tim4431/analog_programmable_matrix/mechanical/analog_matrix_package_m3/renders/enclosure_exploded.png

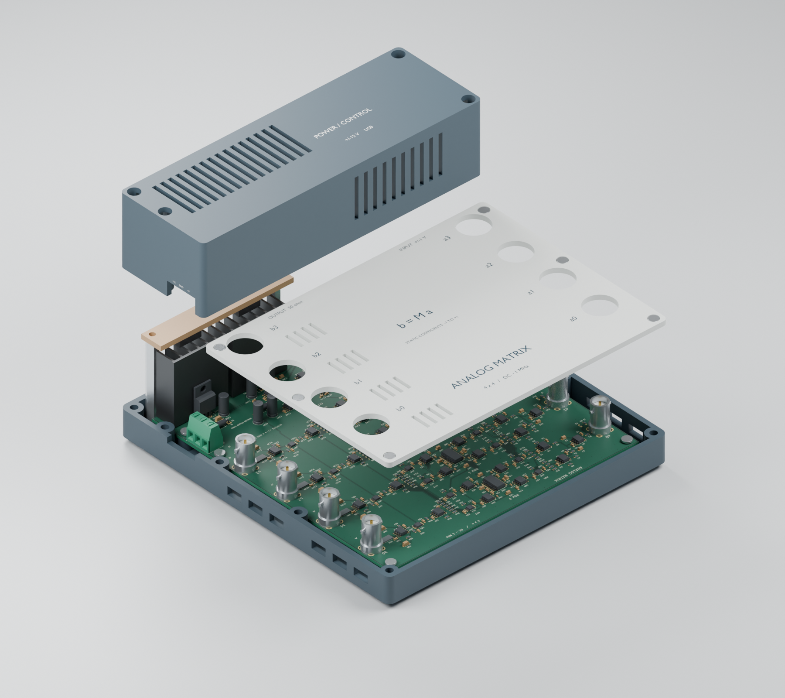
mechanical/analog_matrix_package_m3/renders/enclosure_exploded.png
