tim4431/analog_programmable_matrix/mechanical/analog_matrix_package_m3/renders/power_entry_detail.png

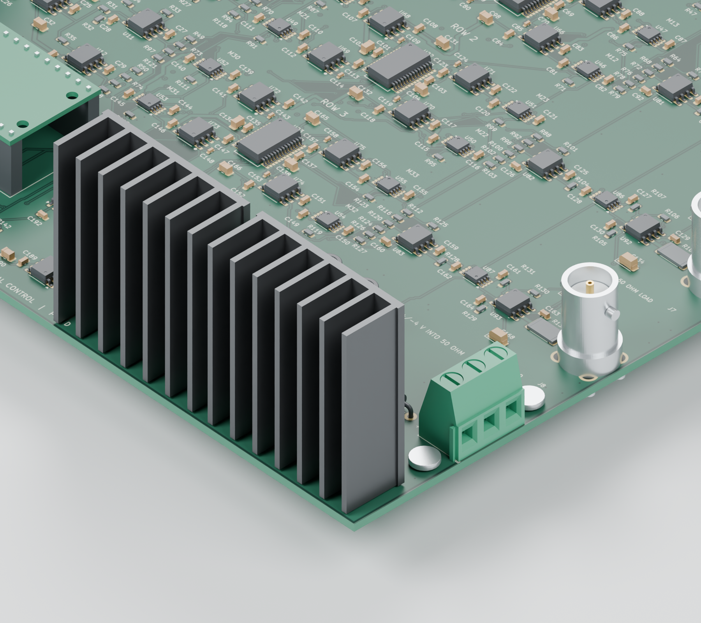
mechanical/analog_matrix_package_m3/renders/power_entry_detail.png
