tim4431/analog_programmable_matrix/mechanical/bnc_access_review_no_led/bnc_clearances.png

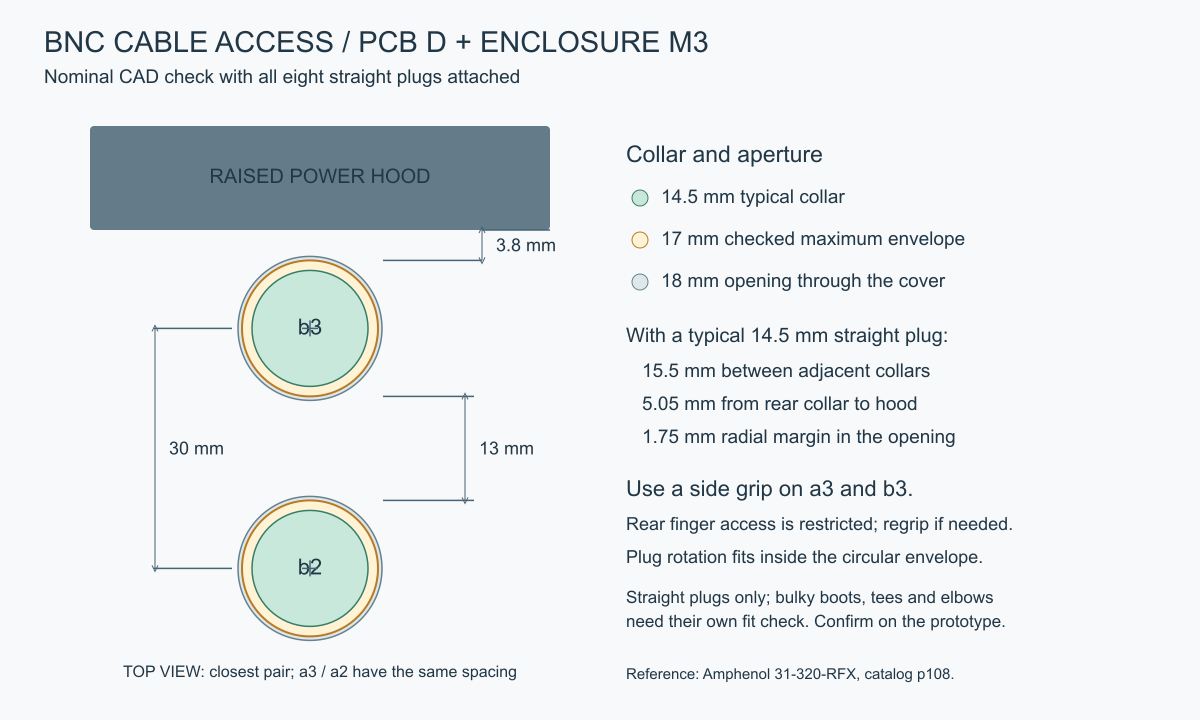
mechanical/bnc_access_review_no_led/bnc_clearances.png
