tim4431/analog_programmable_matrix/spice/plots/feedthrough.png

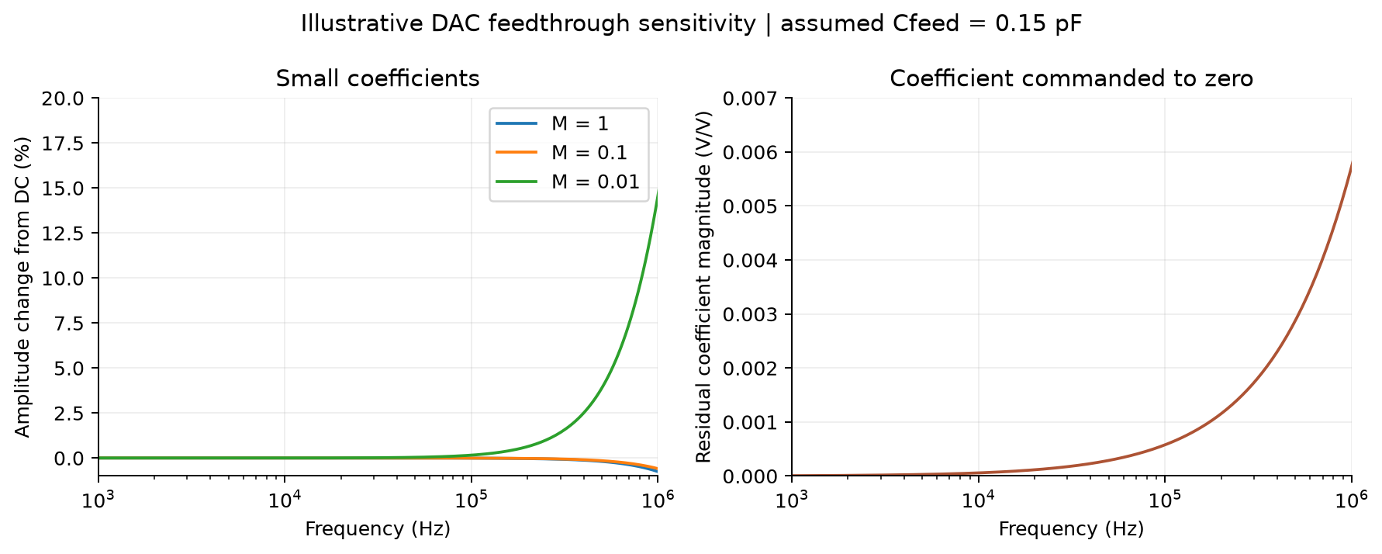
spice/plots/feedthrough.png
