tim4431/analog_programmable_matrix/spice/plots/frequency_response.png

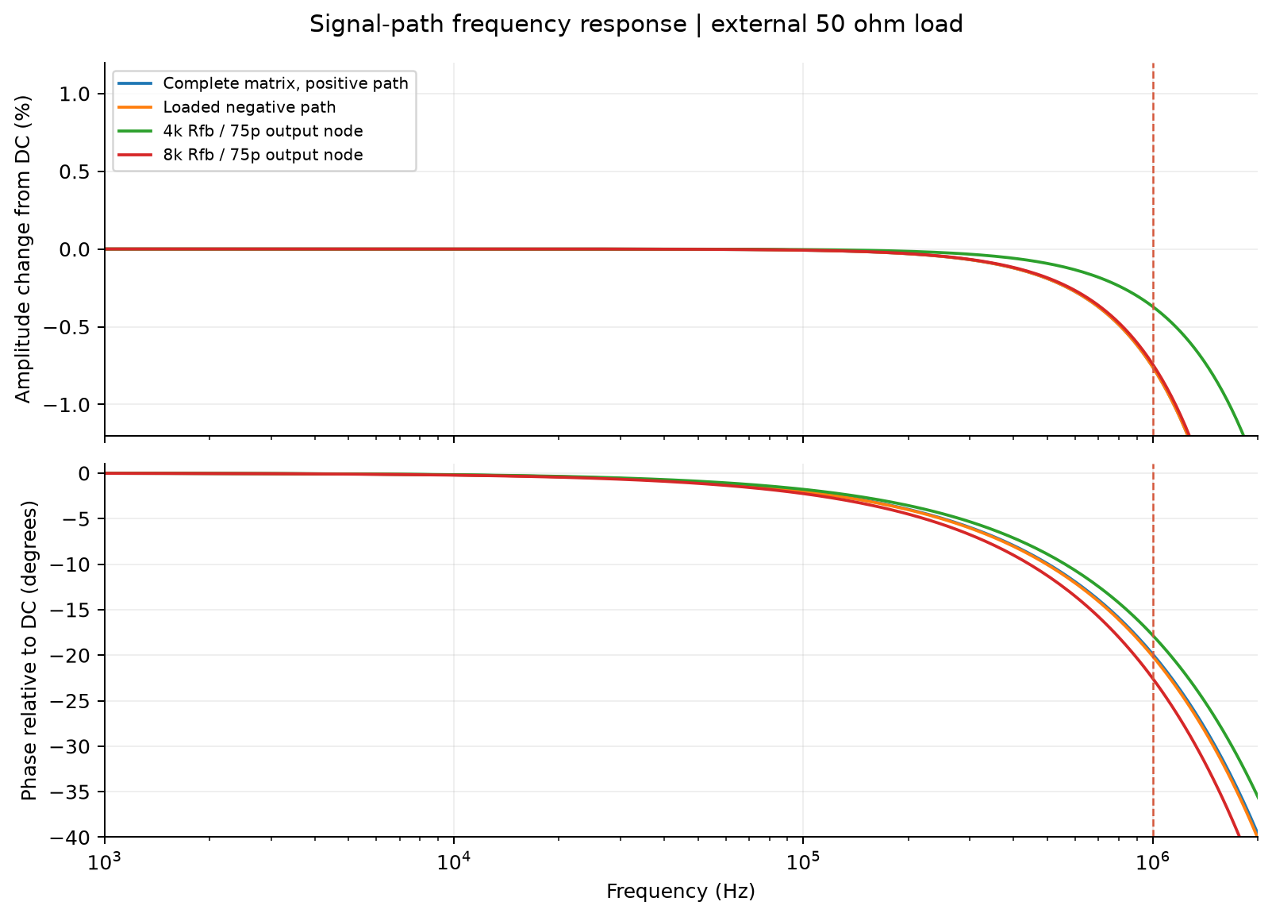
spice/plots/frequency_response.png
