tim4431/analog_programmable_matrix/spice/plots/tia_stability.png

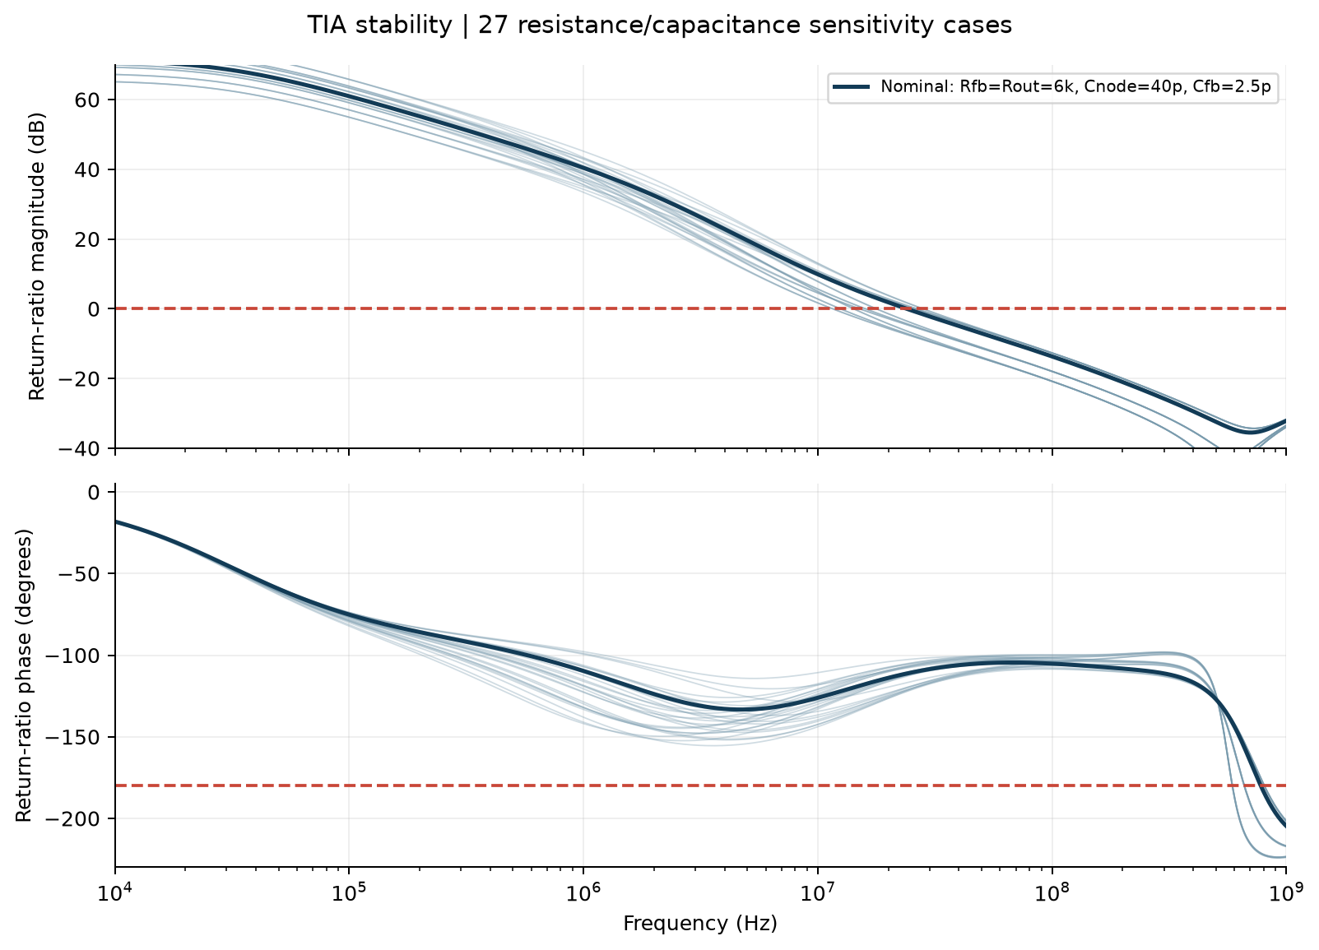
spice/plots/tia_stability.png
