tim4431/analog_programmable_matrix/spice/plots/waveforms.png

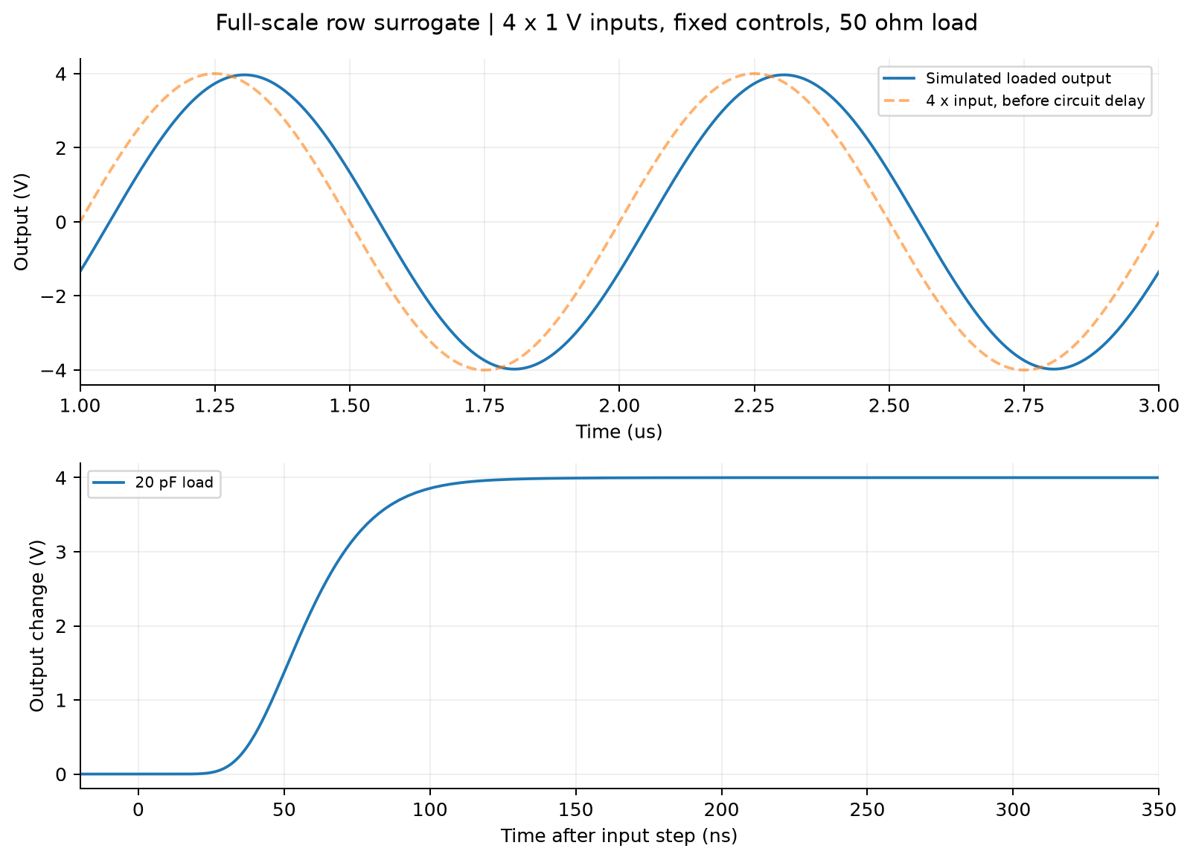
spice/plots/waveforms.png
