tim4431/analog_programmable_matrix/variants/lc1/mechanical/pcb_surface.png

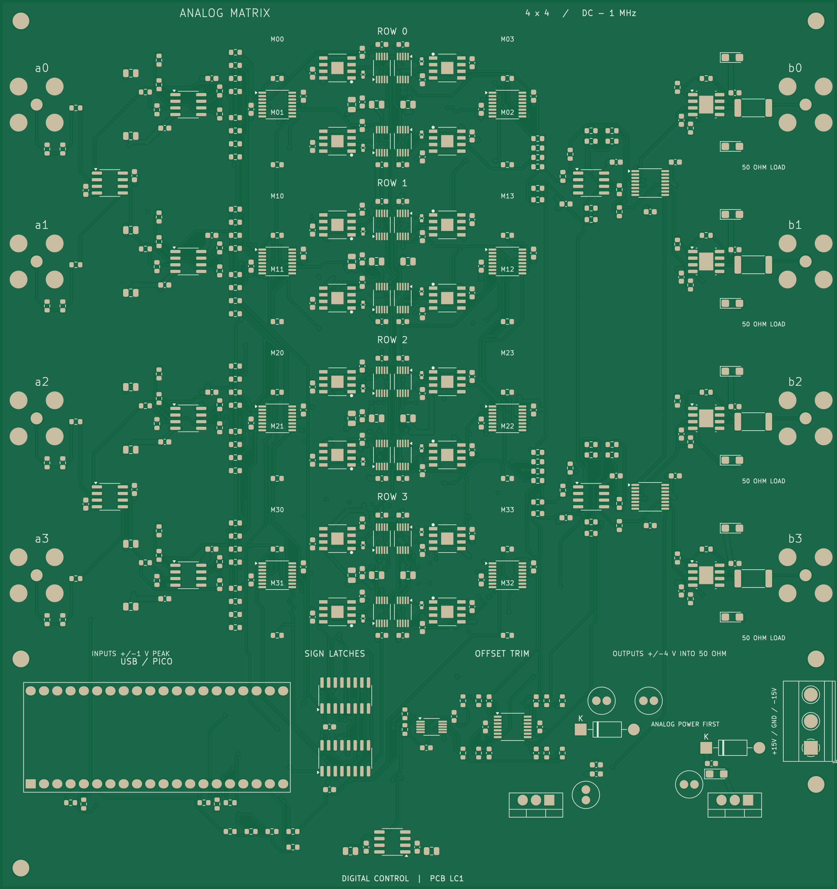
variants/lc1/mechanical/pcb_surface.png
