tim4431/analog_programmable_matrix/variants/lc1/simulation/report/stability.png

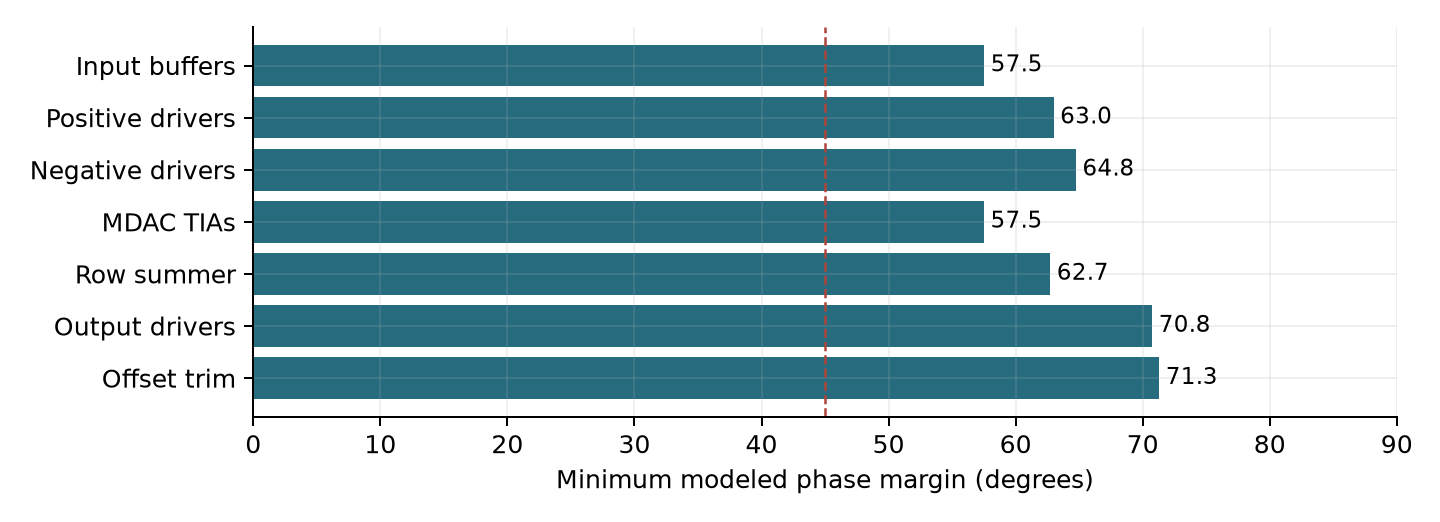
variants/lc1/simulation/report/stability.png
