tim4431/analog_programmable_matrix/output/jlcpcb_rev_d/BOM_JLCPCB.csv

Comment | Designator | Footprint | LCSC Part #
100 nF / 25V X7R minimum; effective C after bias | C1,C2,C3,C4,C5,C6,C9,C10,C11,C12,C13,C14,C17,C18,C19,C20,C21,C22,C25,C26,C27,C28,C29,C30,C33,C35,C37,C38,C39,C40,C42,C43,C44,C45,C47,C48,C49,C50,C52,C53,C54,C55,C57,C58,C59,C60,C61,C62,C67,C69,C71,C72,C73,C74,C76,C77,C78,C79,C81,C82,C83,C84,C86,C87,C88,C89,C91,C92,C93,C94,C95,C96,C101,C103,C105,C106,C107,C108,C110,C111,C112,C113,C115,C116,C117,C118,C120,C121,C122,C123,C125,C126,C127,C128,C129,C130,C135,C137,C139,C140,C141,C142,C144,C145,C146,C147,C149,C150,C151,C152,C154,C155,C156,C157,C159,C160,C161,C162,C163,C164,C169,C171,C173,C174,C176,C177,C179,C180,C182,C183,C187,C189,C191,C192,C196,C200 | C_0603_1608Metric
10 uF / 25V X7R minimum; effective C after bias | C7,C8,C15,C16,C23,C24,C31,C32,C63,C64,C97,C98,C131,C132,C165,C166,C185,C186 | C_0805_2012Metric
1 uF / 25V X7R minimum; effective C after bias | C34,C36,C68,C70,C102,C104,C136,C138,C170,C172,C188,C190 | C_0805_2012Metric
2.2 pF C0G ±0.1pF / 50V C0G | C41,C46,C51,C56,C75,C80,C85,C90,C109,C114,C119,C124,C143,C148,C153,C158 | C_0402_1005Metric
6.8 uF / 25 V / 25V polarized | C65,C66,C99,C100,C133,C134,C167,C168 | CP_EIA-3216-18_Kemet-A
100 pF C0G / 50V C0G | C175,C178,C181,C184 | C_0603_1608Metric
330 nF / 25V X7R minimum; effective C after bias | C194 | C_0603_1608Metric
2.2 uF / 35V polarized | C198 | CP_EIA-3216-18_Kemet-A
33 ohm / 0.1%, <=25ppm/C; 0.1W minimum | R1,R10,R19,R28,R133,R134,R135,R136,R137 | R_0603_1608Metric
1 M / 0.1%, <=25ppm/C; 0.1W minimum | R2,R11,R20,R29 | R_0603_1608Metric
499 ohm / 0.1%, <=25ppm/C; 0.1W minimum | R4,R5,R13,R14,R22,R23,R31,R32 | R_0603_1608Metric
1.00 k / 0.1%, <=25ppm/C; 0.1W minimum | R6,R7,R8,R9,R15,R16,R17,R18,R24,R25,R26,R27,R33,R34,R35,R36,R40,R44,R48,R52,R64,R68,R72,R76,R88,R92,R96,R100,R112,R116,R120,R124 | R_0603_1608Metric
150R 0.1% / 0.1%, <=25ppm/C; 0.1W minimum | R37,R38,R41,R42,R45,R46,R49,R50,R61,R62,R65,R66,R69,R70,R73,R74,R85,R86,R89,R90,R93,R94,R97,R98,R109,R110,R113,R114,R117,R118,R121,R122 | R_0603_1608Metric
100 k / 0.1%, <=25ppm/C; 0.1W minimum | R39,R43,R47,R51,R57,R63,R67,R71,R75,R81,R87,R91,R95,R99,R105,R111,R115,R119,R123,R129 | R_0603_1608Metric
523 ohm / 0.1%, <=25ppm/C; 0.1W minimum | R53,R77,R101,R125 | R_0603_1608Metric
10.0 k / 0.1%, <=25ppm/C; 0.1W minimum | R54,R78,R102,R126 | R_0603_1608Metric
20.0 k / 0.1%, <=25ppm/C; 0.1W minimum | R55,R79,R103,R127 | R_0603_1608Metric
49.9 ohm / 0.1%, <=25ppm/C; 0.1W minimum | R56,R80,R104,R128 | R_0603_1608Metric
1.21 k / 0.1%, <=25ppm/C; 0.1W minimum | R58,R82,R106,R130 | R_0603_1608Metric
402 ohm / 0.1%, <=25ppm/C; 0.1W minimum | R59,R83,R107,R131 | R_0603_1608Metric
49.9 ohm / 0.1%, <=25ppm/C; >=1W | R60,R84,R108,R132 | R_2512_6332Metric
10 k / 0.1%, <=25ppm/C; 0.1W minimum | R138,R139,R140,R141,R142,R143,R144,R145,R146 | R_0603_1608Metric
OPA810ID | U1,U2,U3,U4,U5,U6,U7,U8,U9,U10,U11,U12,U80,U81,U82,U83 | SOIC-8_3.9x4.9mm_P1.27mm
AD5544BRSZ | U20,U21,U22,U23,U30 | SSOP-28_5.3x10.2mm_P0.65mm | C649815
TMUX6219DGKR | U40,U41,U42,U43,U44,U45,U46,U47,U48,U49,U50,U51,U52,U53,U54,U55,U84,U85,U86,U87 | VSSOP-8_3x3mm_P0.65mm | C2876423
ADA4899-1YRDZ | U60,U61,U62,U63,U64,U65,U66,U67,U68,U69,U70,U71,U72,U73,U74,U75 | ADA4899_RD8_EP2.29x2.29 | C654315
THS3091DDAR | U90,U91,U92,U93 | SOIC-8-1EP_3.9x4.9mm_P1.27mm_EP2.95x4.9mm_Mask2.71x3.4mm_ThermalVias | C181226
OPA197ID | U100,U101,U102,U103 | SOIC-8_3.9x4.9mm_P1.27mm | C1347124
ADR4525BRZ | U110 | SOIC-8_3.9x4.9mm_P1.27mm | C395112
SN74HC595D | U121,U122 | SOIC-16_3.9x9.9mm_P1.27mm
