tim4431/analog_programmable_matrix/mechanical/analog_matrix_package_m3/cad/G10_heatsink_retainer.step

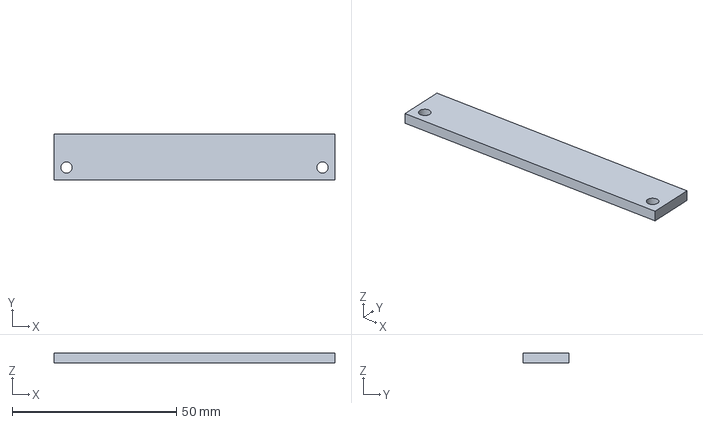
[picture p19: CAD file, 2026-10-01]
mechanical/analog_matrix_package_m3/cad/G10_heatsink_retainer.step
85.6 x 14.0 x 3.00 mm
