tim4431/analog_programmable_matrix/mechanical/analog_matrix_package_m3/models/D_DO-41_SOD81_P10.16mm_Horizontal.step

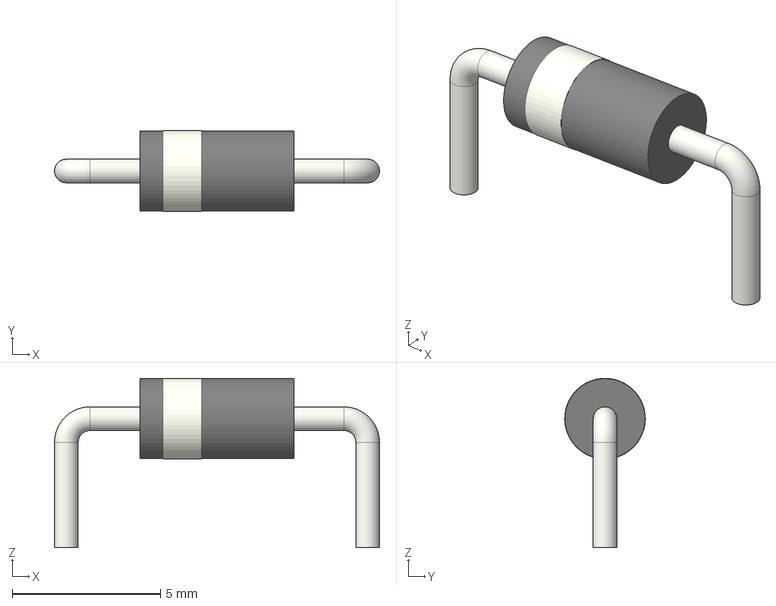
[picture p20: CAD file, 2026-10-01]
mechanical/analog_matrix_package_m3/models/D_DO-41_SOD81_P10.16mm_Horizontal.step
11.0 x 2.72 x 5.71 mm
