tim4431/analog_programmable_matrix/mechanical/analog_matrix_package_m3/pcb_substrate.step

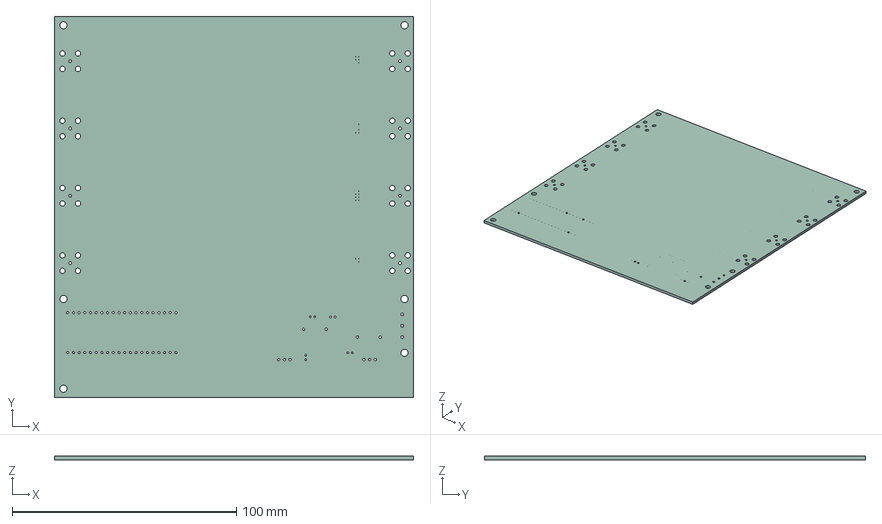
[picture p21: CAD file, 2026-10-01]
mechanical/analog_matrix_package_m3/pcb_substrate.step
160.0 x 170.0 x 1.62 mm
