tim4431/analog_programmable_matrix/variants/lc1/hardware/models/BNC_Amphenol_031-5329-52RFX_Vertical.step

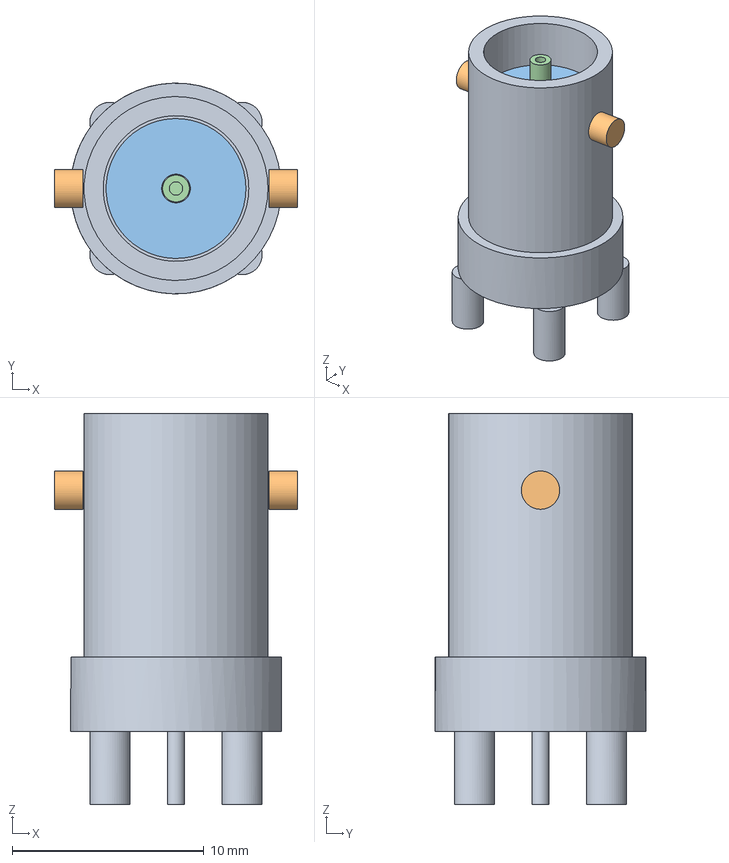
[picture p22: CAD file, 2026-10-01]
variants/lc1/hardware/models/BNC_Amphenol_031-5329-52RFX_Vertical.step
12.7 x 11.0 x 20.4 mm
