tim4431/analog_programmable_matrix/mechanical/analog_matrix_package_m3/cad/signal_cover.step

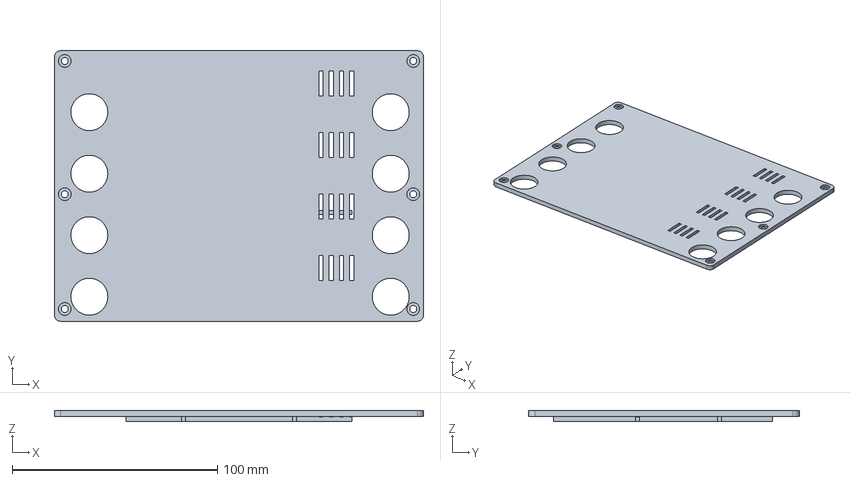
[picture p23: CAD file, 2026-10-01]
mechanical/analog_matrix_package_m3/cad/signal_cover.step
180.0 x 132.0 x 5.50 mm
