tim4431/analog_programmable_matrix/mechanical/analog_matrix_package_m3/models/C_0402_1005Metric.step

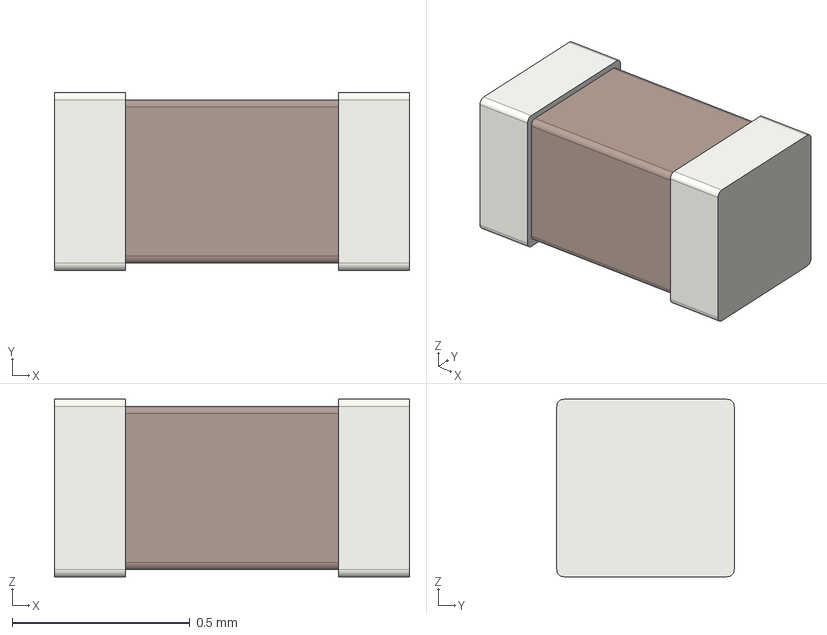
[picture p24: CAD file, 2026-10-01]
mechanical/analog_matrix_package_m3/models/C_0402_1005Metric.step
1.00 x 0.5 x 0.5 mm
