tim4431/analog_programmable_matrix/mechanical/analog_matrix_package_m3/cad/base_tray.step

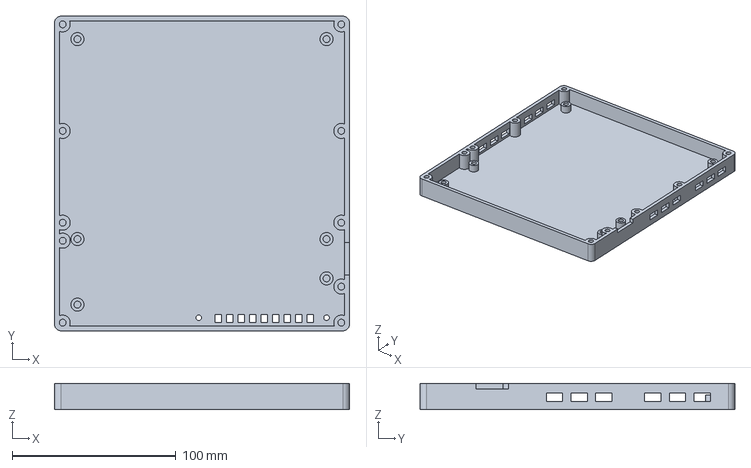
[picture p25: CAD file, 2026-10-01]
mechanical/analog_matrix_package_m3/cad/base_tray.step
180.0 x 192.0 x 16.0 mm
