tim4431/analog_programmable_matrix/mechanical/analog_matrix_package_m3/cad/power_hood.step

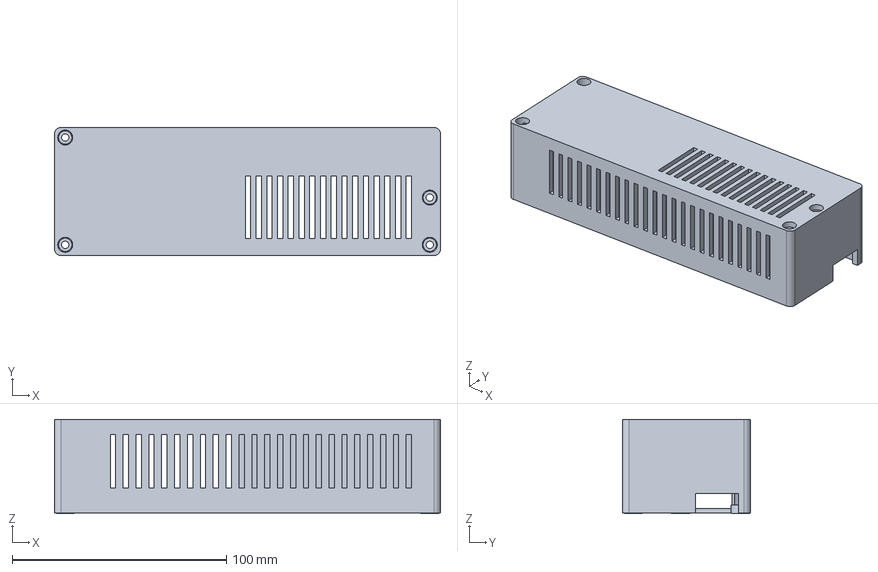
[picture p26: CAD file, 2026-10-01]
mechanical/analog_matrix_package_m3/cad/power_hood.step
180.0 x 59.7 x 44.0 mm
