tim4431/analog_programmable_matrix/mechanical/analog_matrix_package_m3/models/C_Radial_D5.0mm_H11.0mm_P2.00mm.step

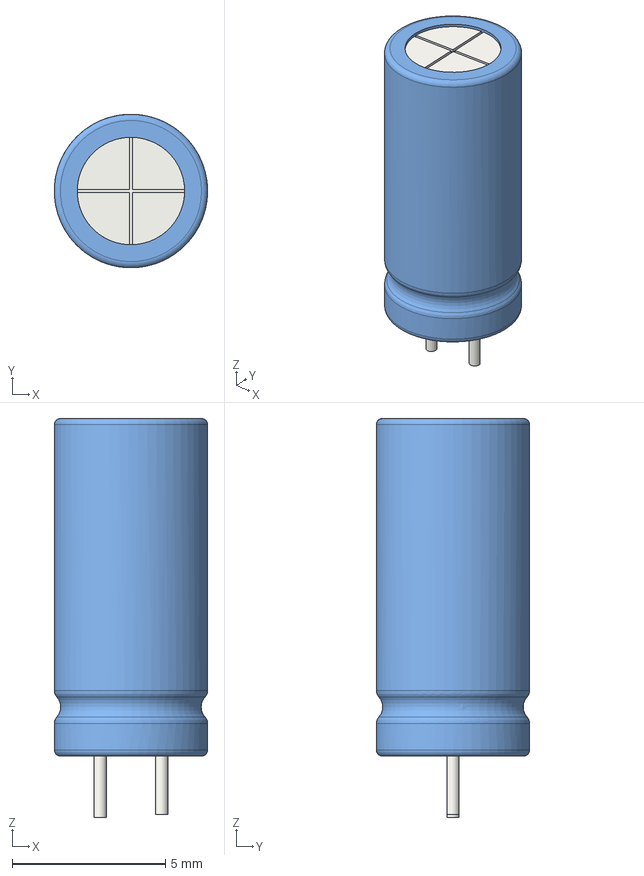
[picture p27: CAD file, 2026-10-01]
mechanical/analog_matrix_package_m3/models/C_Radial_D5.0mm_H11.0mm_P2.00mm.step
5.00 x 5.00 x 13.0 mm
