tim4431/analog_programmable_matrix/mechanical/analog_matrix_package_m3/models/TerminalBlock_Phoenix_MKDS-1,5-3-5.08_1x03_P5.08mm_Horizontal.step

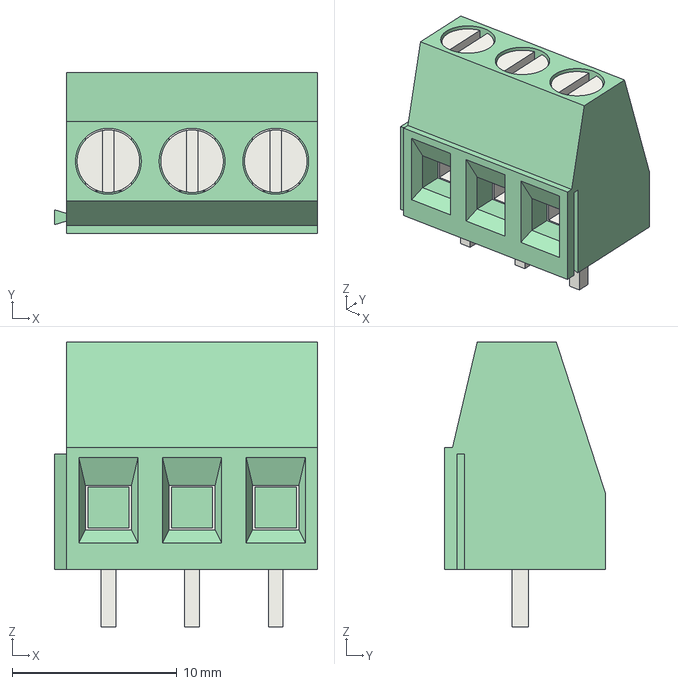
[picture p28: CAD file, 2026-10-01]
mechanical/analog_matrix_package_m3/models/TerminalBlock_Phoenix_MKDS-1,5-3-5.08_1x03_P5.08mm_Horizontal.step
16.0 x 9.80 x 17.3 mm
