tim4431/analog_programmable_matrix/mechanical/analog_matrix_package_m3/models/Pico_2x20_Socket_17.78mm.step

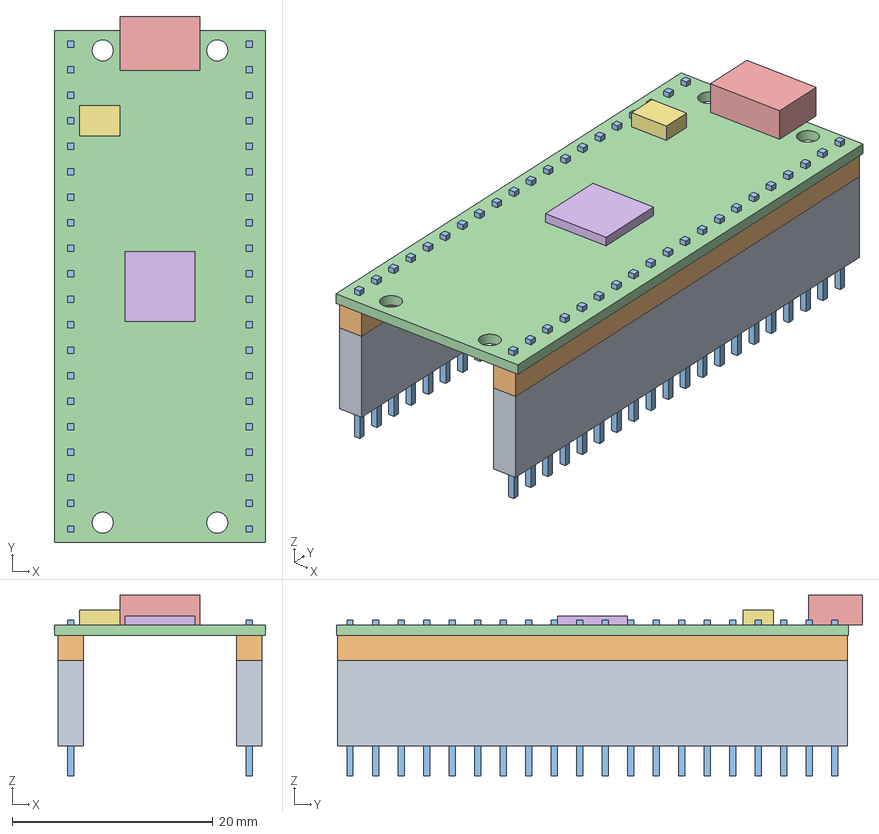
[picture p29: CAD file, 2026-10-01]
mechanical/analog_matrix_package_m3/models/Pico_2x20_Socket_17.78mm.step
21.0 x 52.4 x 18.0 mm
