tim4431/analog_programmable_matrix/mechanical/analog_matrix_package_m3/models/SOIC-8-1EP_3.9x4.9mm_P1.27mm_EP2.95x4.9mm_Mask2.71x3.4mm.step

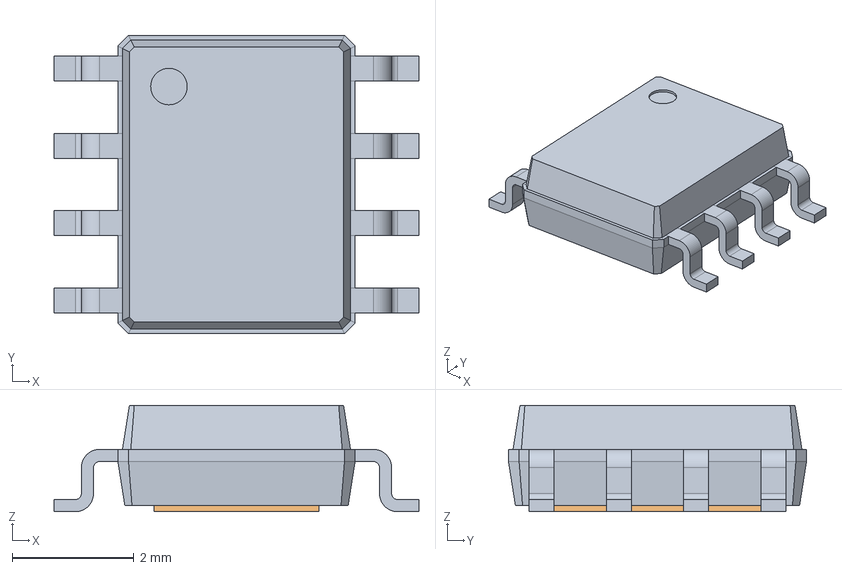
[picture p30: CAD file, 2026-10-01]
mechanical/analog_matrix_package_m3/models/SOIC-8-1EP_3.9x4.9mm_P1.27mm_EP2.95x4.9mm_Mask2.71x3.4mm.step
6.00 x 4.90 x 1.75 mm
