tim4431/analog_programmable_matrix/mechanical/analog_matrix_package_m3/models/R_0603_1608Metric.step

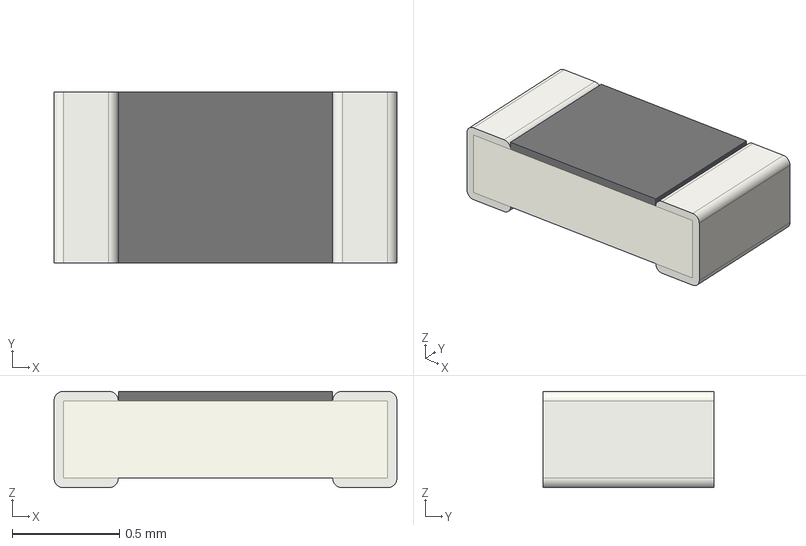
[picture p31: CAD file, 2026-10-01]
mechanical/analog_matrix_package_m3/models/R_0603_1608Metric.step
1.60 x 0.8 x 0.45 mm
