tim4431/analog_programmable_matrix/mechanical/analog_matrix_package_m3/models/TO-220-3_Vertical.step

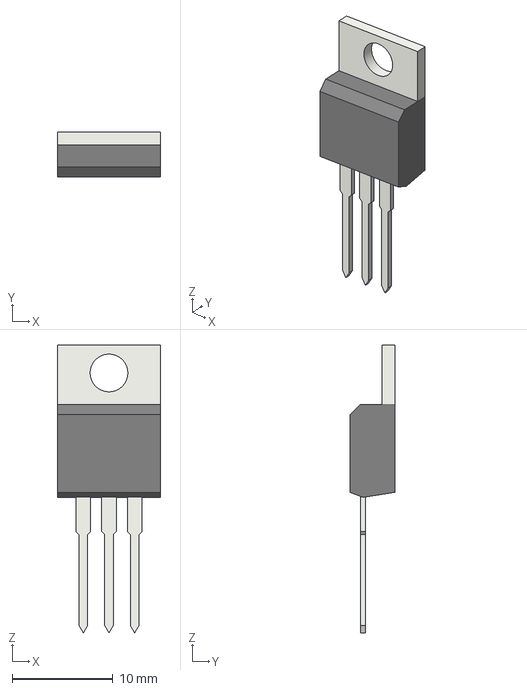
[picture p33: CAD file, 2026-10-01]
mechanical/analog_matrix_package_m3/models/TO-220-3_Vertical.step
10.2 x 4.46 x 28.5 mm
