tim4431/analog_programmable_matrix/mechanical/analog_matrix_package_m3/models/R_2512_6332Metric.step

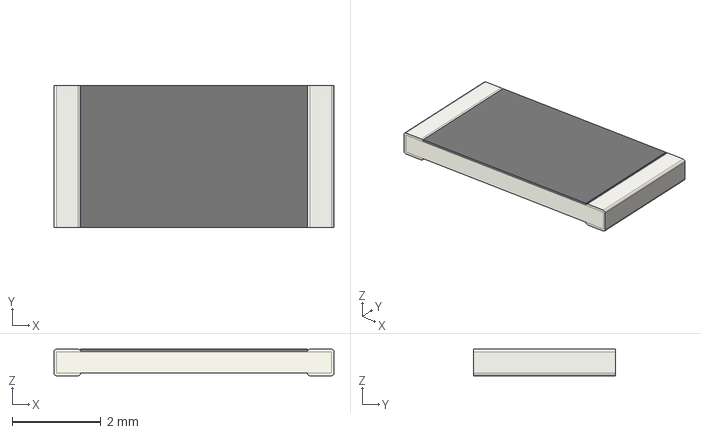
[picture p34: CAD file, 2026-10-01]
mechanical/analog_matrix_package_m3/models/R_2512_6332Metric.step
6.30 x 3.20 x 0.6 mm
