tim4431/analog_programmable_matrix/mechanical/analog_matrix_package_m3/models/SSOP-28_5.3x10.2mm_P0.65mm.step

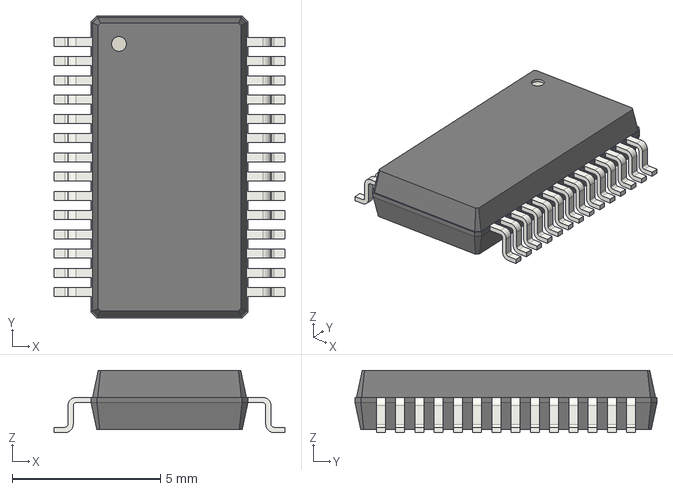
[picture p35: CAD file, 2026-10-01]
mechanical/analog_matrix_package_m3/models/SSOP-28_5.3x10.2mm_P0.65mm.step
7.80 x 10.2 x 2.10 mm
