tim4431/analog_programmable_matrix/mechanical/analog_matrix_package_m3/models/CP_EIA-3216-18_Kemet-A.step

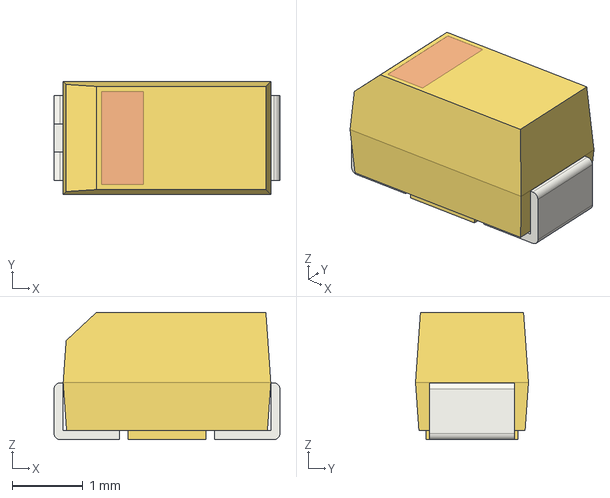
[picture p37: CAD file, 2026-10-01]
mechanical/analog_matrix_package_m3/models/CP_EIA-3216-18_Kemet-A.step
3.20 x 1.60 x 1.80 mm
