tim4431/analog_programmable_matrix/mechanical/analog_matrix_package_m3/models/ADA4899_RD8_EP2.29x2.29.step

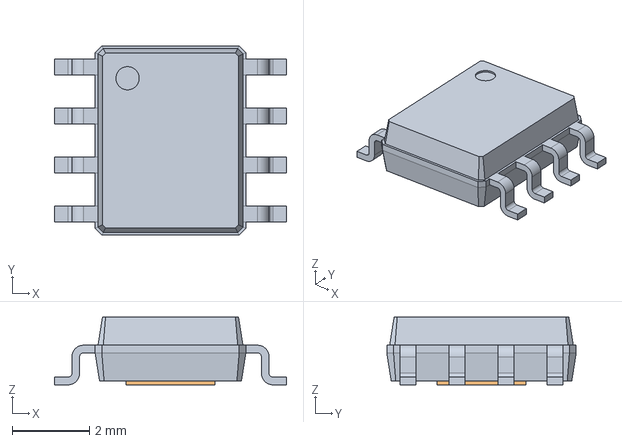
[picture p38: CAD file, 2026-10-01]
mechanical/analog_matrix_package_m3/models/ADA4899_RD8_EP2.29x2.29.step
6.00 x 4.90 x 1.75 mm
