tim4431/analog_programmable_matrix/mechanical/analog_matrix_package_m3/models/C_0805_2012Metric.step

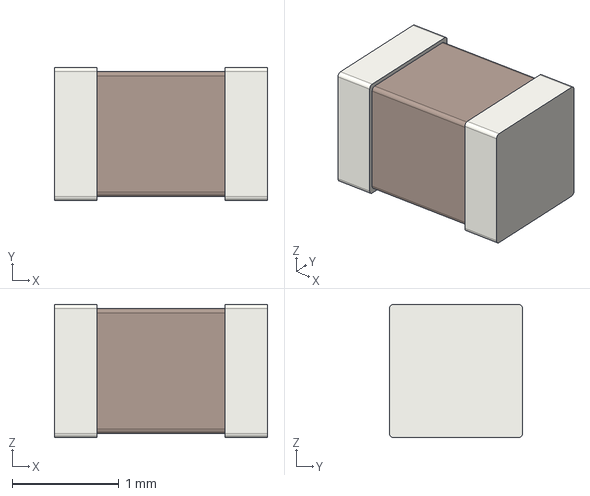
[picture p39: CAD file, 2026-10-01]
mechanical/analog_matrix_package_m3/models/C_0805_2012Metric.step
2.00 x 1.25 x 1.25 mm
