tim4431/analog_programmable_matrix/mechanical/analog_matrix_package_m3/models/VSSOP-8_3x3mm_P0.65mm.step

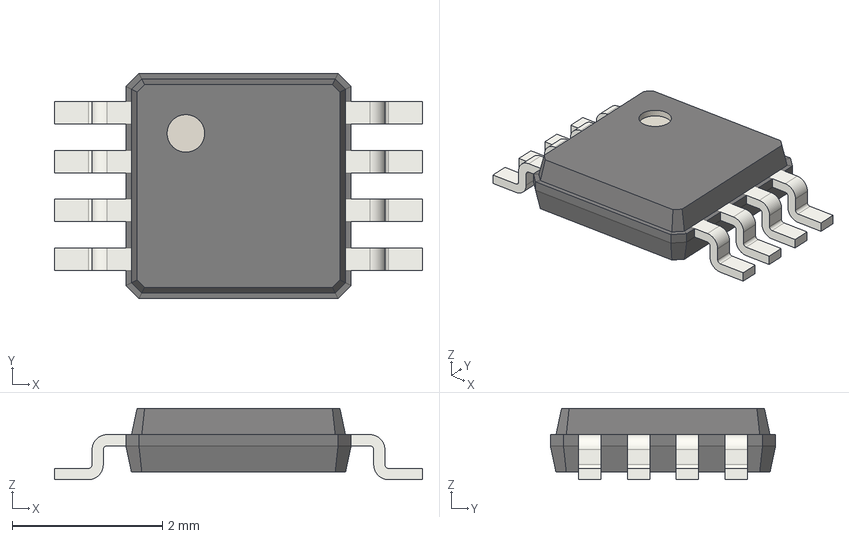
[picture p40: CAD file, 2026-10-01]
mechanical/analog_matrix_package_m3/models/VSSOP-8_3x3mm_P0.65mm.step
4.90 x 3.00 x 0.95 mm
