tim4431/analog_programmable_matrix/mechanical/analog_matrix_package_m3/models/SOIC-16_3.9x9.9mm_P1.27mm.step

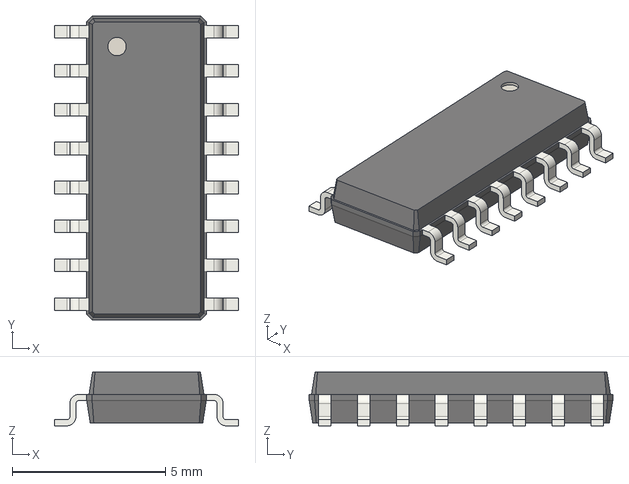
[picture p41: CAD file, 2026-10-01]
mechanical/analog_matrix_package_m3/models/SOIC-16_3.9x9.9mm_P1.27mm.step
6.00 x 9.90 x 1.75 mm
