tim4431/analog_programmable_matrix/mechanical/analog_matrix_package_m3/models/SMA_Amphenol_132134_Vertical.step

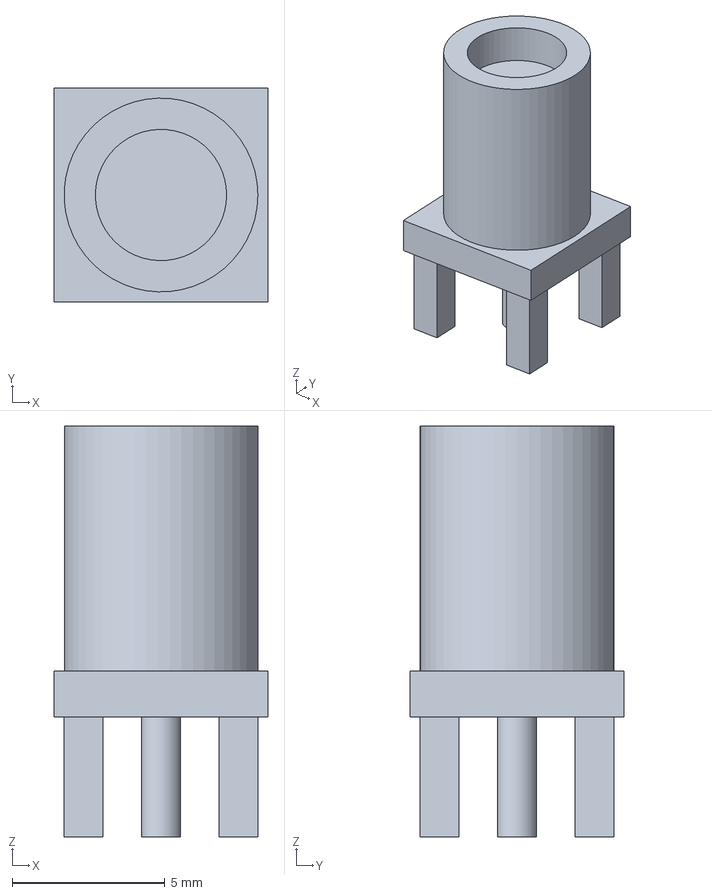
[picture p42: CAD file, 2026-10-01]
mechanical/analog_matrix_package_m3/models/SMA_Amphenol_132134_Vertical.step
7.00 x 7.00 x 13.5 mm
