tim4431/analog_programmable_matrix/mechanical/analog_matrix_package_m3/models/TO-220-3_Vertical_Trimmed.step

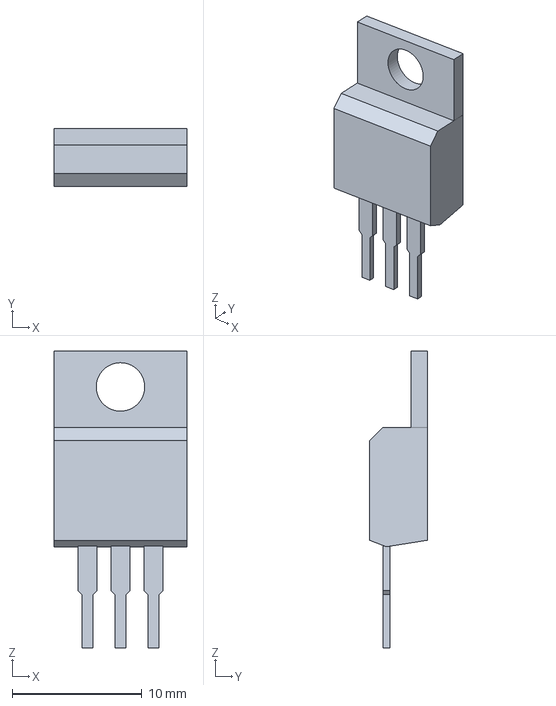
[picture p43: CAD file, 2026-10-01]
mechanical/analog_matrix_package_m3/models/TO-220-3_Vertical_Trimmed.step
10.2 x 4.46 x 22.9 mm
