tim4431/analog_programmable_matrix/(list of files, cad)

Other CAD files:
mechanical/analog_matrix_package_m3/models/BNC_Amphenol_031-5329-52RFX_Vertical.step
mechanical/analog_matrix_package_m3/analog_matrix_package.blend
mechanical/analog_matrix_package_m3/cad/G10_heatsink_retainer.dxf
mechanical/analog_matrix_package_m3/print/base_tray.stl
mechanical/analog_matrix_package_m3/print/power_hood.stl
mechanical/analog_matrix_package_m3/print/signal_cover.stl
