tim4431/analog_programmable_matrix/pcb/analog_matrix_4x4_rev_d/fabrication/via_in_pad_locations.csv

X from left mm | Y from top mm | Finished hole mm | Copper diameter mm | Net | Nearby SMD land | Origin
138.0 | 101.0 | 0.3 | 0.6 | +15V | C167.1 | via
137.1 | 78.9 | 0.3 | 0.6 | +15V | U92.7 | via
138.0 | 70.7 | 0.3 | 0.6 | +15V | C133.1 | via
138.0 | 41.0 | 0.3 | 0.6 | +15V | C99.1 | via
137.1 | 108.9 | 0.3 | 0.6 | +15V | U93.7 | via
137.1 | 18.9 | 0.3 | 0.6 | +15V | U90.7 | via
137.1 | 48.9 | 0.3 | 0.6 | +15V | U91.7 | via
113.6 | 79.5 | 0.3 | 0.6 | +5A | U82.7 | via
39.5 | 102.4 | 0.3 | 0.6 | +5A | U11.7 | via
112.5 | 109.0 | 0.3 | 0.6 | +5A | U83.7 | via
39.6 | 42.5 | 0.3 | 0.6 | +5A | U5.7 | via
87.5 | 85.1 | 0.3 | 0.6 | +5A | U70.8 | via
88.0 | 102.6 | 0.3 | 0.6 | +5A | U75.7 | via
85.6 | 140.7 | 0.3 | 0.6 | +5A | C170.1 | via
106.2 | 146.4 | 0.3 | 0.6 | +5A | U102.7 | via
88.2 | 86.7 | 0.3 | 0.6 | +5A | U70.7 | via
61.2 | 59.2 | 0.3 | 0.6 | +5A | U65.8 | via
87.5 | 71.1 | 0.3 | 0.6 | +5A | U71.8 | via
59.1 | 103.2 | 0.3 | 0.6 | +5A | C141.1 | via
66.6 | 110.7 | 0.3 | 0.6 | +5A | C136.1 | via
59.1 | 117.2 | 0.3 | 0.6 | +5A | C146.1 | via
23.4 | 103.7 | 0.3 | 0.6 | +5A | C31.1 | via
61.1 | 44.9 | 0.3 | 0.6 | +5A | U64.8 | via
66.6 | 20.7 | 0.3 | 0.6 | +5A | C34.1 | via
87.6 | 115.4 | 0.3 | 0.6 | +5A | U74.8 | via
39.6 | 86.1 | 0.3 | 0.6 | +5A | U9.7 | via
87.5 | 25.1 | 0.3 | 0.6 | +5A | U62.8 | via
24.0 | 44.7 | 0.3 | 0.6 | +5A | C15.1 | via
73.4 | 9.7 | 0.3 | 0.6 | +5A | C63.1 | via
113.7 | 19.2 | 0.3 | 0.6 | +5A | U80.7 | via
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
134.35 | 79.35 | 0.2 | 0.5 | GND | U92.9 | U92.9
134.35 | 80.65 | 0.2 | 0.5 | GND | U92.9 | U92.9
134.35 | 81.95 | 0.2 | 0.5 | GND | U92.9 | U92.9
135.65 | 78.05 | 0.2 | 0.5 | GND | U92.9 | U92.9
135.65 | 79.35 | 0.2 | 0.5 | GND | U92.9 | U92.9
135.65 | 80.65 | 0.2 | 0.5 | GND | U92.9 | U92.9
135.65 | 81.95 | 0.2 | 0.5 | GND | U92.9 | U92.9
134.35 | 108.05 | 0.2 | 0.5 | GND | U93.9 | U93.9
134.35 | 109.35 | 0.2 | 0.5 | GND | U93.9 | U93.9
134.35 | 110.65 | 0.2 | 0.5 | GND | U93.9 | U93.9
134.35 | 111.95 | 0.2 | 0.5 | GND | U93.9 | U93.9
135.65 | 108.05 | 0.2 | 0.5 | GND | U93.9 | U93.9
135.65 | 109.35 | 0.2 | 0.5 | GND | U93.9 | U93.9
135.65 | 110.65 | 0.2 | 0.5 | GND | U93.9 | U93.9
135.65 | 111.95 | 0.2 | 0.5 | GND | U93.9 | U93.9
134.35 | 48.05 | 0.2 | 0.5 | GND | U91.9 | U91.9
134.35 | 49.35 | 0.2 | 0.5 | GND | U91.9 | U91.9
134.35 | 50.65 | 0.2 | 0.5 | GND | U91.9 | U91.9
134.35 | 51.95 | 0.2 | 0.5 | GND | U91.9 | U91.9
135.65 | 48.05 | 0.2 | 0.5 | GND | U91.9 | U91.9
135.65 | 49.35 | 0.2 | 0.5 | GND | U91.9 | U91.9
135.65 | 50.65 | 0.2 | 0.5 | GND | U91.9 | U91.9
135.65 | 51.95 | 0.2 | 0.5 | GND | U91.9 | U91.9
