tim4431/analog_programmable_matrix/spice/benches/a2_row_step_capload_rc.log_excerpt.txt

achieve convergence from 1.5100012957209242e-06 to 1.5100012957219242e-06 seconds.
Warning: Simulation tolerance relaxed to achieve convergence from 1.5100012957219242e-06 to 1.5100012957229241e-06 seconds.
Warning: Simulation tolerance relaxed to achieve convergence from 1.5100012957229241e-06 to 1.5100012957239240e-06 seconds.
Warning: Simulation tolerance relaxed to achieve convergence from 1.5100012957239240e-06 to 1.5100012957249239e-06 seconds.
Warning: Simulation tolerance relaxed to achieve convergence from 1.5100012957249239e-06 to 1.5100012957259238e-06 seconds.
Warning: Simulation tolerance relaxed to achieve convergence from 1.5100012957259238e-06 to 1.5100012957269238e-06 seconds.
Warning: Simulation tolerance relaxed to achieve convergence from 1.5100012957269238e-06 to 1.5100012957279237e-06 seconds.
Warning: Simulation tolerance relaxed to achieve convergence from 1.5100012957279237e-06 to 1.5100012957289236e-06 seconds.
Warning: Simulation tolerance relaxed to achieve convergence from 1.5100012957289236e-06 to 1.5100012957299235e-06 seconds.
Warning: Simulation tolerance relaxed to achieve convergence from 1.5100012957299235e-06 to 1.5100012957309235e-06 seconds.
Warning: Simulation tolerance relaxed to achieve convergence from 1.5100012957309235e-06 to 1.5100012957319234e-06 seconds.
Warning: Simulation tolerance relaxed to achieve convergence from 1.5100012957319234e-06 to 1.5100012957329233e-06 seconds.
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
Warning: Simulation tolerance relaxed to achieve convergence from 1.5100012957669207e-06 to 1.5100012957679206e-06 seconds.
Warning: Simulation tolerance relaxed to achieve convergence from 1.5100012957679206e-06 to 1.5100012957689205e-06 seconds.
Warning: Simulation tolerance relaxed to achieve convergence from 1.5100012957689205e-06
