tim4431/analog_programmable_matrix/pcb/analog_matrix_4x4_rev_d/schematic.pdf

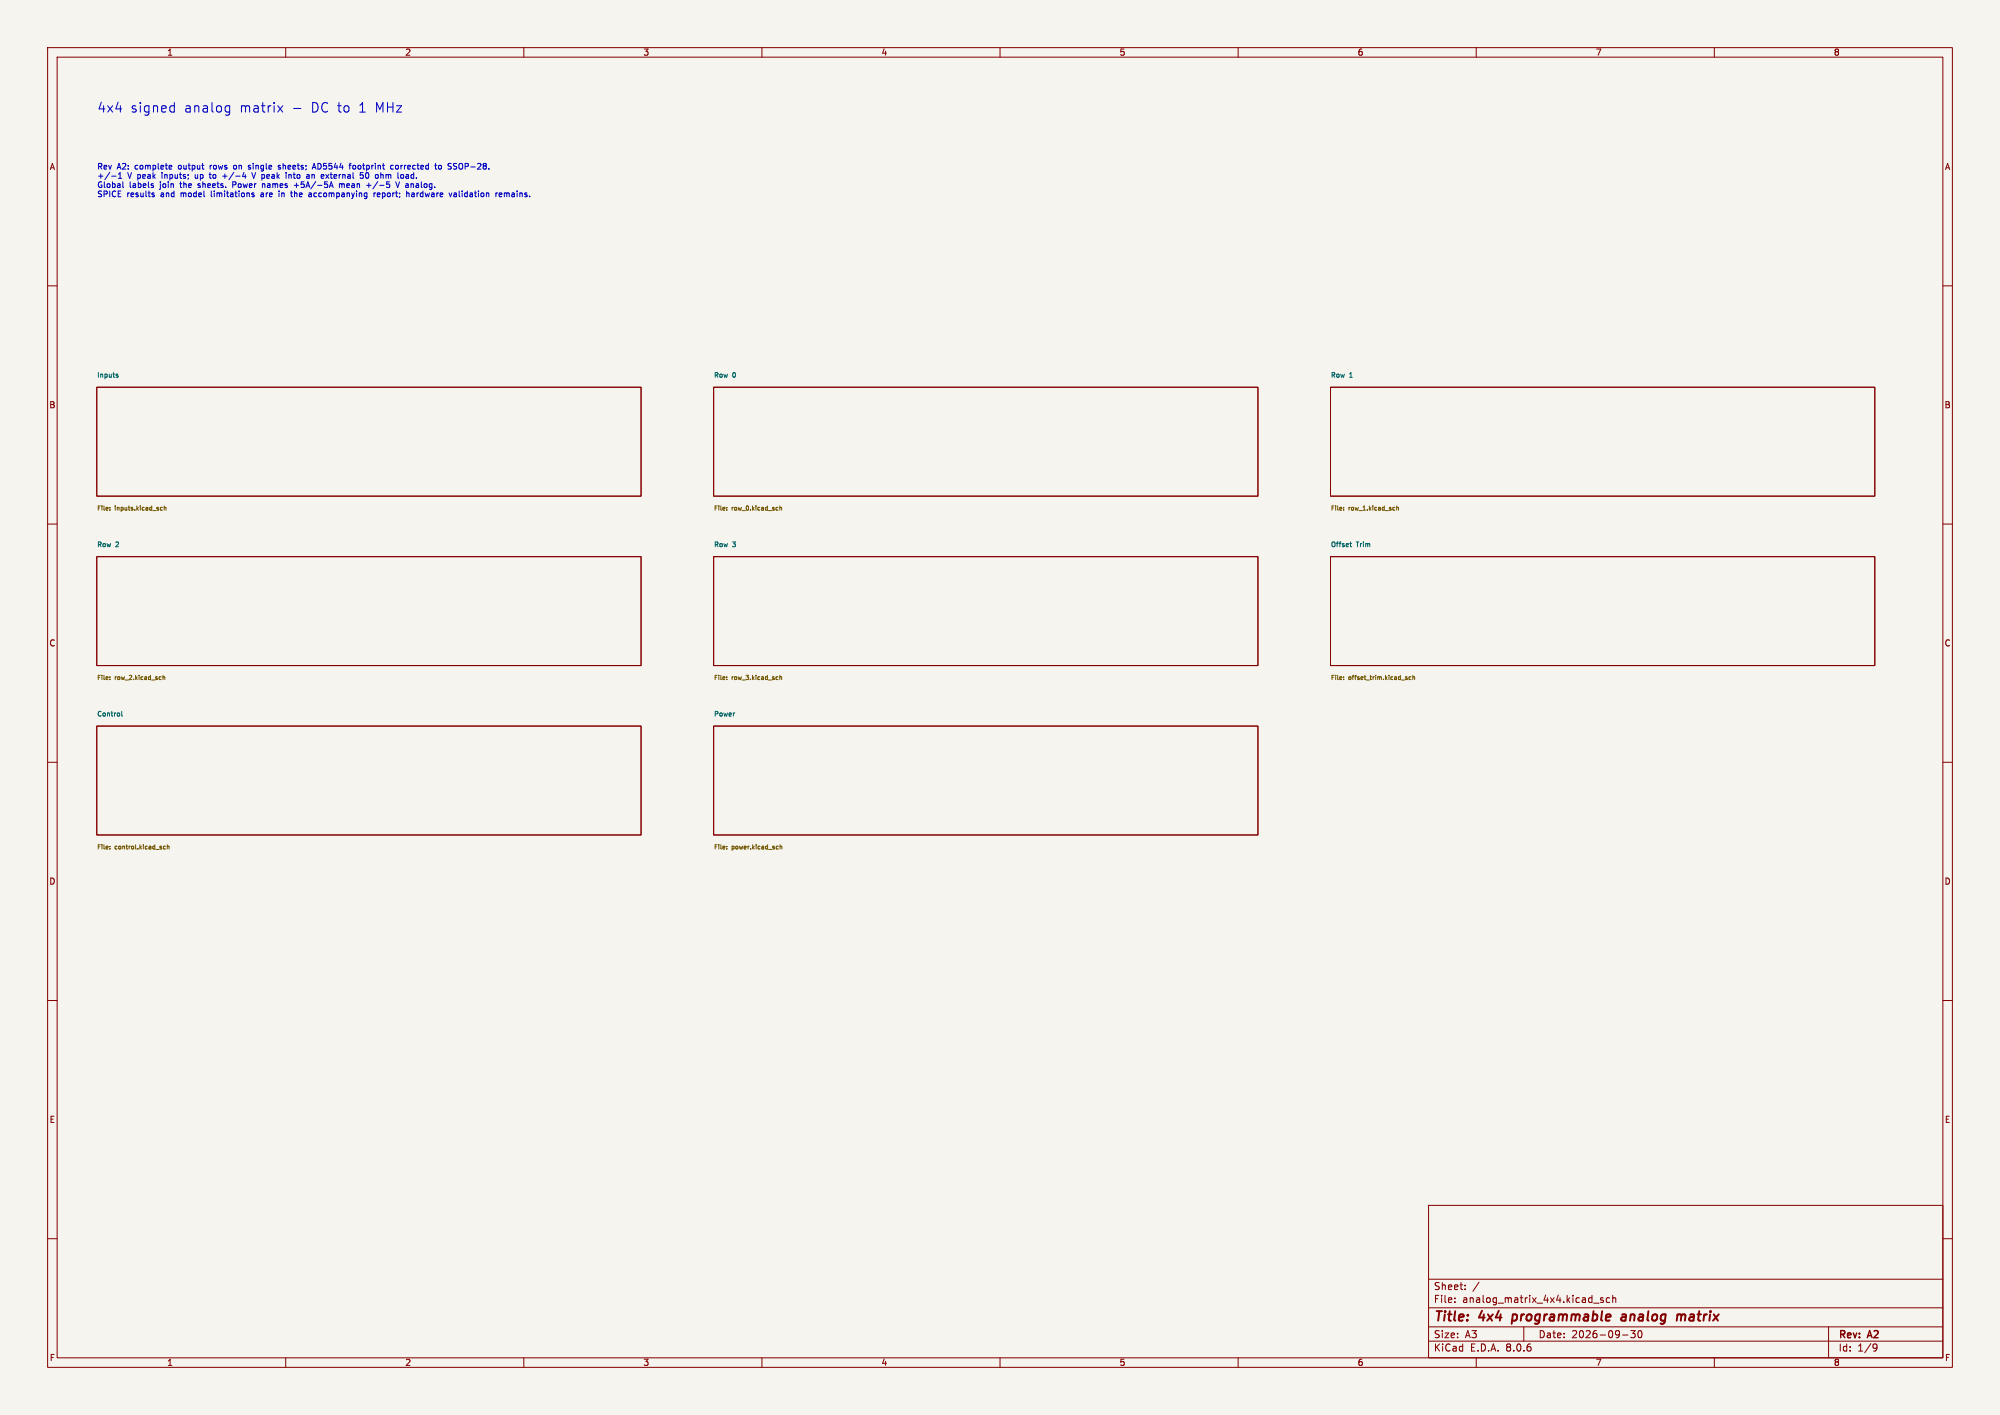
[picture p46: page 1]

Inputs File: inputs.kicad_sch Row 2

File: row_2.kicad_sch Control File: control.kicad_sch

File: offset_trim.kicad_sch Power File: power.kicad_sch

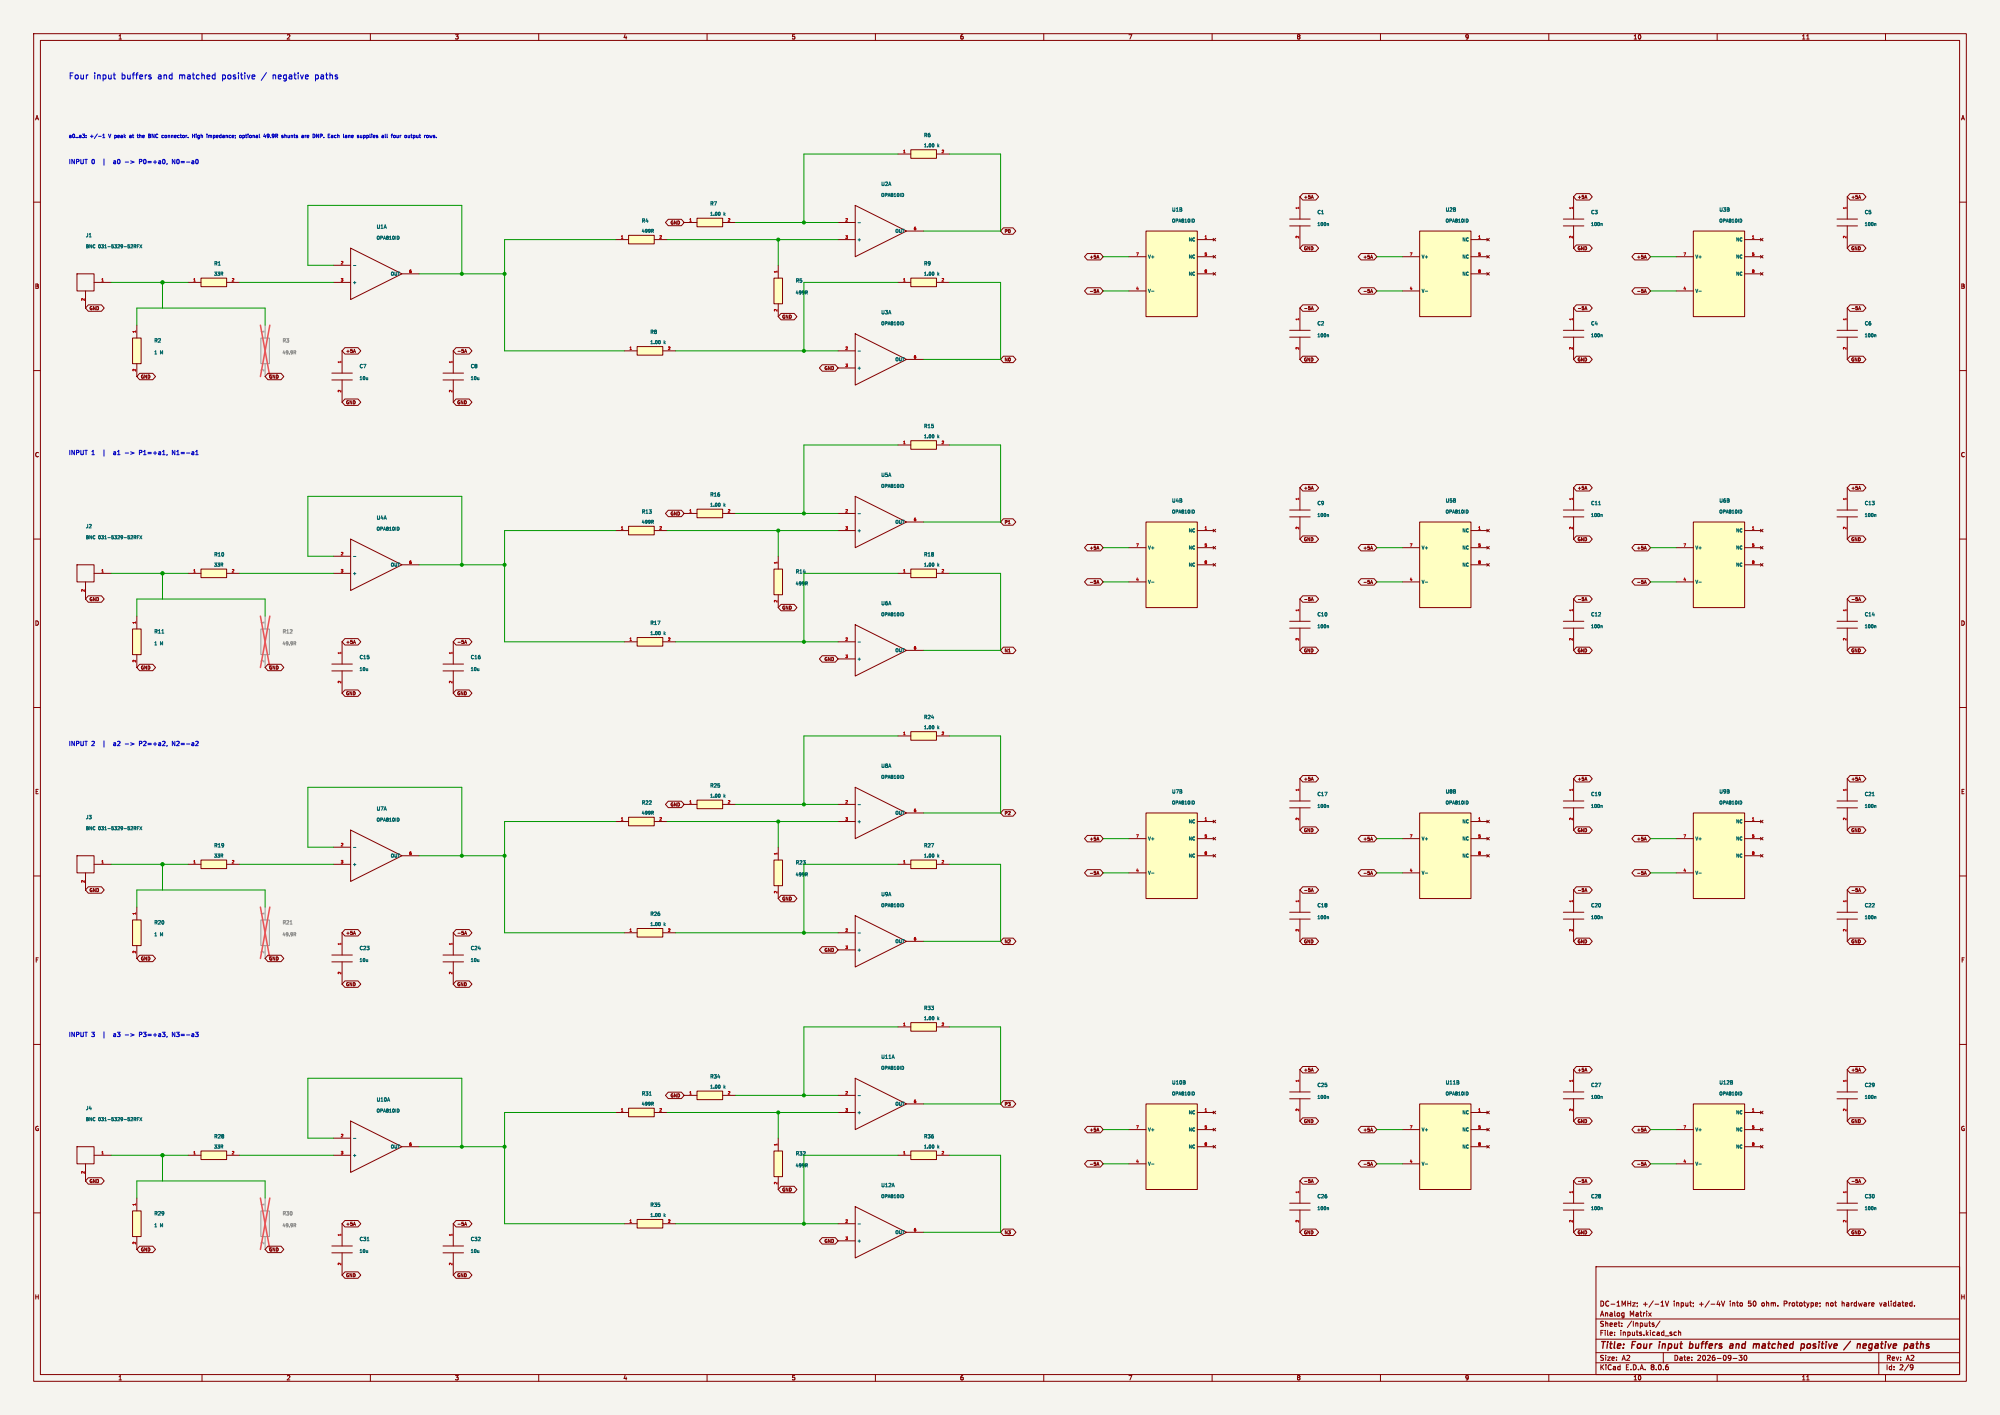
[picture p47: page 2]

Four input buffers and matched positive / negative paths

File: inputs.kicad_sch Sheet: /Inputs/

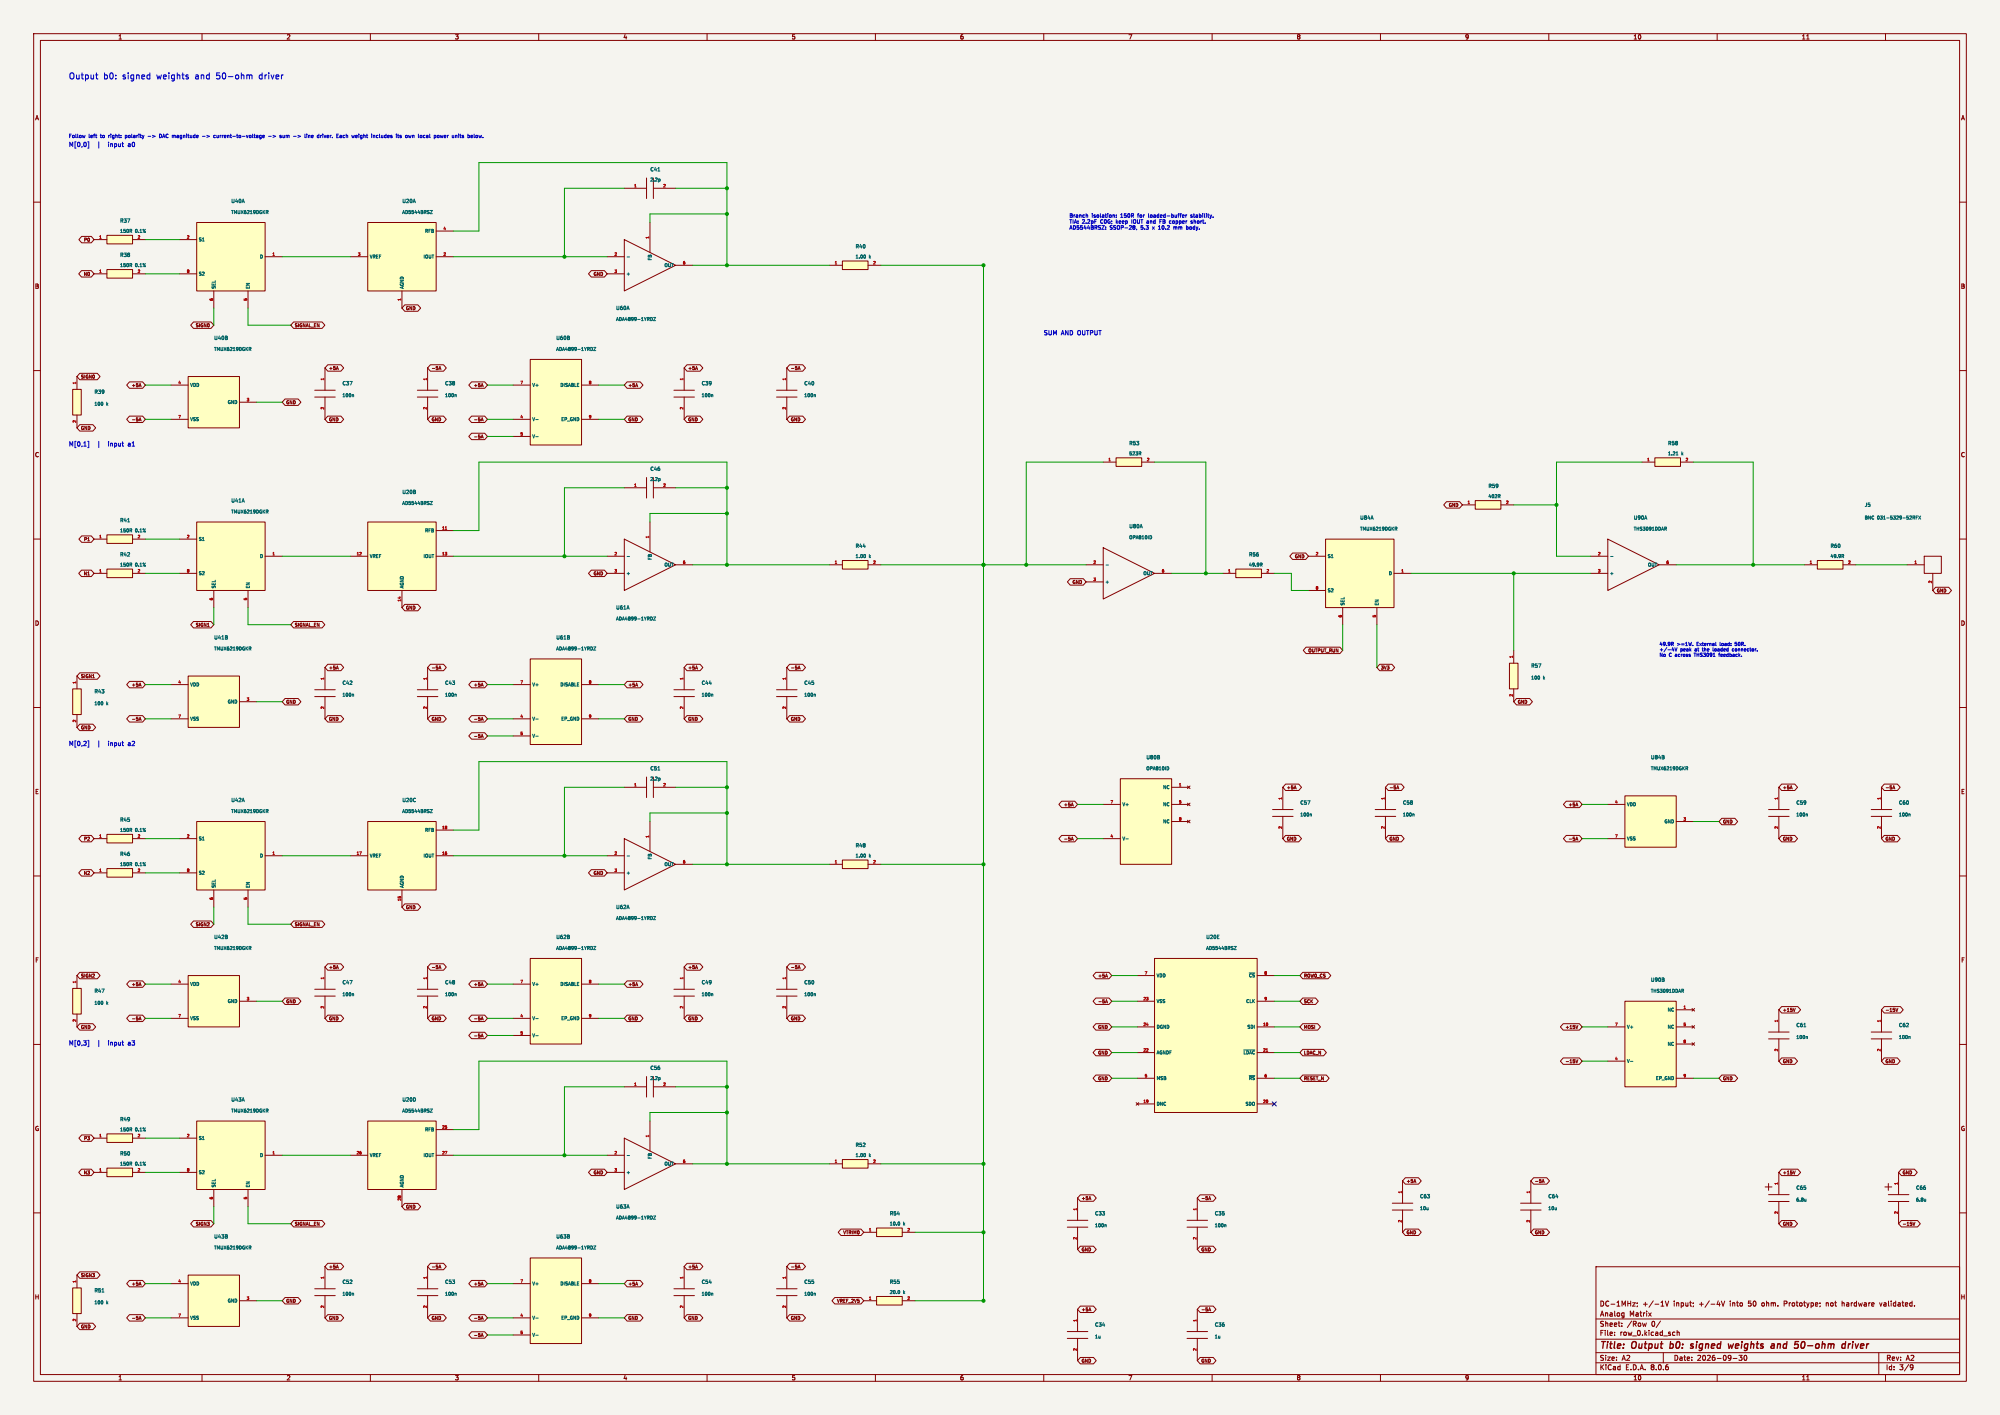
[picture p48: page 3]

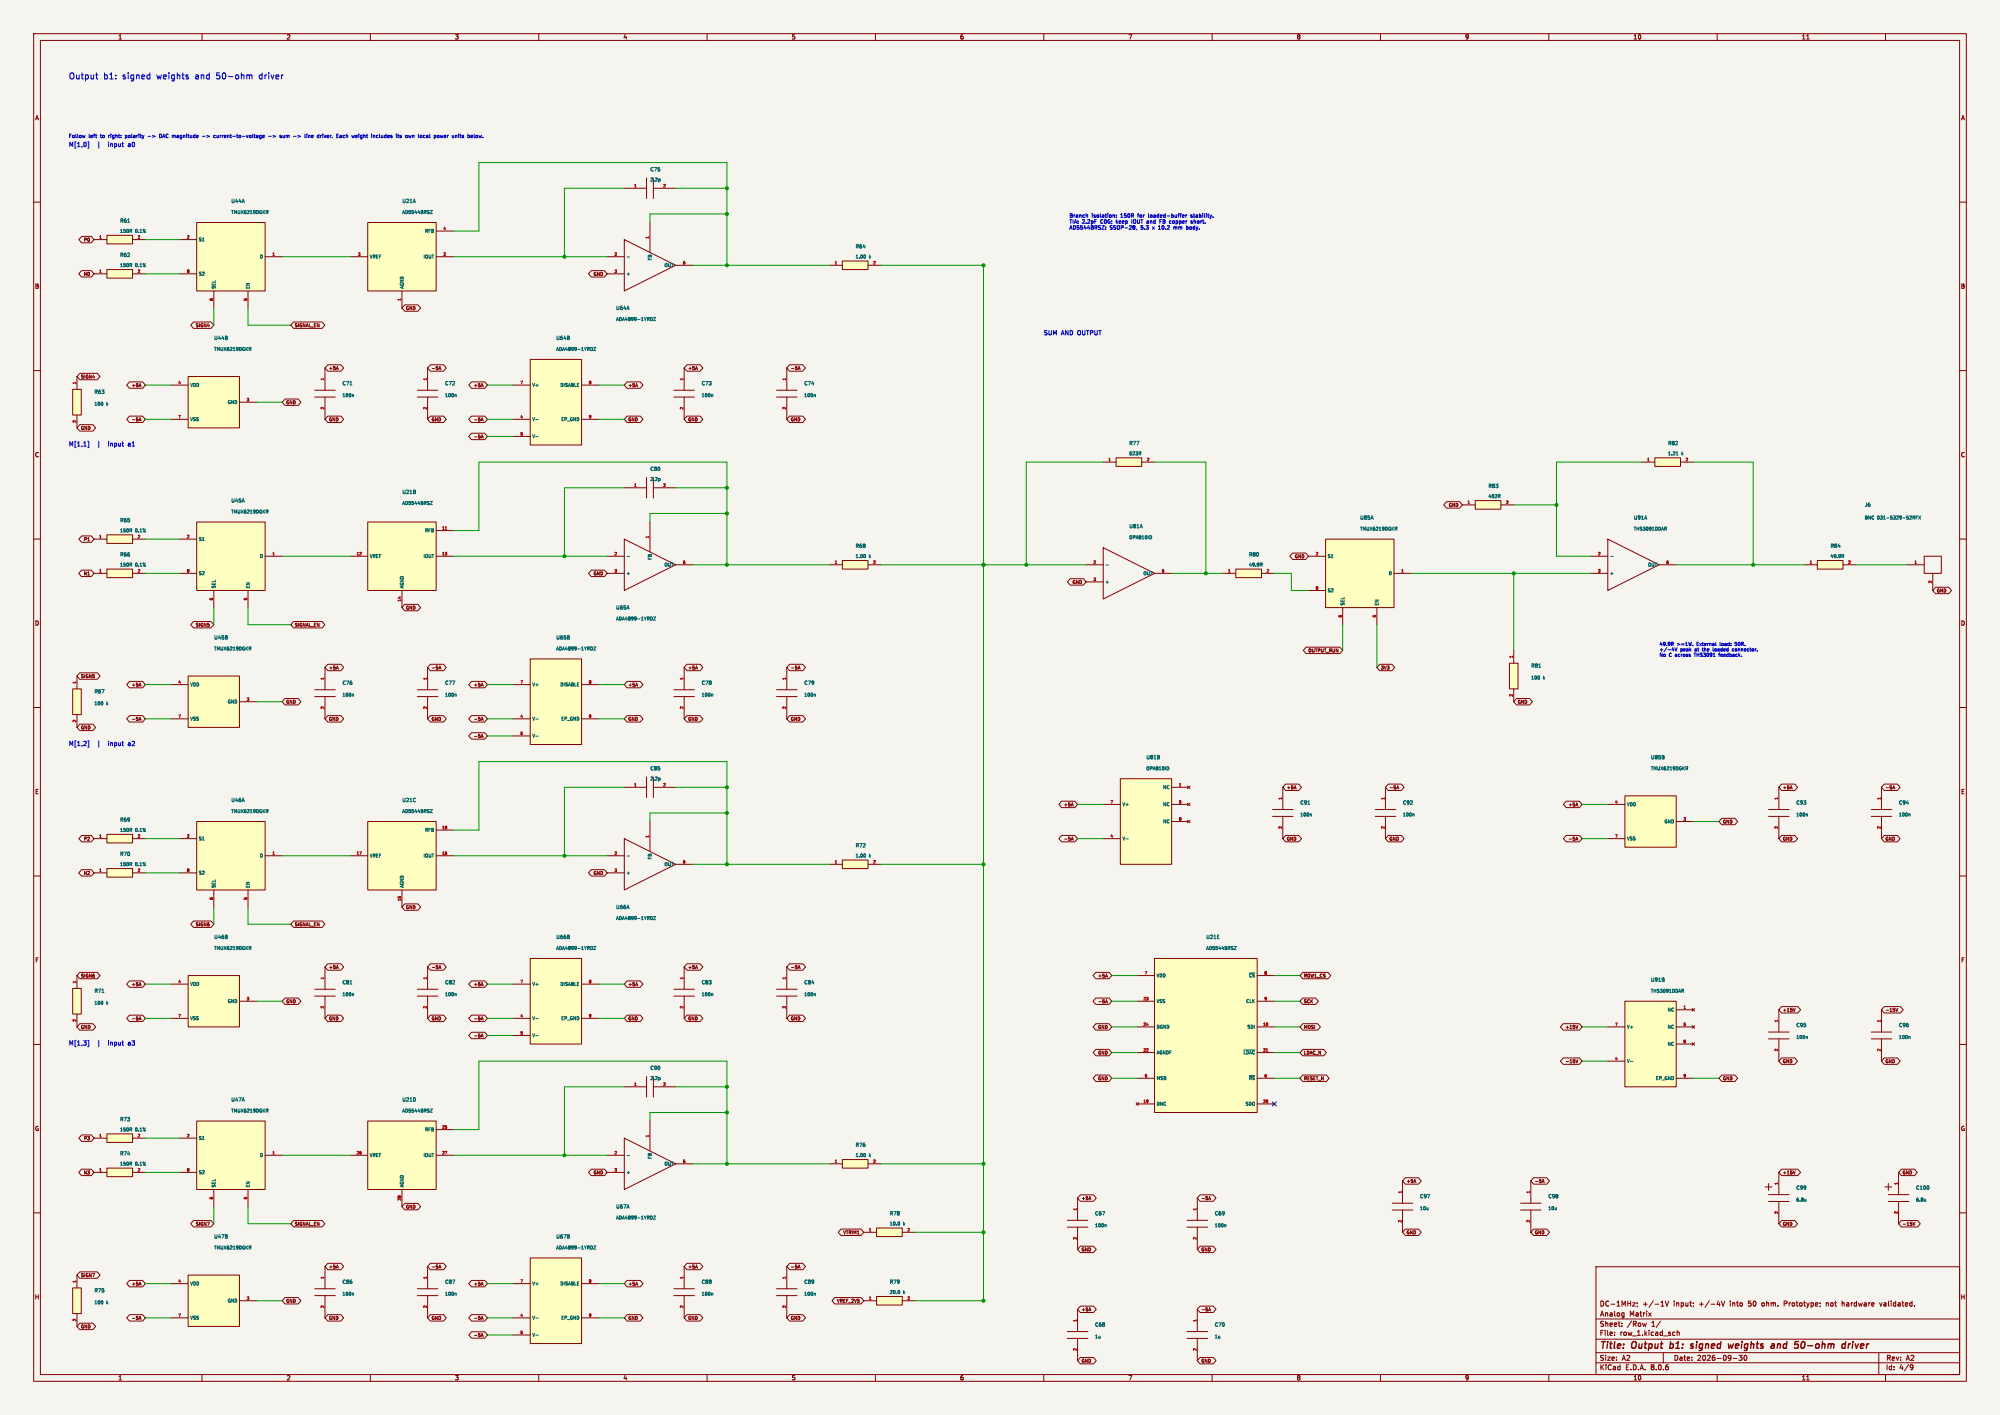
[picture p49: page 4]

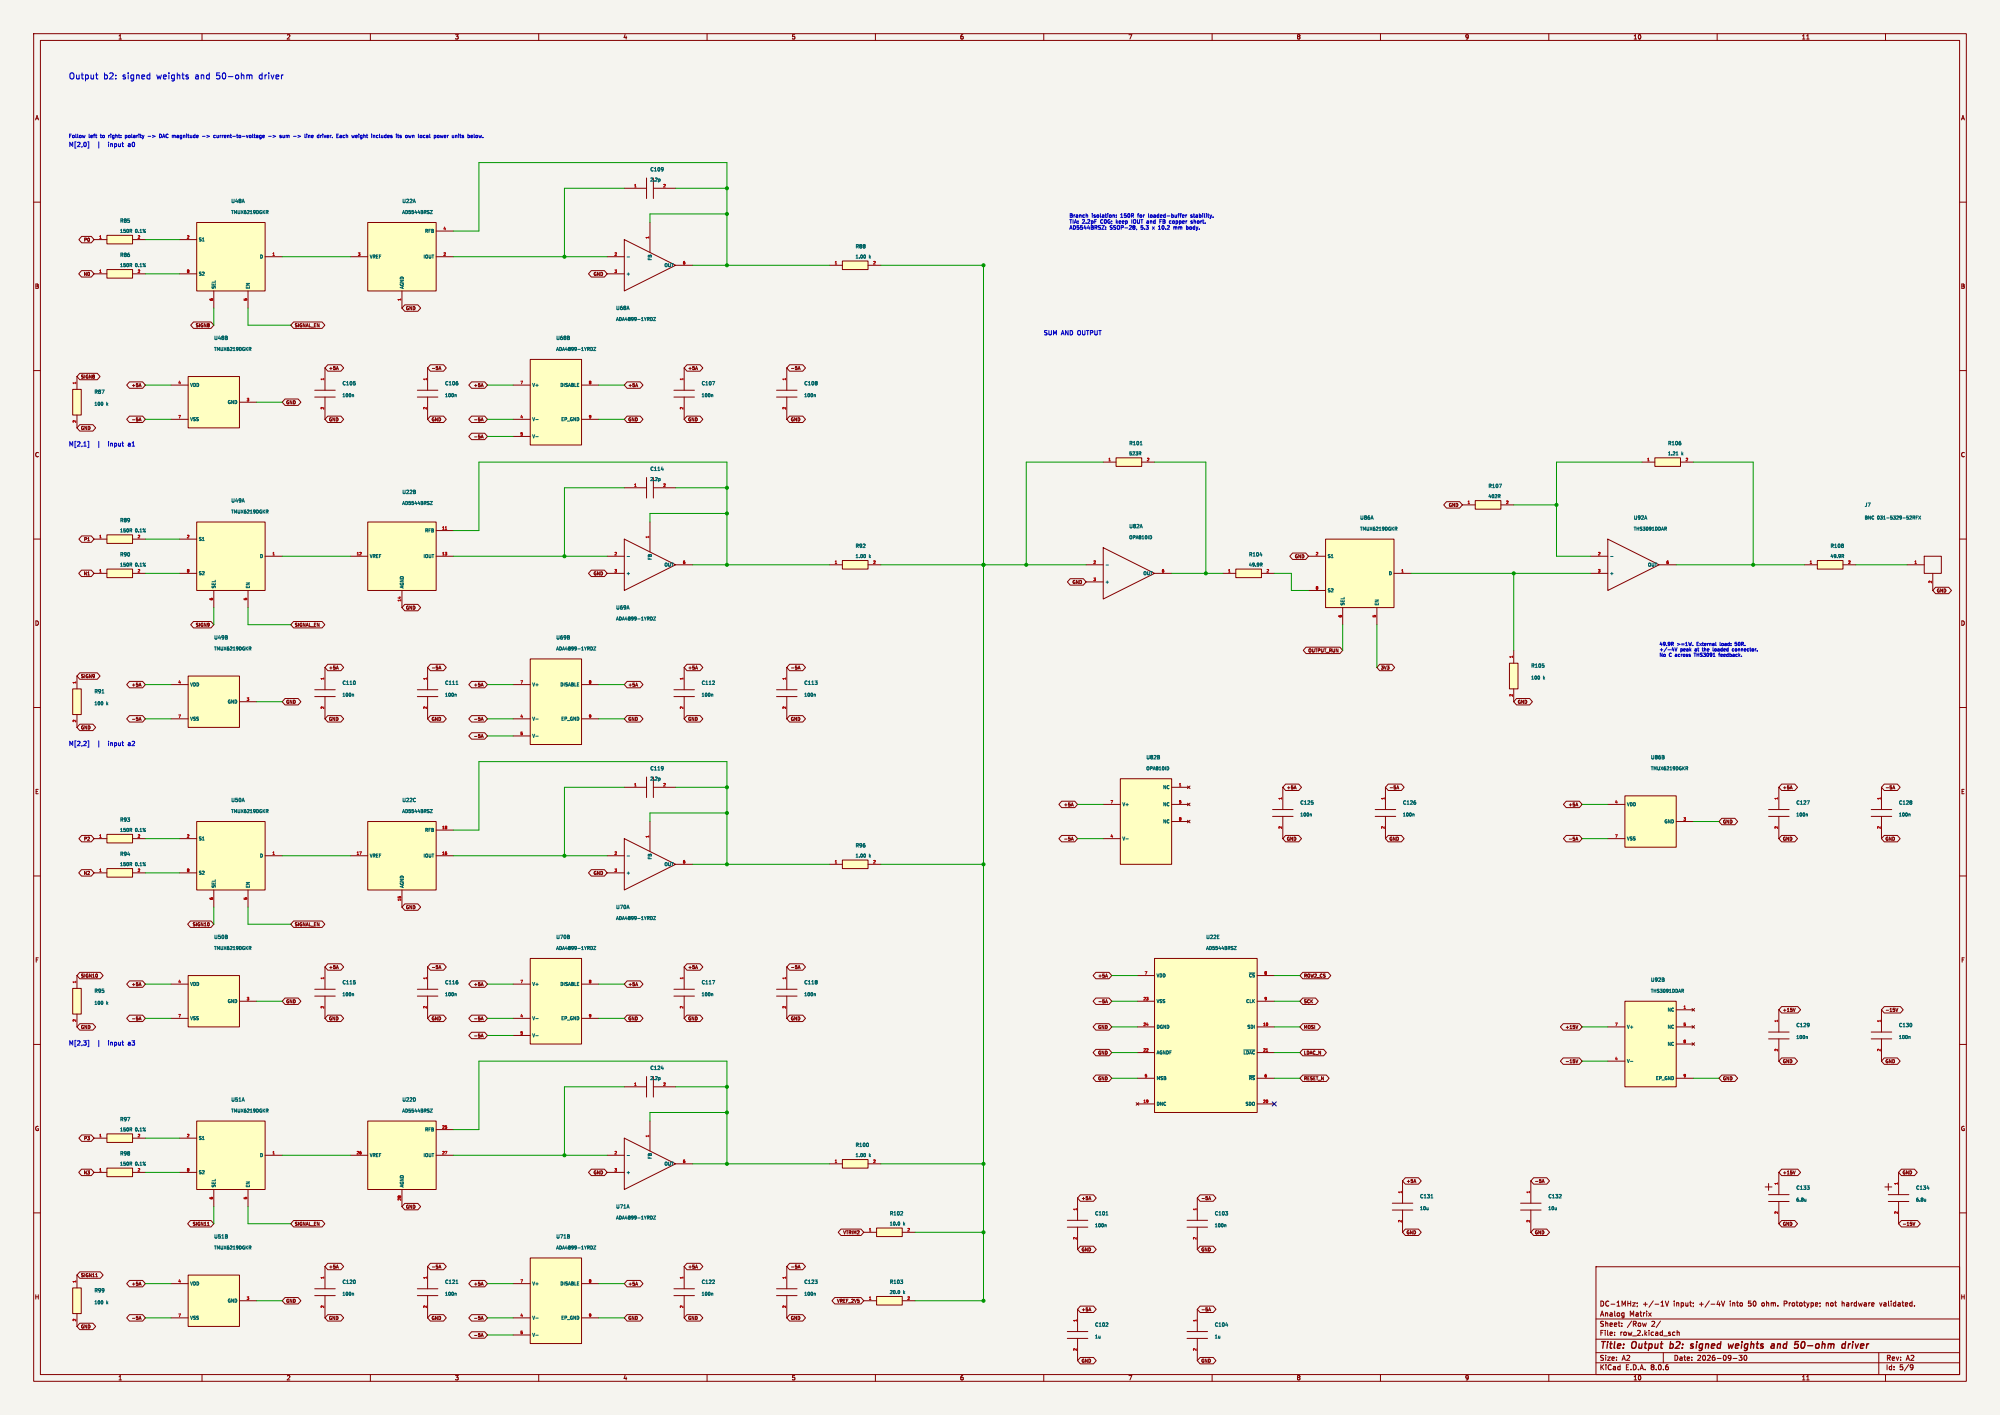
[picture p50: page 5]

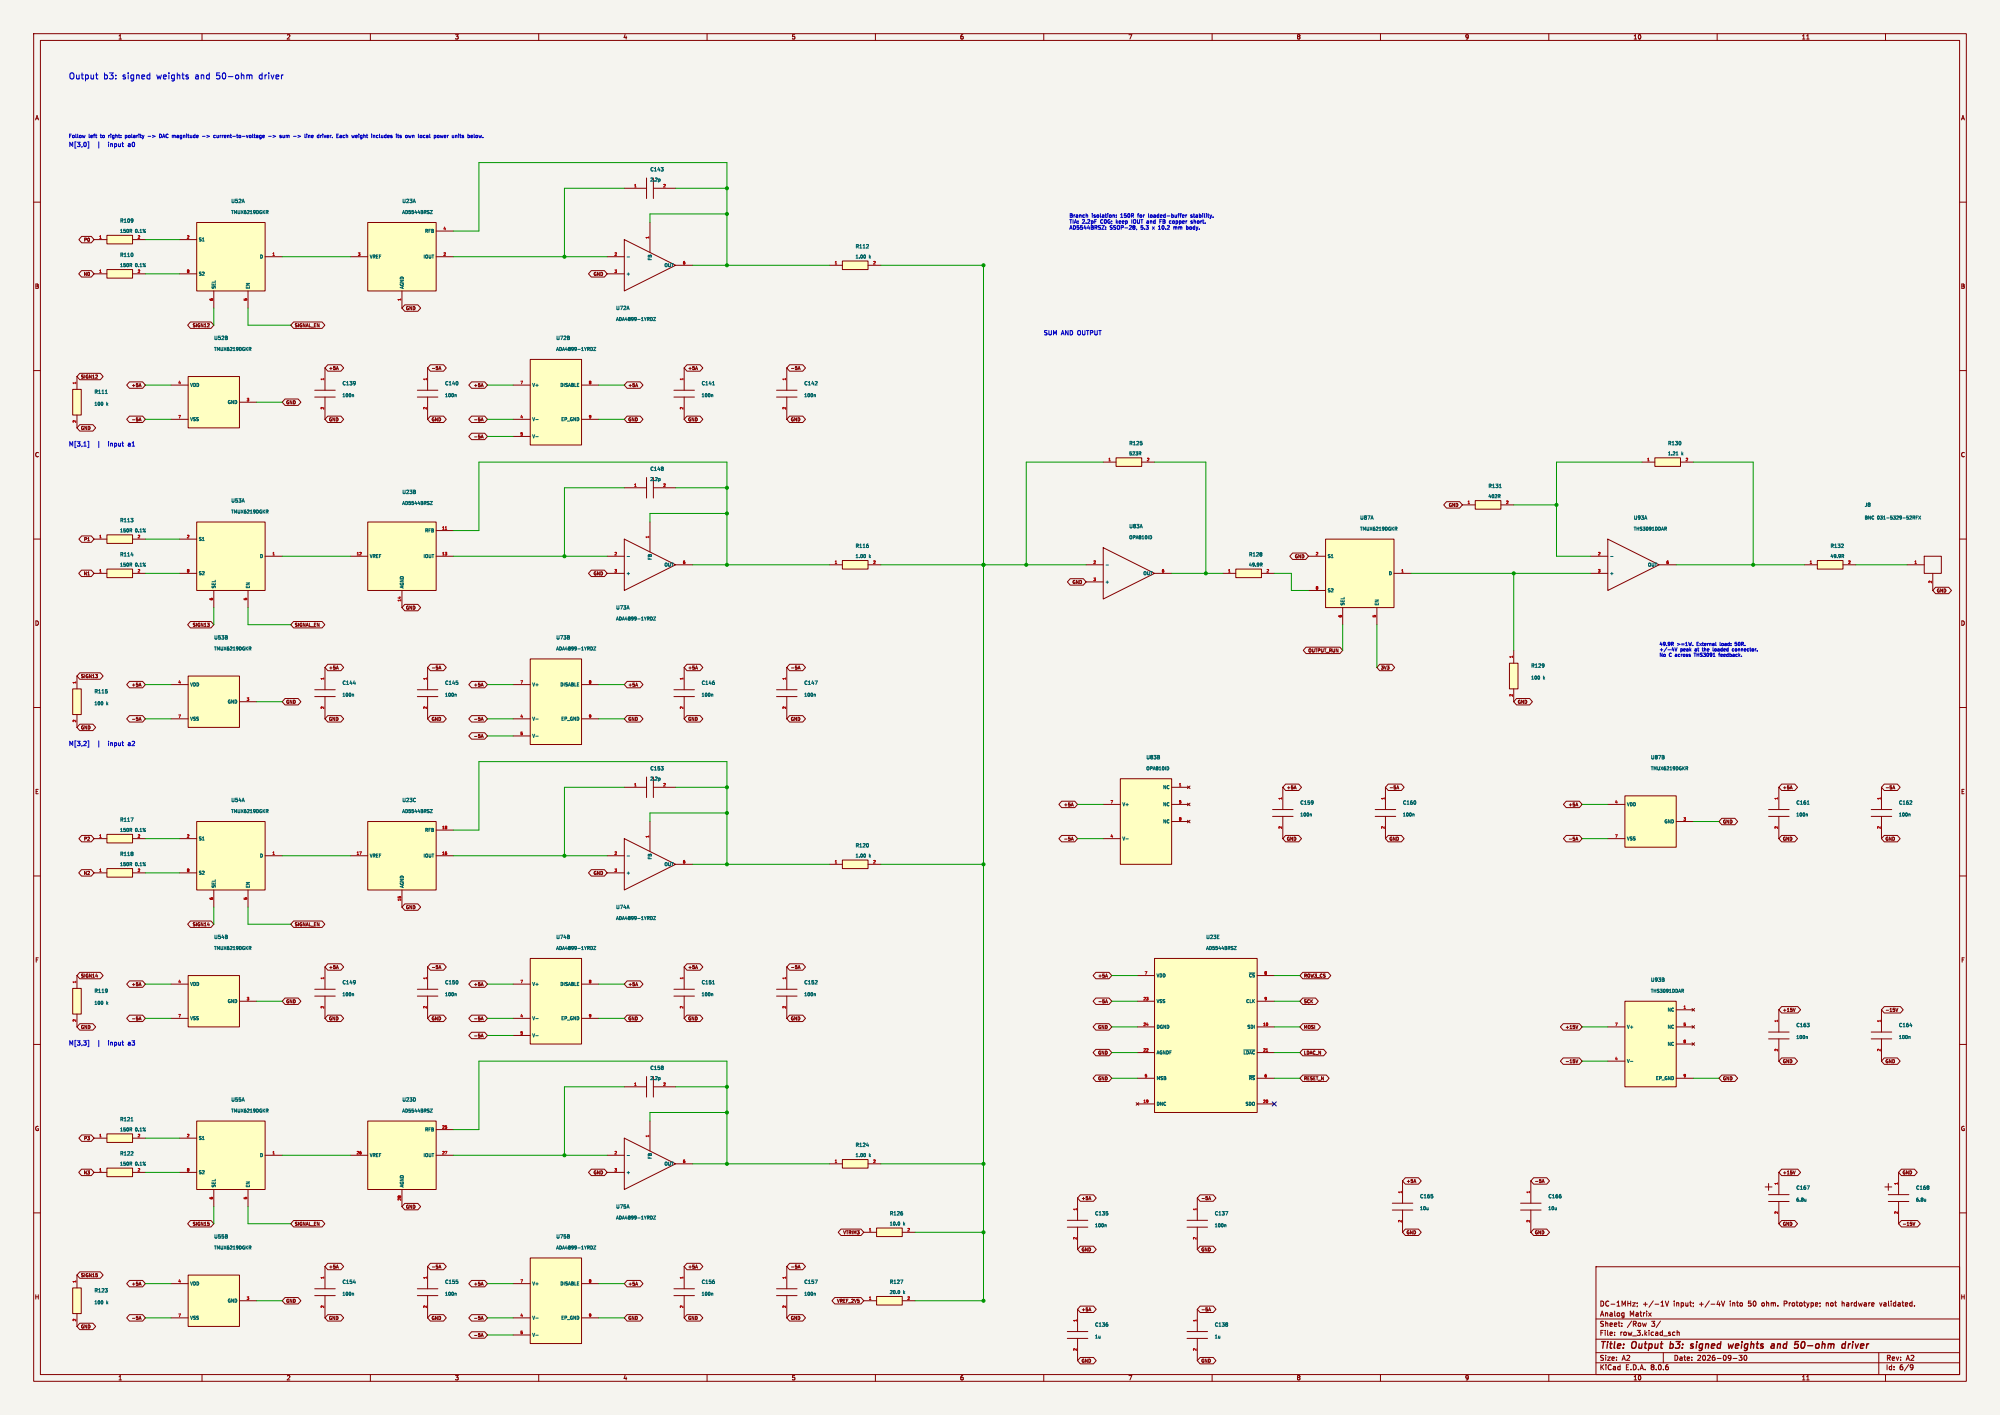
[picture p51: page 6]

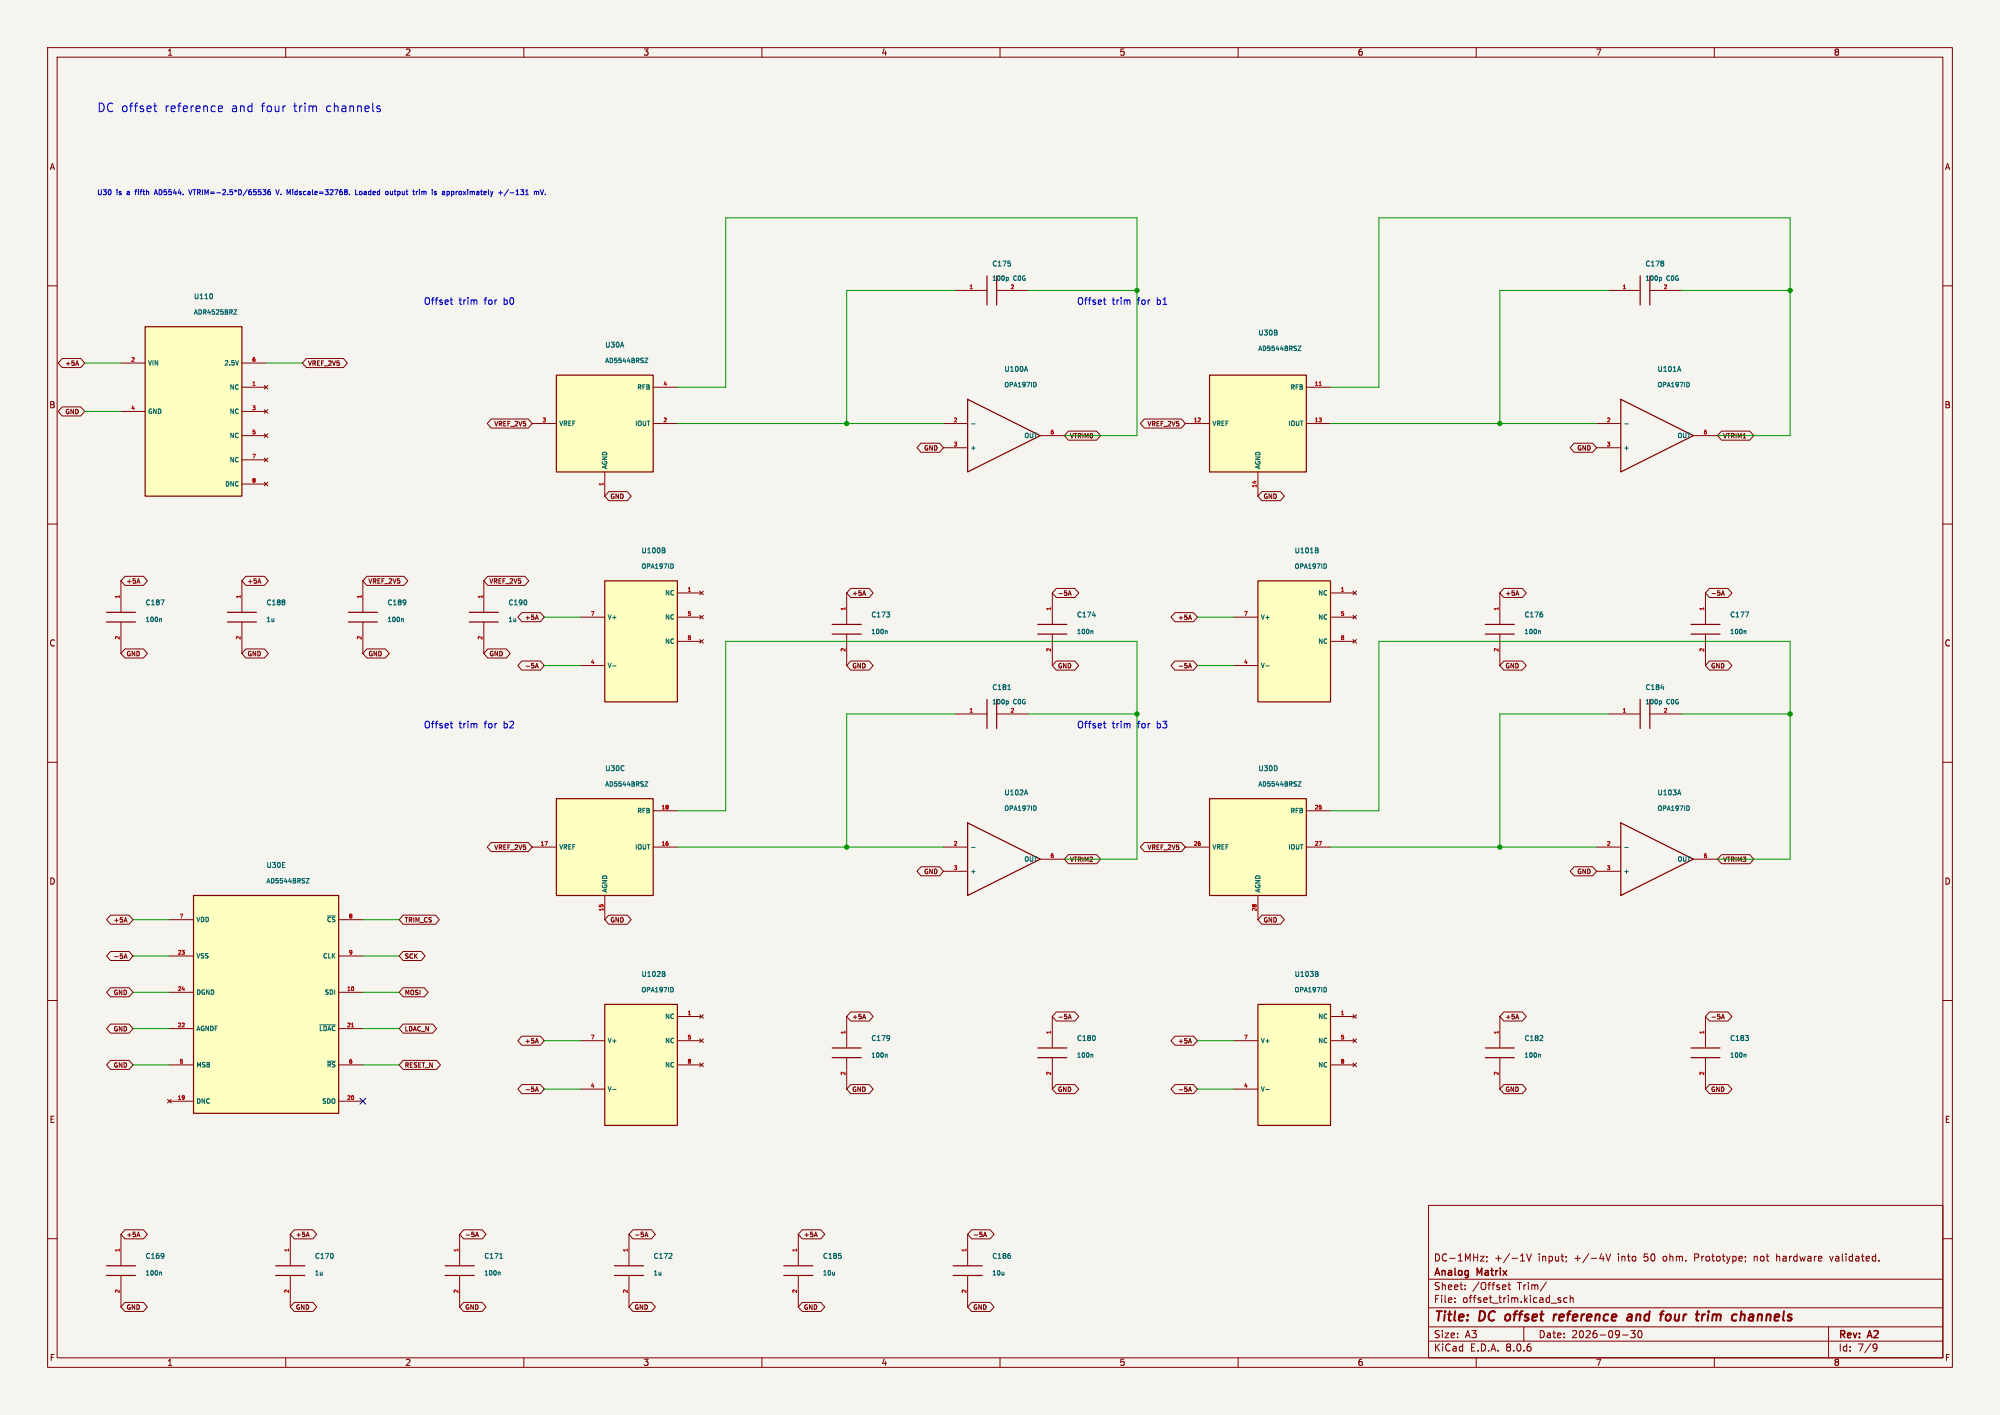
[picture p52: page 7]

+5A GND GND GND GND

Id: 7/9 Title: DC offset reference and four trim channels

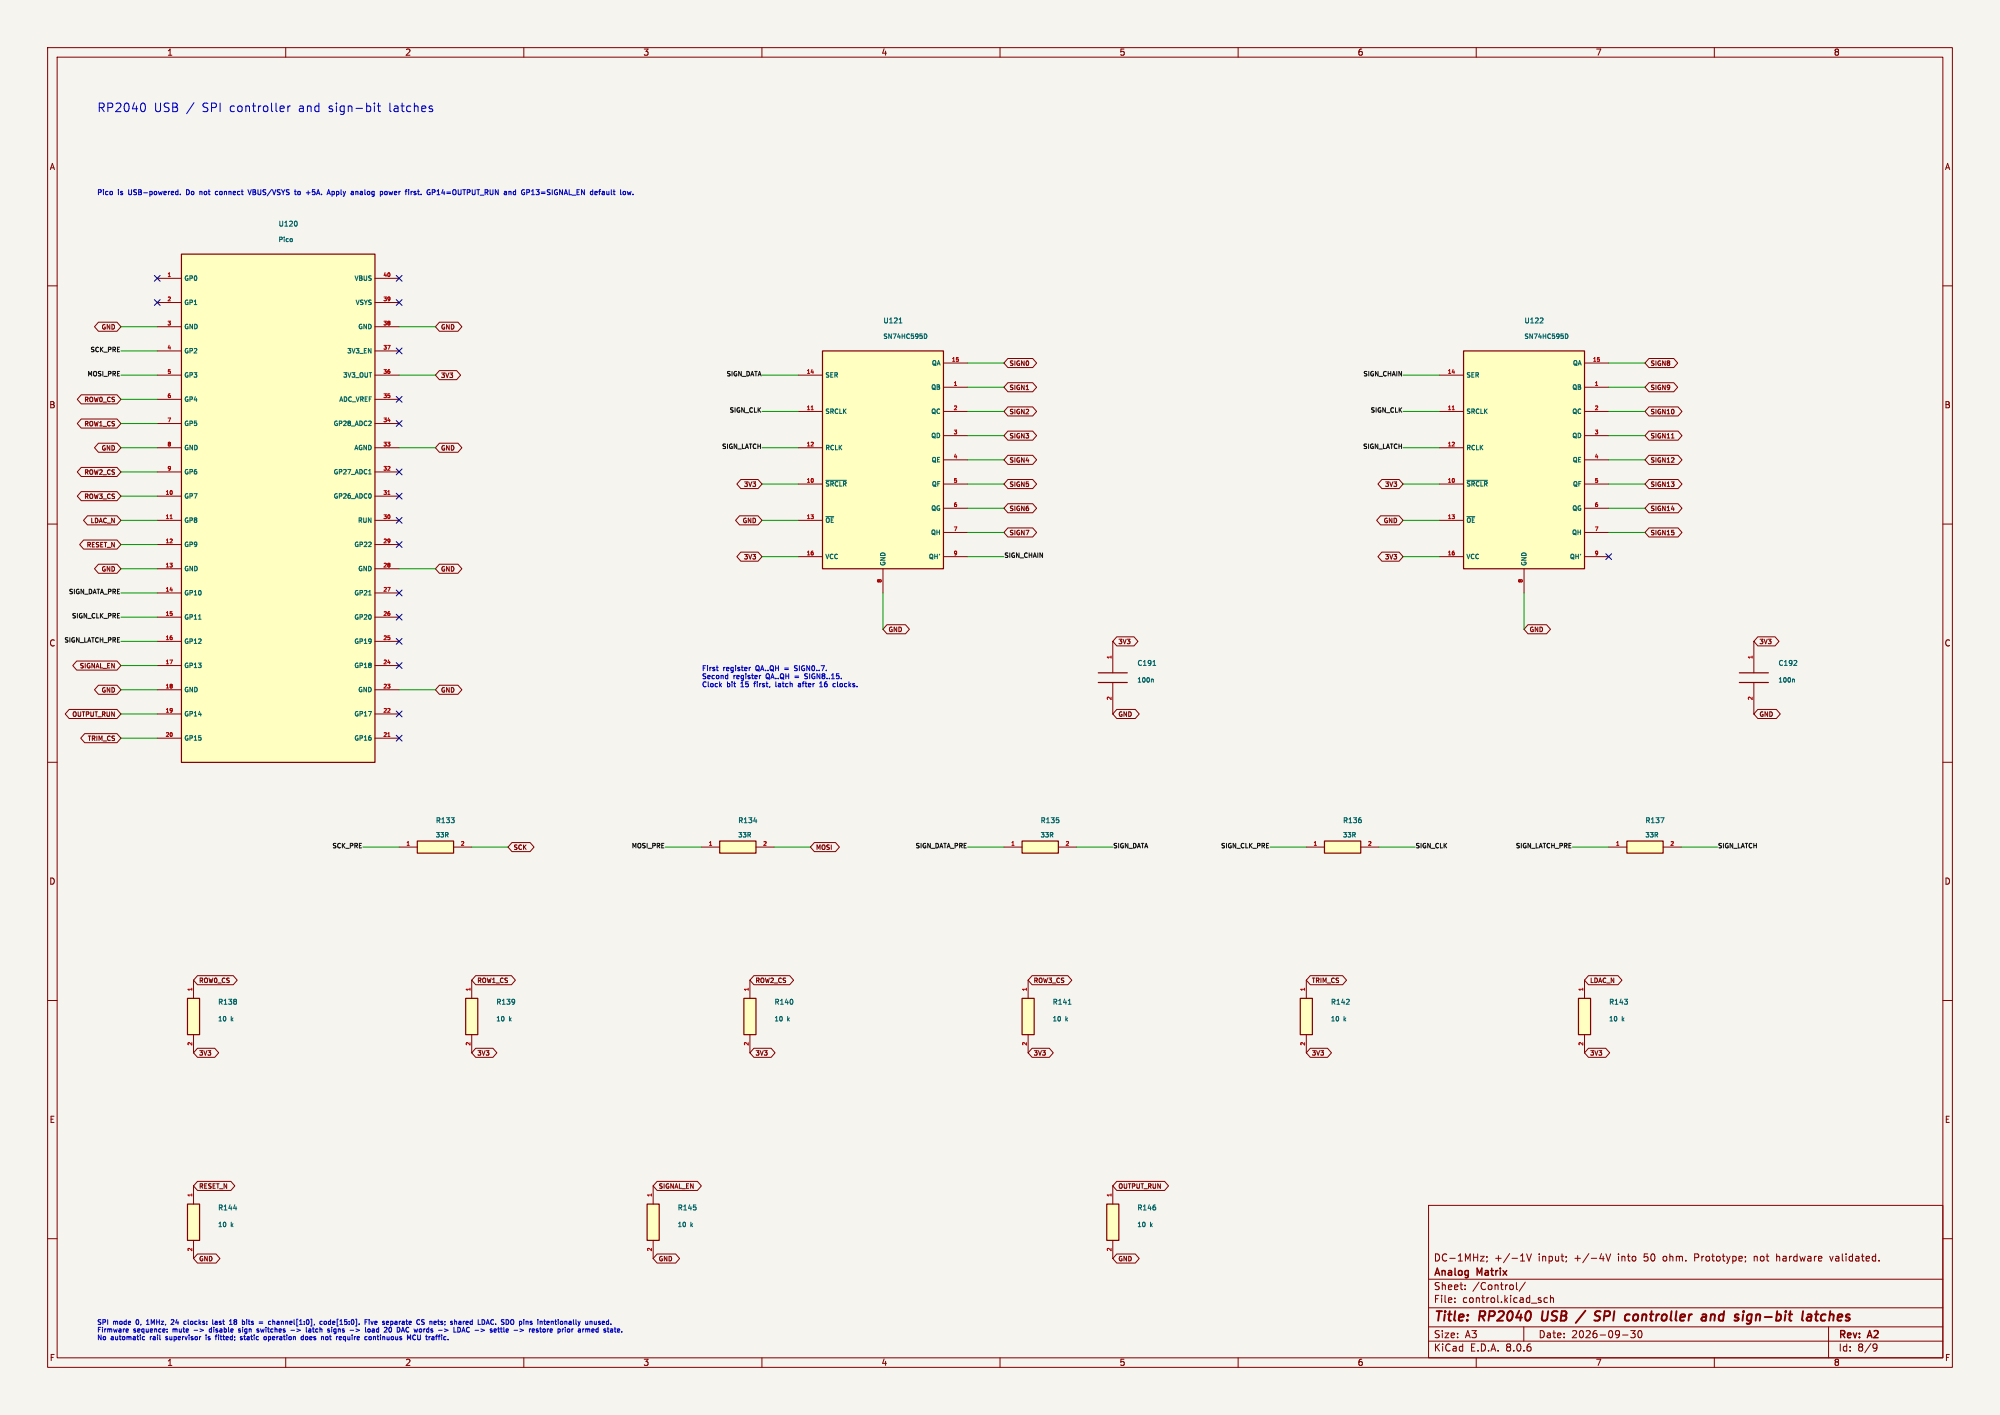
[picture p53: page 8]

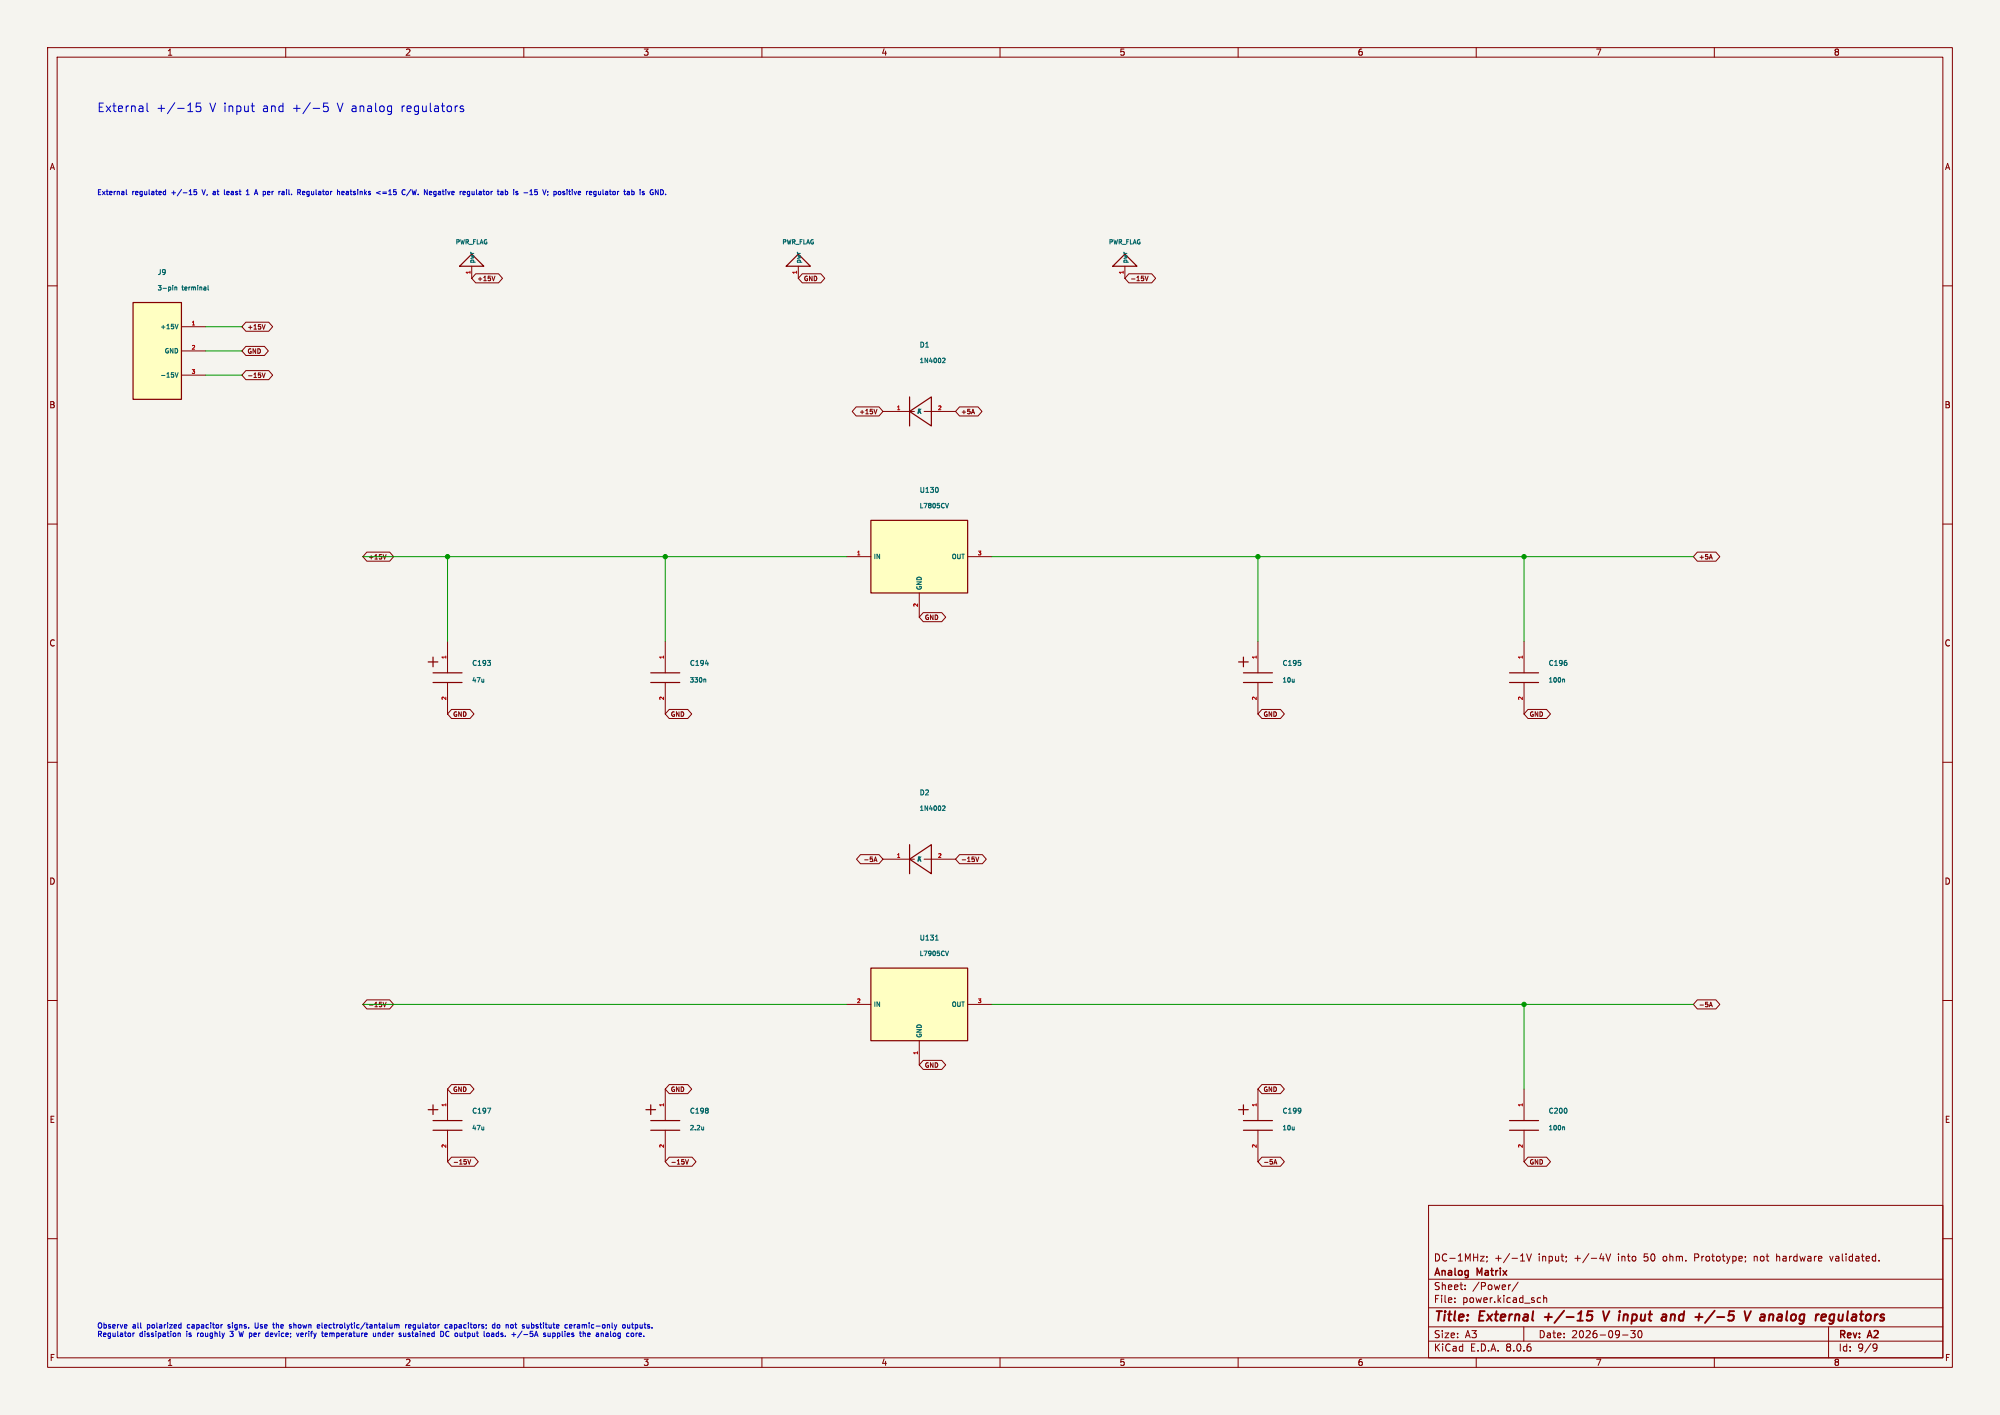
[picture p54: page 9]
