tim4431/analog_programmable_matrix/variants/lc1/hardware/schematic.pdf

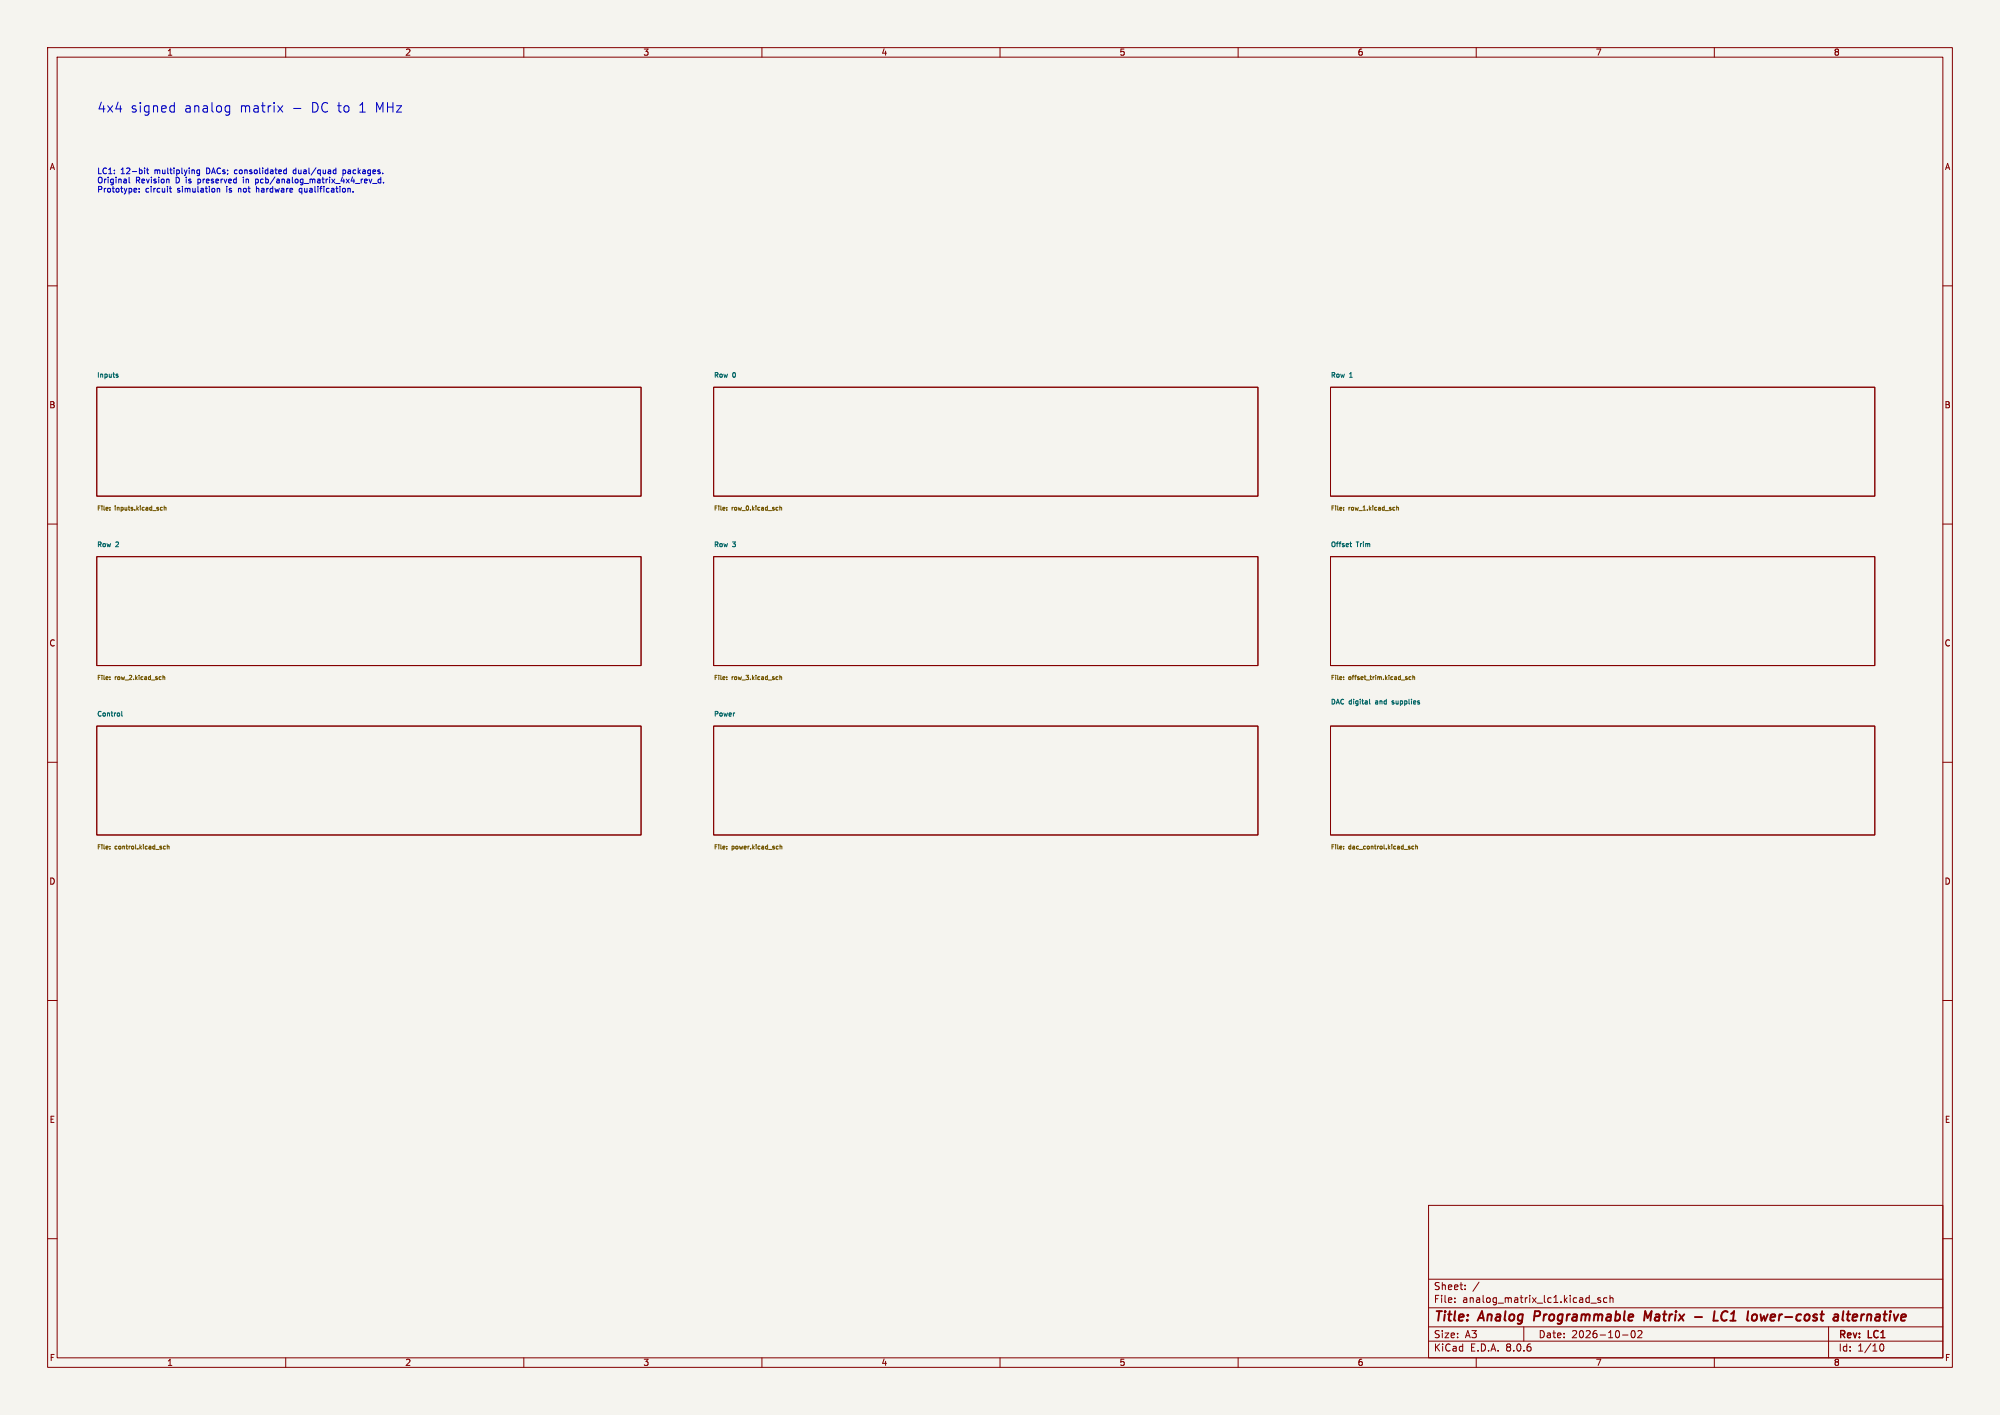
[picture p55: page 1]

Inputs File: inputs.kicad_sch Row 2

File: row_2.kicad_sch Control File: control.kicad_sch

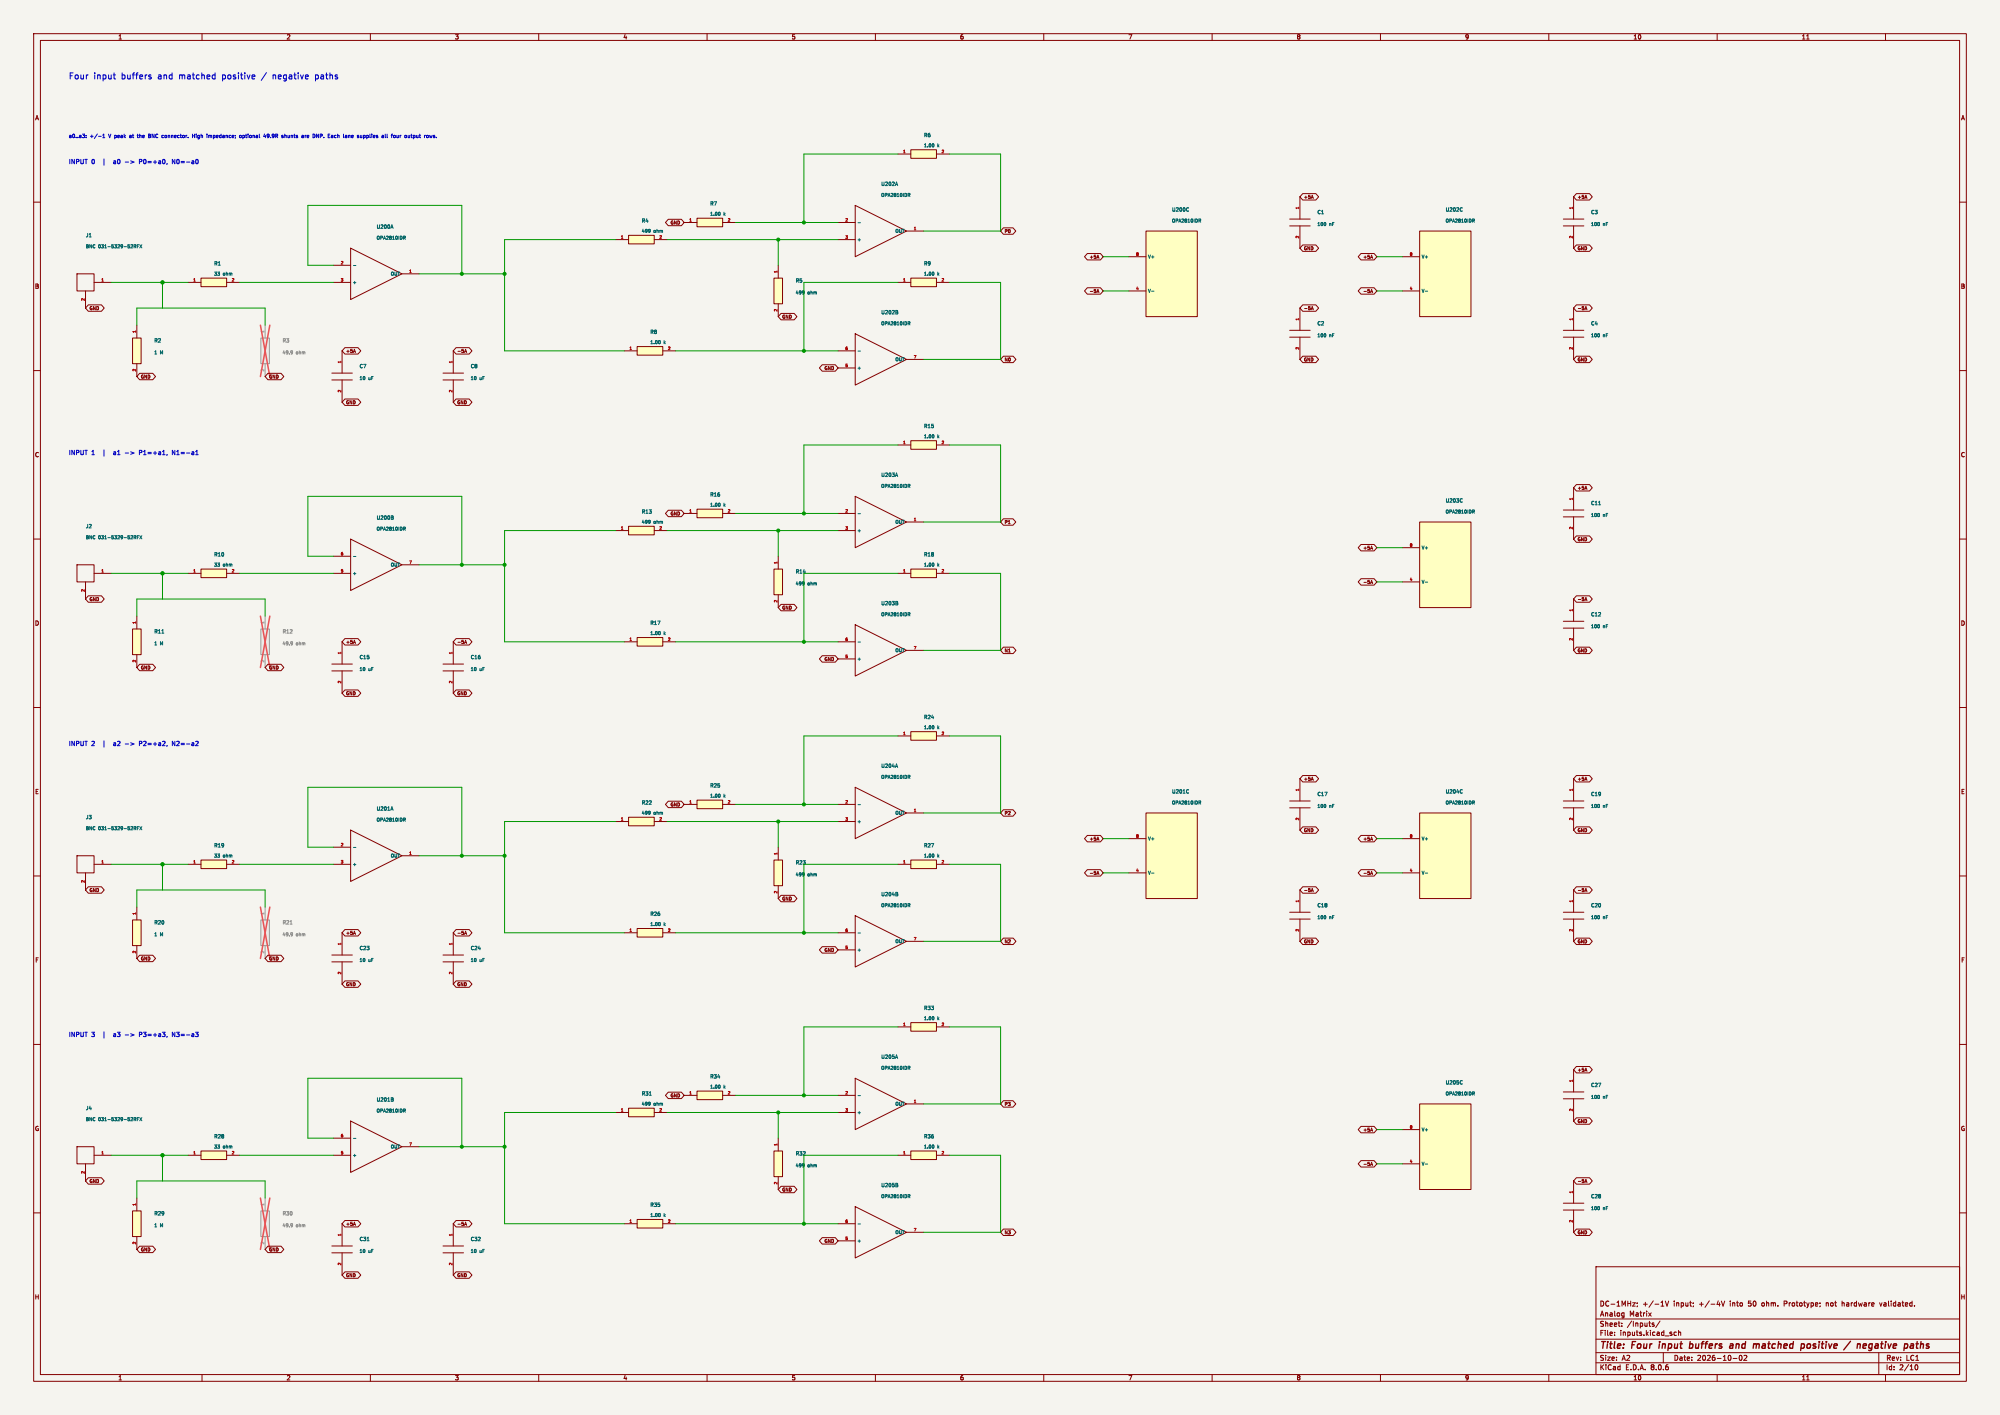
[picture p56: page 2]

Four input buffers and matched positive / negative paths

File: inputs.kicad_sch Sheet: /Inputs/

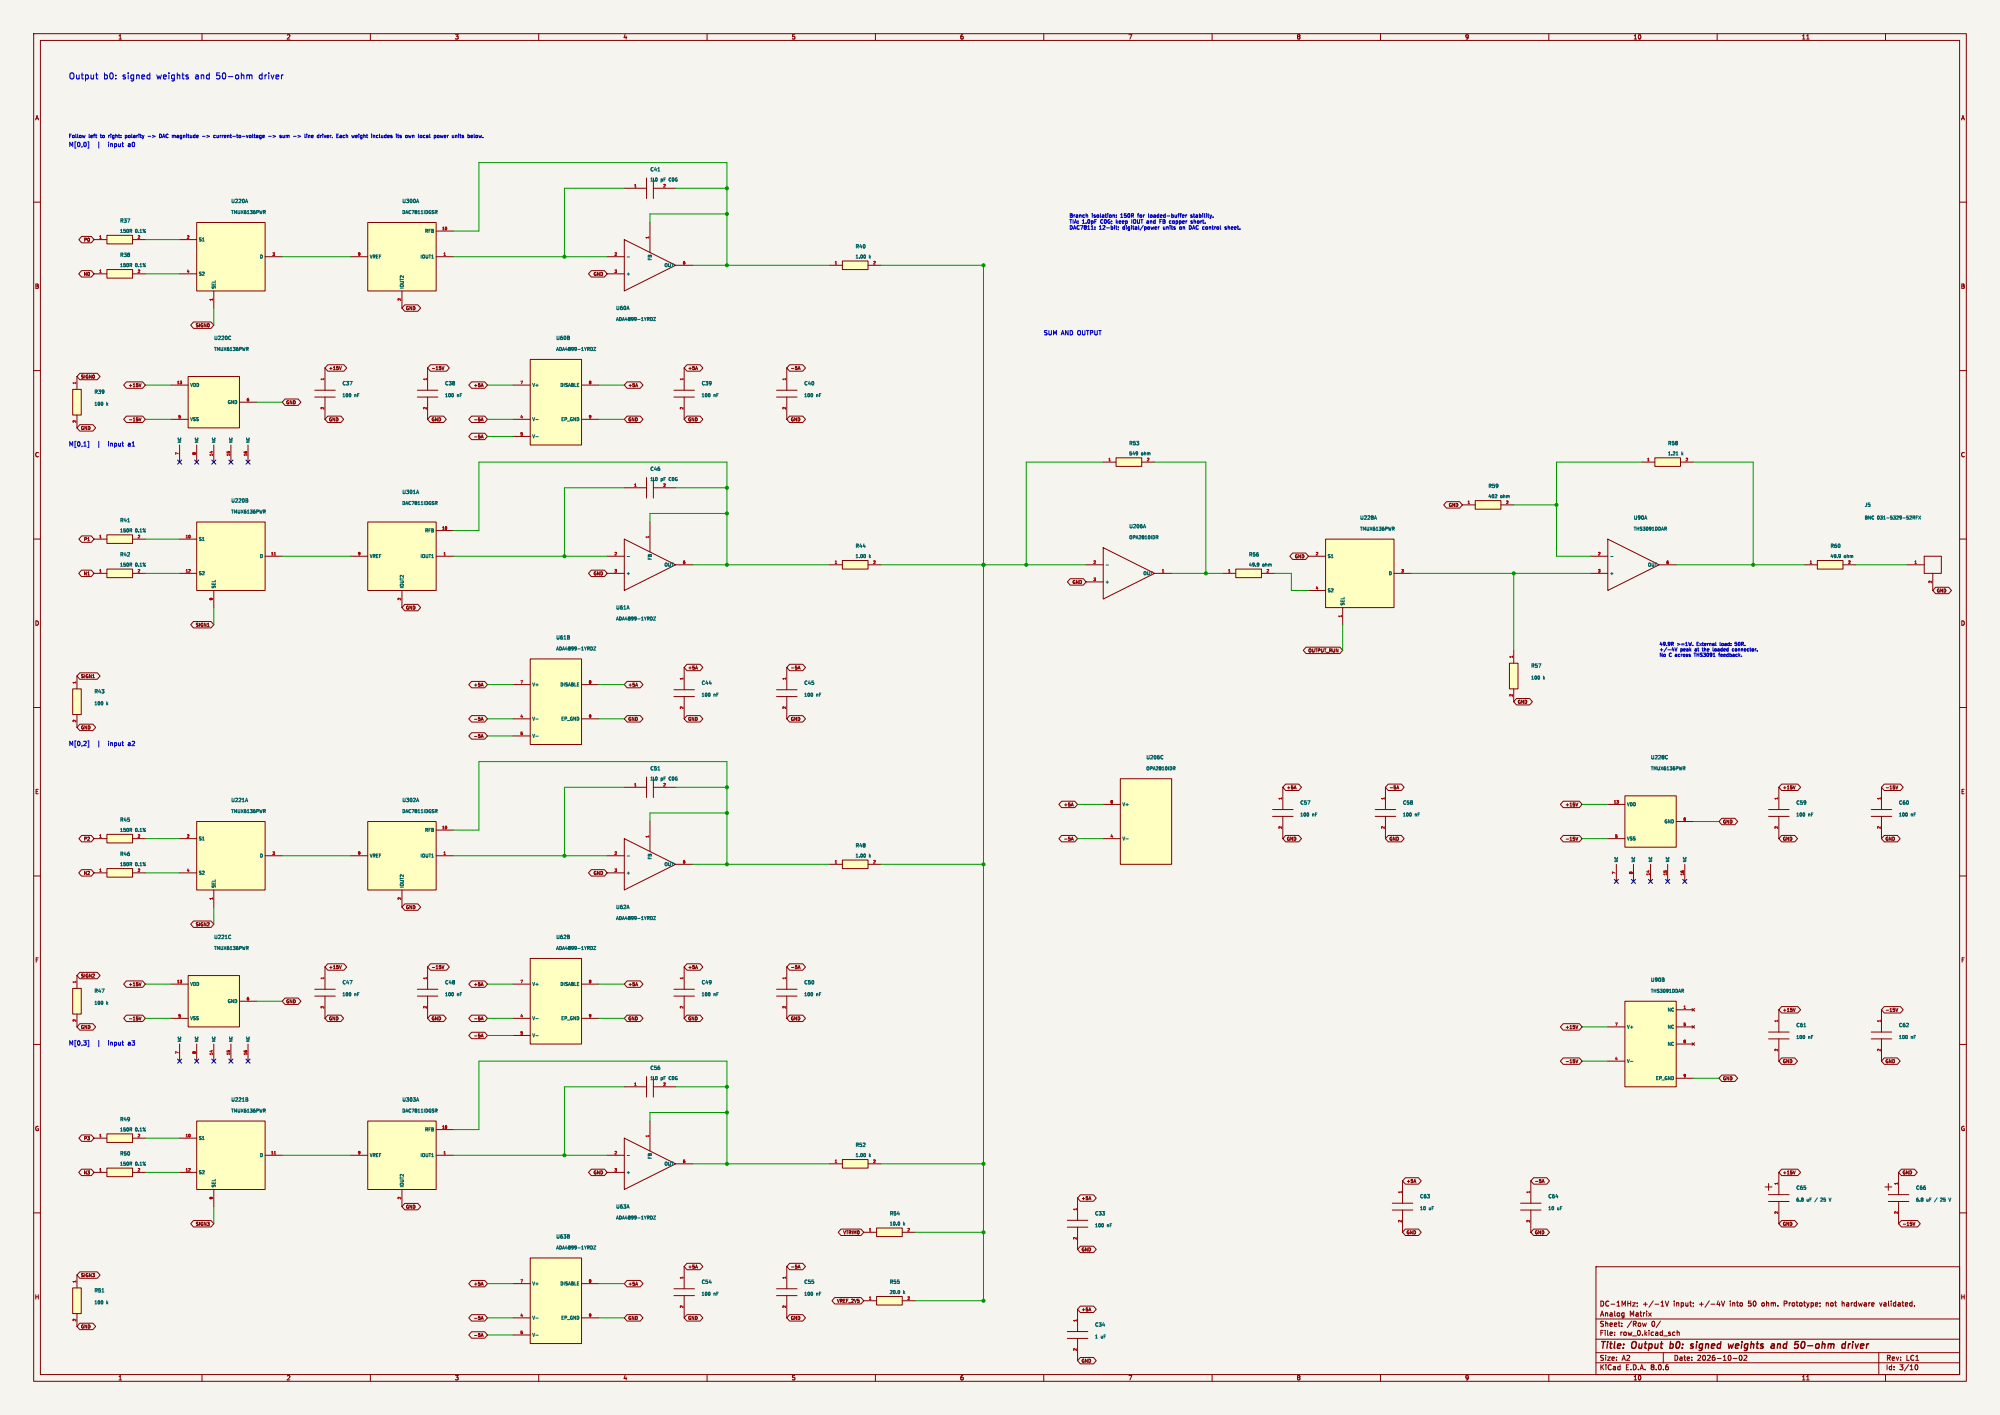
[picture p57: page 3]

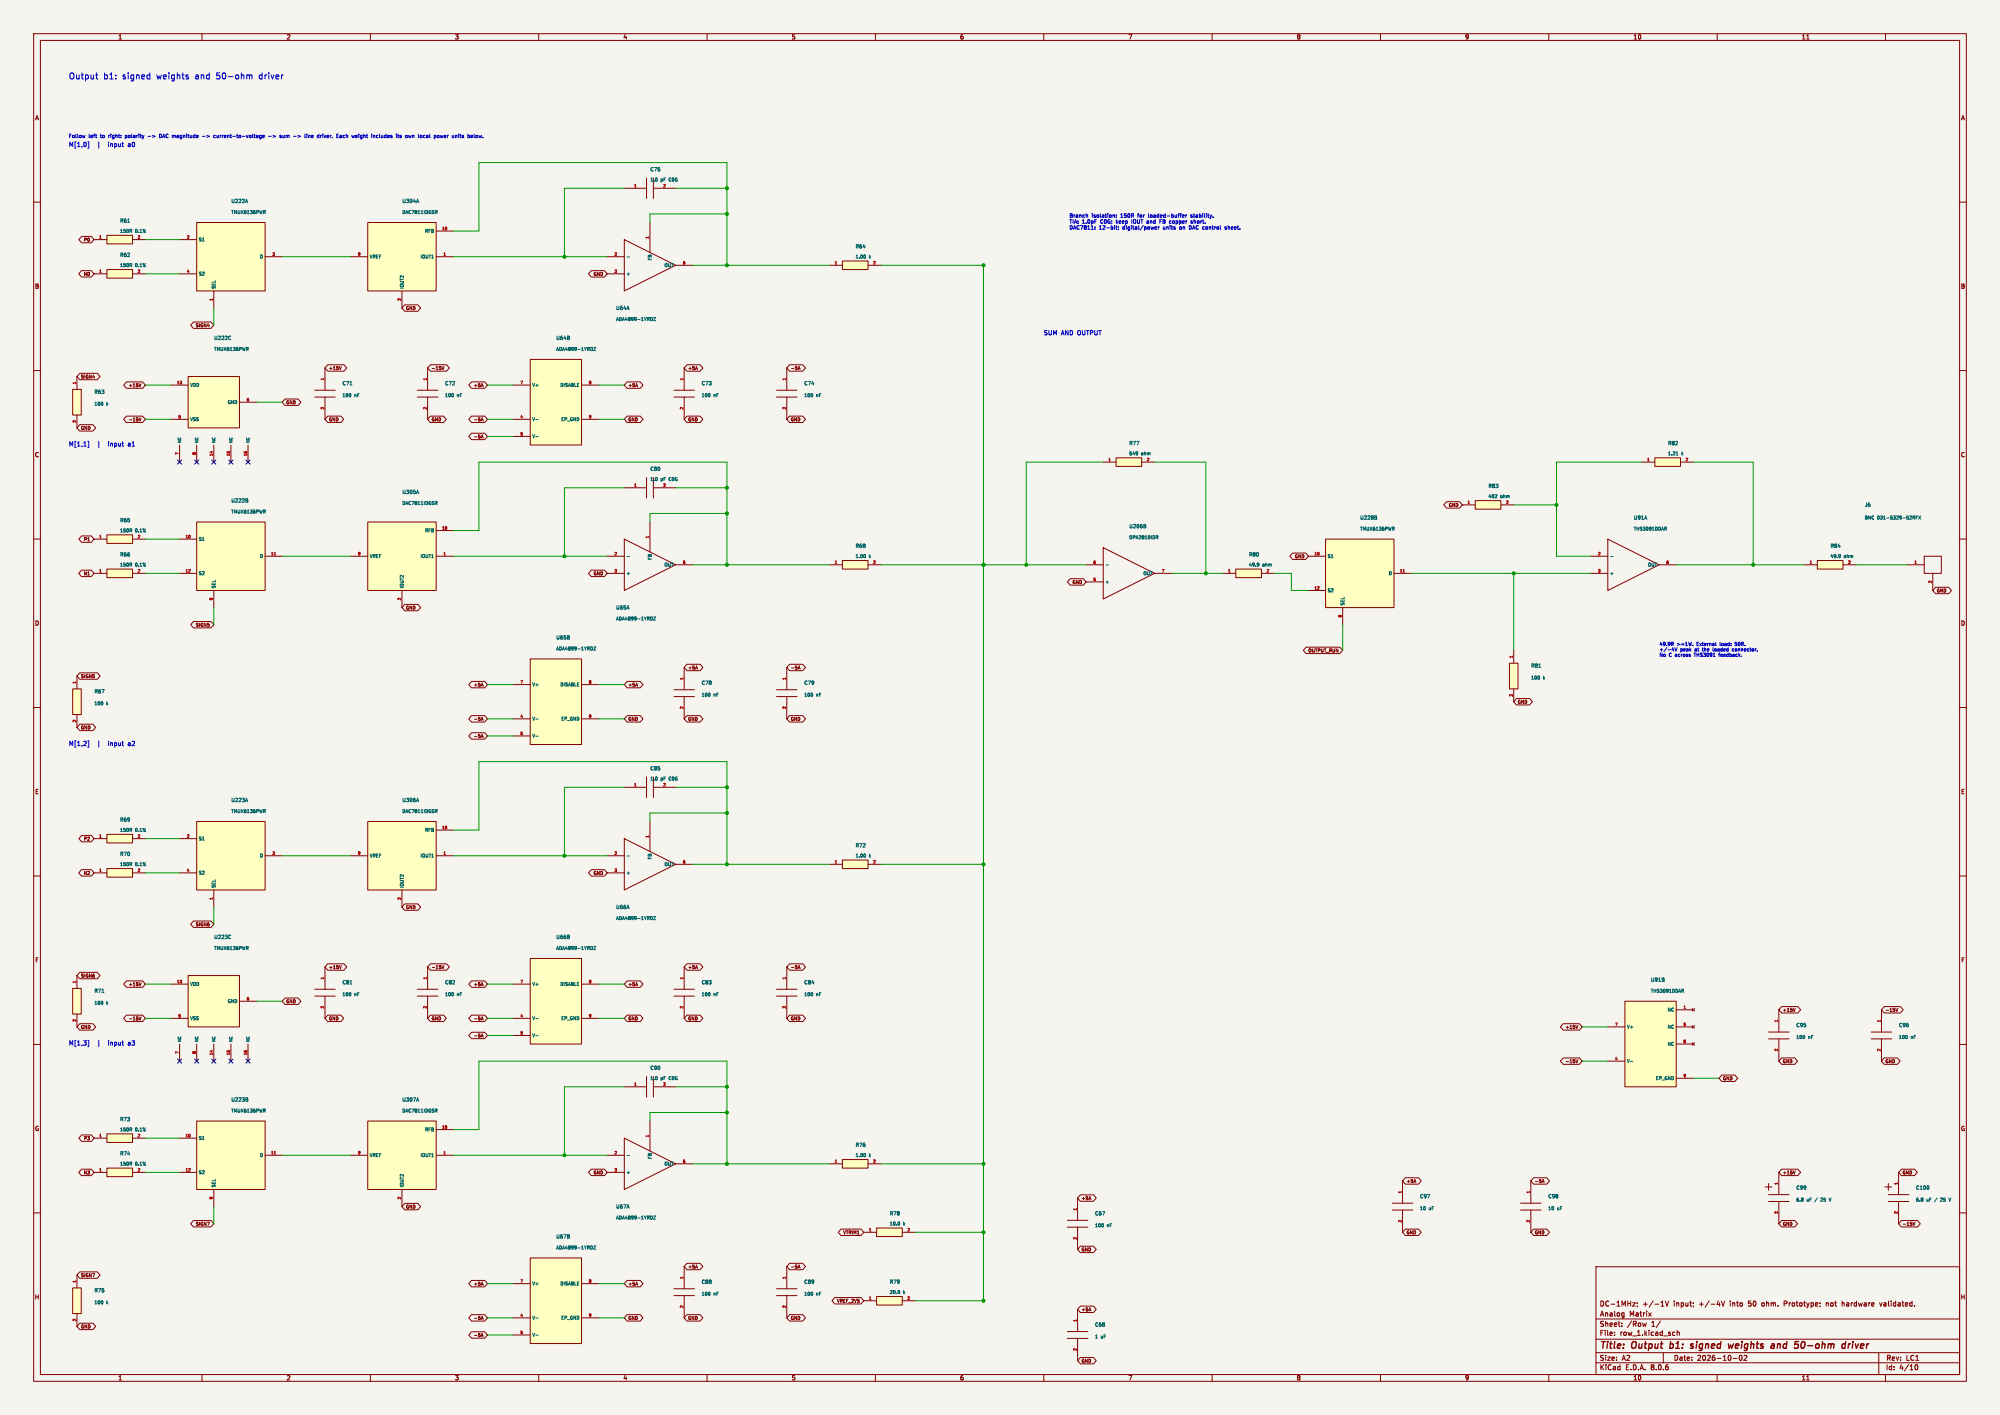
[picture p58: page 4]

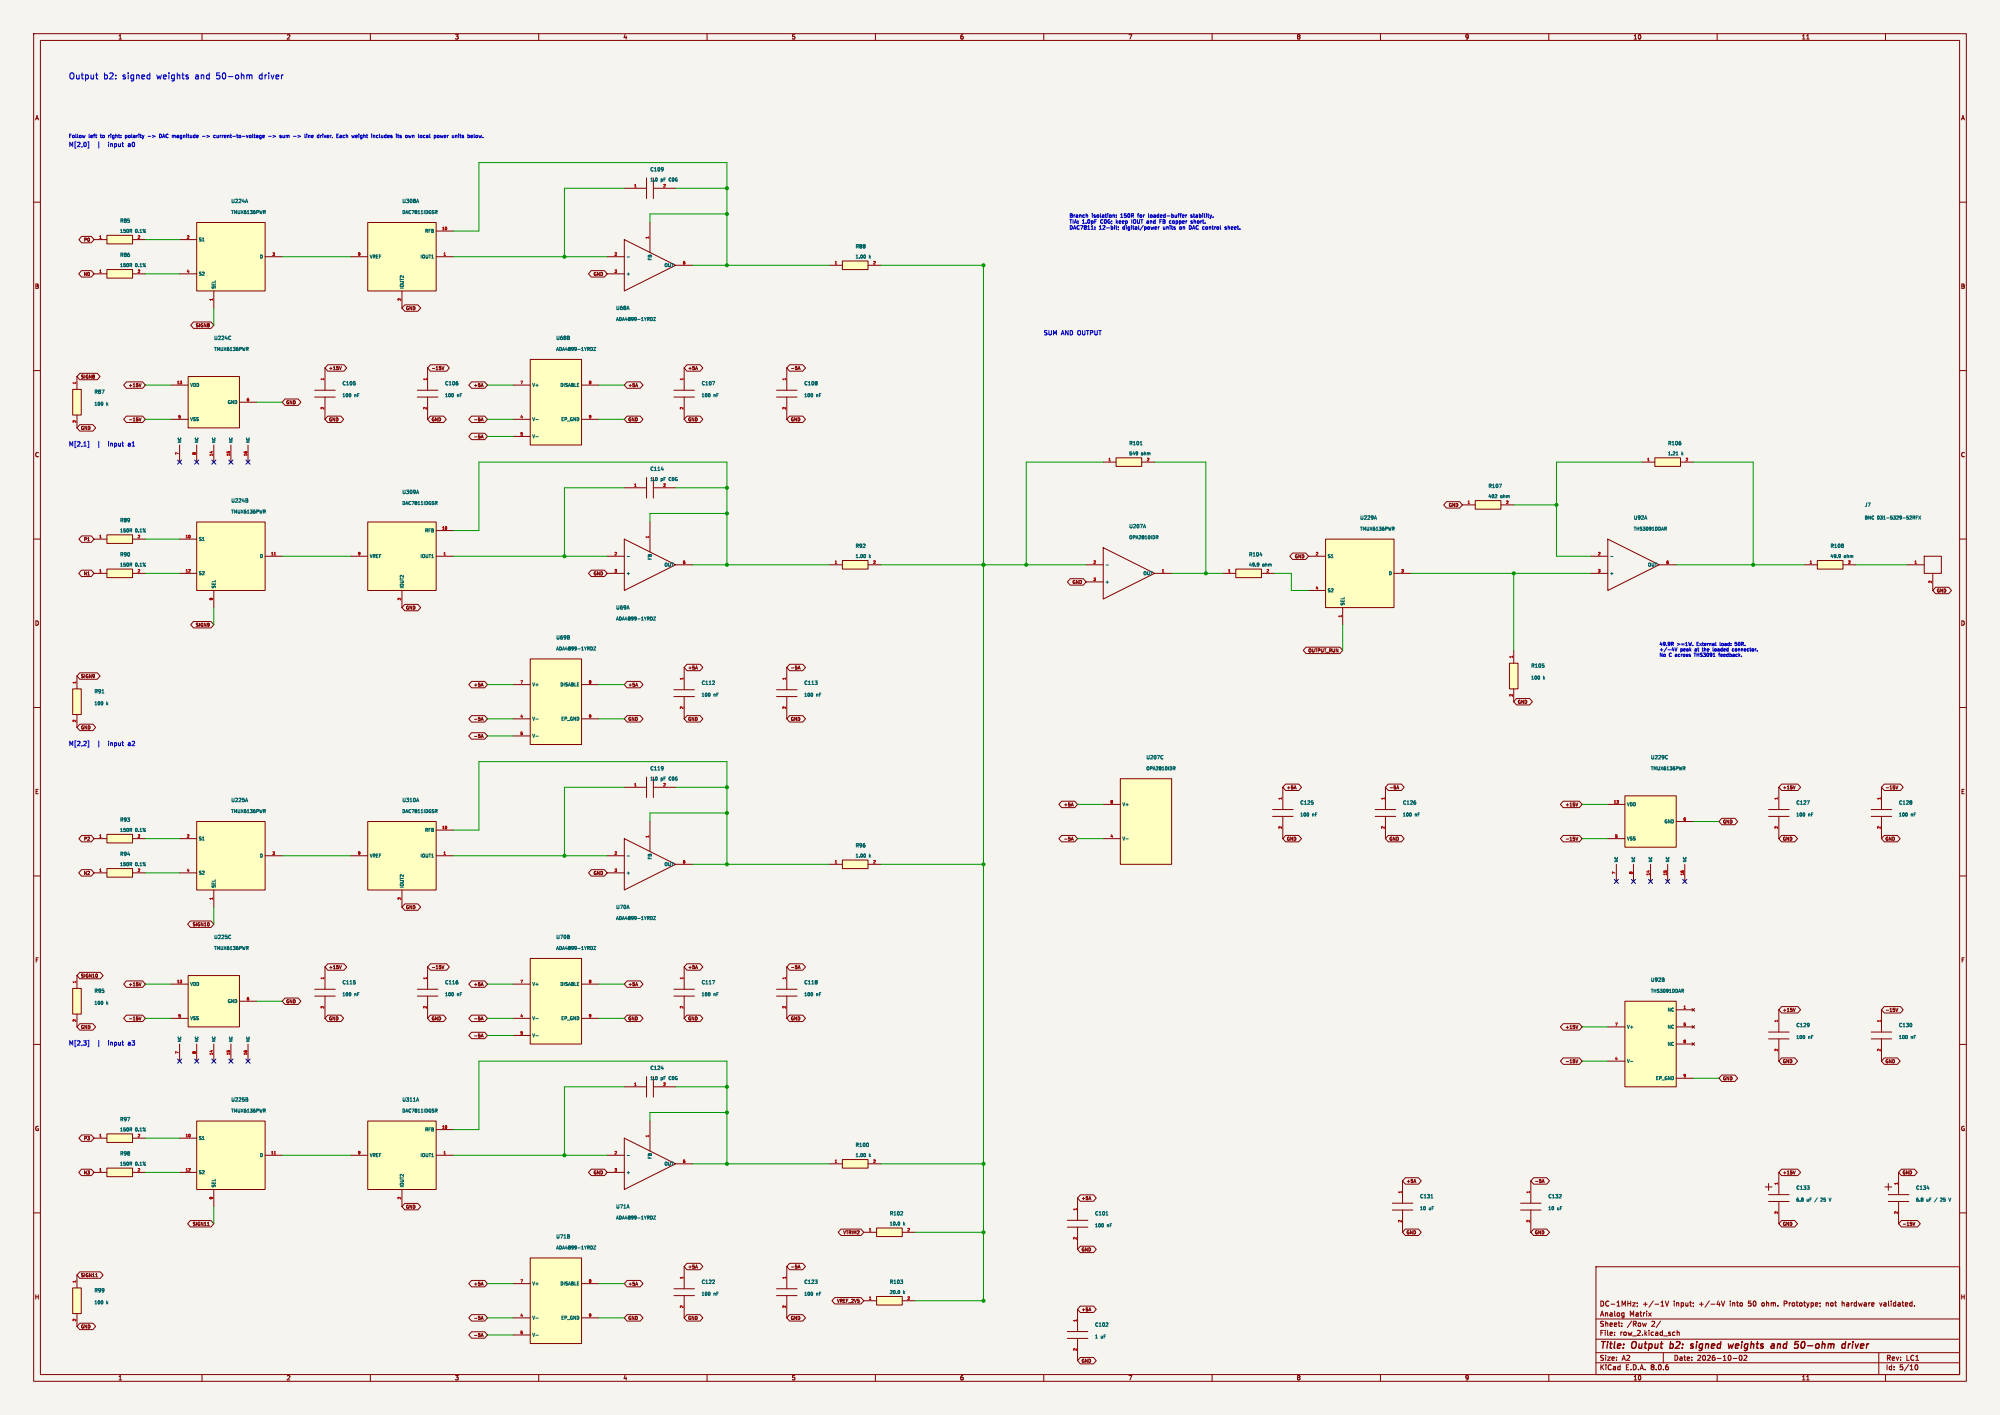
[picture p59: page 5]

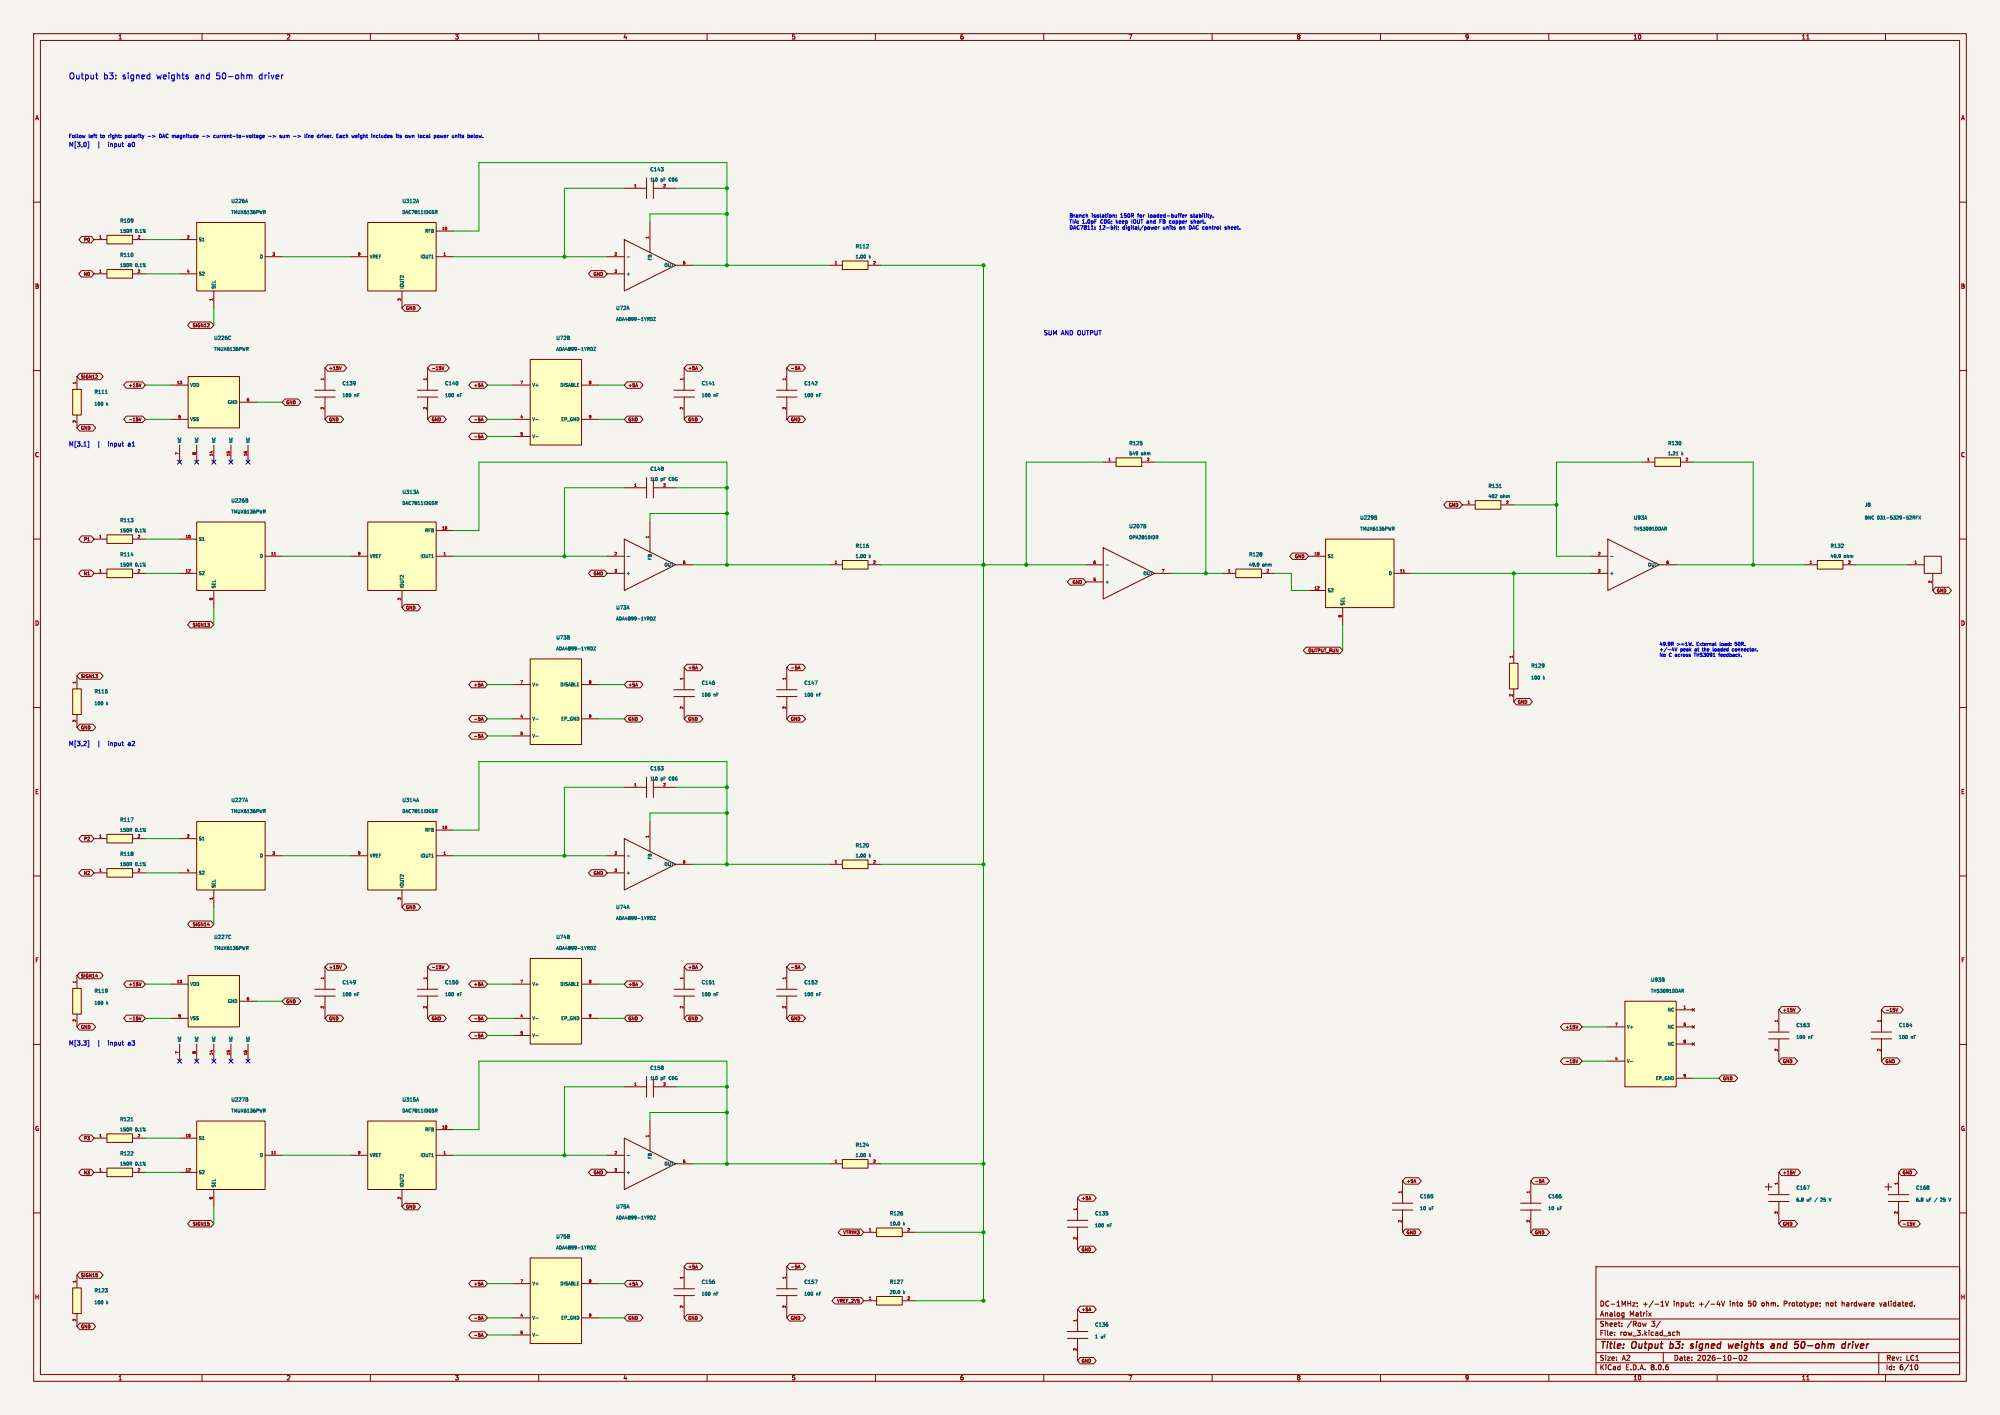
[picture p60: page 6]

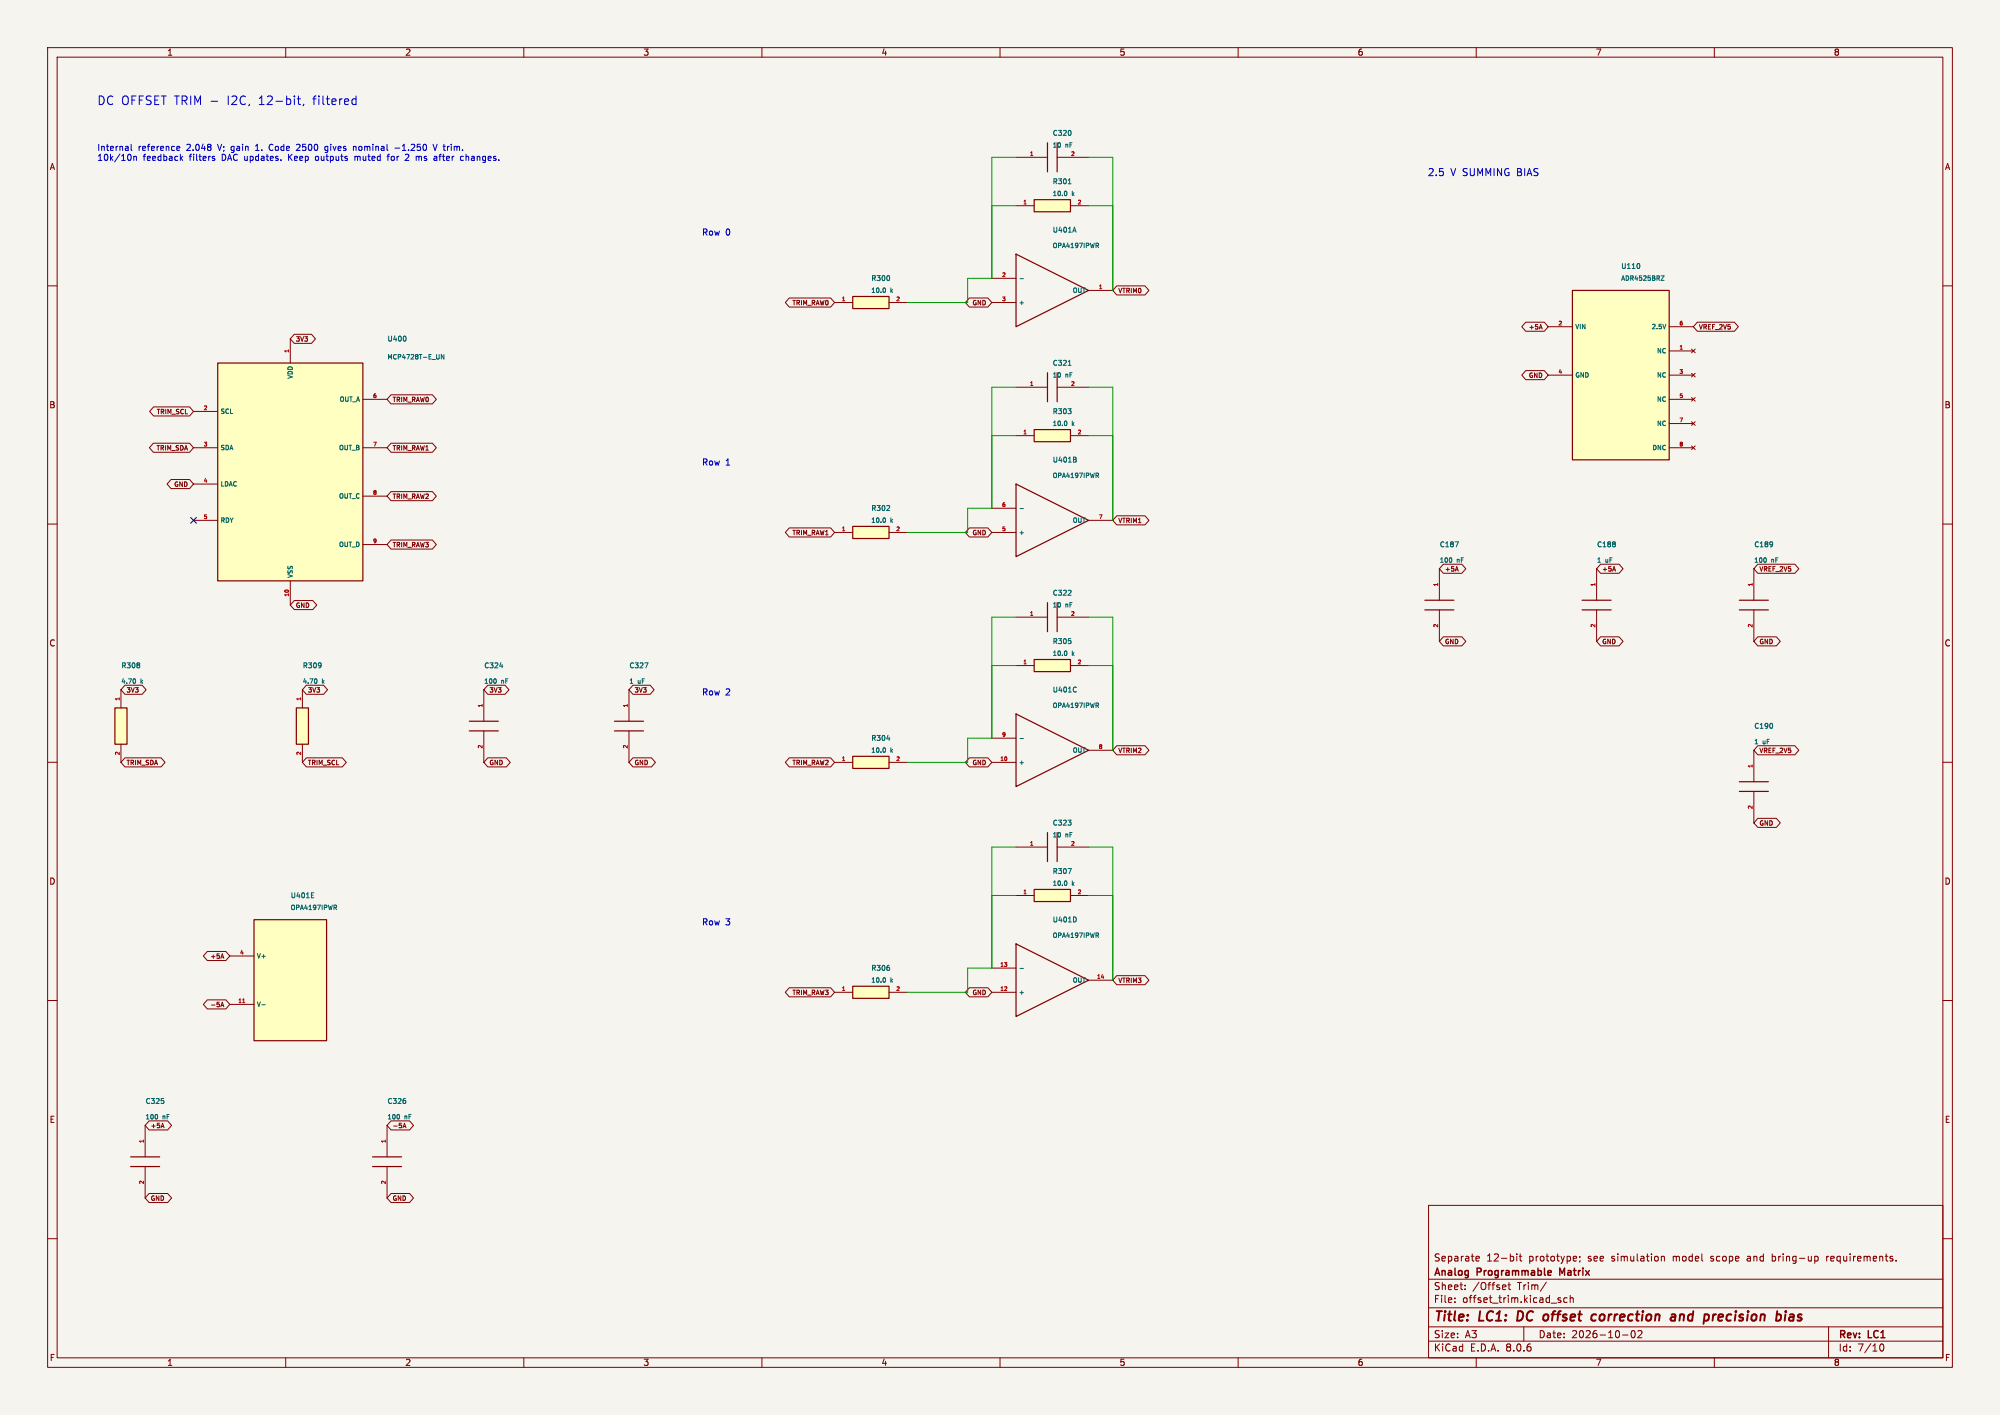
[picture p61: page 7]

1 VSS 10 SCL 2 SDA 3 LDAC 4 RDY

Id: 7/10 Title: LC1: DC offset correction and precision bias

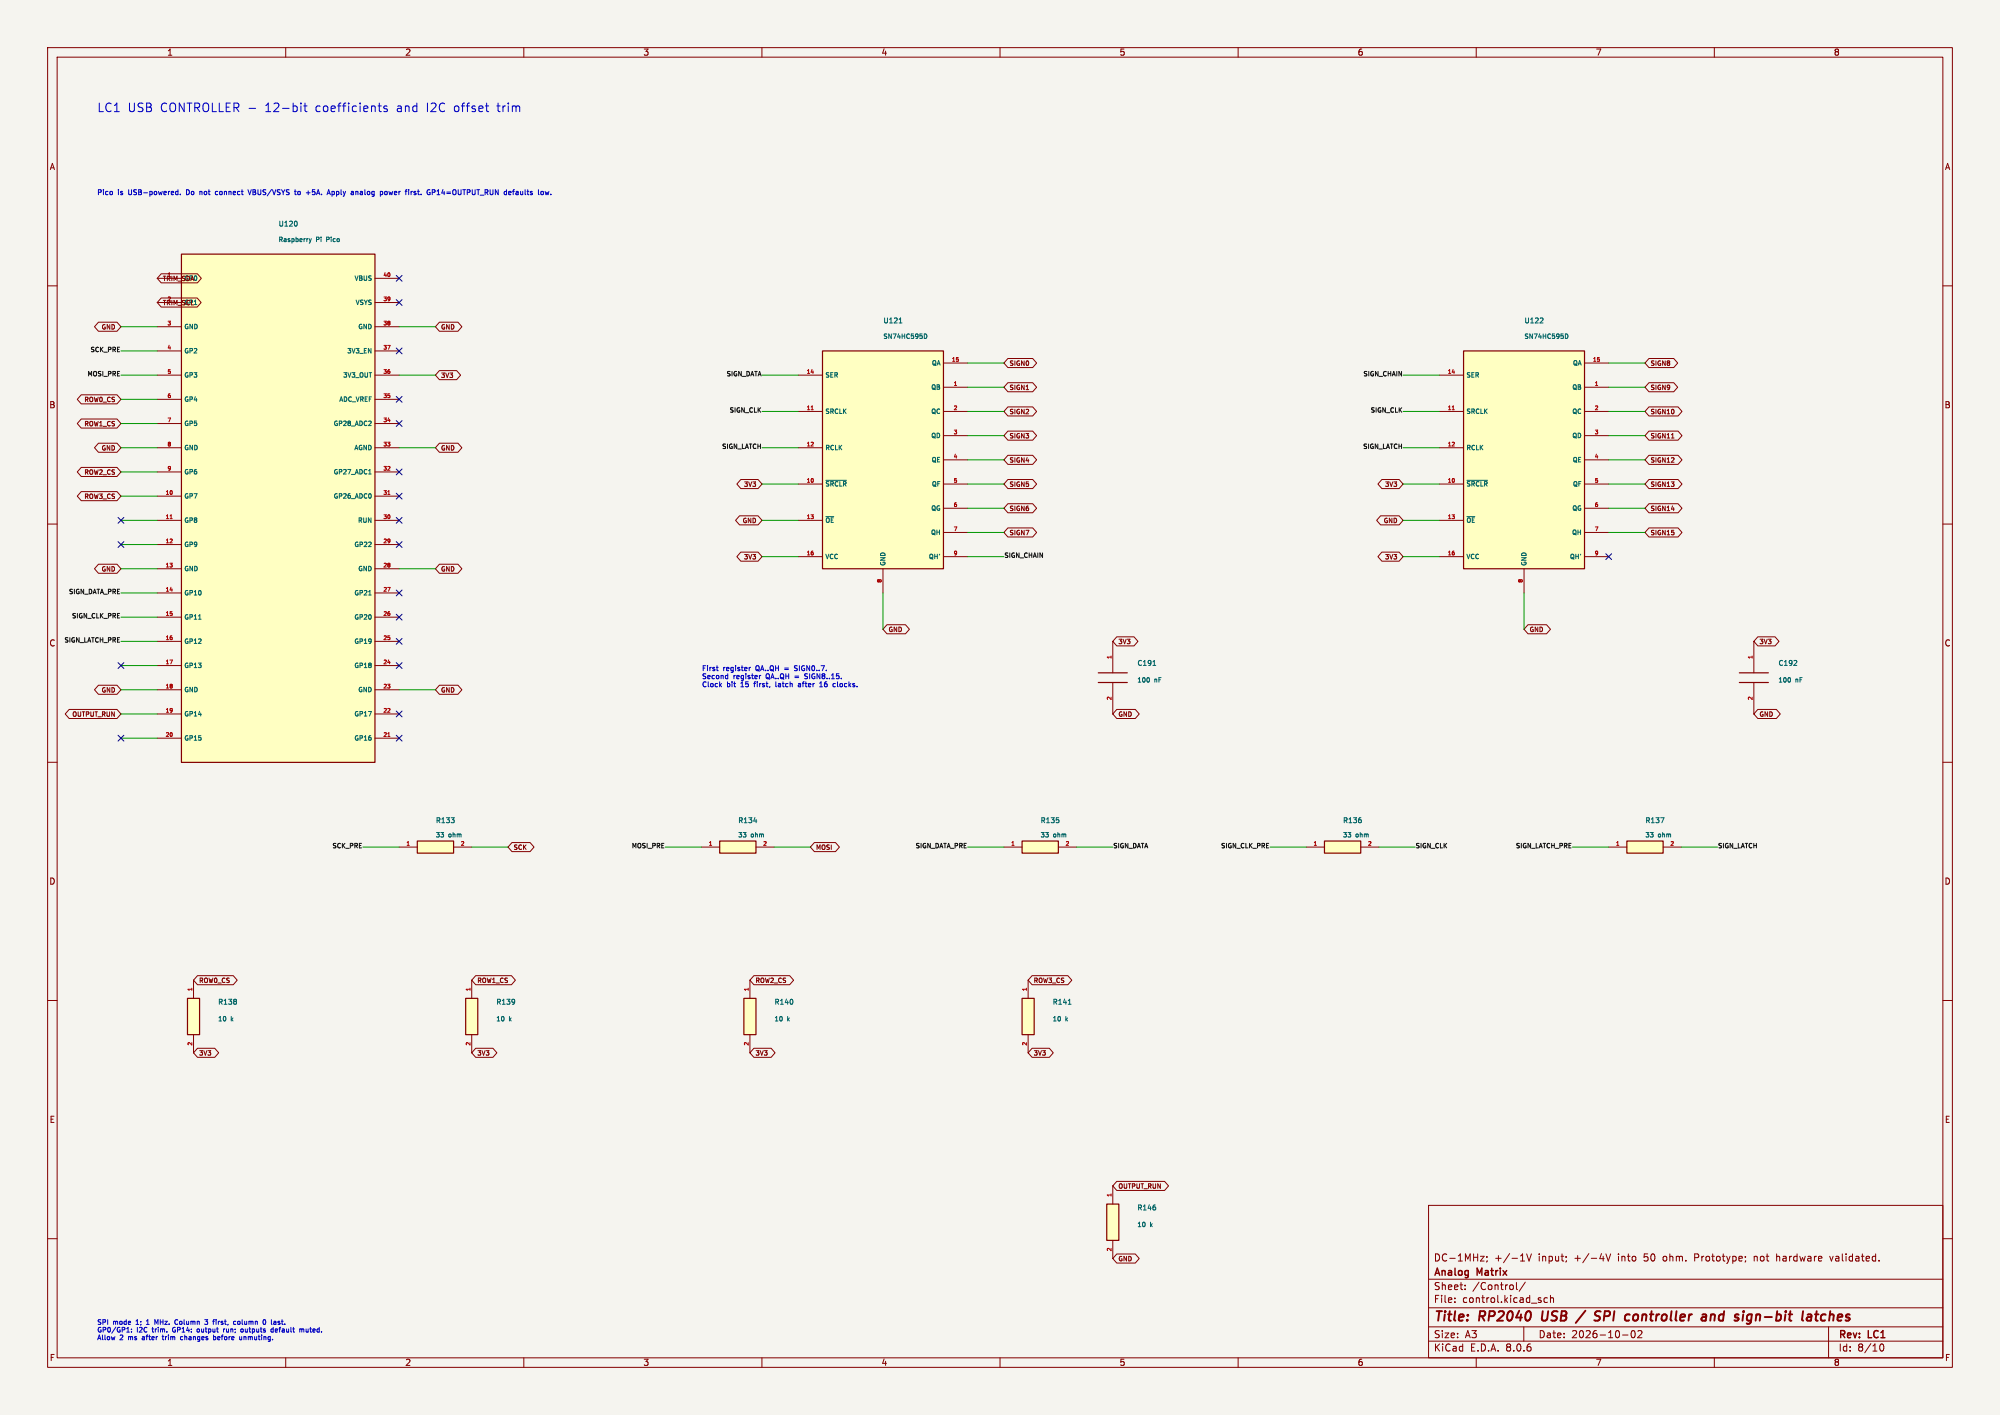
[picture p62: page 8]

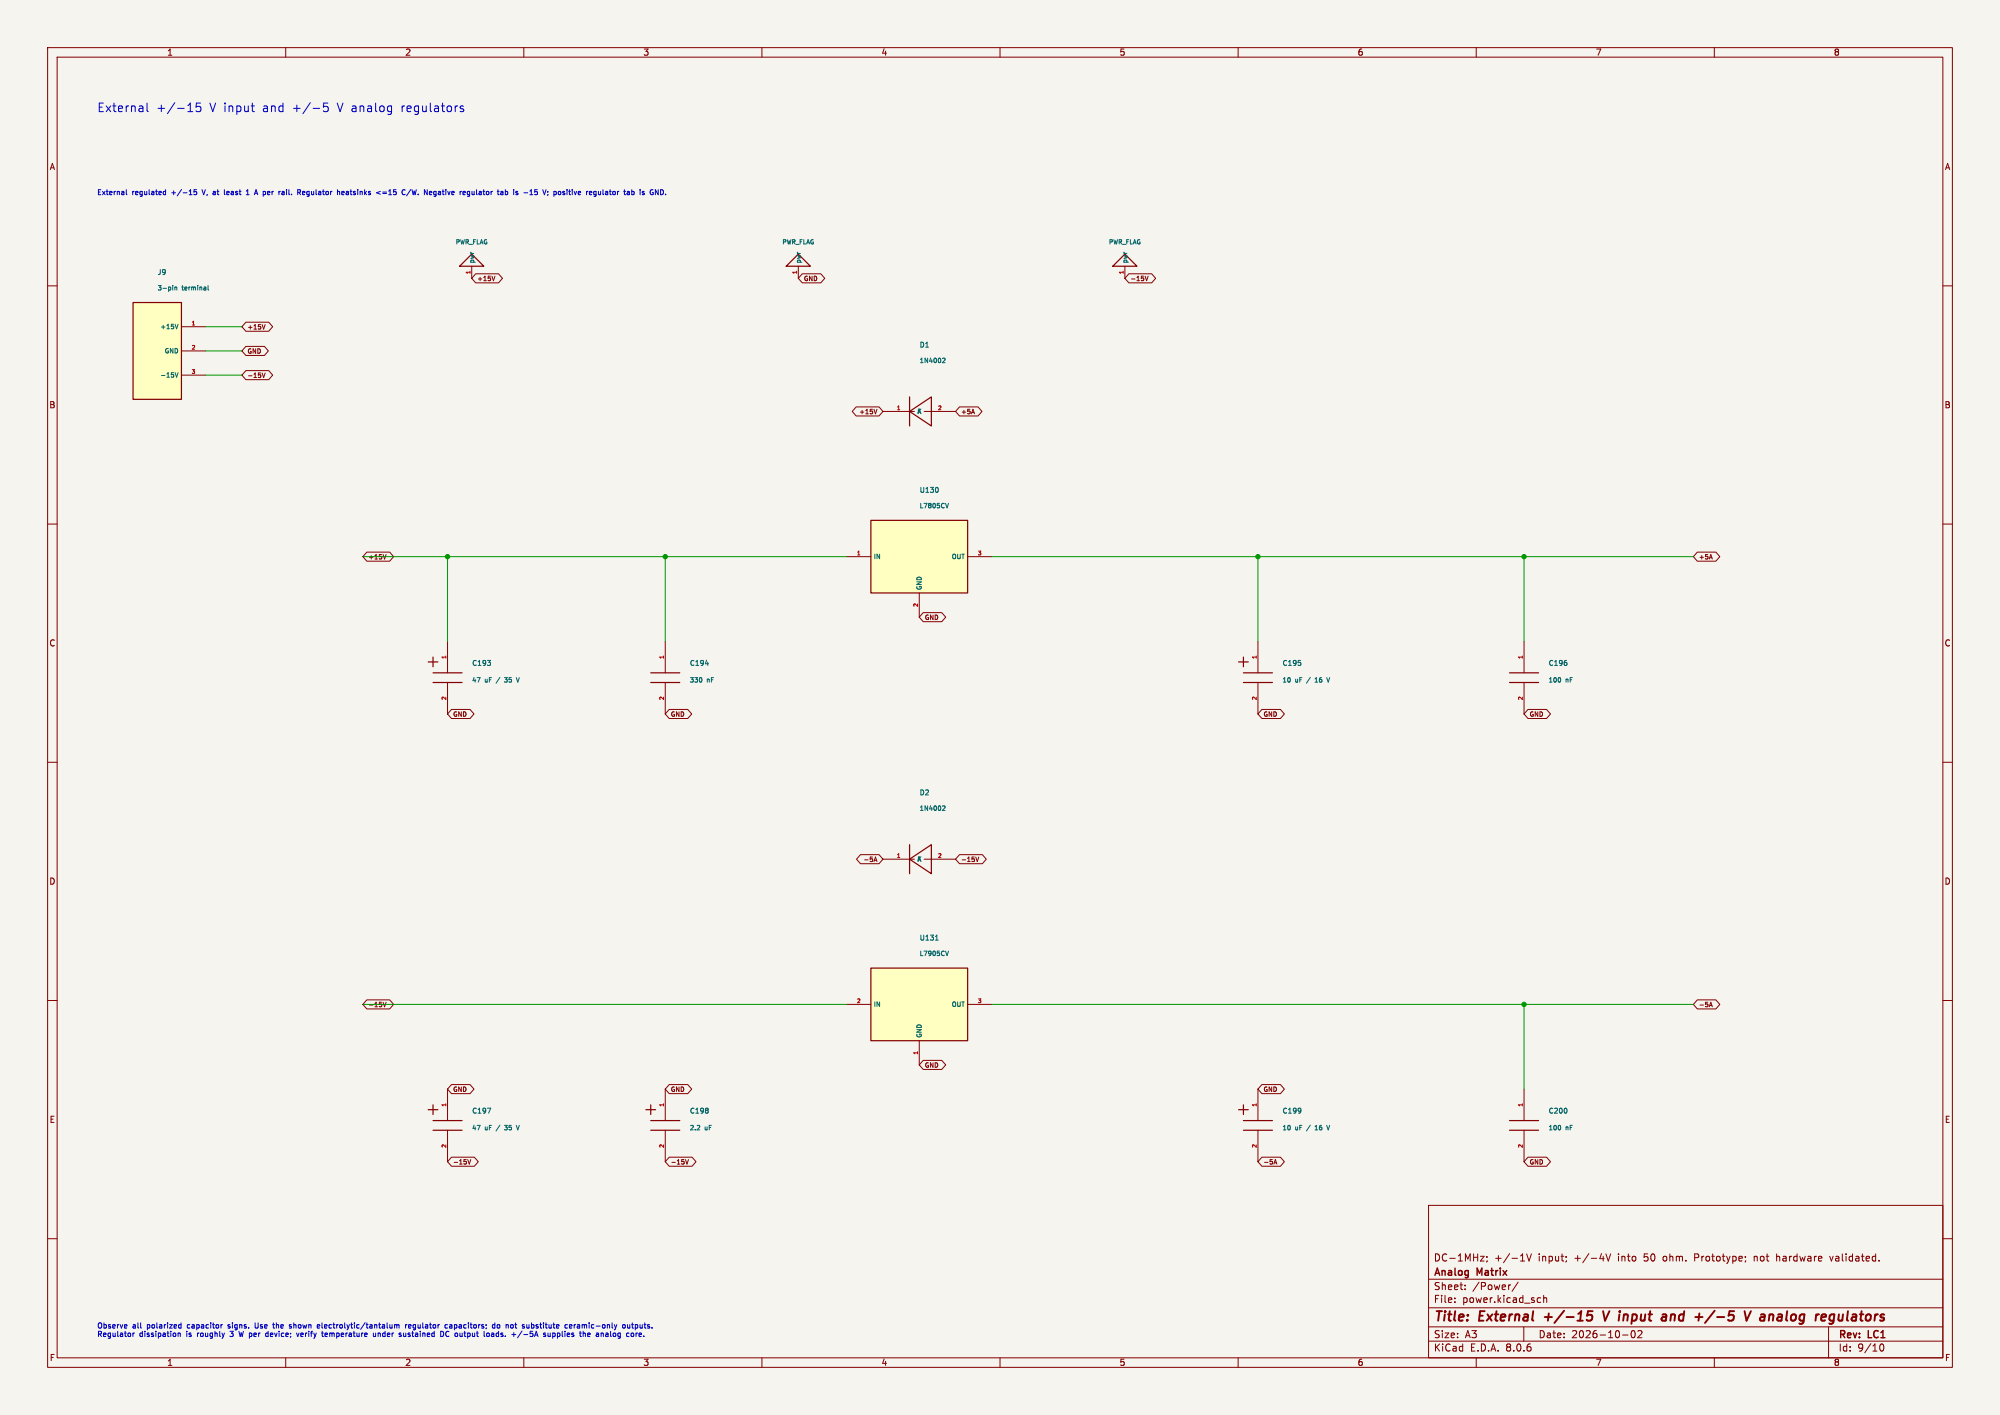
[picture p63: page 9]

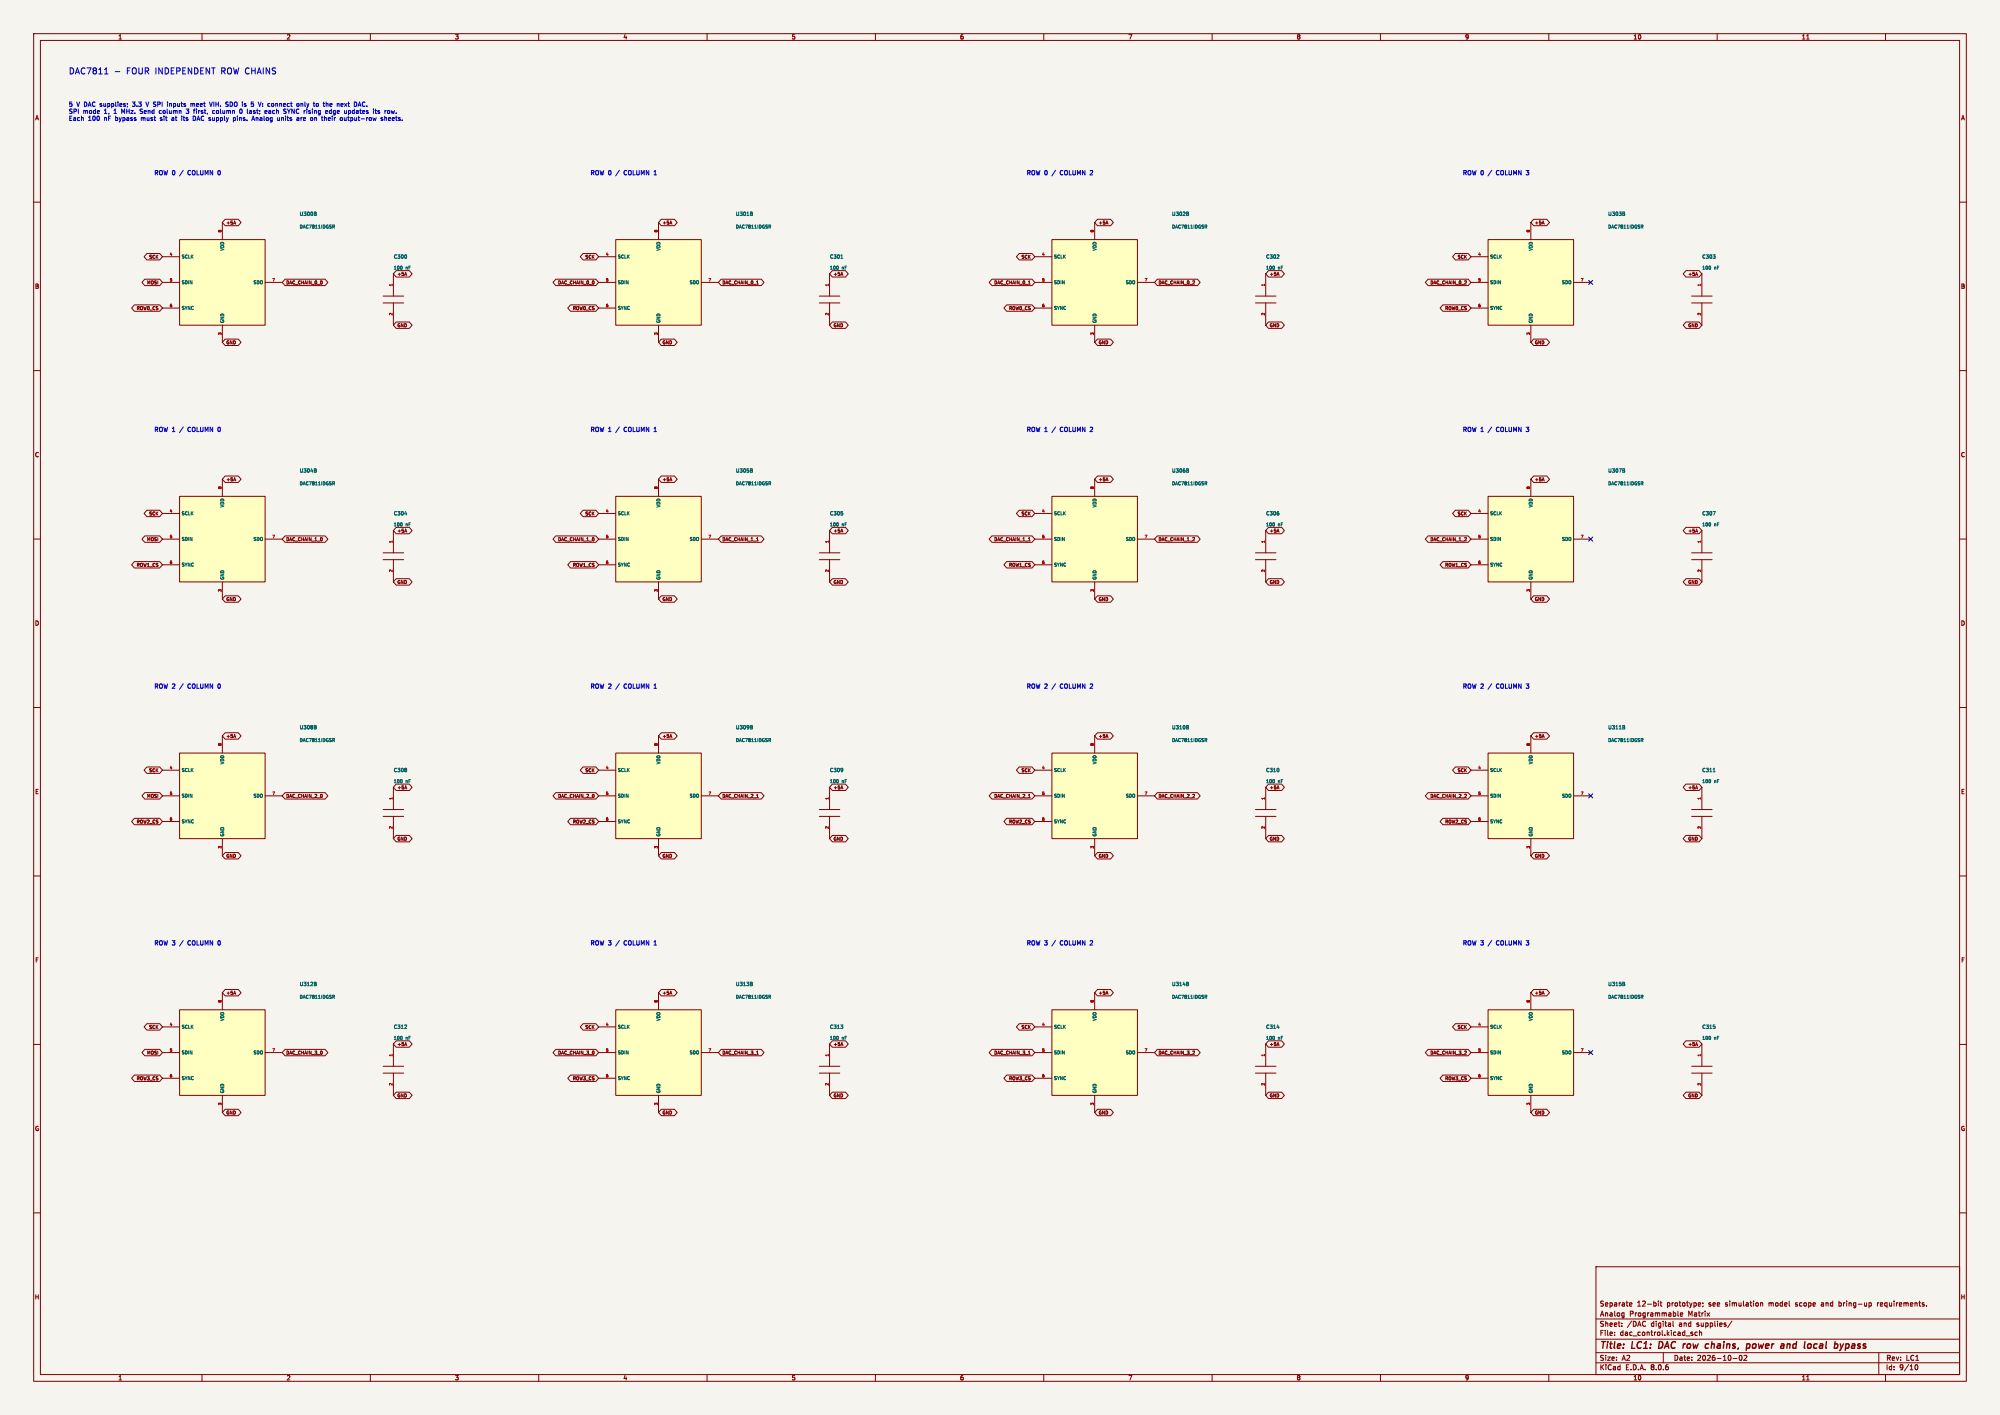
[picture p64: page 10]

3 SCLK 4 SDIN 5 SYNC 6 SDO 7 VDD

ROW 2 / COLUMN 0 ROW 1 / COLUMN 0

SCK MOSI ROW1_CS
