tim4431/analog_programmable_matrix/spice/benches/driver_loop.cir

Local loop return ratio and closed-loop transient checks
.include "../models/ADA4899.sub"
.include "../models/opa810/opa810_a.lib"
.include "../models/ths3091_tina/THS3091.lib"
.include "../models/opa197/OPAx197.LIB"
VP vp 0 5
VN vn 0 -5
VHP hp 0 15
VHN hn 0 -15
.options plotwinsize=0 numdgt=7 reltol=0.0001
.param rf=6k ro=6k co=40p cf=2.5p cl=20p
XAMP 0 inn raw hp hn THS3091
RF out inn 1210
RG inn 0 402
RS out load 49.9
RL load 0 50
CL load 0 {cl}
VTEST out raw DC 0 AC 1
.ac dec 150 10 3G
.save V(out) V(raw)
.step param cl list 0 20p 100p 1n
.end
