tim4431/analog_programmable_matrix/(list of files, drawings)

Other design files:
mechanical/analog_matrix_package_m3/pcb_geometry.json
pcb/analog_matrix_4x4_rev_d/pcb_audit.json
variants/lc1/mechanical/pcb_geometry.json
