tim4431/analog_programmable_matrix/variants/lc1/hardware/analog_matrix_lc1.kicad_pcb

## KiCad design variants/lc1/hardware/analog_matrix_lc1.kicad_pcb (2026-10-03)

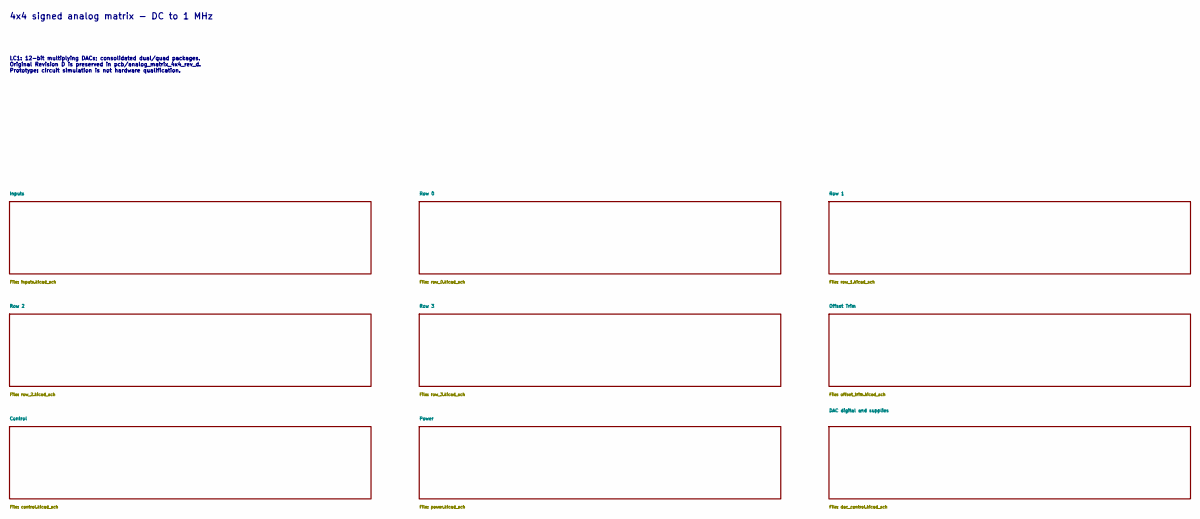
[picture p65: schematic analog_matrix_lc1.kicad_sch, Analog Programmable Matrix - LC1 lower-cost alternative]

Notes on the sheet:
4x4 signed analog matrix - DC to 1 MHz
LC1: 12-bit multiplying DACs; consolidated dual/quad packages. Original Revision D is preserved in pcb/analog_matrix_4x4_rev_d. Prototype: circuit simulation is not hardware qualification.

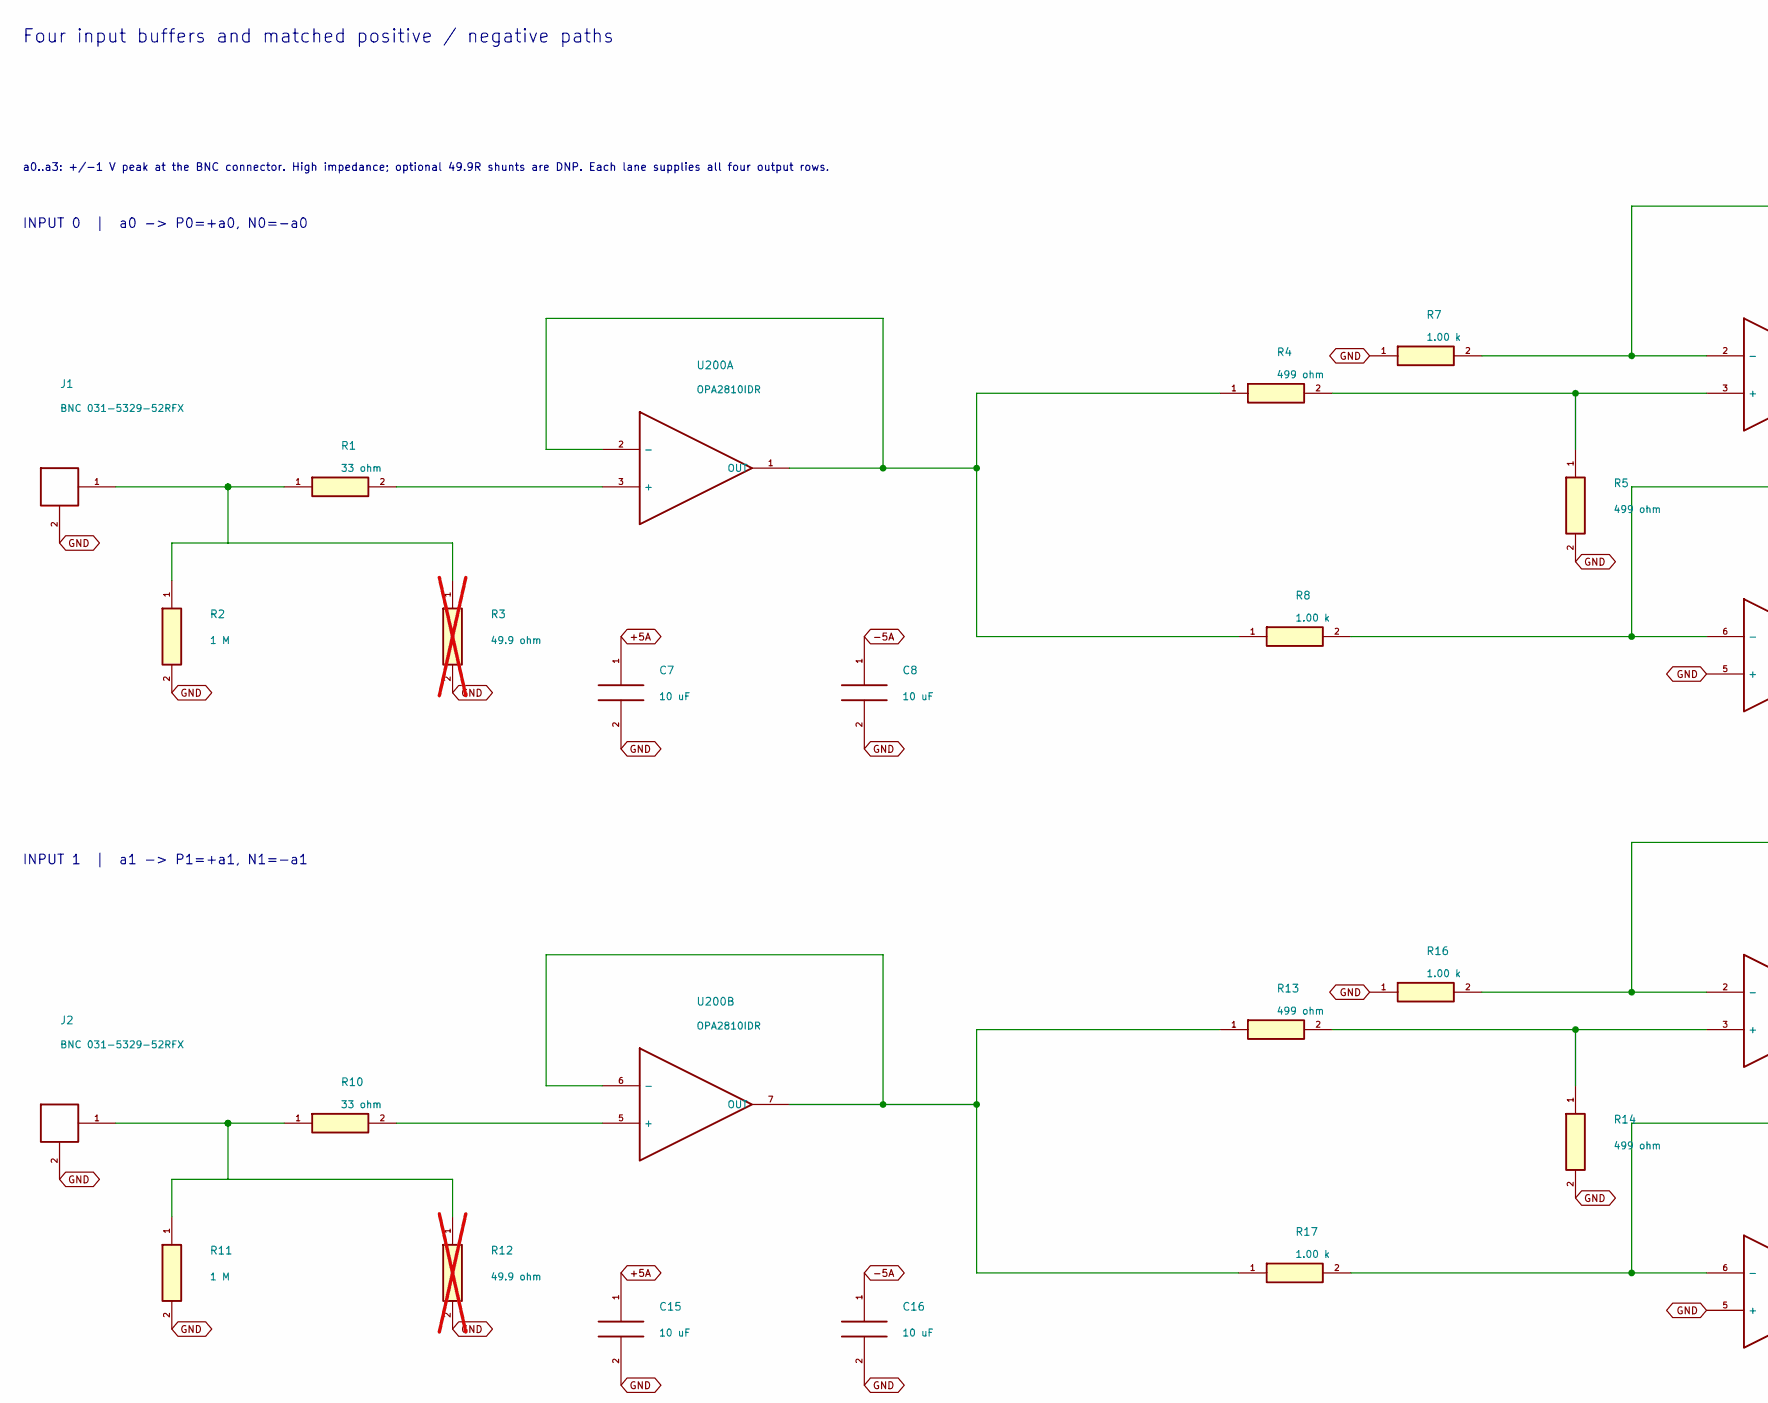
[picture p66: schematic inputs.kicad_sch, Four input buffers and matched positive / negative paths, part in row 1, column 1]

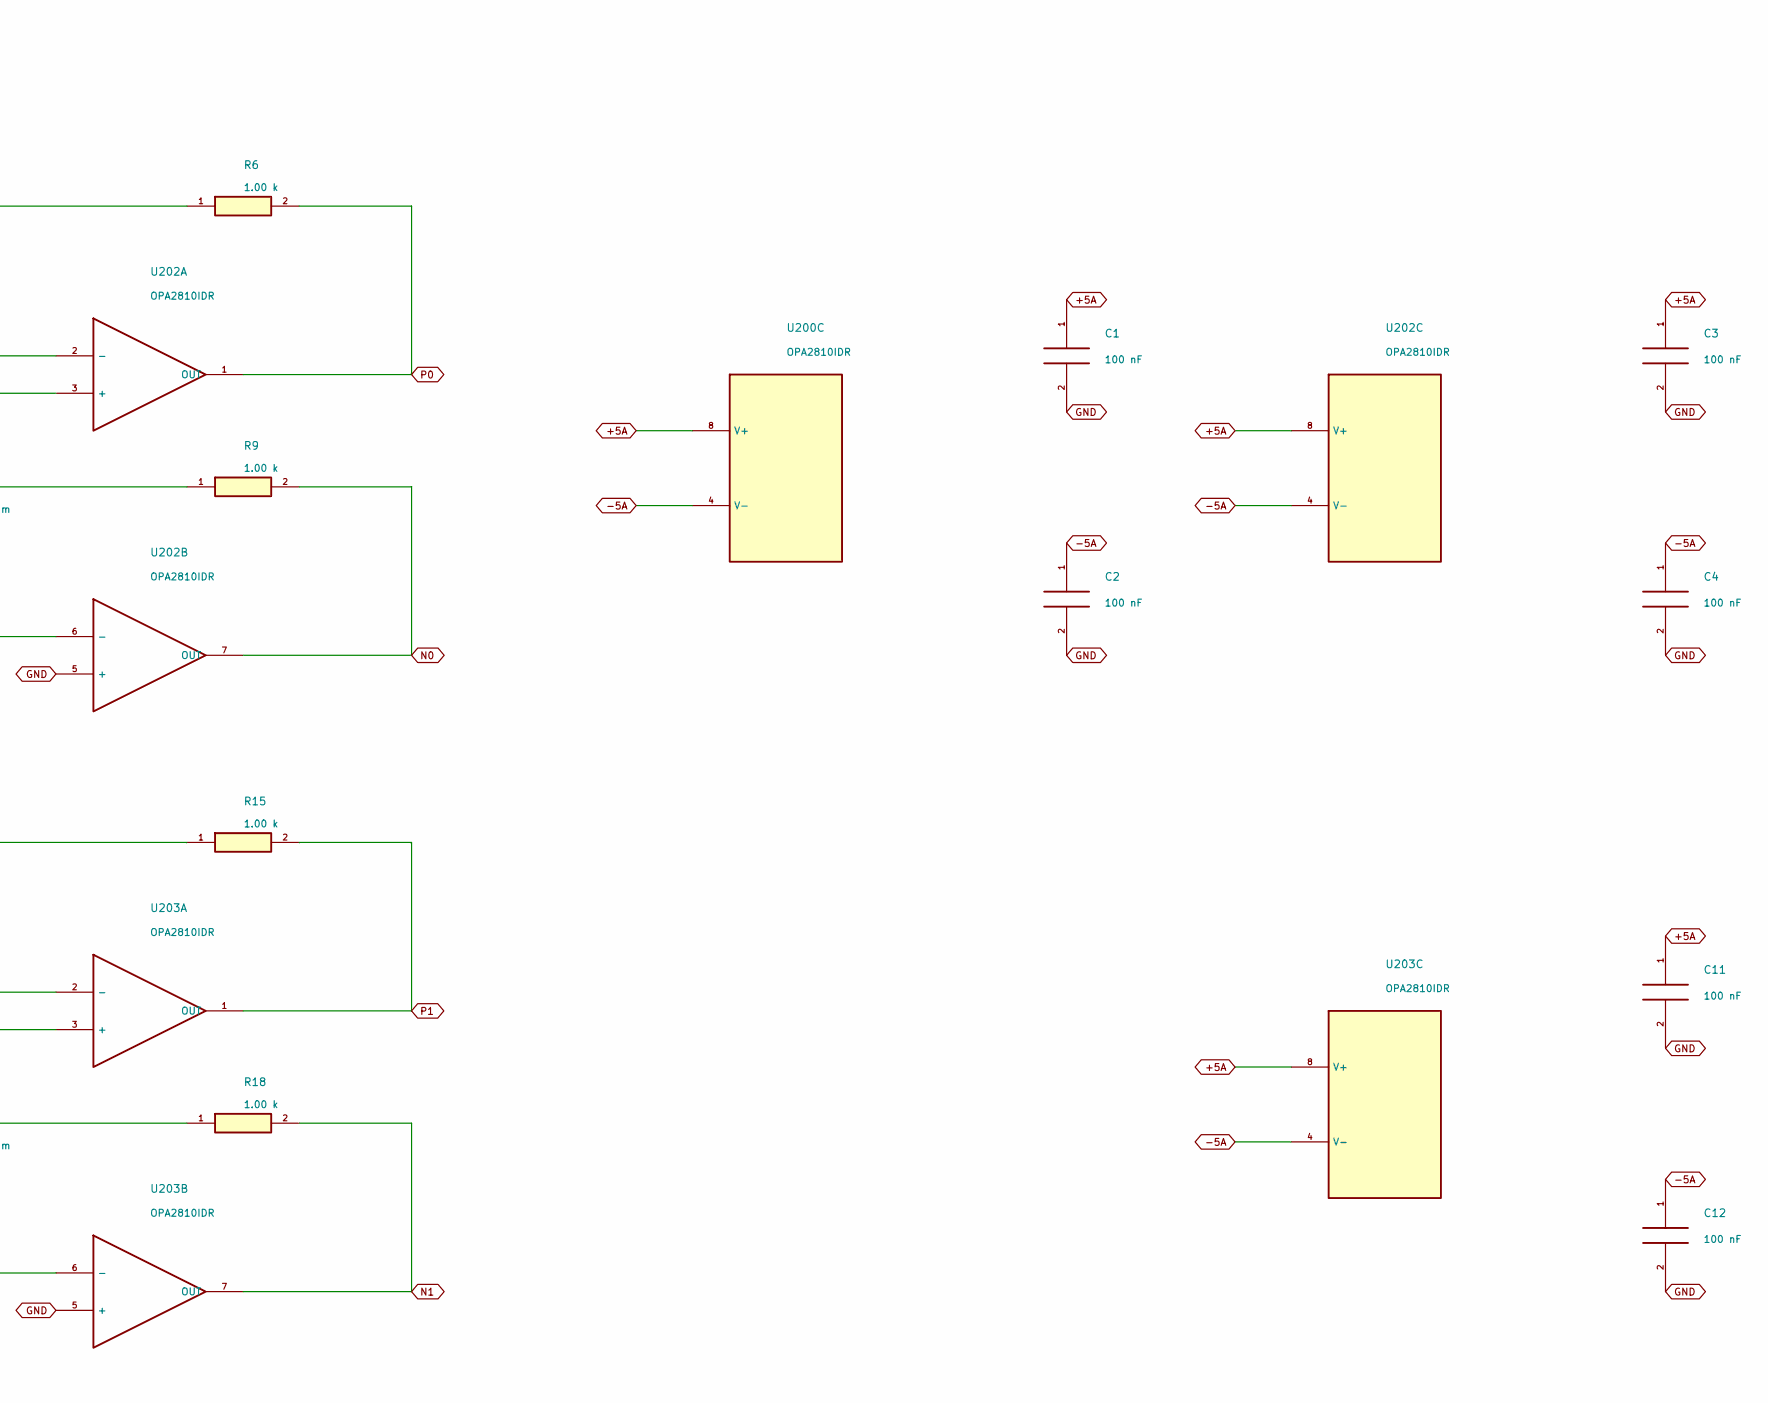
[picture p67: schematic inputs.kicad_sch, Four input buffers and matched positive / negative paths, part in row 1, column 2]

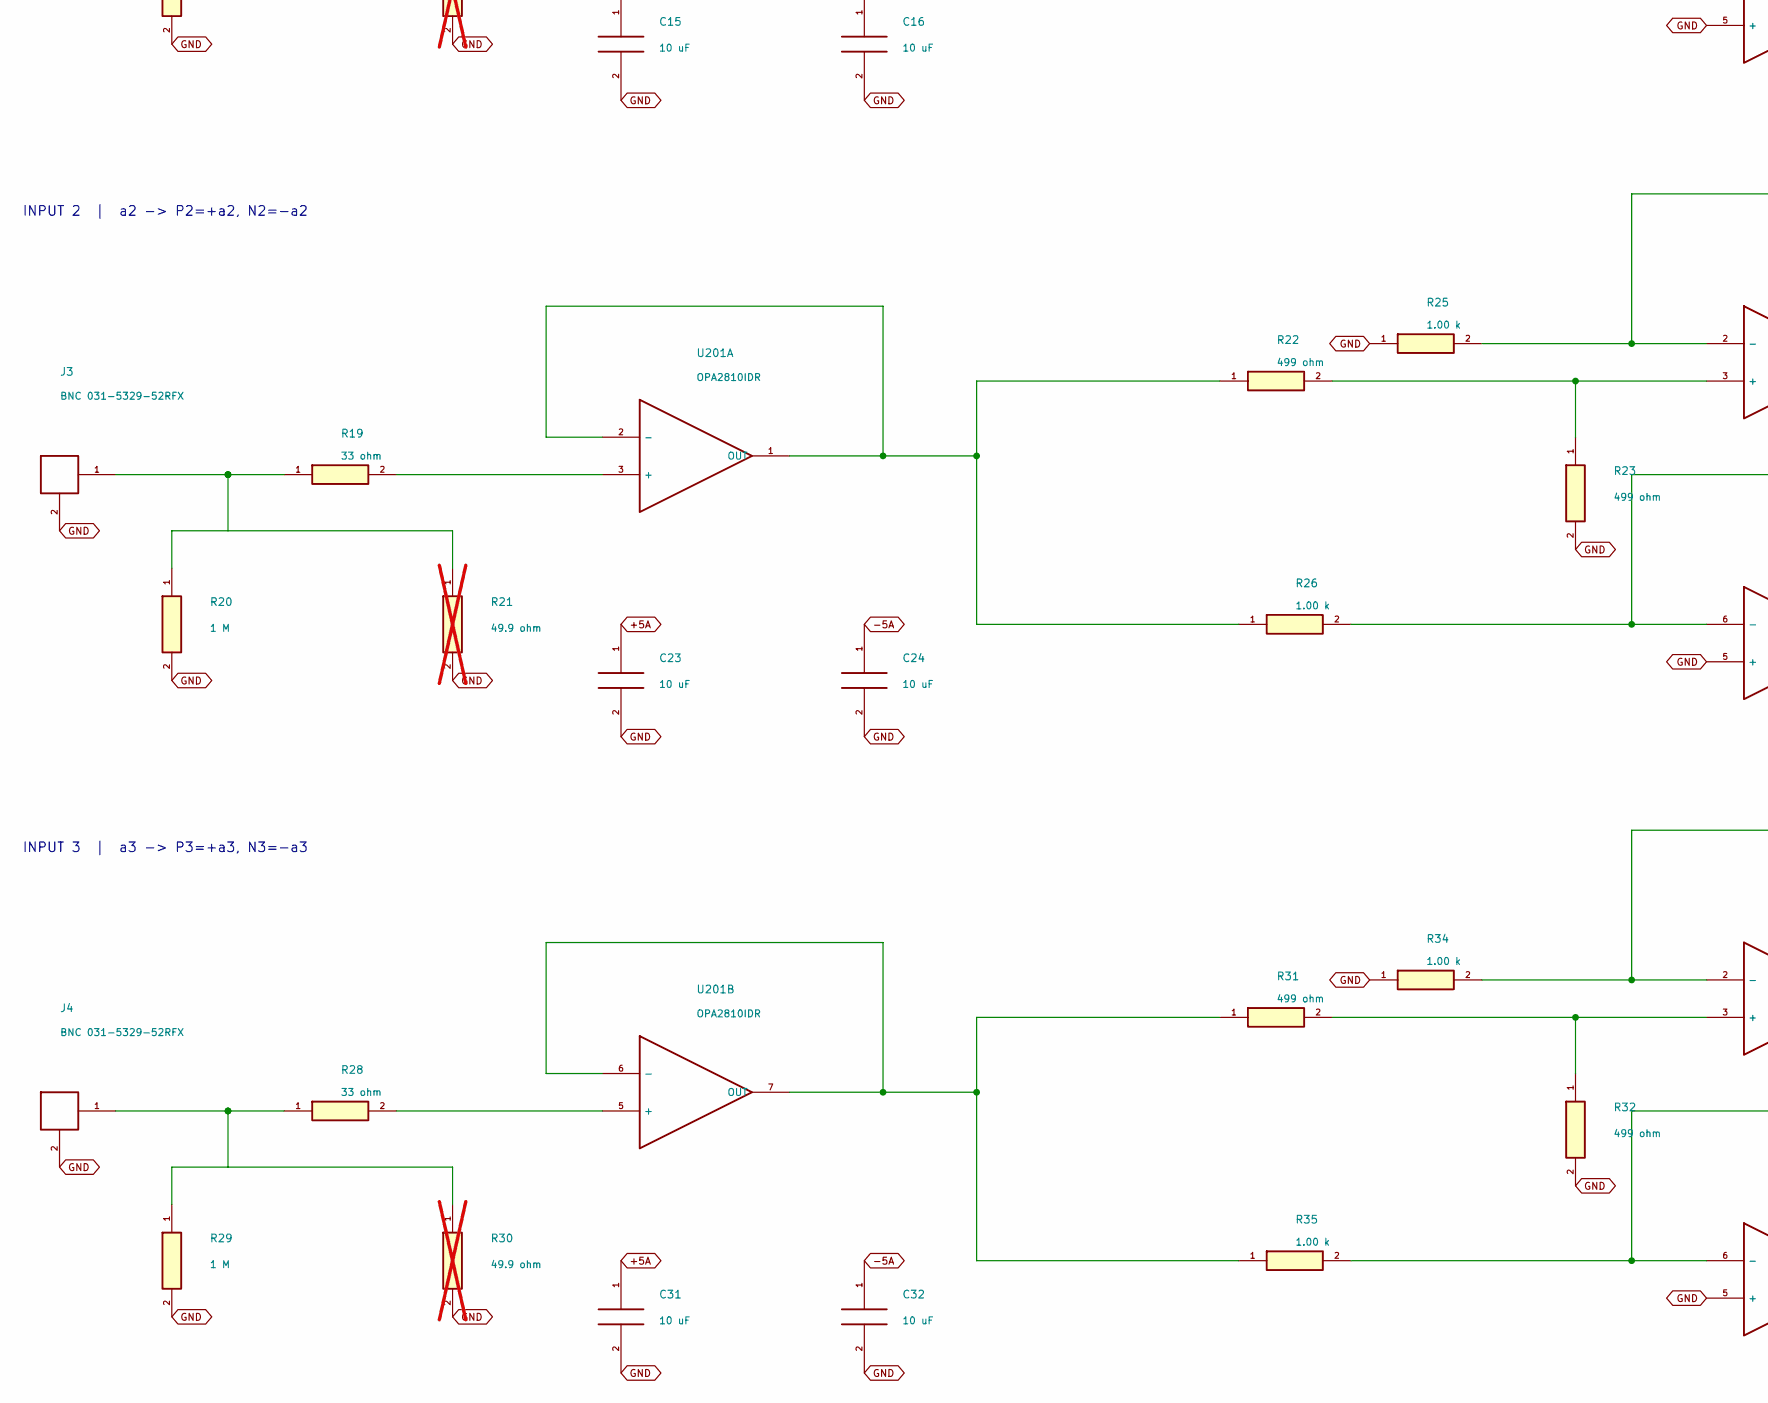
[picture p68: schematic inputs.kicad_sch, Four input buffers and matched positive / negative paths, part in row 2, column 1]

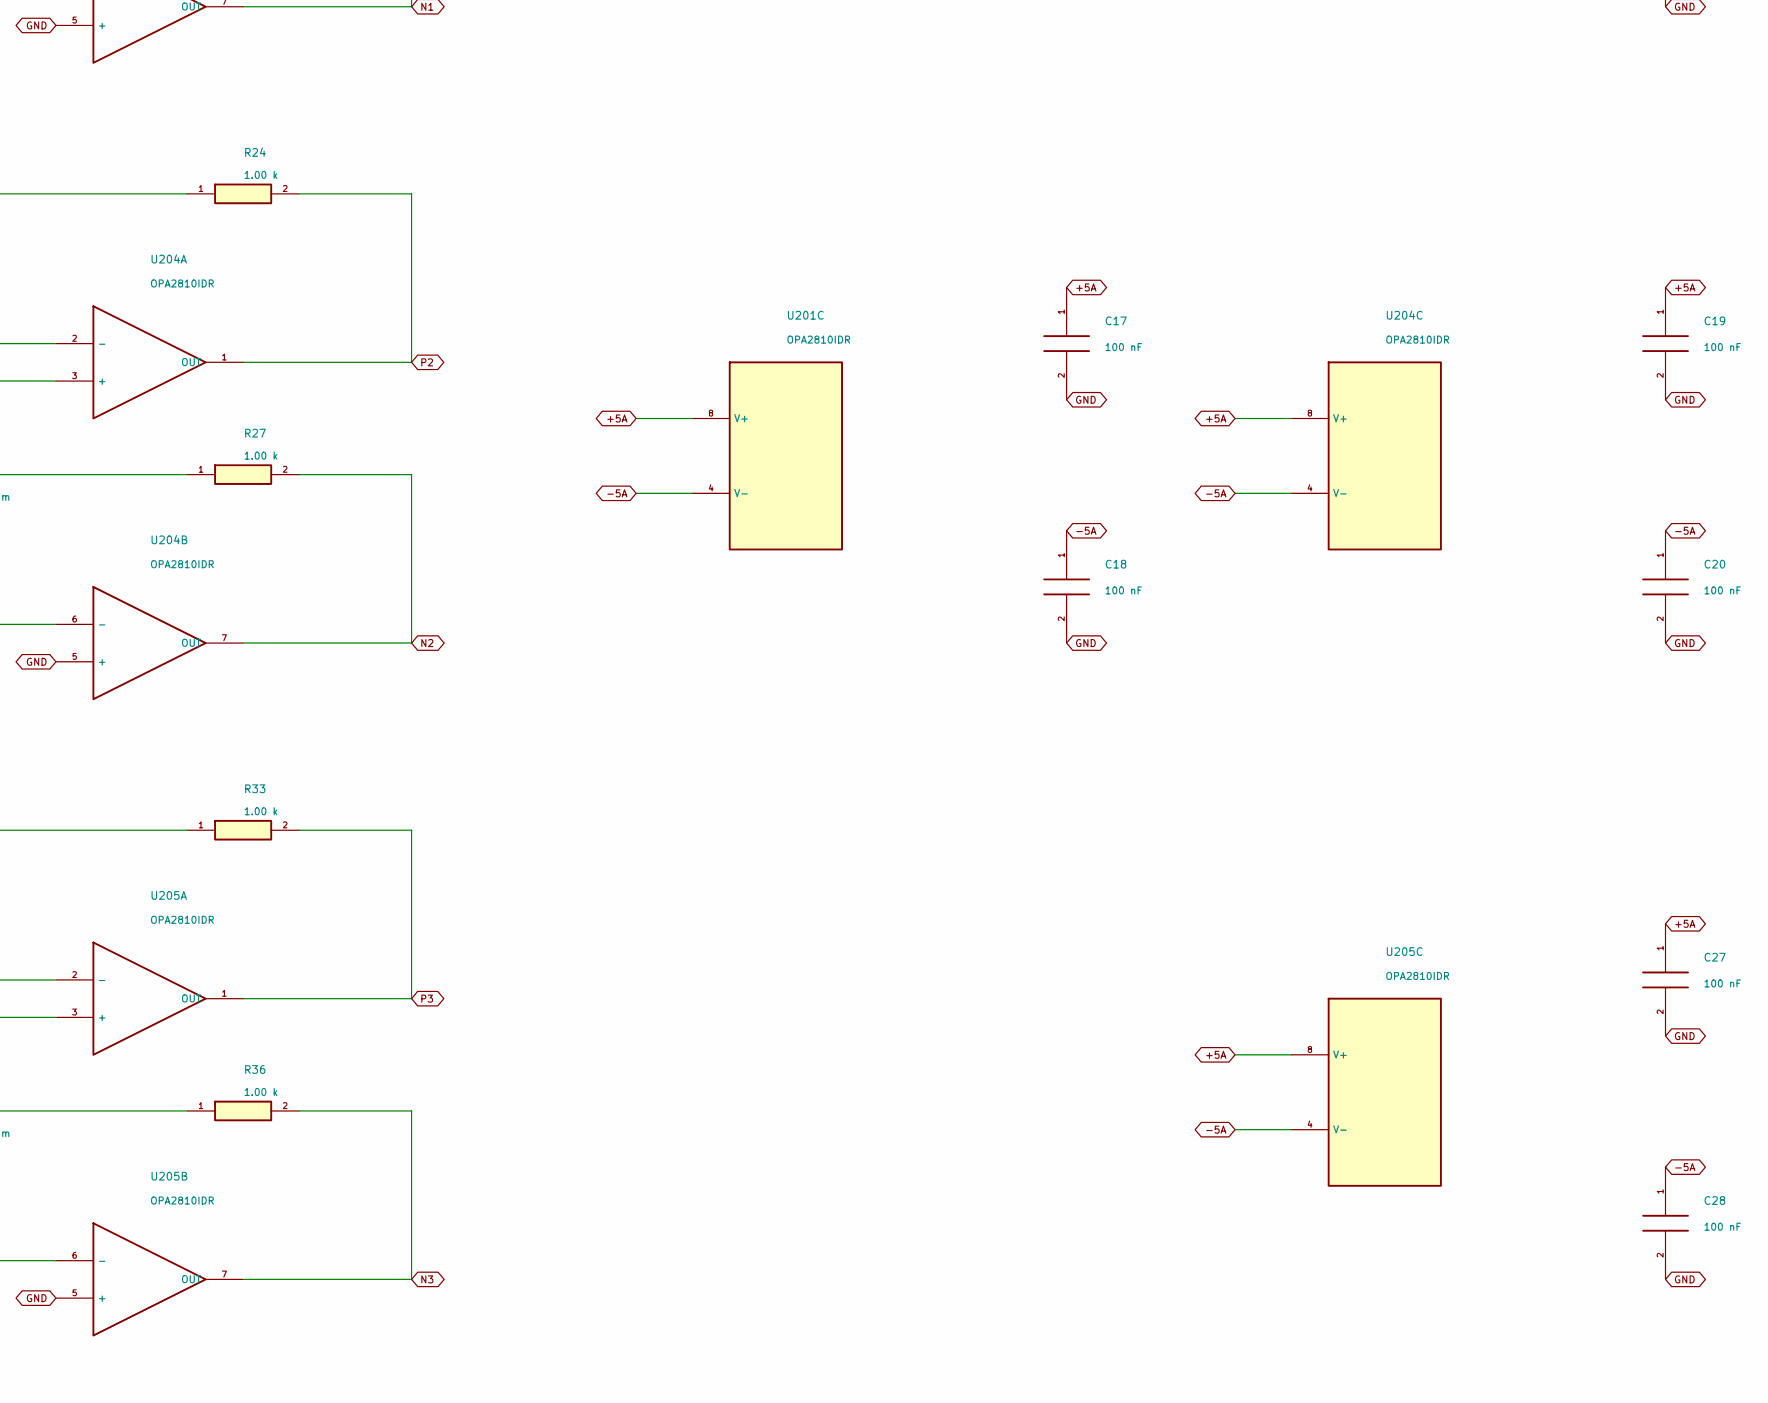
[picture p69: schematic inputs.kicad_sch, Four input buffers and matched positive / negative paths, part in row 2, column 2]

Parts:
C1, C2, C3, C4, C11, C12, C17, C18, C19, C20, C27, C28: 100 nF; C_0603_1608Metric; Rating 25V X7R minimum; effective C after bias
C7, C8, C15, C16, C23, C24, C31, C32: 10 uF; C_0805_2012Metric; Rating 25V X7R minimum; effective C after bias
J1, J2, J3, J4: BNC 031-5329-52RFX; BNC_Amphenol_031-5329-52RFX_Vertical
R1, R10, R19, R28: 33 ohm; R_0603_1608Metric; Rating 0.1%, <=25ppm/C; 0.1W minimum
R2, R11, R20, R29: 1 M; R_0603_1608Metric; Rating 0.1%, <=25ppm/C; 0.1W minimum
R3, R12, R21, R30: 49.9 ohm; R_0603_1608Metric; Rating 0.1%, <=25ppm/C; 0.1W minimum; not fitted
R4, R5, R13, R14, R22, R23, R31, R32: 499 ohm; R_0603_1608Metric; Rating 0.1%, <=25ppm/C; 0.1W minimum
R6, R7, R8, R9, R15, R16, R17, R18, R24, R25, R26, R27, R33, R34, R35, R36: 1.00 k; R_0603_1608Metric; Rating 0.1%, <=25ppm/C; 0.1W minimum
U200, U201, U202, U203, U204, U205: OPA2810IDR; SOIC-8_3.9x4.9mm_P1.27mm

Connections:
+5A: C1.1, C3.1, C7.1, C11.1, C15.1, C17.1, C19.1, C23.1, C27.1, C31.1, U200.8 (V+), U201.8 (V+), U202.8 (V+), U203.8 (V+), U204.8 (V+), U205.8 (V+); also elsewhere on the board
-5A: C2.1, C4.1, C8.1, C12.1, C16.1, C18.1, C20.1, C24.1, C28.1, C32.1, U200.4 (V-), U201.4 (V-), U202.4 (V-), U203.4 (V-), U204.4 (V-), U205.4 (V-); also elsewhere on the board
GND: C1.2, C2.2, C3.2, C4.2, C7.2, C8.2, C11.2, C12.2, C15.2, C16.2, C17.2, C18.2, C19.2, C20.2, C23.2, C24.2, C27.2, C28.2, C31.2, C32.2, J1.2, J2.2, J3.2, J4.2, R2.2, R3.2, R5.2, R7.1, R11.2, R12.2, R14.2, R16.1, R20.2, R21.2, R23.2, R25.1, R29.2, R30.2, R32.2, R34.1, U202.5 (+), U203.5 (+), U204.5 (+), U205.5 (+); also elsewhere on the board
N0: R9.2, U202.7 (OUT); also elsewhere on the board
N1: R18.2, U203.7 (OUT); also elsewhere on the board
N2: R27.2, U204.7 (OUT); also elsewhere on the board
N3: R36.2, U205.7 (OUT); also elsewhere on the board
unnamed: J1.1, R1.1, R2.1, R3.1
unnamed: J2.1, R10.1, R11.1, R12.1
unnamed: J3.1, R19.1, R20.1, R21.1
unnamed: J4.1, R28.1, R29.1, R30.1
unnamed: R1.2, U200.3 (+)
unnamed: R4.1, R8.1, U200.1 (OUT), U200.2 (-)
unnamed: R10.2, U200.5 (+)
unnamed: R13.1, R17.1, U200.6 (-), U200.7 (OUT)
unnamed: R19.2, U201.3 (+)
unnamed: R22.1, R26.1, U201.1 (OUT), U201.2 (-)
unnamed: R28.2, U201.5 (+)
unnamed: R31.1, R35.1, U201.6 (-), U201.7 (OUT)
unnamed: R4.2, R5.1, U202.3 (+)
unnamed: R6.1, R7.2, U202.2 (-)
unnamed: R8.2, R9.1, U202.6 (-)
unnamed: R13.2, R14.1, U203.3 (+)
unnamed: R15.1, R16.2, U203.2 (-)
unnamed: R17.2, R18.1, U203.6 (-)
unnamed: R22.2, R23.1, U204.3 (+)
unnamed: R24.1, R25.2, U204.2 (-)
unnamed: R26.2, R27.1, U204.6 (-)
unnamed: R31.2, R32.1, U205.3 (+)
unnamed: R33.1, R34.2, U205.2 (-)
unnamed: R35.2, R36.1, U205.6 (-)
P0: R6.2, U202.1 (OUT); also elsewhere on the board
P1: R15.2, U203.1 (OUT); also elsewhere on the board
P2: R24.2, U204.1 (OUT); also elsewhere on the board
P3: R33.2, U205.1 (OUT); also elsewhere on the board

Notes on the sheet:
Four input buffers and matched positive / negative paths
a0..a3: +/-1 V peak at the BNC connector. High impedance; optional 49.9R shunts are DNP. Each lane supplies all four output rows.
INPUT 0 | a0 -> P0=+a0, N0=-a0
INPUT 1 | a1 -> P1=+a1, N1=-a1
INPUT 2 | a2 -> P2=+a2, N2=-a2
INPUT 3 | a3 -> P3=+a3, N3=-a3
