tim4431/analog_programmable_matrix/variants/lc1/hardware/analog_matrix_lc1.kicad_pcb

## KiCad design variants/lc1/hardware/analog_matrix_lc1.kicad_pcb (continued)

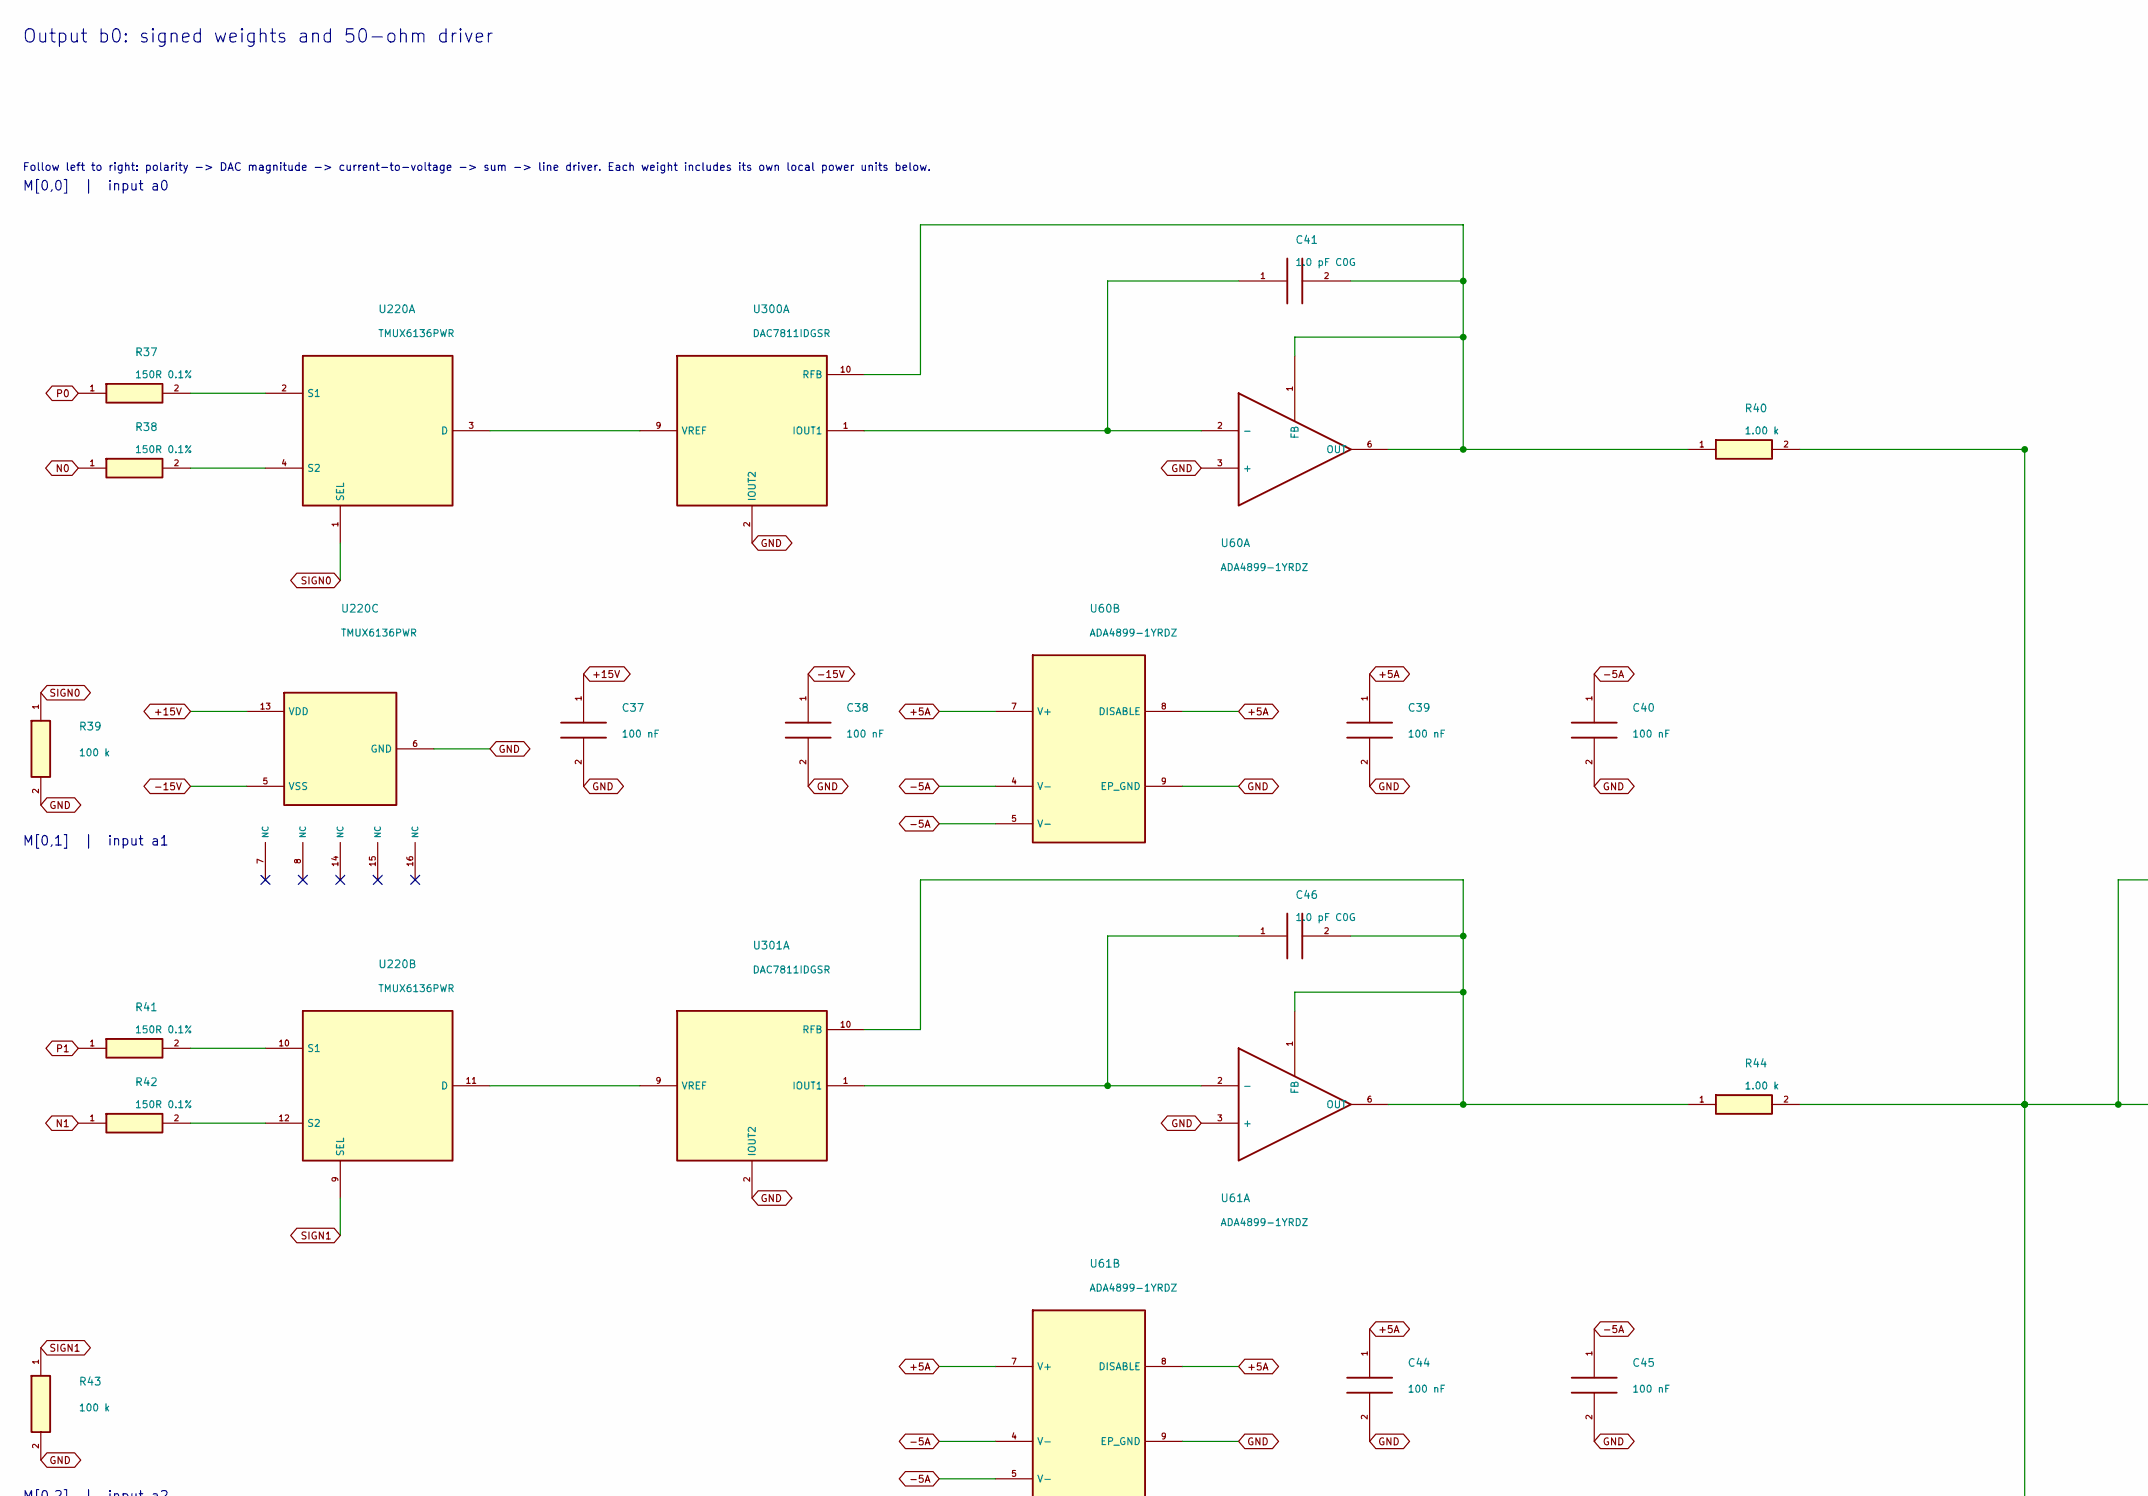
[picture p70: schematic row_0.kicad_sch, Output b0: signed weights and 50-ohm driver, part in row 1, column 1]

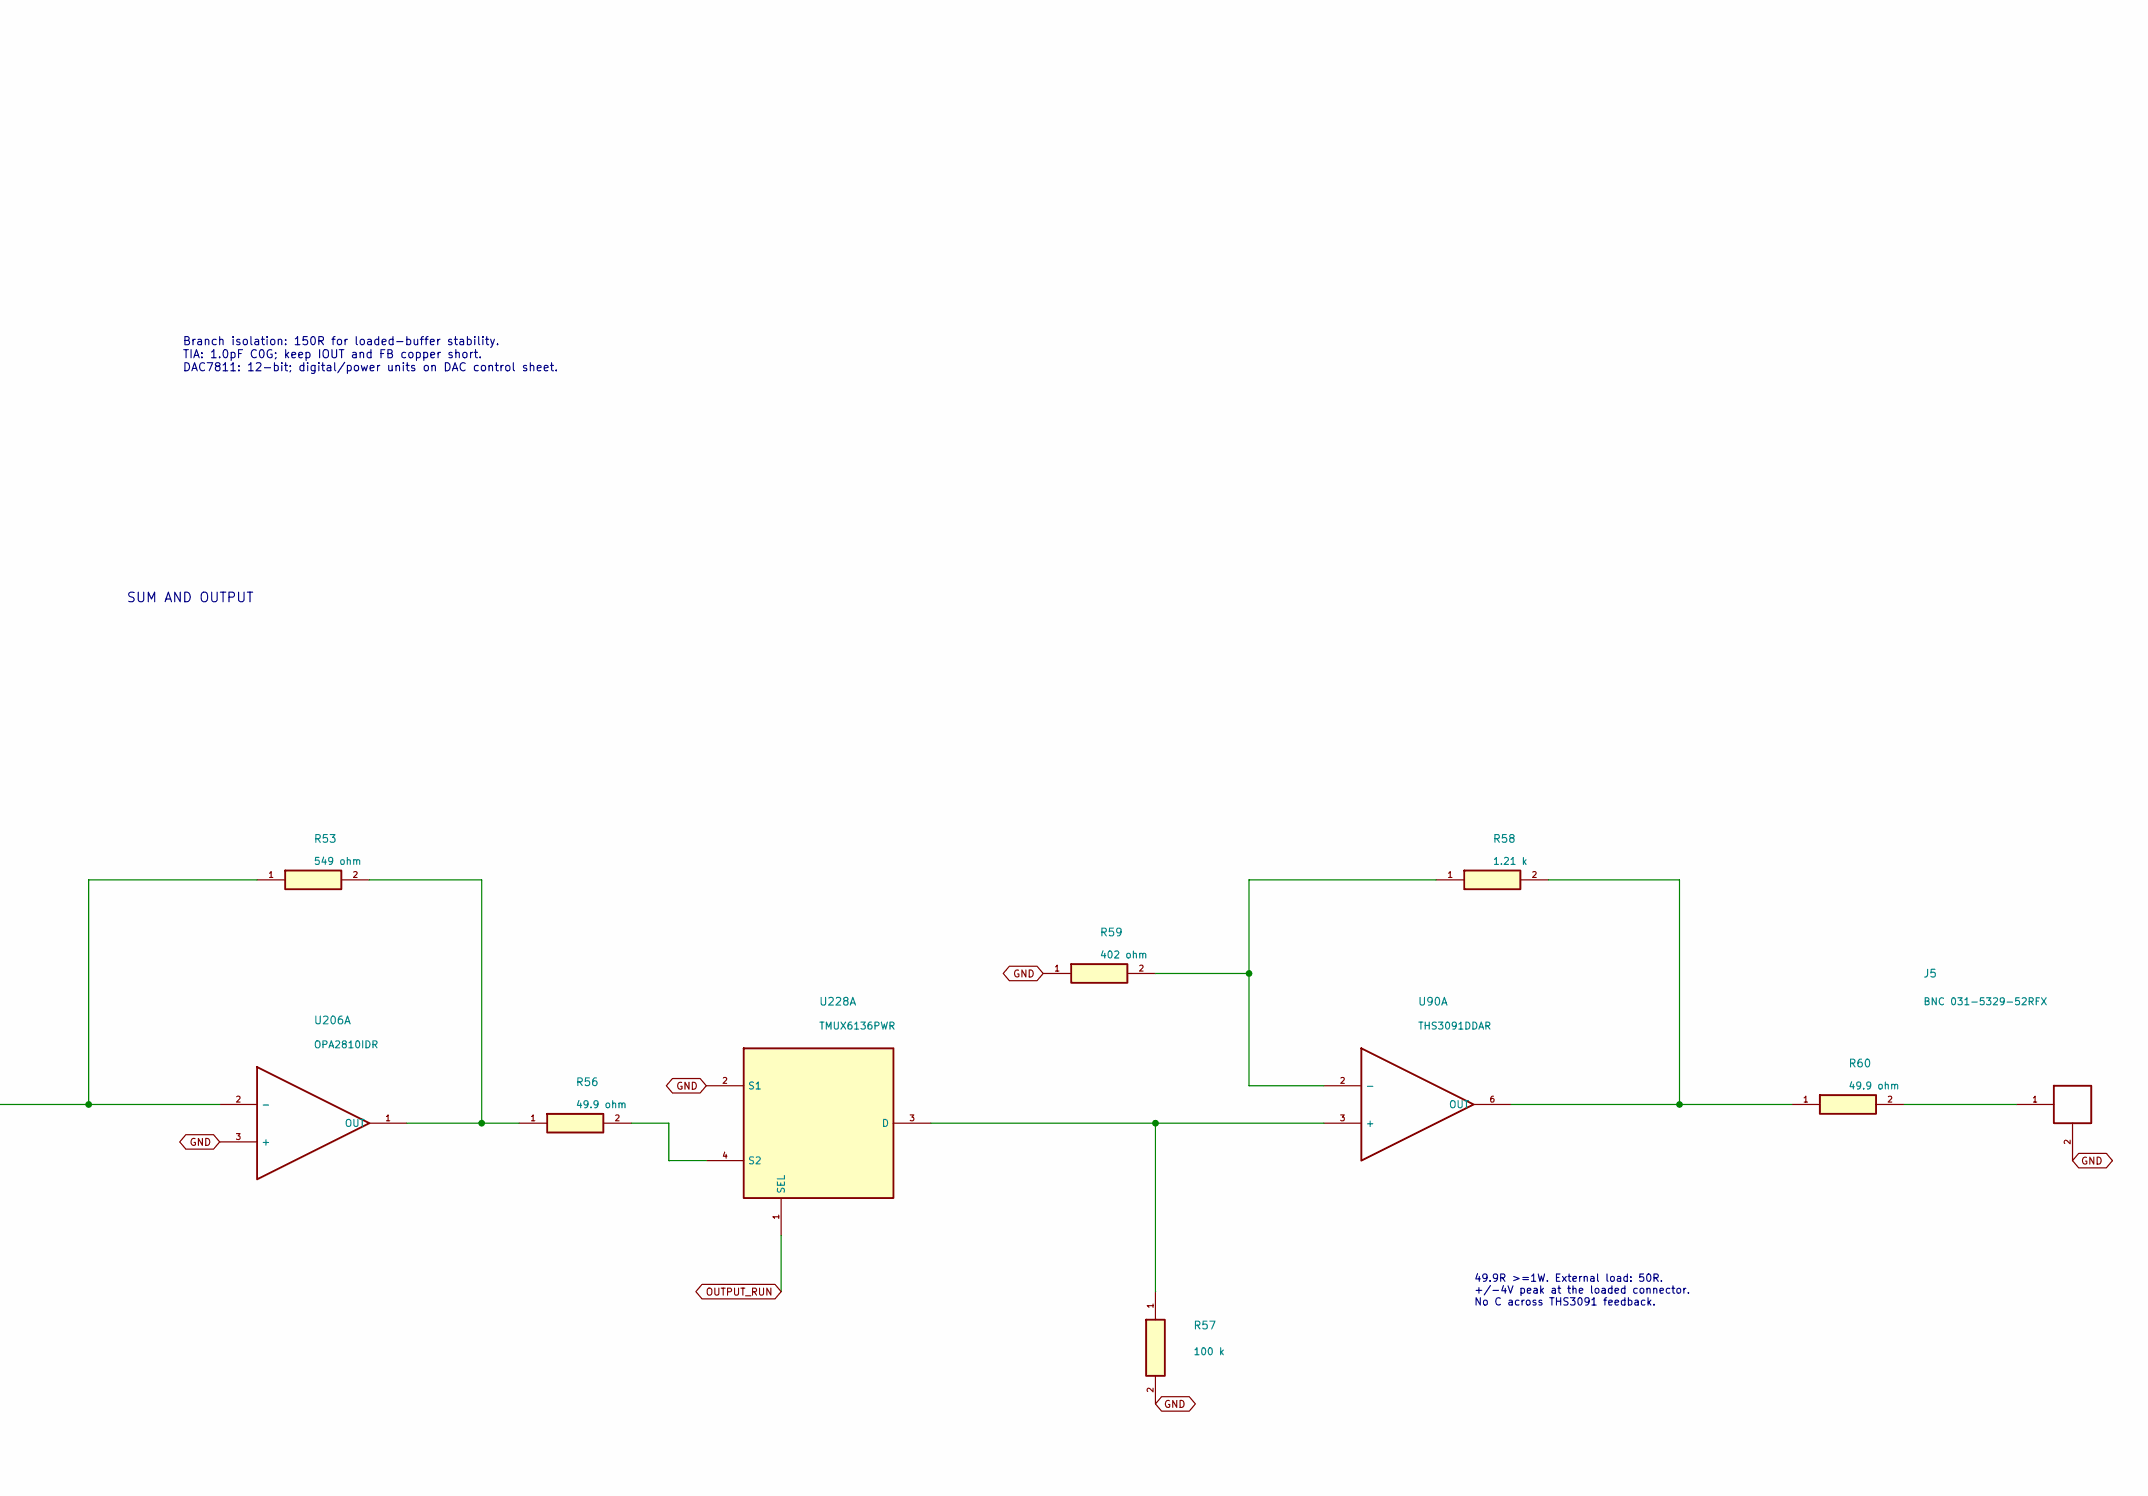
[picture p71: schematic row_0.kicad_sch, Output b0: signed weights and 50-ohm driver, part in row 1, column 2]

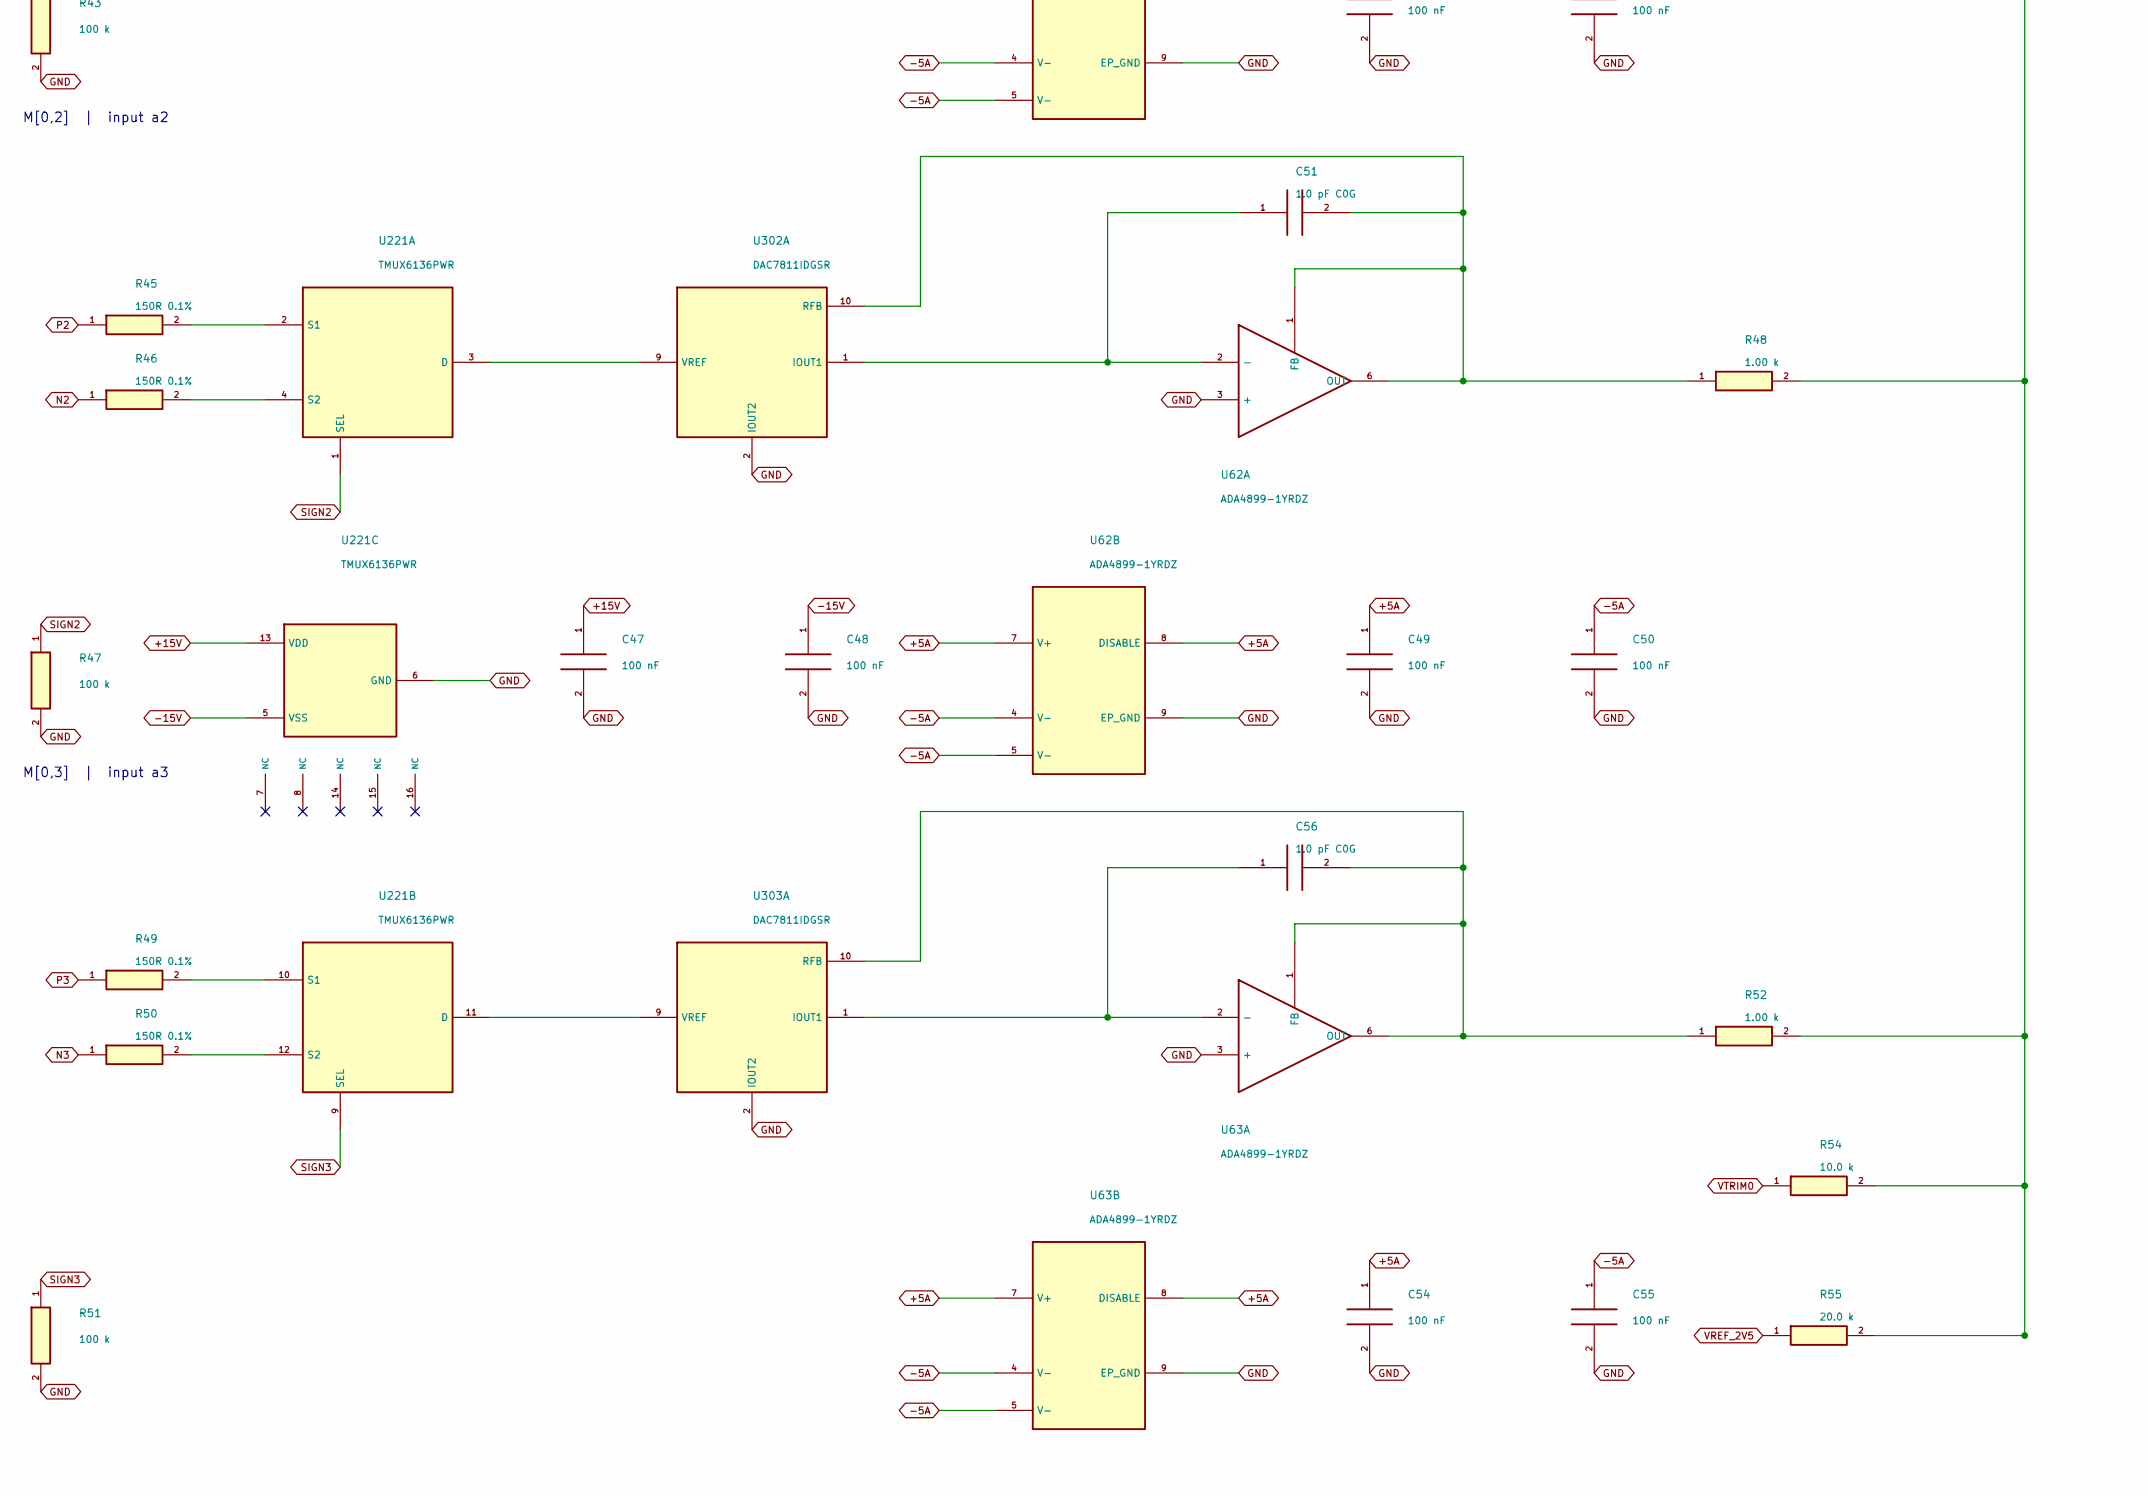
[picture p72: schematic row_0.kicad_sch, Output b0: signed weights and 50-ohm driver, part in row 2, column 1]

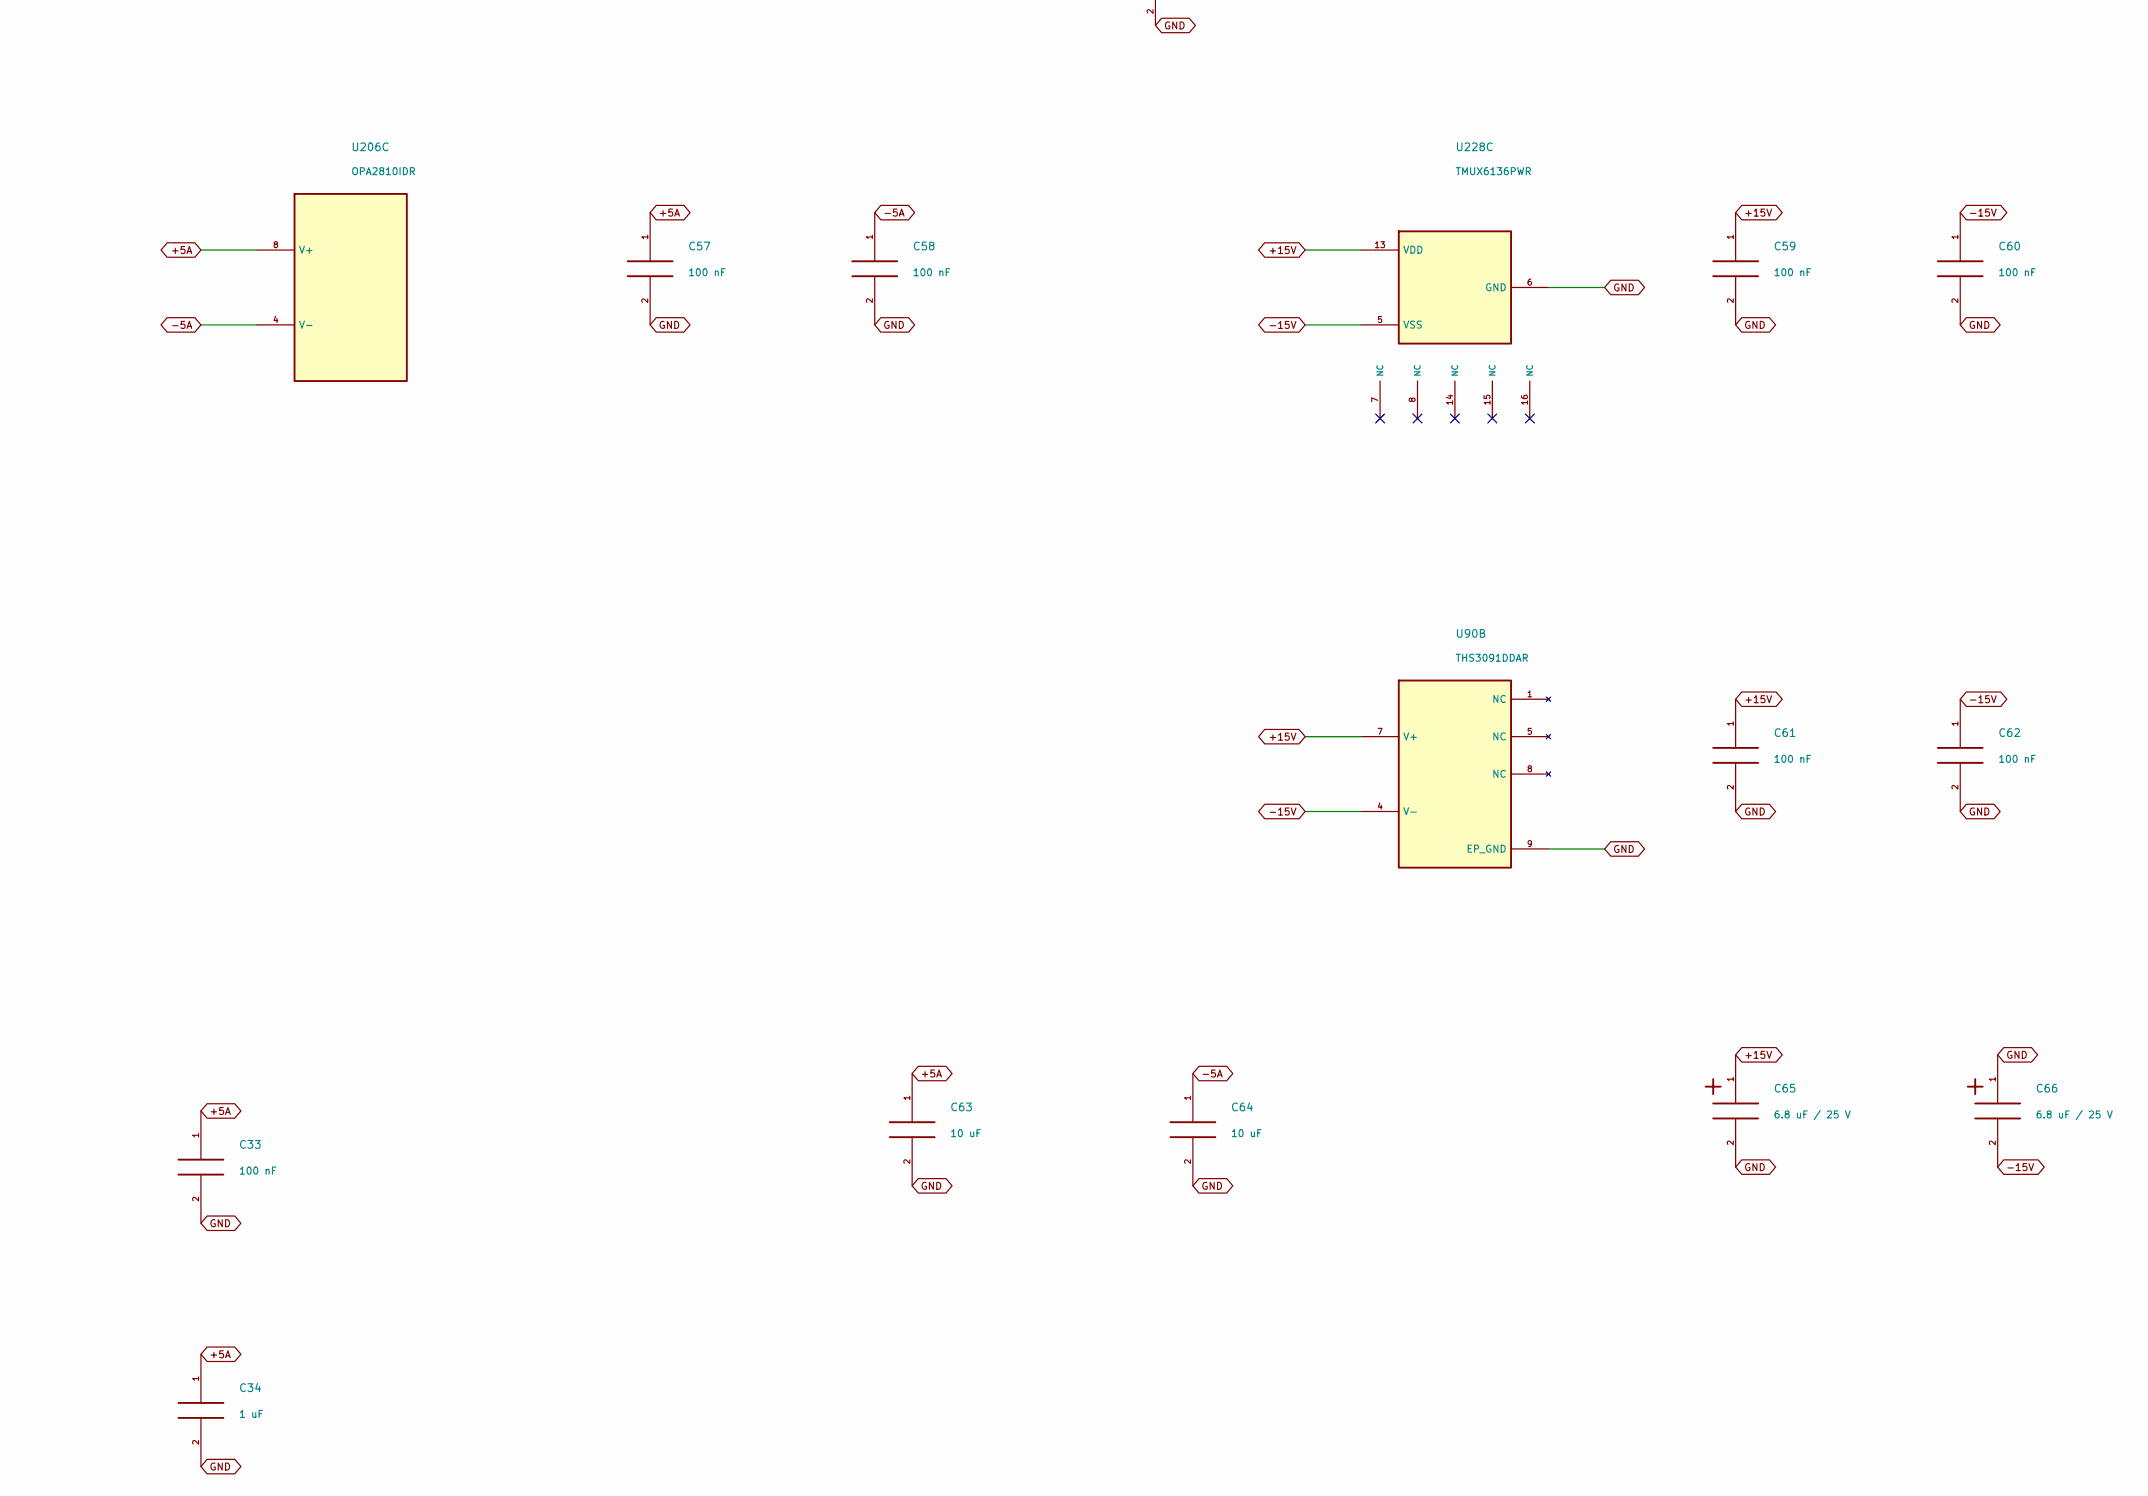
[picture p73: schematic row_0.kicad_sch, Output b0: signed weights and 50-ohm driver, part in row 2, column 2]

Parts:
C33, C37, C38, C39, C40, C44, C45, C47, C48, C49, C50, C54, C55, C57, C58, C59, C60, C61, C62: 100 nF; C_0603_1608Metric; Rating 25V X7R minimum; effective C after bias
C34: 1 uF; C_0805_2012Metric; Rating 25V X7R minimum; effective C after bias
C41, C46, C51, C56: 1.0 pF C0G; C_0402_1005Metric; Rating 50V C0G, +/-0.1pF; stray capacitance in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
C63, C64: 10 uF; C_0805_2012Metric; Rating 25V X7R minimum; effective C after bias
C65, C66: 6.8 uF / 25 V; CP_EIA-3216-18_Kemet-A; Rating 25V polarized
J5: BNC 031-5329-52RFX; BNC_Amphenol_031-5329-52RFX_Vertical
R37, R38, R41, R42, R45, R46, R49, R50: 150R 0.1%; R_0603_1608Metric; Rating 0.1%, <=25ppm/C; 0.1W minimum
R39, R43, R47, R51, R57: 100 k; R_0603_1608Metric; Rating 0.1%, <=25ppm/C; 0.1W minimum
R40, R44, R48, R52: 1.00 k; R_0603_1608Metric; Rating 0.1%, <=25ppm/C; 0.1W minimum
R53: 549 ohm; R_0603_1608Metric; Rating 0.1%, <=25ppm/C; 0.1W minimum
R54: 10.0 k; R_0603_1608Metric; Rating 0.1%, <=25ppm/C; 0.1W minimum
R55: 20.0 k; R_0603_1608Metric; Rating 0.1%, <=25ppm/C; 0.1W minimum
R56: 49.9 ohm; R_0603_1608Metric; Rating 0.1%, <=25ppm/C; 0.1W minimum
R58: 1.21 k; R_0603_1608Metric; Rating 0.1%, <=25ppm/C; 0.1W minimum
R59: 402 ohm; R_0603_1608Metric; Rating 0.1%, <=25ppm/C; 0.1W minimum
R60: 49.9 ohm; R_2512_6332Metric; Rating 0.1%, <=25ppm/C; >=1W
U60, U61, U62, U63: ADA4899-1YRDZ; ADA4899_RD8_EP2.29x2.29
U90: THS3091DDAR; SOIC-8-1EP_3.9x4.9mm_P1.27mm_EP2.95x4.9mm_Mask2.71x3.4mm_Th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
U206: OPA2810IDR; SOIC-8_3.9x4.9mm_P1.27mm
U220, U221, U228: TMUX6136PWR; TSSOP-16_4.4x5mm_P0.65mm
U300, U301, U302, U303: DAC7811IDGSR; VSSOP-10_3x3mm_P0.5mm

Connections:
+5A: C33.1, C34.1, C39.1, C44.1, C49.1, C54.1, C57.1, C63.1, U60.7 (V+), U60.8 (DISABLE), U61.7 (V+), U61.8 (DISABLE), U62.7 (V+), U62.8 (DISABLE), U63.7 (V+), U63.8 (DISABLE), U206.8 (V+); also elsewhere on the board
+15V: C37.1, C47.1, C59.1, C61.1, C65.1, U90.7 (V+), U220.13 (VDD), U221.13 (VDD), U228.13 (VDD); also elsewhere on the board
-5A: C40.1, C45.1, C50.1, C55.1, C58.1, C64.1, U60.4 (V-), U60.5 (V-), U61.4 (V-), U61.5 (V-), U62.4 (V-), U62.5 (V-), U63.4 (V-), U63.5 (V-), U206.4 (V-); also elsewhere on the board
-15V: C38.1, C48.1, C60.1, C62.1, C66.2, U90.4 (V-), U220.5 (VSS), U221.5 (VSS), U228.5 (VSS); also elsewhere on the board
GND: C33.2, C34.2, C37.2, C38.2, C39.2, C40.2, C44.2, C45.2, C47.2, C48.2, C49.2, C50.2, C54.2, C55.2, C57.2, C58.2, C59.2, C60.2, C61.2, C62.2, C63.2, C64.2, C65.2, C66.1, J5.2, R39.2, R43.2, R47.2, R51.2, R57.2, R59.1, U60.3 (+), U60.9 (EP_GND), U61.3 (+), U61.9 (EP_GND), U62.3 (+), U62.9 (EP_GND), U63.3 (+), U63.9 (EP_GND), U90.9 (EP_GND), U206.3 (+), U220.6 (GND), U221.6 (GND), U228.2 (S1), U228.6 (GND), U300.2 (IOUT2), U301.2 (IOUT2), U302.2 (IOUT2), U303.2 (IOUT2); also elsewhere on the board
N0: R38.1; also elsewhere on the board
N1: R42.1; also elsewhere on the board
N2: R46.1; also elsewhere on the board
N3: R50.1; also elsewhere on the board
unnamed: J5.1, R60.2
unnamed: R58.1, R59.2, U90.2 (-)
unnamed: R58.2, R60.1, U90.6 (OUT)
unnamed: R40.2, R44.2, R48.2, R52.2, R53.1, R54.2, R55.2, U206.2 (-)
unnamed: R53.2, R56.1, U206.1 (OUT)
unnamed: U220.3 (D), U300.9 (VREF)
unnamed: R37.2, U220.2 (S1)
unnamed: R38.2, U220.4 (S2)
unnamed: U220.11 (D), U301.9 (VREF)
unnamed: R41.2, U220.10 (S1)
unnamed: R42.2, U220.12 (S2)
unnamed: U221.3 (D), U302.9 (VREF)
unnamed: R45.2, U221.2 (S1)
unnamed: R46.2, U221.4 (S2)
unnamed: U221.11 (D), U303.9 (VREF)
unnamed: R49.2, U221.10 (S1)
unnamed: R50.2, U221.12 (S2)
unnamed: R57.1, U90.3 (+), U228.3 (D)
unnamed: R56.2, U228.4 (S2)
unnamed: C41.1, U60.2 (-), U300.1 (IOUT1)
unnamed: C41.2, R40.1, U60.1 (FB), U60.6 (OUT), U300.10 (RFB)
unnamed: C46.1, U61.2 (-), U301.1 (IOUT1)
unnamed: C46.2, R44.1, U61.1 (FB), U61.6 (OUT), U301.10 (RFB)
unnamed: C51.1, U62.2 (-), U302.1 (IOUT1)
unnamed: C51.2, R48.1, U62.1 (FB), U62.6 (OUT), U302.10 (RFB)
unnamed: C56.1, U63.2 (-), U303.1 (IOUT1)
unnamed: C56.2, R52.1, U63.1 (FB), U63.6 (OUT), U303.10 (RFB)
OUTPUT_RUN: U228.1 (SEL); also elsewhere on the board
P0: R37.1; also elsewhere on the board
P1: R41.1; also elsewhere on the board
P2: R45.1; also elsewhere on the board
P3: R49.1; also elsewhere on the board
SIGN0: R39.1, U220.1 (SEL); also elsewhere on the board
SIGN1: R43.1, U220.9 (SEL); also elsewhere on the board
SIGN2: R47.1, U221.1 (SEL); also elsewhere on the board
SIGN3: R51.1, U221.9 (SEL); also elsewhere on the board
VREF_2V5: R55.1; also elsewhere on the board
VTRIM0: R54.1; also elsewhere on the board

Notes on the sheet:
Output b0: signed weights and 50-ohm driver
Follow left to right: polarity -> DAC magnitude -> current-to-voltage -> sum -> line driver. Each weight includes its own local power units below.
M[0,0] | input a0
M[0,1] | input a1
M[0,2] | input a2
M[0,3] | input a3
SUM AND OUTPUT
49.9R >=1W. External load: 50R. +/-4V peak at the loaded connector. No C across THS3091 feedback.
Branch isolation: 150R for loaded-buffer stability. TIA: 1.0pF C0G; keep IOUT and FB copper short. DAC7811: 12-bit; digital/power units on DAC control sheet.
