tim4431/analog_programmable_matrix/variants/lc1/hardware/analog_matrix_lc1.kicad_pcb

## KiCad design variants/lc1/hardware/analog_matrix_lc1.kicad_pcb (continued)

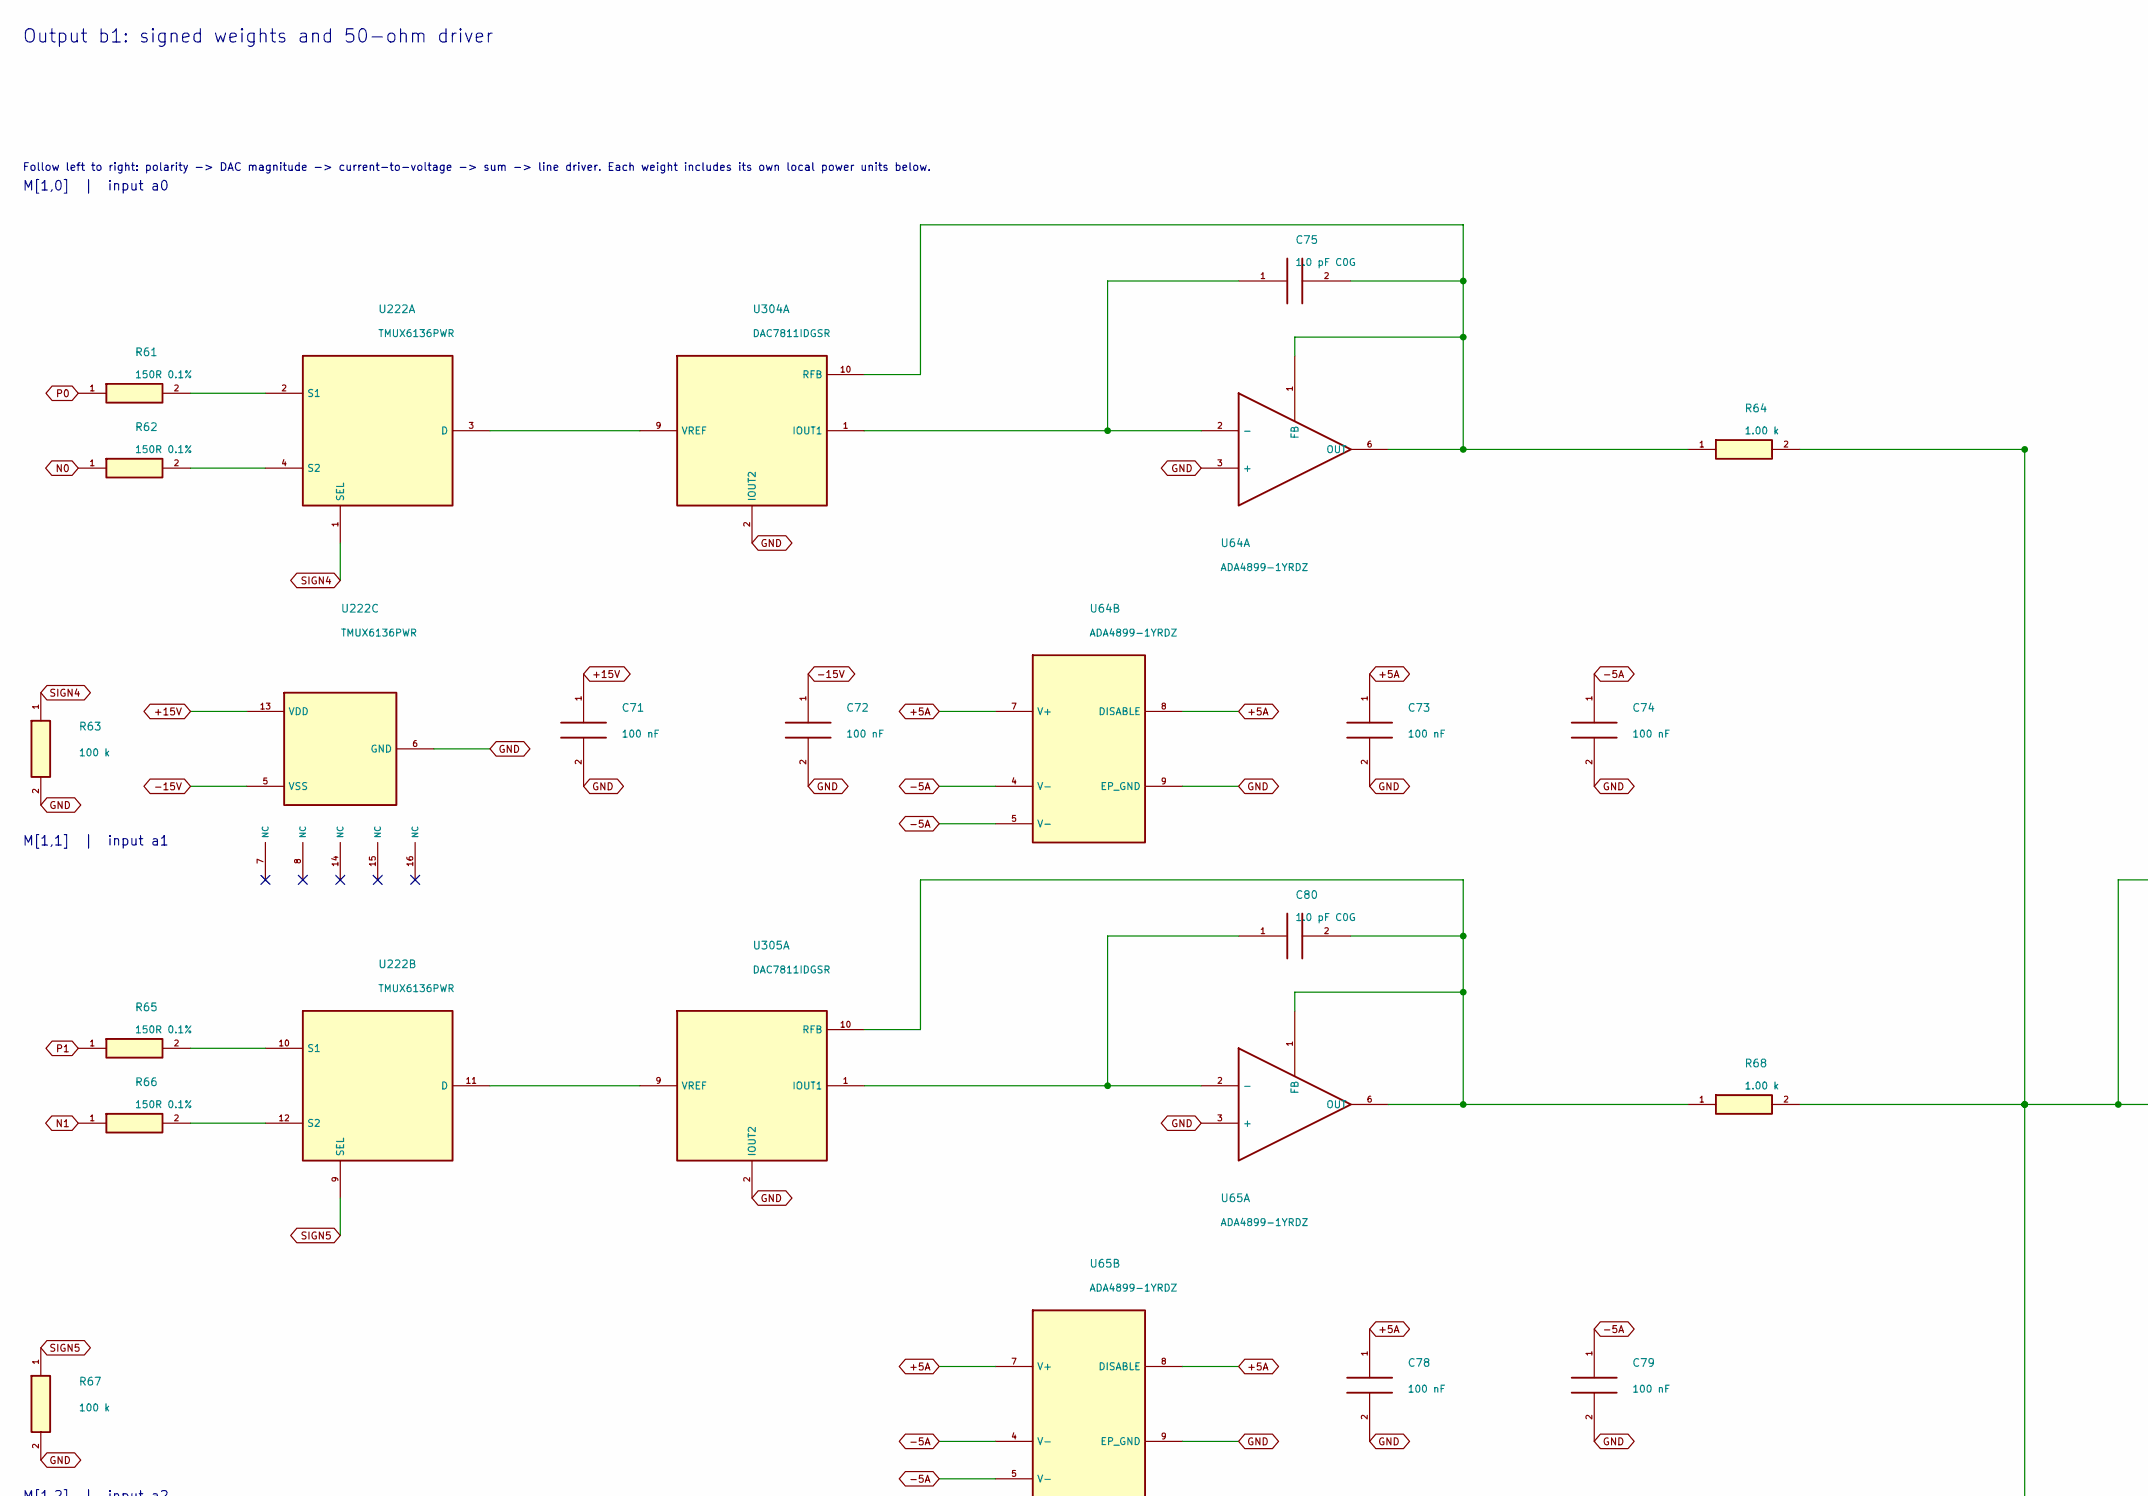
[picture p74: schematic row_1.kicad_sch, Output b1: signed weights and 50-ohm driver, part in row 1, column 1]

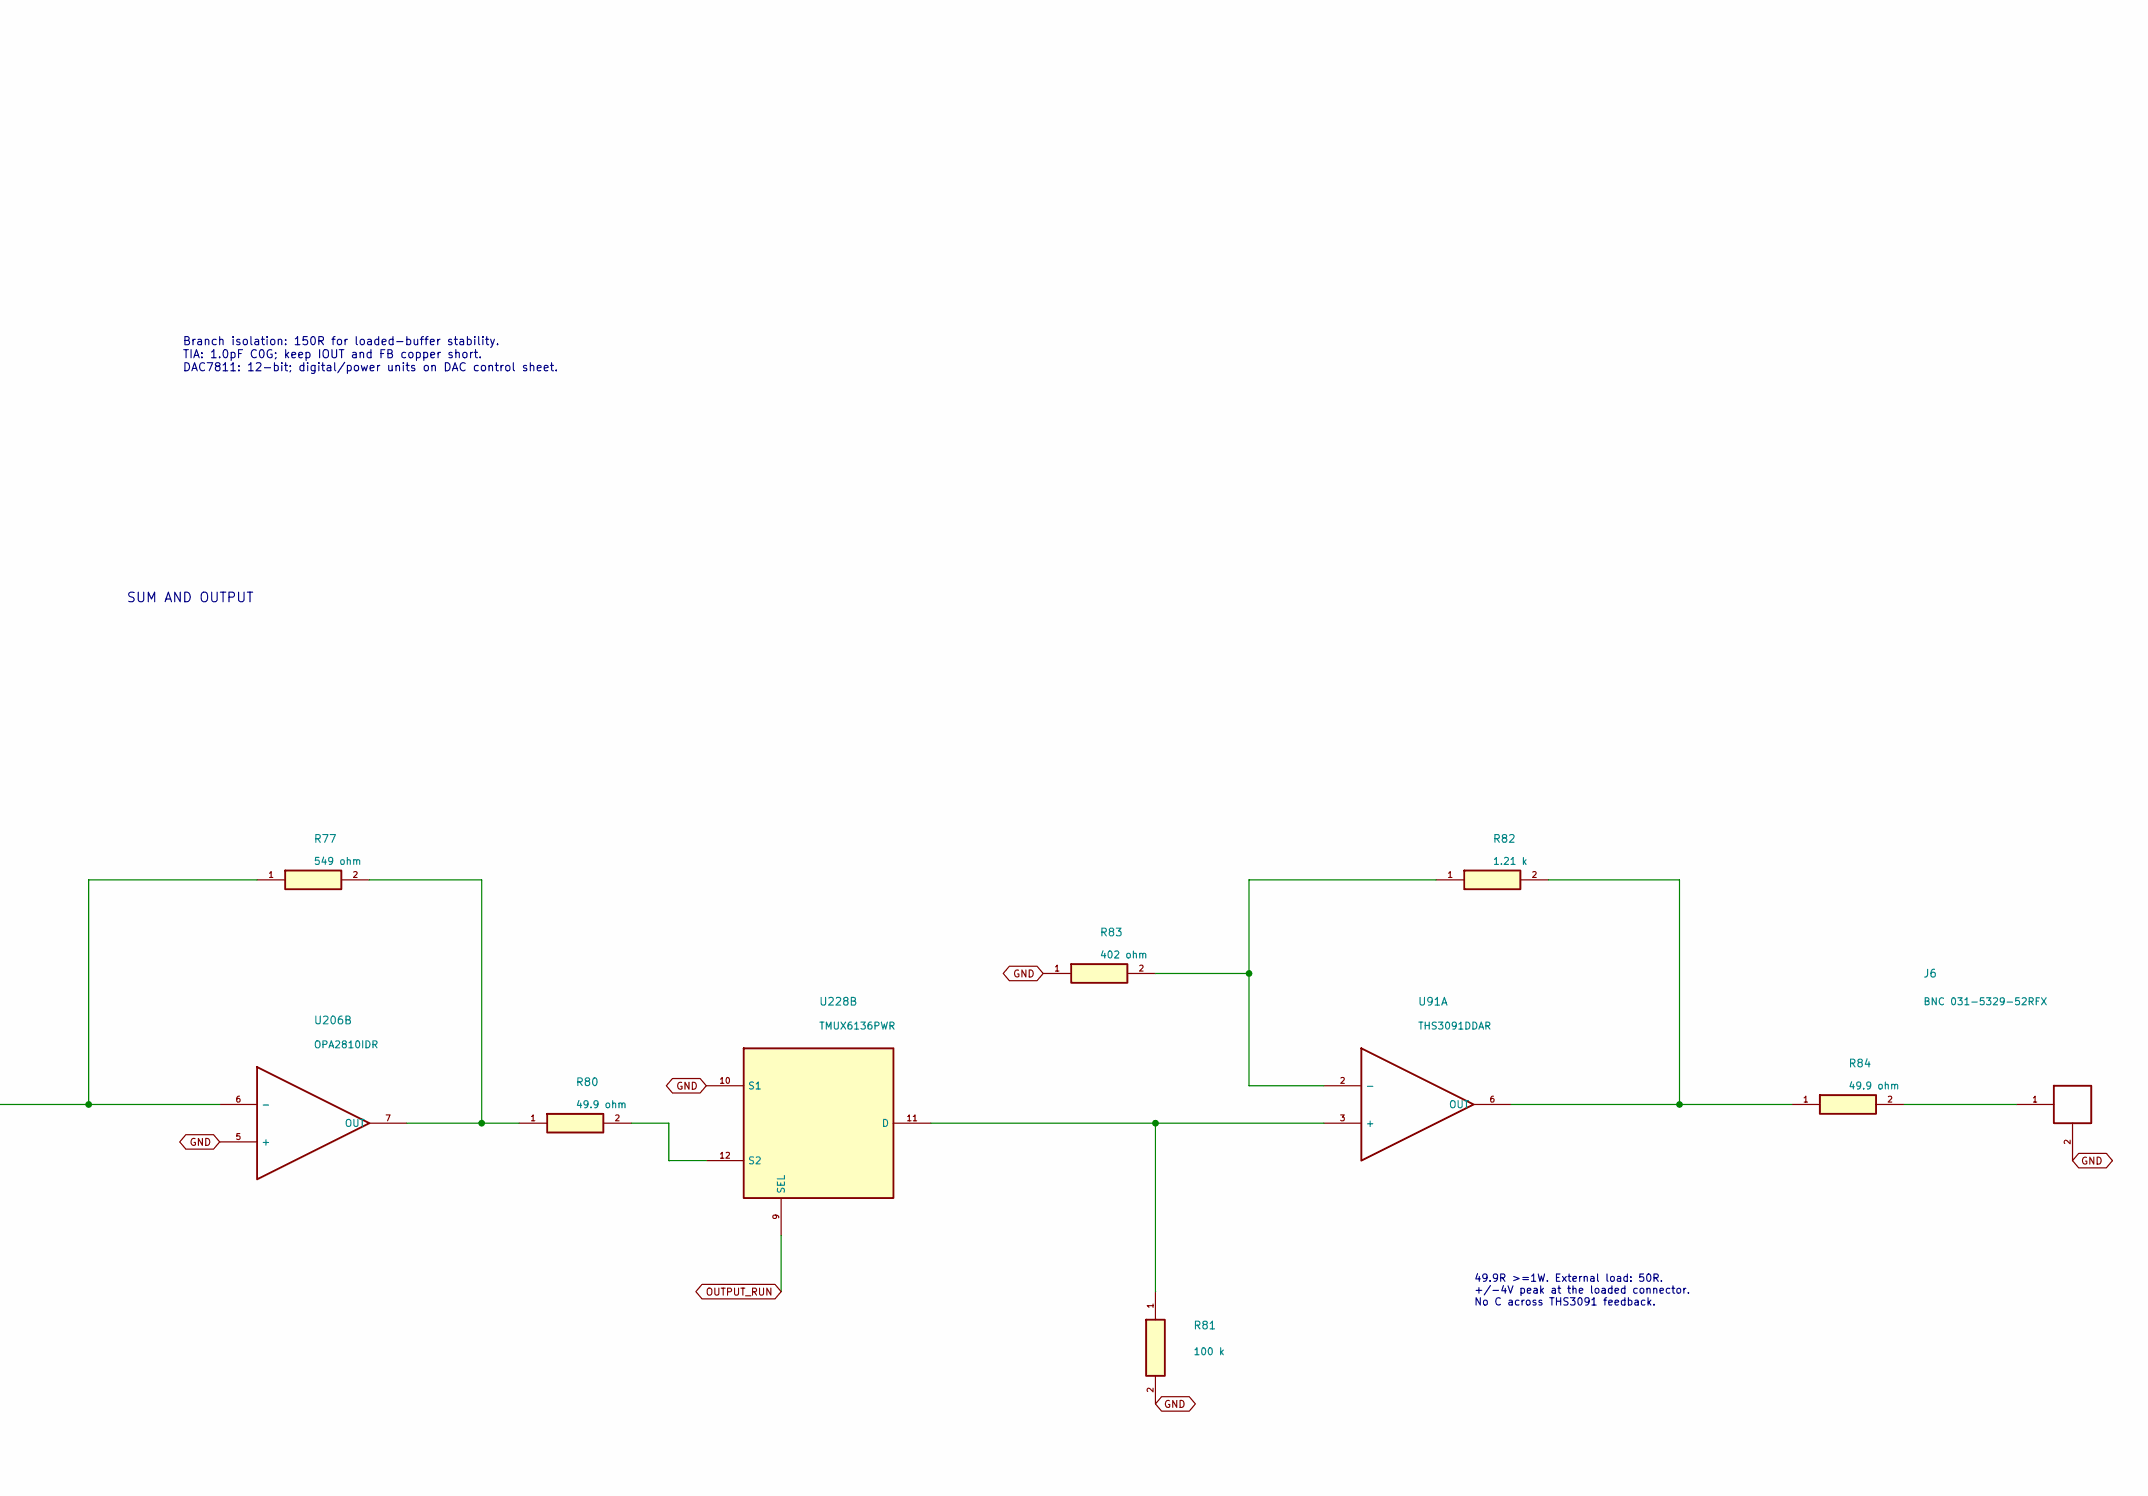
[picture p75: schematic row_1.kicad_sch, Output b1: signed weights and 50-ohm driver, part in row 1, column 2]

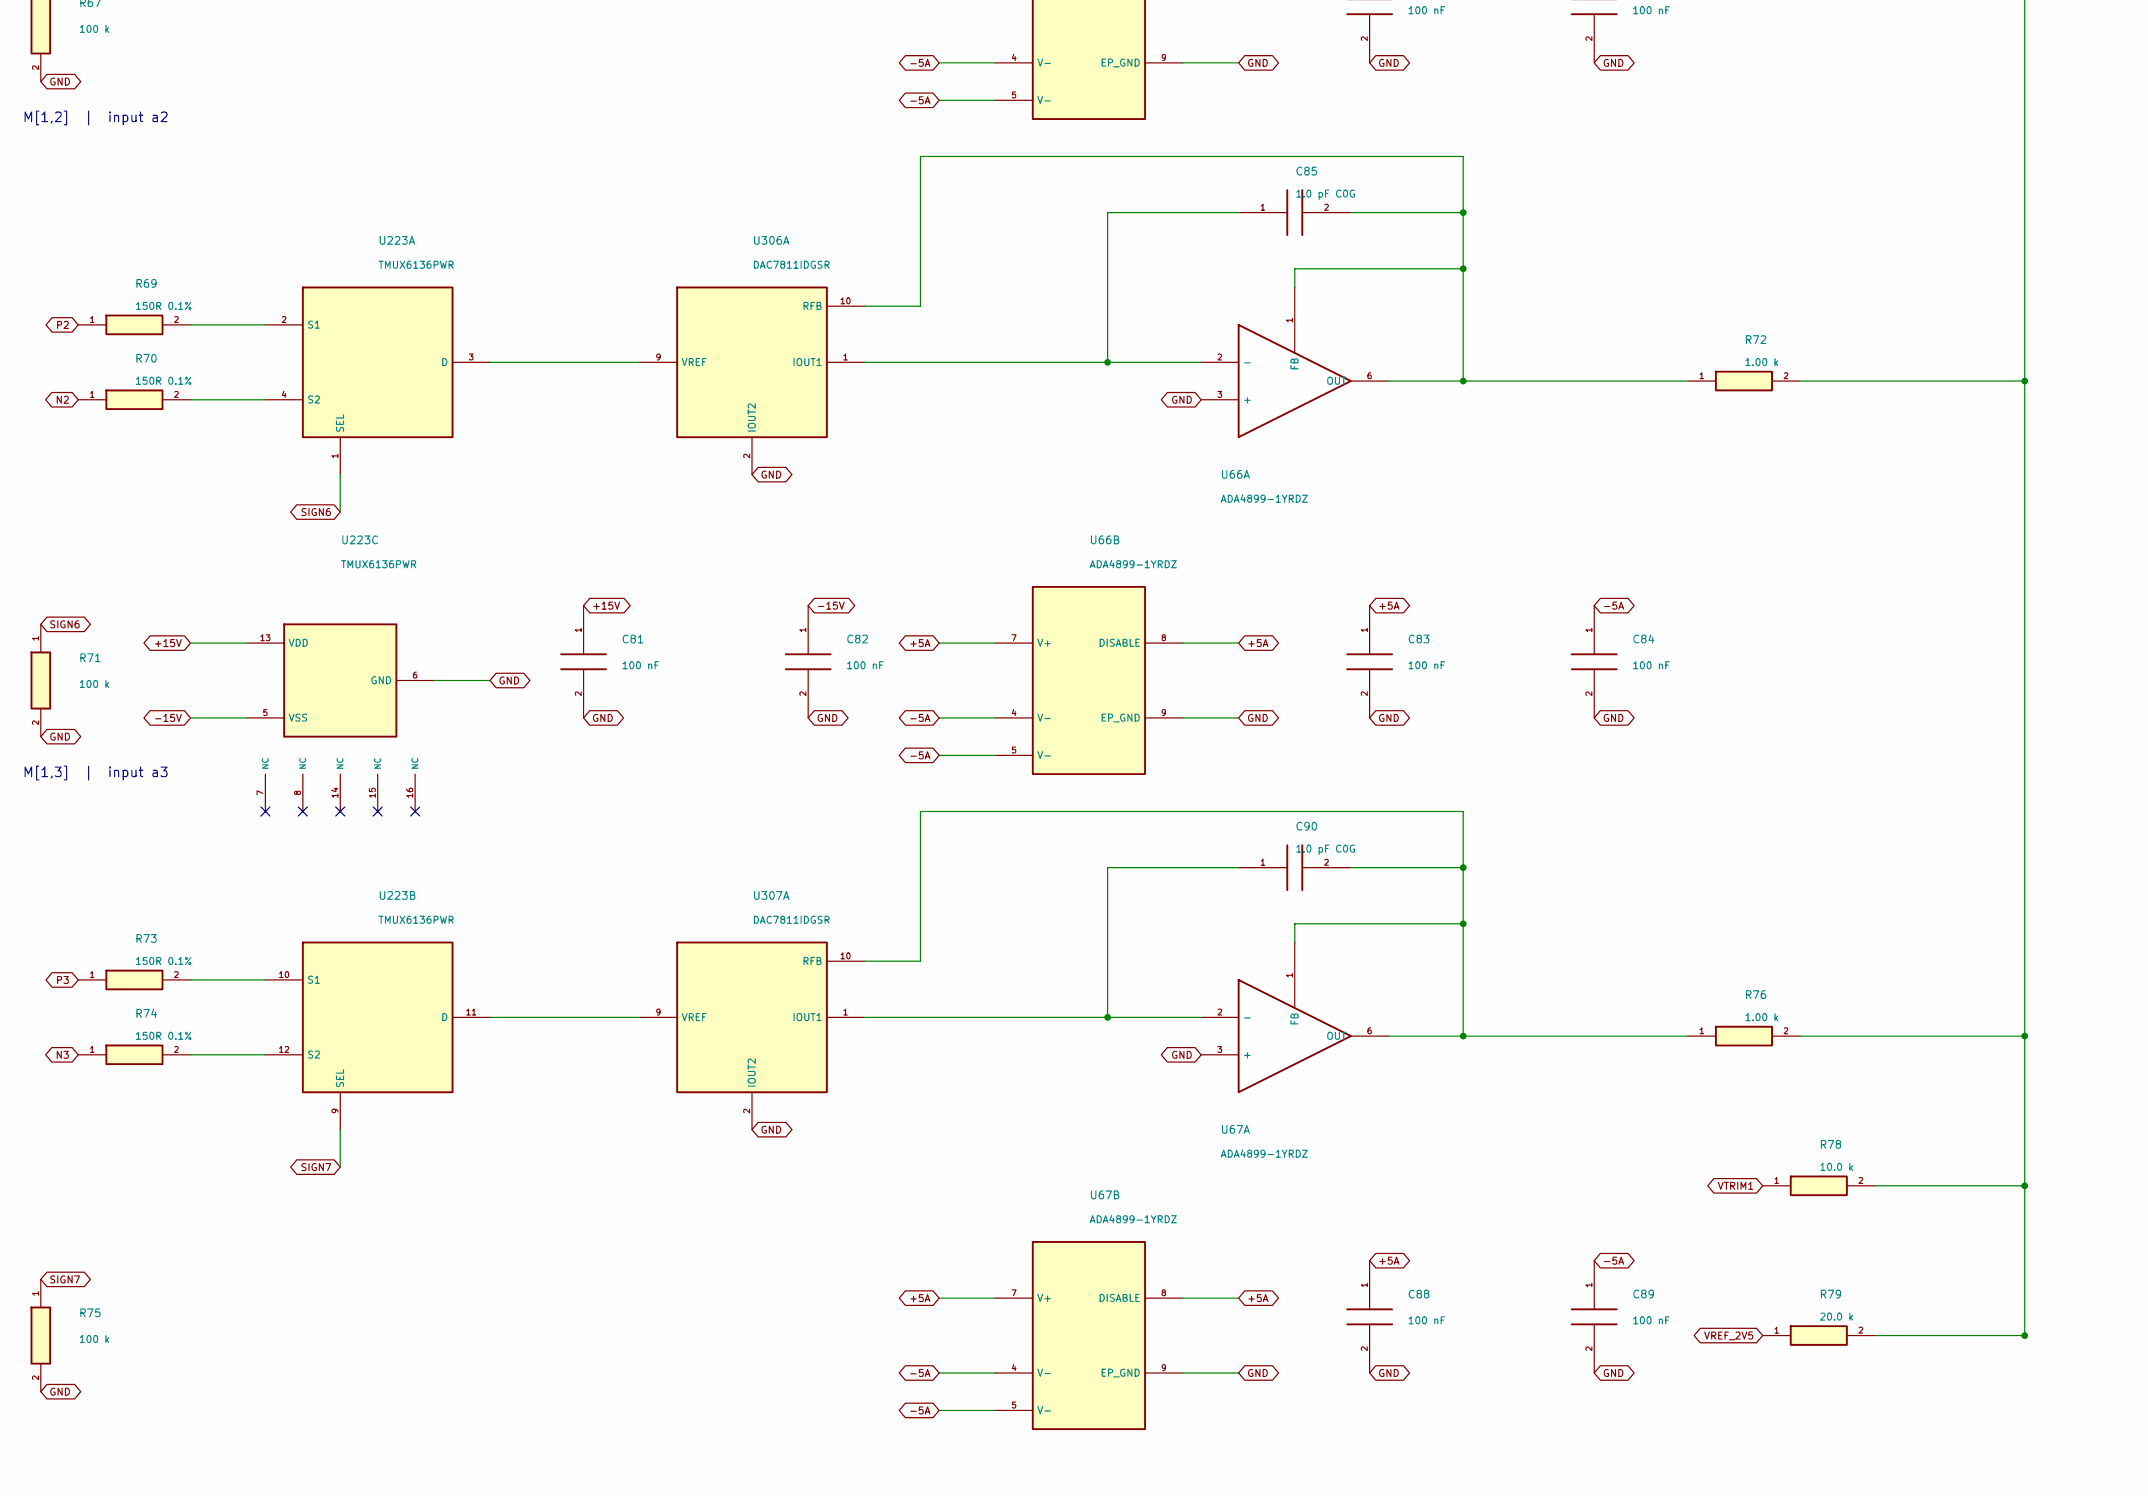
[picture p76: schematic row_1.kicad_sch, Output b1: signed weights and 50-ohm driver, part in row 2, column 1]

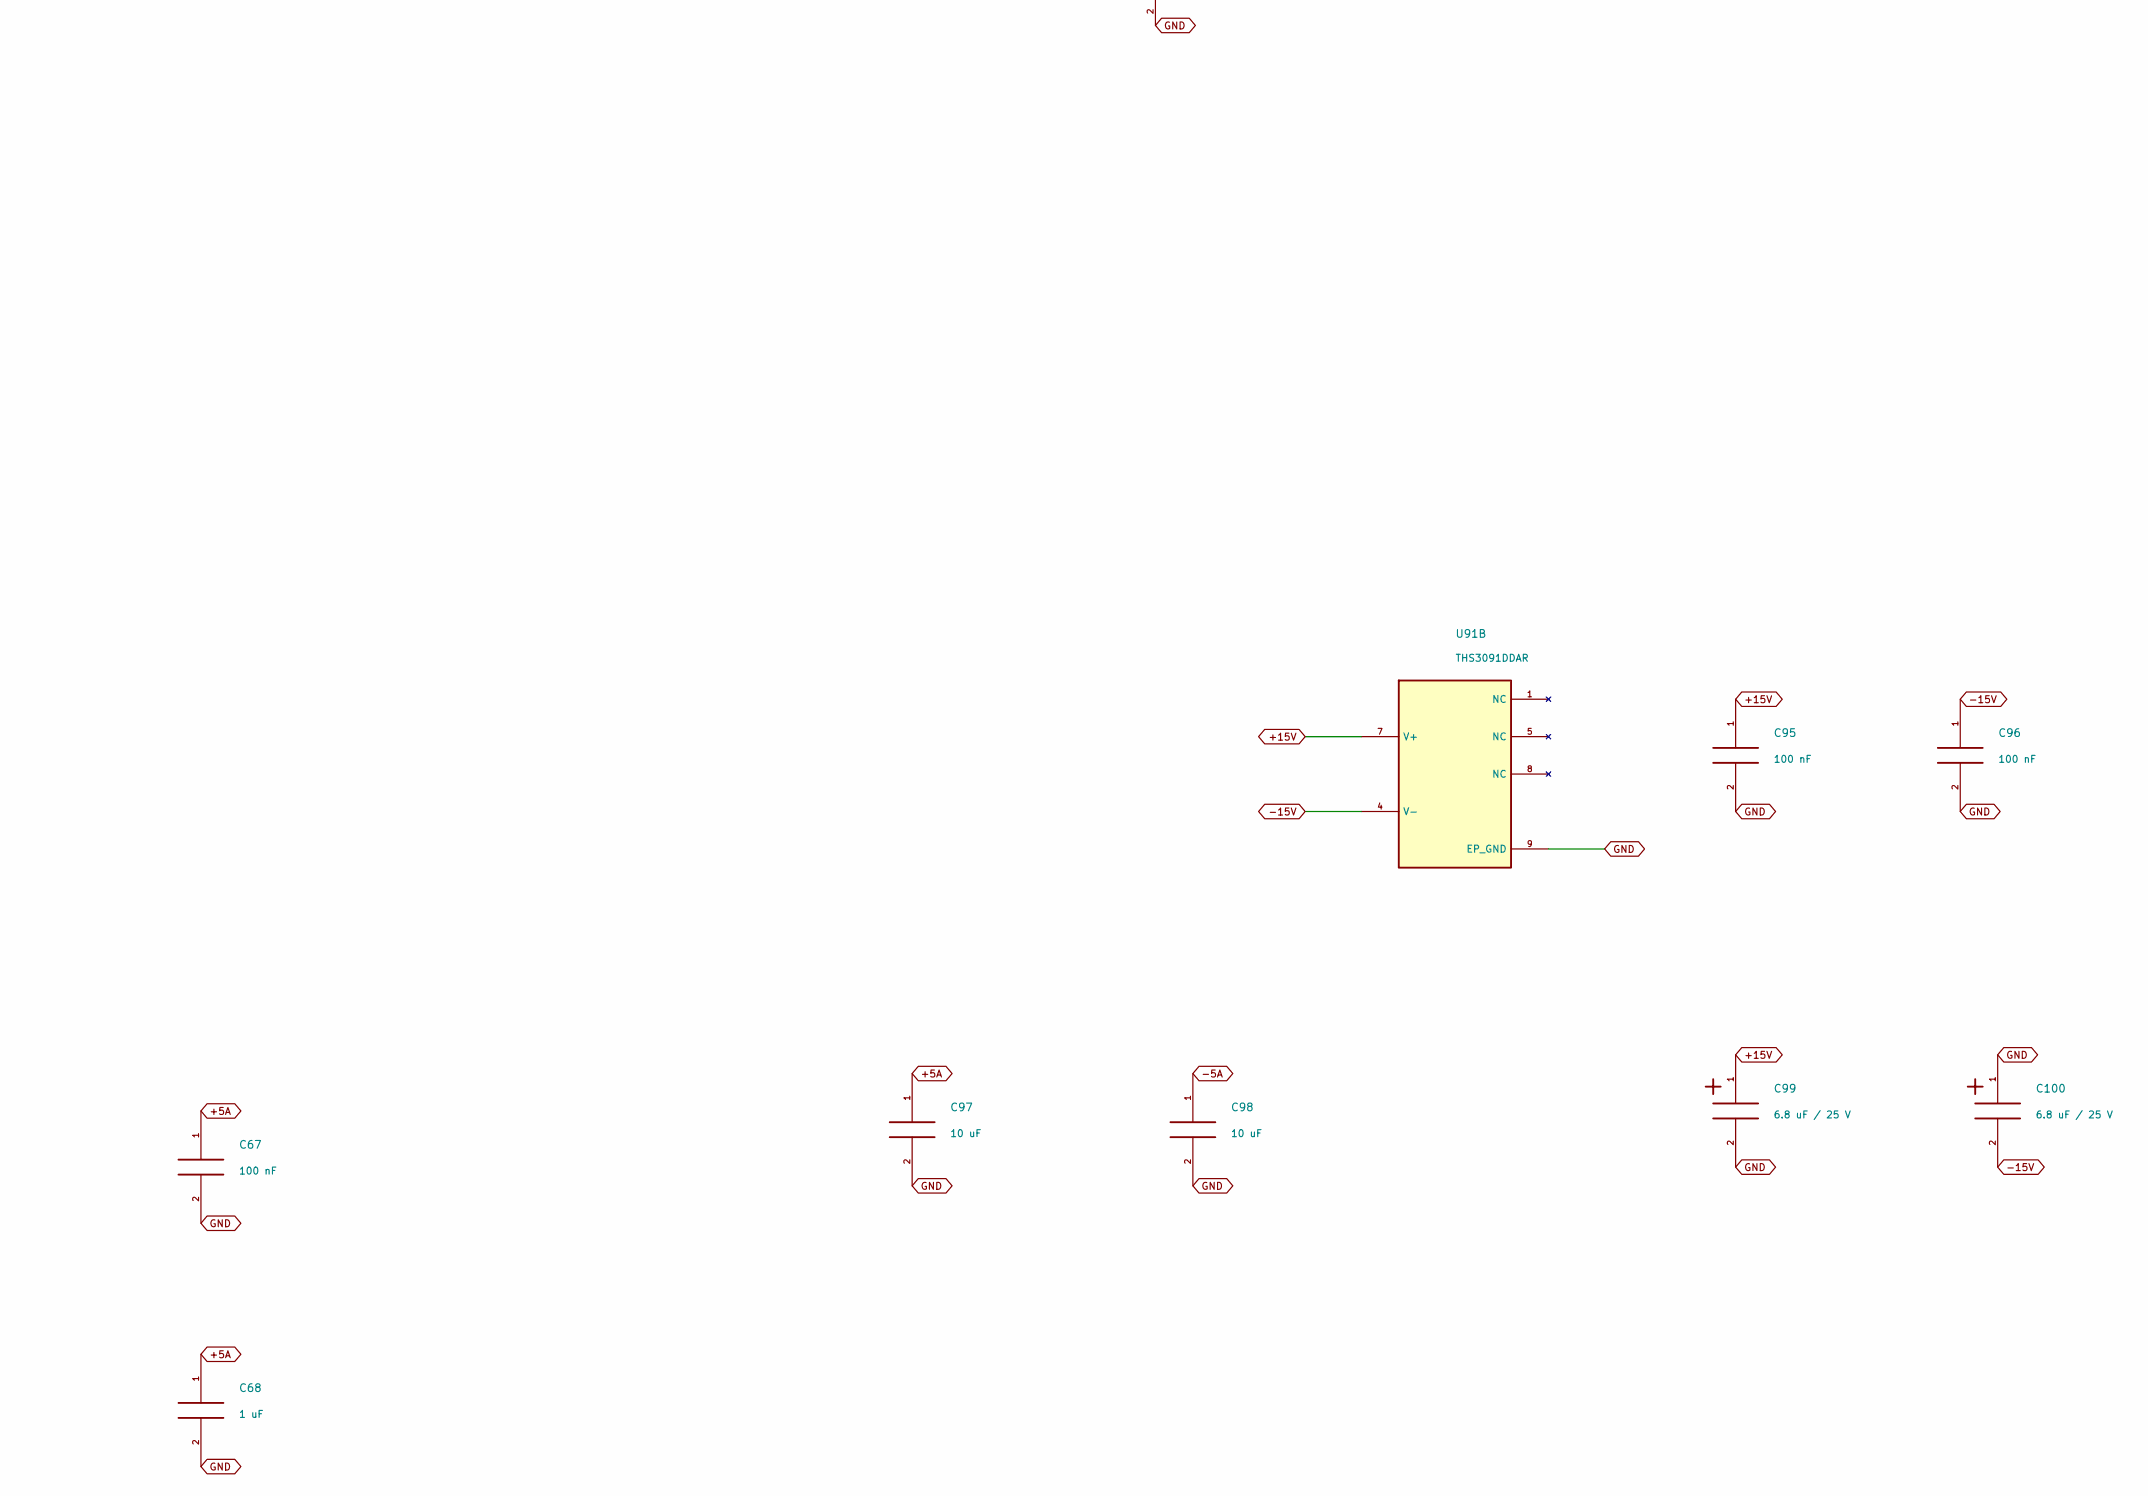
[picture p77: schematic row_1.kicad_sch, Output b1: signed weights and 50-ohm driver, part in row 2, column 2]

Parts:
C67, C71, C72, C73, C74, C78, C79, C81, C82, C83, C84, C88, C89, C95, C96: 100 nF; C_0603_1608Metric; Rating 25V X7R minimum; effective C after bias
C68: 1 uF; C_0805_2012Metric; Rating 25V X7R minimum; effective C after bias
C75, C80, C85, C90: 1.0 pF C0G; C_0402_1005Metric; Rating 50V C0G, +/-0.1pF; stray capacitance in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
C97, C98: 10 uF; C_0805_2012Metric; Rating 25V X7R minimum; effective C after bias
C99, C100: 6.8 uF / 25 V; CP_EIA-3216-18_Kemet-A; Rating 25V polarized
J6: BNC 031-5329-52RFX; BNC_Amphenol_031-5329-52RFX_Vertical
R61, R62, R65, R66, R69, R70, R73, R74: 150R 0.1%; R_0603_1608Metric; Rating 0.1%, <=25ppm/C; 0.1W minimum
R63, R67, R71, R75, R81: 100 k; R_0603_1608Metric; Rating 0.1%, <=25ppm/C; 0.1W minimum
R64, R68, R72, R76: 1.00 k; R_0603_1608Metric; Rating 0.1%, <=25ppm/C; 0.1W minimum
R77: 549 ohm; R_0603_1608Metric; Rating 0.1%, <=25ppm/C; 0.1W minimum
R78: 10.0 k; R_0603_1608Metric; Rating 0.1%, <=25ppm/C; 0.1W minimum
R79: 20.0 k; R_0603_1608Metric; Rating 0.1%, <=25ppm/C; 0.1W minimum
R80: 49.9 ohm; R_0603_1608Metric; Rating 0.1%, <=25ppm/C; 0.1W minimum
R82: 1.21 k; R_0603_1608Metric; Rating 0.1%, <=25ppm/C; 0.1W minimum
R83: 402 ohm; R_0603_1608Metric; Rating 0.1%, <=25ppm/C; 0.1W minimum
R84: 49.9 ohm; R_2512_6332Metric; Rating 0.1%, <=25ppm/C; >=1W
U64, U65, U66, U67: ADA4899-1YRDZ; ADA4899_RD8_EP2.29x2.29
U91: THS3091DDAR; SOIC-8-1EP_3.9x4.9mm_P1.27mm_EP2.95x4.9mm_Mask2.71x3.4mm_Th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
U206: OPA2810IDR; SOIC-8_3.9x4.9mm_P1.27mm
U222, U223, U228: TMUX6136PWR; TSSOP-16_4.4x5mm_P0.65mm
U304, U305, U306, U307: DAC7811IDGSR; VSSOP-10_3x3mm_P0.5mm

Connections:
+5A: C67.1, C68.1, C73.1, C78.1, C83.1, C88.1, C97.1, U64.7 (V+), U64.8 (DISABLE), U65.7 (V+), U65.8 (DISABLE), U66.7 (V+), U66.8 (DISABLE), U67.7 (V+), U67.8 (DISABLE); also elsewhere on the board
+15V: C71.1, C81.1, C95.1, C99.1, U91.7 (V+), U222.13 (VDD), U223.13 (VDD); also elsewhere on the board
-5A: C74.1, C79.1, C84.1, C89.1, C98.1, U64.4 (V-), U64.5 (V-), U65.4 (V-), U65.5 (V-), U66.4 (V-), U66.5 (V-), U67.4 (V-), U67.5 (V-); also elsewhere on the board
-15V: C72.1, C82.1, C96.1, C100.2, U91.4 (V-), U222.5 (VSS), U223.5 (VSS); also elsewhere on the board
GND: C67.2, C68.2, C71.2, C72.2, C73.2, C74.2, C78.2, C79.2, C81.2, C82.2, C83.2, C84.2, C88.2, C89.2, C95.2, C96.2, C97.2, C98.2, C99.2, C100.1, J6.2, R63.2, R67.2, R71.2, R75.2, R81.2, R83.1, U64.3 (+), U64.9 (EP_GND), U65.3 (+), U65.9 (EP_GND), U66.3 (+), U66.9 (EP_GND), U67.3 (+), U67.9 (EP_GND), U91.9 (EP_GND), U206.5 (+), U222.6 (GND), U223.6 (GND), U228.10 (S1), U304.2 (IOUT2), U305.2 (IOUT2), U306.2 (IOUT2), U307.2 (IOUT2); also elsewhere on the board
N0: R62.1; also elsewhere on the board
N1: R66.1; also elsewhere on the board
N2: R70.1; also elsewhere on the board
N3: R74.1; also elsewhere on the board
unnamed: J6.1, R84.2
unnamed: R82.1, R83.2, U91.2 (-)
unnamed: R82.2, R84.1, U91.6 (OUT)
unnamed: R64.2, R68.2, R72.2, R76.2, R77.1, R78.2, R79.2, U206.6 (-)
unnamed: R77.2, R80.1, U206.7 (OUT)
unnamed: U222.3 (D), U304.9 (VREF)
unnamed: R61.2, U222.2 (S1)
unnamed: R62.2, U222.4 (S2)
unnamed: U222.11 (D), U305.9 (VREF)
unnamed: R65.2, U222.10 (S1)
unnamed: R66.2, U222.12 (S2)
unnamed: U223.3 (D), U306.9 (VREF)
unnamed: R69.2, U223.2 (S1)
unnamed: R70.2, U223.4 (S2)
unnamed: U223.11 (D), U307.9 (VREF)
unnamed: R73.2, U223.10 (S1)
unnamed: R74.2, U223.12 (S2)
unnamed: R81.1, U91.3 (+), U228.11 (D)
unnamed: R80.2, U228.12 (S2)
unnamed: C75.1, U64.2 (-), U304.1 (IOUT1)
unnamed: C75.2, R64.1, U64.1 (FB), U64.6 (OUT), U304.10 (RFB)
unnamed: C80.1, U65.2 (-), U305.1 (IOUT1)
unnamed: C80.2, R68.1, U65.1 (FB), U65.6 (OUT), U305.10 (RFB)
unnamed: C85.1, U66.2 (-), U306.1 (IOUT1)
unnamed: C85.2, R72.1, U66.1 (FB), U66.6 (OUT), U306.10 (RFB)
unnamed: C90.1, U67.2 (-), U307.1 (IOUT1)
unnamed: C90.2, R76.1, U67.1 (FB), U67.6 (OUT), U307.10 (RFB)
OUTPUT_RUN: U228.9 (SEL); also elsewhere on the board
P0: R61.1; also elsewhere on the board
P1: R65.1; also elsewhere on the board
P2: R69.1; also elsewhere on the board
P3: R73.1; also elsewhere on the board
SIGN4: R63.1, U222.1 (SEL); also elsewhere on the board
SIGN5: R67.1, U222.9 (SEL); also elsewhere on the board
SIGN6: R71.1, U223.1 (SEL); also elsewhere on the board
SIGN7: R75.1, U223.9 (SEL); also elsewhere on the board
VREF_2V5: R79.1; also elsewhere on the board
VTRIM1: R78.1; also elsewhere on the board

Notes on the sheet:
Output b1: signed weights and 50-ohm driver
Follow left to right: polarity -> DAC magnitude -> current-to-voltage -> sum -> line driver. Each weight includes its own local power units below.
M[1,0] | input a0
M[1,1] | input a1
M[1,2] | input a2
M[1,3] | input a3
SUM AND OUTPUT
49.9R >=1W. External load: 50R. +/-4V peak at the loaded connector. No C across THS3091 feedback.
Branch isolation: 150R for loaded-buffer stability. TIA: 1.0pF C0G; keep IOUT and FB copper short. DAC7811: 12-bit; digital/power units on DAC control sheet.
