tim4431/analog_programmable_matrix/variants/lc1/hardware/analog_matrix_lc1.kicad_pcb

## KiCad design variants/lc1/hardware/analog_matrix_lc1.kicad_pcb (continued)

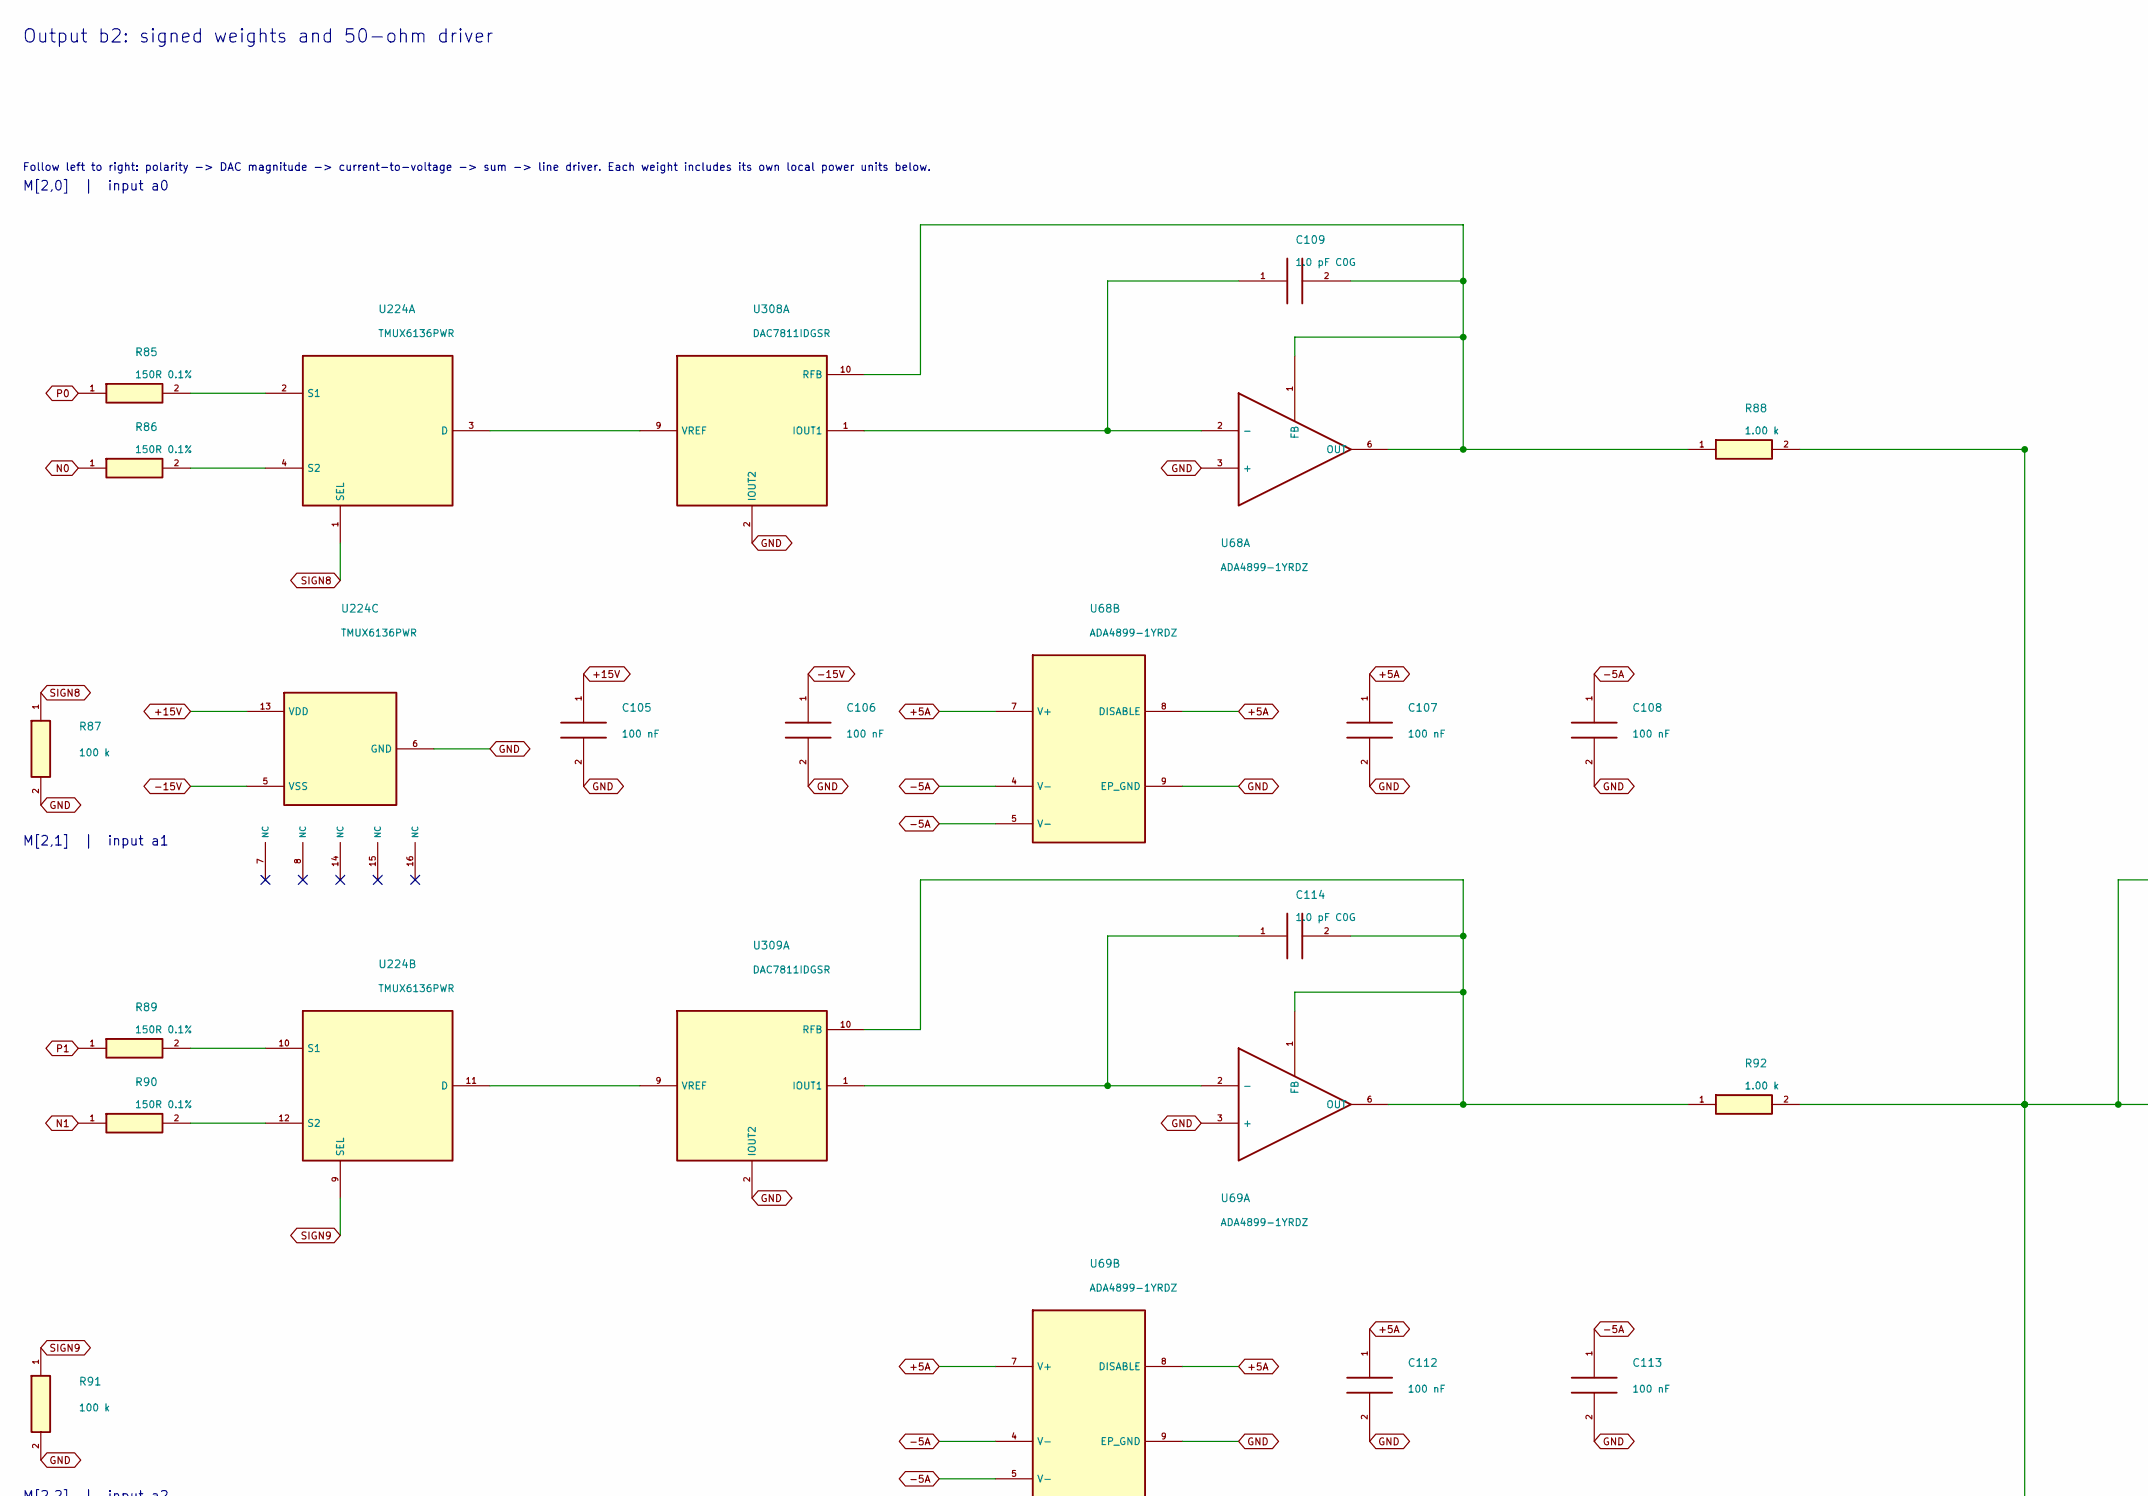
[picture p78: schematic row_2.kicad_sch, Output b2: signed weights and 50-ohm driver, part in row 1, column 1]

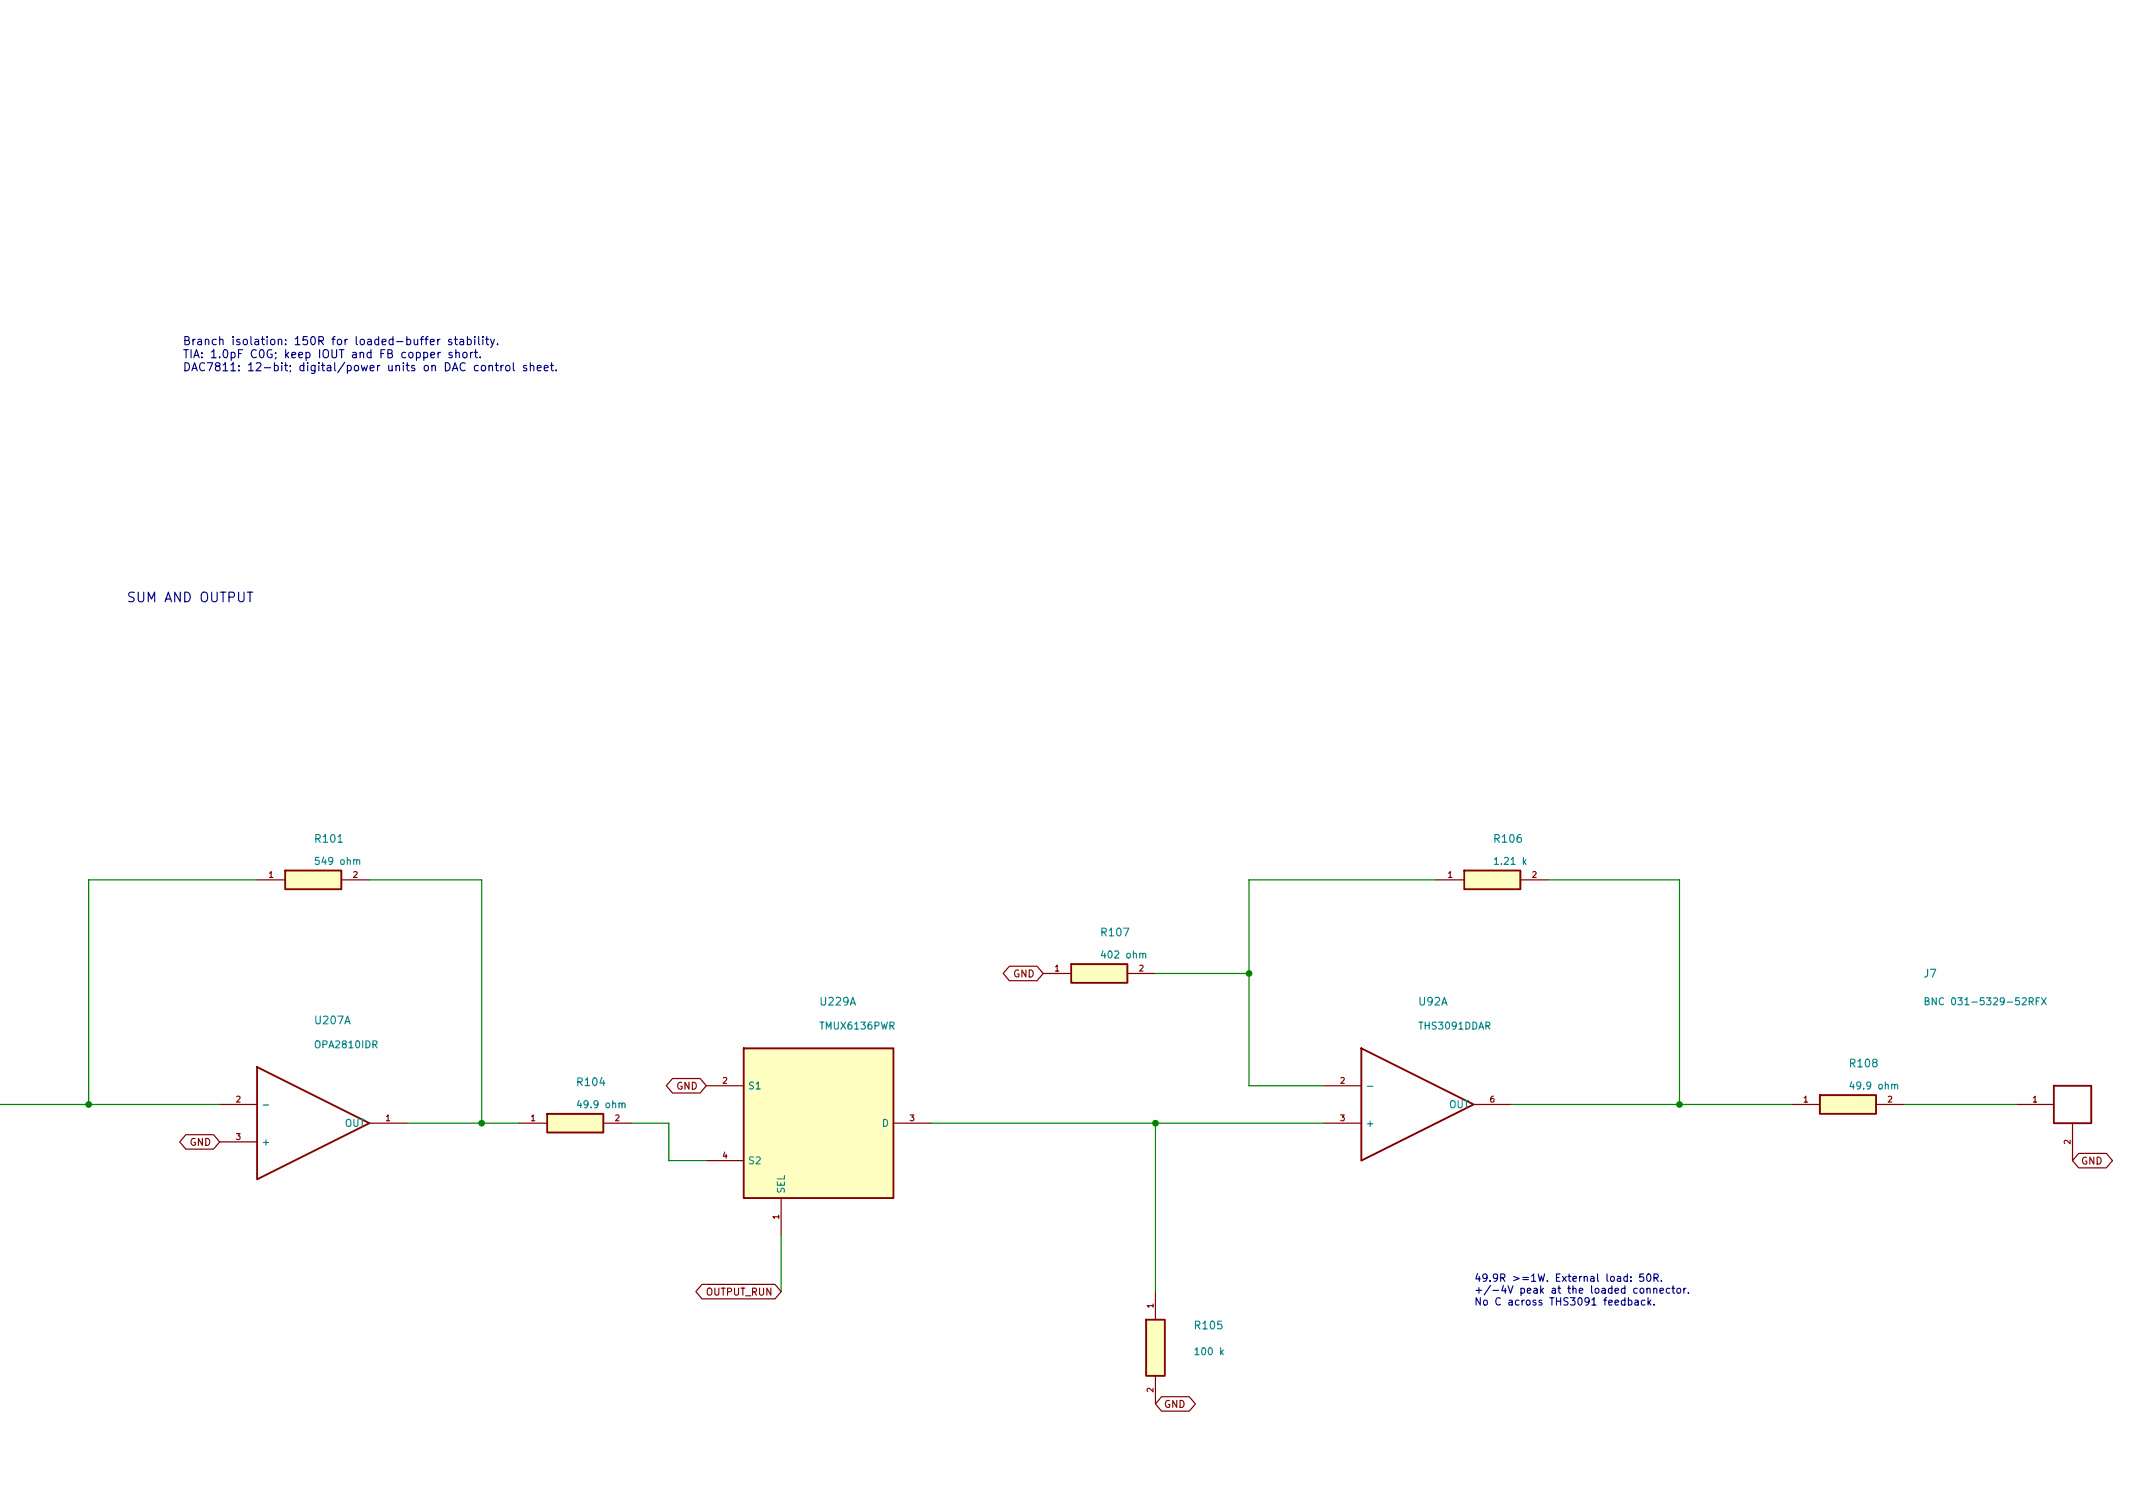
[picture p79: schematic row_2.kicad_sch, Output b2: signed weights and 50-ohm driver, part in row 1, column 2]

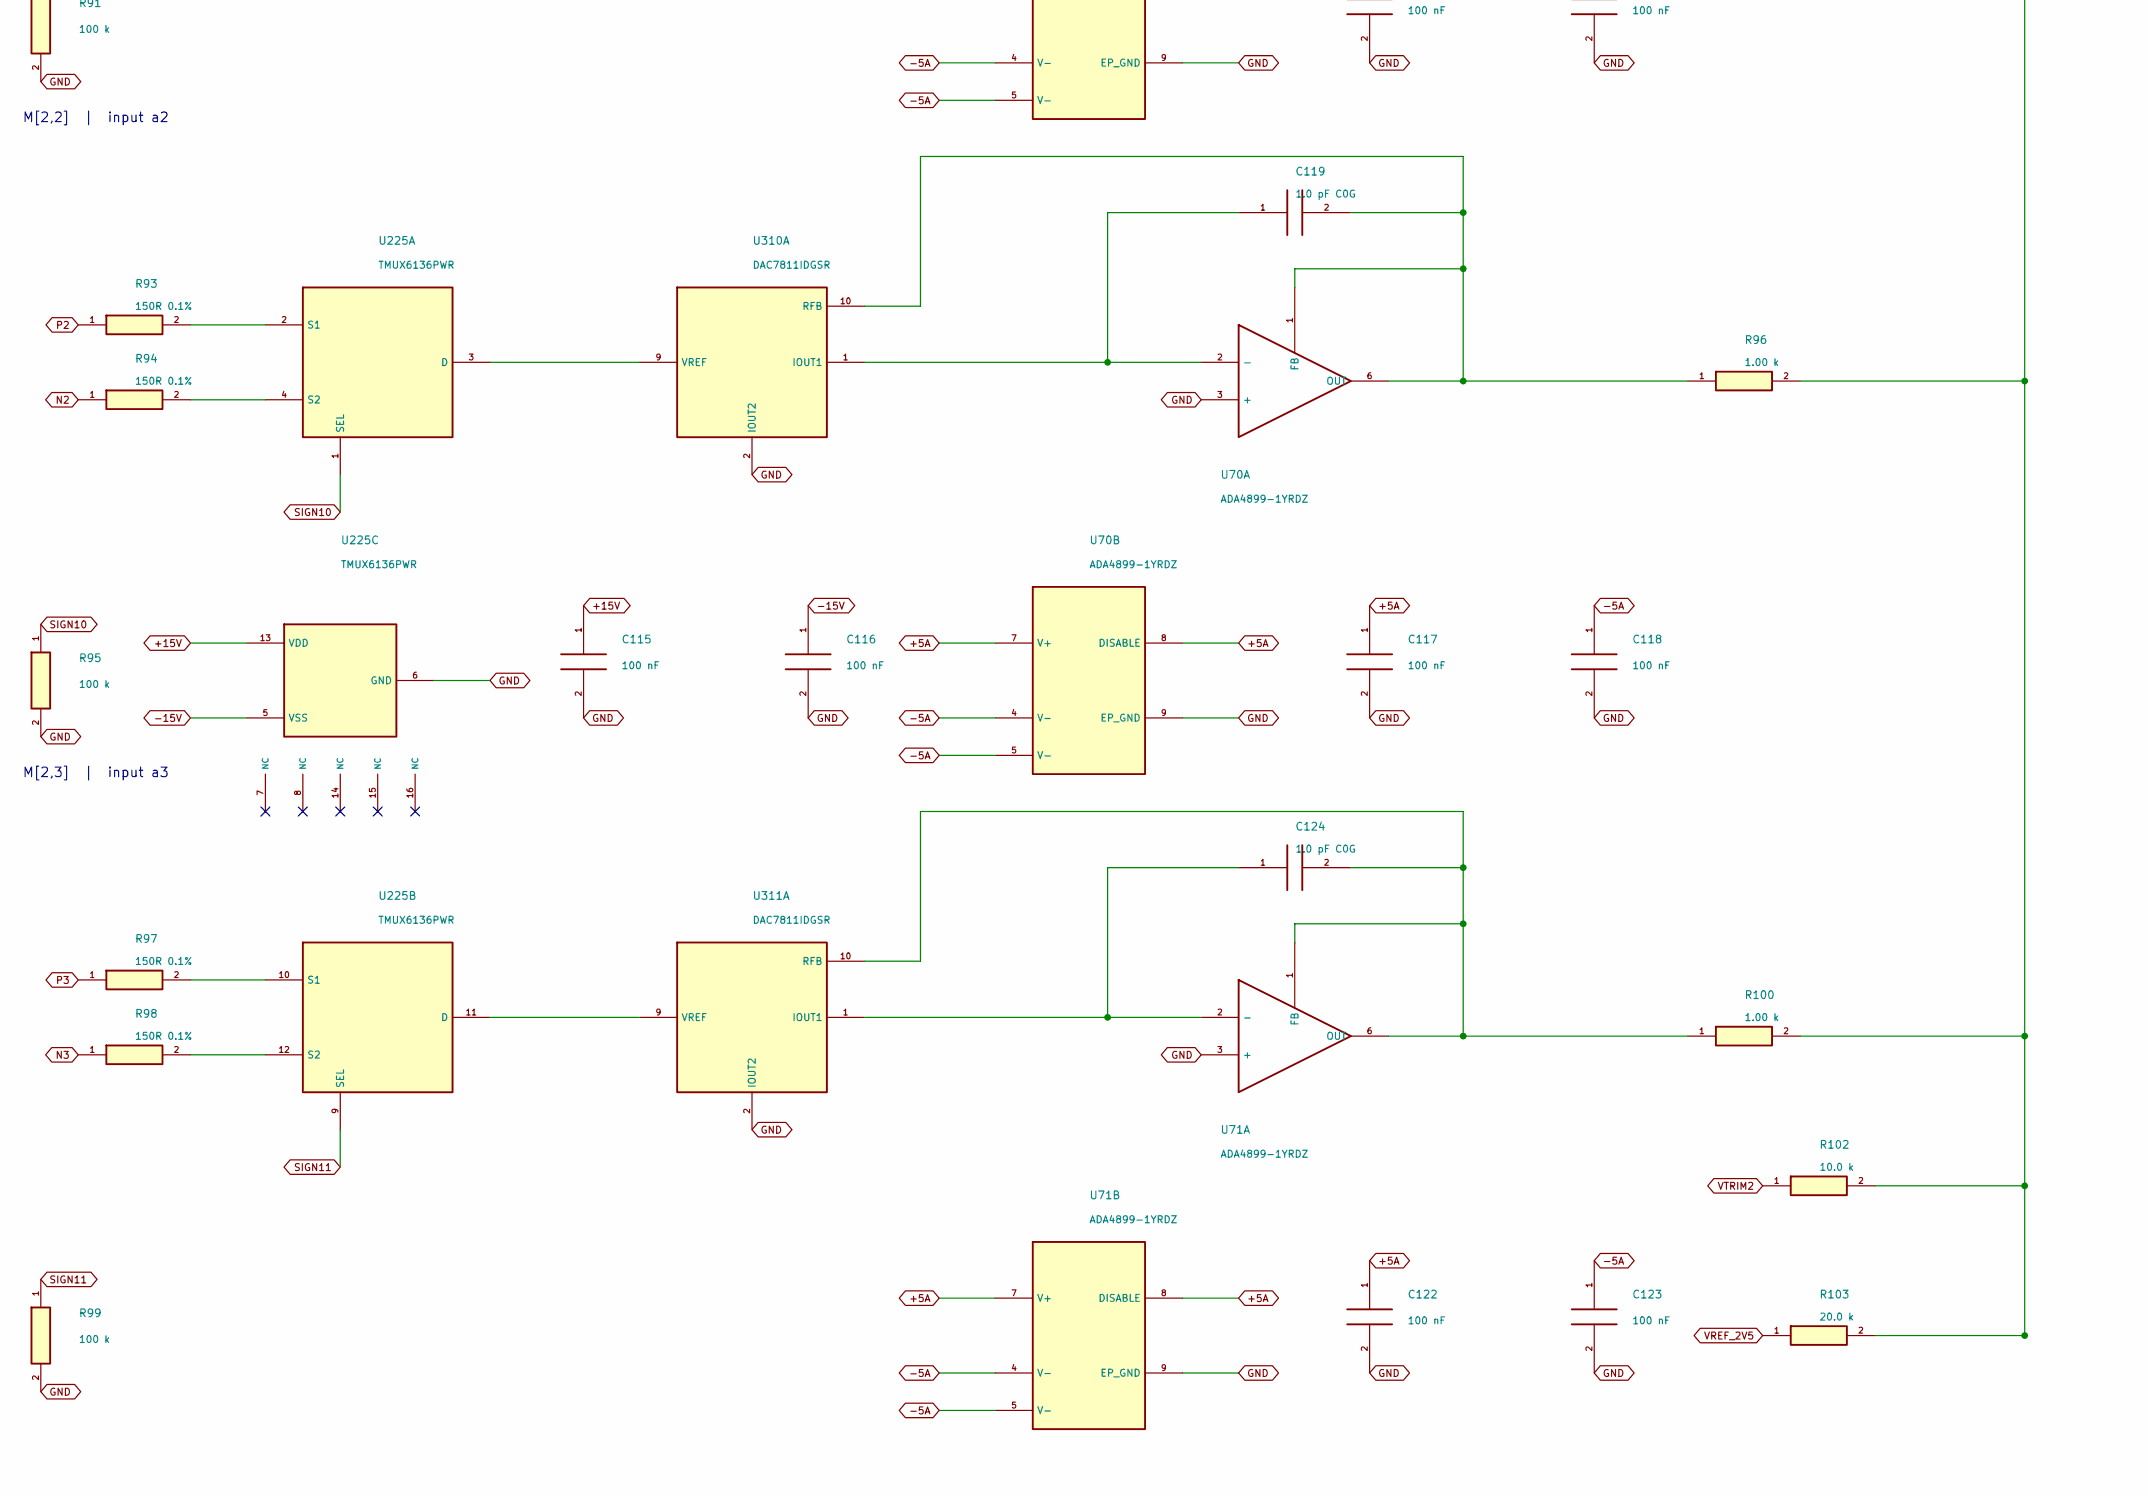
[picture p80: schematic row_2.kicad_sch, Output b2: signed weights and 50-ohm driver, part in row 2, column 1]

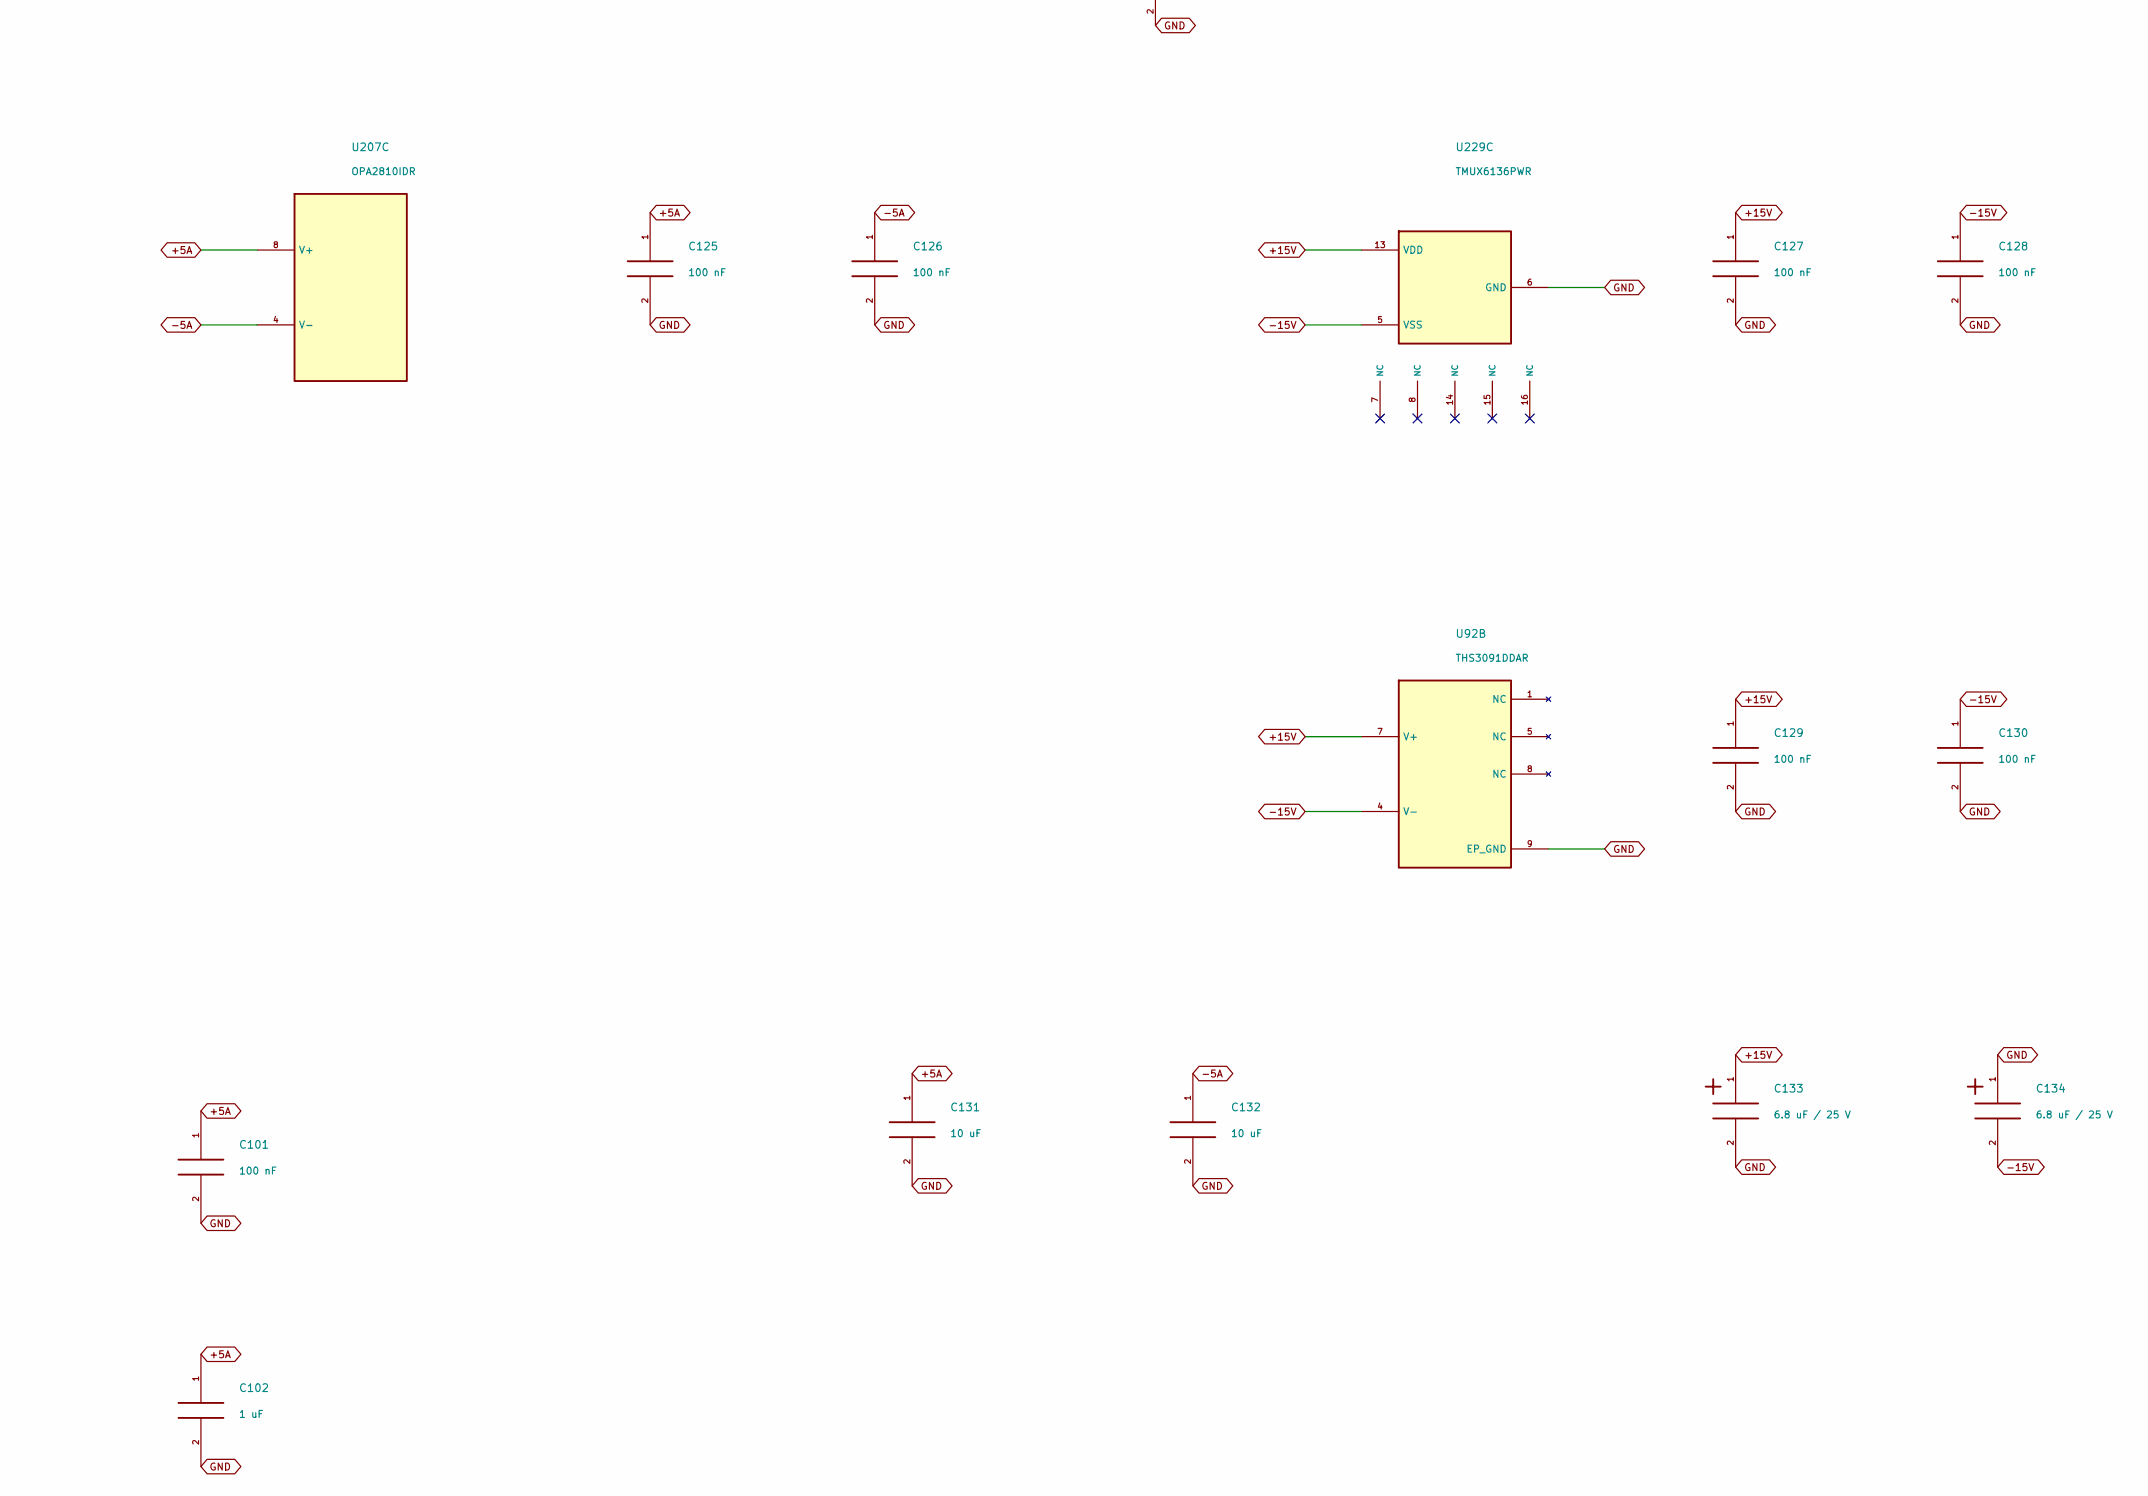
[picture p81: schematic row_2.kicad_sch, Output b2: signed weights and 50-ohm driver, part in row 2, column 2]

Parts:
C101, C105, C106, C107, C108, C112, C113, C115, C116, C117, C118, C122, C123, C125, C126, C127, C128, C129, C130: 100 nF; C_0603_1608Metric; Rating 25V X7R minimum; effective C after bias
C102: 1 uF; C_0805_2012Metric; Rating 25V X7R minimum; effective C after bias
C109, C114, C119, C124: 1.0 pF C0G; C_0402_1005Metric; Rating 50V C0G, +/-0.1pF; stray capacitance in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
C131, C132: 10 uF; C_0805_2012Metric; Rating 25V X7R minimum; effective C after bias
C133, C134: 6.8 uF / 25 V; CP_EIA-3216-18_Kemet-A; Rating 25V polarized
J7: BNC 031-5329-52RFX; BNC_Amphenol_031-5329-52RFX_Vertical
R85, R86, R89, R90, R93, R94, R97, R98: 150R 0.1%; R_0603_1608Metric; Rating 0.1%, <=25ppm/C; 0.1W minimum
R87, R91, R95, R99, R105: 100 k; R_0603_1608Metric; Rating 0.1%, <=25ppm/C; 0.1W minimum
R88, R92, R96, R100: 1.00 k; R_0603_1608Metric; Rating 0.1%, <=25ppm/C; 0.1W minimum
R101: 549 ohm; R_0603_1608Metric; Rating 0.1%, <=25ppm/C; 0.1W minimum
R102: 10.0 k; R_0603_1608Metric; Rating 0.1%, <=25ppm/C; 0.1W minimum
R103: 20.0 k; R_0603_1608Metric; Rating 0.1%, <=25ppm/C; 0.1W minimum
R104: 49.9 ohm; R_0603_1608Metric; Rating 0.1%, <=25ppm/C; 0.1W minimum
R106: 1.21 k; R_0603_1608Metric; Rating 0.1%, <=25ppm/C; 0.1W minimum
R107: 402 ohm; R_0603_1608Metric; Rating 0.1%, <=25ppm/C; 0.1W minimum
R108: 49.9 ohm; R_2512_6332Metric; Rating 0.1%, <=25ppm/C; >=1W
U68, U69, U70, U71: ADA4899-1YRDZ; ADA4899_RD8_EP2.29x2.29
U92: THS3091DDAR; SOIC-8-1EP_3.9x4.9mm_P1.27mm_EP2.95x4.9mm_Mask2.71x3.4mm_Th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
U207: OPA2810IDR; SOIC-8_3.9x4.9mm_P1.27mm
U224, U225, U229: TMUX6136PWR; TSSOP-16_4.4x5mm_P0.65mm
U308, U309, U310, U311: DAC7811IDGSR; VSSOP-10_3x3mm_P0.5mm

Connections:
+5A: C101.1, C102.1, C107.1, C112.1, C117.1, C122.1, C125.1, C131.1, U68.7 (V+), U68.8 (DISABLE), U69.7 (V+), U69.8 (DISABLE), U70.7 (V+), U70.8 (DISABLE), U71.7 (V+), U71.8 (DISABLE), U207.8 (V+); also elsewhere on the board
+15V: C105.1, C115.1, C127.1, C129.1, C133.1, U92.7 (V+), U224.13 (VDD), U225.13 (VDD), U229.13 (VDD); also elsewhere on the board
-5A: C108.1, C113.1, C118.1, C123.1, C126.1, C132.1, U68.4 (V-), U68.5 (V-), U69.4 (V-), U69.5 (V-), U70.4 (V-), U70.5 (V-), U71.4 (V-), U71.5 (V-), U207.4 (V-); also elsewhere on the board
-15V: C106.1, C116.1, C128.1, C130.1, C134.2, U92.4 (V-), U224.5 (VSS), U225.5 (VSS), U229.5 (VSS); also elsewhere on the board
GND: C101.2, C102.2, C105.2, C106.2, C107.2, C108.2, C112.2, C113.2, C115.2, C116.2, C117.2, C118.2, C122.2, C123.2, C125.2, C126.2, C127.2, C128.2, C129.2, C130.2, C131.2, C132.2, C133.2, C134.1, J7.2, R87.2, R91.2, R95.2, R99.2, R105.2, R107.1, U68.3 (+), U68.9 (EP_GND), U69.3 (+), U69.9 (EP_GND), U70.3 (+), U70.9 (EP_GND), U71.3 (+), U71.9 (EP_GND), U92.9 (EP_GND), U207.3 (+), U224.6 (GND), U225.6 (GND), U229.2 (S1), U229.6 (GND), U308.2 (IOUT2), U309.2 (IOUT2), U310.2 (IOUT2), U311.2 (IOUT2); also elsewhere on the board
N0: R86.1; also elsewhere on the board
N1: R90.1; also elsewhere on the board
N2: R94.1; also elsewhere on the board
N3: R98.1; also elsewhere on the board
unnamed: J7.1, R108.2
unnamed: R106.1, R107.2, U92.2 (-)
unnamed: R106.2, R108.1, U92.6 (OUT)
unnamed: R88.2, R92.2, R96.2, R100.2, R101.1, R102.2, R103.2, U207.2 (-)
unnamed: R101.2, R104.1, U207.1 (OUT)
unnamed: U224.3 (D), U308.9 (VREF)
unnamed: R85.2, U224.2 (S1)
unnamed: R86.2, U224.4 (S2)
unnamed: U224.11 (D), U309.9 (VREF)
unnamed: R89.2, U224.10 (S1)
unnamed: R90.2, U224.12 (S2)
unnamed: U225.3 (D), U310.9 (VREF)
unnamed: R93.2, U225.2 (S1)
unnamed: R94.2, U225.4 (S2)
unnamed: U225.11 (D), U311.9 (VREF)
unnamed: R97.2, U225.10 (S1)
unnamed: R98.2, U225.12 (S2)
unnamed: R105.1, U92.3 (+), U229.3 (D)
unnamed: R104.2, U229.4 (S2)
unnamed: C109.1, U68.2 (-), U308.1 (IOUT1)
unnamed: C109.2, R88.1, U68.1 (FB), U68.6 (OUT), U308.10 (RFB)
unnamed: C114.1, U69.2 (-), U309.1 (IOUT1)
unnamed: C114.2, R92.1, U69.1 (FB), U69.6 (OUT), U309.10 (RFB)
unnamed: C119.1, U70.2 (-), U310.1 (IOUT1)
unnamed: C119.2, R96.1, U70.1 (FB), U70.6 (OUT), U310.10 (RFB)
unnamed: C124.1, U71.2 (-), U311.1 (IOUT1)
unnamed: C124.2, R100.1, U71.1 (FB), U71.6 (OUT), U311.10 (RFB)
OUTPUT_RUN: U229.1 (SEL); also elsewhere on the board
P0: R85.1; also elsewhere on the board
P1: R89.1; also elsewhere on the board
P2: R93.1; also elsewhere on the board
P3: R97.1; also elsewhere on the board
SIGN8: R87.1, U224.1 (SEL); also elsewhere on the board
SIGN9: R91.1, U224.9 (SEL); also elsewhere on the board
SIGN10: R95.1, U225.1 (SEL); also elsewhere on the board
SIGN11: R99.1, U225.9 (SEL); also elsewhere on the board
VREF_2V5: R103.1; also elsewhere on the board
VTRIM2: R102.1; also elsewhere on the board

Notes on the sheet:
Output b2: signed weights and 50-ohm driver
Follow left to right: polarity -> DAC magnitude -> current-to-voltage -> sum -> line driver. Each weight includes its own local power units below.
M[2,0] | input a0
M[2,1] | input a1
M[2,2] | input a2
M[2,3] | input a3
SUM AND OUTPUT
49.9R >=1W. External load: 50R. +/-4V peak at the loaded connector. No C across THS3091 feedback.
Branch isolation: 150R for loaded-buffer stability. TIA: 1.0pF C0G; keep IOUT and FB copper short. DAC7811: 12-bit; digital/power units on DAC control sheet.
