tim4431/analog_programmable_matrix/variants/lc1/hardware/analog_matrix_lc1.kicad_pcb

## KiCad design variants/lc1/hardware/analog_matrix_lc1.kicad_pcb (continued)

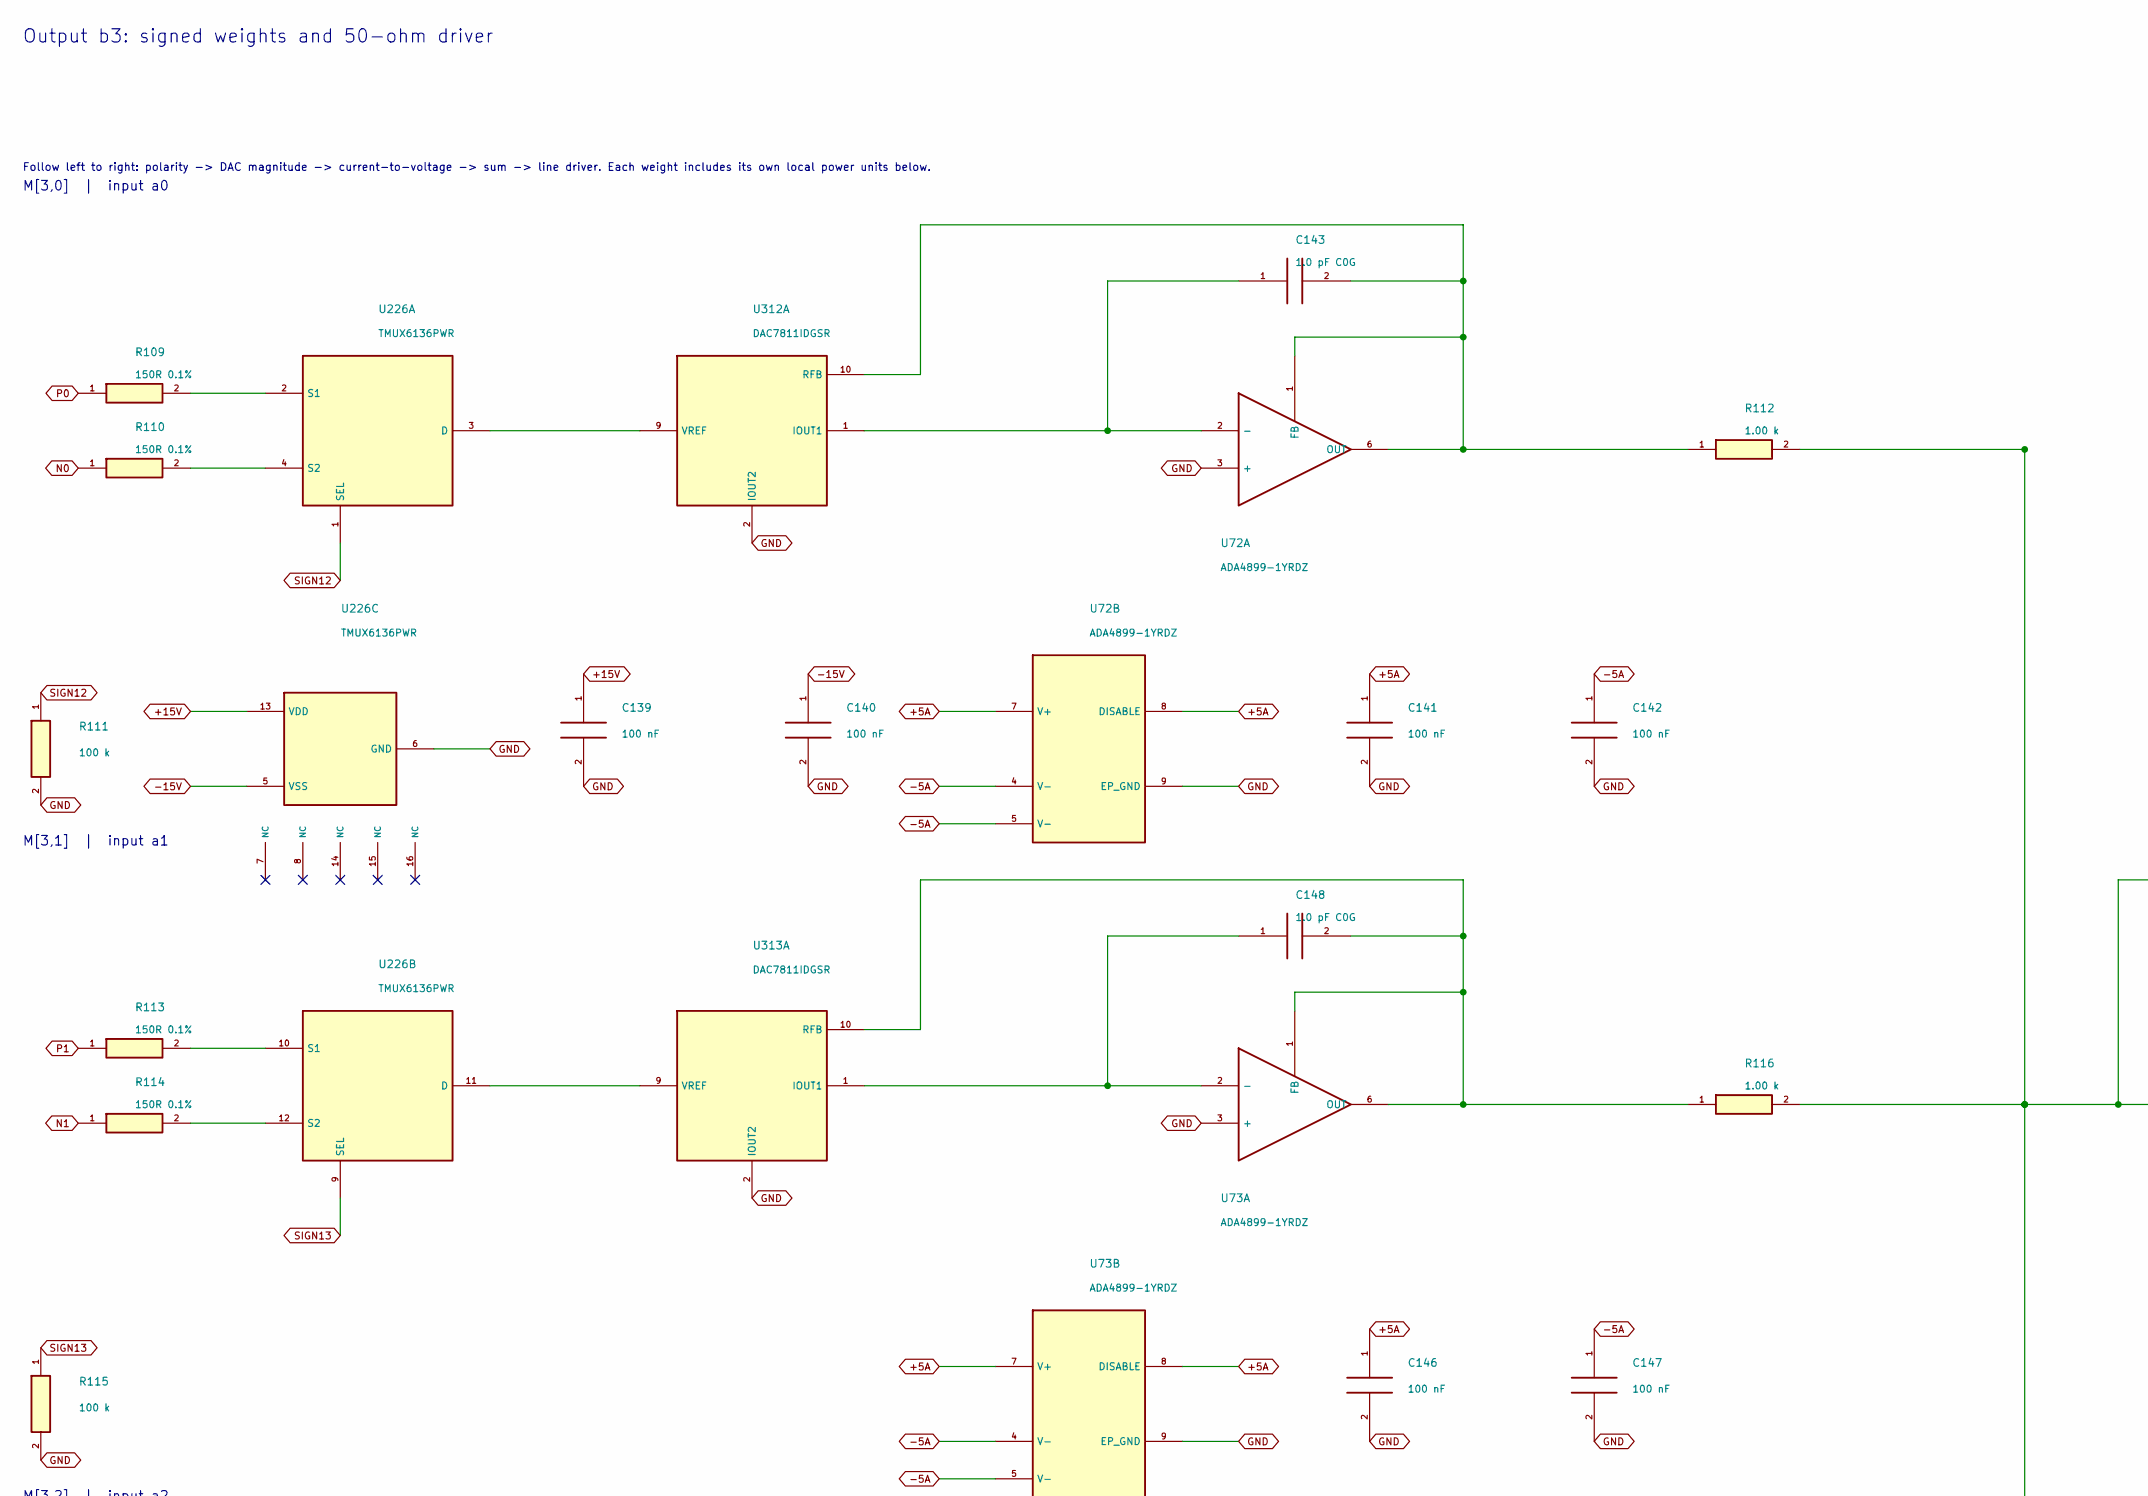
[picture p82: schematic row_3.kicad_sch, Output b3: signed weights and 50-ohm driver, part in row 1, column 1]

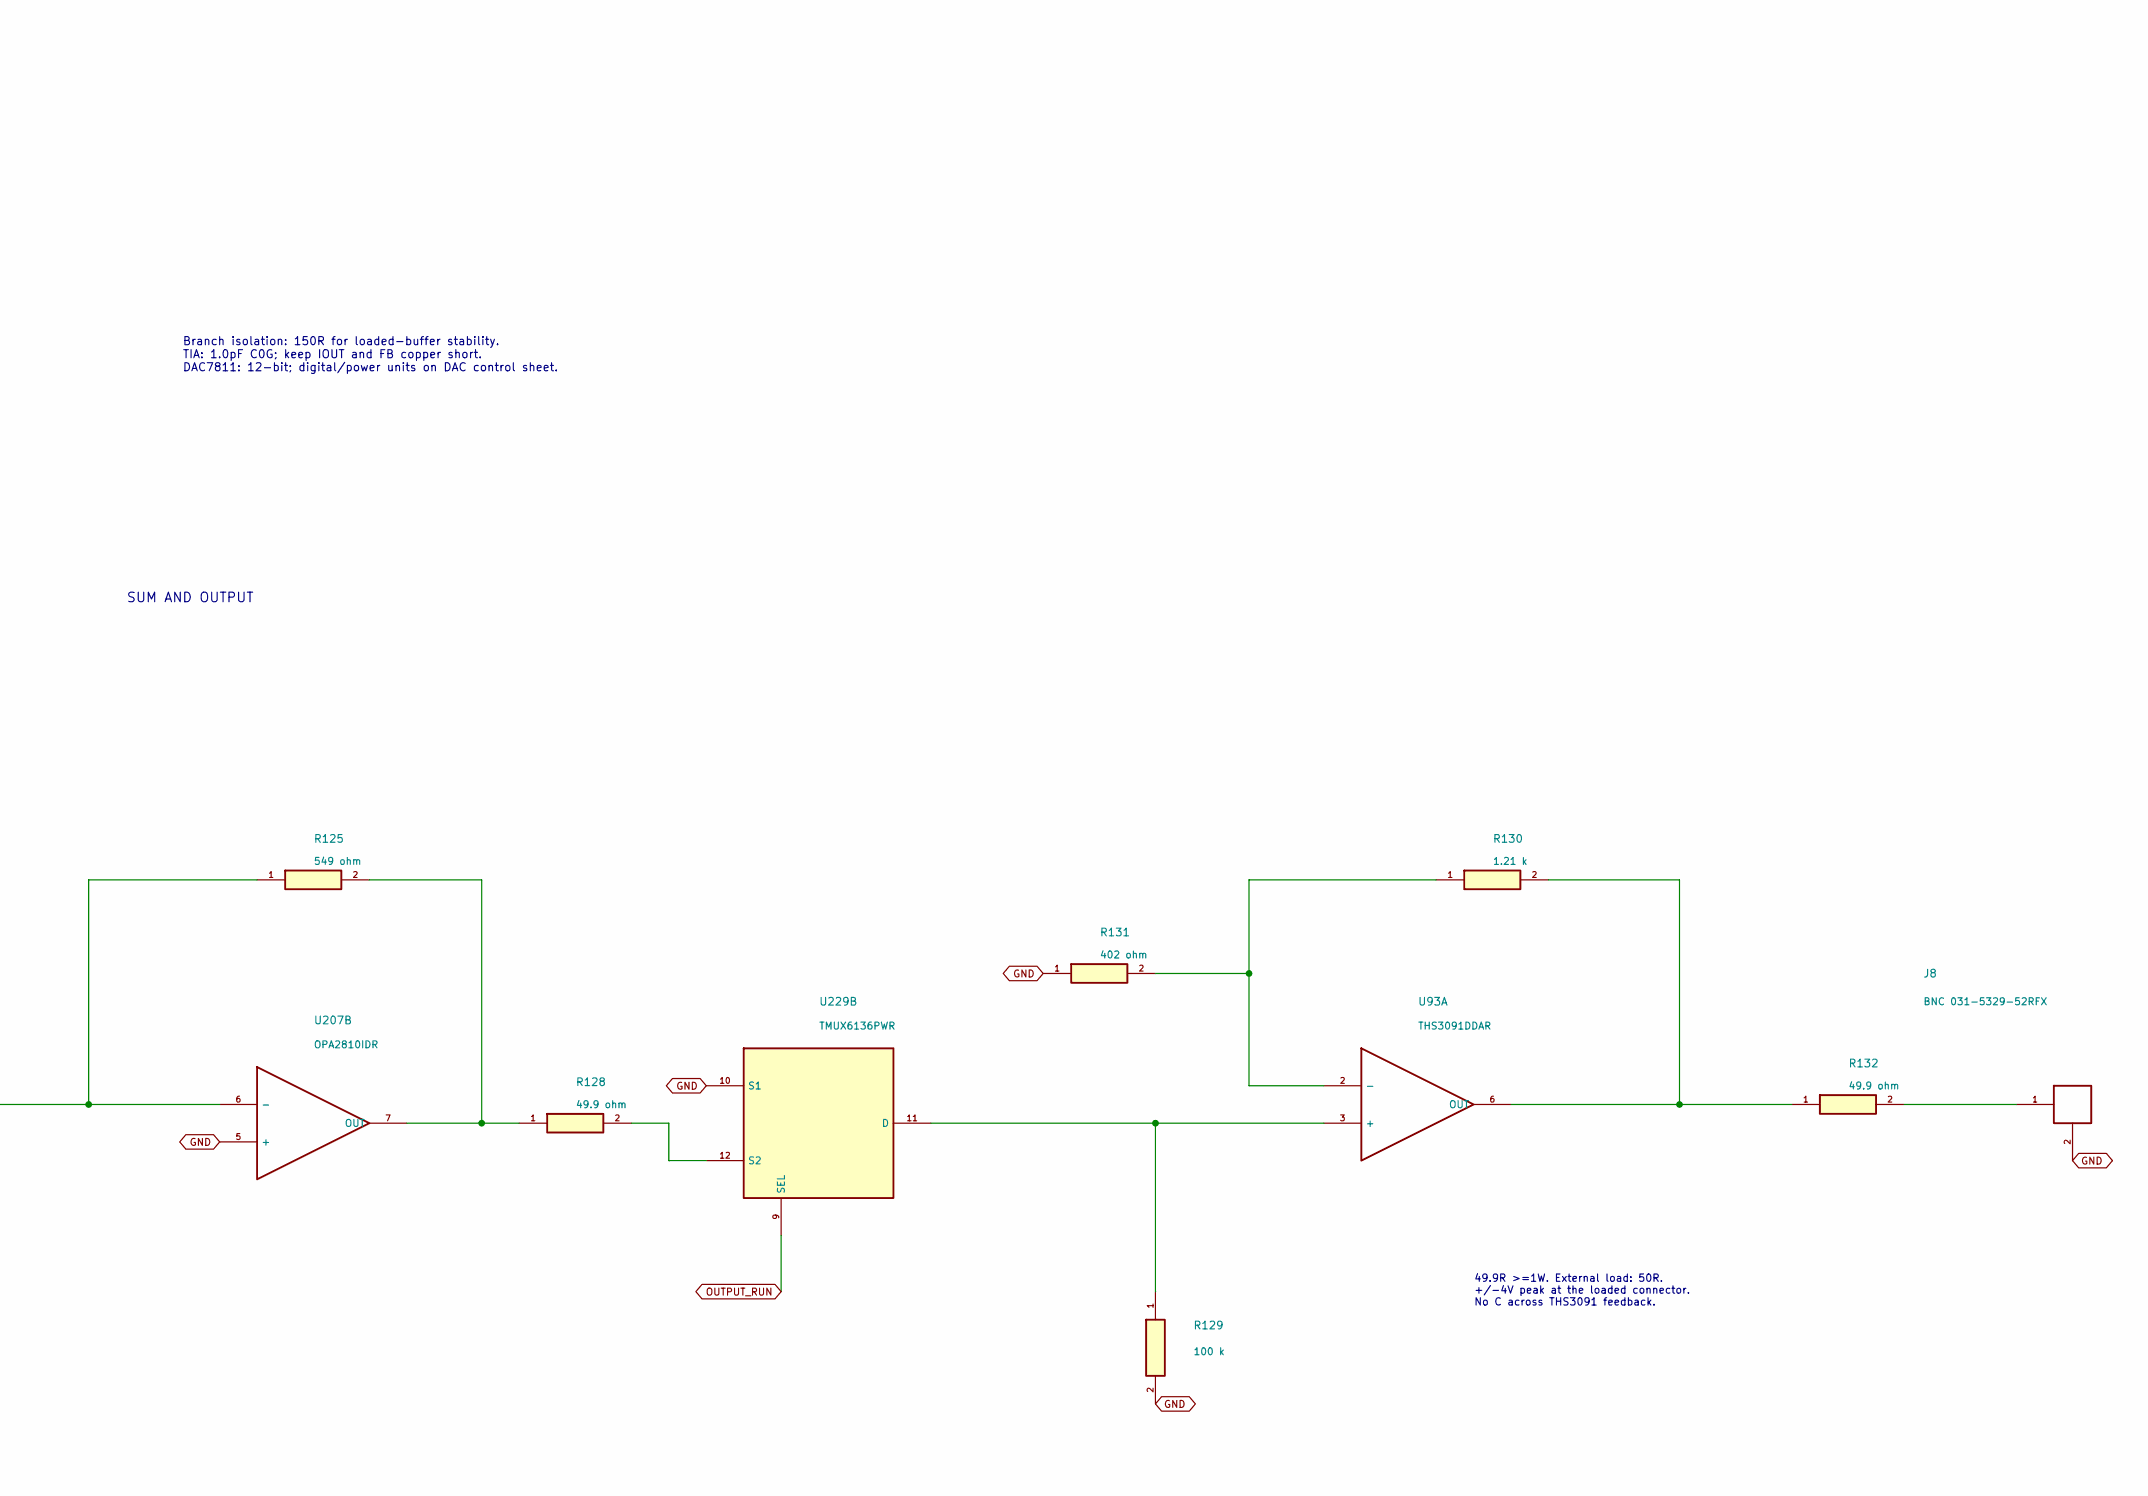
[picture p83: schematic row_3.kicad_sch, Output b3: signed weights and 50-ohm driver, part in row 1, column 2]

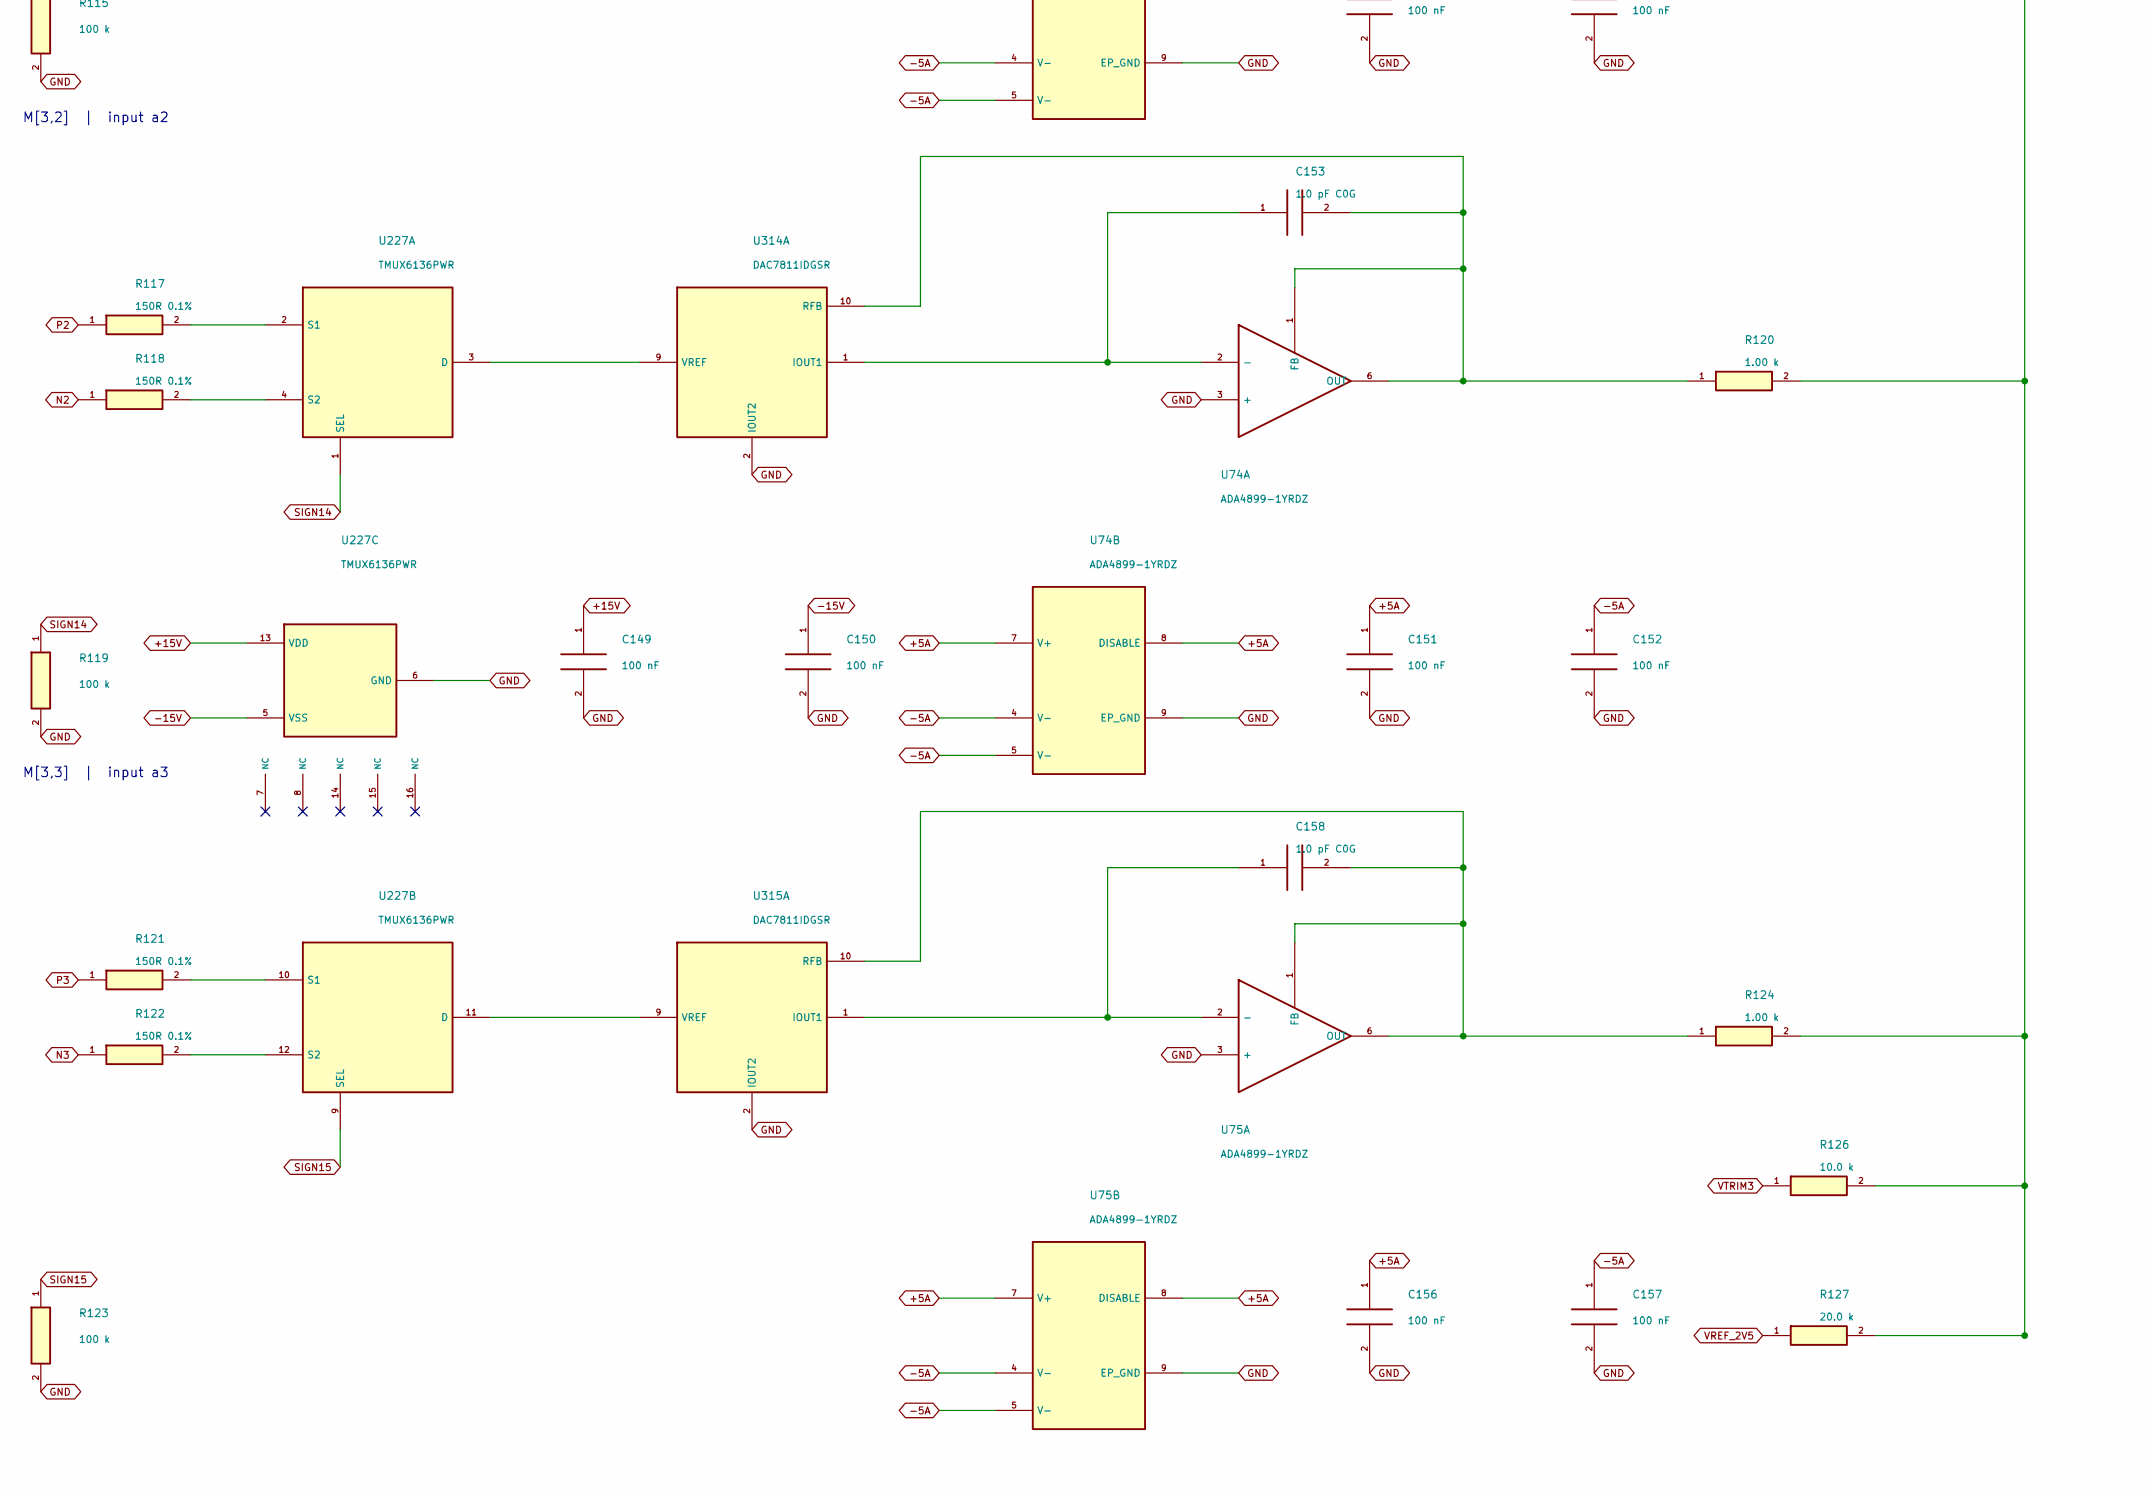
[picture p84: schematic row_3.kicad_sch, Output b3: signed weights and 50-ohm driver, part in row 2, column 1]

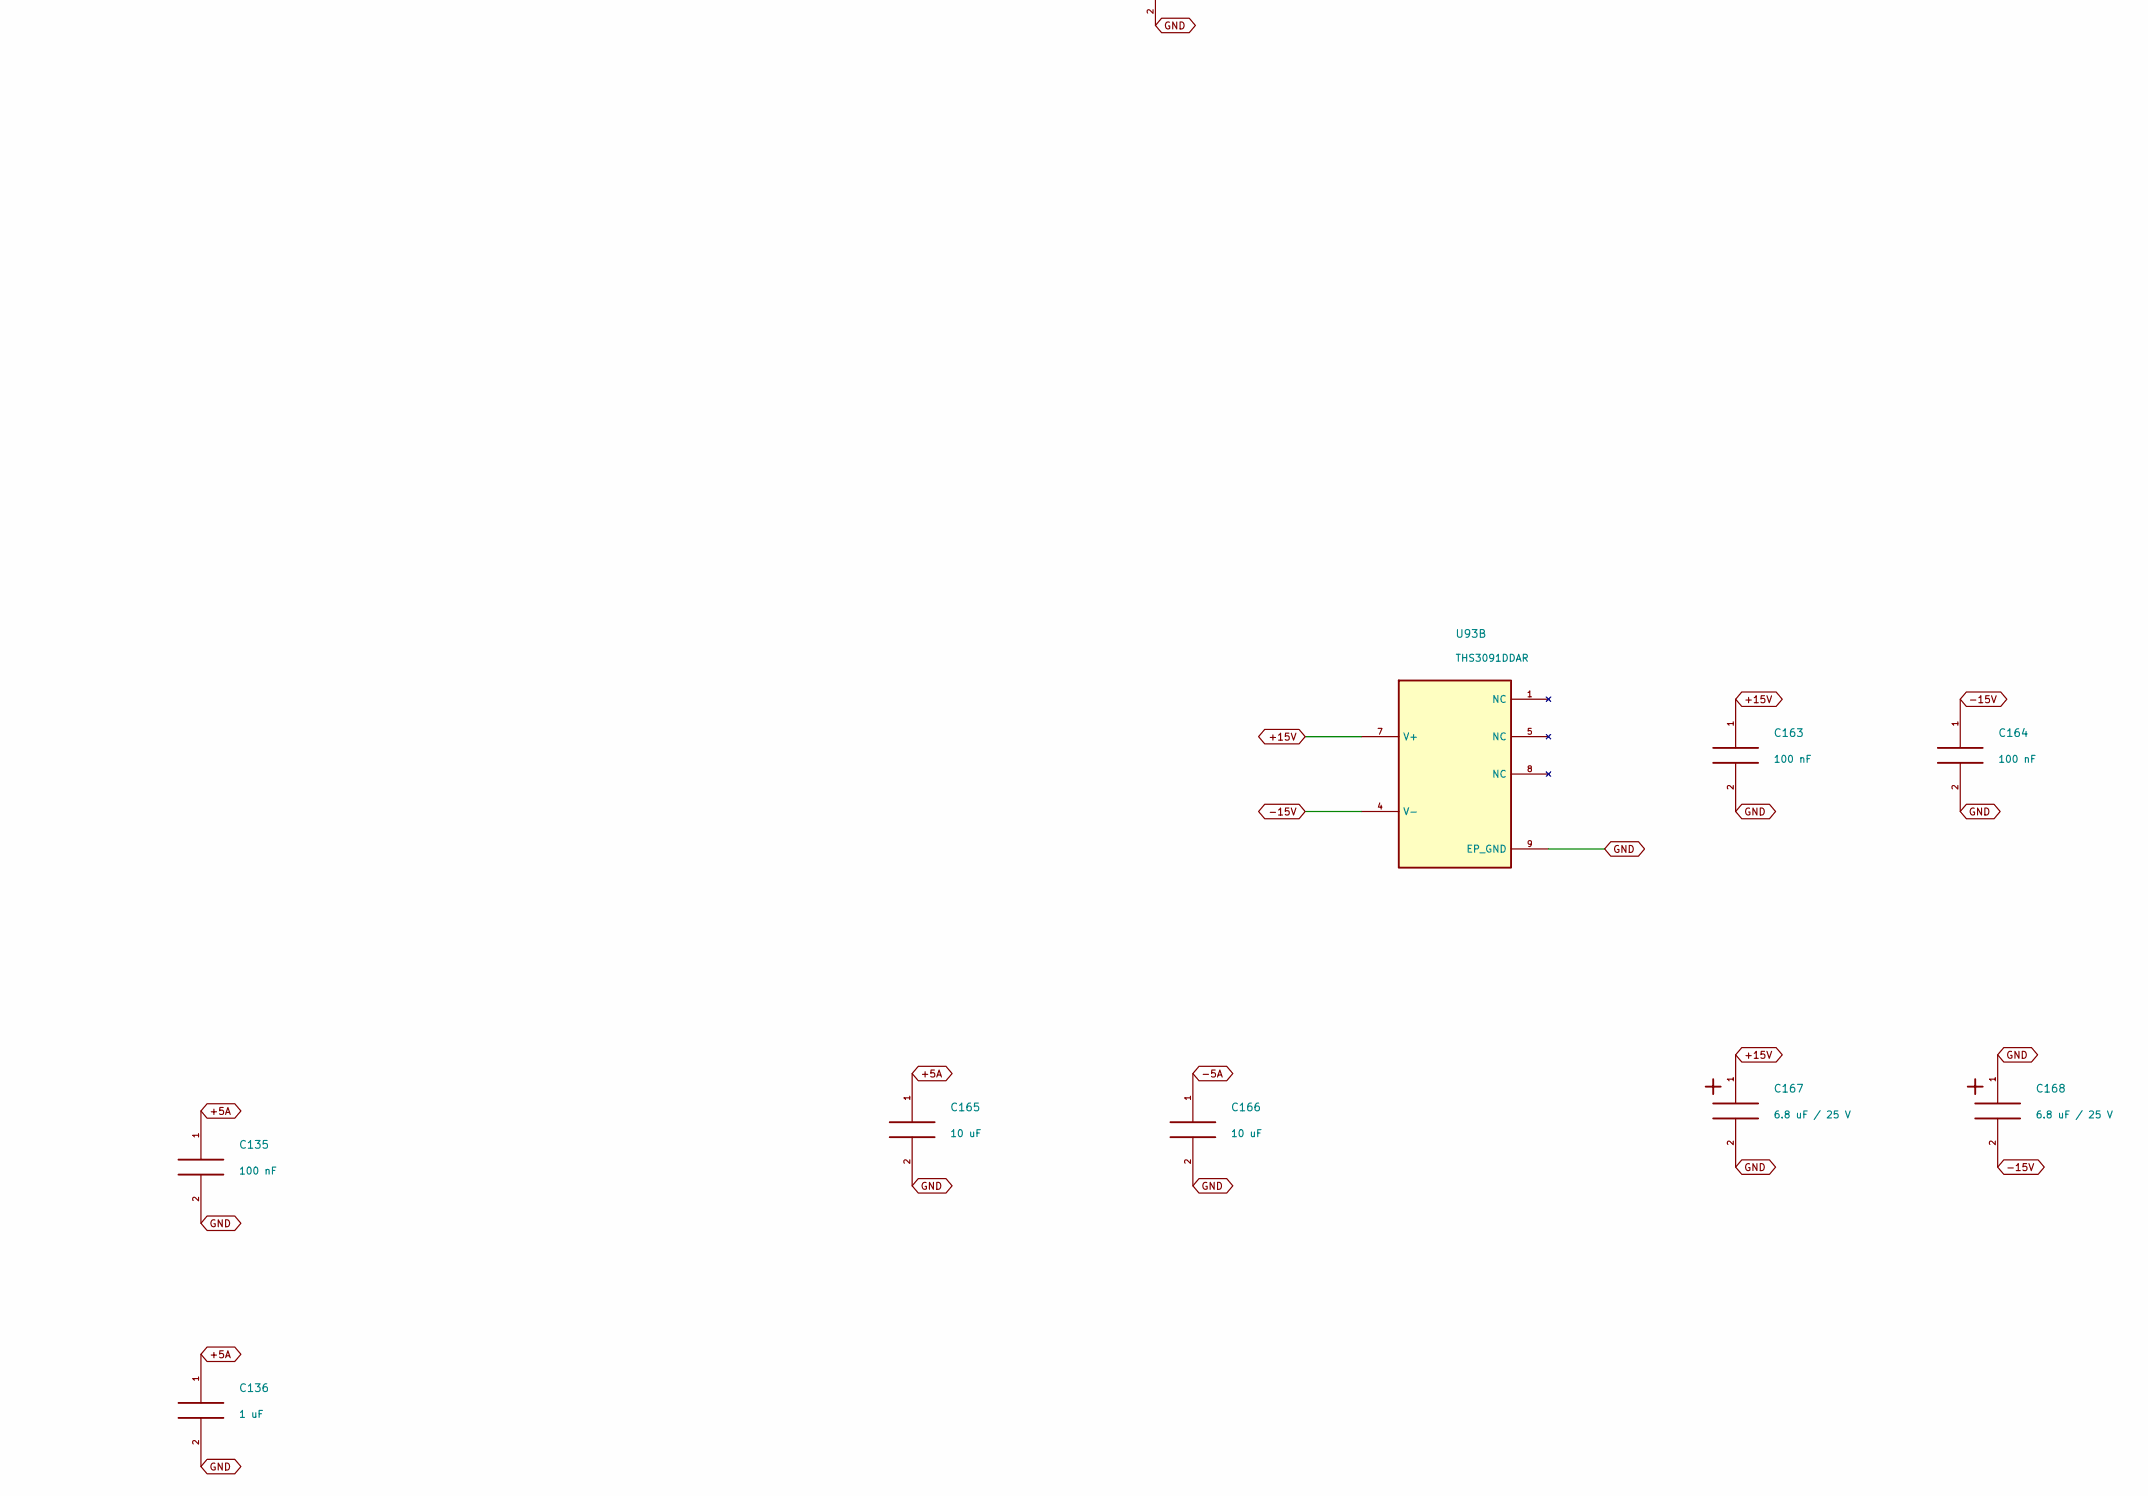
[picture p85: schematic row_3.kicad_sch, Output b3: signed weights and 50-ohm driver, part in row 2, column 2]

Parts:
C135, C139, C140, C141, C142, C146, C147, C149, C150, C151, C152, C156, C157, C163, C164: 100 nF; C_0603_1608Metric; Rating 25V X7R minimum; effective C after bias
C136: 1 uF; C_0805_2012Metric; Rating 25V X7R minimum; effective C after bias
C143, C148, C153, C158: 1.0 pF C0G; C_0402_1005Metric; Rating 50V C0G, +/-0.1pF; stray capacitance in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
C165, C166: 10 uF; C_0805_2012Metric; Rating 25V X7R minimum; effective C after bias
C167, C168: 6.8 uF / 25 V; CP_EIA-3216-18_Kemet-A; Rating 25V polarized
J8: BNC 031-5329-52RFX; BNC_Amphenol_031-5329-52RFX_Vertical
R109, R110, R113, R114, R117, R118, R121, R122: 150R 0.1%; R_0603_1608Metric; Rating 0.1%, <=25ppm/C; 0.1W minimum
R111, R115, R119, R123, R129: 100 k; R_0603_1608Metric; Rating 0.1%, <=25ppm/C; 0.1W minimum
R112, R116, R120, R124: 1.00 k; R_0603_1608Metric; Rating 0.1%, <=25ppm/C; 0.1W minimum
R125: 549 ohm; R_0603_1608Metric; Rating 0.1%, <=25ppm/C; 0.1W minimum
R126: 10.0 k; R_0603_1608Metric; Rating 0.1%, <=25ppm/C; 0.1W minimum
R127: 20.0 k; R_0603_1608Metric; Rating 0.1%, <=25ppm/C; 0.1W minimum
R128: 49.9 ohm; R_0603_1608Metric; Rating 0.1%, <=25ppm/C; 0.1W minimum
R130: 1.21 k; R_0603_1608Metric; Rating 0.1%, <=25ppm/C; 0.1W minimum
R131: 402 ohm; R_0603_1608Metric; Rating 0.1%, <=25ppm/C; 0.1W minimum
R132: 49.9 ohm; R_2512_6332Metric; Rating 0.1%, <=25ppm/C; >=1W
U72, U73, U74, U75: ADA4899-1YRDZ; ADA4899_RD8_EP2.29x2.29
U93: THS3091DDAR; SOIC-8-1EP_3.9x4.9mm_P1.27mm_EP2.95x4.9mm_Mask2.71x3.4mm_Th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
U207: OPA2810IDR; SOIC-8_3.9x4.9mm_P1.27mm
U226, U227, U229: TMUX6136PWR; TSSOP-16_4.4x5mm_P0.65mm
U312, U313, U314, U315: DAC7811IDGSR; VSSOP-10_3x3mm_P0.5mm

Connections:
+5A: C135.1, C136.1, C141.1, C146.1, C151.1, C156.1, C165.1, U72.7 (V+), U72.8 (DISABLE), U73.7 (V+), U73.8 (DISABLE), U74.7 (V+), U74.8 (DISABLE), U75.7 (V+), U75.8 (DISABLE); also elsewhere on the board
+15V: C139.1, C149.1, C163.1, C167.1, U93.7 (V+), U226.13 (VDD), U227.13 (VDD); also elsewhere on the board
-5A: C142.1, C147.1, C152.1, C157.1, C166.1, U72.4 (V-), U72.5 (V-), U73.4 (V-), U73.5 (V-), U74.4 (V-), U74.5 (V-), U75.4 (V-), U75.5 (V-); also elsewhere on the board
-15V: C140.1, C150.1, C164.1, C168.2, U93.4 (V-), U226.5 (VSS), U227.5 (VSS); also elsewhere on the board
GND: C135.2, C136.2, C139.2, C140.2, C141.2, C142.2, C146.2, C147.2, C149.2, C150.2, C151.2, C152.2, C156.2, C157.2, C163.2, C164.2, C165.2, C166.2, C167.2, C168.1, J8.2, R111.2, R115.2, R119.2, R123.2, R129.2, R131.1, U72.3 (+), U72.9 (EP_GND), U73.3 (+), U73.9 (EP_GND), U74.3 (+), U74.9 (EP_GND), U75.3 (+), U75.9 (EP_GND), U93.9 (EP_GND), U207.5 (+), U226.6 (GND), U227.6 (GND), U229.10 (S1), U312.2 (IOUT2), U313.2 (IOUT2), U314.2 (IOUT2), U315.2 (IOUT2); also elsewhere on the board
N0: R110.1; also elsewhere on the board
N1: R114.1; also elsewhere on the board
N2: R118.1; also elsewhere on the board
N3: R122.1; also elsewhere on the board
unnamed: J8.1, R132.2
unnamed: R130.1, R131.2, U93.2 (-)
unnamed: R130.2, R132.1, U93.6 (OUT)
unnamed: R112.2, R116.2, R120.2, R124.2, R125.1, R126.2, R127.2, U207.6 (-)
unnamed: R125.2, R128.1, U207.7 (OUT)
unnamed: U226.3 (D), U312.9 (VREF)
unnamed: R109.2, U226.2 (S1)
unnamed: R110.2, U226.4 (S2)
unnamed: U226.11 (D), U313.9 (VREF)
unnamed: R113.2, U226.10 (S1)
unnamed: R114.2, U226.12 (S2)
unnamed: U227.3 (D), U314.9 (VREF)
unnamed: R117.2, U227.2 (S1)
unnamed: R118.2, U227.4 (S2)
unnamed: U227.11 (D), U315.9 (VREF)
unnamed: R121.2, U227.10 (S1)
unnamed: R122.2, U227.12 (S2)
unnamed: R129.1, U93.3 (+), U229.11 (D)
unnamed: R128.2, U229.12 (S2)
unnamed: C143.1, U72.2 (-), U312.1 (IOUT1)
unnamed: C143.2, R112.1, U72.1 (FB), U72.6 (OUT), U312.10 (RFB)
unnamed: C148.1, U73.2 (-), U313.1 (IOUT1)
unnamed: C148.2, R116.1, U73.1 (FB), U73.6 (OUT), U313.10 (RFB)
unnamed: C153.1, U74.2 (-), U314.1 (IOUT1)
unnamed: C153.2, R120.1, U74.1 (FB), U74.6 (OUT), U314.10 (RFB)
unnamed: C158.1, U75.2 (-), U315.1 (IOUT1)
unnamed: C158.2, R124.1, U75.1 (FB), U75.6 (OUT), U315.10 (RFB)
OUTPUT_RUN: U229.9 (SEL); also elsewhere on the board
P0: R109.1; also elsewhere on the board
P1: R113.1; also elsewhere on the board
P2: R117.1; also elsewhere on the board
P3: R121.1; also elsewhere on the board
SIGN12: R111.1, U226.1 (SEL); also elsewhere on the board
SIGN13: R115.1, U226.9 (SEL); also elsewhere on the board
SIGN14: R119.1, U227.1 (SEL); also elsewhere on the board
SIGN15: R123.1, U227.9 (SEL); also elsewhere on the board
VREF_2V5: R127.1; also elsewhere on the board
VTRIM3: R126.1; also elsewhere on the board

Notes on the sheet:
Output b3: signed weights and 50-ohm driver
Follow left to right: polarity -> DAC magnitude -> current-to-voltage -> sum -> line driver. Each weight includes its own local power units below.
M[3,0] | input a0
M[3,1] | input a1
M[3,2] | input a2
M[3,3] | input a3
SUM AND OUTPUT
49.9R >=1W. External load: 50R. +/-4V peak at the loaded connector. No C across THS3091 feedback.
Branch isolation: 150R for loaded-buffer stability. TIA: 1.0pF C0G; keep IOUT and FB copper short. DAC7811: 12-bit; digital/power units on DAC control sheet.

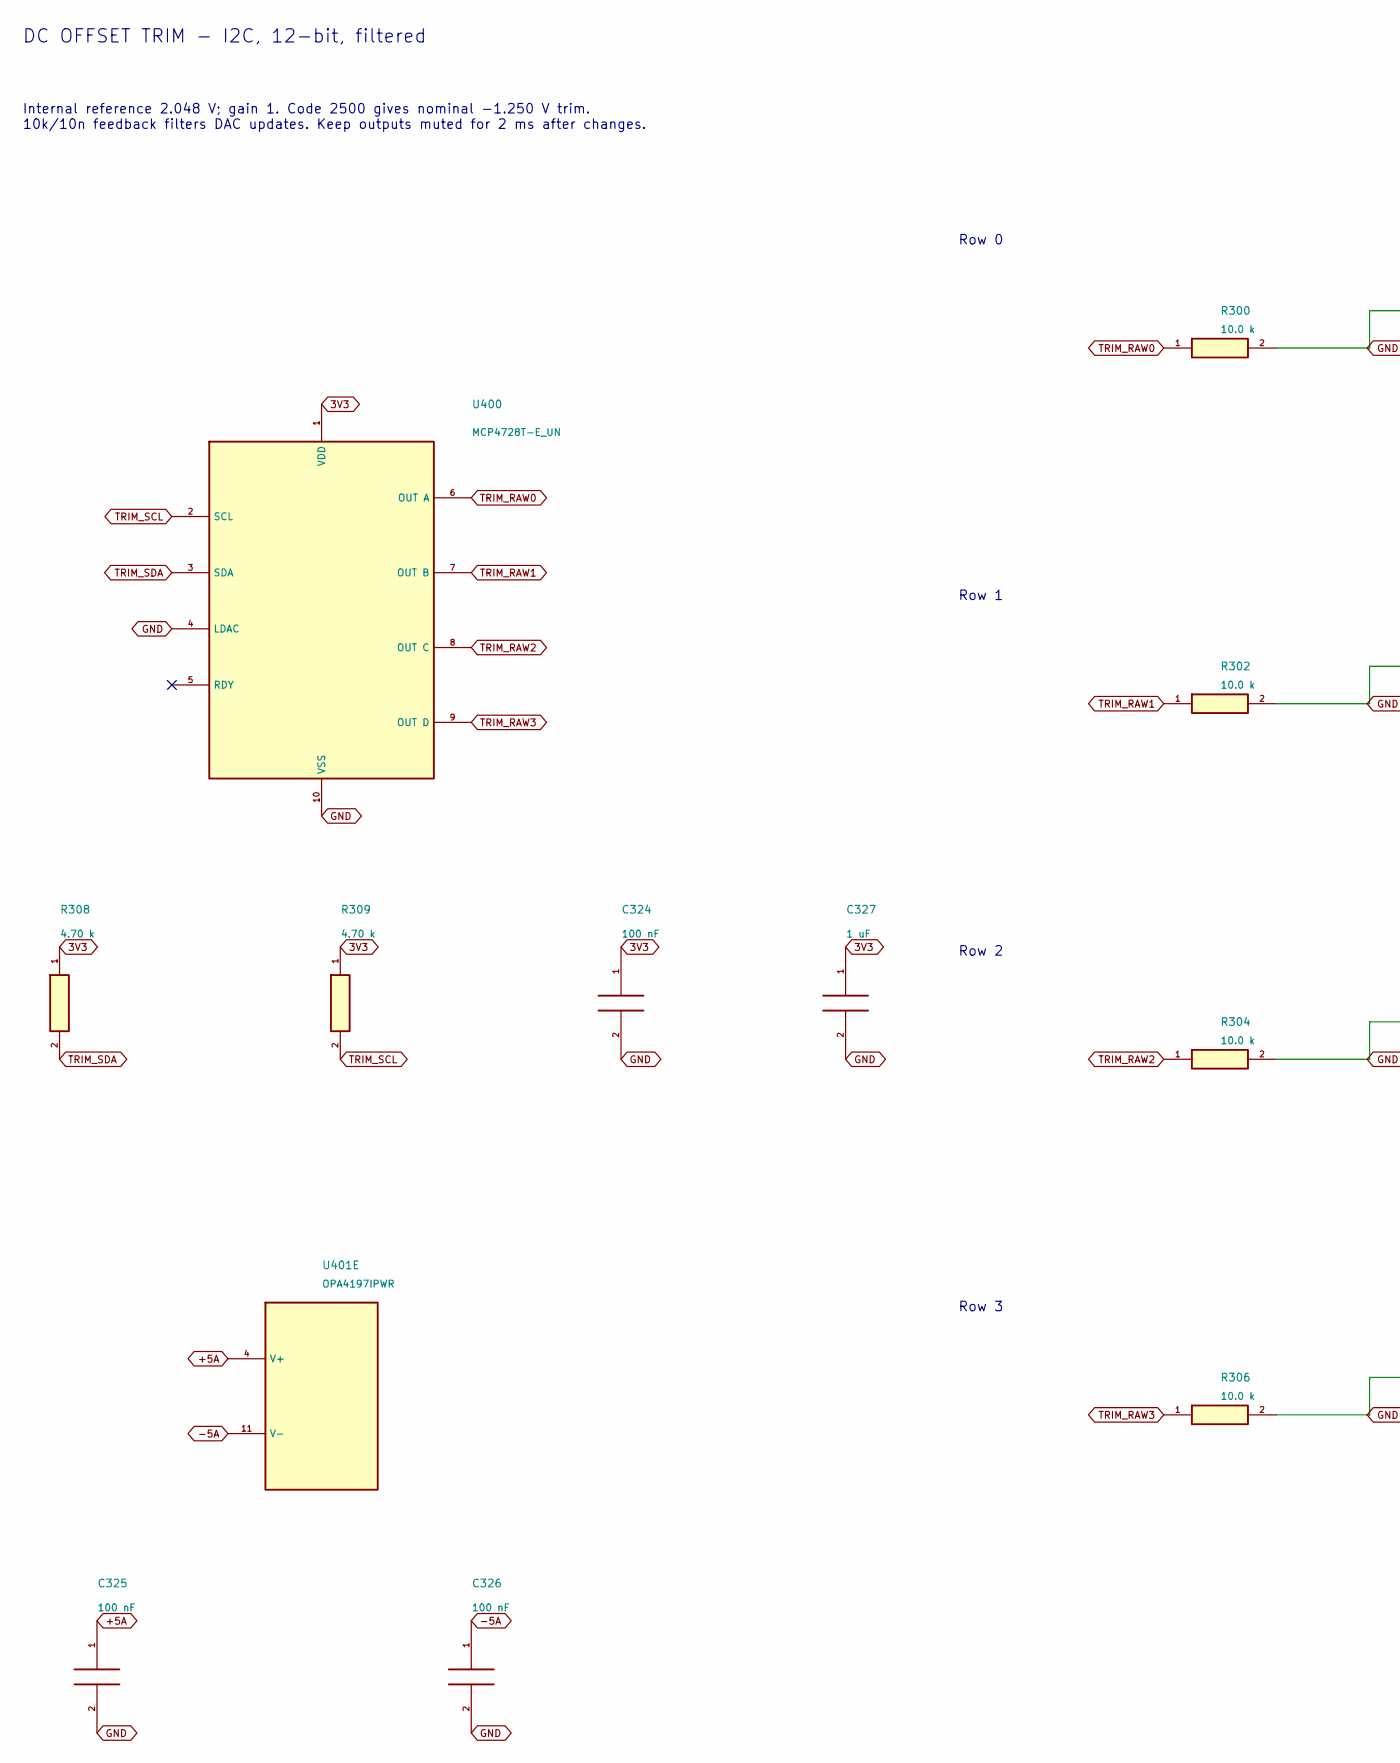
[picture p86: schematic offset_trim.kicad_sch, LC1: DC offset correction and precision bias, part in row 1, column 1]

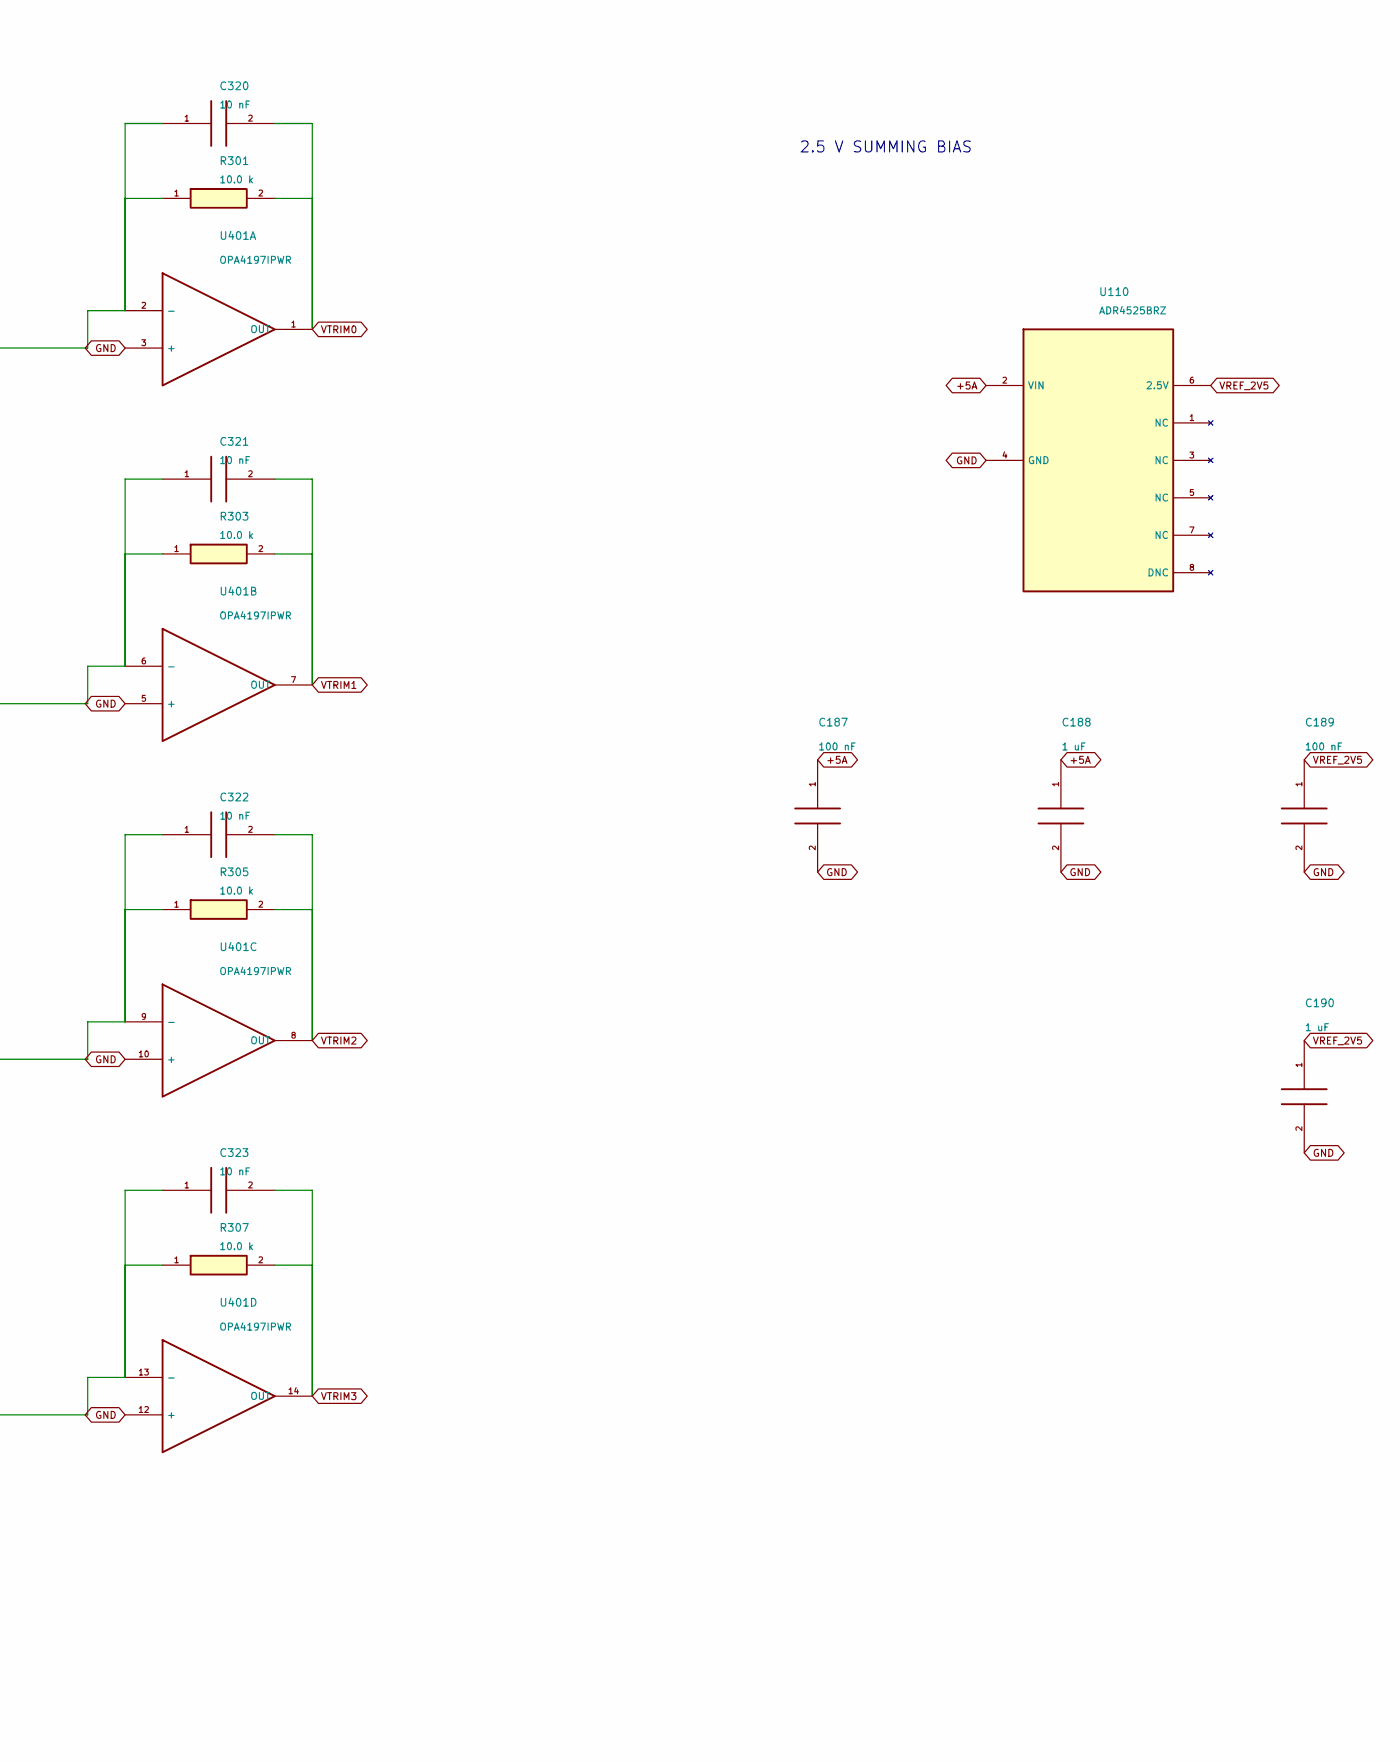
[picture p87: schematic offset_trim.kicad_sch, LC1: DC offset correction and precision bias, part in row 1, column 2]

Parts:
C187, C189: 100 nF; C_0603_1608Metric; Rating 25V X7R minimum; effective C after bias
C188, C190: 1 uF; C_0805_2012Metric; Rating 25V X7R minimum; effective C after bias
C320, C321, C322, C323: 10 nF; C_0603_1608Metric; Rating 25V X7R; trim filter only
C324, C325, C326: 100 nF; C_0603_1608Metric; Rating 25V X7R
C327: 1 uF; C_0603_1608Metric; Rating 25V X7R
R300, R301, R302, R303, R304, R305, R306, R307: 10.0 k; R_0603_1608Metric; Rating 0.1%, 25ppm/C
R308, R309: 4.70 k; R_0603_1608Metric; Rating 1%, 0.1W
U110: ADR4525BRZ; SOIC-8_3.9x4.9mm_P1.27mm
U400: MCP4728T-E_UN; MSOP-10_3x3mm_P0.5mm
U401: OPA4197IPWR; TSSOP-14_4.4x5mm_P0.65mm

Connections:
3V3: C324.1, C327.1, R308.1, R309.1, U400.1 (VDD); also elsewhere on the board
+5A: C187.1, C188.1, C325.1, U110.2 (VIN), U401.4 (V+); also elsewhere on the board
-5A: C326.1, U401.11 (V-); also elsewhere on the board
GND: C187.2, C188.2, C189.2, C190.2, C324.2, C325.2, C326.2, C327.2, U110.4 (GND), U400.4 (LDAC), U400.10 (VSS), U401.3 (+), U401.5 (+), U401.10 (+), U401.12 (+); also elsewhere on the board
unnamed: C320.1, R300.2, R301.1, U401.2 (-)
unnamed: C321.1, R302.2, R303.1, U401.6 (-)
unnamed: C322.1, R304.2, R305.1, U401.9 (-)
unnamed: C323.1, R306.2, R307.1, U401.13 (-)
TRIM_RAW0: R300.1, U400.6 (OUT A)
TRIM_RAW1: R302.1, U400.7 (OUT B)
TRIM_RAW2: R304.1, U400.8 (OUT C)
TRIM_RAW3: R306.1, U400.9 (OUT D)
TRIM_SCL: R309.2, U400.2 (SCL); also elsewhere on the board
TRIM_SDA: R308.2, U400.3 (SDA); also elsewhere on the board
VREF_2V5: C189.1, C190.1, U110.6 (2.5V); also elsewhere on the board
VTRIM0: C320.2, R301.2, U401.1 (OUT); also elsewhere on the board
VTRIM1: C321.2, R303.2, U401.7 (OUT); also elsewhere on the board
VTRIM2: C322.2, R305.2, U401.8 (OUT); also elsewhere on the board
VTRIM3: C323.2, R307.2, U401.14 (OUT); also elsewhere on the board

Notes on the sheet:
DC OFFSET TRIM - I2C, 12-bit, filtered
Internal reference 2.048 V; gain 1. Code 2500 gives nominal -1.250 V trim. 10k/10n feedback filters DAC updates. Keep outputs muted for 2 ms after changes.
Row 0
Row 1
Row 2
Row 3
2.5 V SUMMING BIAS
