tim4431/analog_programmable_matrix/variants/lc1/hardware/analog_matrix_lc1.kicad_pcb

## KiCad design variants/lc1/hardware/analog_matrix_lc1.kicad_pcb (continued)

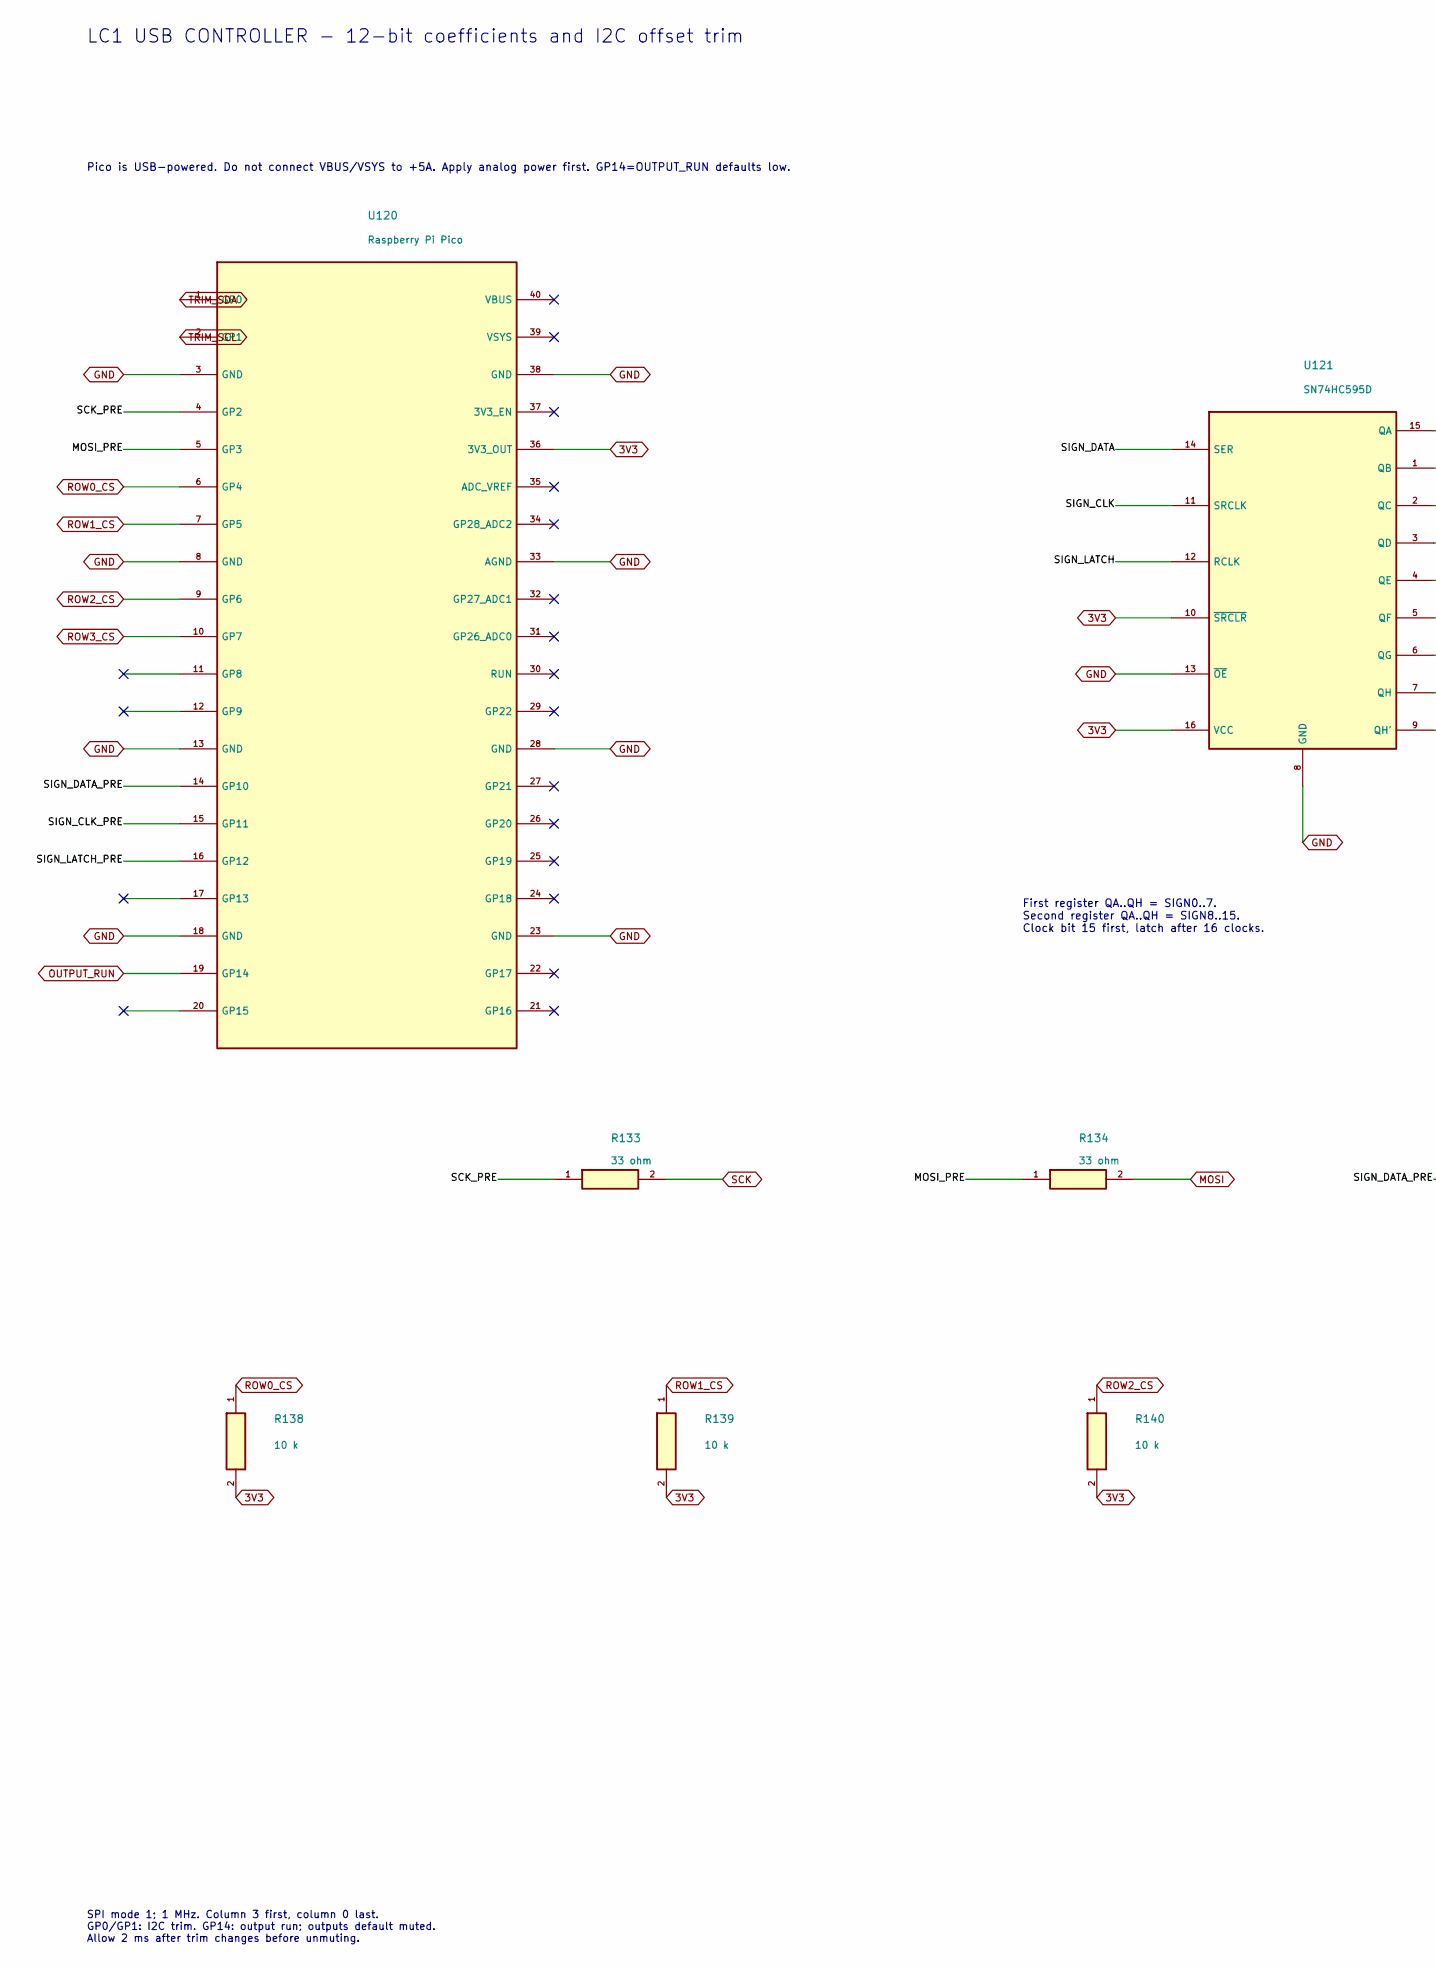
[picture p88: schematic control.kicad_sch, RP2040 USB / SPI controller and sign-bit latches, part in row 1, column 1]

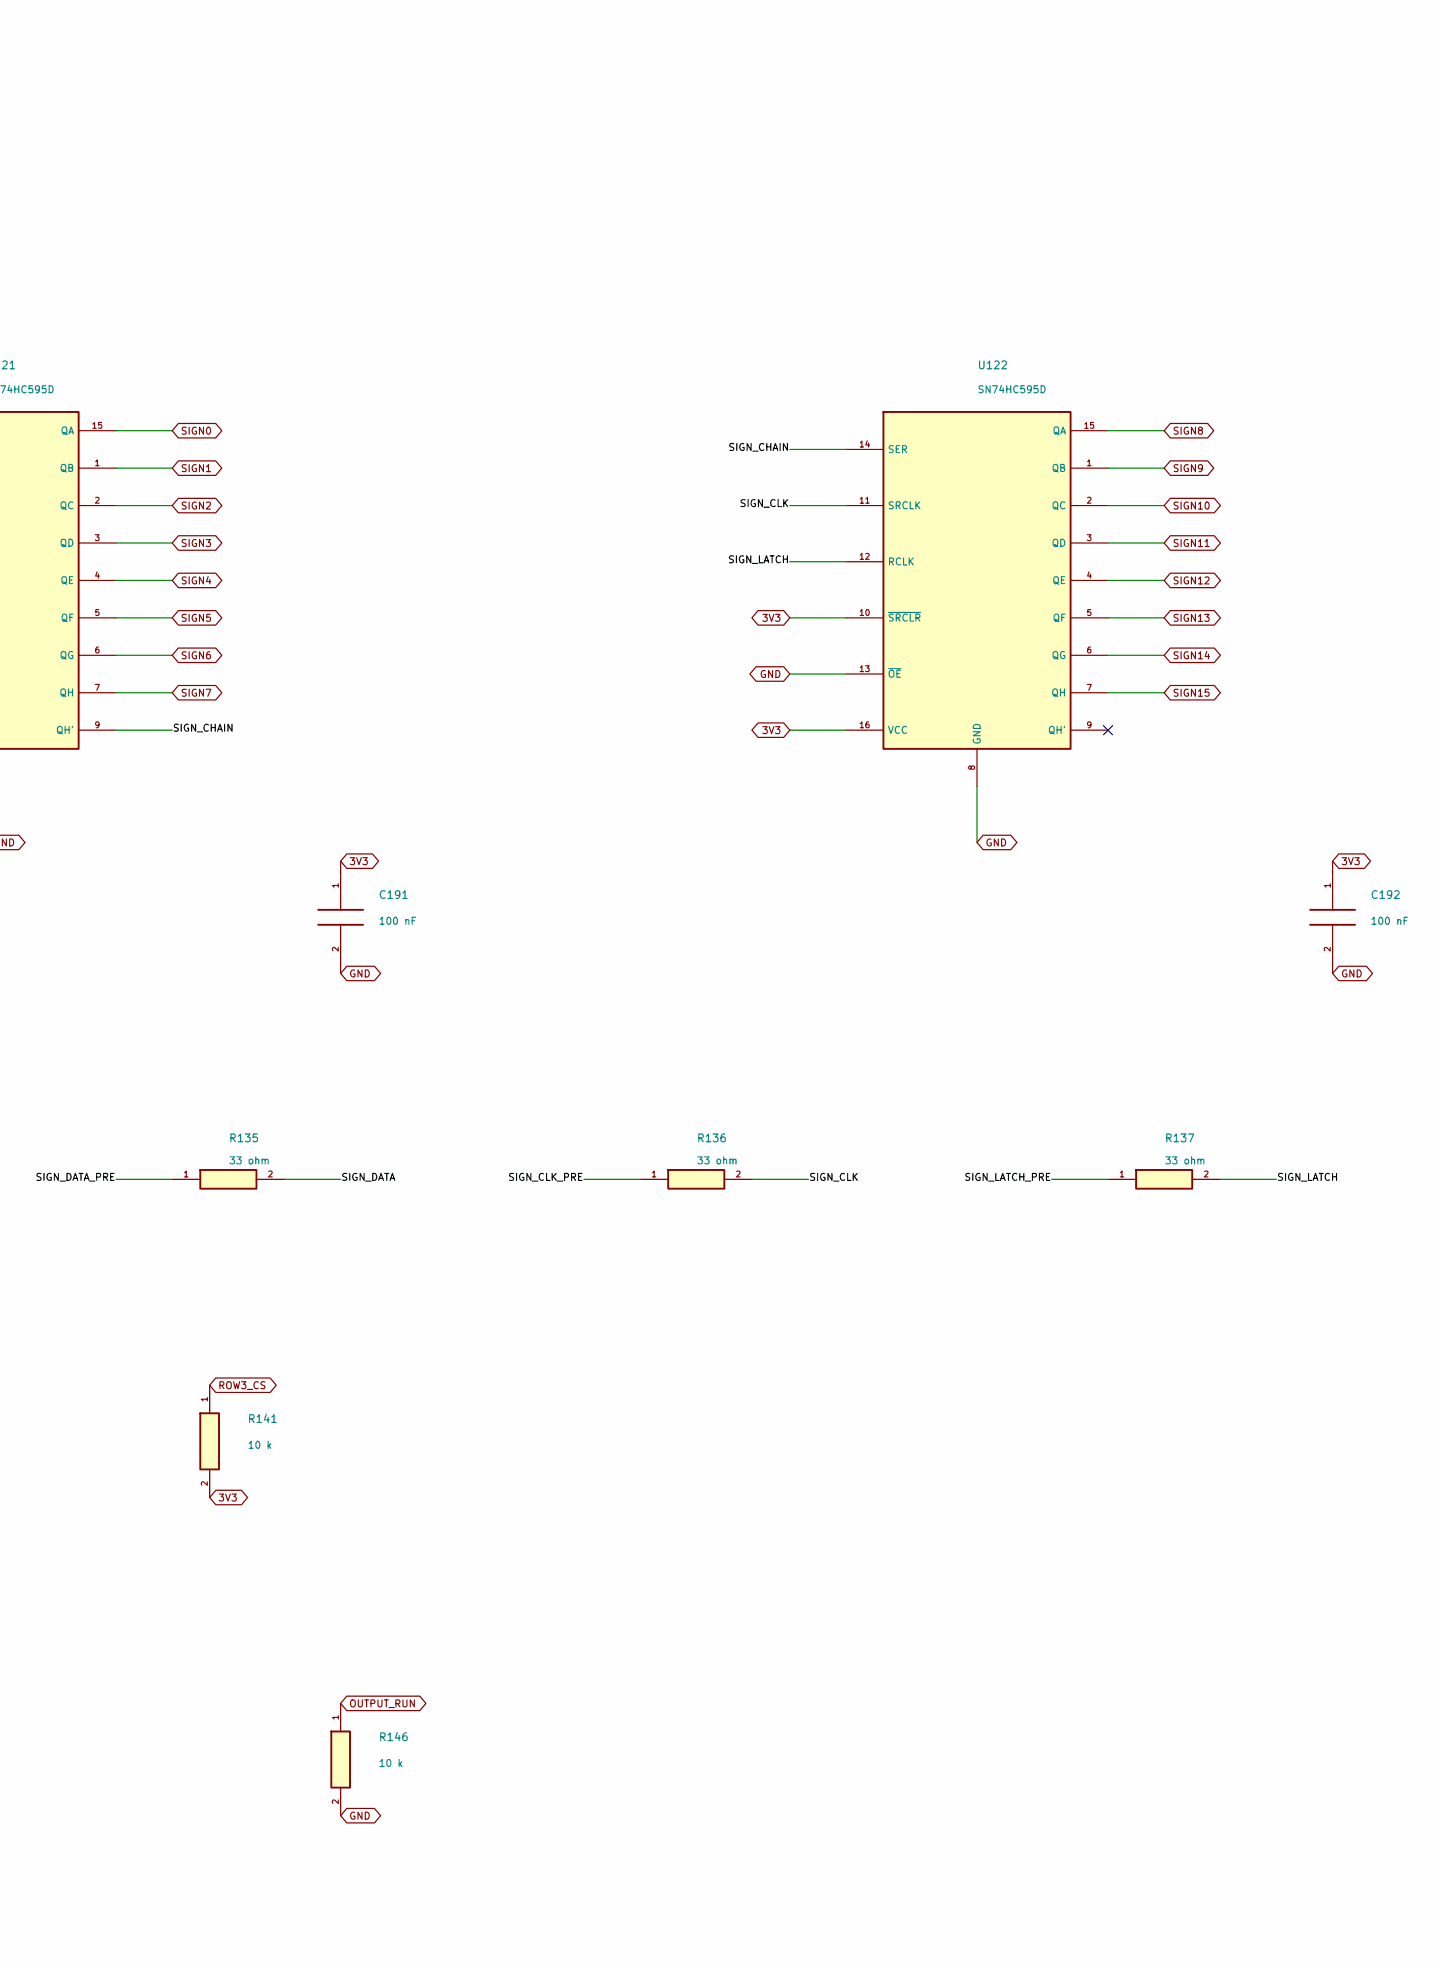
[picture p89: schematic control.kicad_sch, RP2040 USB / SPI controller and sign-bit latches, part in row 1, column 2]

Parts:
C191, C192: 100 nF; C_0603_1608Metric; Rating 25V X7R minimum; effective C after bias
R133, R134, R135, R136, R137: 33 ohm; R_0603_1608Metric; Rating 0.1%, <=25ppm/C; 0.1W minimum
R138, R139, R140, R141, R146: 10 k; R_0603_1608Metric; Rating 0.1%, <=25ppm/C; 0.1W minimum
U120: Raspberry Pi Pico; Pico_2x20_Socket_17.78mm
U121, U122: SN74HC595D; SOIC-16_3.9x9.9mm_P1.27mm

Connections:
3V3: C191.1, C192.1, R138.2, R139.2, R140.2, R141.2, U120.36 (3V3_OUT), U121.10 (~SRCLR), U121.16 (VCC), U122.10 (~SRCLR), U122.16 (VCC); also elsewhere on the board
/Control/MOSI_PRE: R134.1, U120.5 (GP3)
/Control/SCK_PRE: R133.1, U120.4 (GP2)
/Control/SIGN_CHAIN: U121.9 (QH'), U122.14 (SER)
/Control/SIGN_CLK: R136.2, U121.11 (SRCLK), U122.11 (SRCLK)
/Control/SIGN_CLK_PRE: R136.1, U120.15 (GP11)
/Control/SIGN_DATA: R135.2, U121.14 (SER)
/Control/SIGN_DATA_PRE: R135.1, U120.14 (GP10)
/Control/SIGN_LATCH: R137.2, U121.12 (RCLK), U122.12 (RCLK)
/Control/SIGN_LATCH_PRE: R137.1, U120.16 (GP12)
GND: C191.2, C192.2, R146.2, U120.3 (GND), U120.8 (GND), U120.13 (GND), U120.18 (GND), U120.23 (GND), U120.28 (GND), U120.33 (AGND), U120.38 (GND), U121.8 (GND), U121.13 (~OE), U122.8 (GND), U122.13 (~OE); also elsewhere on the board
MOSI: R134.2; also elsewhere on the board
OUTPUT_RUN: R146.1, U120.19 (GP14); also elsewhere on the board
ROW0_CS: R138.1, U120.6 (GP4); also elsewhere on the board
ROW1_CS: R139.1, U120.7 (GP5); also elsewhere on the board
ROW2_CS: R140.1, U120.9 (GP6); also elsewhere on the board
ROW3_CS: R141.1, U120.10 (GP7); also elsewhere on the board
SCK: R133.2; also elsewhere on the board
SIGN0: U121.15 (QA); also elsewhere on the board
SIGN1: U121.1 (QB); also elsewhere on the board
SIGN2: U121.2 (QC); also elsewhere on the board
SIGN3: U121.3 (QD); also elsewhere on the board
SIGN4: U121.4 (QE); also elsewhere on the board
SIGN5: U121.5 (QF); also elsewhere on the board
SIGN6: U121.6 (QG); also elsewhere on the board
SIGN7: U121.7 (QH); also elsewhere on the board
SIGN8: U122.15 (QA); also elsewhere on the board
SIGN9: U122.1 (QB); also elsewhere on the board
SIGN10: U122.2 (QC); also elsewhere on the board
SIGN11: U122.3 (QD); also elsewhere on the board
SIGN12: U122.4 (QE); also elsewhere on the board
SIGN13: U122.5 (QF); also elsewhere on the board
SIGN14: U122.6 (QG); also elsewhere on the board
SIGN15: U122.7 (QH); also elsewhere on the board
TRIM_SCL: U120.2 (GP1); also elsewhere on the board
TRIM_SDA: U120.1 (GP0); also elsewhere on the board

Notes on the sheet:
LC1 USB CONTROLLER - 12-bit coefficients and I2C offset trim
Pico is USB-powered. Do not connect VBUS/VSYS to +5A. Apply analog power first. GP14=OUTPUT_RUN defaults low.
First register QA..QH = SIGN0..7. Second register QA..QH = SIGN8..15. Clock bit 15 first, latch after 16 clocks.
SPI mode 1; 1 MHz. Column 3 first, column 0 last. GP0/GP1: I2C trim. GP14: output run; outputs default muted. Allow 2 ms after trim changes before unmuting.

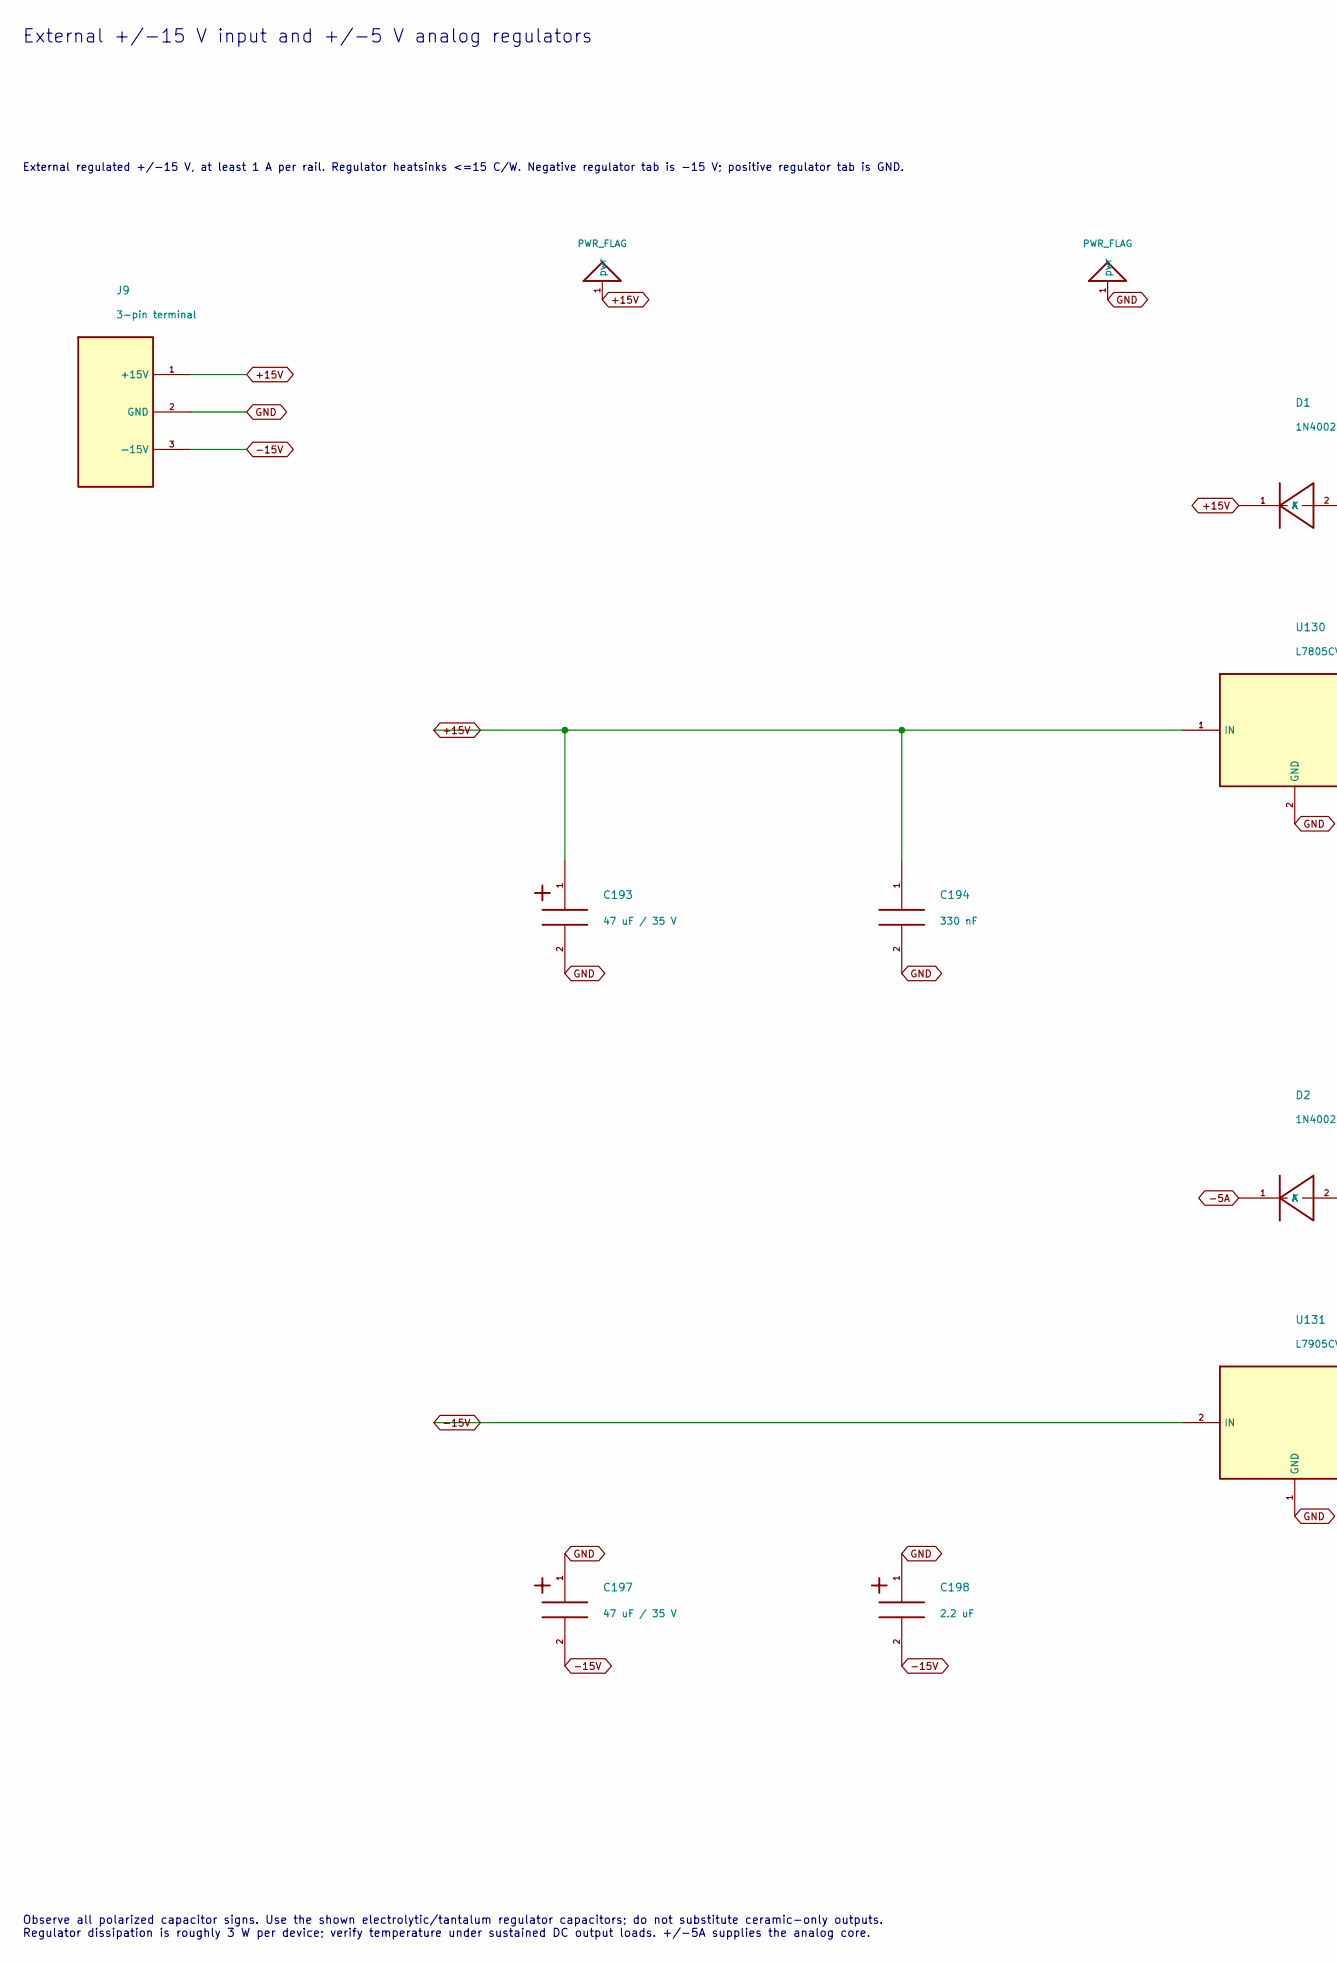
[picture p90: schematic power.kicad_sch, External +/-15 V input and +/-5 V analog regulators, part in row 1, column 1]

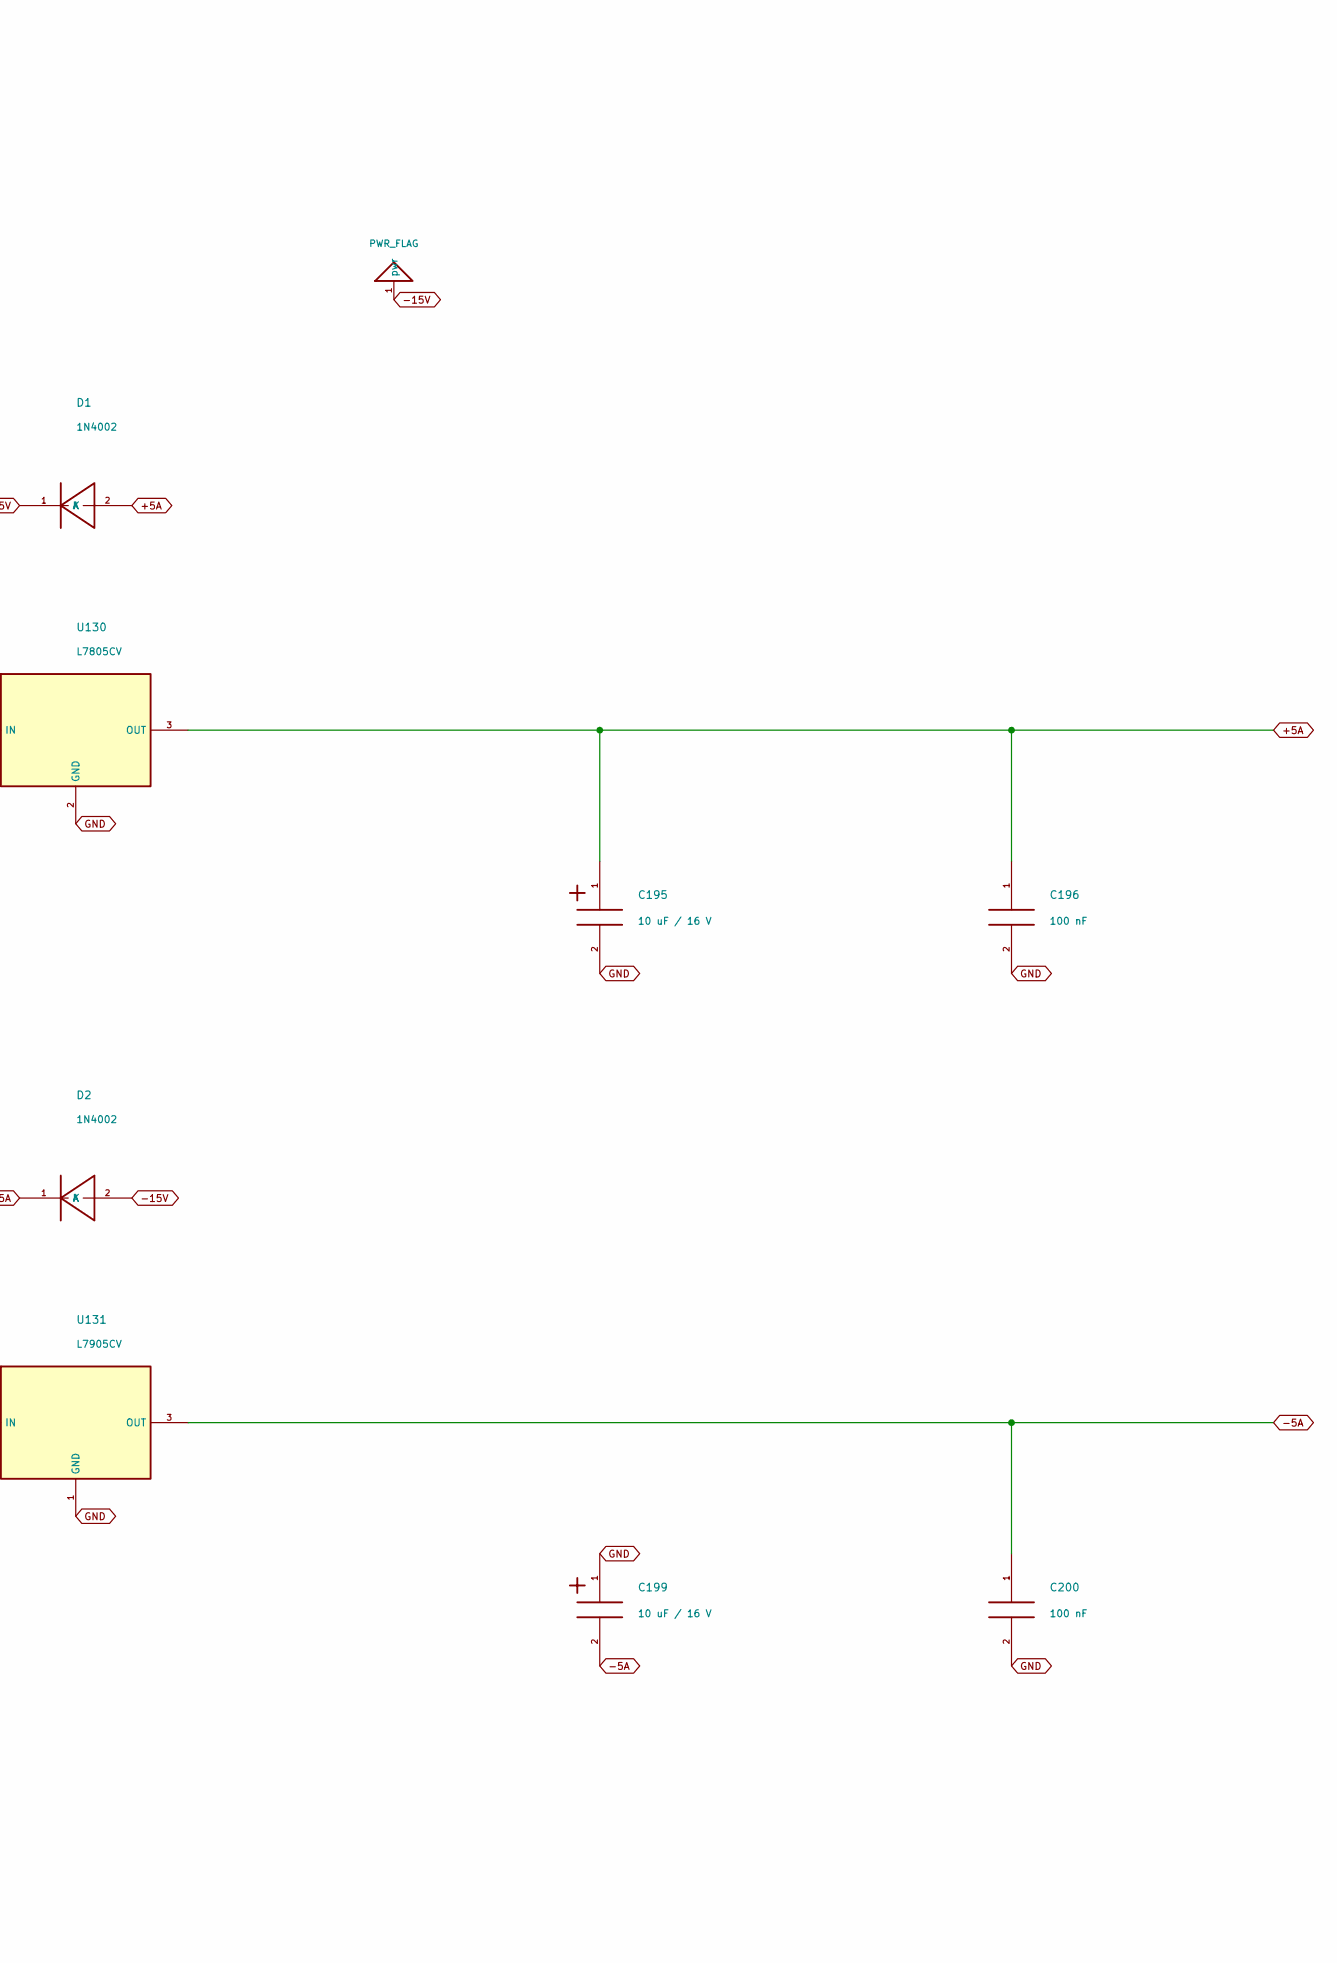
[picture p91: schematic power.kicad_sch, External +/-15 V input and +/-5 V analog regulators, part in row 1, column 2]

Parts:
C193, C197: 47 uF / 35 V; C_Radial_D5.0mm_H11.0mm_P2.00mm; Rating 35V polarized
C194: 330 nF; C_0603_1608Metric; Rating 25V X7R minimum; effective C after bias
C195, C199: 10 uF / 16 V; C_Radial_D5.0mm_H11.0mm_P2.00mm; Rating 16V polarized
C196, C200: 100 nF; C_0603_1608Metric; Rating 25V X7R minimum; effective C after bias
C198: 2.2 uF; CP_EIA-3216-18_Kemet-A; Rating 35V polarized
D1, D2: 1N4002; D_DO-41_SOD81_P10.16mm_Horizontal
J9: 3-pin terminal; TerminalBlock_Phoenix_MKDS-1,5-3-5.08_1x03_P5.08mm_Horizont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
U130: L7805CV; TO-220-3_Vertical
U131: L7905CV; TO-220-3_Vertical

Connections:
+5A: C195.1, C196.1, D1.2 (A), U130.3 (OUT); also elsewhere on the board
+15V: C193.1, C194.1, D1.1 (K), J9.1 (+15V), U130.1 (IN); also elsewhere on the board
-5A: C199.2, C200.1, D2.1 (K), U131.3 (OUT); also elsewhere on the board
-15V: C197.2, C198.2, D2.2 (A), J9.3 (-15V), U131.2 (IN); also elsewhere on the board
GND: C193.2, C194.2, C195.2, C196.2, C197.1, C198.1, C199.1, C200.2, J9.2 (GND), U130.2 (GND), U131.1 (GND); also elsewhere on the board

Notes on the sheet:
External +/-15 V input and +/-5 V analog regulators
External regulated +/-15 V, at least 1 A per rail. Regulator heatsinks <=15 C/W. Negative regulator tab is -15 V; positive regulator tab is GND.
Observe all polarized capacitor signs. Use the shown electrolytic/tantalum regulator capacitors; do not substitute ceramic-only outputs. Regulator dissipation is roughly 3 W per device; verify temperature under sustained DC output loads. +/-5A supplies the analog core.
