tim4431/analog_programmable_matrix/variants/lc1/hardware/analog_matrix_lc1.kicad_pcb

## KiCad design variants/lc1/hardware/analog_matrix_lc1.kicad_pcb (continued)

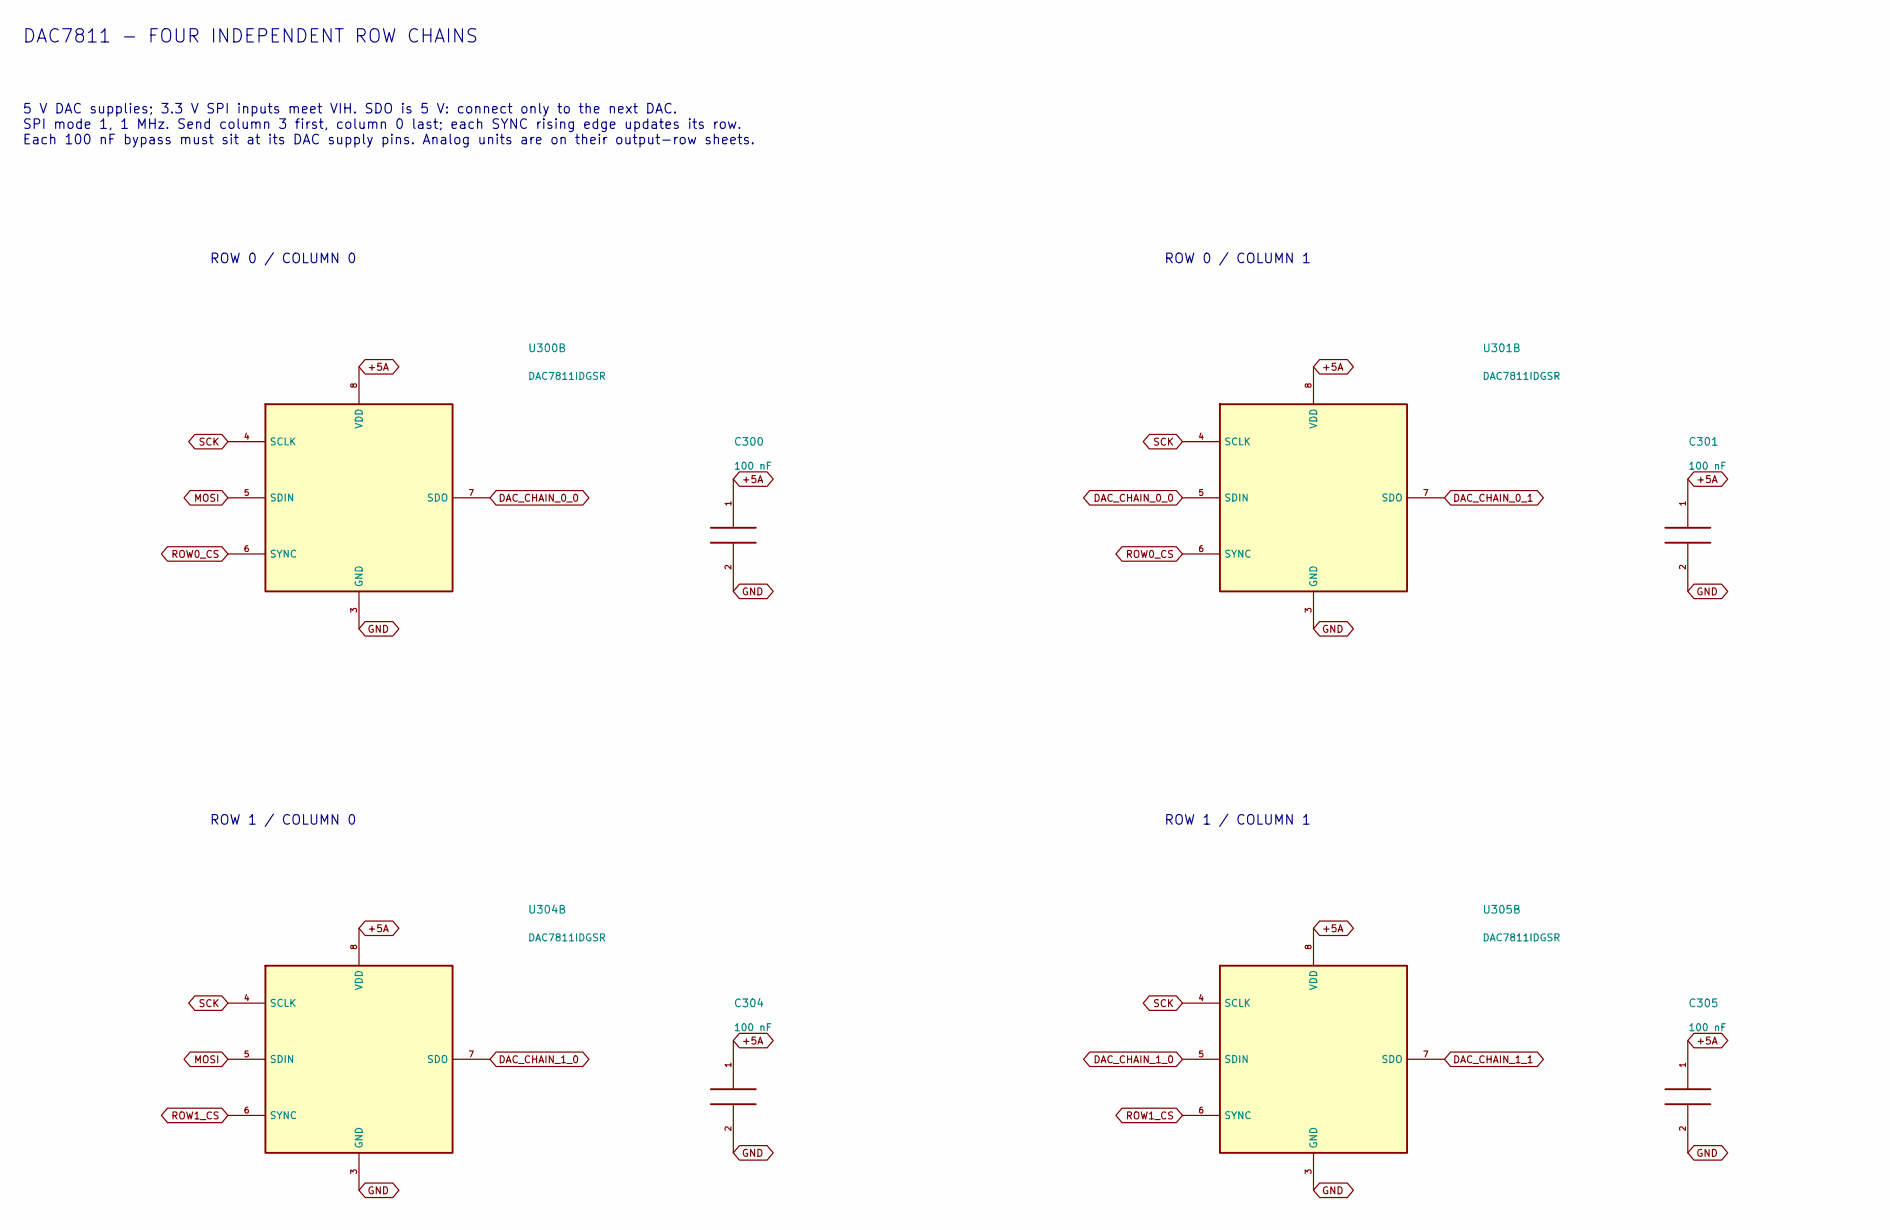
[picture p92: schematic dac_control.kicad_sch, LC1: DAC row chains, power and local bypass, part in row 1, column 1]

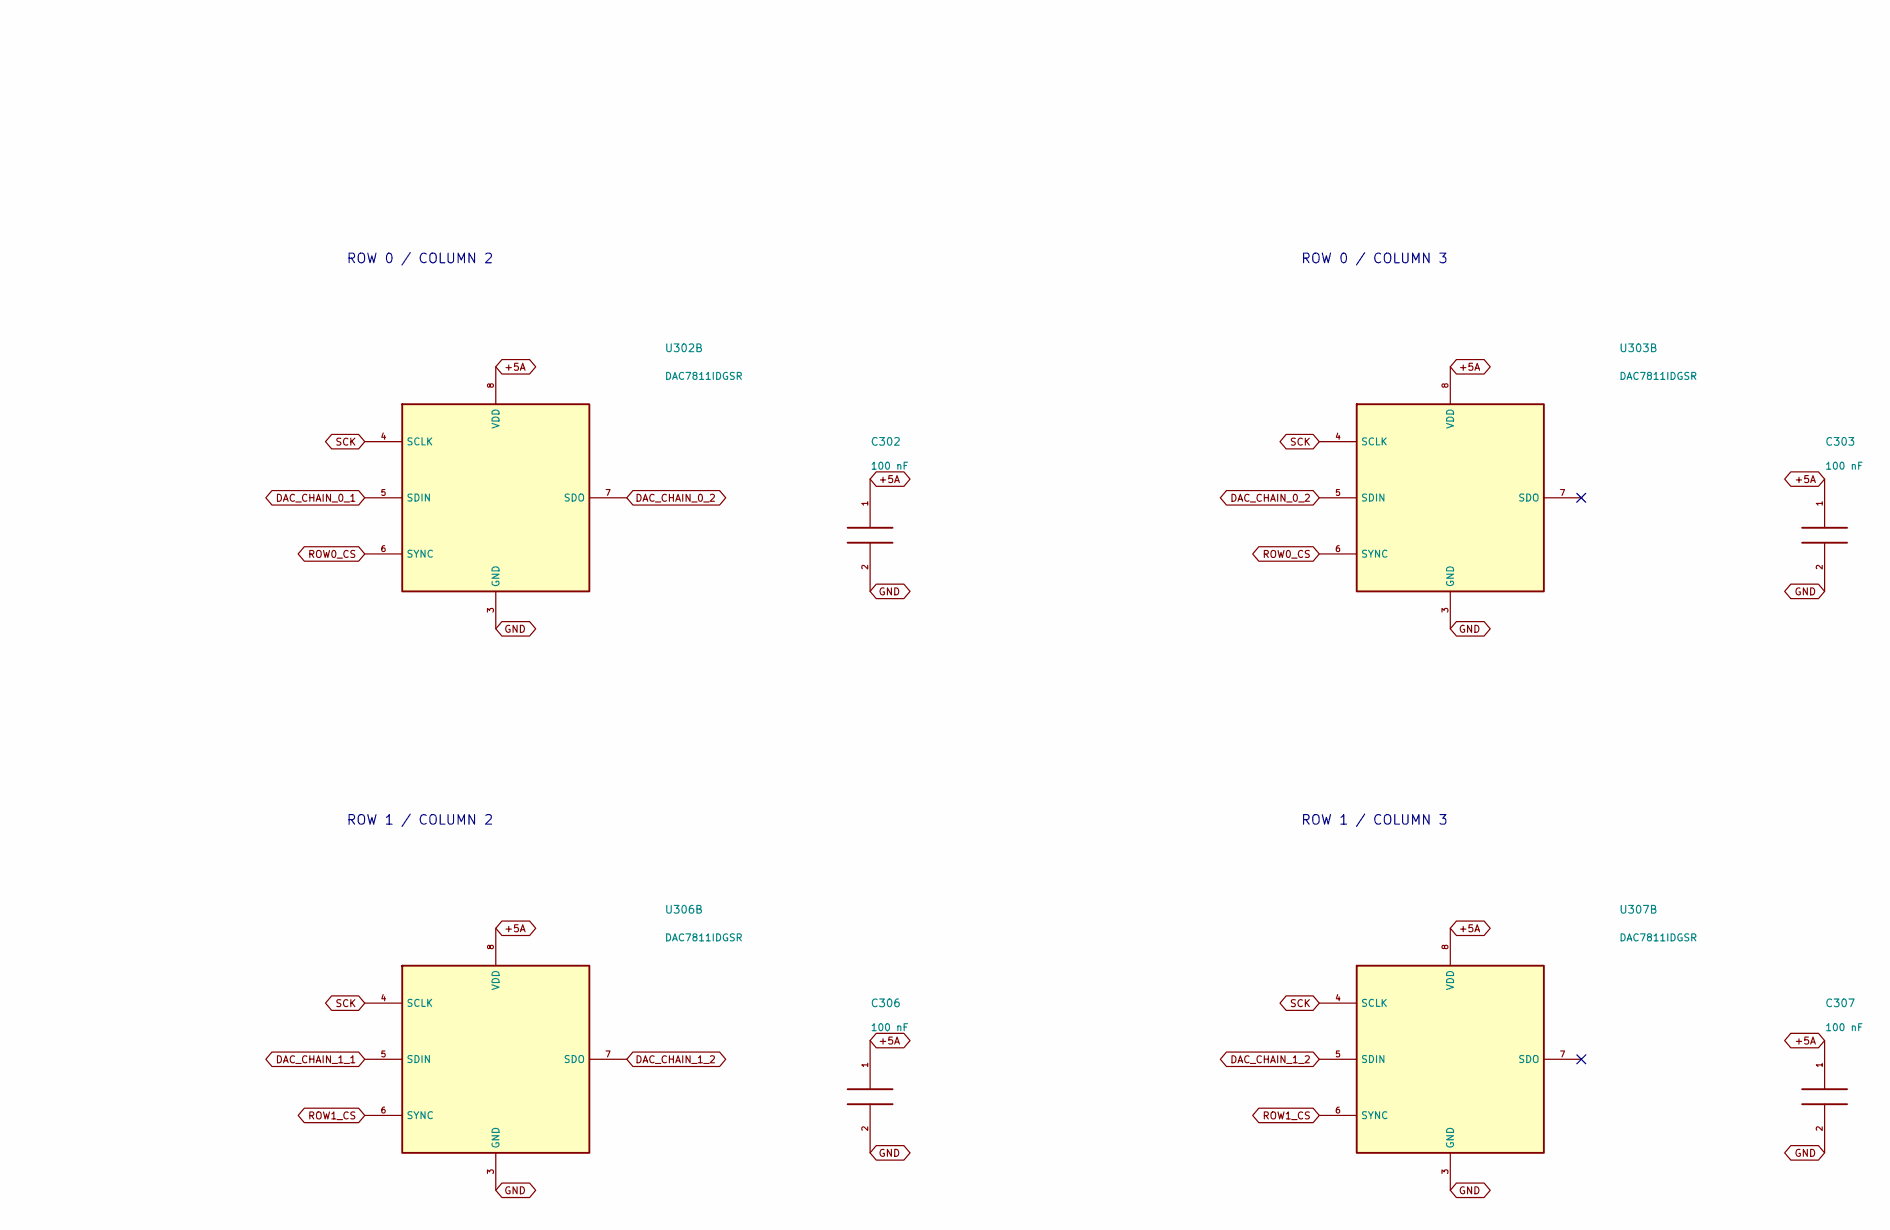
[picture p93: schematic dac_control.kicad_sch, LC1: DAC row chains, power and local bypass, part in row 1, column 2]

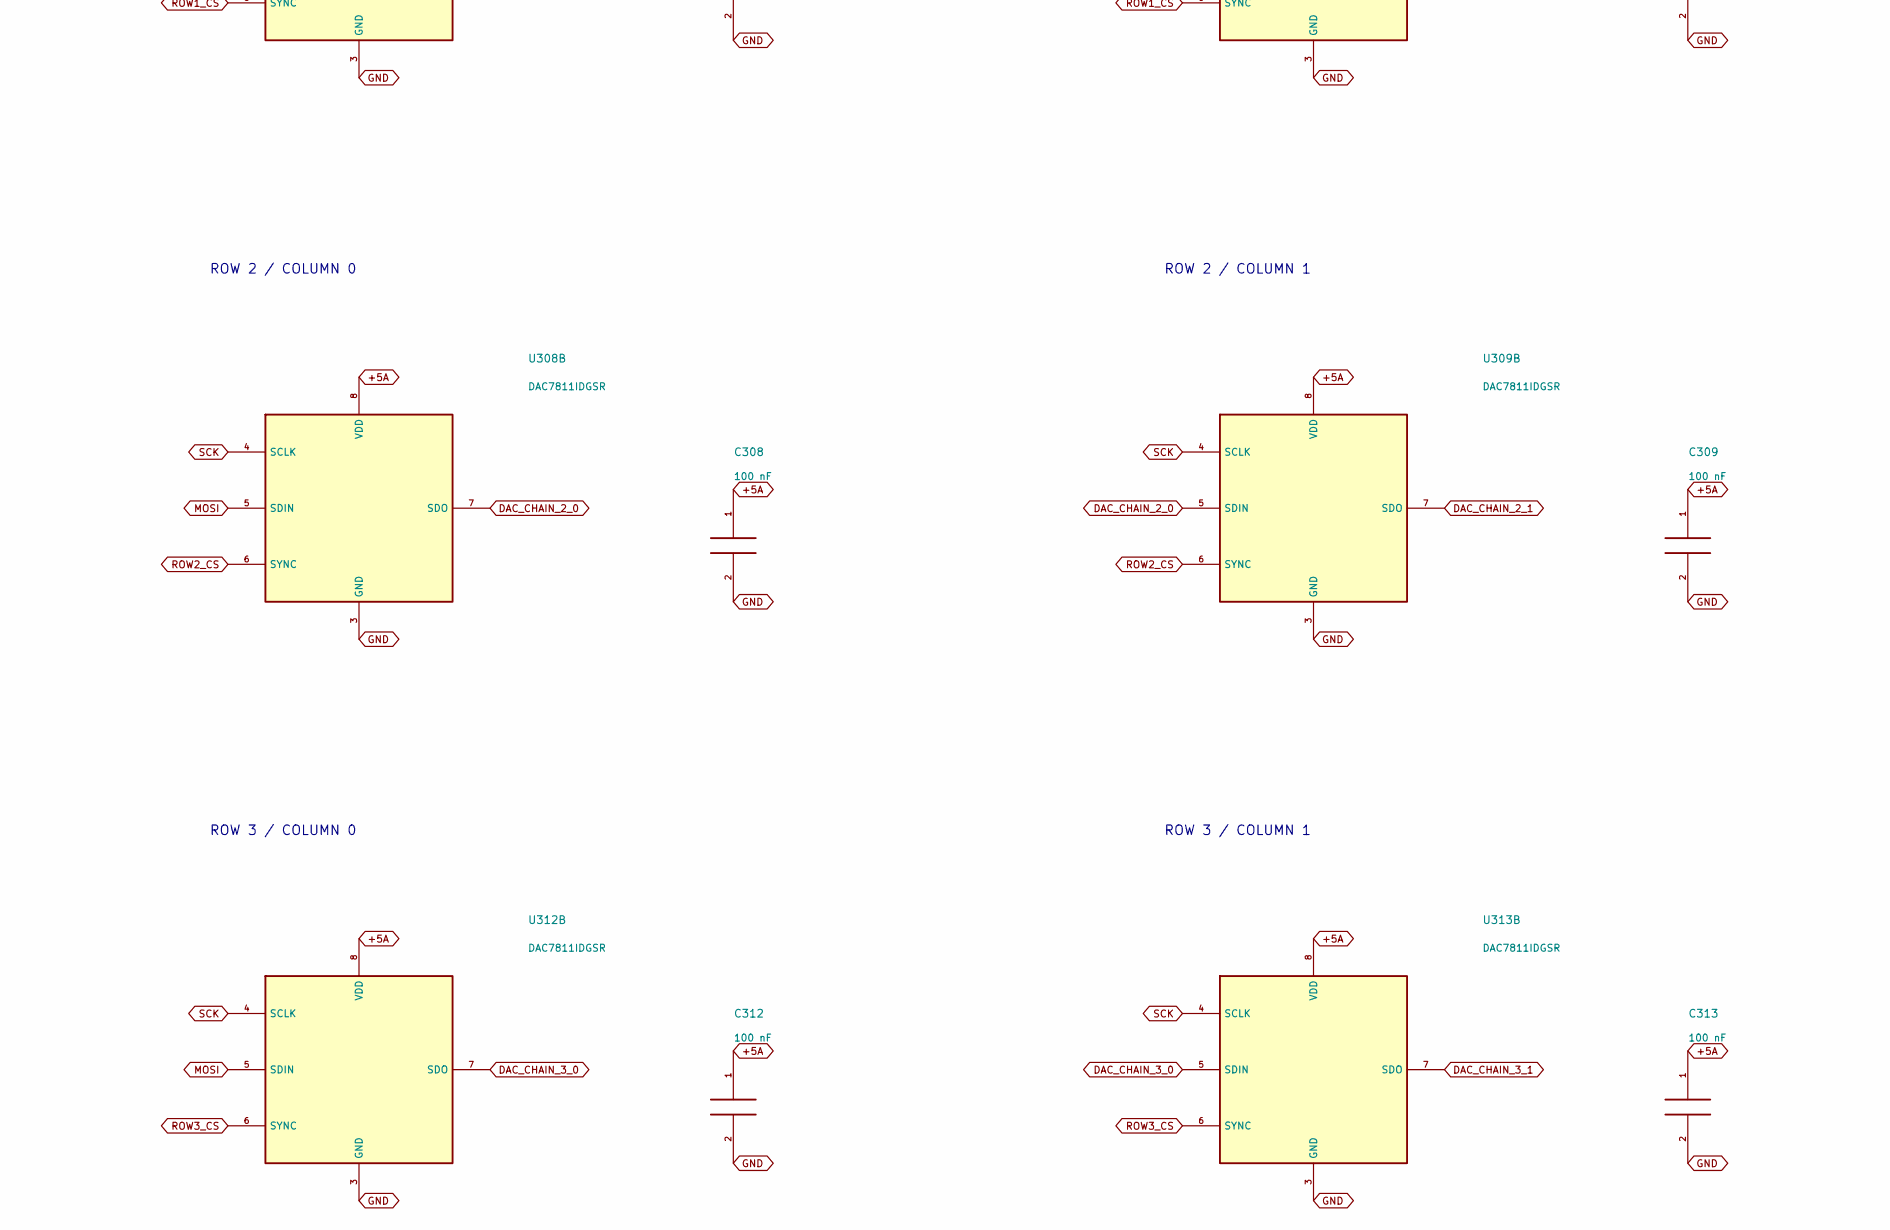
[picture p94: schematic dac_control.kicad_sch, LC1: DAC row chains, power and local bypass, part in row 2, column 1]

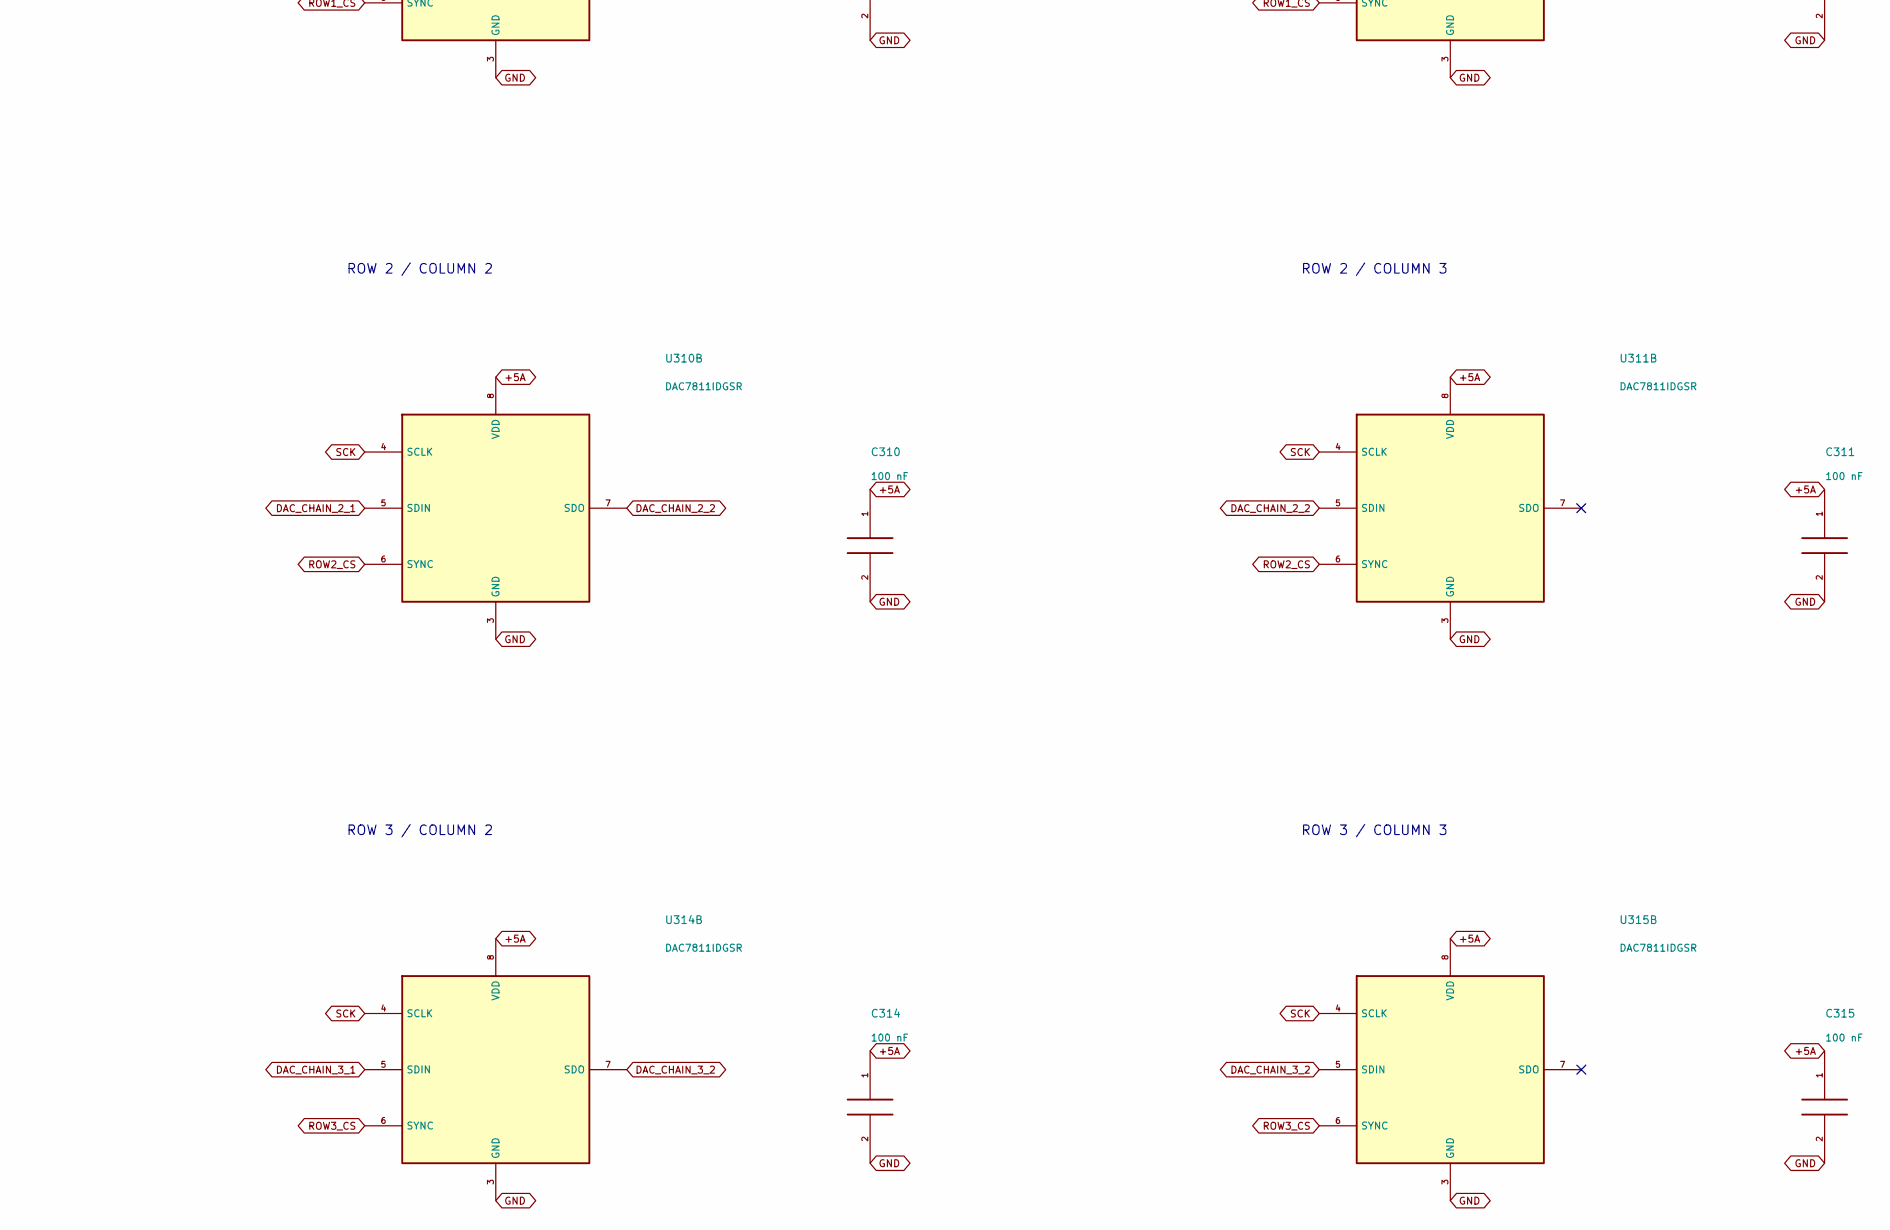
[picture p95: schematic dac_control.kicad_sch, LC1: DAC row chains, power and local bypass, part in row 2, column 2]

Parts:
C300, C301, C302, C303, C304, C305, C306, C307, C308, C309, C310, C311, C312, C313, C314, C315: 100 nF; C_0603_1608Metric; Rating 25V X7R
U300, U301, U302, U303, U304, U305, U306, U307, U308, U309, U310, U311, U312, U313, U314, U315: DAC7811IDGSR; VSSOP-10_3x3mm_P0.5mm

Connections:
+5A: C300.1, C301.1, C302.1, C303.1, C304.1, C305.1, C306.1, C307.1, C308.1, C309.1, C310.1, C311.1, C312.1, C313.1, C314.1, C315.1, U300.8 (VDD), U301.8 (VDD), U302.8 (VDD), U303.8 (VDD), U304.8 (VDD), U305.8 (VDD), U306.8 (VDD), U307.8 (VDD), U308.8 (VDD), U309.8 (VDD), U310.8 (VDD), U311.8 (VDD), U312.8 (VDD), U313.8 (VDD), U314.8 (VDD), U315.8 (VDD); also elsewhere on the board
DAC_CHAIN_0_0: U300.7 (SDO), U301.5 (SDIN)
DAC_CHAIN_0_1: U301.7 (SDO), U302.5 (SDIN)
DAC_CHAIN_0_2: U302.7 (SDO), U303.5 (SDIN)
DAC_CHAIN_1_0: U304.7 (SDO), U305.5 (SDIN)
DAC_CHAIN_1_1: U305.7 (SDO), U306.5 (SDIN)
DAC_CHAIN_1_2: U306.7 (SDO), U307.5 (SDIN)
DAC_CHAIN_2_0: U308.7 (SDO), U309.5 (SDIN)
DAC_CHAIN_2_1: U309.7 (SDO), U310.5 (SDIN)
DAC_CHAIN_2_2: U310.7 (SDO), U311.5 (SDIN)
DAC_CHAIN_3_0: U312.7 (SDO), U313.5 (SDIN)
DAC_CHAIN_3_1: U313.7 (SDO), U314.5 (SDIN)
DAC_CHAIN_3_2: U314.7 (SDO), U315.5 (SDIN)
GND: C300.2, C301.2, C302.2, C303.2, C304.2, C305.2, C306.2, C307.2, C308.2, C309.2, C310.2, C311.2, C312.2, C313.2, C314.2, C315.2, U300.3 (GND), U301.3 (GND), U302.3 (GND), U303.3 (GND), U304.3 (GND), U305.3 (GND), U306.3 (GND), U307.3 (GND), U308.3 (GND), U309.3 (GND), U310.3 (GND), U311.3 (GND), U312.3 (GND), U313.3 (GND), U314.3 (GND), U315.3 (GND); also elsewhere on the board
MOSI: U300.5 (SDIN), U304.5 (SDIN), U308.5 (SDIN), U312.5 (SDIN); also elsewhere on the board
ROW0_CS: U300.6 (SYNC), U301.6 (SYNC), U302.6 (SYNC), U303.6 (SYNC); also elsewhere on the board
ROW1_CS: U304.6 (SYNC), U305.6 (SYNC), U306.6 (SYNC), U307.6 (SYNC); also elsewhere on the board
ROW2_CS: U308.6 (SYNC), U309.6 (SYNC), U310.6 (SYNC), U311.6 (SYNC); also elsewhere on the board
ROW3_CS: U312.6 (SYNC), U313.6 (SYNC), U314.6 (SYNC), U315.6 (SYNC); also elsewhere on the board
SCK: U300.4 (SCLK), U301.4 (SCLK), U302.4 (SCLK), U303.4 (SCLK), U304.4 (SCLK), U305.4 (SCLK), U306.4 (SCLK), U307.4 (SCLK), U308.4 (SCLK), U309.4 (SCLK), U310.4 (SCLK), U311.4 (SCLK), U312.4 (SCLK), U313.4 (SCLK), U314.4 (SCLK), U315.4 (SCLK); also elsewhere on the board

Notes on the sheet:
DAC7811 - FOUR INDEPENDENT ROW CHAINS
5 V DAC supplies; 3.3 V SPI inputs meet VIH. SDO is 5 V: connect only to the next DAC. SPI mode 1, 1 MHz. Send column 3 first, column 0 last; each SYNC rising edge updates its row. Each 100 nF bypass must sit at its DAC supply pins. Analog units are on their output-row sheets.
ROW 0 / COLUMN 0
ROW 0 / COLUMN 1
ROW 0 / COLUMN 2
ROW 0 / COLUMN 3
ROW 1 / COLUMN 0
ROW 1 / COLUMN 1
ROW 1 / COLUMN 2
ROW 1 / COLUMN 3
ROW 2 / COLUMN 0
ROW 2 / COLUMN 1
ROW 2 / COLUMN 2
ROW 2 / COLUMN 3
ROW 3 / COLUMN 0
ROW 3 / COLUMN 1
ROW 3 / COLUMN 2
ROW 3 / COLUMN 3

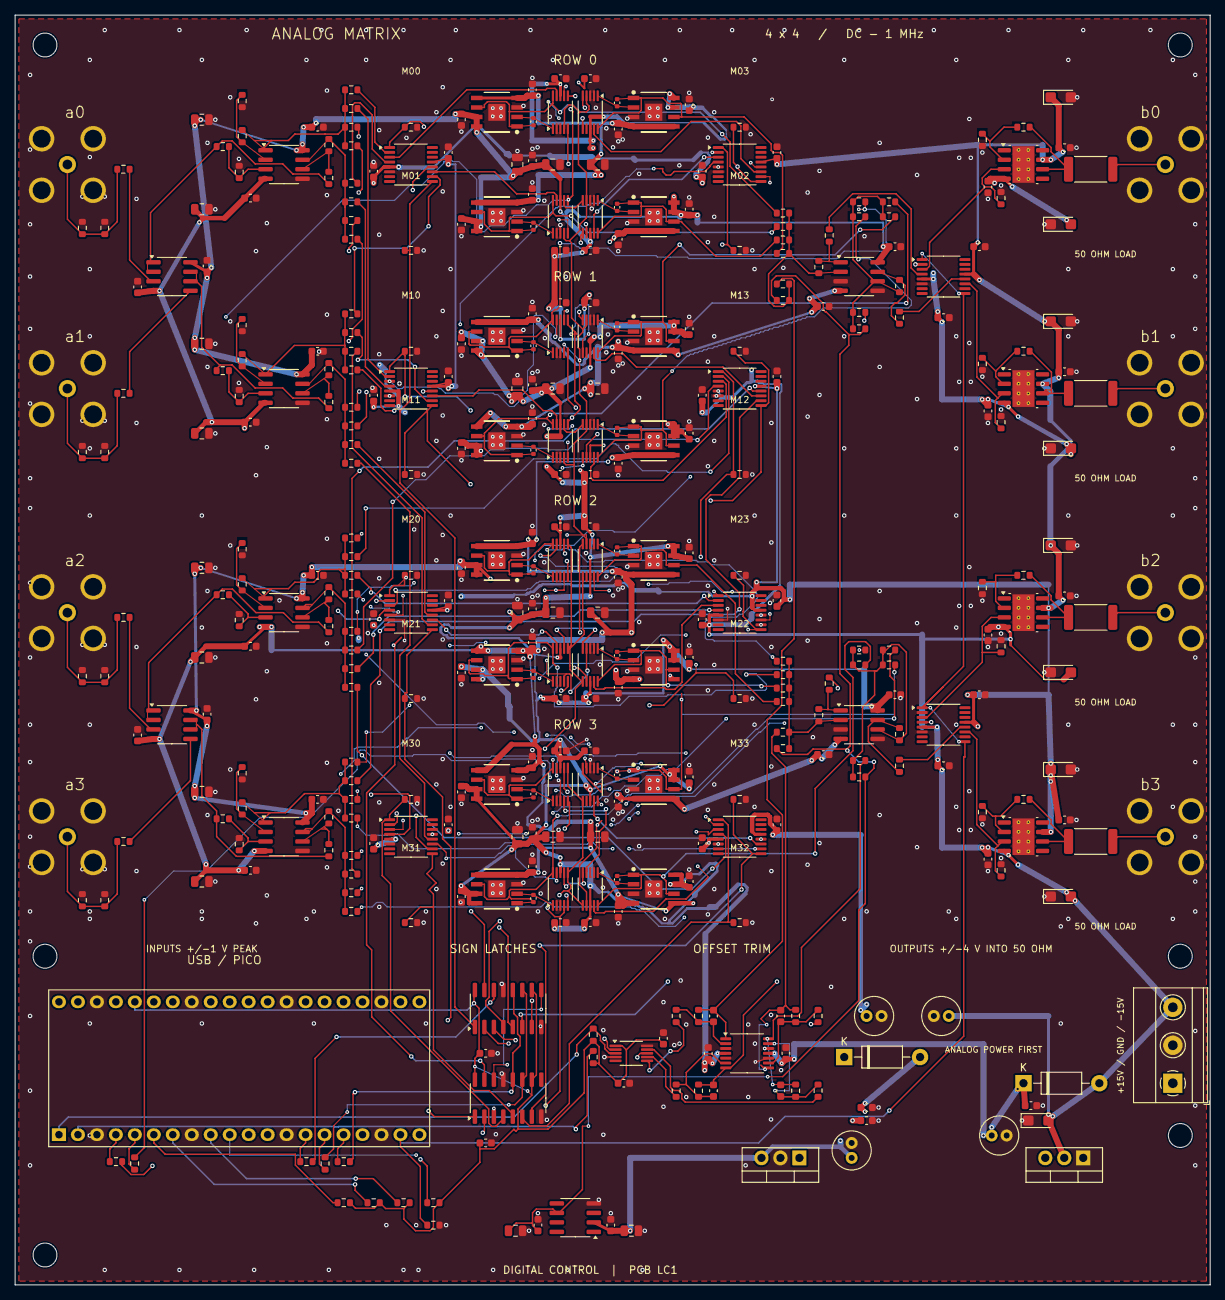
[picture p96: board analog_matrix_lc1.kicad_pcb from above]

Board: 4 copper layers, 160.0 x 170.0 mm, 393 parts (0 on the bottom side), 205 nets.

Other parts of the board:
H1, H2, H3, H4, H5, H6: MountingHole_3.2mm_M3
