tim4431/analog_programmable_matrix/pcb/analog_matrix_4x4_rev_d/analog_matrix_4x4.kicad_pcb

## KiCad design pcb/analog_matrix_4x4_rev_d/analog_matrix_4x4.kicad_pcb (2026-10-01)

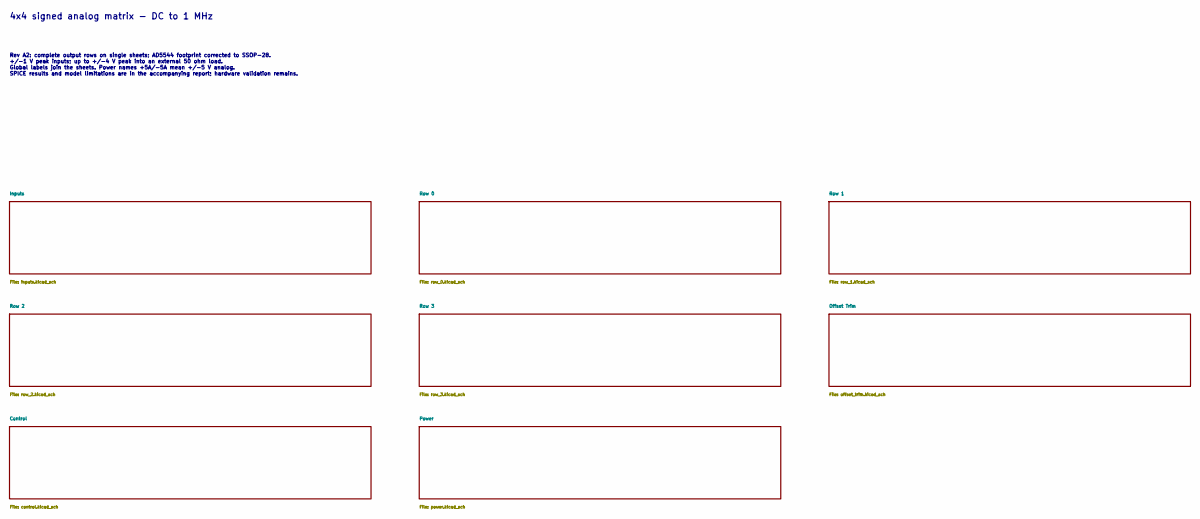
[picture p97: schematic analog_matrix_4x4.kicad_sch, 4x4 programmable analog matrix]

Notes on the sheet:
4x4 signed analog matrix - DC to 1 MHz
Rev A2: complete output rows on single sheets; AD5544 footprint corrected to SSOP-28. +/-1 V peak inputs; up to +/-4 V peak into an external 50 ohm load. Global labels join the sheets. Power names +5A/-5A mean +/-5 V analog. SPICE results and model limitations are in the accompanying report; hardwa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
