tim4431/analog_programmable_matrix/pcb/analog_matrix_4x4_rev_d/analog_matrix_4x4.kicad_pcb

## KiCad design pcb/analog_matrix_4x4_rev_d/analog_matrix_4x4.kicad_pcb (continued)

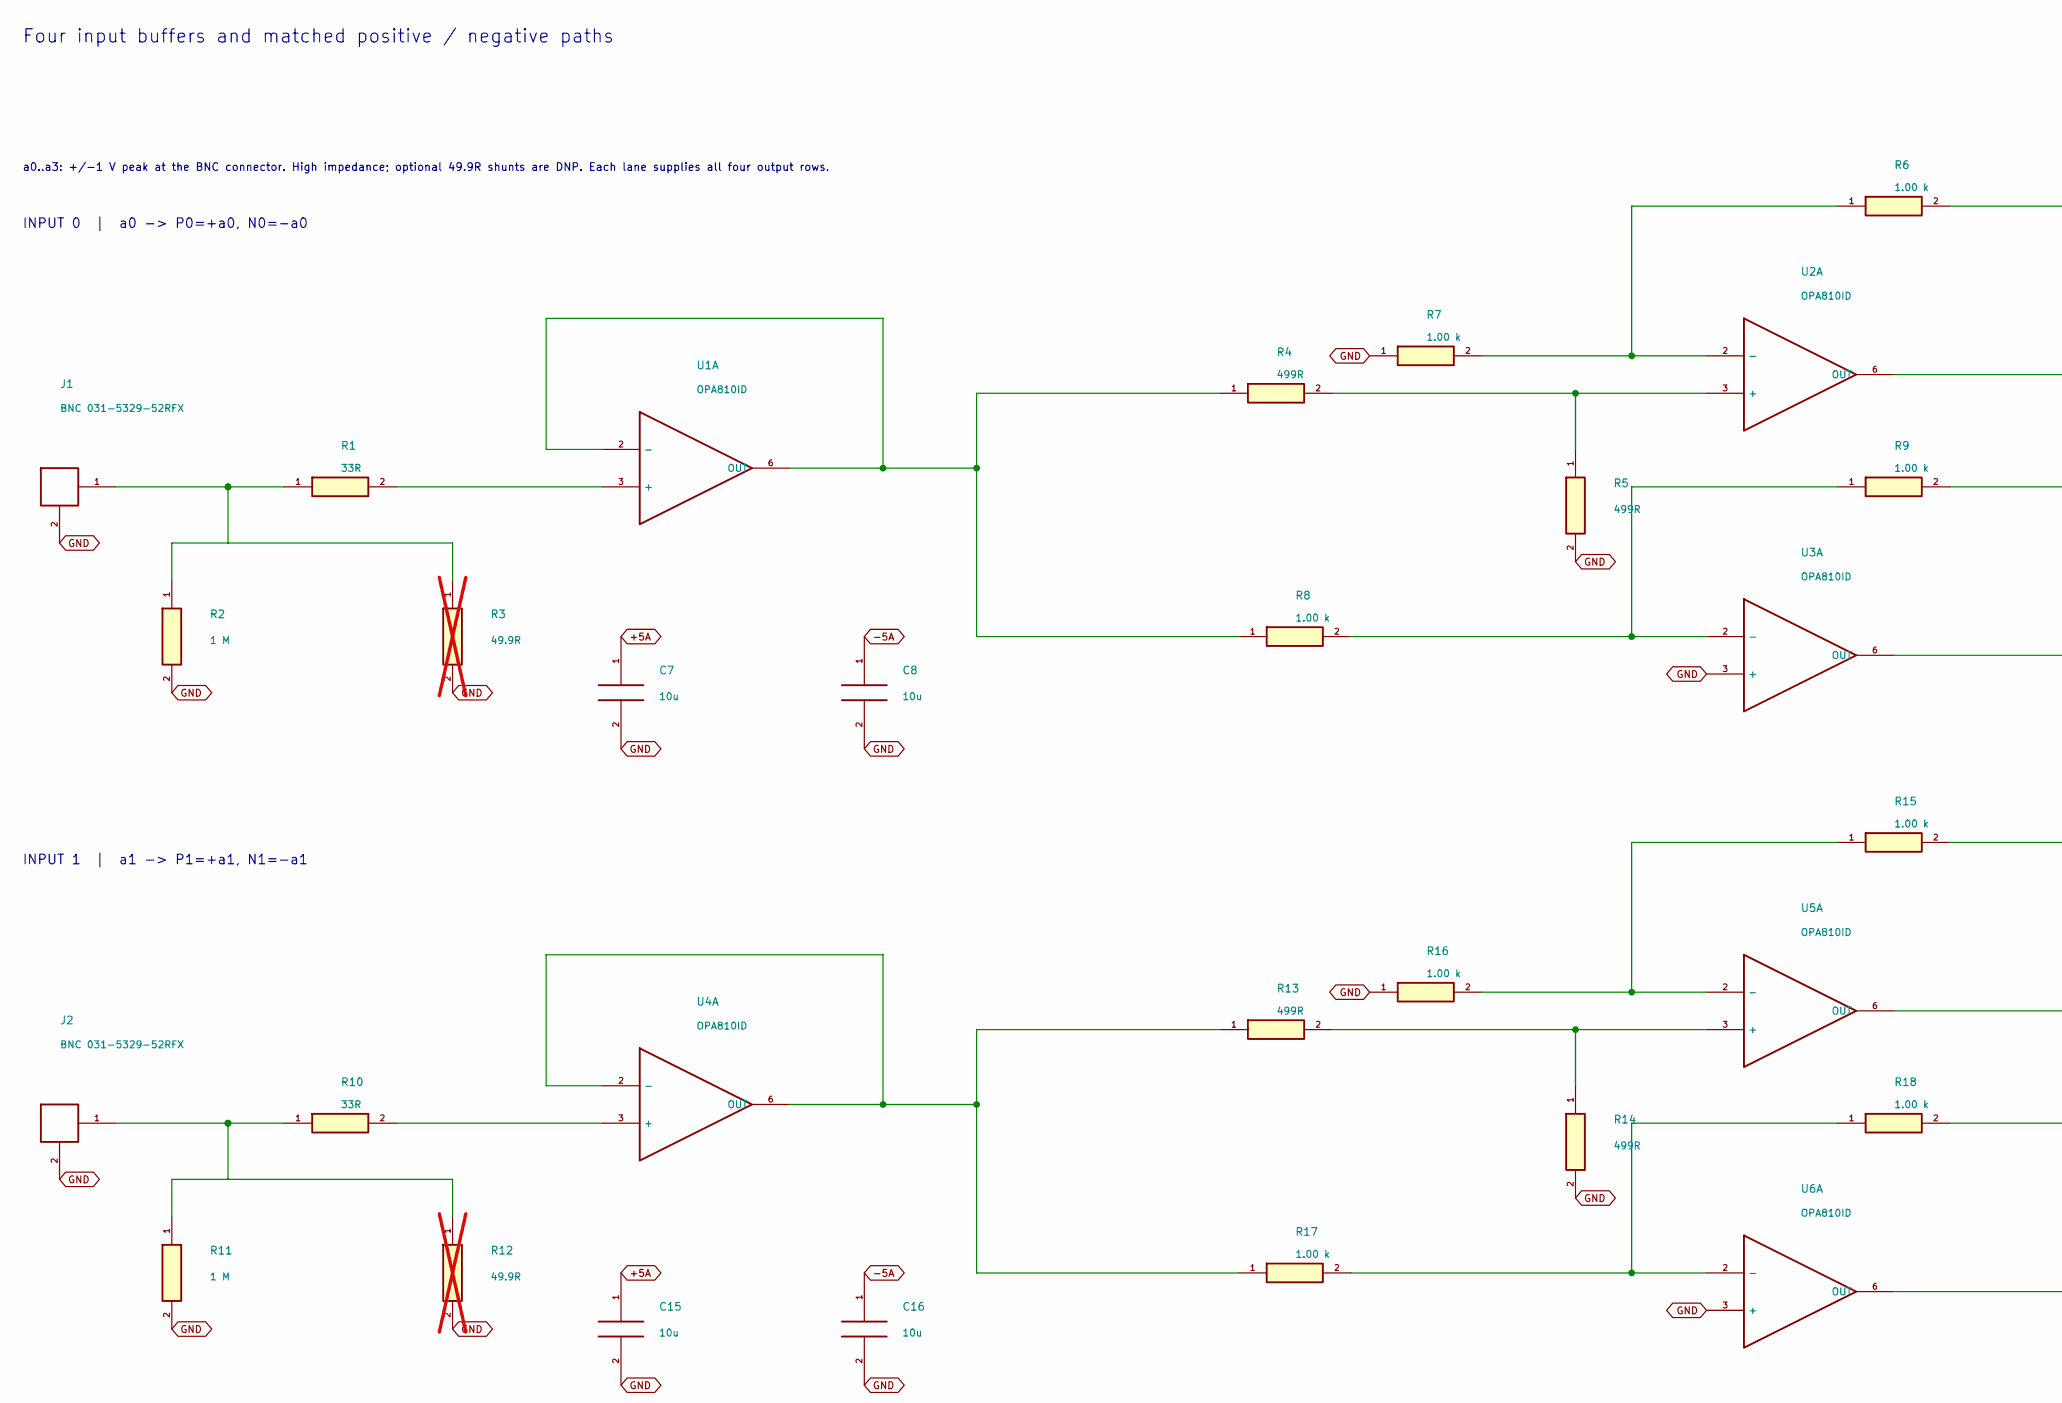
[picture p98: schematic inputs.kicad_sch, Four input buffers and matched positive / negative paths, part in row 1, column 1]

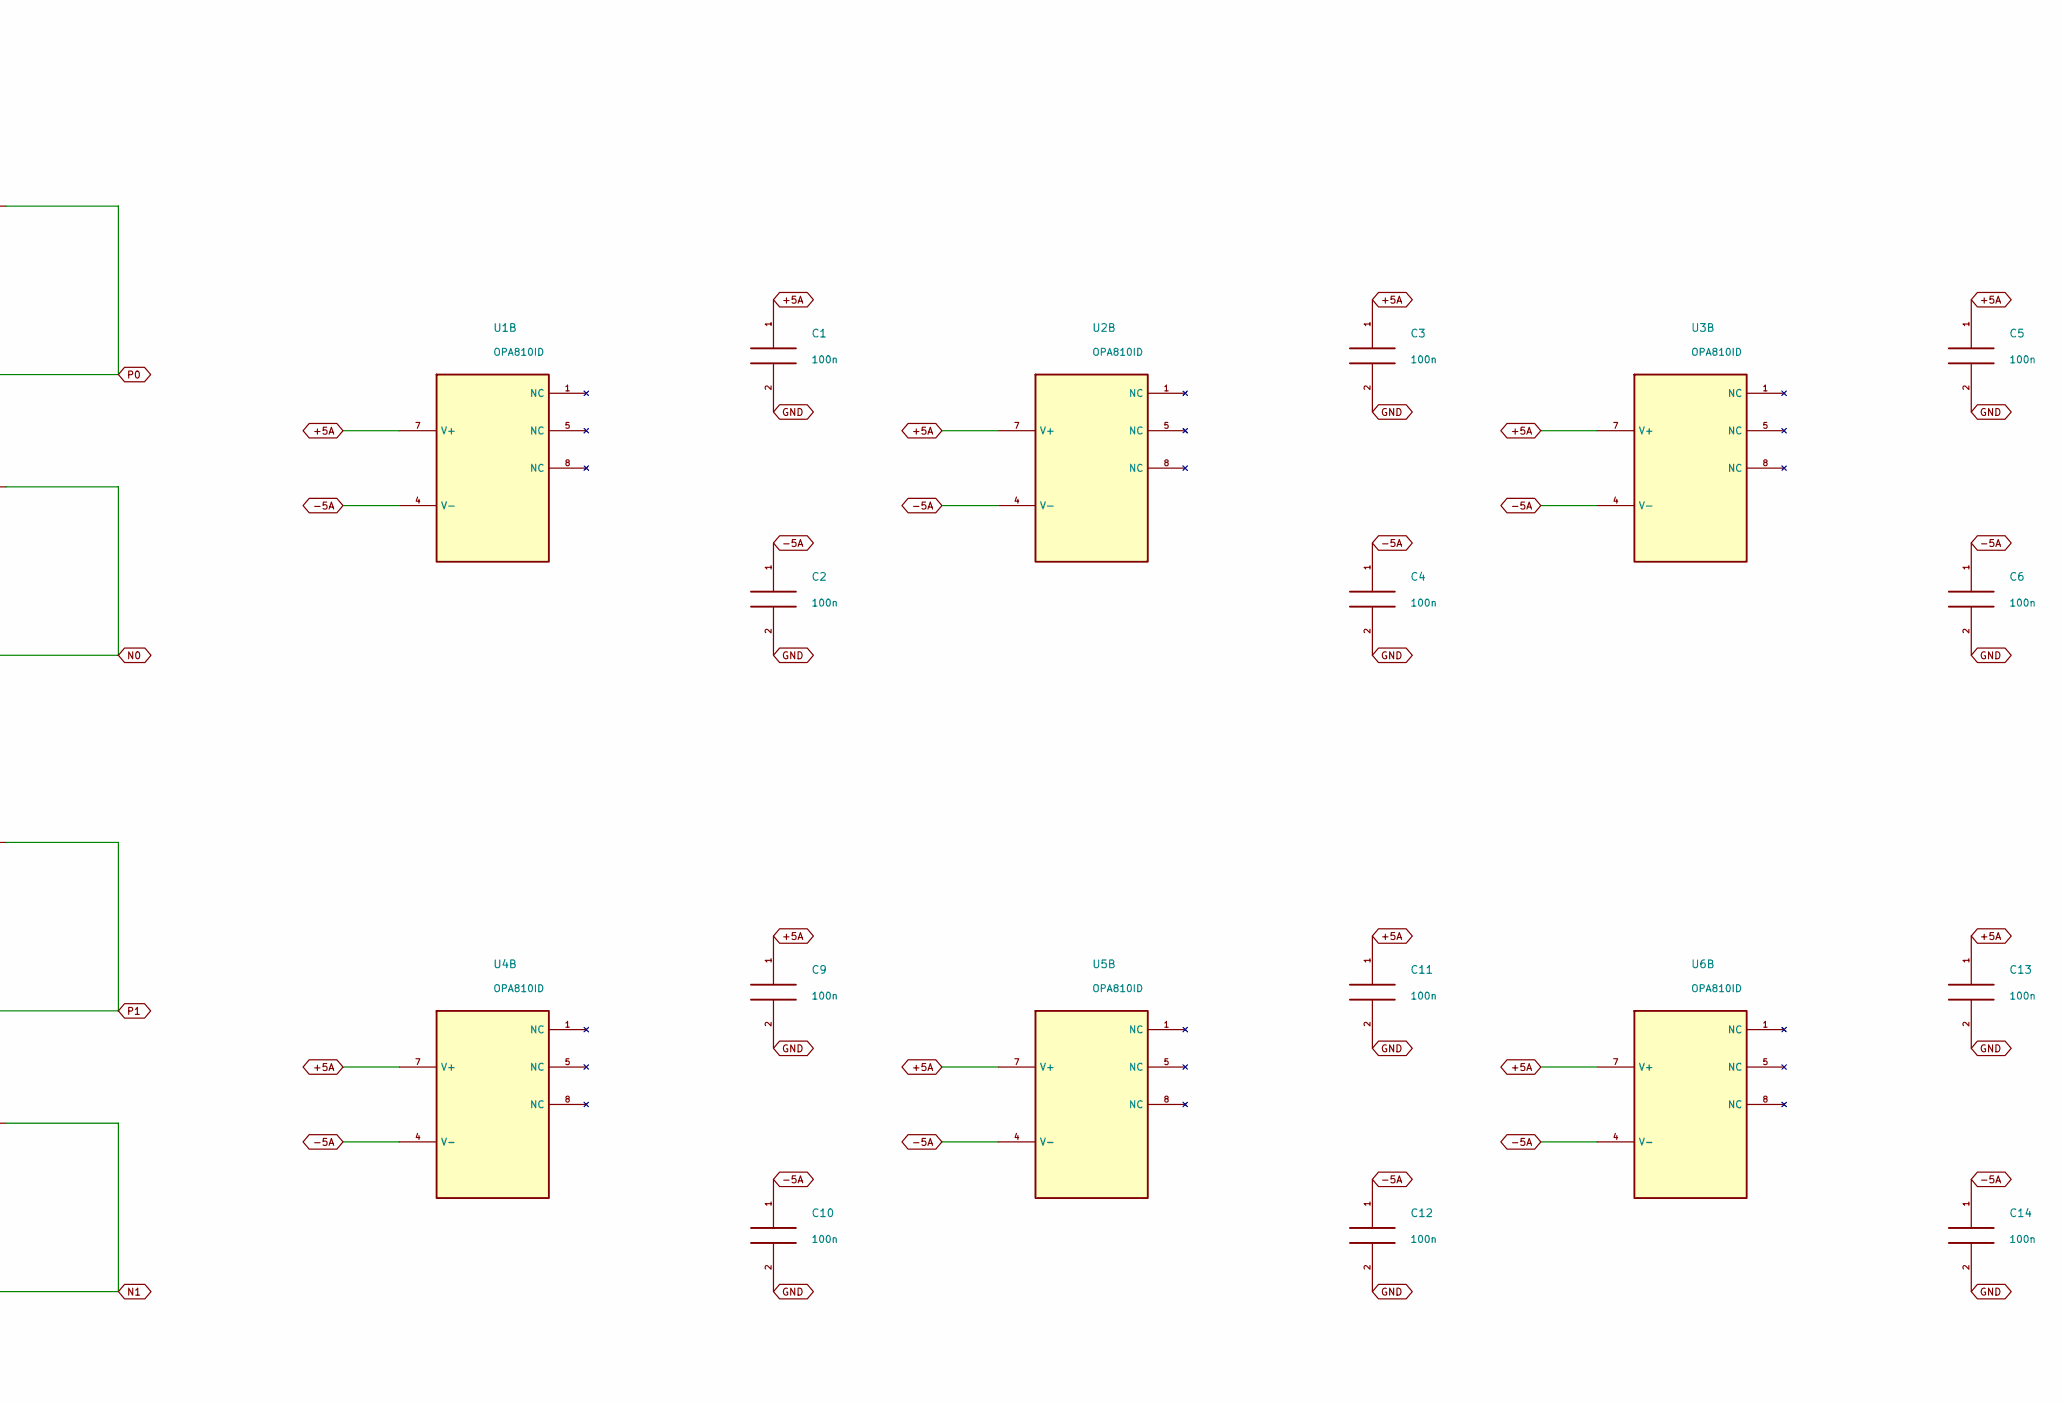
[picture p99: schematic inputs.kicad_sch, Four input buffers and matched positive / negative paths, part in row 1, column 2]

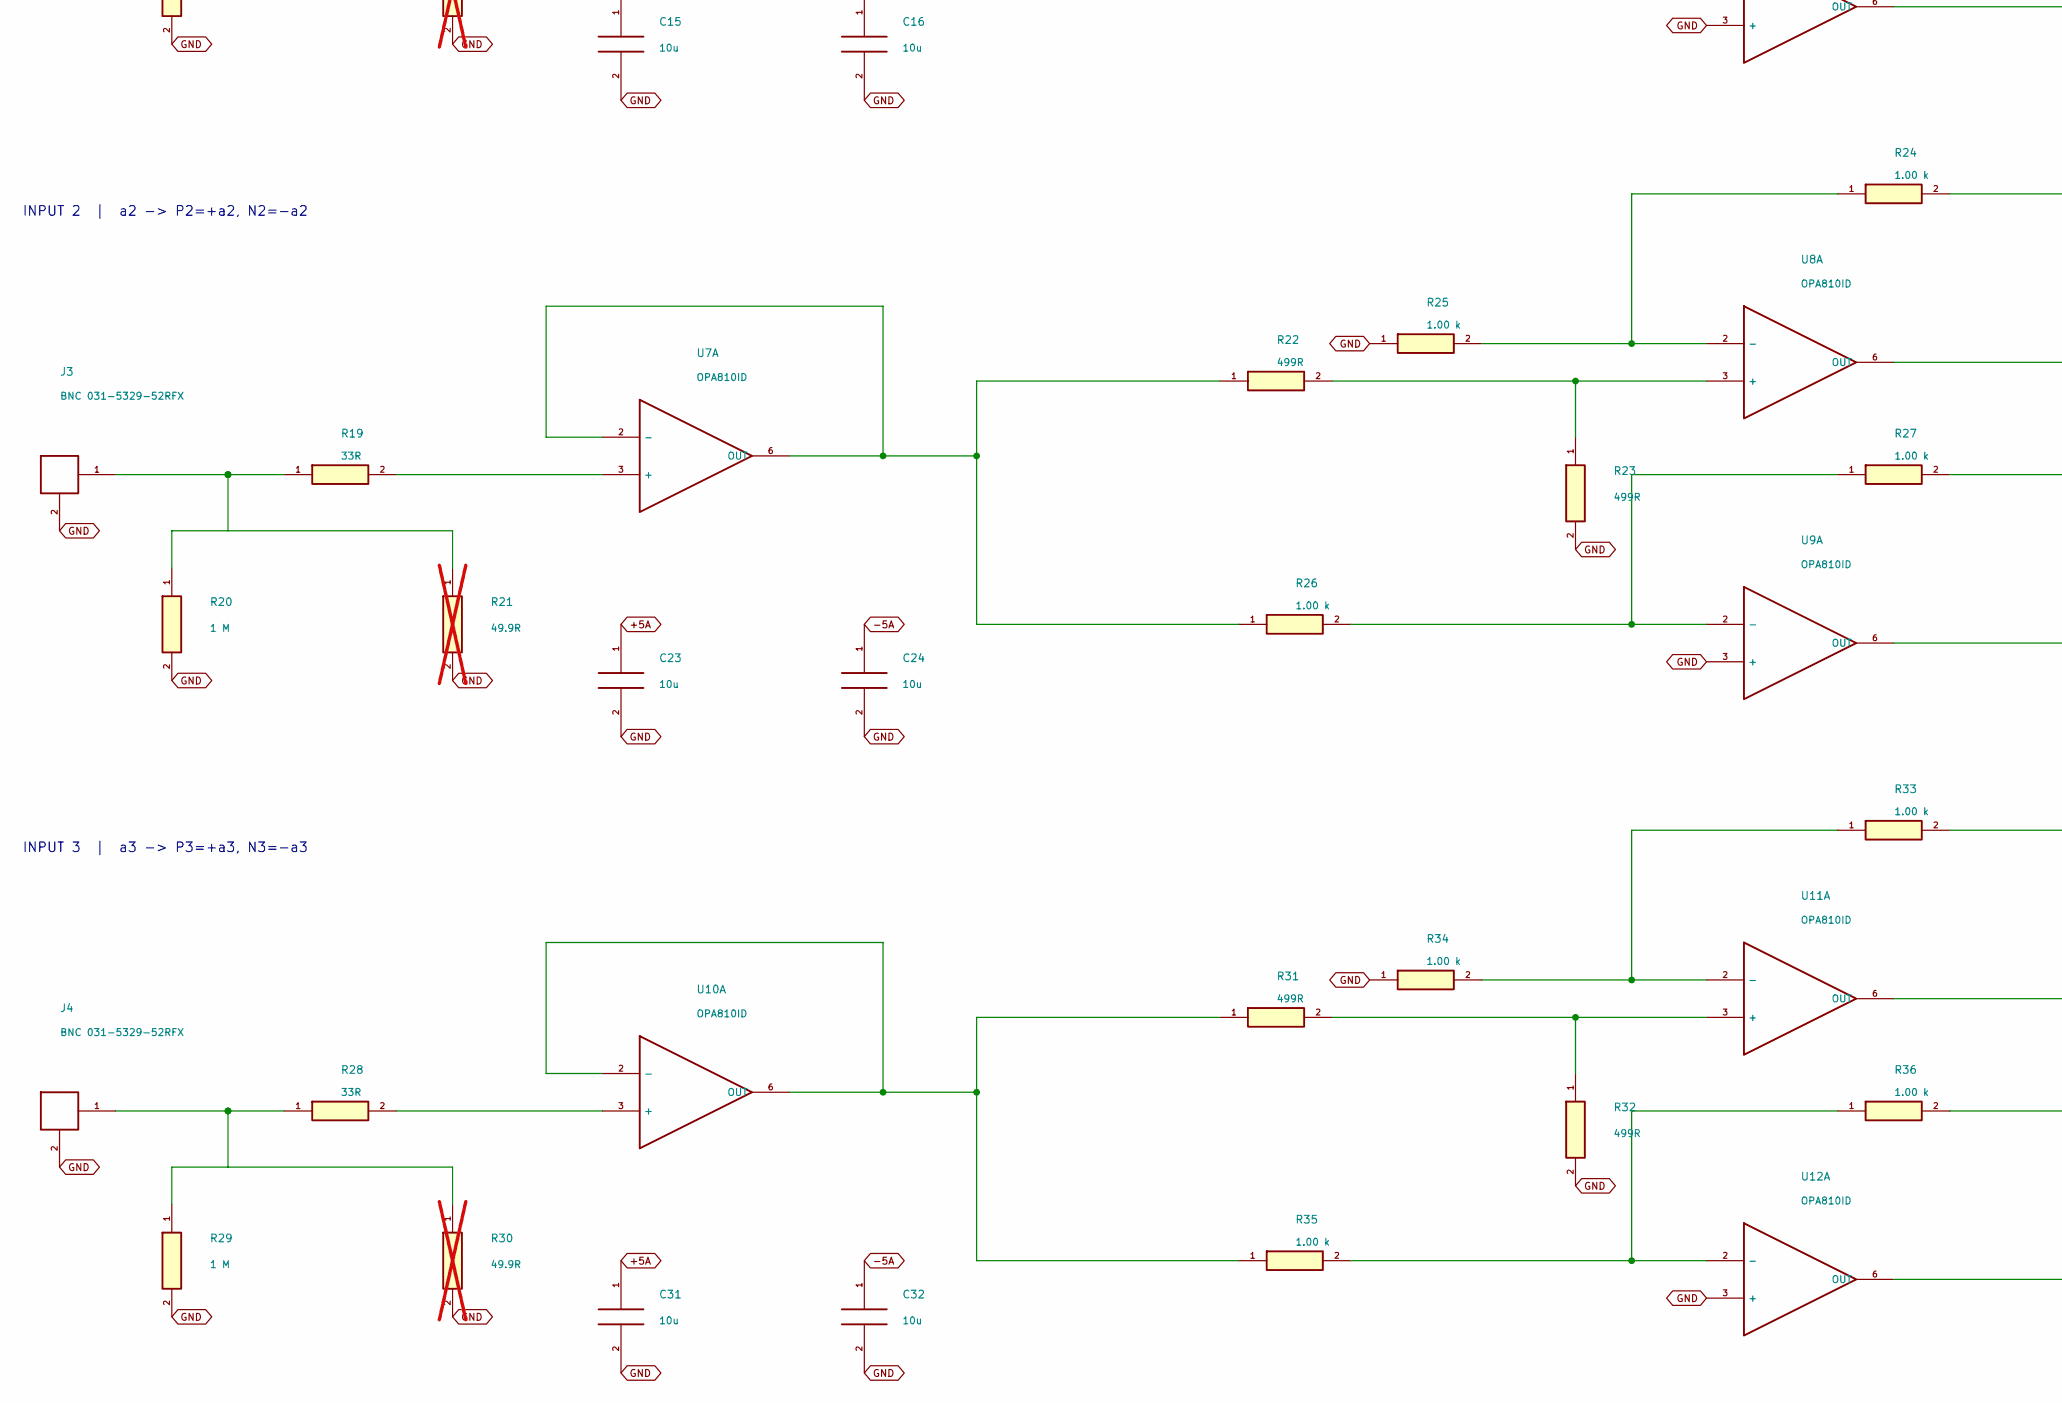
[picture p100: schematic inputs.kicad_sch, Four input buffers and matched positive / negative paths, part in row 2, column 1]

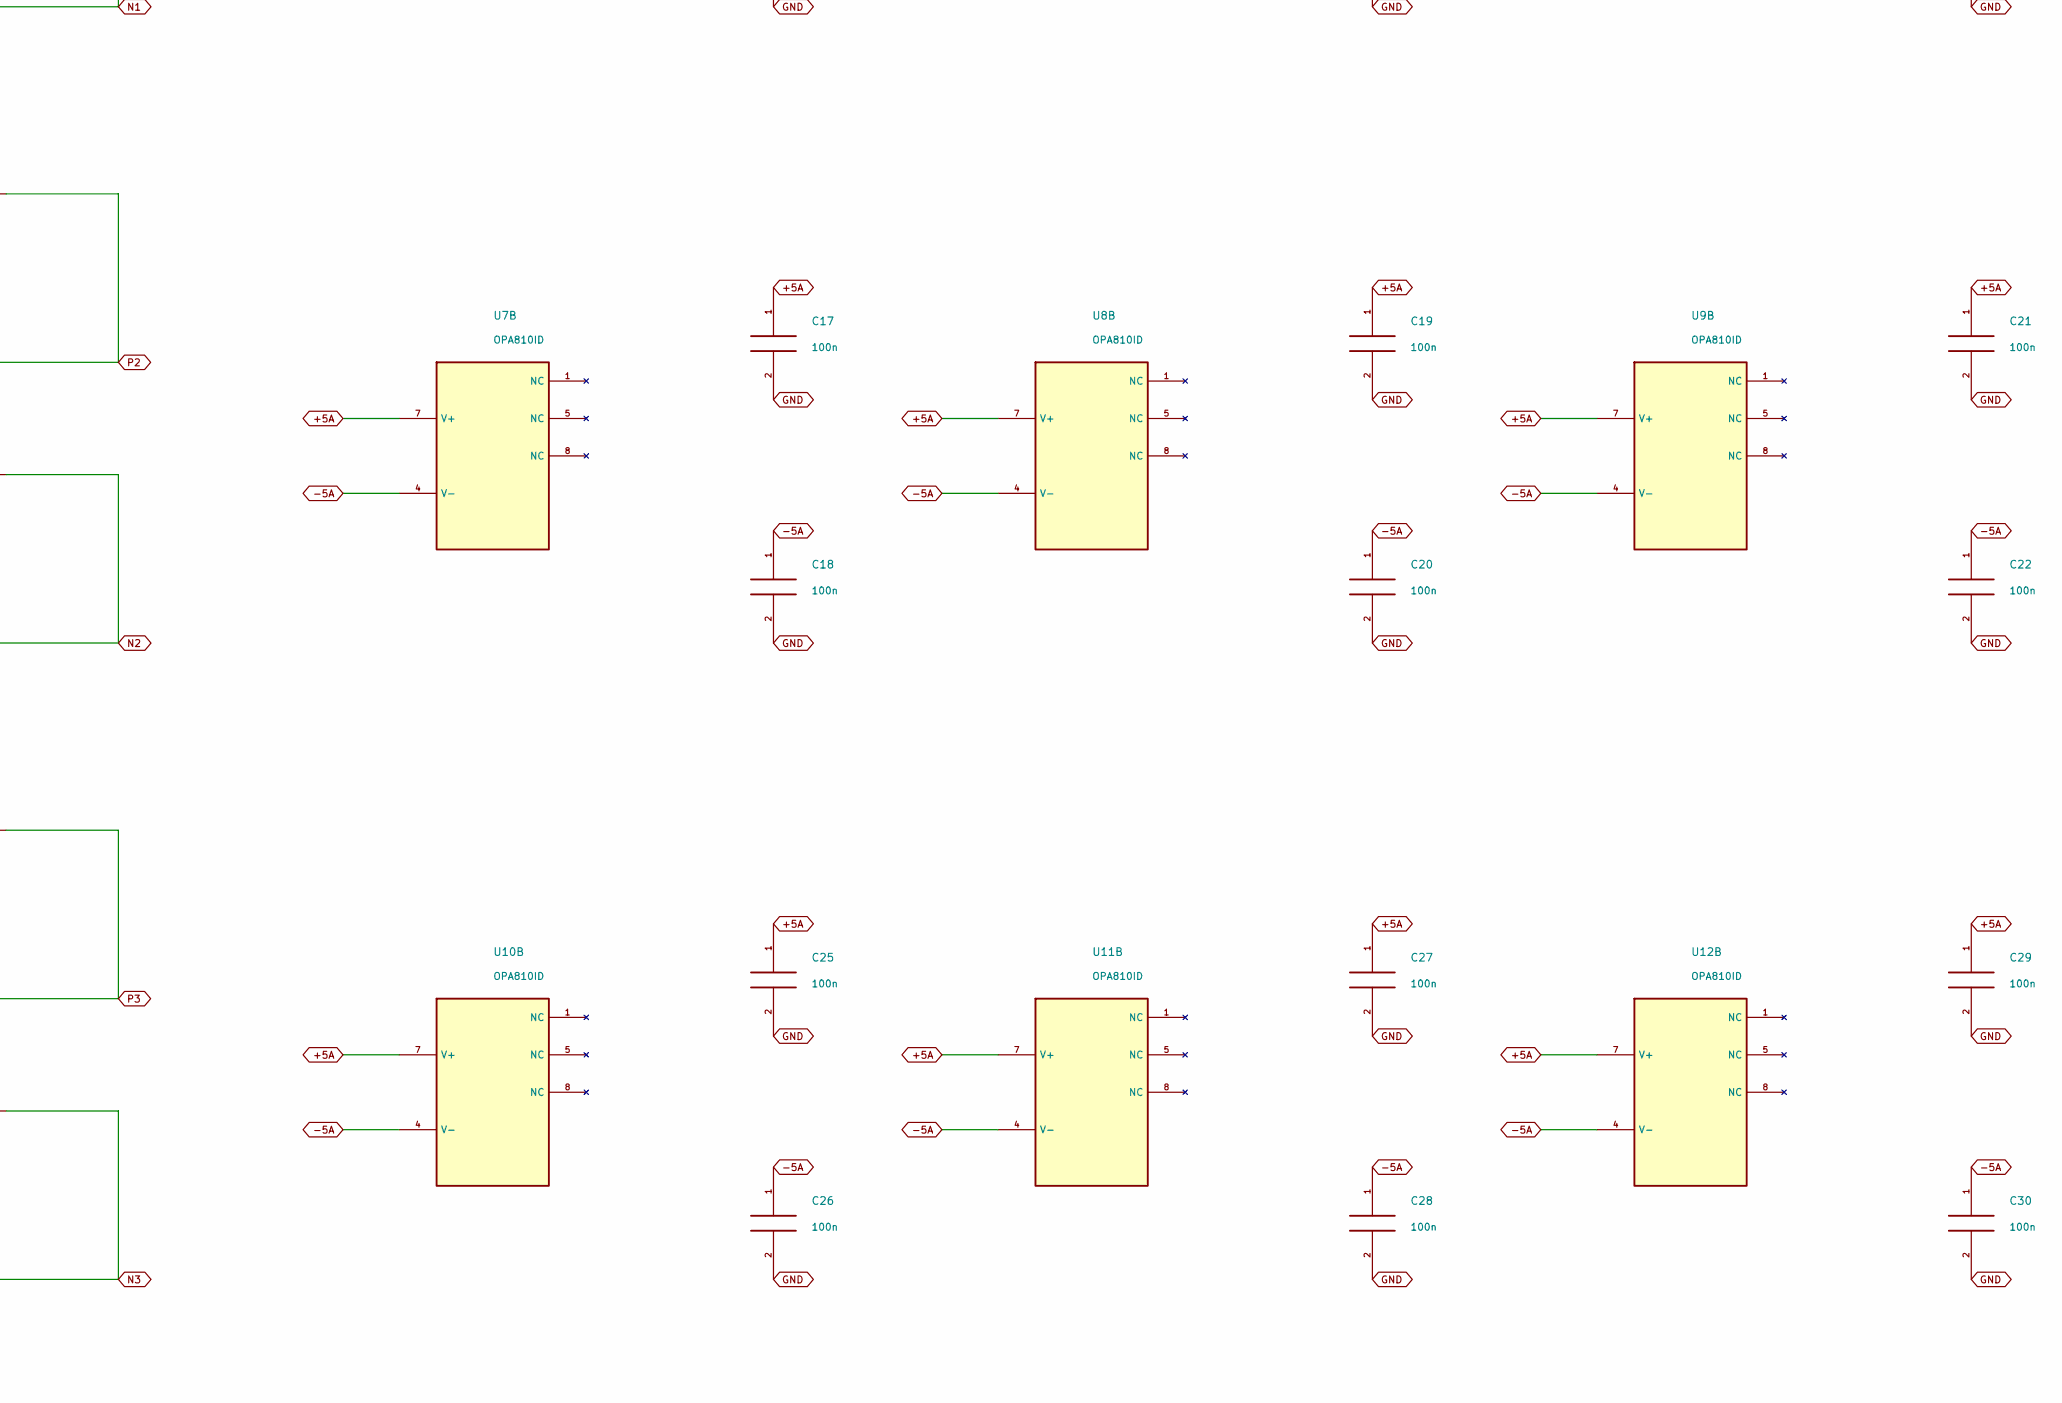
[picture p101: schematic inputs.kicad_sch, Four input buffers and matched positive / negative paths, part in row 2, column 2]

Parts:
C1, C2, C3, C4, C5, C6, C9, C10, C11, C12, C13, C14, C17, C18, C19, C20, C21, C22, C25, C26, C27, C28, C29, C30: 100n; C_0603_1608Metric; Rating 25V X7R minimum; effective C after bias
C7, C8, C15, C16, C23, C24, C31, C32: 10u; C_0805_2012Metric; Rating 25V X7R minimum; effective C after bias
J1, J2, J3, J4: BNC 031-5329-52RFX; BNC_Amphenol_031-5329-52RFX_Vertical
R1, R10, R19, R28: 33R; R_0603_1608Metric; Rating 0.1%, <=25ppm/C; 0.1W minimum
R2, R11, R20, R29: 1 M; R_0603_1608Metric; Rating 0.1%, <=25ppm/C; 0.1W minimum
R3, R12, R21, R30: 49.9R; R_0603_1608Metric; Rating 0.1%, <=25ppm/C; 0.1W minimum; not fitted
R4, R5, R13, R14, R22, R23, R31, R32: 499R; R_0603_1608Metric; Rating 0.1%, <=25ppm/C; 0.1W minimum
R6, R7, R8, R9, R15, R16, R17, R18, R24, R25, R26, R27, R33, R34, R35, R36: 1.00 k; R_0603_1608Metric; Rating 0.1%, <=25ppm/C; 0.1W minimum
U1, U2, U3, U4, U5, U6, U7, U8, U9, U10, U11, U12: OPA810ID; SOIC-8_3.9x4.9mm_P1.27mm

Connections:
+5A: C1.1, C3.1, C5.1, C7.1, C9.1, C11.1, C13.1, C15.1, C17.1, C19.1, C21.1, C23.1, C25.1, C27.1, C29.1, C31.1, U1.7 (V+), U2.7 (V+), U3.7 (V+), U4.7 (V+), U5.7 (V+), U6.7 (V+), U7.7 (V+), U8.7 (V+), U9.7 (V+), U10.7 (V+), U11.7 (V+), U12.7 (V+); also elsewhere on the board
-5A: C2.1, C4.1, C6.1, C8.1, C10.1, C12.1, C14.1, C16.1, C18.1, C20.1, C22.1, C24.1, C26.1, C28.1, C30.1, C32.1, U1.4 (V-), U2.4 (V-), U3.4 (V-), U4.4 (V-), U5.4 (V-), U6.4 (V-), U7.4 (V-), U8.4 (V-), U9.4 (V-), U10.4 (V-), U11.4 (V-), U12.4 (V-); also elsewhere on the board
GND: C1.2, C2.2, C3.2, C4.2, C5.2, C6.2, C7.2, C8.2, C9.2, C10.2, C11.2, C12.2, C13.2, C14.2, C15.2, C16.2, C17.2, C18.2, C19.2, C20.2, C21.2, C22.2, C23.2, C24.2, C25.2, C26.2, C27.2, C28.2, C29.2, C30.2, C31.2, C32.2, J1.2, J2.2, J3.2, J4.2, R2.2, R3.2, R5.2, R7.1, R11.2, R12.2, R14.2, R16.1, R20.2, R21.2, R23.2, R25.1, R29.2, R30.2, R32.2, R34.1, U3.3 (+), U6.3 (+), U9.3 (+), U12.3 (+); also elsewhere on the board
N0: R9.2, U3.6 (OUT); also elsewhere on the board
N1: R18.2, U6.6 (OUT); also elsewhere on the board
N2: R27.2, U9.6 (OUT); also elsewhere on the board
N3: R36.2, U12.6 (OUT); also elsewhere on the board
unnamed: J1.1, R1.1, R2.1, R3.1
unnamed: J2.1, R10.1, R11.1, R12.1
unnamed: J3.1, R19.1, R20.1, R21.1
unnamed: J4.1, R28.1, R29.1, R30.1
unnamed: R1.2, U1.3 (+)
unnamed: R4.1, R8.1, U1.2 (-), U1.6 (OUT)
unnamed: R4.2, R5.1, U2.3 (+)
unnamed: R6.1, R7.2, U2.2 (-)
unnamed: R8.2, R9.1, U3.2 (-)
unnamed: R10.2, U4.3 (+)
unnamed: R13.1, R17.1, U4.2 (-), U4.6 (OUT)
unnamed: R13.2, R14.1, U5.3 (+)
unnamed: R15.1, R16.2, U5.2 (-)
unnamed: R17.2, R18.1, U6.2 (-)
unnamed: R19.2, U7.3 (+)
unnamed: R22.1, R26.1, U7.2 (-), U7.6 (OUT)
unnamed: R22.2, R23.1, U8.3 (+)
unnamed: R24.1, R25.2, U8.2 (-)
unnamed: R26.2, R27.1, U9.2 (-)
unnamed: R28.2, U10.3 (+)
unnamed: R31.1, R35.1, U10.2 (-), U10.6 (OUT)
unnamed: R31.2, R32.1, U11.3 (+)
unnamed: R33.1, R34.2, U11.2 (-)
unnamed: R35.2, R36.1, U12.2 (-)
P0: R6.2, U2.6 (OUT); also elsewhere on the board
P1: R15.2, U5.6 (OUT); also elsewhere on the board
P2: R24.2, U8.6 (OUT); also elsewhere on the board
P3: R33.2, U11.6 (OUT); also elsewhere on the board

Notes on the sheet:
Four input buffers and matched positive / negative paths
a0..a3: +/-1 V peak at the BNC connector. High impedance; optional 49.9R shunts are DNP. Each lane supplies all four output rows.
INPUT 0 | a0 -> P0=+a0, N0=-a0
INPUT 1 | a1 -> P1=+a1, N1=-a1
INPUT 2 | a2 -> P2=+a2, N2=-a2
INPUT 3 | a3 -> P3=+a3, N3=-a3
