tim4431/analog_programmable_matrix/pcb/analog_matrix_4x4_rev_d/analog_matrix_4x4.kicad_pcb

## KiCad design pcb/analog_matrix_4x4_rev_d/analog_matrix_4x4.kicad_pcb (continued)

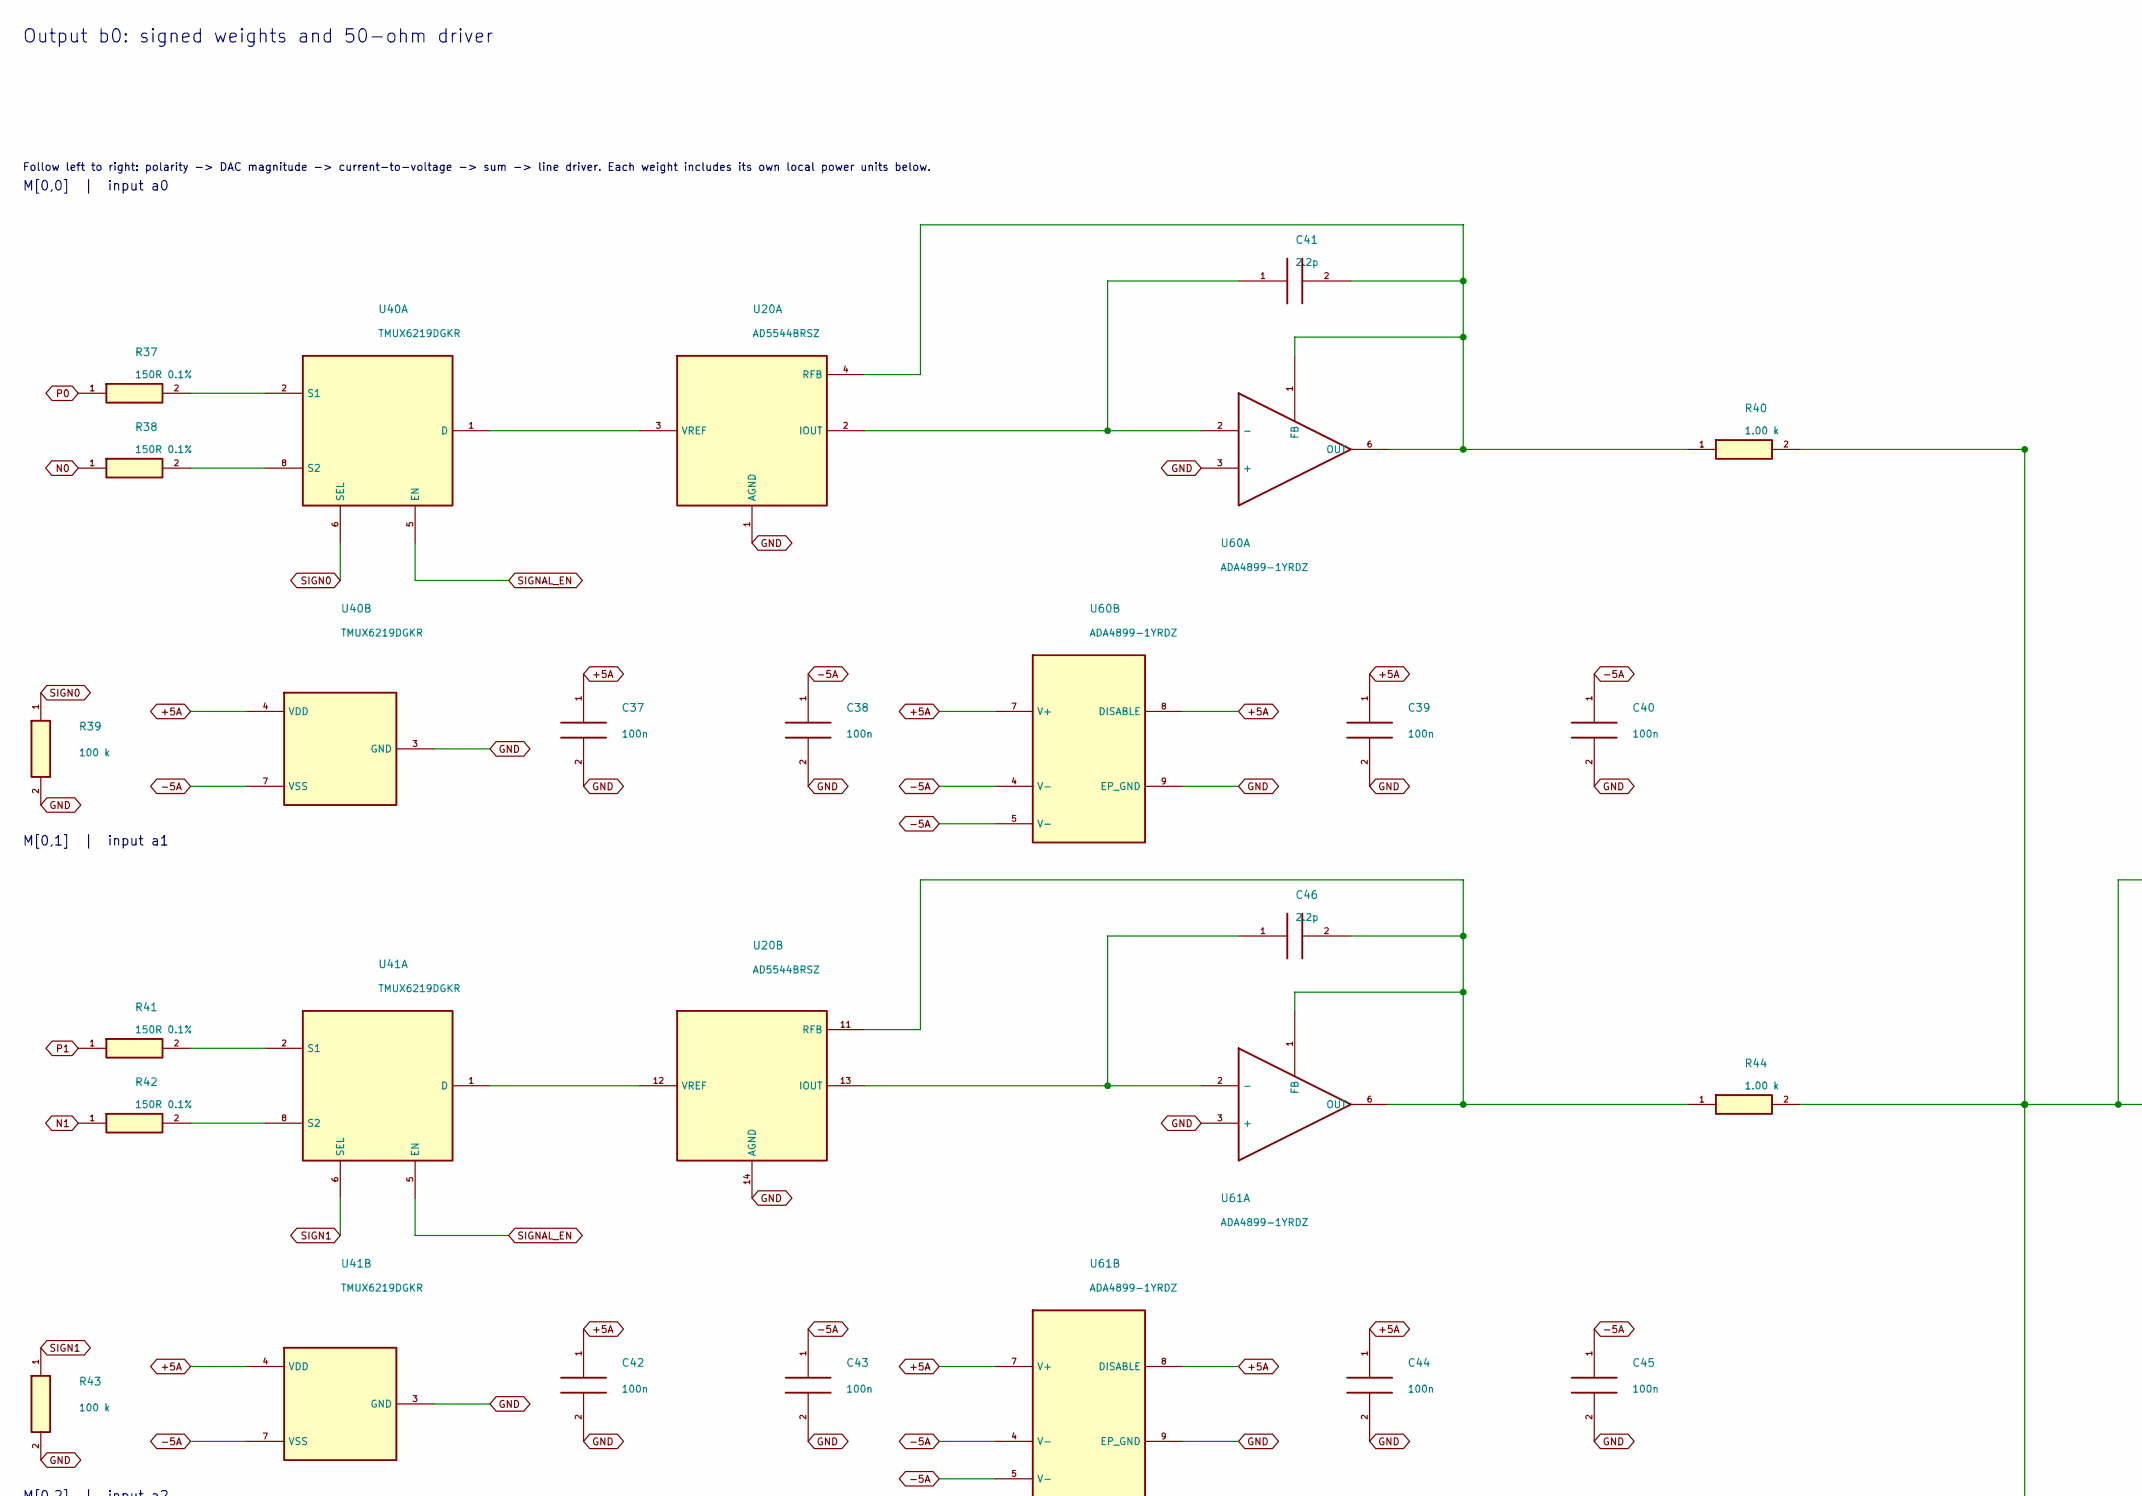
[picture p102: schematic row_0.kicad_sch, Output b0: signed weights and 50-ohm driver, part in row 1, column 1]

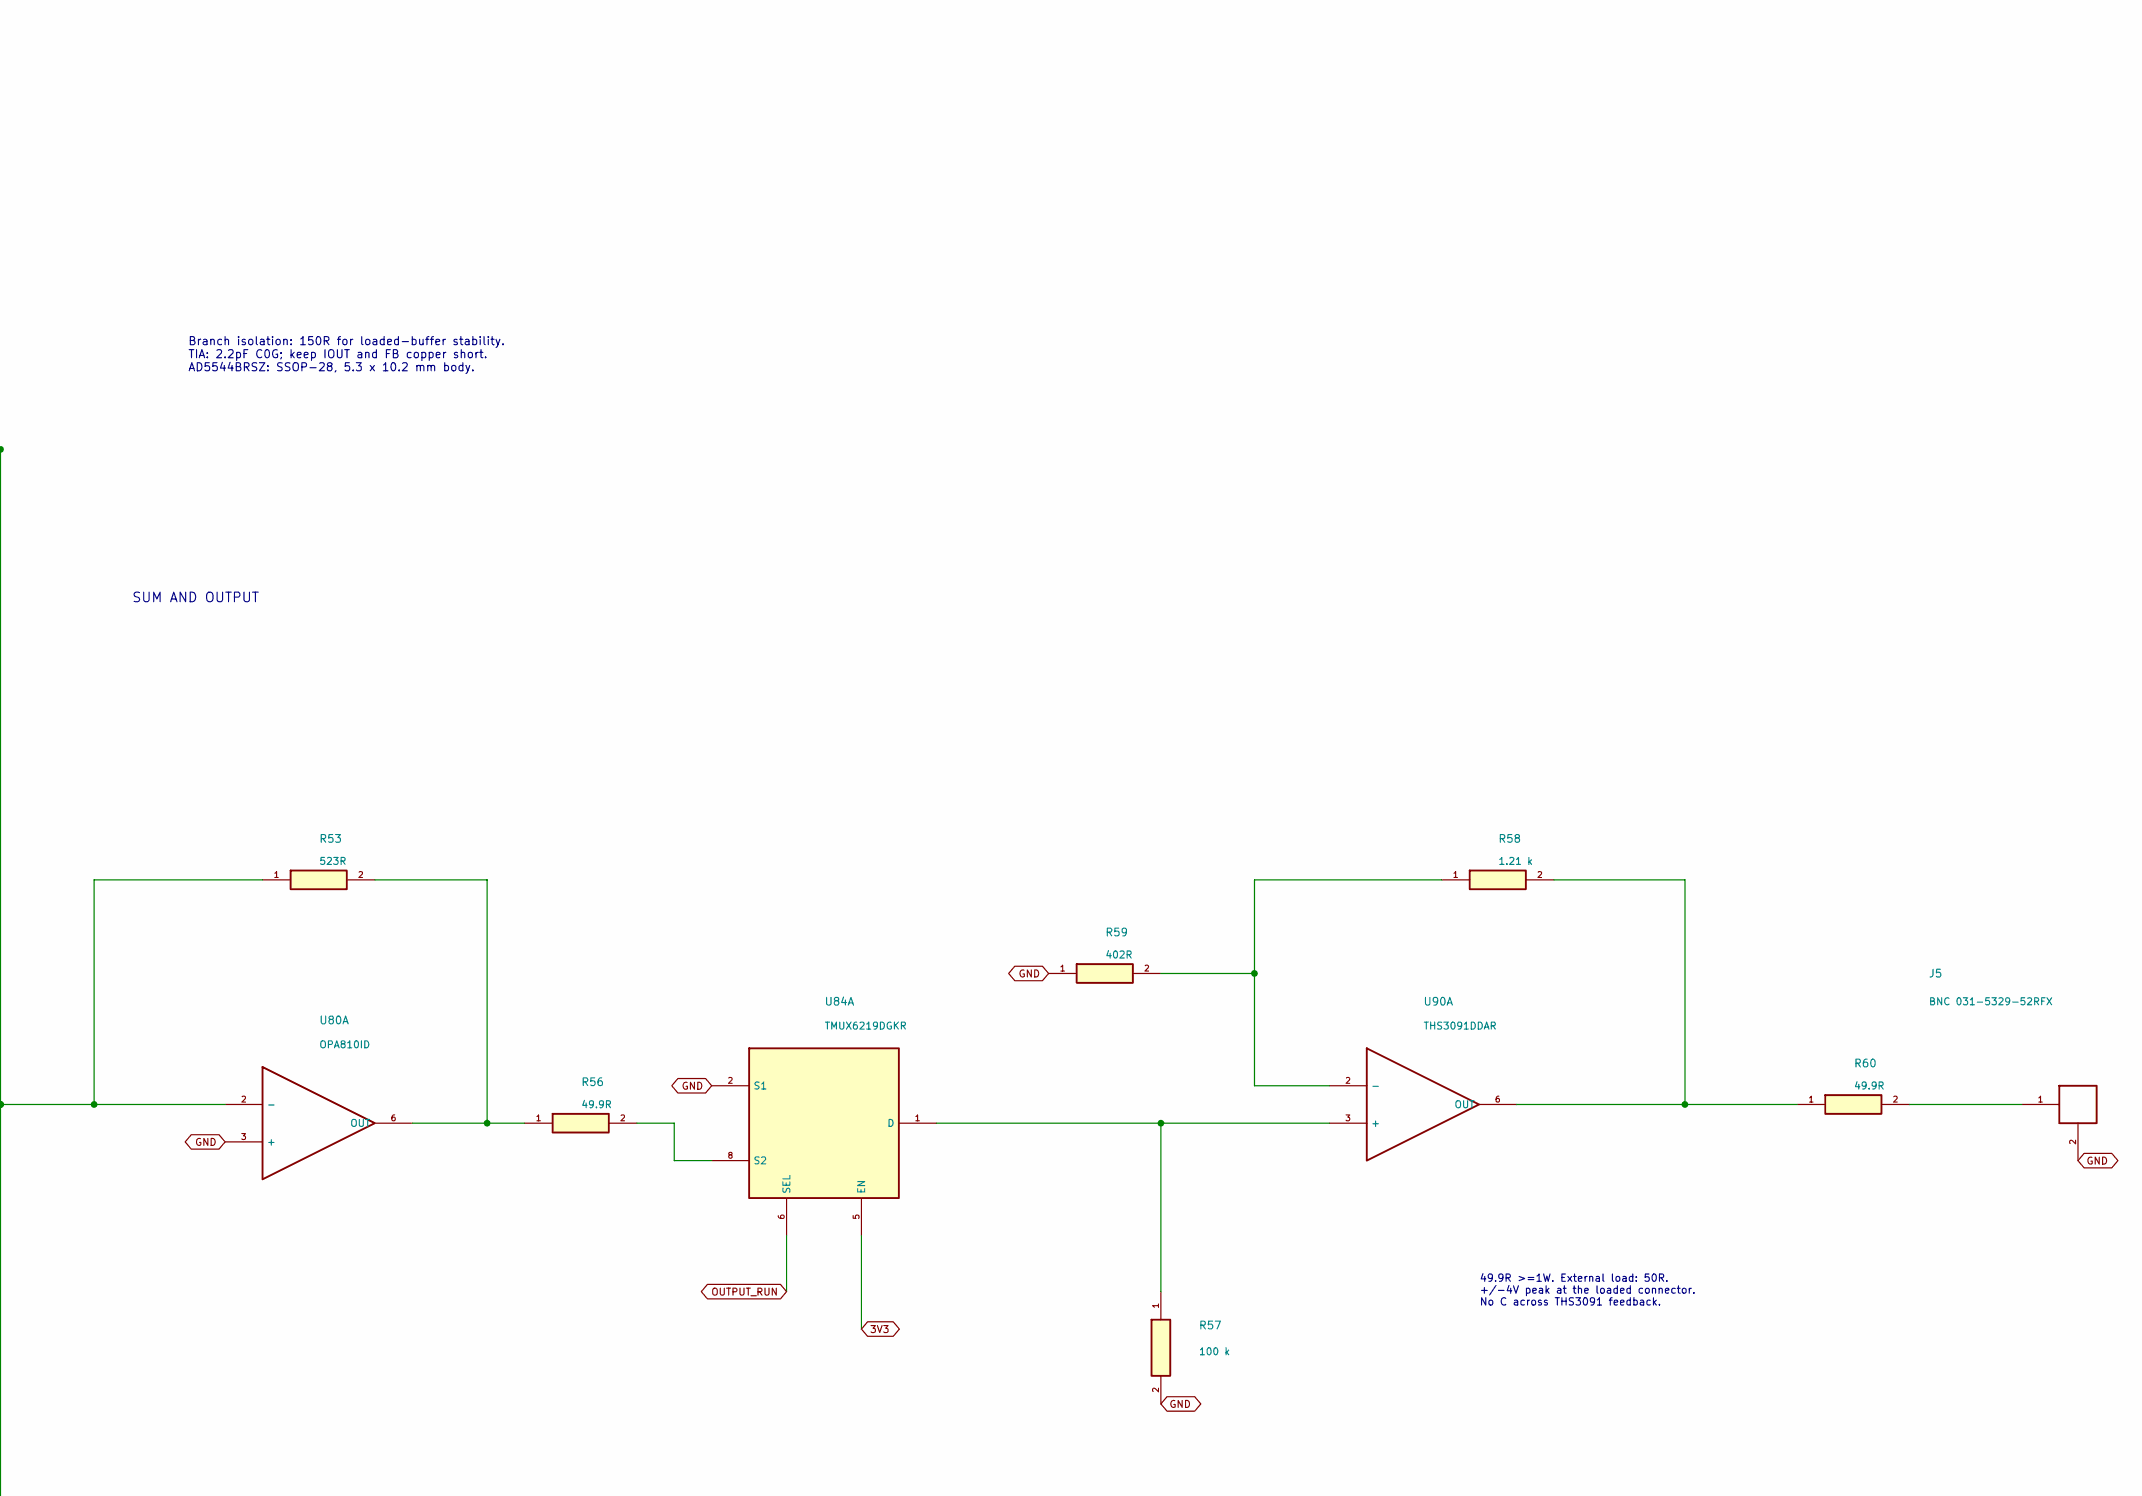
[picture p103: schematic row_0.kicad_sch, Output b0: signed weights and 50-ohm driver, part in row 1, column 2]

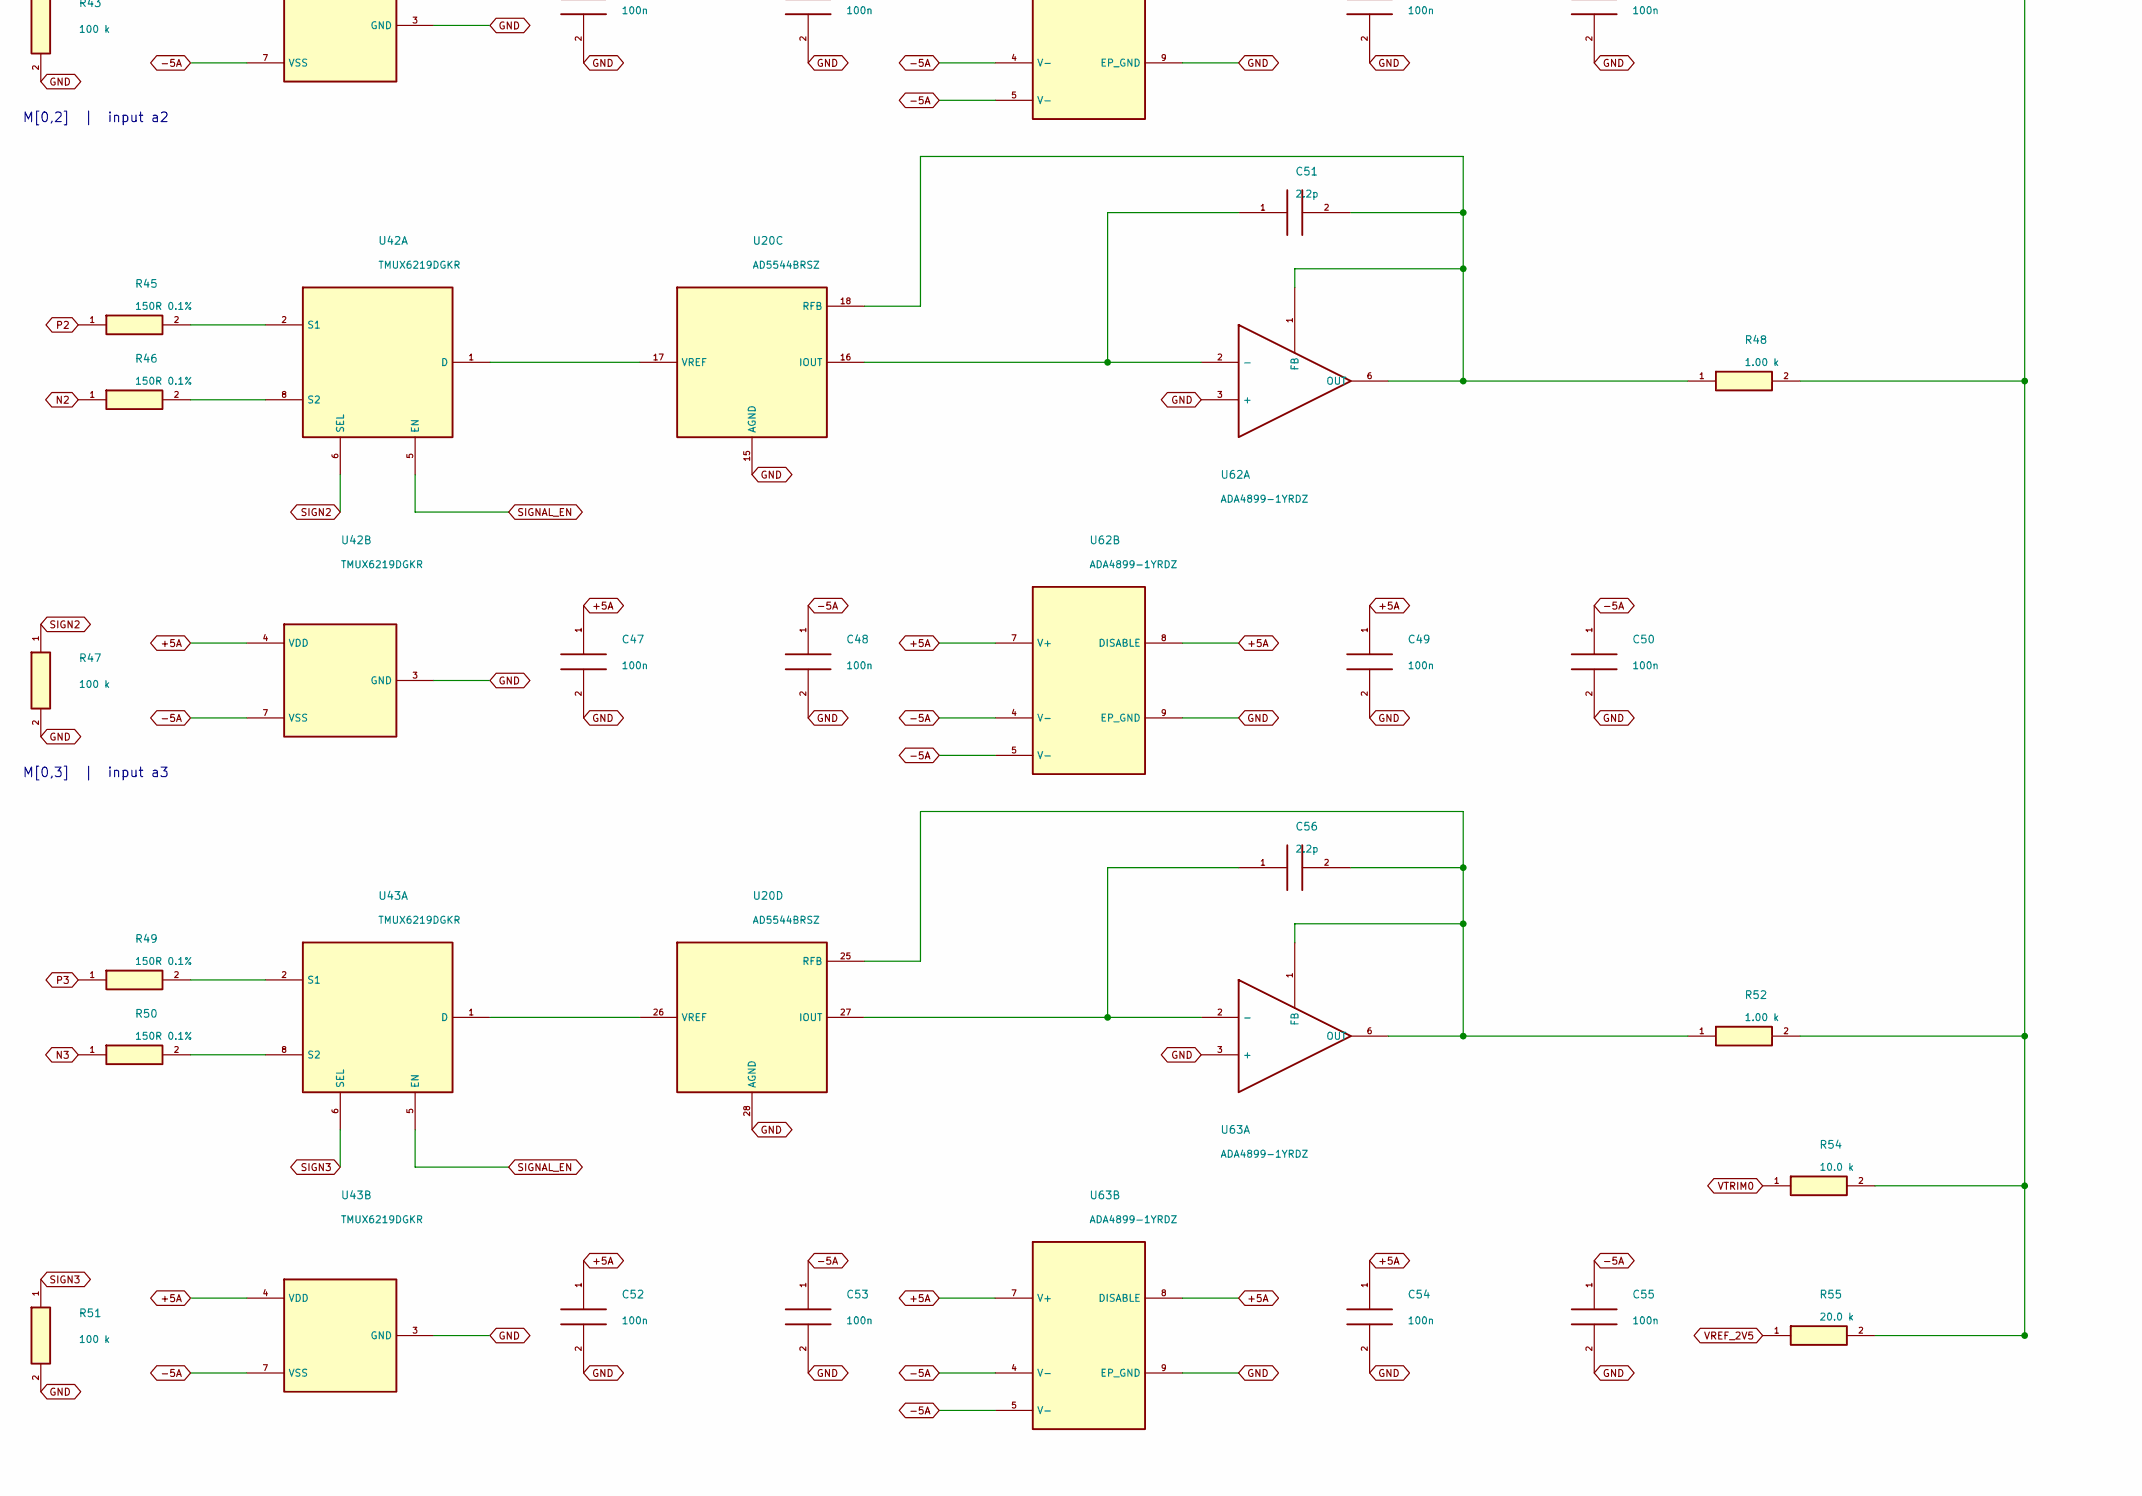
[picture p104: schematic row_0.kicad_sch, Output b0: signed weights and 50-ohm driver, part in row 2, column 1]

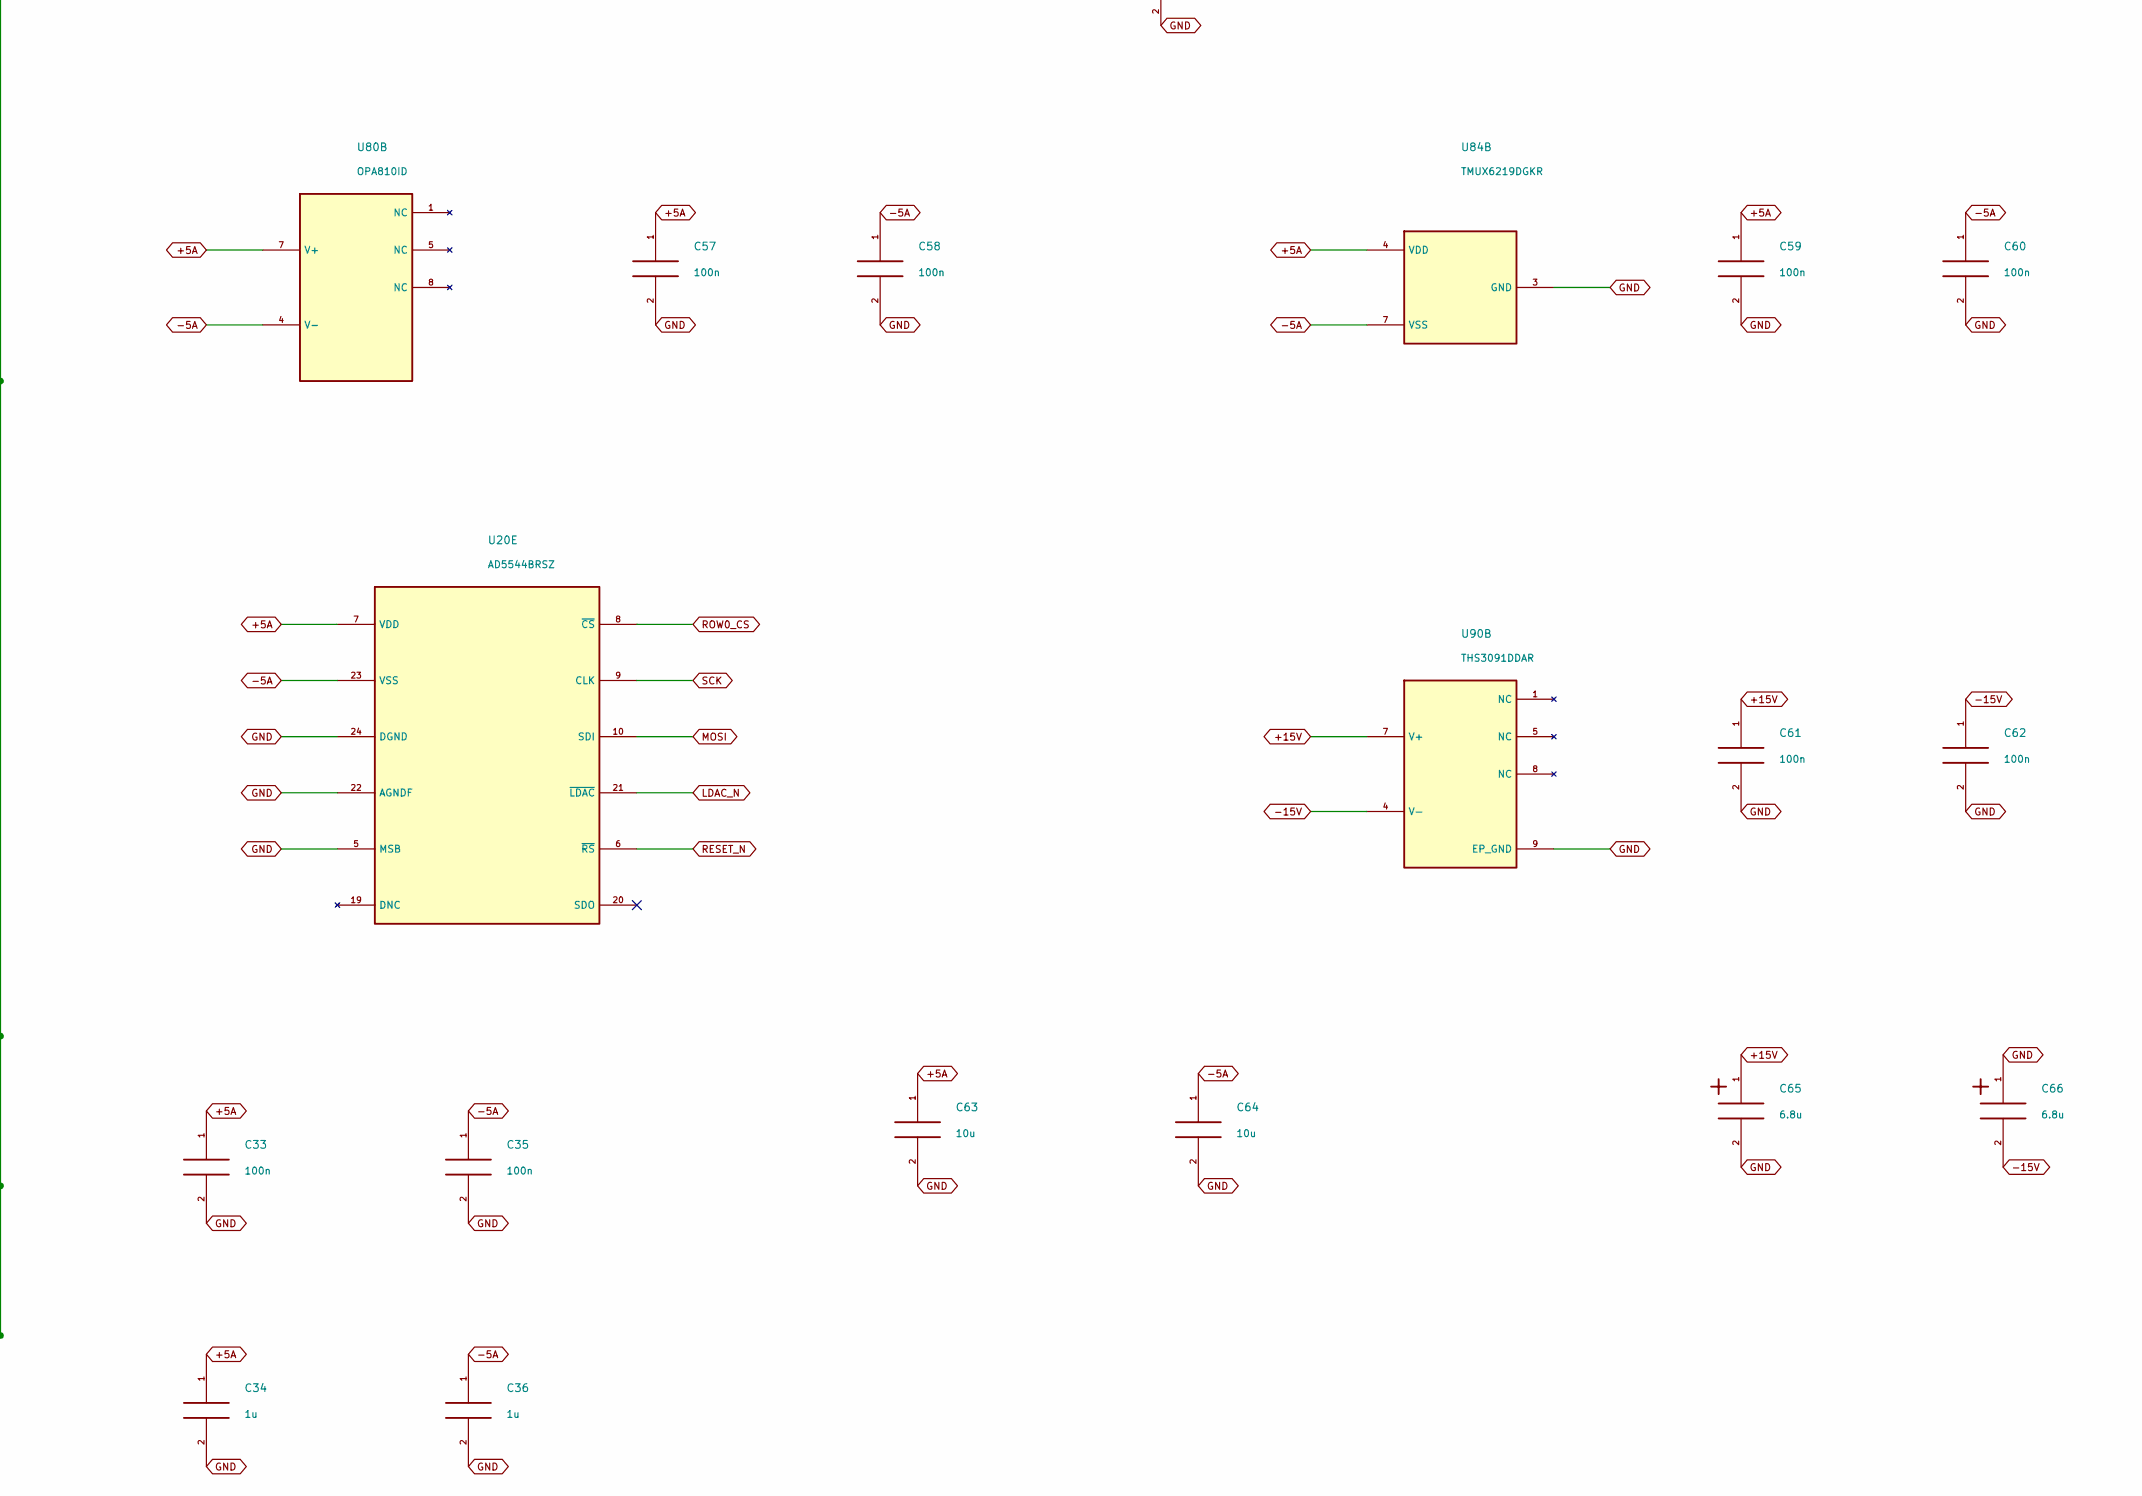
[picture p105: schematic row_0.kicad_sch, Output b0: signed weights and 50-ohm driver, part in row 2, column 2]

Parts:
C33, C35, C37, C38, C39, C40, C42, C43, C44, C45, C47, C48, C49, C50, C52, C53, C54, C55, C57, C58, C59, C60, C61, C62: 100n; C_0603_1608Metric; Rating 25V X7R minimum; effective C after bias
C34, C36: 1u; C_0805_2012Metric; Rating 25V X7R minimum; effective C after bias
C41, C46, C51, C56: 2.2p; C_0402_1005Metric; Rating 50V C0G
C63, C64: 10u; C_0805_2012Metric; Rating 25V X7R minimum; effective C after bias
C65, C66: 6.8u; CP_EIA-3216-18_Kemet-A; Rating 25V polarized
J5: BNC 031-5329-52RFX; BNC_Amphenol_031-5329-52RFX_Vertical
R37, R38, R41, R42, R45, R46, R49, R50: 150R 0.1%; R_0603_1608Metric; Rating 0.1%, <=25ppm/C; 0.1W minimum
R39, R43, R47, R51, R57: 100 k; R_0603_1608Metric; Rating 0.1%, <=25ppm/C; 0.1W minimum
R40, R44, R48, R52: 1.00 k; R_0603_1608Metric; Rating 0.1%, <=25ppm/C; 0.1W minimum
R53: 523R; R_0603_1608Metric; Rating 0.1%, <=25ppm/C; 0.1W minimum
R54: 10.0 k; R_0603_1608Metric; Rating 0.1%, <=25ppm/C; 0.1W minimum
R55: 20.0 k; R_0603_1608Metric; Rating 0.1%, <=25ppm/C; 0.1W minimum
R56: 49.9R; R_0603_1608Metric; Rating 0.1%, <=25ppm/C; 0.1W minimum
R58: 1.21 k; R_0603_1608Metric; Rating 0.1%, <=25ppm/C; 0.1W minimum
R59: 402R; R_0603_1608Metric; Rating 0.1%, <=25ppm/C; 0.1W minimum
R60: 49.9R; R_2512_6332Metric; Rating 0.1%, <=25ppm/C; >=1W
U20: AD5544BRSZ; SSOP-28_5.3x10.2mm_P0.65mm
U40, U41, U42, U43, U84: TMUX6219DGKR; VSSOP-8_3x3mm_P0.65mm
U60, U61, U62, U63: ADA4899-1YRDZ; ADA4899_RD8_EP2.29x2.29
U80: OPA810ID; SOIC-8_3.9x4.9mm_P1.27mm
U90: THS3091DDAR; SOIC-8-1EP_3.9x4.9mm_P1.27mm_EP2.95x4.9mm_Mask2.71x3.4mm_Th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

Connections:
3V3: U84.5 (EN); also elsewhere on the board
+5A: C33.1, C34.1, C37.1, C39.1, C42.1, C44.1, C47.1, C49.1, C52.1, C54.1, C57.1, C59.1, C63.1, U20.7 (VDD), U40.4 (VDD), U41.4 (VDD), U42.4 (VDD), U43.4 (VDD), U60.7 (V+), U60.8 (DISABLE), U61.7 (V+), U61.8 (DISABLE), U62.7 (V+), U62.8 (DISABLE), U63.7 (V+), U63.8 (DISABLE), U80.7 (V+), U84.4 (VDD); also elsewhere on the board
+15V: C61.1, C65.1, U90.7 (V+); also elsewhere on the board
-5A: C35.1, C36.1, C38.1, C40.1, C43.1, C45.1, C48.1, C50.1, C53.1, C55.1, C58.1, C60.1, C64.1, U20.23 (VSS), U40.7 (VSS), U41.7 (VSS), U42.7 (VSS), U43.7 (VSS), U60.4 (V-), U60.5 (V-), U61.4 (V-), U61.5 (V-), U62.4 (V-), U62.5 (V-), U63.4 (V-), U63.5 (V-), U80.4 (V-), U84.7 (VSS); also elsewhere on the board
-15V: C62.1, C66.2, U90.4 (V-); also elsewhere on the board
GND: C33.2, C34.2, C35.2, C36.2, C37.2, C38.2, C39.2, C40.2, C42.2, C43.2, C44.2, C45.2, C47.2, C48.2, C49.2, C50.2, C52.2, C53.2, C54.2, C55.2, C57.2, C58.2, C59.2, C60.2, C61.2, C62.2, C63.2, C64.2, C65.2, C66.1, J5.2, R39.2, R43.2, R47.2, R51.2, R57.2, R59.1, U20.1 (AGND), U20.5 (MSB), U20.14 (AGND), U20.15 (AGND), U20.22 (AGNDF), U20.24 (DGND), U20.28 (AGND), U40.3 (GND), U41.3 (GND), U42.3 (GND), U43.3 (GND), U60.3 (+), U60.9 (EP_GND), U61.3 (+), U61.9 (EP_GND), U62.3 (+), U62.9 (EP_GND), U63.3 (+), U63.9 (EP_GND), U80.3 (+), U84.2 (S1), U84.3 (GND), U90.9 (EP_GND); also elsewhere on the board
LDAC_N: U20.21 (~LDAC); also elsewhere on the board
MOSI: U20.10 (SDI); also elsewhere on the board
N0: R38.1; also elsewhere on the board
N1: R42.1; also elsewhere on the board
N2: R46.1; also elsewhere on the board
N3: R50.1; also elsewhere on the board
unnamed: J5.1, R60.2
unnamed: C41.1, U20.2 (IOUT), U60.2 (-)
unnamed: C41.2, R40.1, U20.4 (RFB), U60.1 (FB), U60.6 (OUT)
unnamed: U20.3 (VREF), U40.1 (D)
unnamed: C46.1, U20.13 (IOUT), U61.2 (-)
unnamed: C46.2, R44.1, U20.11 (RFB), U61.1 (FB), U61.6 (OUT)
unnamed: U20.12 (VREF), U41.1 (D)
unnamed: C51.1, U20.16 (IOUT), U62.2 (-)
unnamed: C51.2, R48.1, U20.18 (RFB), U62.1 (FB), U62.6 (OUT)
unnamed: U20.17 (VREF), U42.1 (D)
unnamed: C56.1, U20.27 (IOUT), U63.2 (-)
unnamed: C56.2, R52.1, U20.25 (RFB), U63.1 (FB), U63.6 (OUT)
unnamed: U20.26 (VREF), U43.1 (D)
unnamed: R37.2, U40.2 (S1)
unnamed: R38.2, U40.8 (S2)
unnamed: R41.2, U41.2 (S1)
unnamed: R42.2, U41.8 (S2)
unnamed: R45.2, U42.2 (S1)
unnamed: R46.2, U42.8 (S2)
unnamed: R49.2, U43.2 (S1)
unnamed: R50.2, U43.8 (S2)
unnamed: R40.2, R44.2, R48.2, R52.2, R53.1, R54.2, R55.2, U80.2 (-)
unnamed: R53.2, R56.1, U80.6 (OUT)
unnamed: R57.1, U84.1 (D), U90.3 (+)
unnamed: R56.2, U84.8 (S2)
unnamed: R58.1, R59.2, U90.2 (-)
unnamed: R58.2, R60.1, U90.6 (OUT)
OUTPUT_RUN: U84.6 (SEL); also elsewhere on the board
P0: R37.1; also elsewhere on the board
P1: R41.1; also elsewhere on the board
P2: R45.1; also elsewhere on the board
P3: R49.1; also elsewhere on the board
RESET_N: U20.6 (~RS); also elsewhere on the board
ROW0_CS: U20.8 (~CS); also elsewhere on the board
SCK: U20.9 (CLK); also elsewhere on the board
SIGN0: R39.1, U40.6 (SEL); also elsewhere on the board
SIGN1: R43.1, U41.6 (SEL); also elsewhere on the board
SIGN2: R47.1, U42.6 (SEL); also elsewhere on the board
SIGN3: R51.1, U43.6 (SEL); also elsewhere on the board
SIGNAL_EN: U40.5 (EN), U41.5 (EN), U42.5 (EN), U43.5 (EN); also elsewhere on the board
VREF_2V5: R55.1; also elsewhere on the board
VTRIM0: R54.1; also elsewhere on the board

Notes on the sheet:
Output b0: signed weights and 50-ohm driver
Follow left to right: polarity -> DAC magnitude -> current-to-voltage -> sum -> line driver. Each weight includes its own local power units below.
M[0,0] | input a0
M[0,1] | input a1
M[0,2] | input a2
M[0,3] | input a3
SUM AND OUTPUT
49.9R >=1W. External load: 50R. +/-4V peak at the loaded connector. No C across THS3091 feedback.
Branch isolation: 150R for loaded-buffer stability. TIA: 2.2pF C0G; keep IOUT and FB copper short. AD5544BRSZ: SSOP-28, 5.3 x 10.2 mm body.
