tim4431/analog_programmable_matrix/pcb/analog_matrix_4x4_rev_d/analog_matrix_4x4.kicad_pcb

## KiCad design pcb/analog_matrix_4x4_rev_d/analog_matrix_4x4.kicad_pcb (continued)

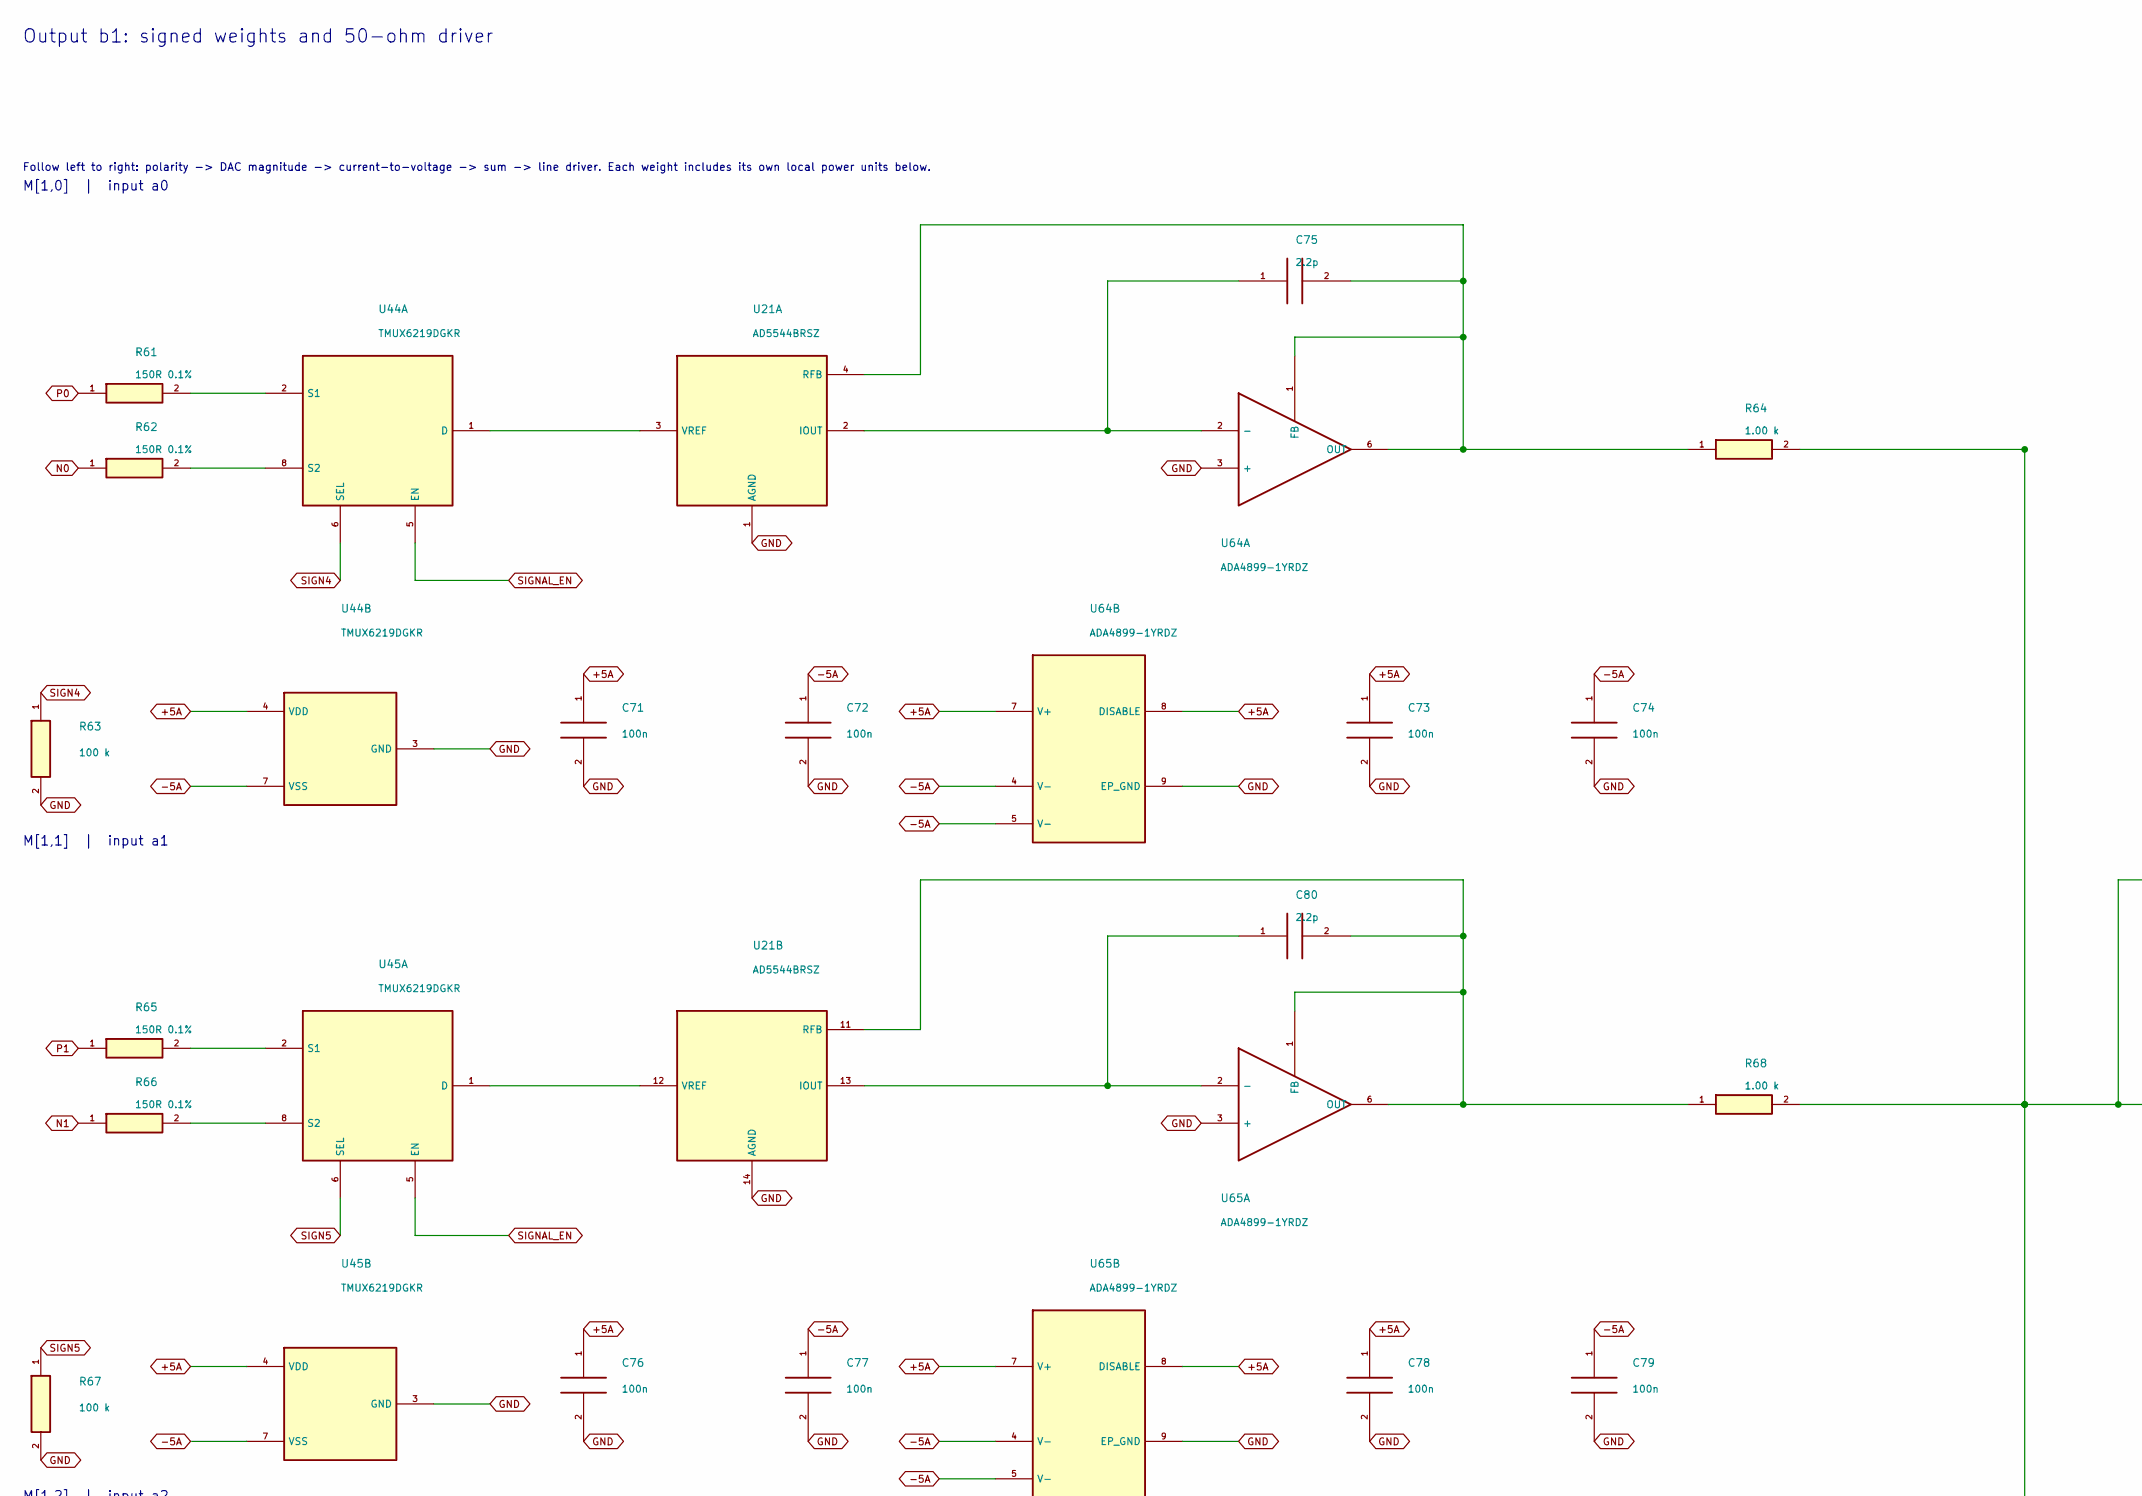
[picture p106: schematic row_1.kicad_sch, Output b1: signed weights and 50-ohm driver, part in row 1, column 1]

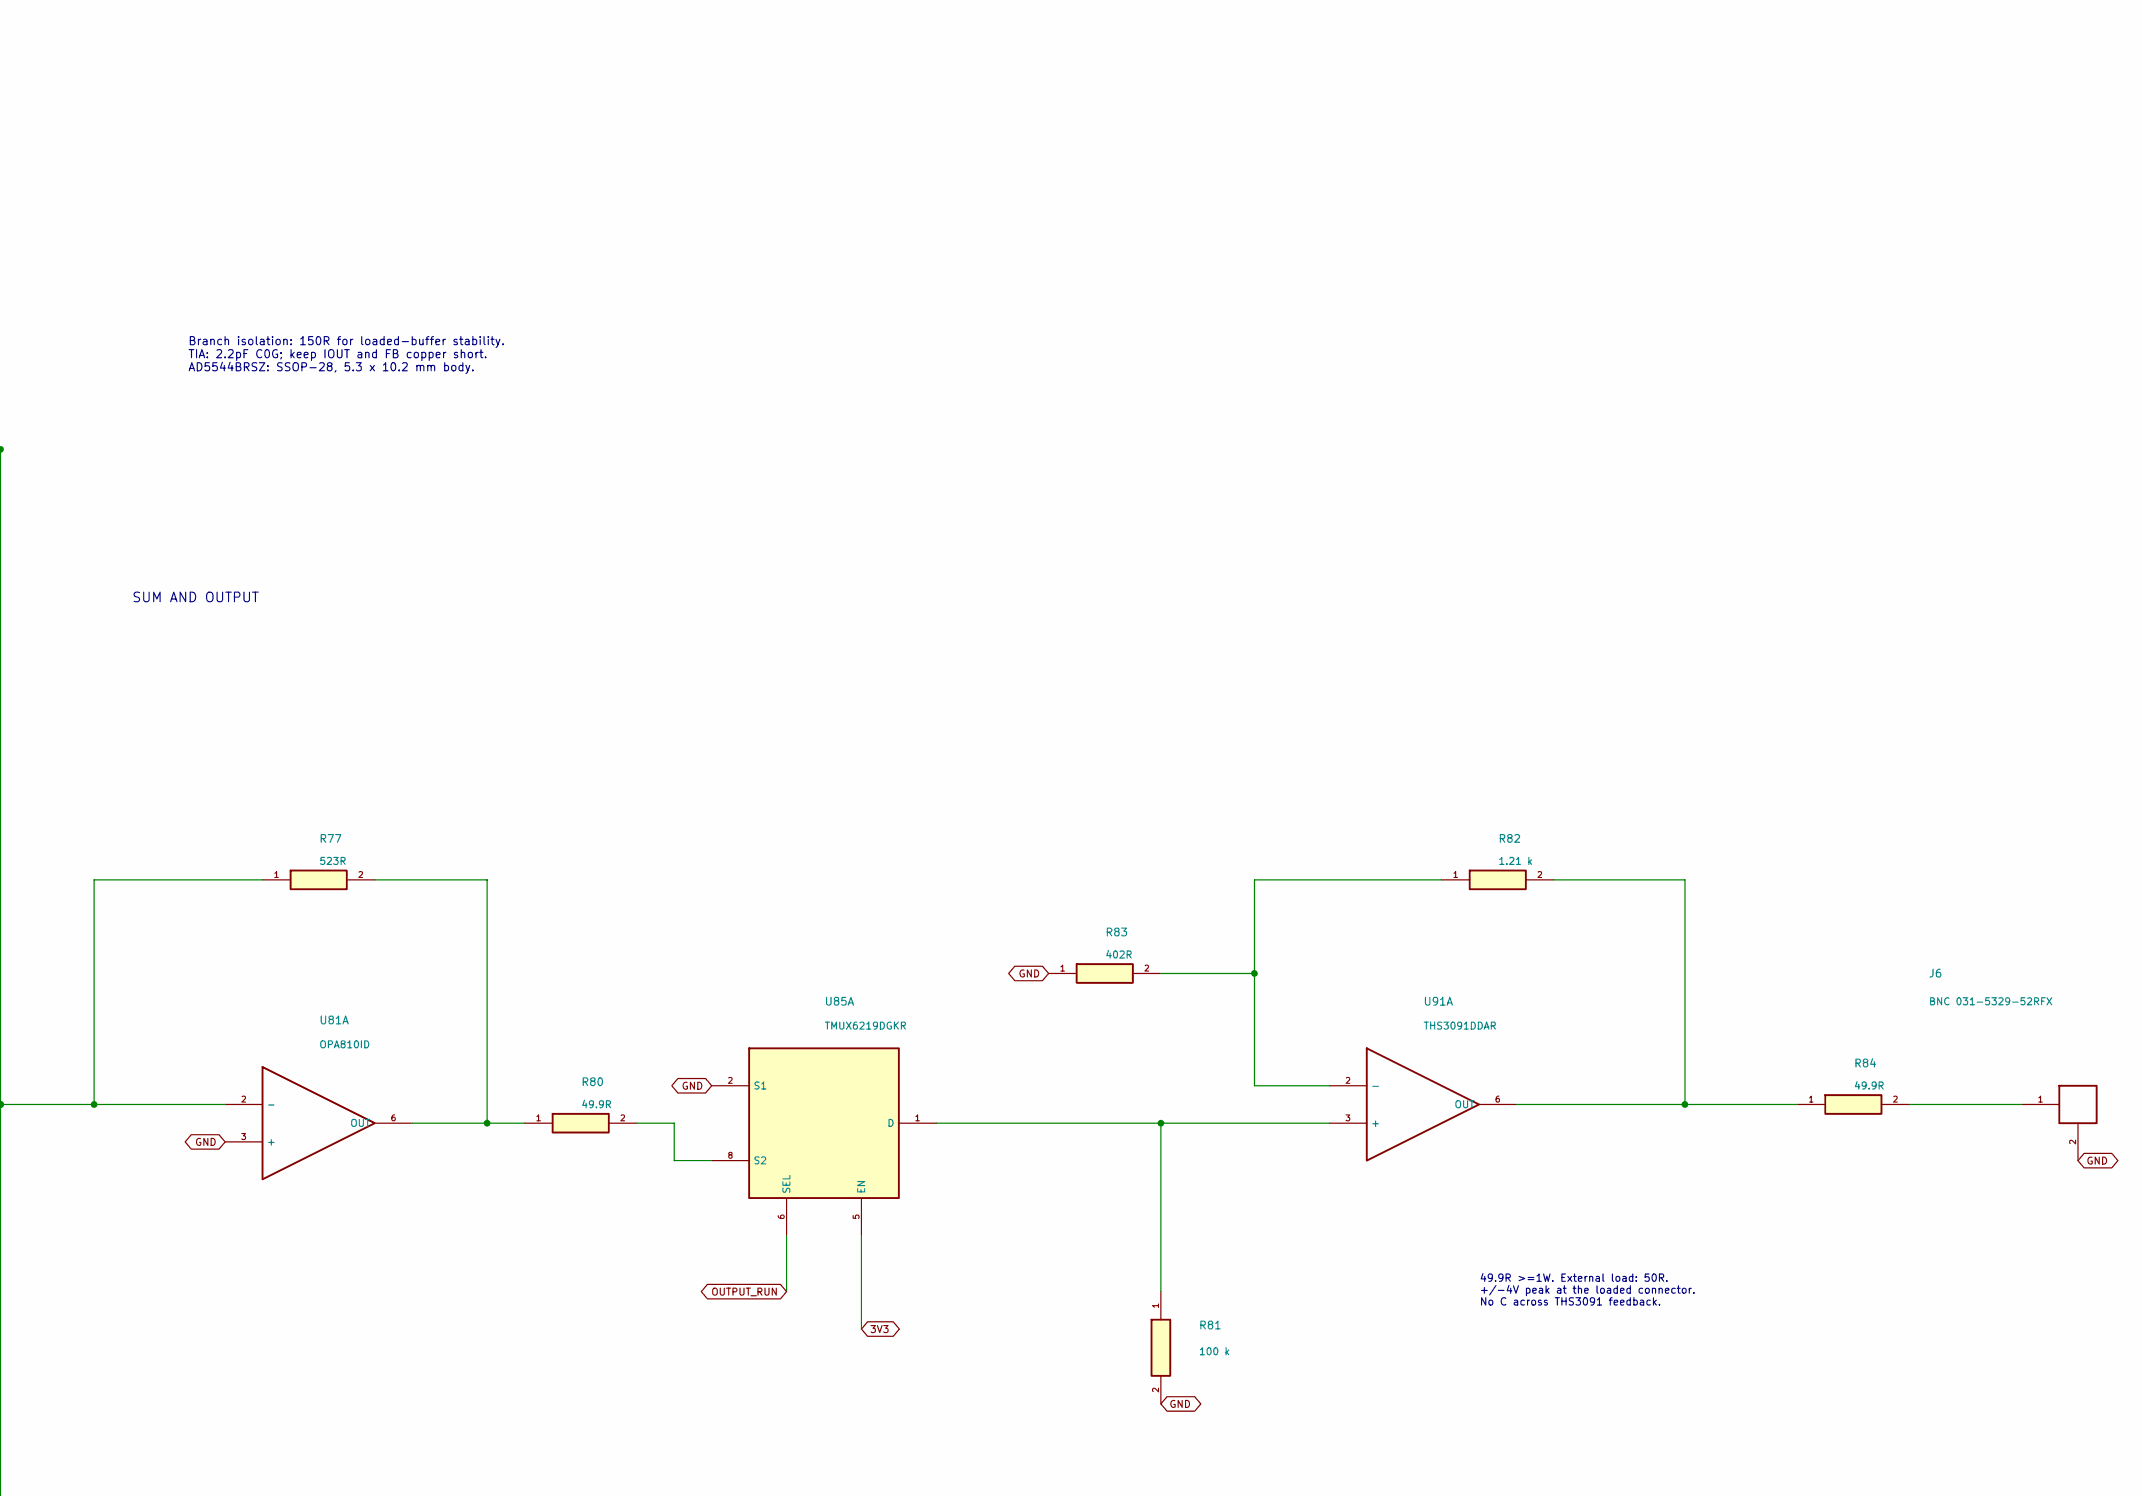
[picture p107: schematic row_1.kicad_sch, Output b1: signed weights and 50-ohm driver, part in row 1, column 2]

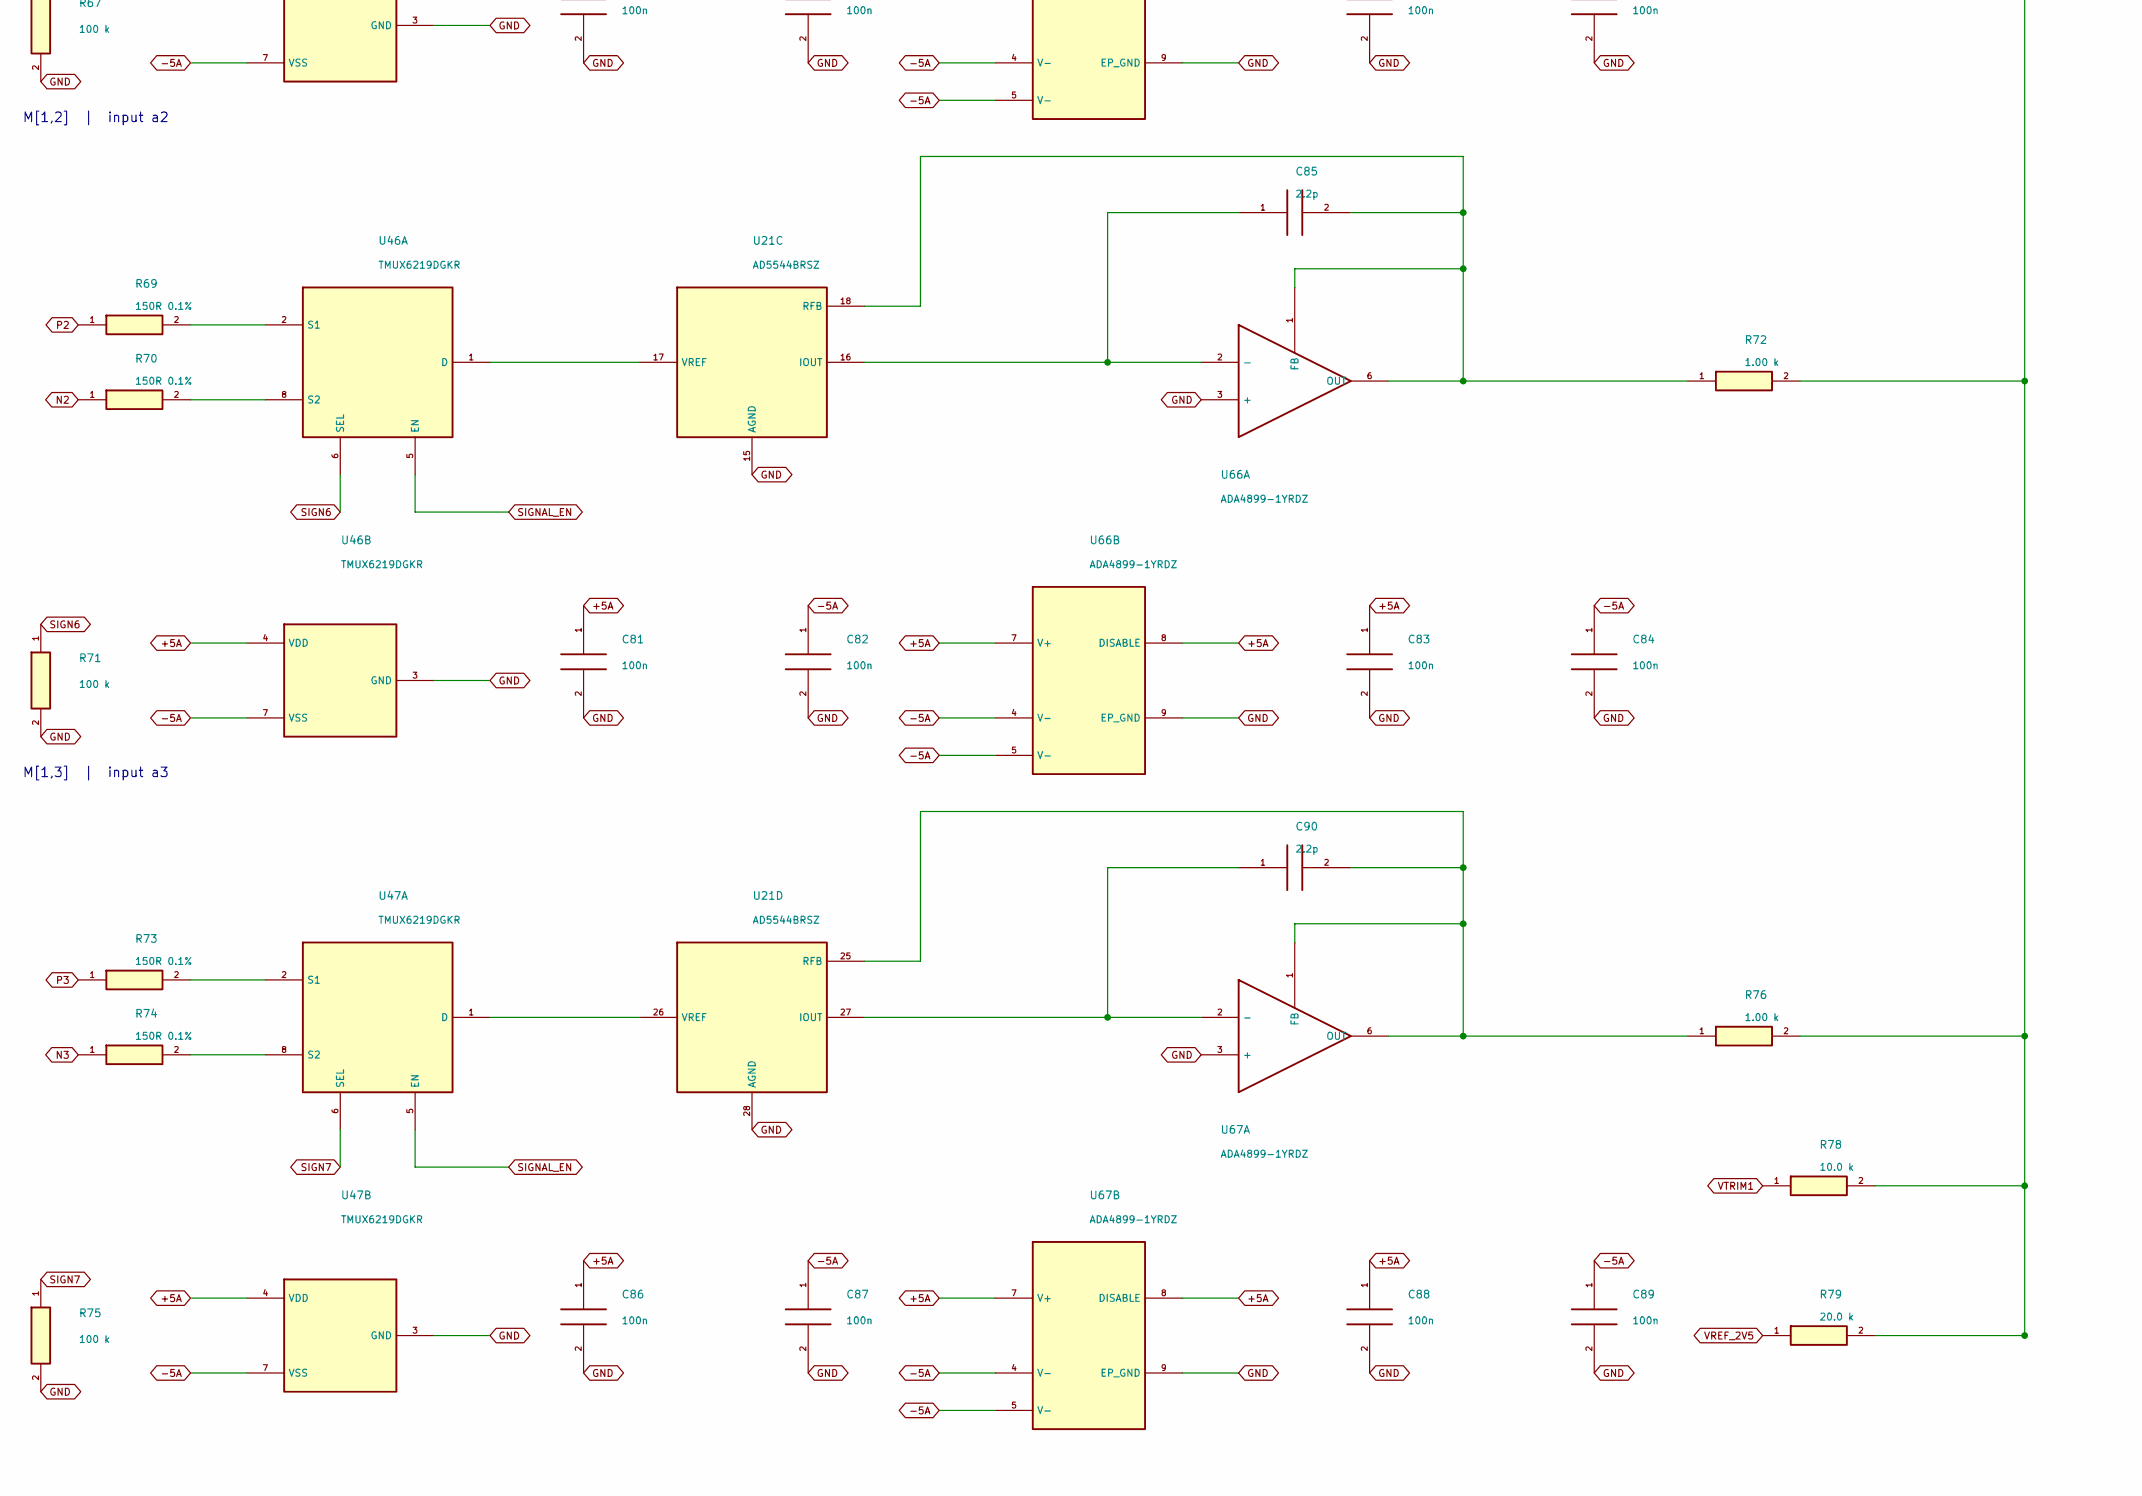
[picture p108: schematic row_1.kicad_sch, Output b1: signed weights and 50-ohm driver, part in row 2, column 1]

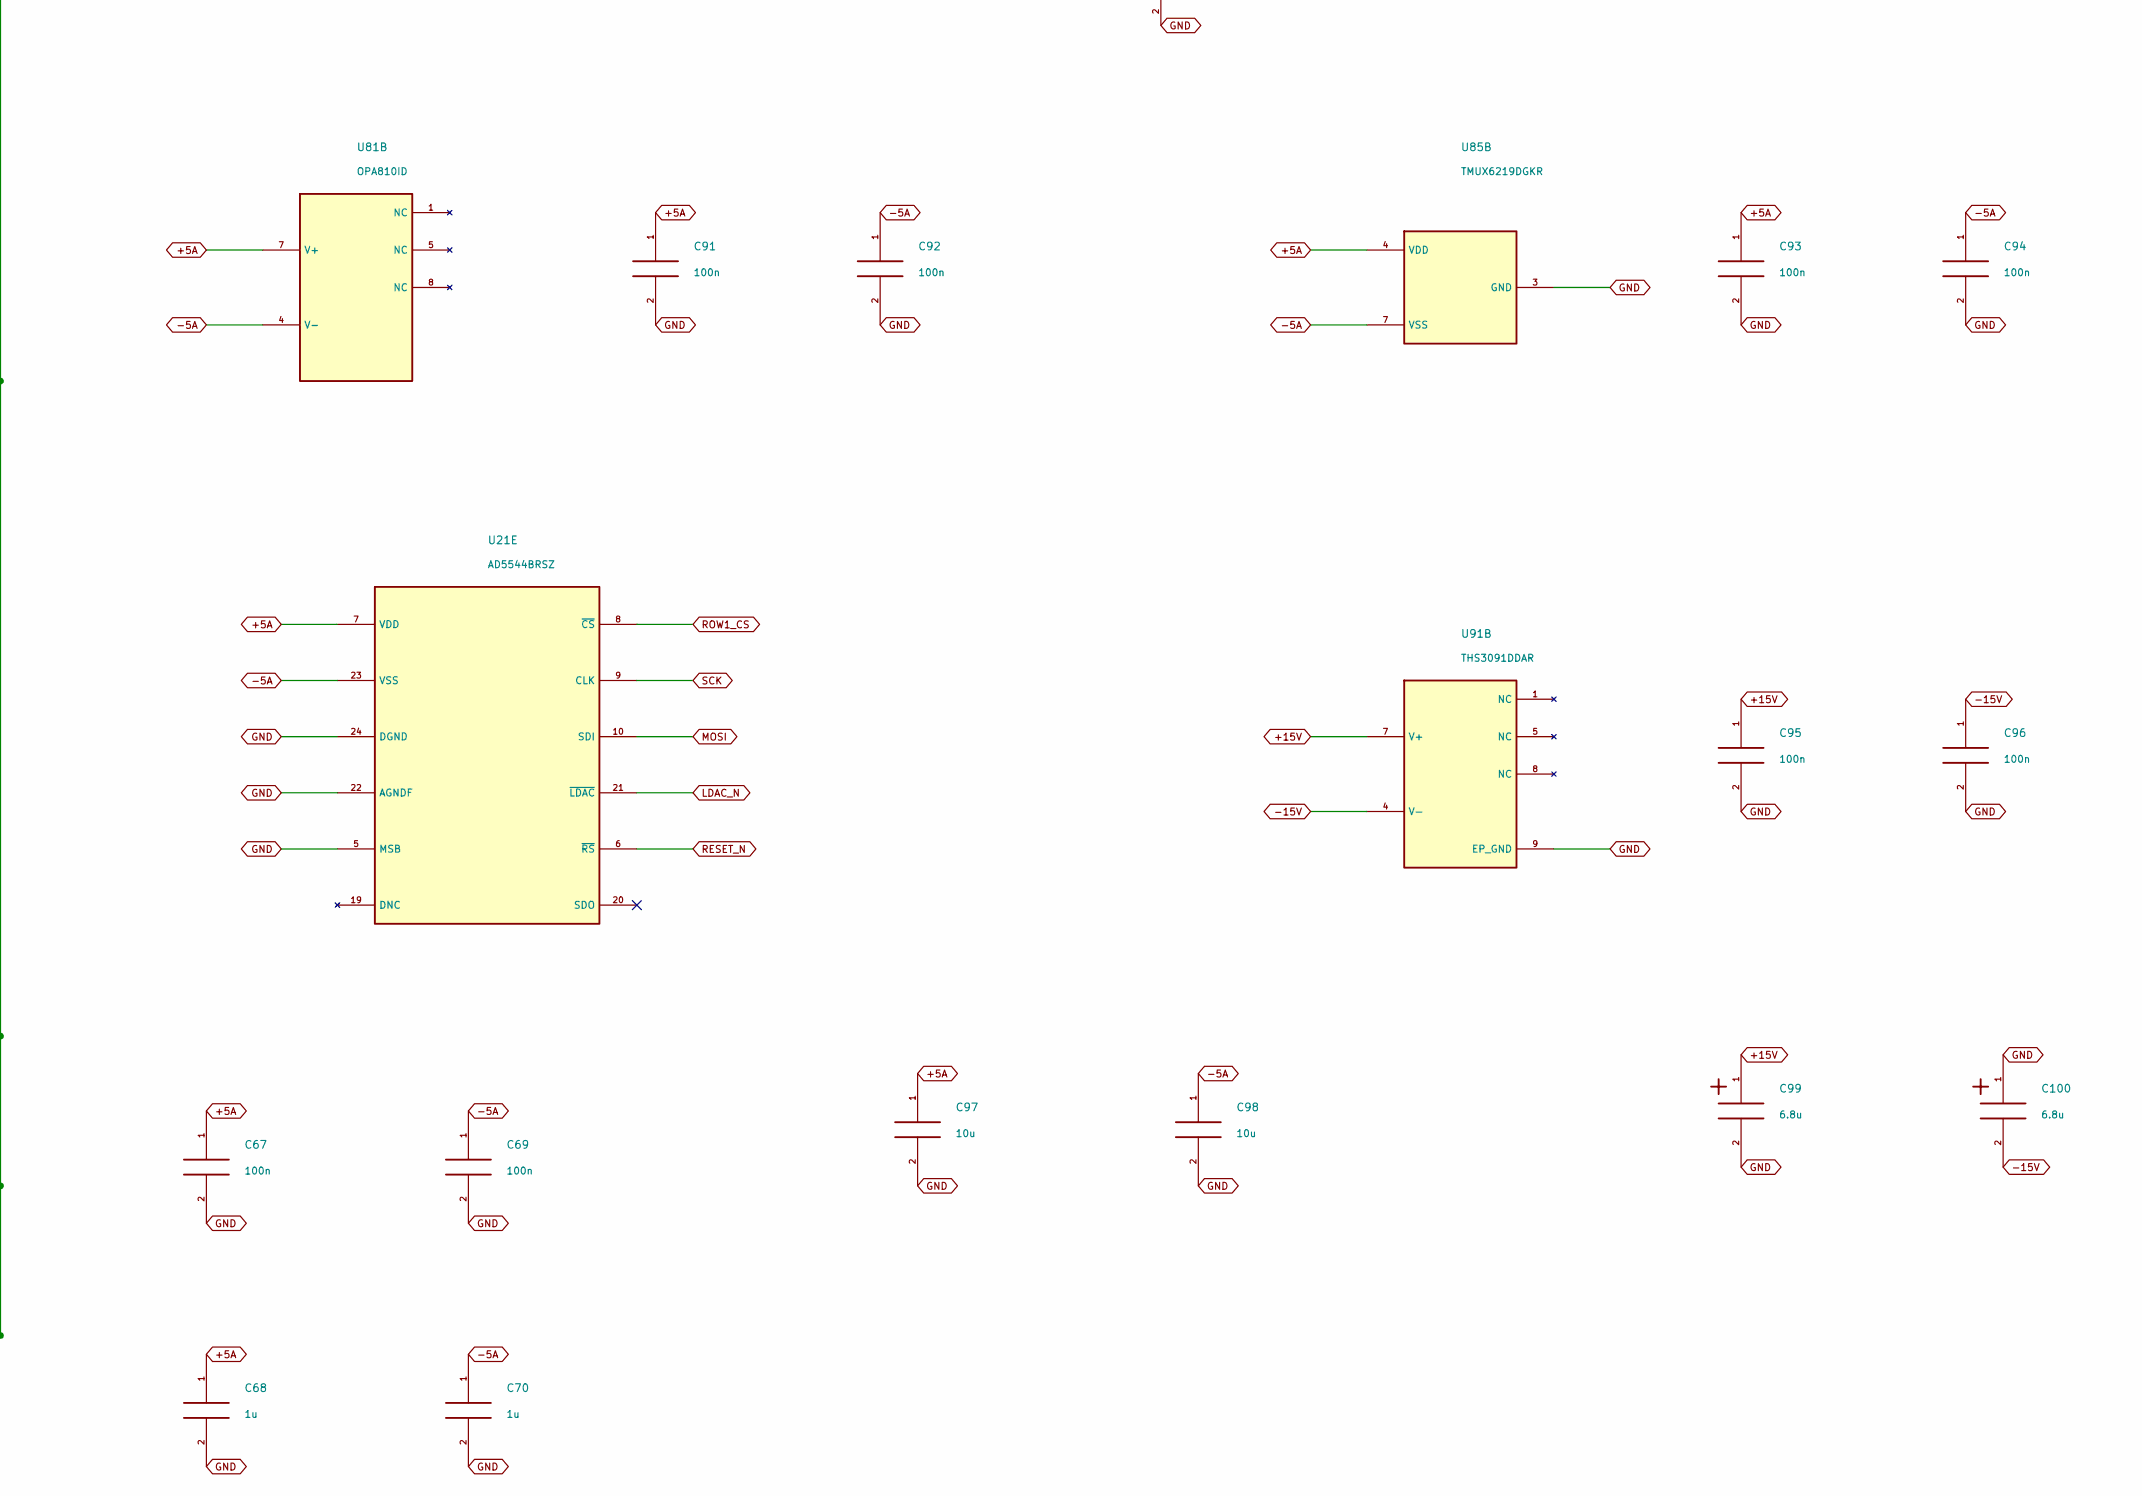
[picture p109: schematic row_1.kicad_sch, Output b1: signed weights and 50-ohm driver, part in row 2, column 2]

Parts:
C67, C69, C71, C72, C73, C74, C76, C77, C78, C79, C81, C82, C83, C84, C86, C87, C88, C89, C91, C92, C93, C94, C95, C96: 100n; C_0603_1608Metric; Rating 25V X7R minimum; effective C after bias
C68, C70: 1u; C_0805_2012Metric; Rating 25V X7R minimum; effective C after bias
C75, C80, C85, C90: 2.2p; C_0402_1005Metric; Rating 50V C0G
C97, C98: 10u; C_0805_2012Metric; Rating 25V X7R minimum; effective C after bias
C99, C100: 6.8u; CP_EIA-3216-18_Kemet-A; Rating 25V polarized
J6: BNC 031-5329-52RFX; BNC_Amphenol_031-5329-52RFX_Vertical
R61, R62, R65, R66, R69, R70, R73, R74: 150R 0.1%; R_0603_1608Metric; Rating 0.1%, <=25ppm/C; 0.1W minimum
R63, R67, R71, R75, R81: 100 k; R_0603_1608Metric; Rating 0.1%, <=25ppm/C; 0.1W minimum
R64, R68, R72, R76: 1.00 k; R_0603_1608Metric; Rating 0.1%, <=25ppm/C; 0.1W minimum
R77: 523R; R_0603_1608Metric; Rating 0.1%, <=25ppm/C; 0.1W minimum
R78: 10.0 k; R_0603_1608Metric; Rating 0.1%, <=25ppm/C; 0.1W minimum
R79: 20.0 k; R_0603_1608Metric; Rating 0.1%, <=25ppm/C; 0.1W minimum
R80: 49.9R; R_0603_1608Metric; Rating 0.1%, <=25ppm/C; 0.1W minimum
R82: 1.21 k; R_0603_1608Metric; Rating 0.1%, <=25ppm/C; 0.1W minimum
R83: 402R; R_0603_1608Metric; Rating 0.1%, <=25ppm/C; 0.1W minimum
R84: 49.9R; R_2512_6332Metric; Rating 0.1%, <=25ppm/C; >=1W
U21: AD5544BRSZ; SSOP-28_5.3x10.2mm_P0.65mm
U44, U45, U46, U47, U85: TMUX6219DGKR; VSSOP-8_3x3mm_P0.65mm
U64, U65, U66, U67: ADA4899-1YRDZ; ADA4899_RD8_EP2.29x2.29
U81: OPA810ID; SOIC-8_3.9x4.9mm_P1.27mm
U91: THS3091DDAR; SOIC-8-1EP_3.9x4.9mm_P1.27mm_EP2.95x4.9mm_Mask2.71x3.4mm_Th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

Connections:
3V3: U85.5 (EN); also elsewhere on the board
+5A: C67.1, C68.1, C71.1, C73.1, C76.1, C78.1, C81.1, C83.1, C86.1, C88.1, C91.1, C93.1, C97.1, U21.7 (VDD), U44.4 (VDD), U45.4 (VDD), U46.4 (VDD), U47.4 (VDD), U64.7 (V+), U64.8 (DISABLE), U65.7 (V+), U65.8 (DISABLE), U66.7 (V+), U66.8 (DISABLE), U67.7 (V+), U67.8 (DISABLE), U81.7 (V+), U85.4 (VDD); also elsewhere on the board
+15V: C95.1, C99.1, U91.7 (V+); also elsewhere on the board
-5A: C69.1, C70.1, C72.1, C74.1, C77.1, C79.1, C82.1, C84.1, C87.1, C89.1, C92.1, C94.1, C98.1, U21.23 (VSS), U44.7 (VSS), U45.7 (VSS), U46.7 (VSS), U47.7 (VSS), U64.4 (V-), U64.5 (V-), U65.4 (V-), U65.5 (V-), U66.4 (V-), U66.5 (V-), U67.4 (V-), U67.5 (V-), U81.4 (V-), U85.7 (VSS); also elsewhere on the board
-15V: C96.1, C100.2, U91.4 (V-); also elsewhere on the board
GND: C67.2, C68.2, C69.2, C70.2, C71.2, C72.2, C73.2, C74.2, C76.2, C77.2, C78.2, C79.2, C81.2, C82.2, C83.2, C84.2, C86.2, C87.2, C88.2, C89.2, C91.2, C92.2, C93.2, C94.2, C95.2, C96.2, C97.2, C98.2, C99.2, C100.1, J6.2, R63.2, R67.2, R71.2, R75.2, R81.2, R83.1, U21.1 (AGND), U21.5 (MSB), U21.14 (AGND), U21.15 (AGND), U21.22 (AGNDF), U21.24 (DGND), U21.28 (AGND), U44.3 (GND), U45.3 (GND), U46.3 (GND), U47.3 (GND), U64.3 (+), U64.9 (EP_GND), U65.3 (+), U65.9 (EP_GND), U66.3 (+), U66.9 (EP_GND), U67.3 (+), U67.9 (EP_GND), U81.3 (+), U85.2 (S1), U85.3 (GND), U91.9 (EP_GND); also elsewhere on the board
LDAC_N: U21.21 (~LDAC); also elsewhere on the board
MOSI: U21.10 (SDI); also elsewhere on the board
N0: R62.1; also elsewhere on the board
N1: R66.1; also elsewhere on the board
N2: R70.1; also elsewhere on the board
N3: R74.1; also elsewhere on the board
unnamed: J6.1, R84.2
unnamed: C75.1, U21.2 (IOUT), U64.2 (-)
unnamed: C75.2, R64.1, U21.4 (RFB), U64.1 (FB), U64.6 (OUT)
unnamed: U21.3 (VREF), U44.1 (D)
unnamed: C80.1, U21.13 (IOUT), U65.2 (-)
unnamed: C80.2, R68.1, U21.11 (RFB), U65.1 (FB), U65.6 (OUT)
unnamed: U21.12 (VREF), U45.1 (D)
unnamed: C85.1, U21.16 (IOUT), U66.2 (-)
unnamed: C85.2, R72.1, U21.18 (RFB), U66.1 (FB), U66.6 (OUT)
unnamed: U21.17 (VREF), U46.1 (D)
unnamed: C90.1, U21.27 (IOUT), U67.2 (-)
unnamed: C90.2, R76.1, U21.25 (RFB), U67.1 (FB), U67.6 (OUT)
unnamed: U21.26 (VREF), U47.1 (D)
unnamed: R61.2, U44.2 (S1)
unnamed: R62.2, U44.8 (S2)
unnamed: R65.2, U45.2 (S1)
unnamed: R66.2, U45.8 (S2)
unnamed: R69.2, U46.2 (S1)
unnamed: R70.2, U46.8 (S2)
unnamed: R73.2, U47.2 (S1)
unnamed: R74.2, U47.8 (S2)
unnamed: R64.2, R68.2, R72.2, R76.2, R77.1, R78.2, R79.2, U81.2 (-)
unnamed: R77.2, R80.1, U81.6 (OUT)
unnamed: R81.1, U85.1 (D), U91.3 (+)
unnamed: R80.2, U85.8 (S2)
unnamed: R82.1, R83.2, U91.2 (-)
unnamed: R82.2, R84.1, U91.6 (OUT)
OUTPUT_RUN: U85.6 (SEL); also elsewhere on the board
P0: R61.1; also elsewhere on the board
P1: R65.1; also elsewhere on the board
P2: R69.1; also elsewhere on the board
P3: R73.1; also elsewhere on the board
RESET_N: U21.6 (~RS); also elsewhere on the board
ROW1_CS: U21.8 (~CS); also elsewhere on the board
SCK: U21.9 (CLK); also elsewhere on the board
SIGN4: R63.1, U44.6 (SEL); also elsewhere on the board
SIGN5: R67.1, U45.6 (SEL); also elsewhere on the board
SIGN6: R71.1, U46.6 (SEL); also elsewhere on the board
SIGN7: R75.1, U47.6 (SEL); also elsewhere on the board
SIGNAL_EN: U44.5 (EN), U45.5 (EN), U46.5 (EN), U47.5 (EN); also elsewhere on the board
VREF_2V5: R79.1; also elsewhere on the board
VTRIM1: R78.1; also elsewhere on the board

Notes on the sheet:
Output b1: signed weights and 50-ohm driver
Follow left to right: polarity -> DAC magnitude -> current-to-voltage -> sum -> line driver. Each weight includes its own local power units below.
M[1,0] | input a0
M[1,1] | input a1
M[1,2] | input a2
M[1,3] | input a3
SUM AND OUTPUT
49.9R >=1W. External load: 50R. +/-4V peak at the loaded connector. No C across THS3091 feedback.
Branch isolation: 150R for loaded-buffer stability. TIA: 2.2pF C0G; keep IOUT and FB copper short. AD5544BRSZ: SSOP-28, 5.3 x 10.2 mm body.
