tim4431/analog_programmable_matrix/pcb/analog_matrix_4x4_rev_d/analog_matrix_4x4.kicad_pcb

## KiCad design pcb/analog_matrix_4x4_rev_d/analog_matrix_4x4.kicad_pcb (continued)

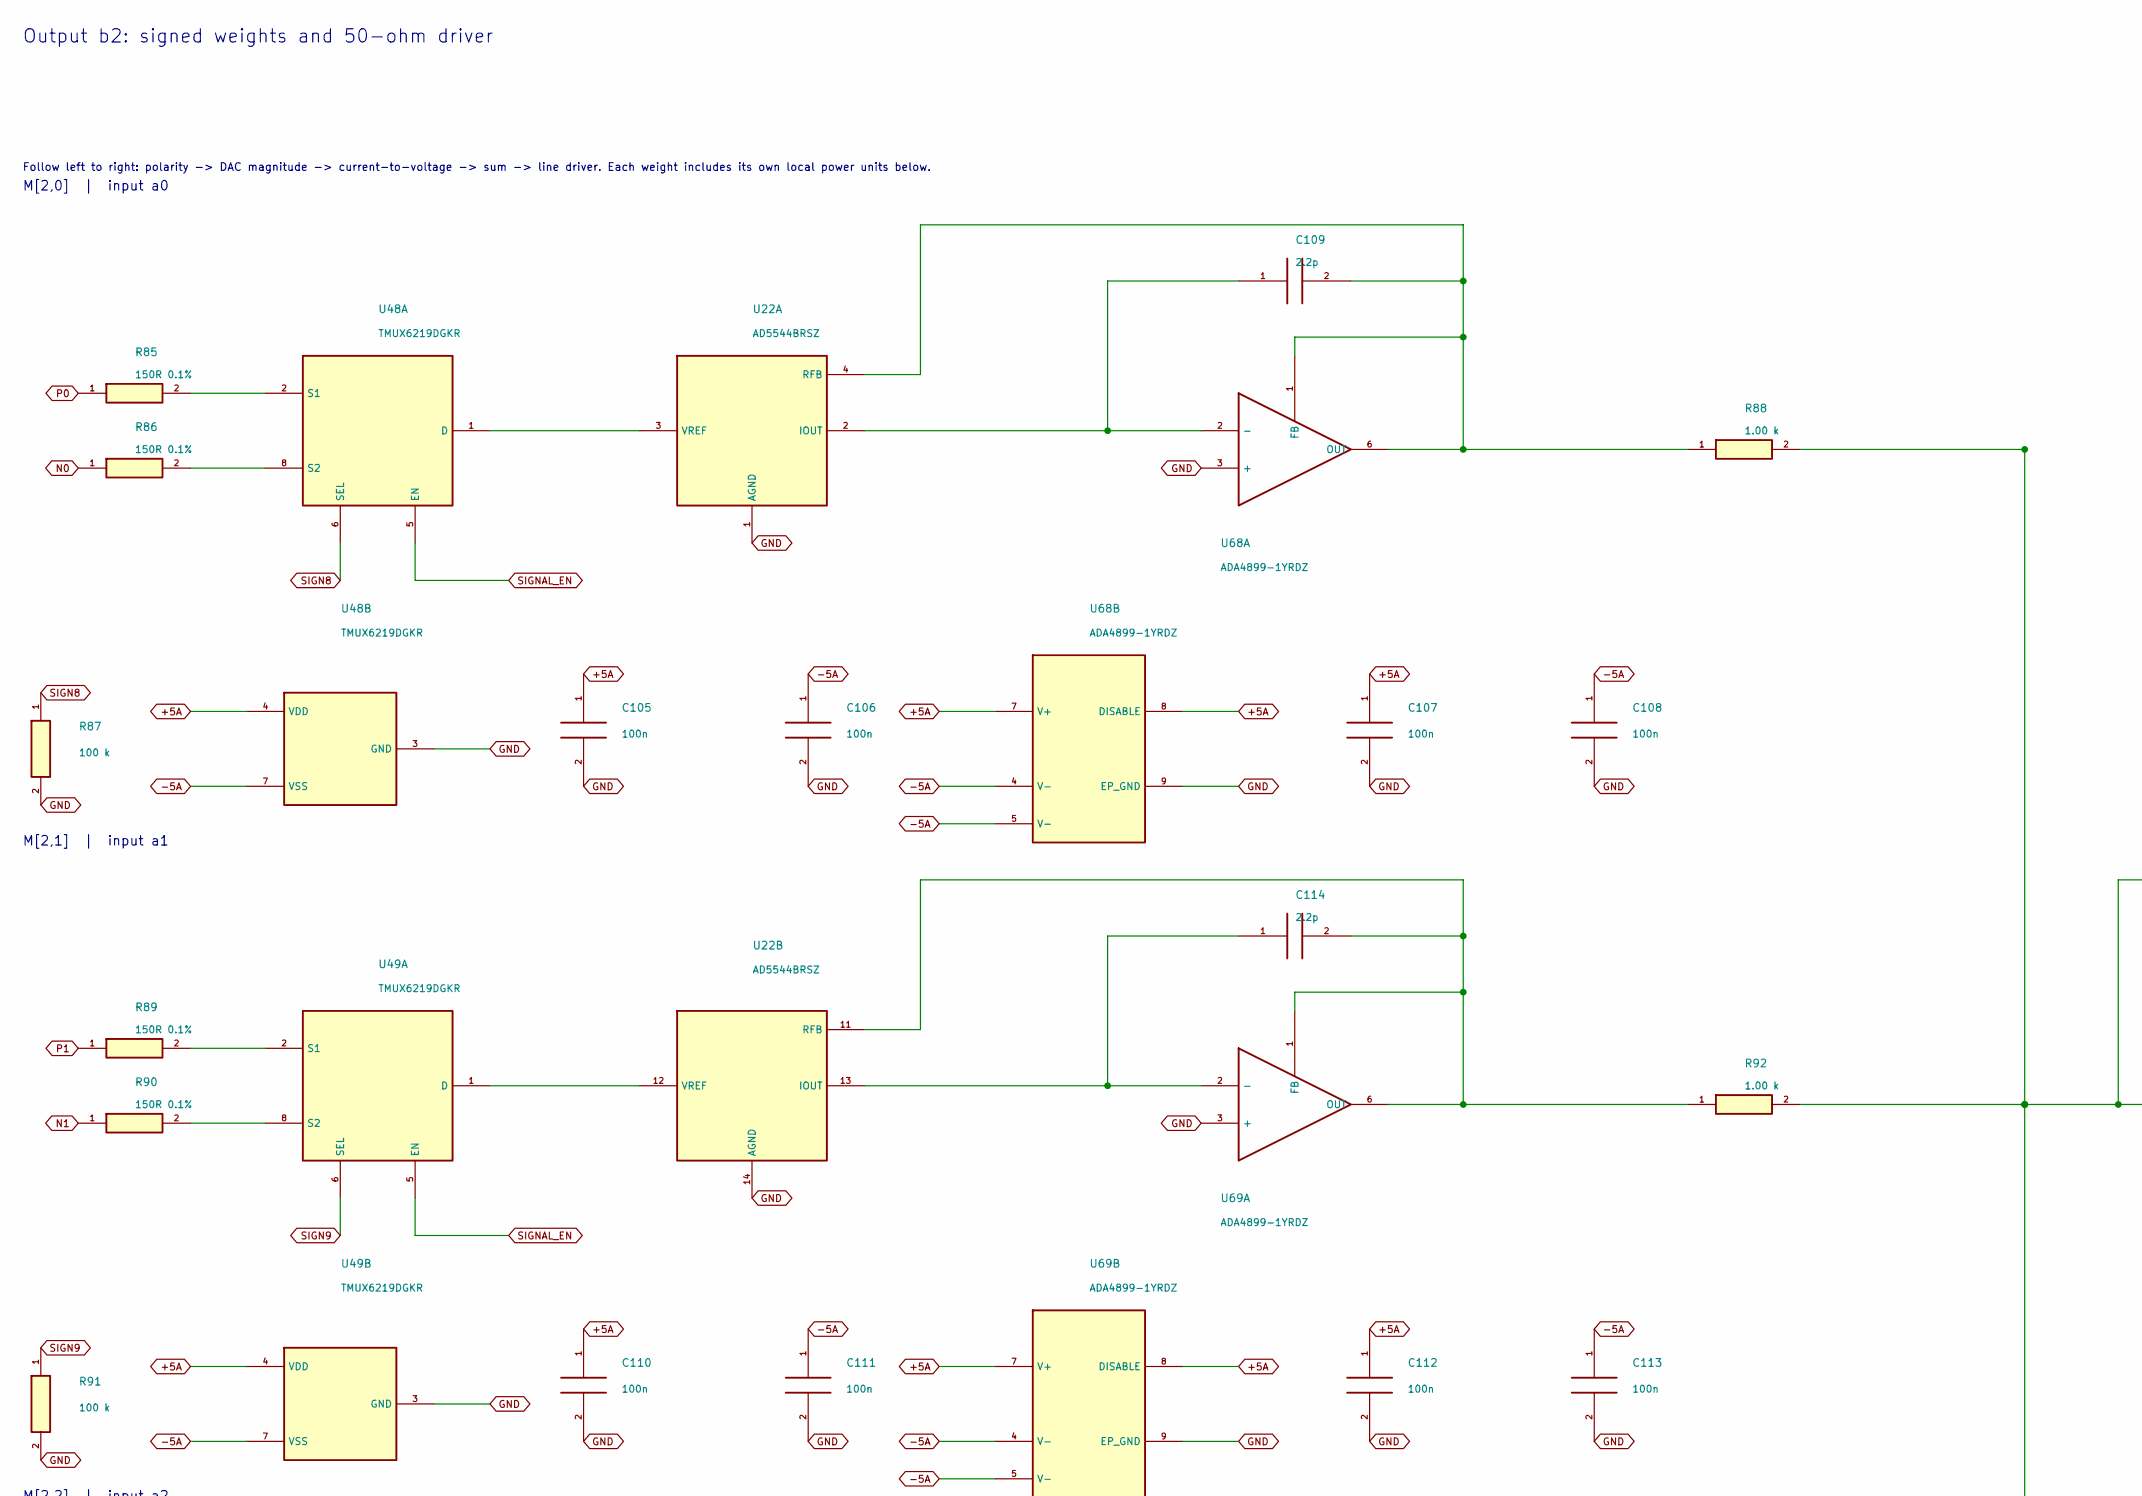
[picture p110: schematic row_2.kicad_sch, Output b2: signed weights and 50-ohm driver, part in row 1, column 1]

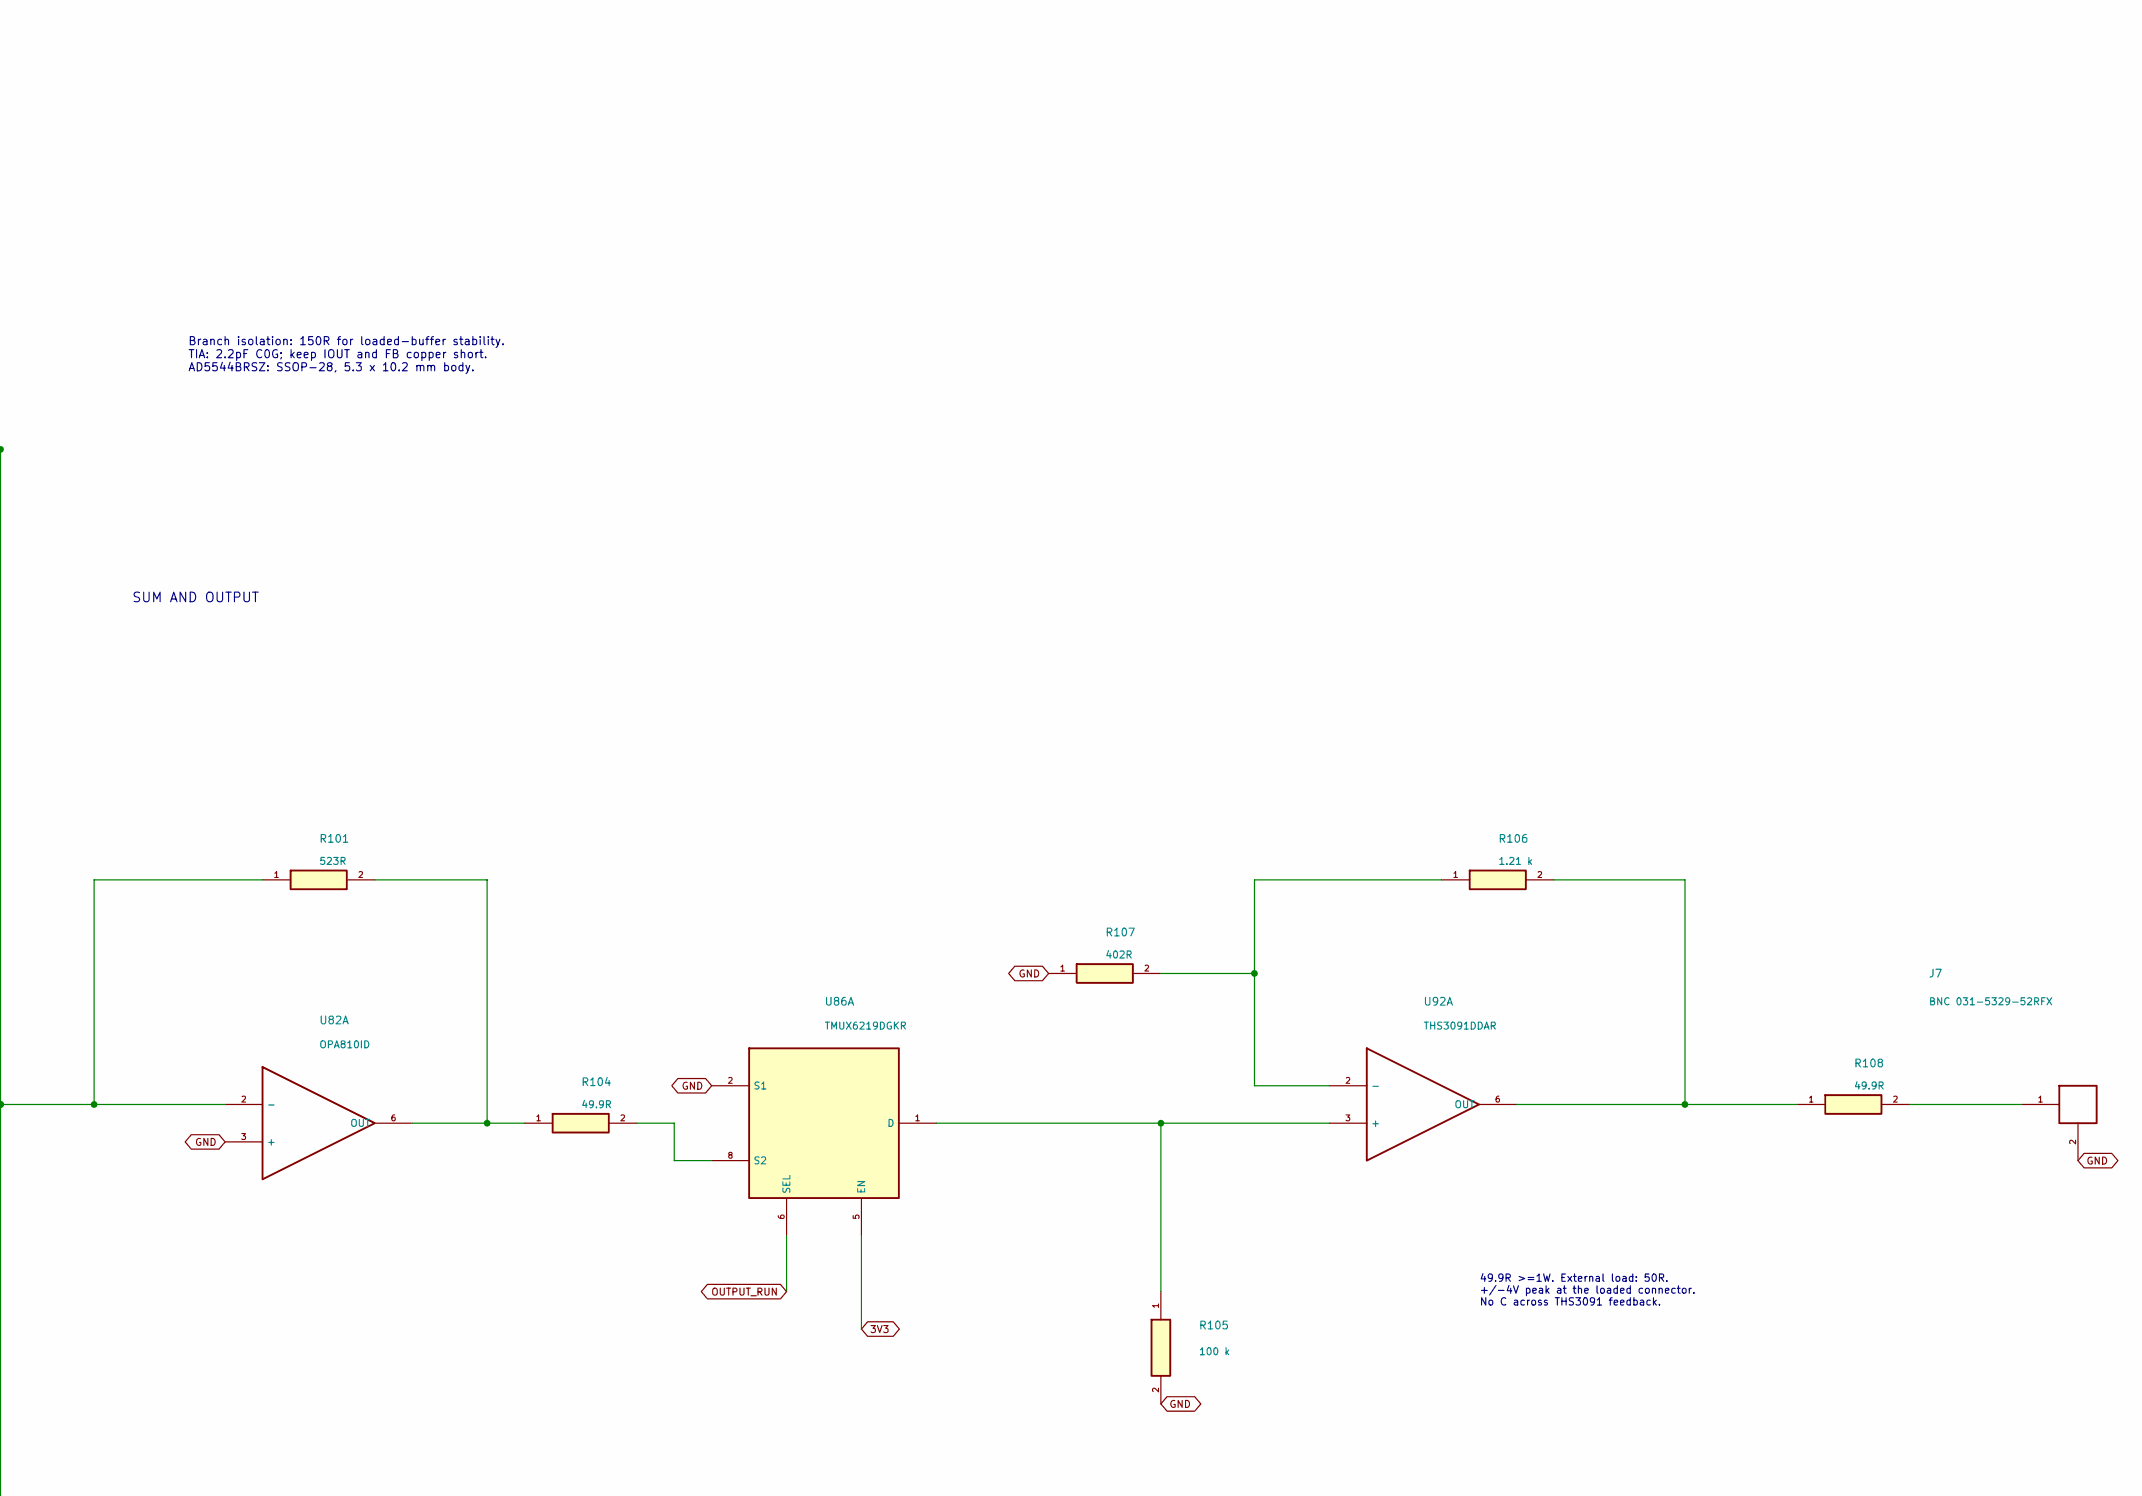
[picture p111: schematic row_2.kicad_sch, Output b2: signed weights and 50-ohm driver, part in row 1, column 2]

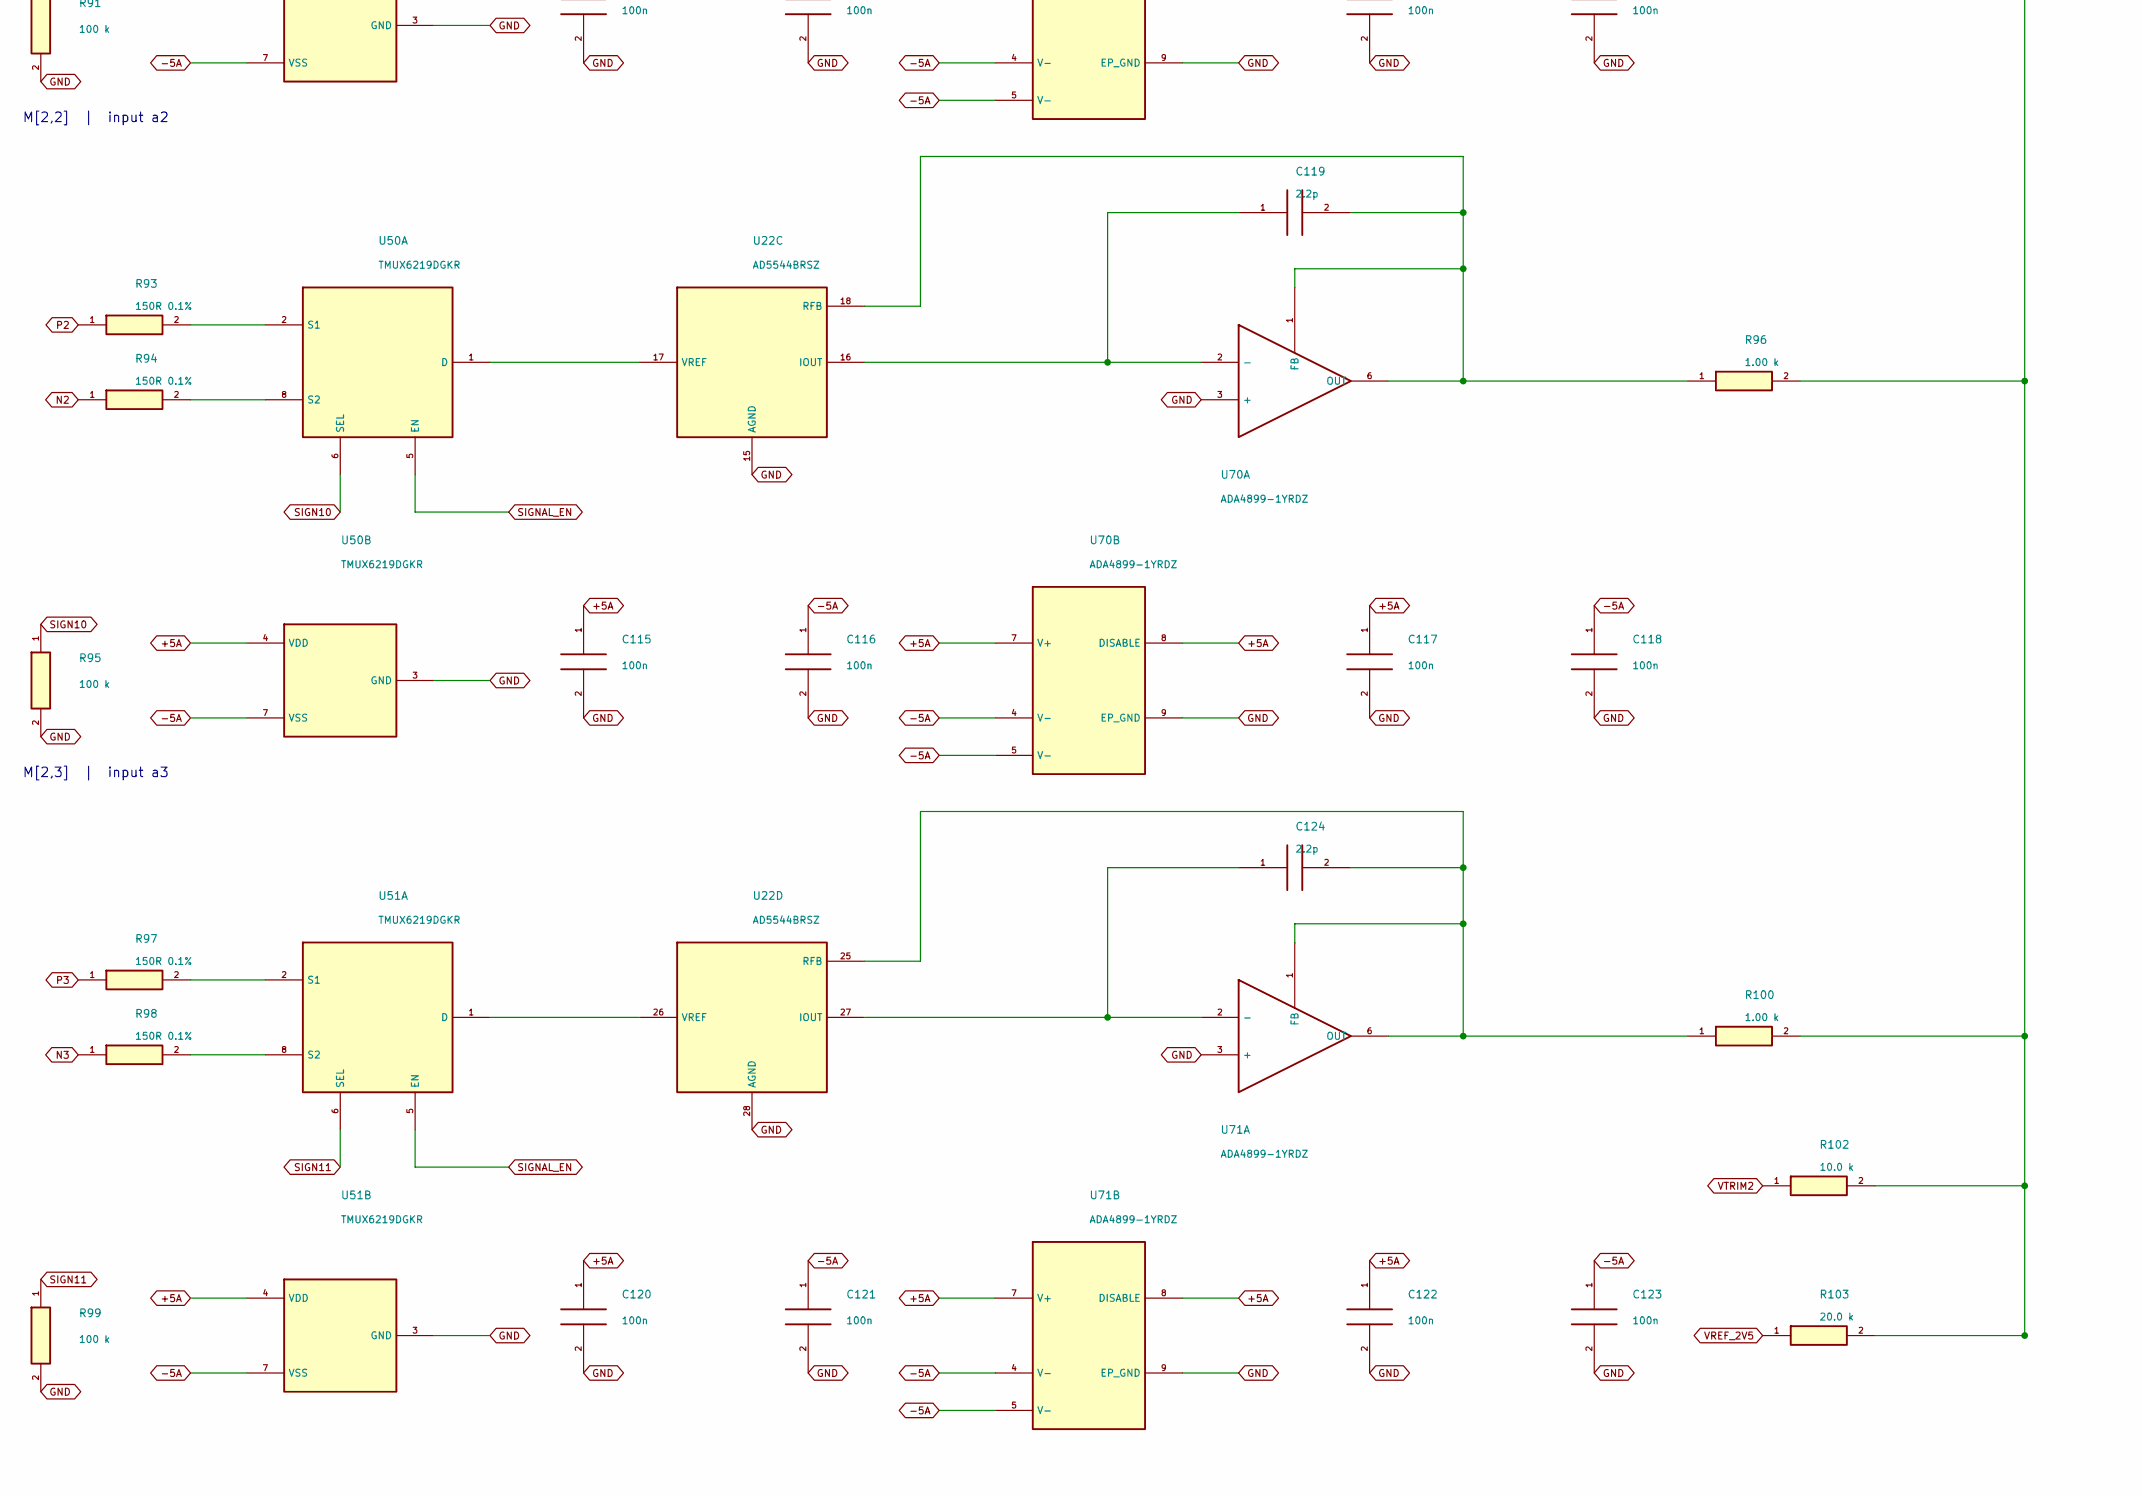
[picture p112: schematic row_2.kicad_sch, Output b2: signed weights and 50-ohm driver, part in row 2, column 1]

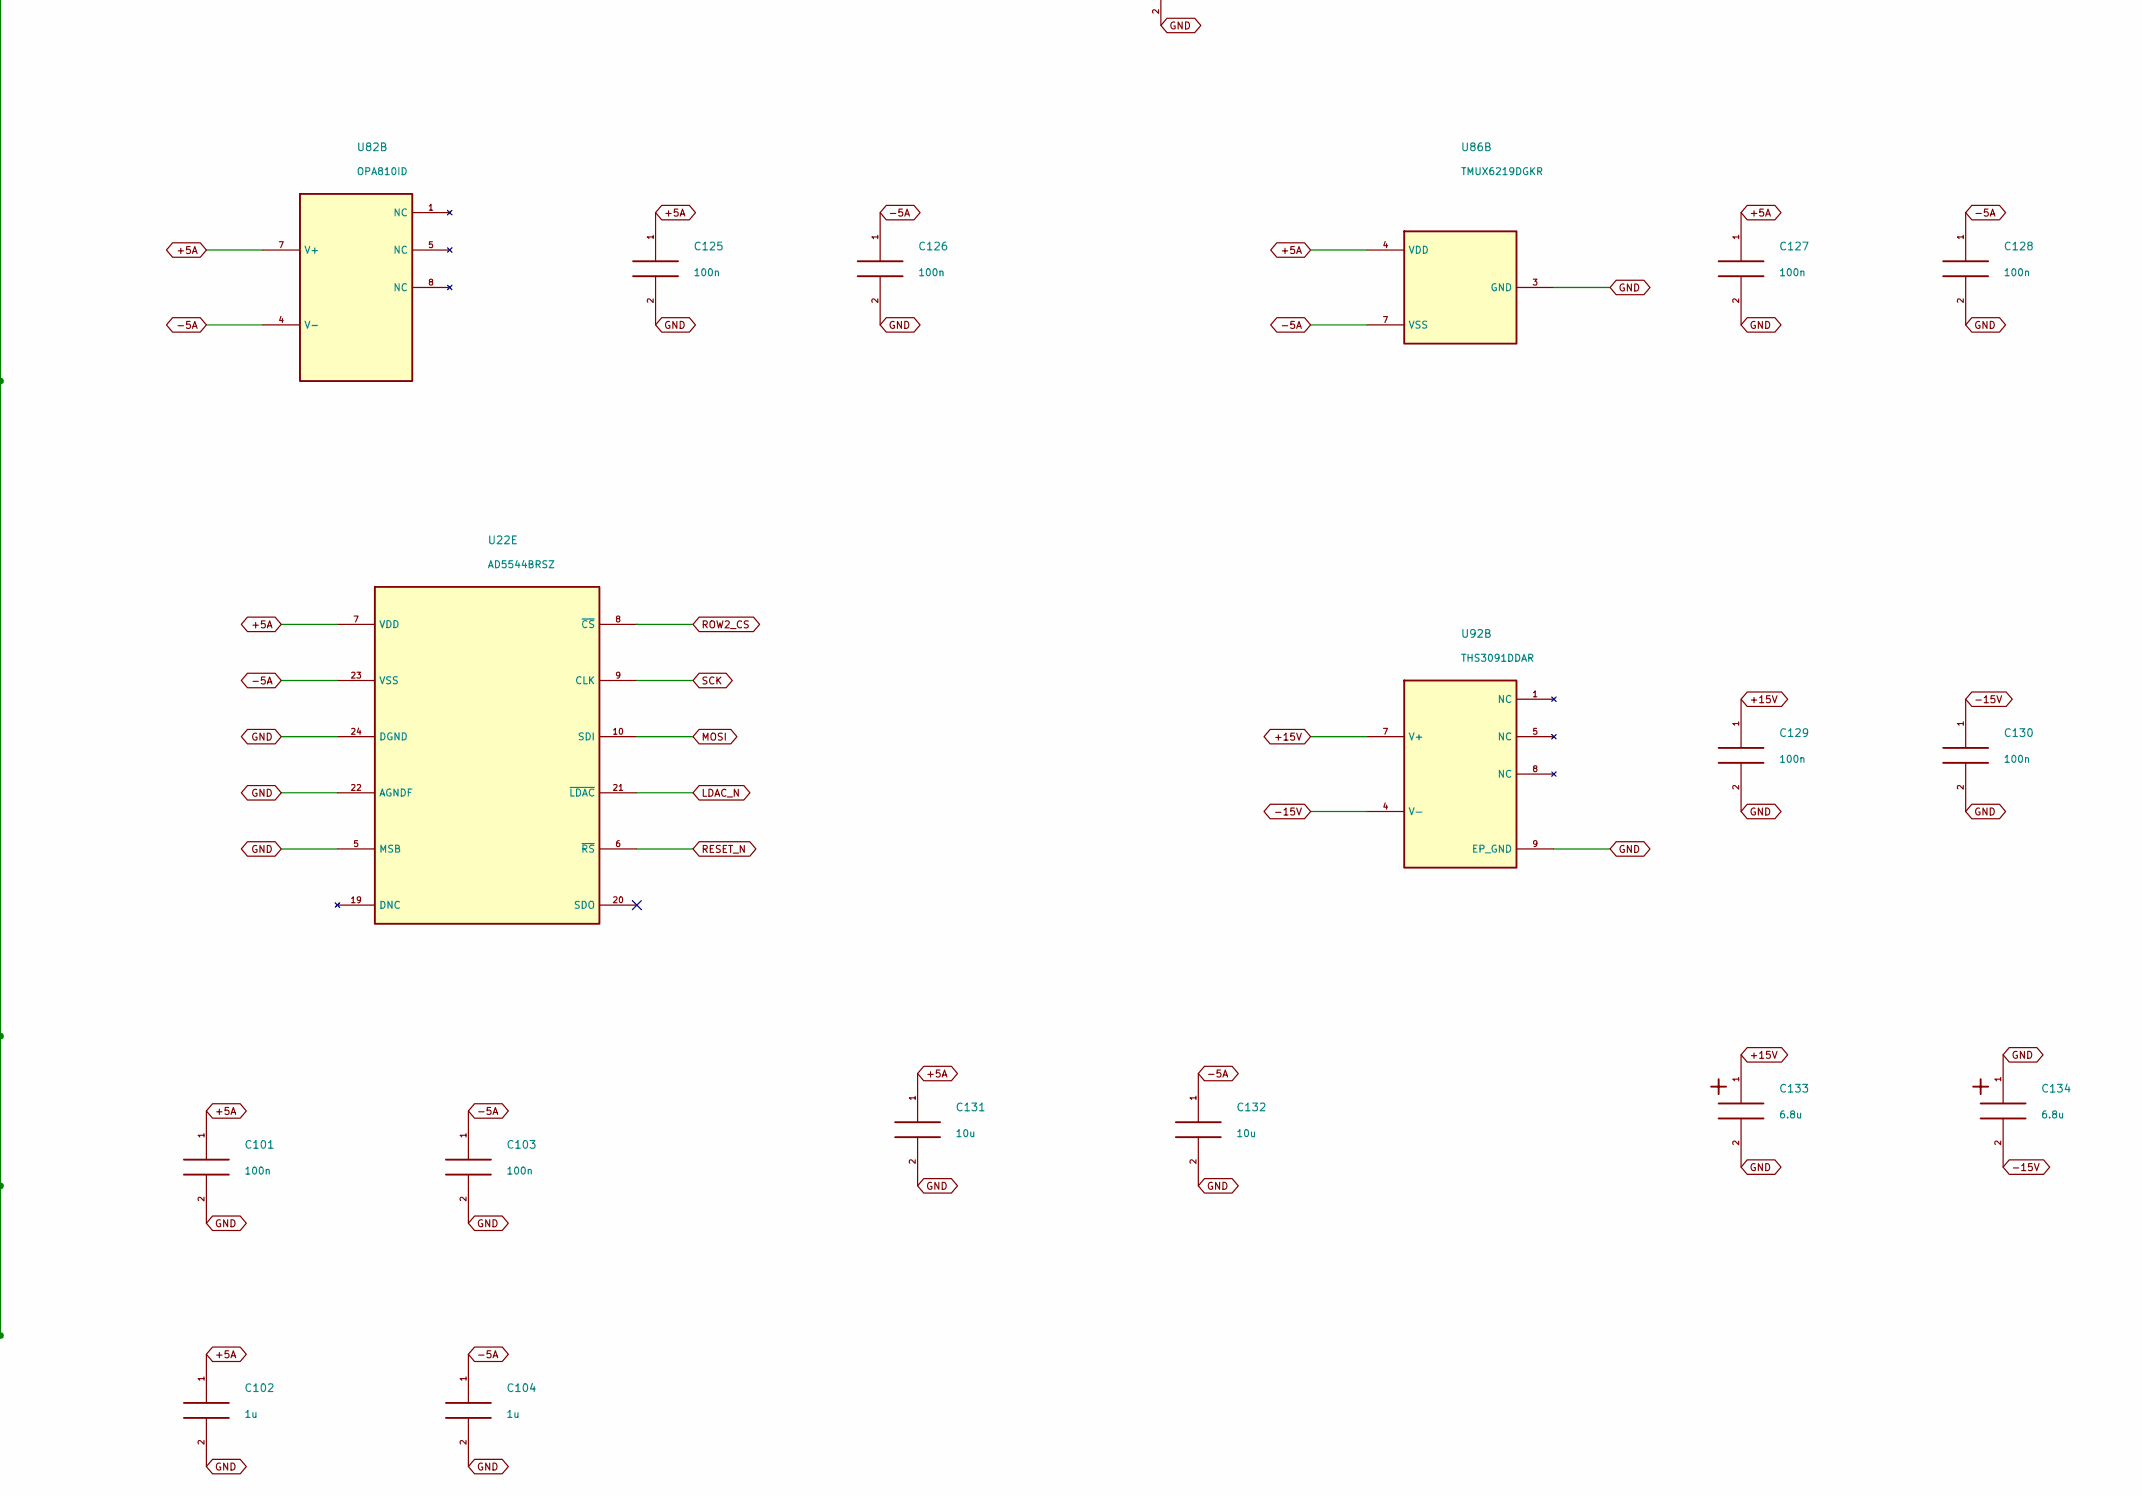
[picture p113: schematic row_2.kicad_sch, Output b2: signed weights and 50-ohm driver, part in row 2, column 2]

Parts:
C101, C103, C105, C106, C107, C108, C110, C111, C112, C113, C115, C116, C117, C118, C120, C121, C122, C123, C125, C126, C127, C128, C129, C130: 100n; C_0603_1608Metric; Rating 25V X7R minimum; effective C after bias
C102, C104: 1u; C_0805_2012Metric; Rating 25V X7R minimum; effective C after bias
C109, C114, C119, C124: 2.2p; C_0402_1005Metric; Rating 50V C0G
C131, C132: 10u; C_0805_2012Metric; Rating 25V X7R minimum; effective C after bias
C133, C134: 6.8u; CP_EIA-3216-18_Kemet-A; Rating 25V polarized
J7: BNC 031-5329-52RFX; BNC_Amphenol_031-5329-52RFX_Vertical
R85, R86, R89, R90, R93, R94, R97, R98: 150R 0.1%; R_0603_1608Metric; Rating 0.1%, <=25ppm/C; 0.1W minimum
R87, R91, R95, R99, R105: 100 k; R_0603_1608Metric; Rating 0.1%, <=25ppm/C; 0.1W minimum
R88, R92, R96, R100: 1.00 k; R_0603_1608Metric; Rating 0.1%, <=25ppm/C; 0.1W minimum
R101: 523R; R_0603_1608Metric; Rating 0.1%, <=25ppm/C; 0.1W minimum
R102: 10.0 k; R_0603_1608Metric; Rating 0.1%, <=25ppm/C; 0.1W minimum
R103: 20.0 k; R_0603_1608Metric; Rating 0.1%, <=25ppm/C; 0.1W minimum
R104: 49.9R; R_0603_1608Metric; Rating 0.1%, <=25ppm/C; 0.1W minimum
R106: 1.21 k; R_0603_1608Metric; Rating 0.1%, <=25ppm/C; 0.1W minimum
R107: 402R; R_0603_1608Metric; Rating 0.1%, <=25ppm/C; 0.1W minimum
R108: 49.9R; R_2512_6332Metric; Rating 0.1%, <=25ppm/C; >=1W
U22: AD5544BRSZ; SSOP-28_5.3x10.2mm_P0.65mm
U48, U49, U50, U51, U86: TMUX6219DGKR; VSSOP-8_3x3mm_P0.65mm
U68, U69, U70, U71: ADA4899-1YRDZ; ADA4899_RD8_EP2.29x2.29
U82: OPA810ID; SOIC-8_3.9x4.9mm_P1.27mm
U92: THS3091DDAR; SOIC-8-1EP_3.9x4.9mm_P1.27mm_EP2.95x4.9mm_Mask2.71x3.4mm_Th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

Connections:
3V3: U86.5 (EN); also elsewhere on the board
+5A: C101.1, C102.1, C105.1, C107.1, C110.1, C112.1, C115.1, C117.1, C120.1, C122.1, C125.1, C127.1, C131.1, U22.7 (VDD), U48.4 (VDD), U49.4 (VDD), U50.4 (VDD), U51.4 (VDD), U68.7 (V+), U68.8 (DISABLE), U69.7 (V+), U69.8 (DISABLE), U70.7 (V+), U70.8 (DISABLE), U71.7 (V+), U71.8 (DISABLE), U82.7 (V+), U86.4 (VDD); also elsewhere on the board
+15V: C129.1, C133.1, U92.7 (V+); also elsewhere on the board
-5A: C103.1, C104.1, C106.1, C108.1, C111.1, C113.1, C116.1, C118.1, C121.1, C123.1, C126.1, C128.1, C132.1, U22.23 (VSS), U48.7 (VSS), U49.7 (VSS), U50.7 (VSS), U51.7 (VSS), U68.4 (V-), U68.5 (V-), U69.4 (V-), U69.5 (V-), U70.4 (V-), U70.5 (V-), U71.4 (V-), U71.5 (V-), U82.4 (V-), U86.7 (VSS); also elsewhere on the board
-15V: C130.1, C134.2, U92.4 (V-); also elsewhere on the board
GND: C101.2, C102.2, C103.2, C104.2, C105.2, C106.2, C107.2, C108.2, C110.2, C111.2, C112.2, C113.2, C115.2, C116.2, C117.2, C118.2, C120.2, C121.2, C122.2, C123.2, C125.2, C126.2, C127.2, C128.2, C129.2, C130.2, C131.2, C132.2, C133.2, C134.1, J7.2, R87.2, R91.2, R95.2, R99.2, R105.2, R107.1, U22.1 (AGND), U22.5 (MSB), U22.14 (AGND), U22.15 (AGND), U22.22 (AGNDF), U22.24 (DGND), U22.28 (AGND), U48.3 (GND), U49.3 (GND), U50.3 (GND), U51.3 (GND), U68.3 (+), U68.9 (EP_GND), U69.3 (+), U69.9 (EP_GND), U70.3 (+), U70.9 (EP_GND), U71.3 (+), U71.9 (EP_GND), U82.3 (+), U86.2 (S1), U86.3 (GND), U92.9 (EP_GND); also elsewhere on the board
LDAC_N: U22.21 (~LDAC); also elsewhere on the board
MOSI: U22.10 (SDI); also elsewhere on the board
N0: R86.1; also elsewhere on the board
N1: R90.1; also elsewhere on the board
N2: R94.1; also elsewhere on the board
N3: R98.1; also elsewhere on the board
unnamed: J7.1, R108.2
unnamed: C109.1, U22.2 (IOUT), U68.2 (-)
unnamed: C109.2, R88.1, U22.4 (RFB), U68.1 (FB), U68.6 (OUT)
unnamed: U22.3 (VREF), U48.1 (D)
unnamed: C114.1, U22.13 (IOUT), U69.2 (-)
unnamed: C114.2, R92.1, U22.11 (RFB), U69.1 (FB), U69.6 (OUT)
unnamed: U22.12 (VREF), U49.1 (D)
unnamed: C119.1, U22.16 (IOUT), U70.2 (-)
unnamed: C119.2, R96.1, U22.18 (RFB), U70.1 (FB), U70.6 (OUT)
unnamed: U22.17 (VREF), U50.1 (D)
unnamed: C124.1, U22.27 (IOUT), U71.2 (-)
unnamed: C124.2, R100.1, U22.25 (RFB), U71.1 (FB), U71.6 (OUT)
unnamed: U22.26 (VREF), U51.1 (D)
unnamed: R85.2, U48.2 (S1)
unnamed: R86.2, U48.8 (S2)
unnamed: R89.2, U49.2 (S1)
unnamed: R90.2, U49.8 (S2)
unnamed: R93.2, U50.2 (S1)
unnamed: R94.2, U50.8 (S2)
unnamed: R97.2, U51.2 (S1)
unnamed: R98.2, U51.8 (S2)
unnamed: R88.2, R92.2, R96.2, R100.2, R101.1, R102.2, R103.2, U82.2 (-)
unnamed: R101.2, R104.1, U82.6 (OUT)
unnamed: R105.1, U86.1 (D), U92.3 (+)
unnamed: R104.2, U86.8 (S2)
unnamed: R106.1, R107.2, U92.2 (-)
unnamed: R106.2, R108.1, U92.6 (OUT)
OUTPUT_RUN: U86.6 (SEL); also elsewhere on the board
P0: R85.1; also elsewhere on the board
P1: R89.1; also elsewhere on the board
P2: R93.1; also elsewhere on the board
P3: R97.1; also elsewhere on the board
RESET_N: U22.6 (~RS); also elsewhere on the board
ROW2_CS: U22.8 (~CS); also elsewhere on the board
SCK: U22.9 (CLK); also elsewhere on the board
SIGN8: R87.1, U48.6 (SEL); also elsewhere on the board
SIGN9: R91.1, U49.6 (SEL); also elsewhere on the board
SIGN10: R95.1, U50.6 (SEL); also elsewhere on the board
SIGN11: R99.1, U51.6 (SEL); also elsewhere on the board
SIGNAL_EN: U48.5 (EN), U49.5 (EN), U50.5 (EN), U51.5 (EN); also elsewhere on the board
VREF_2V5: R103.1; also elsewhere on the board
VTRIM2: R102.1; also elsewhere on the board

Notes on the sheet:
Output b2: signed weights and 50-ohm driver
Follow left to right: polarity -> DAC magnitude -> current-to-voltage -> sum -> line driver. Each weight includes its own local power units below.
M[2,0] | input a0
M[2,1] | input a1
M[2,2] | input a2
M[2,3] | input a3
SUM AND OUTPUT
49.9R >=1W. External load: 50R. +/-4V peak at the loaded connector. No C across THS3091 feedback.
Branch isolation: 150R for loaded-buffer stability. TIA: 2.2pF C0G; keep IOUT and FB copper short. AD5544BRSZ: SSOP-28, 5.3 x 10.2 mm body.
