tim4431/analog_programmable_matrix/pcb/analog_matrix_4x4_rev_d/analog_matrix_4x4.kicad_pcb

## KiCad design pcb/analog_matrix_4x4_rev_d/analog_matrix_4x4.kicad_pcb (continued)

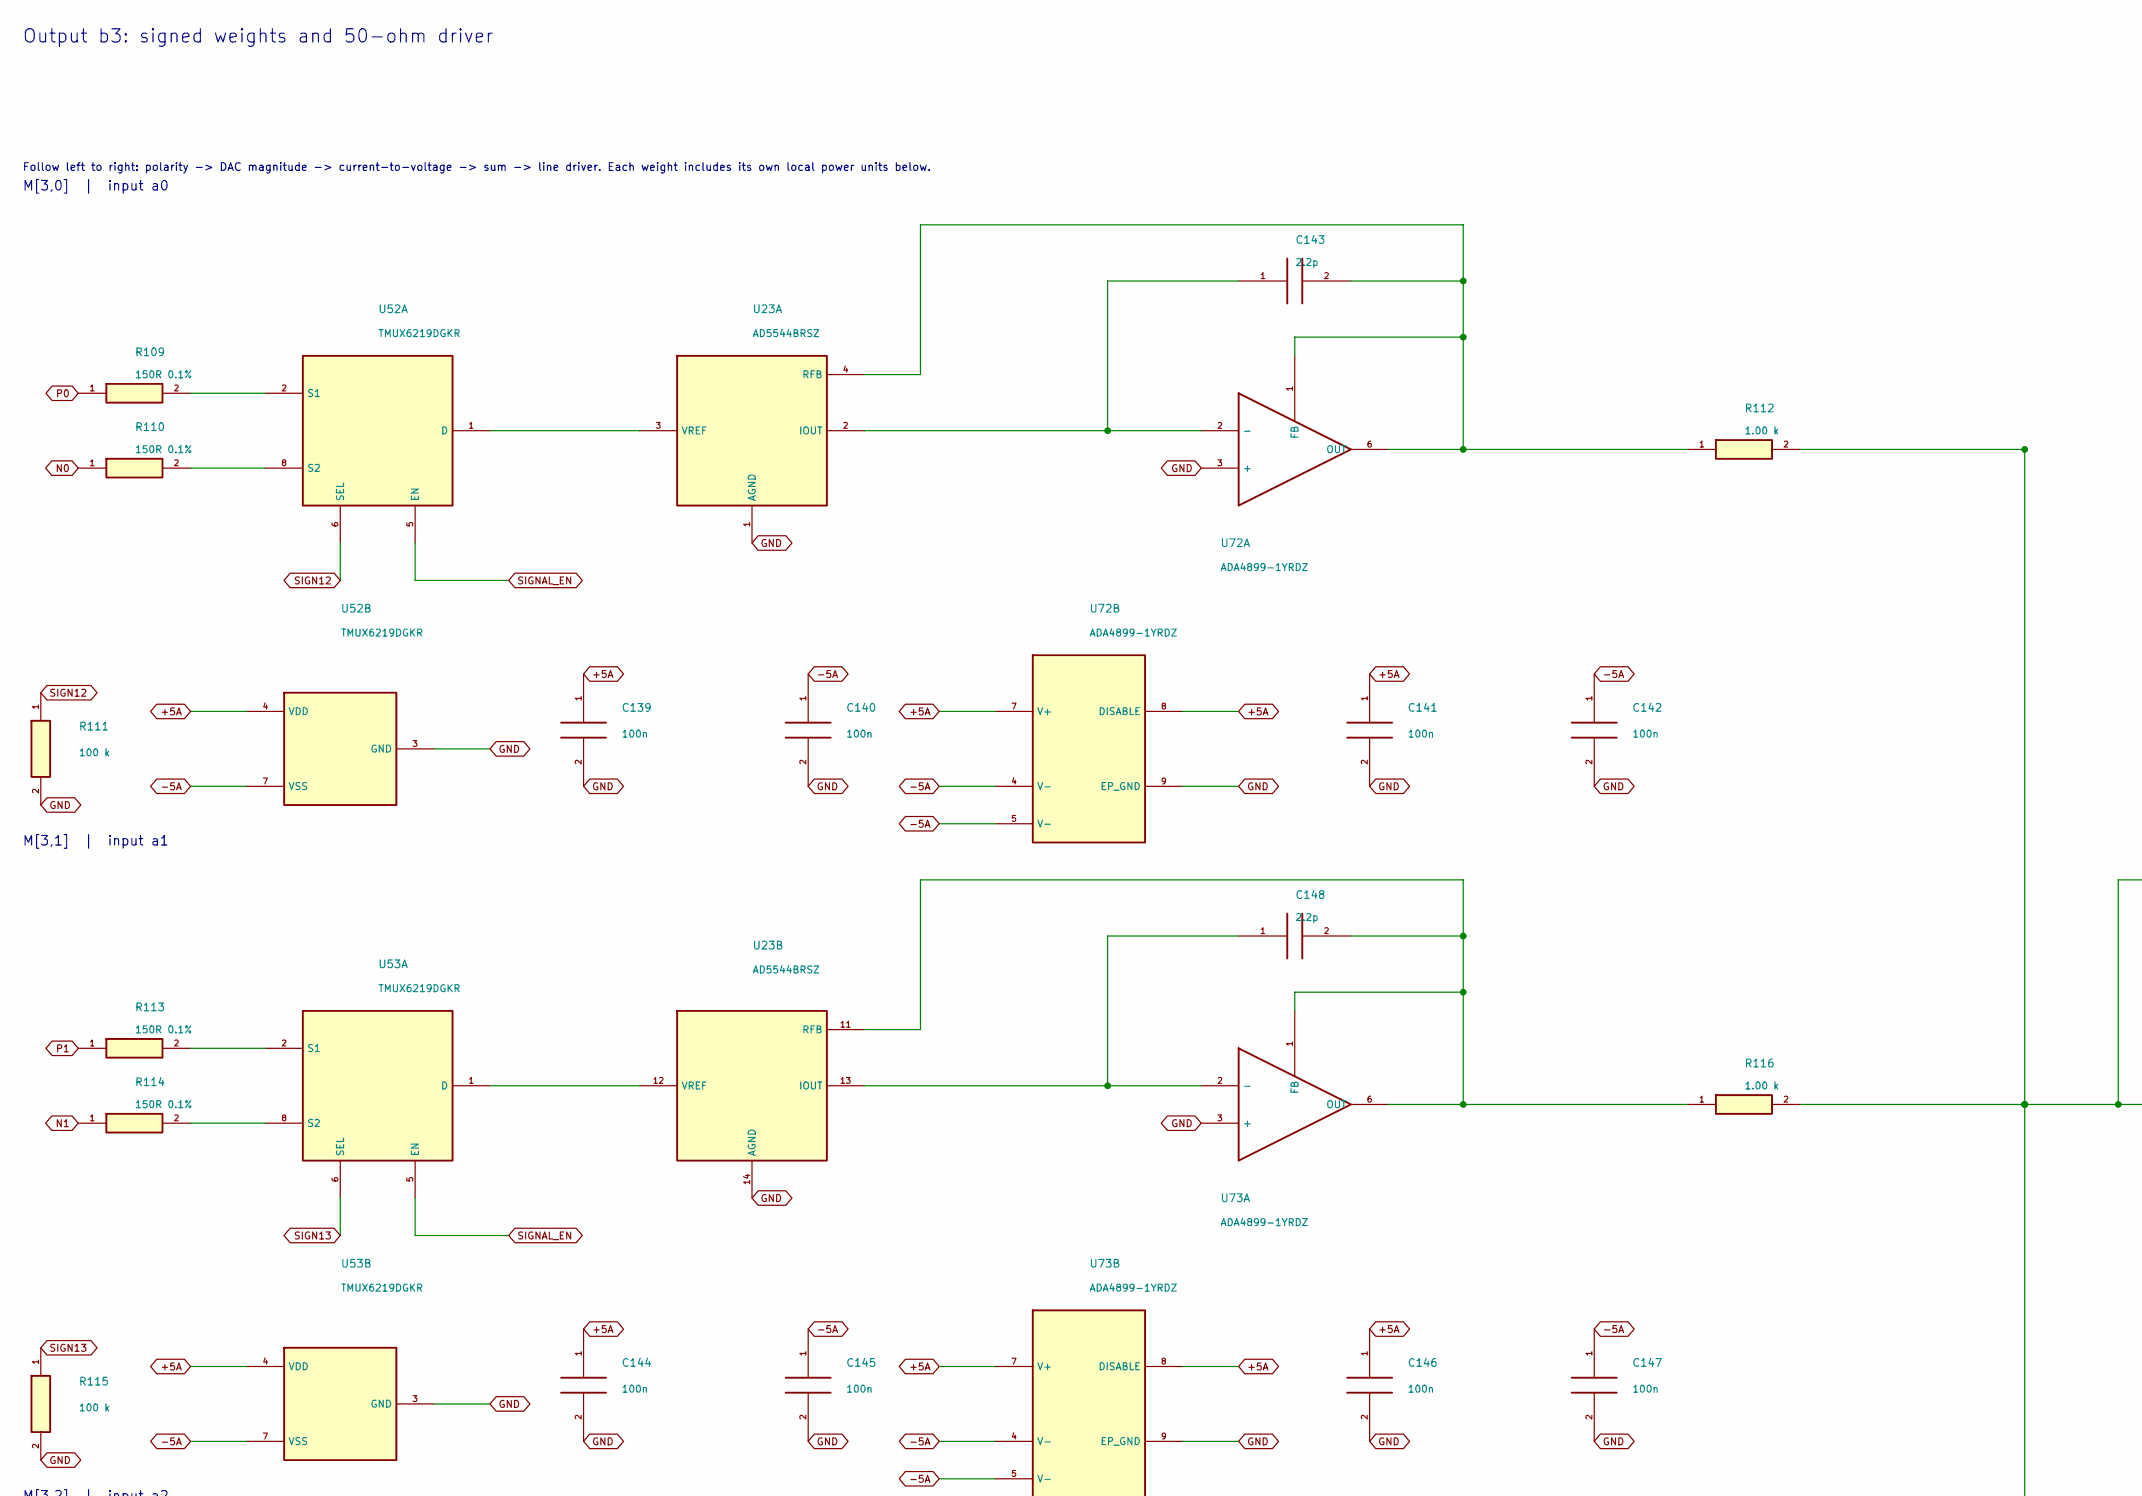
[picture p114: schematic row_3.kicad_sch, Output b3: signed weights and 50-ohm driver, part in row 1, column 1]

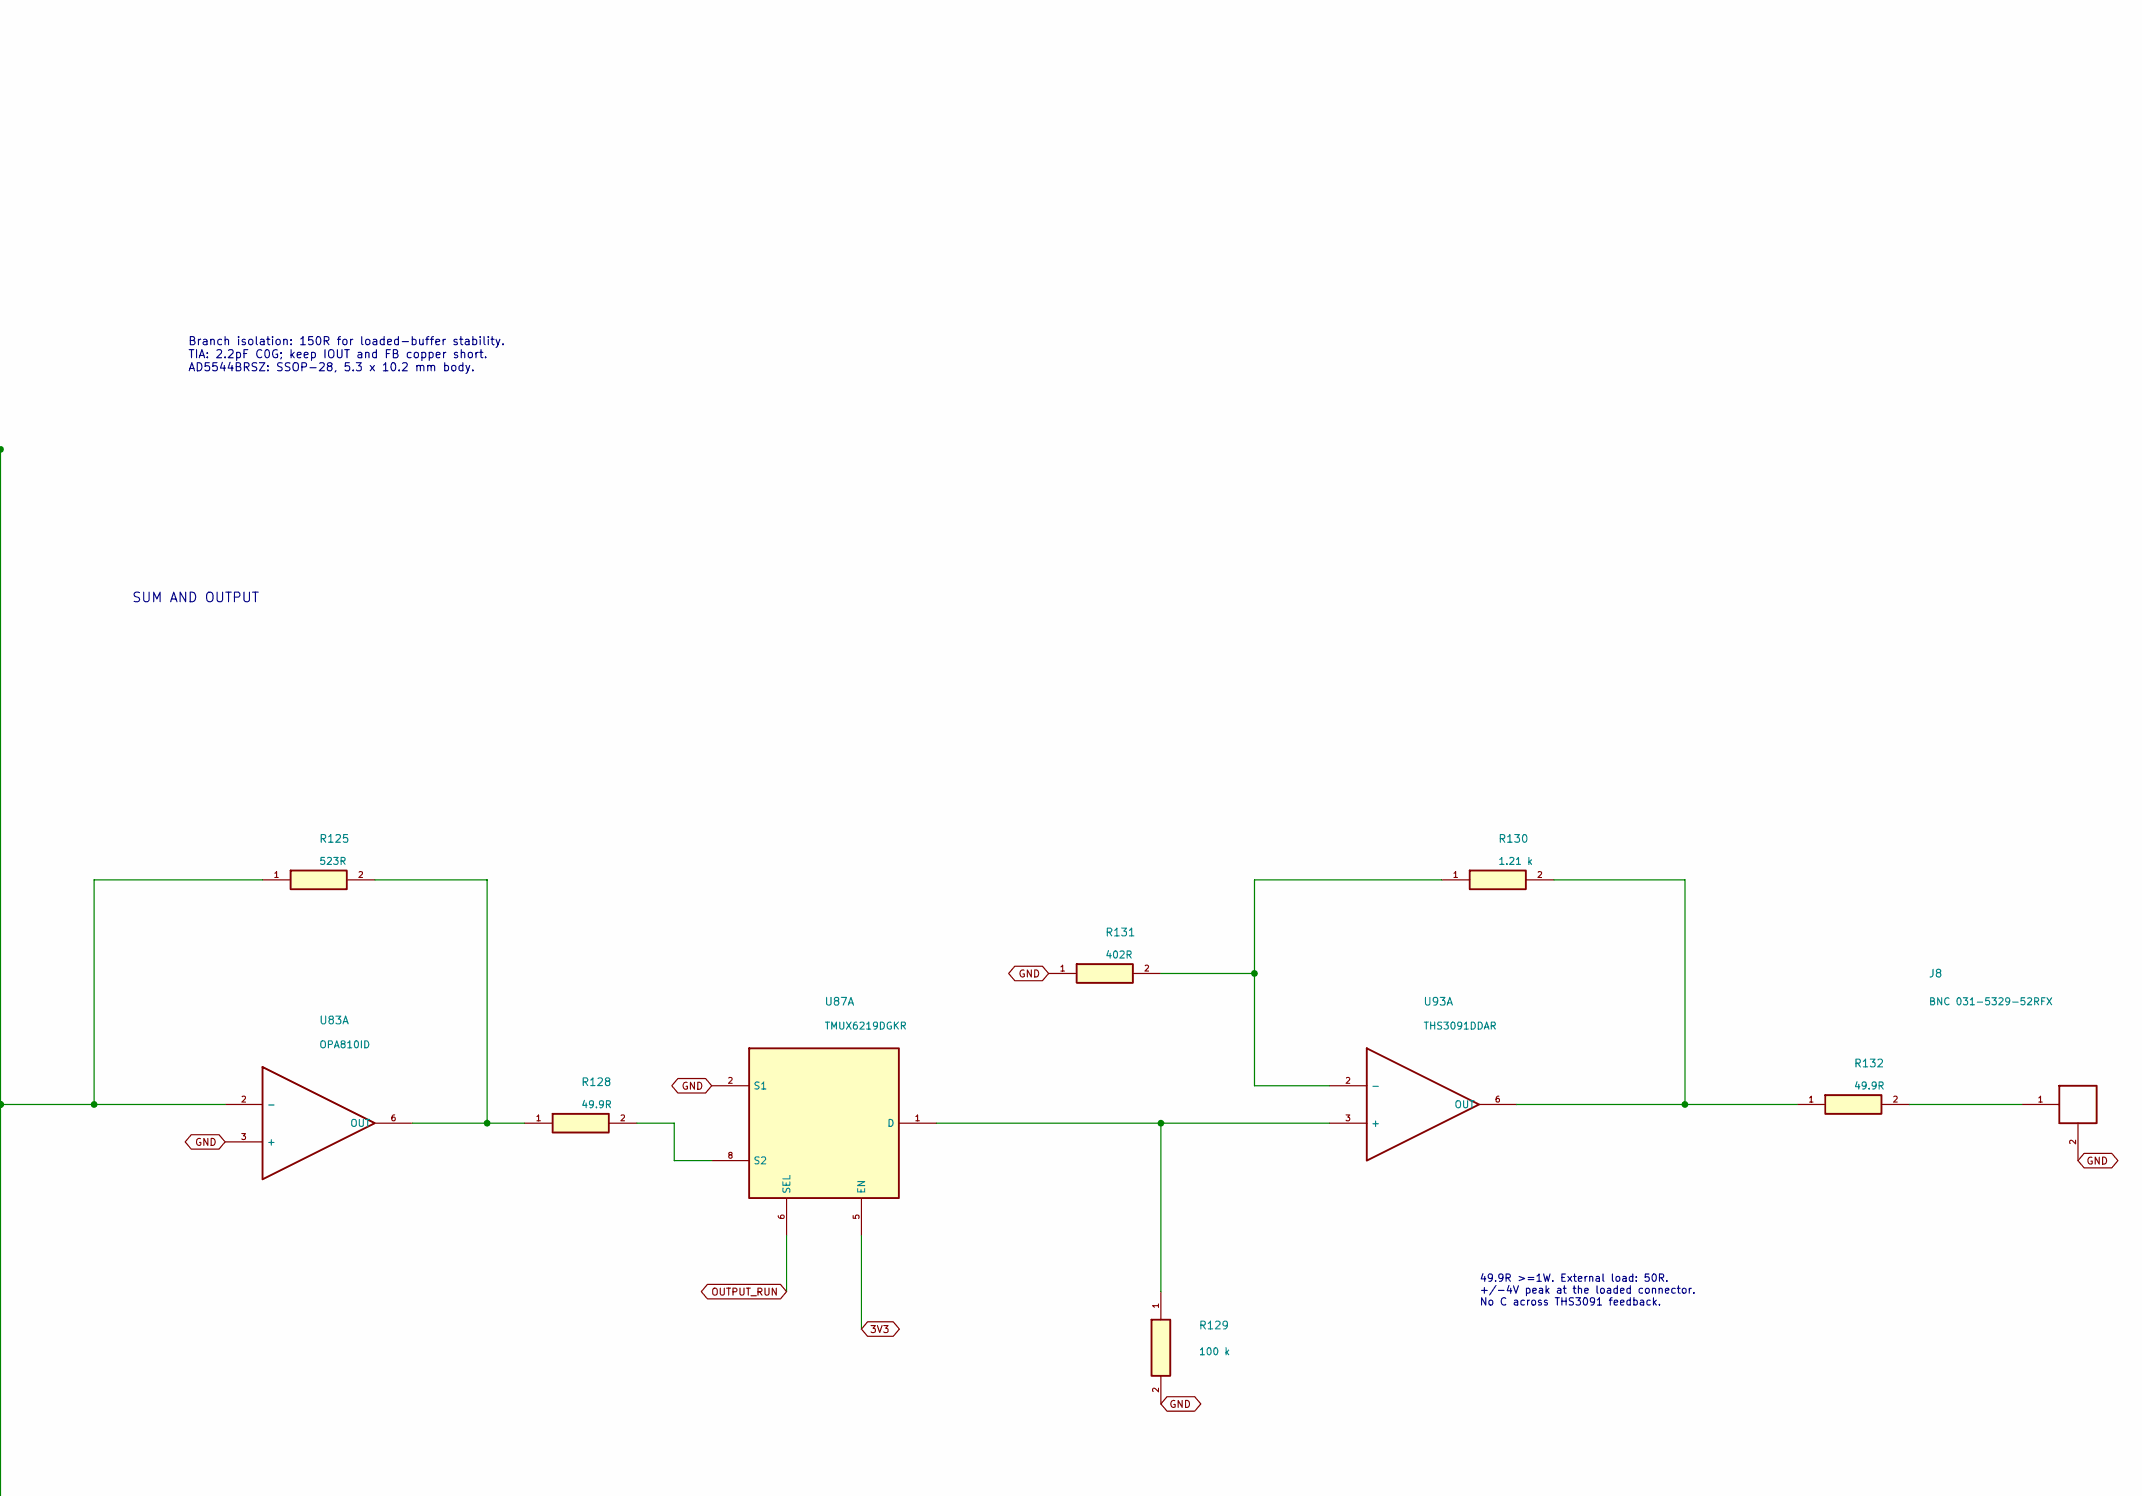
[picture p115: schematic row_3.kicad_sch, Output b3: signed weights and 50-ohm driver, part in row 1, column 2]

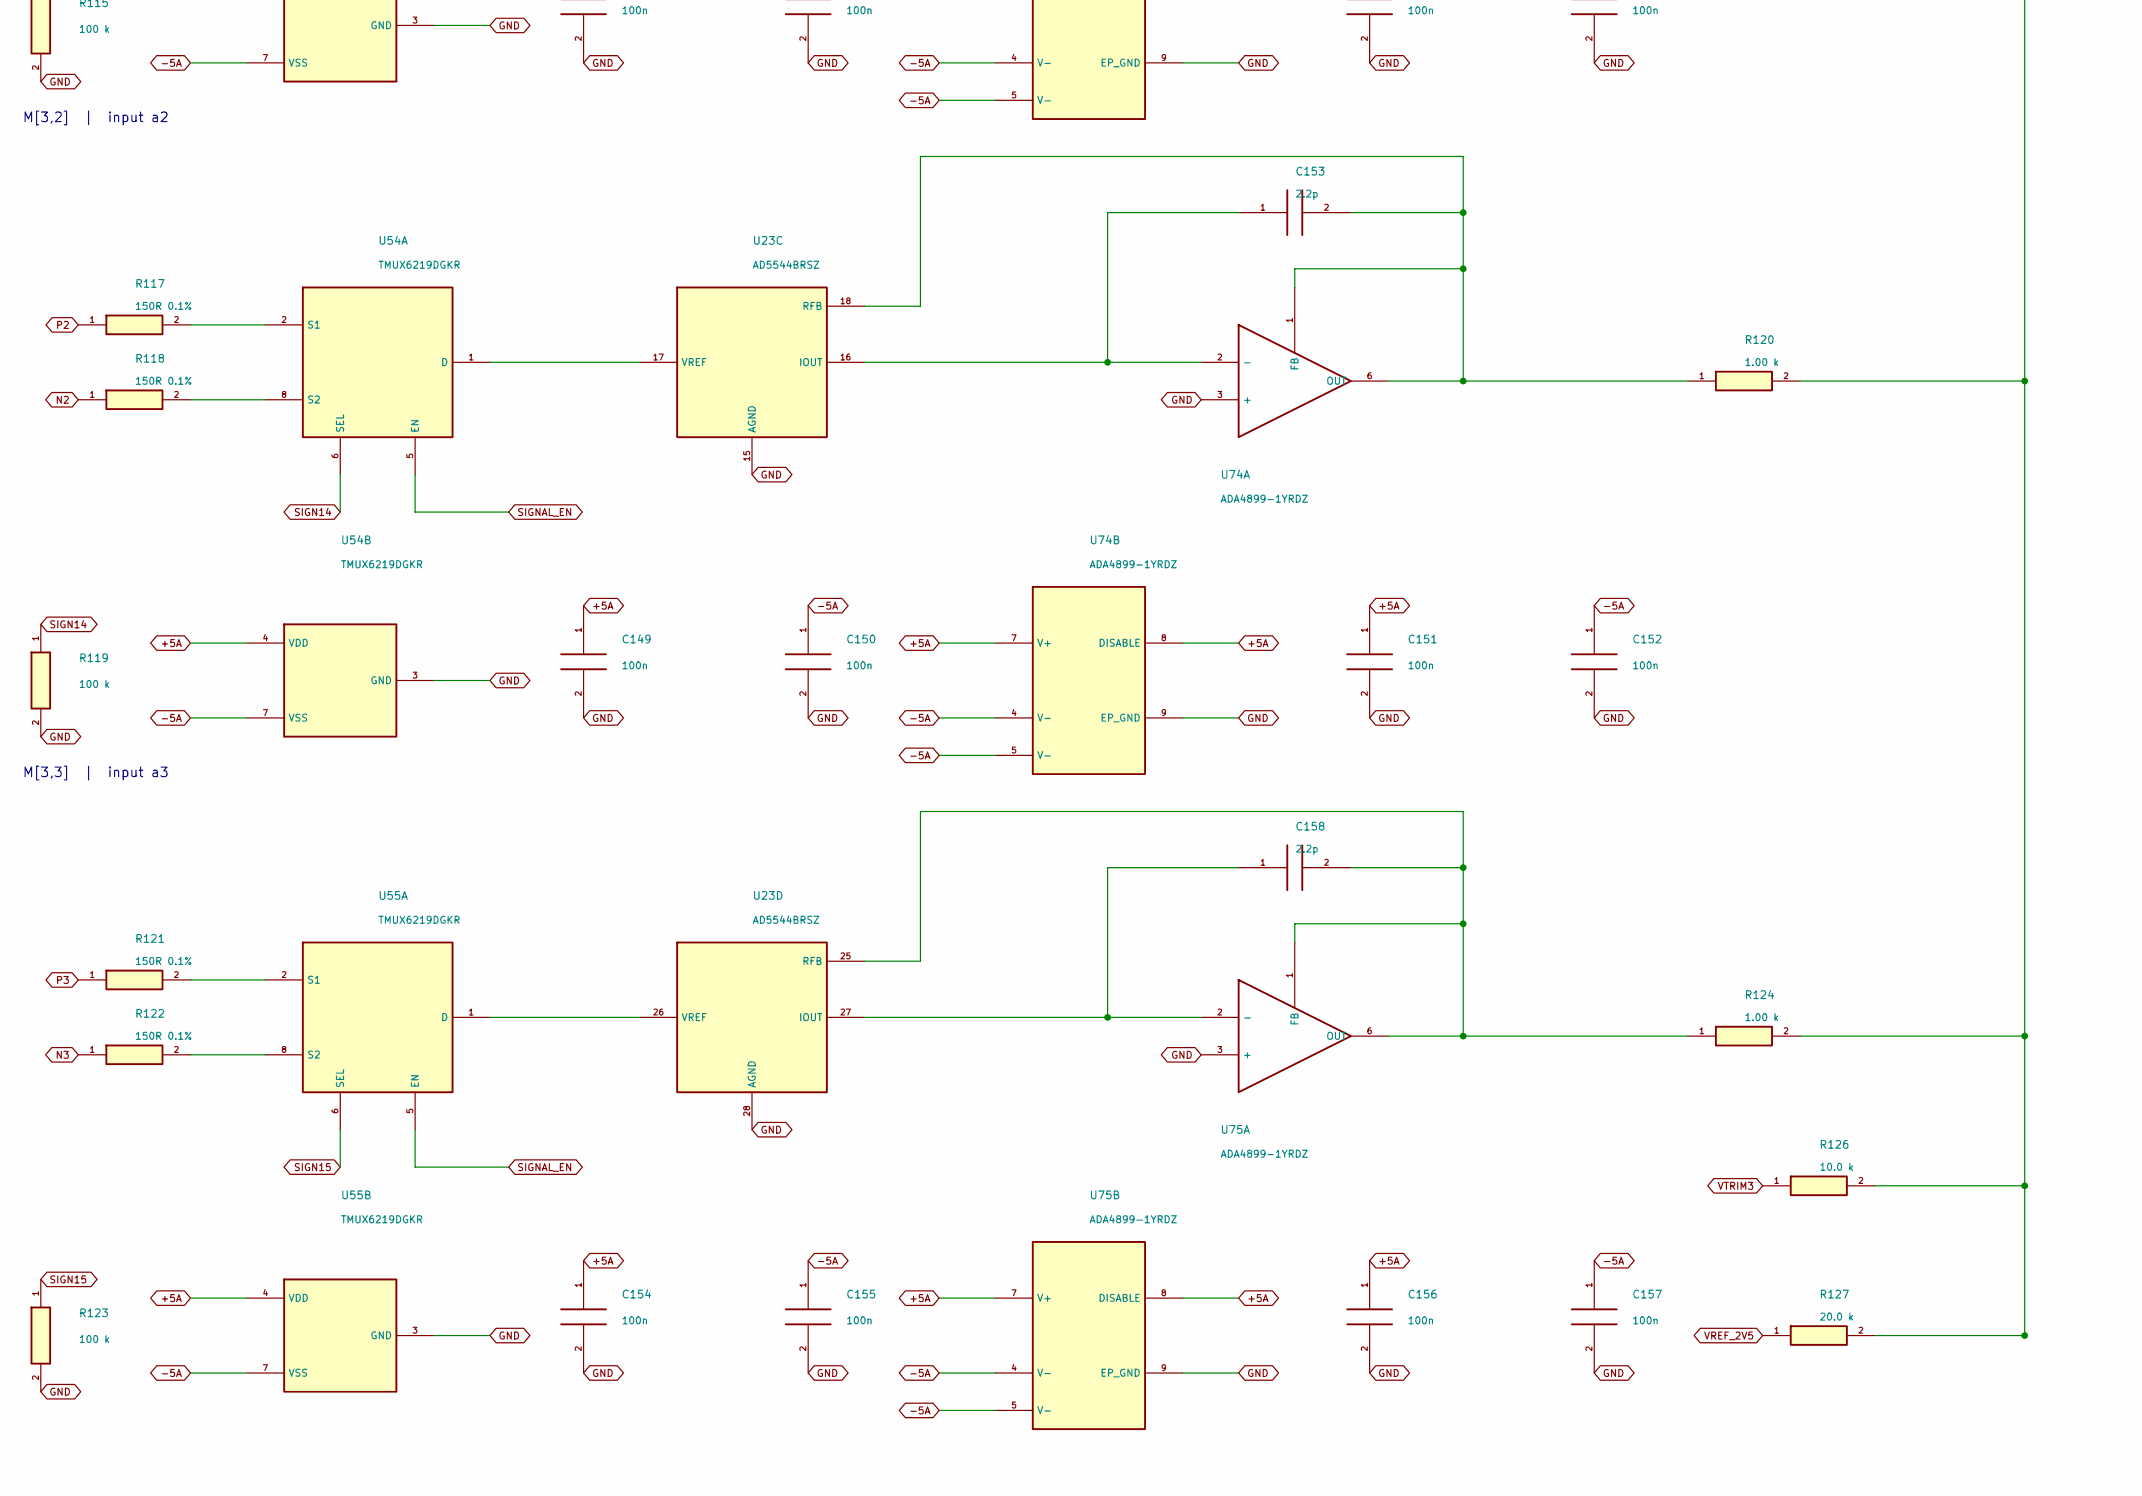
[picture p116: schematic row_3.kicad_sch, Output b3: signed weights and 50-ohm driver, part in row 2, column 1]

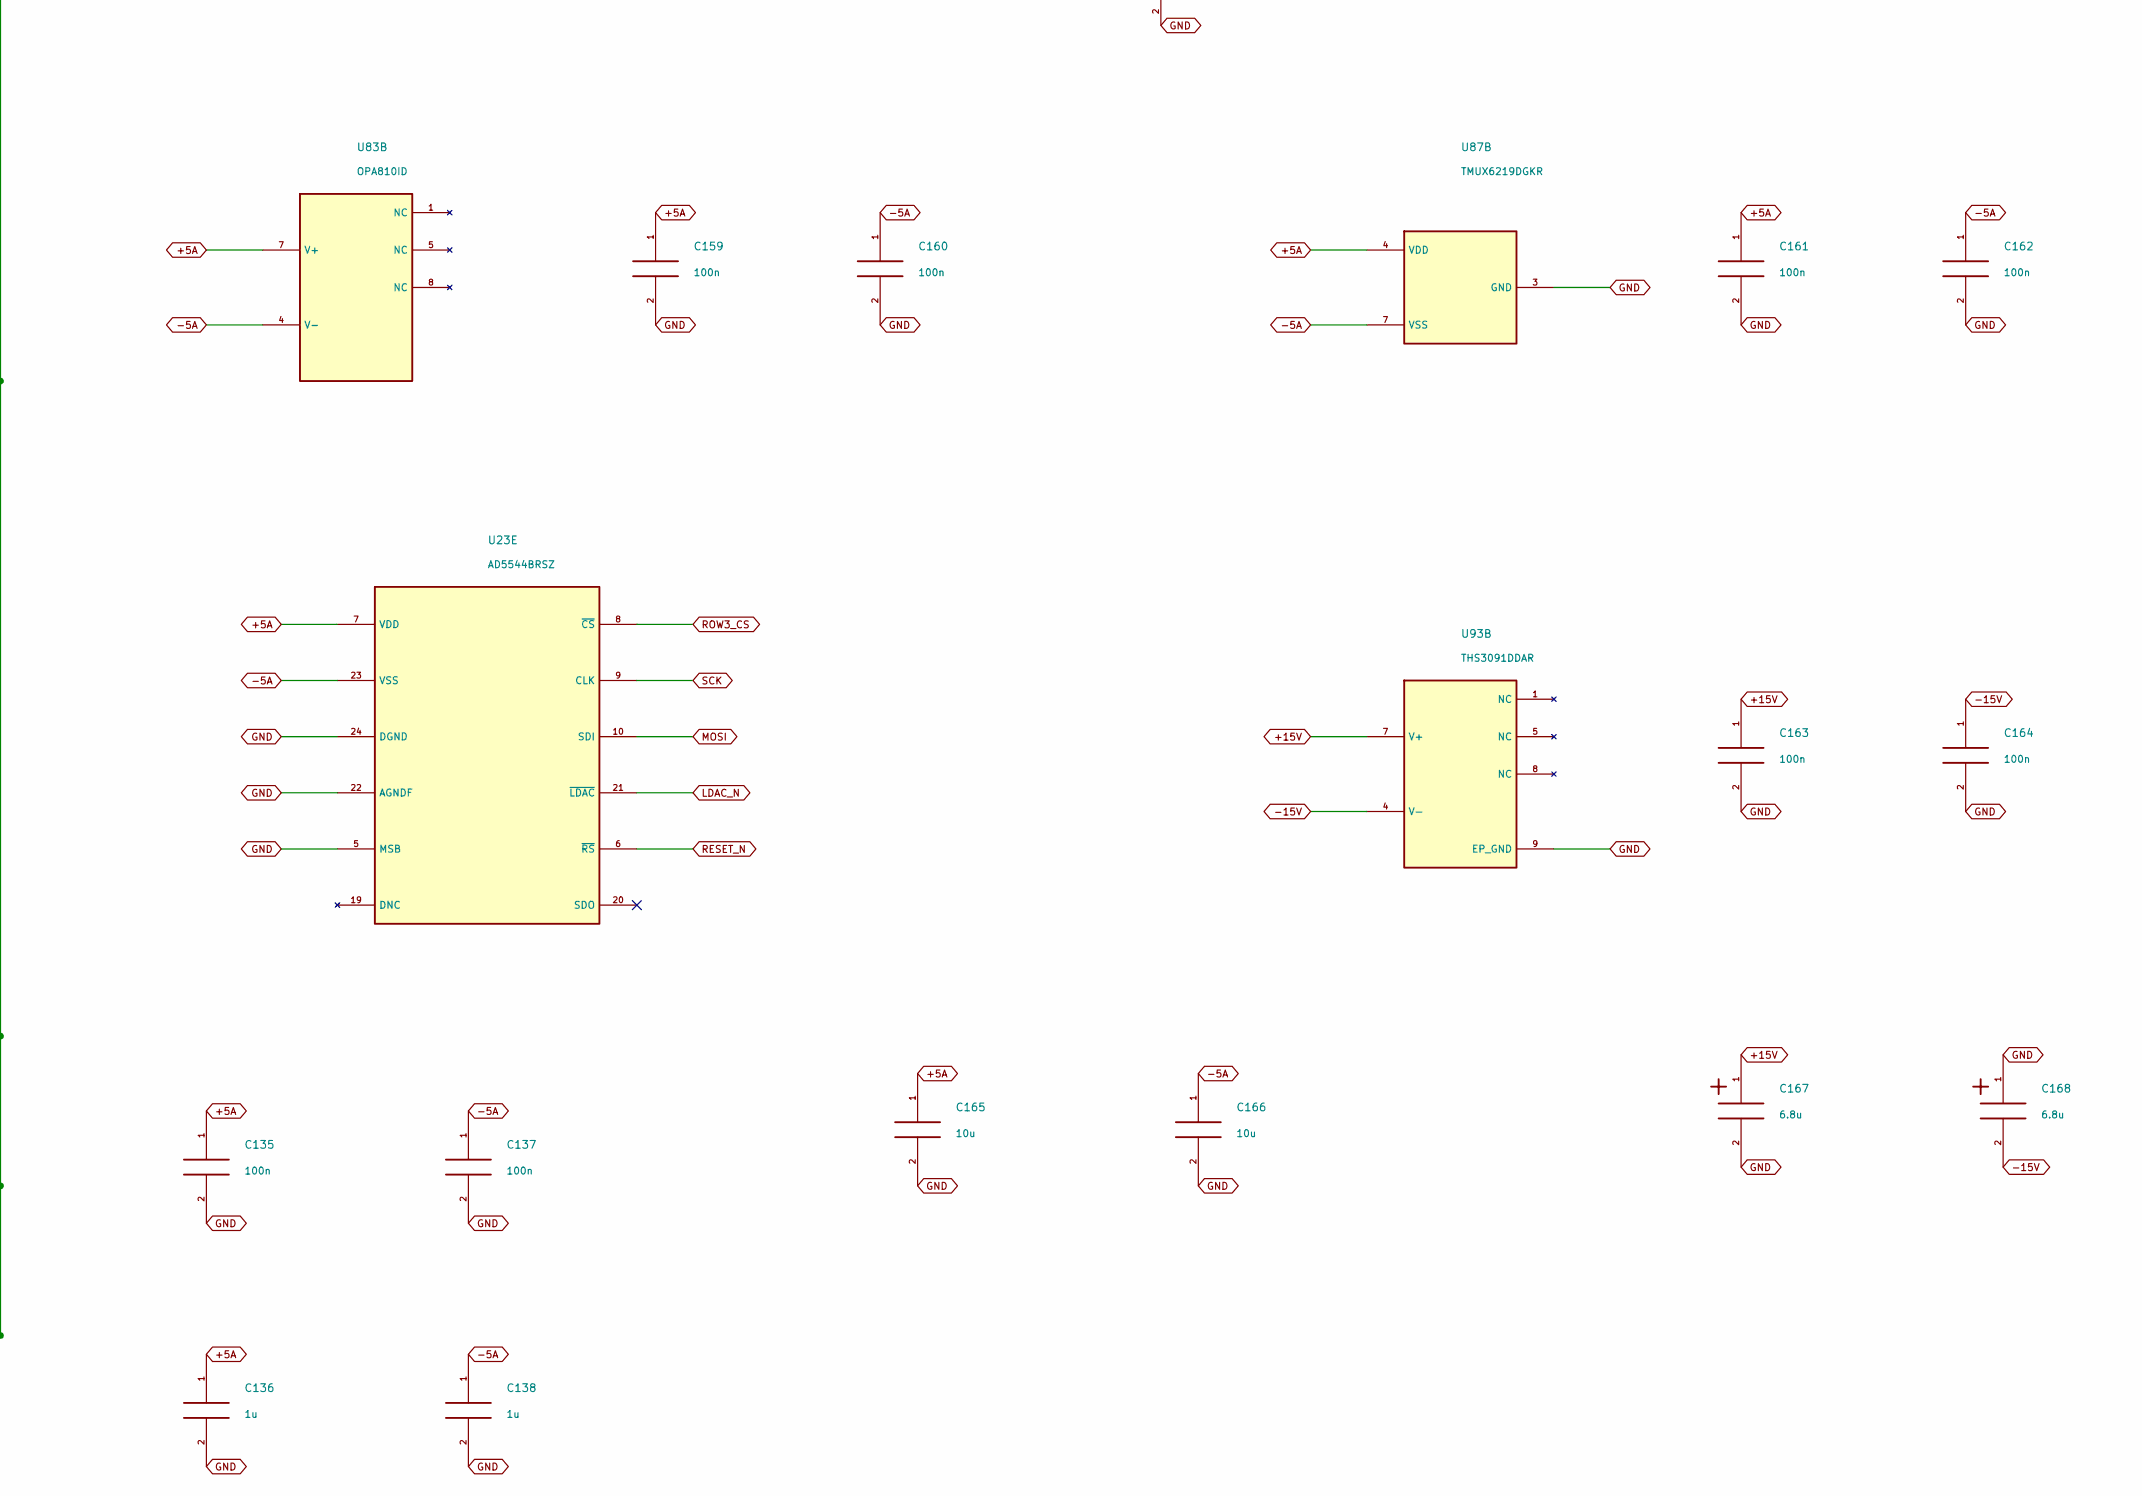
[picture p117: schematic row_3.kicad_sch, Output b3: signed weights and 50-ohm driver, part in row 2, column 2]

Parts:
C135, C137, C139, C140, C141, C142, C144, C145, C146, C147, C149, C150, C151, C152, C154, C155, C156, C157, C159, C160, C161, C162, C163, C164: 100n; C_0603_1608Metric; Rating 25V X7R minimum; effective C after bias
C136, C138: 1u; C_0805_2012Metric; Rating 25V X7R minimum; effective C after bias
C143, C148, C153, C158: 2.2p; C_0402_1005Metric; Rating 50V C0G
C165, C166: 10u; C_0805_2012Metric; Rating 25V X7R minimum; effective C after bias
C167, C168: 6.8u; CP_EIA-3216-18_Kemet-A; Rating 25V polarized
J8: BNC 031-5329-52RFX; BNC_Amphenol_031-5329-52RFX_Vertical
R109, R110, R113, R114, R117, R118, R121, R122: 150R 0.1%; R_0603_1608Metric; Rating 0.1%, <=25ppm/C; 0.1W minimum
R111, R115, R119, R123, R129: 100 k; R_0603_1608Metric; Rating 0.1%, <=25ppm/C; 0.1W minimum
R112, R116, R120, R124: 1.00 k; R_0603_1608Metric; Rating 0.1%, <=25ppm/C; 0.1W minimum
R125: 523R; R_0603_1608Metric; Rating 0.1%, <=25ppm/C; 0.1W minimum
R126: 10.0 k; R_0603_1608Metric; Rating 0.1%, <=25ppm/C; 0.1W minimum
R127: 20.0 k; R_0603_1608Metric; Rating 0.1%, <=25ppm/C; 0.1W minimum
R128: 49.9R; R_0603_1608Metric; Rating 0.1%, <=25ppm/C; 0.1W minimum
R130: 1.21 k; R_0603_1608Metric; Rating 0.1%, <=25ppm/C; 0.1W minimum
R131: 402R; R_0603_1608Metric; Rating 0.1%, <=25ppm/C; 0.1W minimum
R132: 49.9R; R_2512_6332Metric; Rating 0.1%, <=25ppm/C; >=1W
U23: AD5544BRSZ; SSOP-28_5.3x10.2mm_P0.65mm
U52, U53, U54, U55, U87: TMUX6219DGKR; VSSOP-8_3x3mm_P0.65mm
U72, U73, U74, U75: ADA4899-1YRDZ; ADA4899_RD8_EP2.29x2.29
U83: OPA810ID; SOIC-8_3.9x4.9mm_P1.27mm
U93: THS3091DDAR; SOIC-8-1EP_3.9x4.9mm_P1.27mm_EP2.95x4.9mm_Mask2.71x3.4mm_Th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

Connections:
3V3: U87.5 (EN); also elsewhere on the board
+5A: C135.1, C136.1, C139.1, C141.1, C144.1, C146.1, C149.1, C151.1, C154.1, C156.1, C159.1, C161.1, C165.1, U23.7 (VDD), U52.4 (VDD), U53.4 (VDD), U54.4 (VDD), U55.4 (VDD), U72.7 (V+), U72.8 (DISABLE), U73.7 (V+), U73.8 (DISABLE), U74.7 (V+), U74.8 (DISABLE), U75.7 (V+), U75.8 (DISABLE), U83.7 (V+), U87.4 (VDD); also elsewhere on the board
+15V: C163.1, C167.1, U93.7 (V+); also elsewhere on the board
-5A: C137.1, C138.1, C140.1, C142.1, C145.1, C147.1, C150.1, C152.1, C155.1, C157.1, C160.1, C162.1, C166.1, U23.23 (VSS), U52.7 (VSS), U53.7 (VSS), U54.7 (VSS), U55.7 (VSS), U72.4 (V-), U72.5 (V-), U73.4 (V-), U73.5 (V-), U74.4 (V-), U74.5 (V-), U75.4 (V-), U75.5 (V-), U83.4 (V-), U87.7 (VSS); also elsewhere on the board
-15V: C164.1, C168.2, U93.4 (V-); also elsewhere on the board
GND: C135.2, C136.2, C137.2, C138.2, C139.2, C140.2, C141.2, C142.2, C144.2, C145.2, C146.2, C147.2, C149.2, C150.2, C151.2, C152.2, C154.2, C155.2, C156.2, C157.2, C159.2, C160.2, C161.2, C162.2, C163.2, C164.2, C165.2, C166.2, C167.2, C168.1, J8.2, R111.2, R115.2, R119.2, R123.2, R129.2, R131.1, U23.1 (AGND), U23.5 (MSB), U23.14 (AGND), U23.15 (AGND), U23.22 (AGNDF), U23.24 (DGND), U23.28 (AGND), U52.3 (GND), U53.3 (GND), U54.3 (GND), U55.3 (GND), U72.3 (+), U72.9 (EP_GND), U73.3 (+), U73.9 (EP_GND), U74.3 (+), U74.9 (EP_GND), U75.3 (+), U75.9 (EP_GND), U83.3 (+), U87.2 (S1), U87.3 (GND), U93.9 (EP_GND); also elsewhere on the board
LDAC_N: U23.21 (~LDAC); also elsewhere on the board
MOSI: U23.10 (SDI); also elsewhere on the board
N0: R110.1; also elsewhere on the board
N1: R114.1; also elsewhere on the board
N2: R118.1; also elsewhere on the board
N3: R122.1; also elsewhere on the board
unnamed: J8.1, R132.2
unnamed: C143.1, U23.2 (IOUT), U72.2 (-)
unnamed: C143.2, R112.1, U23.4 (RFB), U72.1 (FB), U72.6 (OUT)
unnamed: U23.3 (VREF), U52.1 (D)
unnamed: C148.1, U23.13 (IOUT), U73.2 (-)
unnamed: C148.2, R116.1, U23.11 (RFB), U73.1 (FB), U73.6 (OUT)
unnamed: U23.12 (VREF), U53.1 (D)
unnamed: C153.1, U23.16 (IOUT), U74.2 (-)
unnamed: C153.2, R120.1, U23.18 (RFB), U74.1 (FB), U74.6 (OUT)
unnamed: U23.17 (VREF), U54.1 (D)
unnamed: C158.1, U23.27 (IOUT), U75.2 (-)
unnamed: C158.2, R124.1, U23.25 (RFB), U75.1 (FB), U75.6 (OUT)
unnamed: U23.26 (VREF), U55.1 (D)
unnamed: R109.2, U52.2 (S1)
unnamed: R110.2, U52.8 (S2)
unnamed: R113.2, U53.2 (S1)
unnamed: R114.2, U53.8 (S2)
unnamed: R117.2, U54.2 (S1)
unnamed: R118.2, U54.8 (S2)
unnamed: R121.2, U55.2 (S1)
unnamed: R122.2, U55.8 (S2)
unnamed: R112.2, R116.2, R120.2, R124.2, R125.1, R126.2, R127.2, U83.2 (-)
unnamed: R125.2, R128.1, U83.6 (OUT)
unnamed: R129.1, U87.1 (D), U93.3 (+)
unnamed: R128.2, U87.8 (S2)
unnamed: R130.1, R131.2, U93.2 (-)
unnamed: R130.2, R132.1, U93.6 (OUT)
OUTPUT_RUN: U87.6 (SEL); also elsewhere on the board
P0: R109.1; also elsewhere on the board
P1: R113.1; also elsewhere on the board
P2: R117.1; also elsewhere on the board
P3: R121.1; also elsewhere on the board
RESET_N: U23.6 (~RS); also elsewhere on the board
ROW3_CS: U23.8 (~CS); also elsewhere on the board
SCK: U23.9 (CLK); also elsewhere on the board
SIGN12: R111.1, U52.6 (SEL); also elsewhere on the board
SIGN13: R115.1, U53.6 (SEL); also elsewhere on the board
SIGN14: R119.1, U54.6 (SEL); also elsewhere on the board
SIGN15: R123.1, U55.6 (SEL); also elsewhere on the board
SIGNAL_EN: U52.5 (EN), U53.5 (EN), U54.5 (EN), U55.5 (EN); also elsewhere on the board
VREF_2V5: R127.1; also elsewhere on the board
VTRIM3: R126.1; also elsewhere on the board

Notes on the sheet:
Output b3: signed weights and 50-ohm driver
Follow left to right: polarity -> DAC magnitude -> current-to-voltage -> sum -> line driver. Each weight includes its own local power units below.
M[3,0] | input a0
M[3,1] | input a1
M[3,2] | input a2
M[3,3] | input a3
SUM AND OUTPUT
49.9R >=1W. External load: 50R. +/-4V peak at the loaded connector. No C across THS3091 feedback.
Branch isolation: 150R for loaded-buffer stability. TIA: 2.2pF C0G; keep IOUT and FB copper short. AD5544BRSZ: SSOP-28, 5.3 x 10.2 mm body.
