tim4431/analog_programmable_matrix/pcb/analog_matrix_4x4_rev_d/analog_matrix_4x4.kicad_pcb

## KiCad design pcb/analog_matrix_4x4_rev_d/analog_matrix_4x4.kicad_pcb (continued)

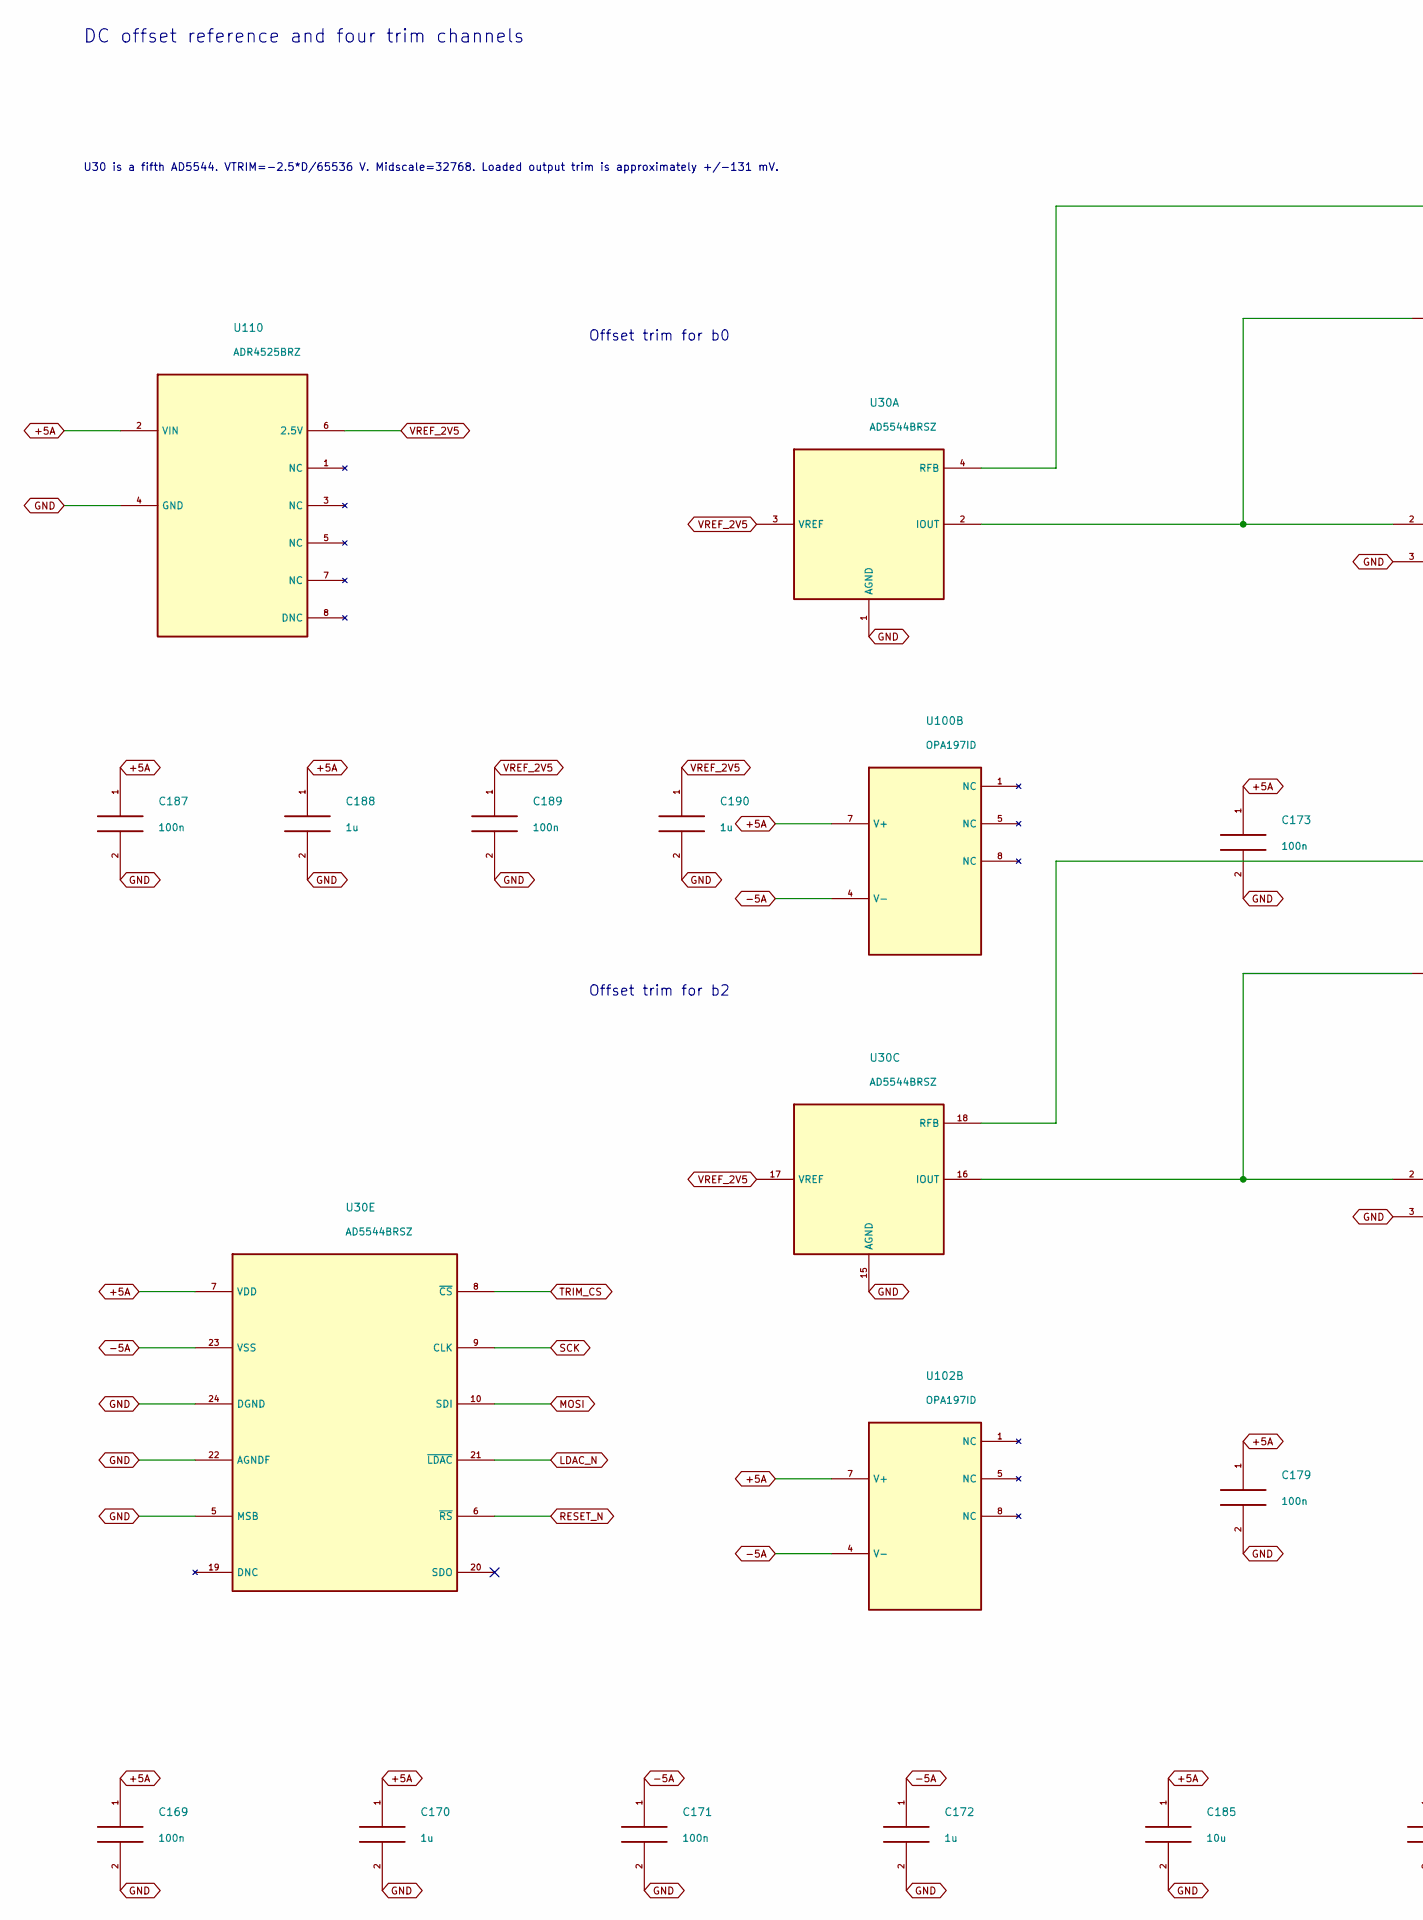
[picture p118: schematic offset_trim.kicad_sch, DC offset reference and four trim channels, part in row 1, column 1]

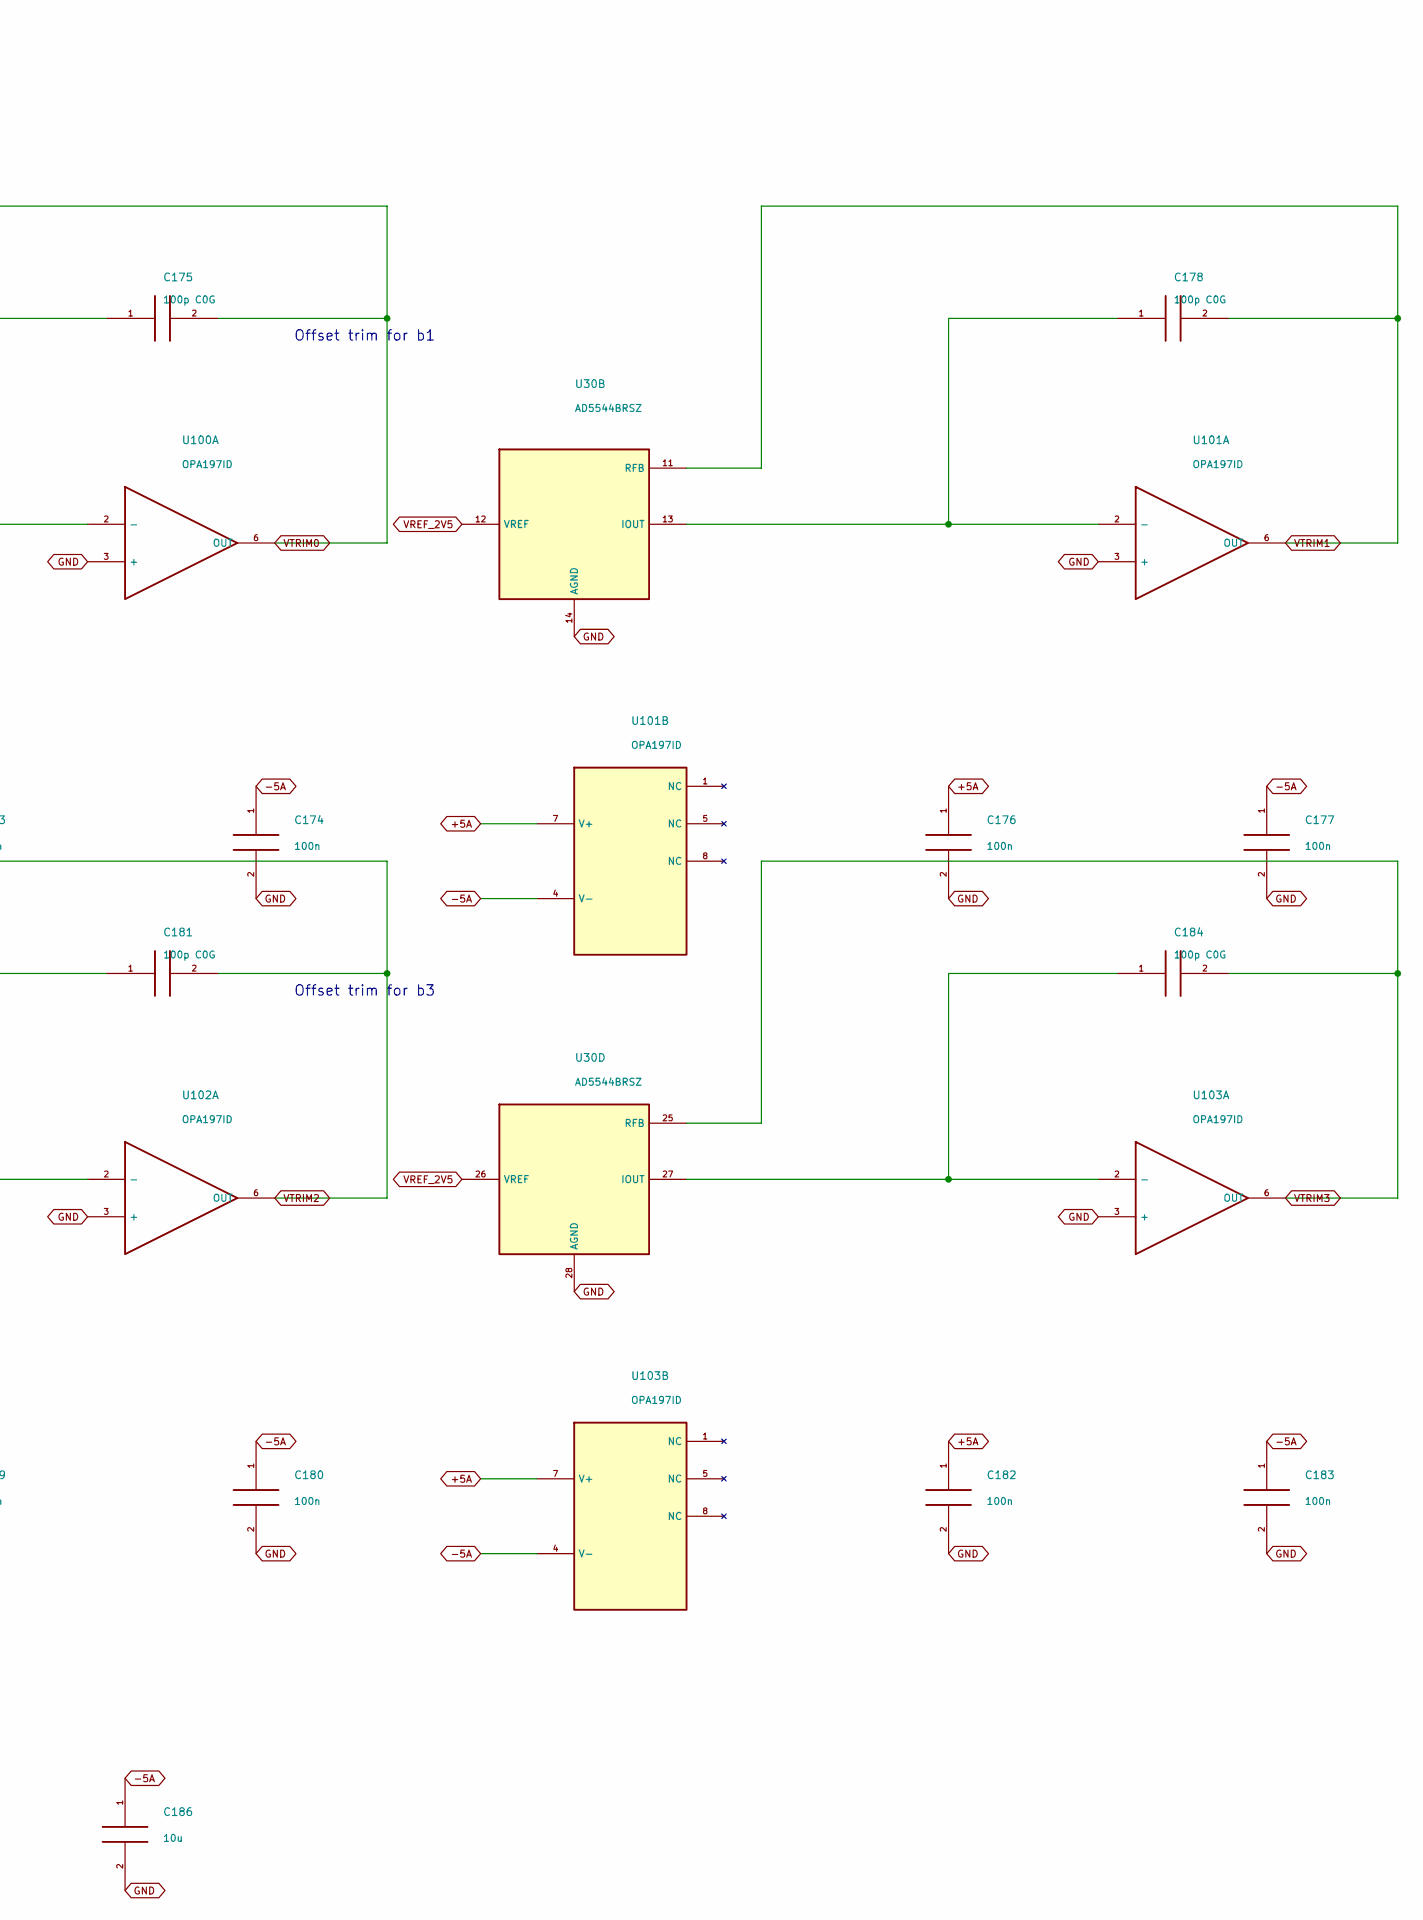
[picture p119: schematic offset_trim.kicad_sch, DC offset reference and four trim channels, part in row 1, column 2]

Parts:
C169, C171, C173, C174, C176, C177, C179, C180, C182, C183, C187, C189: 100n; C_0603_1608Metric; Rating 25V X7R minimum; effective C after bias
C170, C172, C188, C190: 1u; C_0805_2012Metric; Rating 25V X7R minimum; effective C after bias
C175, C178, C181, C184: 100p C0G; C_0603_1608Metric; Rating 50V C0G
C185, C186: 10u; C_0805_2012Metric; Rating 25V X7R minimum; effective C after bias
U30: AD5544BRSZ; SSOP-28_5.3x10.2mm_P0.65mm
U100, U101, U102, U103: OPA197ID; SOIC-8_3.9x4.9mm_P1.27mm
U110: ADR4525BRZ; SOIC-8_3.9x4.9mm_P1.27mm

Connections:
+5A: C169.1, C170.1, C173.1, C176.1, C179.1, C182.1, C185.1, C187.1, C188.1, U30.7 (VDD), U100.7 (V+), U101.7 (V+), U102.7 (V+), U103.7 (V+), U110.2 (VIN); also elsewhere on the board
-5A: C171.1, C172.1, C174.1, C177.1, C180.1, C183.1, C186.1, U30.23 (VSS), U100.4 (V-), U101.4 (V-), U102.4 (V-), U103.4 (V-); also elsewhere on the board
GND: C169.2, C170.2, C171.2, C172.2, C173.2, C174.2, C176.2, C177.2, C179.2, C180.2, C182.2, C183.2, C185.2, C186.2, C187.2, C188.2, C189.2, C190.2, U30.1 (AGND), U30.5 (MSB), U30.14 (AGND), U30.15 (AGND), U30.22 (AGNDF), U30.24 (DGND), U30.28 (AGND), U100.3 (+), U101.3 (+), U102.3 (+), U103.3 (+), U110.4 (GND); also elsewhere on the board
LDAC_N: U30.21 (~LDAC); also elsewhere on the board
MOSI: U30.10 (SDI); also elsewhere on the board
unnamed: C175.1, U30.2 (IOUT), U100.2 (-)
unnamed: C178.1, U30.13 (IOUT), U101.2 (-)
unnamed: C181.1, U30.16 (IOUT), U102.2 (-)
unnamed: C184.1, U30.27 (IOUT), U103.2 (-)
RESET_N: U30.6 (~RS); also elsewhere on the board
SCK: U30.9 (CLK); also elsewhere on the board
TRIM_CS: U30.8 (~CS); also elsewhere on the board
VREF_2V5: C189.1, C190.1, U30.3 (VREF), U30.12 (VREF), U30.17 (VREF), U30.26 (VREF), U110.6 (2.5V); also elsewhere on the board
VTRIM0: C175.2, U30.4 (RFB), U100.6 (OUT); also elsewhere on the board
VTRIM1: C178.2, U30.11 (RFB), U101.6 (OUT); also elsewhere on the board
VTRIM2: C181.2, U30.18 (RFB), U102.6 (OUT); also elsewhere on the board
VTRIM3: C184.2, U30.25 (RFB), U103.6 (OUT); also elsewhere on the board

Notes on the sheet:
DC offset reference and four trim channels
U30 is a fifth AD5544. VTRIM=-2.5*D/65536 V. Midscale=32768. Loaded output trim is approximately +/-131 mV.
Offset trim for b0
Offset trim for b1
Offset trim for b2
Offset trim for b3

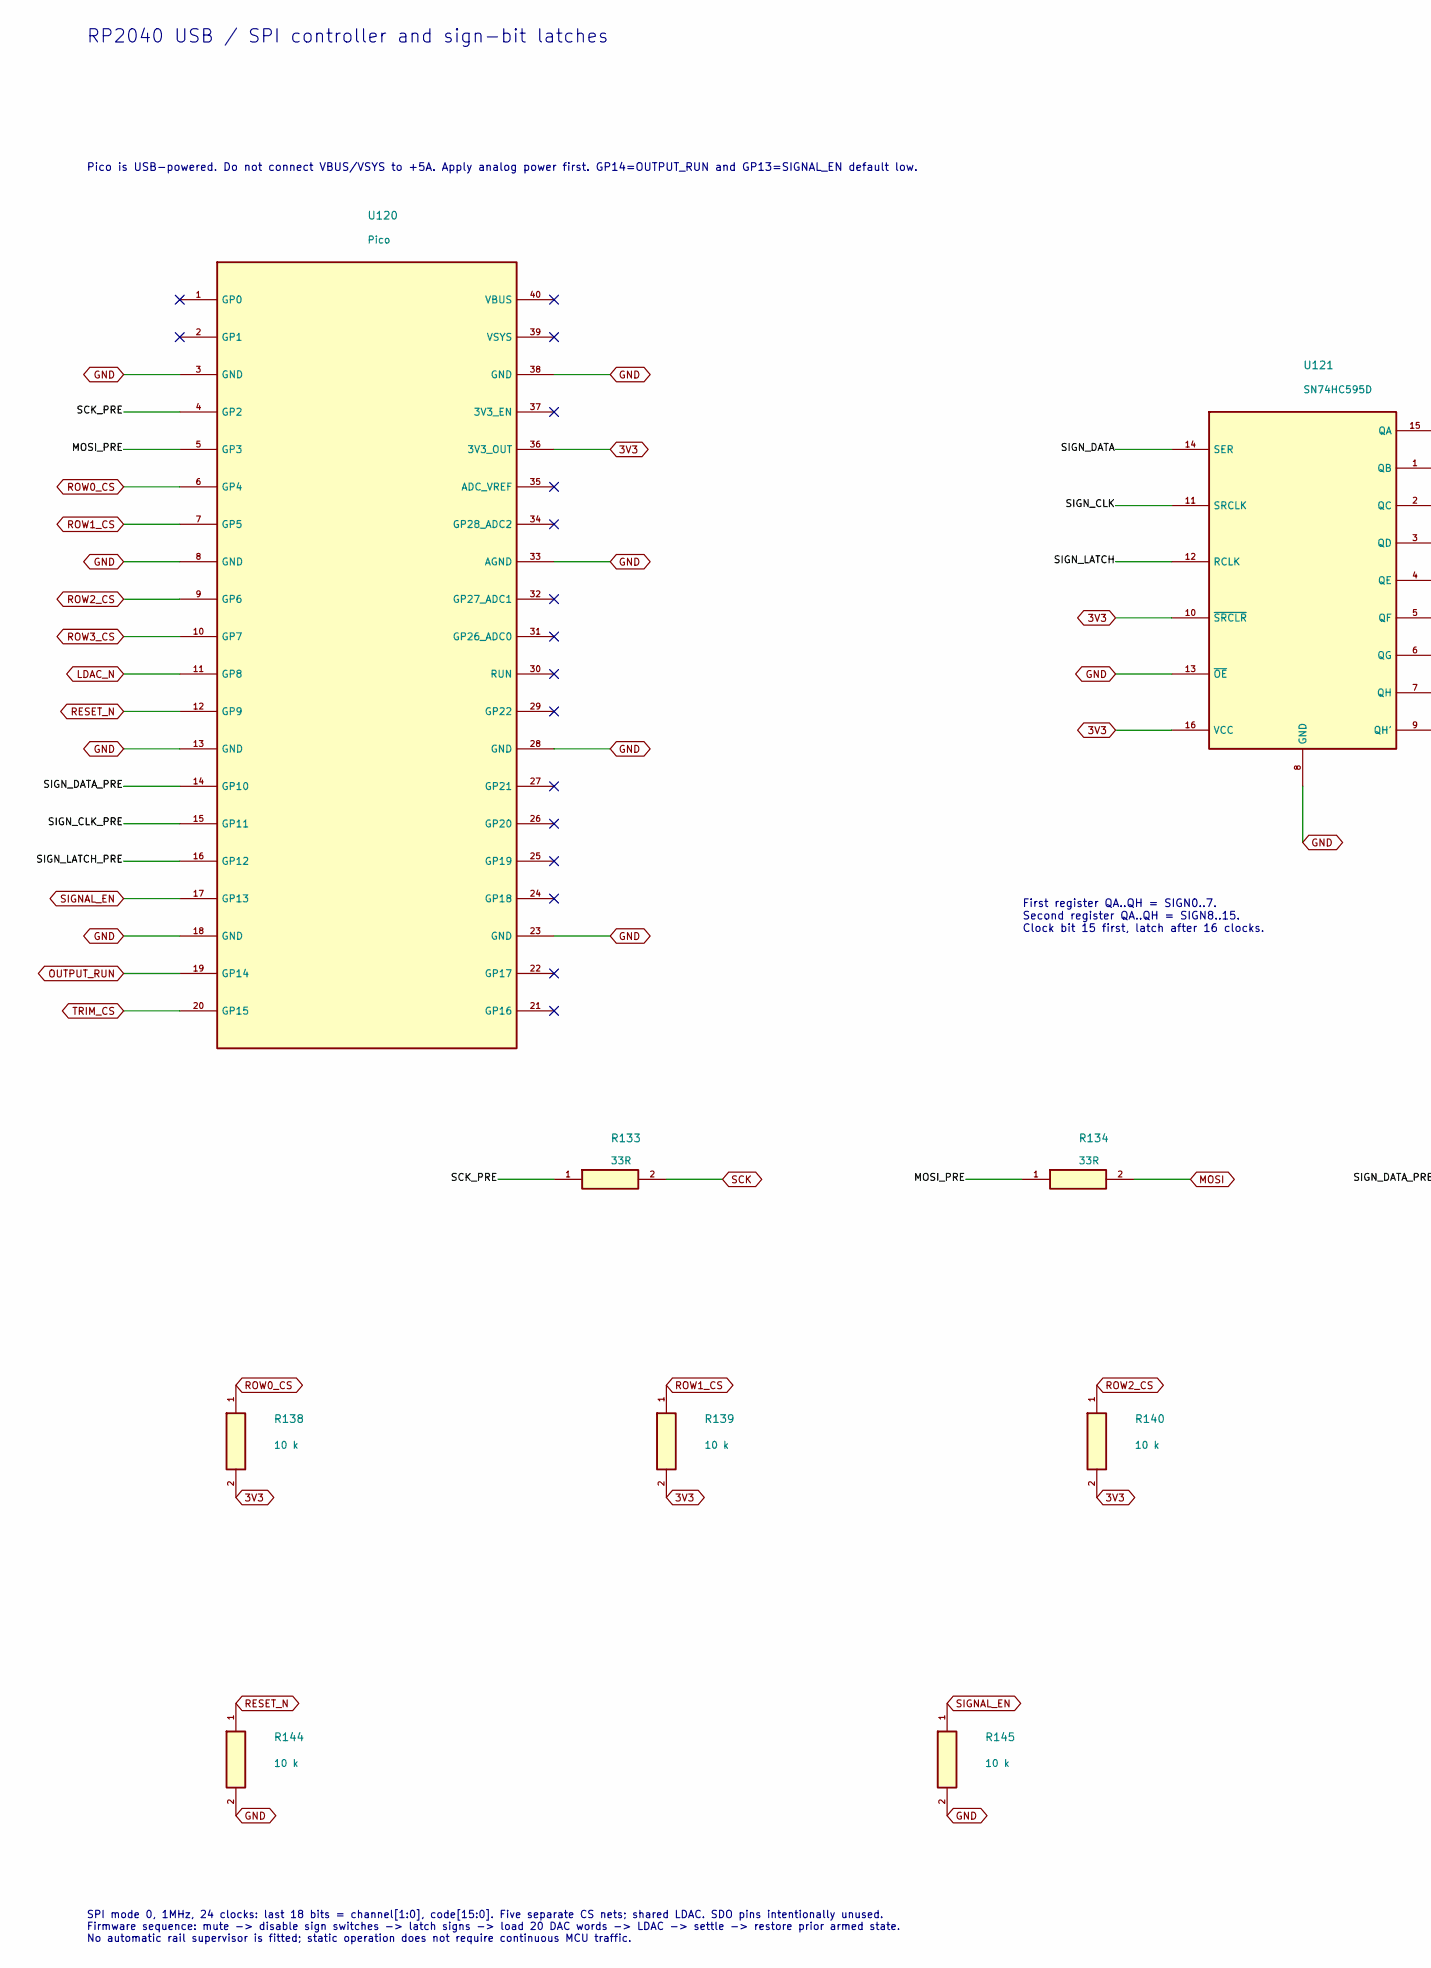
[picture p120: schematic control.kicad_sch, RP2040 USB / SPI controller and sign-bit latches, part in row 1, column 1]

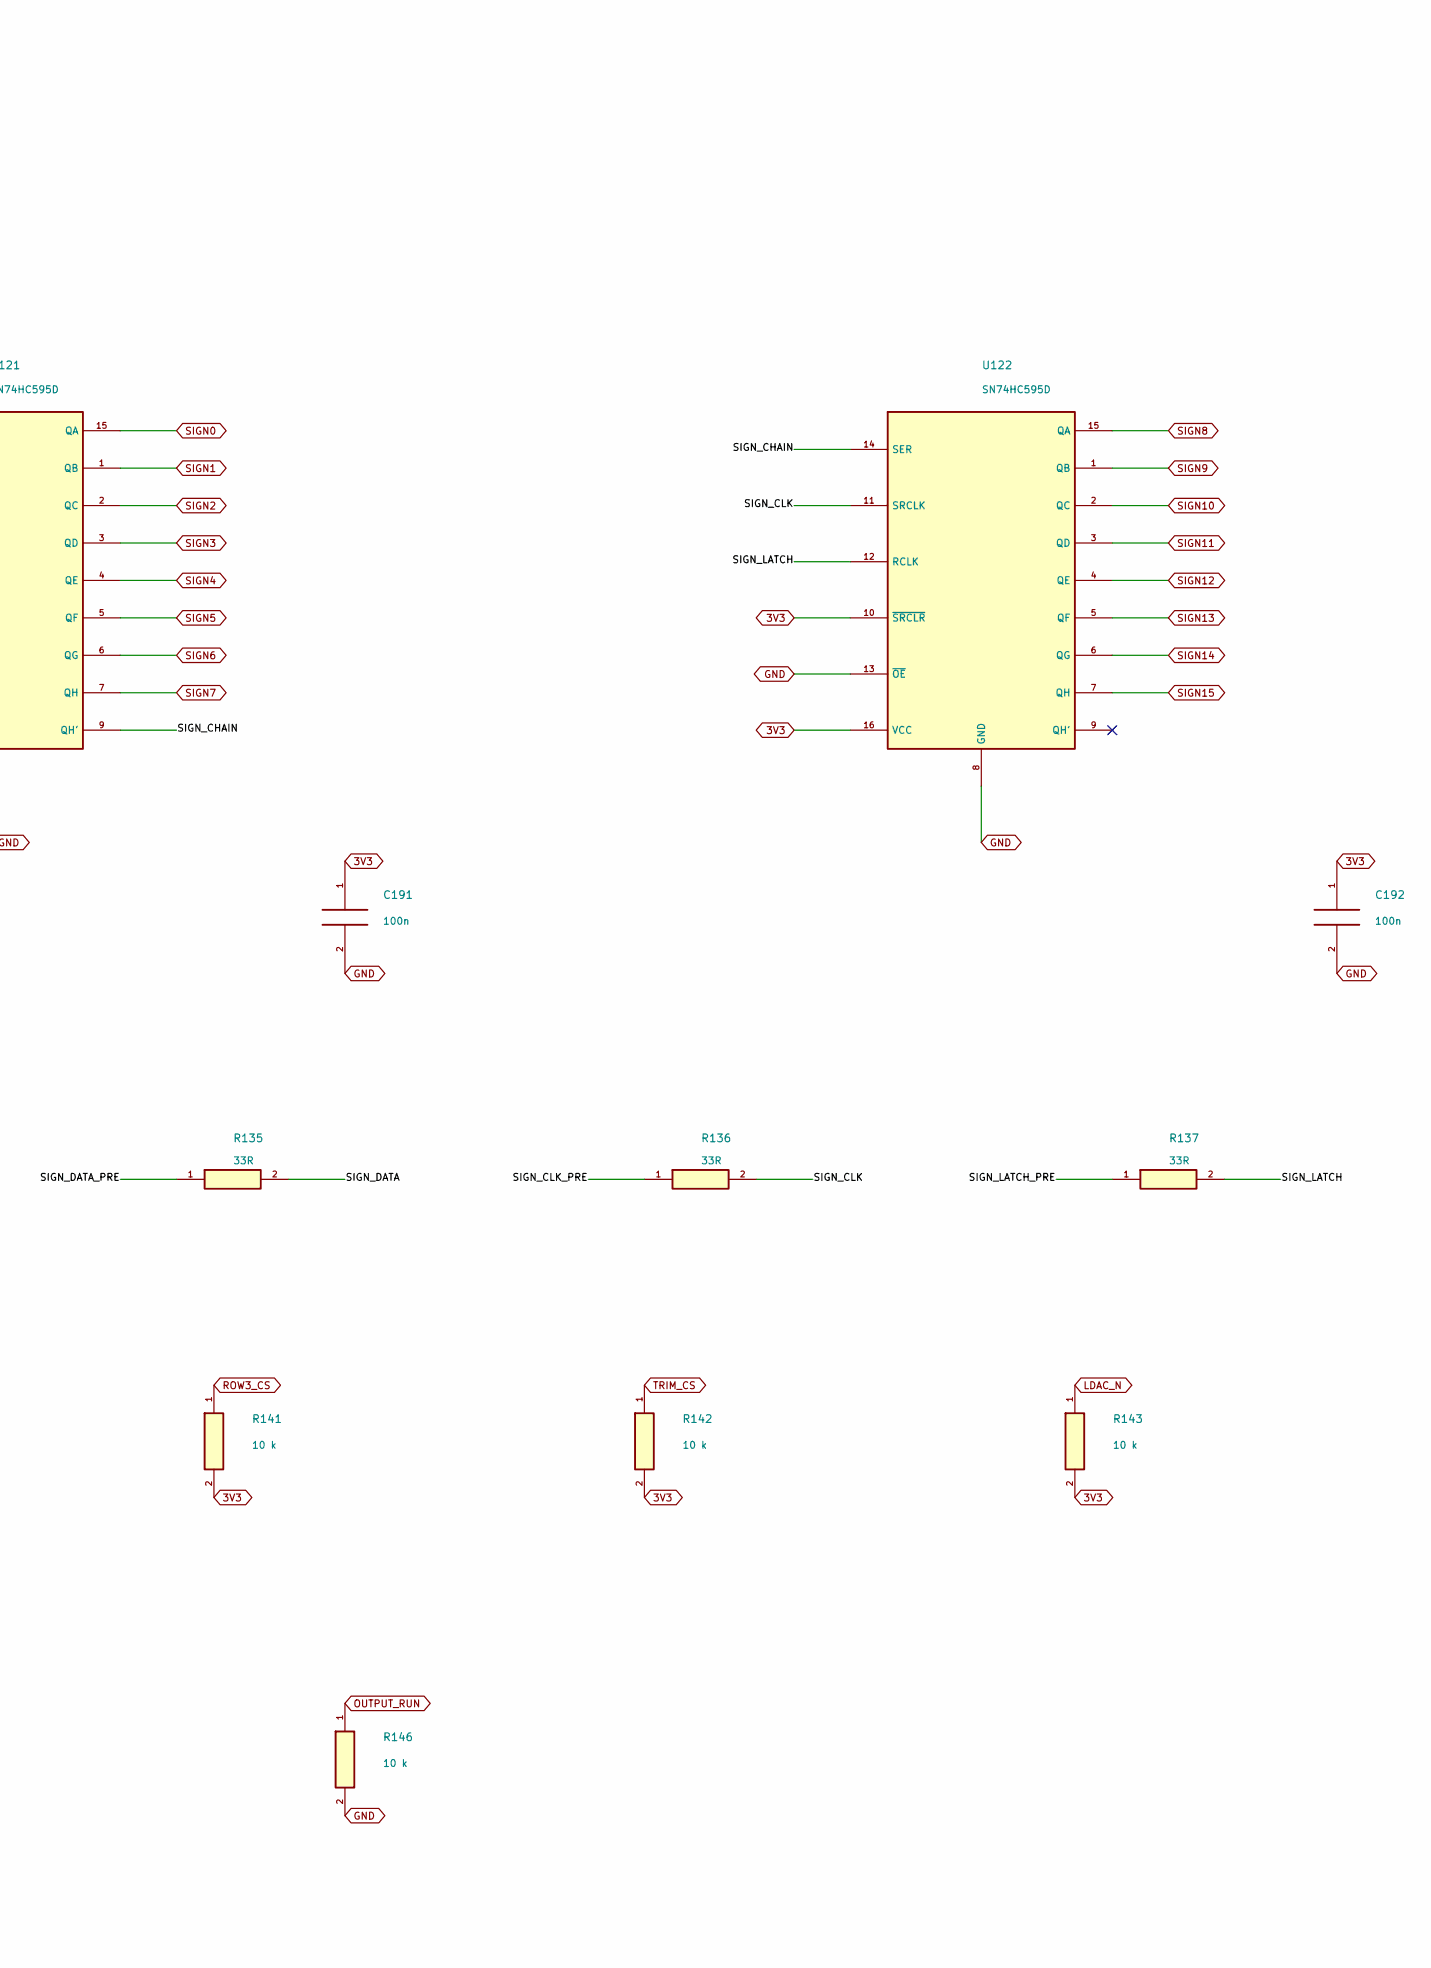
[picture p121: schematic control.kicad_sch, RP2040 USB / SPI controller and sign-bit latches, part in row 1, column 2]

Parts:
C191, C192: 100n; C_0603_1608Metric; Rating 25V X7R minimum; effective C after bias
R133, R134, R135, R136, R137: 33R; R_0603_1608Metric; Rating 0.1%, <=25ppm/C; 0.1W minimum
R138, R139, R140, R141, R142, R143, R144, R145, R146: 10 k; R_0603_1608Metric; Rating 0.1%, <=25ppm/C; 0.1W minimum
U120: Pico; Pico_2x20_Socket_17.78mm
U121, U122: SN74HC595D; SOIC-16_3.9x9.9mm_P1.27mm

Connections:
3V3: C191.1, C192.1, R138.2, R139.2, R140.2, R141.2, R142.2, R143.2, U120.36 (3V3_OUT), U121.10 (~SRCLR), U121.16 (VCC), U122.10 (~SRCLR), U122.16 (VCC); also elsewhere on the board
/Control/MOSI_PRE: R134.1, U120.5 (GP3)
/Control/SCK_PRE: R133.1, U120.4 (GP2)
/Control/SIGN_CHAIN: U121.9 (QH'), U122.14 (SER)
/Control/SIGN_CLK: R136.2, U121.11 (SRCLK), U122.11 (SRCLK)
/Control/SIGN_CLK_PRE: R136.1, U120.15 (GP11)
/Control/SIGN_DATA: R135.2, U121.14 (SER)
/Control/SIGN_DATA_PRE: R135.1, U120.14 (GP10)
/Control/SIGN_LATCH: R137.2, U121.12 (RCLK), U122.12 (RCLK)
/Control/SIGN_LATCH_PRE: R137.1, U120.16 (GP12)
GND: C191.2, C192.2, R144.2, R145.2, R146.2, U120.3 (GND), U120.8 (GND), U120.13 (GND), U120.18 (GND), U120.23 (GND), U120.28 (GND), U120.33 (AGND), U120.38 (GND), U121.8 (GND), U121.13 (~OE), U122.8 (GND), U122.13 (~OE); also elsewhere on the board
LDAC_N: R143.1, U120.11 (GP8); also elsewhere on the board
MOSI: R134.2; also elsewhere on the board
OUTPUT_RUN: R146.1, U120.19 (GP14); also elsewhere on the board
RESET_N: R144.1, U120.12 (GP9); also elsewhere on the board
ROW0_CS: R138.1, U120.6 (GP4); also elsewhere on the board
ROW1_CS: R139.1, U120.7 (GP5); also elsewhere on the board
ROW2_CS: R140.1, U120.9 (GP6); also elsewhere on the board
ROW3_CS: R141.1, U120.10 (GP7); also elsewhere on the board
SCK: R133.2; also elsewhere on the board
SIGN0: U121.15 (QA); also elsewhere on the board
SIGN1: U121.1 (QB); also elsewhere on the board
SIGN2: U121.2 (QC); also elsewhere on the board
SIGN3: U121.3 (QD); also elsewhere on the board
SIGN4: U121.4 (QE); also elsewhere on the board
SIGN5: U121.5 (QF); also elsewhere on the board
SIGN6: U121.6 (QG); also elsewhere on the board
SIGN7: U121.7 (QH); also elsewhere on the board
SIGN8: U122.15 (QA); also elsewhere on the board
SIGN9: U122.1 (QB); also elsewhere on the board
SIGN10: U122.2 (QC); also elsewhere on the board
SIGN11: U122.3 (QD); also elsewhere on the board
SIGN12: U122.4 (QE); also elsewhere on the board
SIGN13: U122.5 (QF); also elsewhere on the board
SIGN14: U122.6 (QG); also elsewhere on the board
SIGN15: U122.7 (QH); also elsewhere on the board
SIGNAL_EN: R145.1, U120.17 (GP13); also elsewhere on the board
TRIM_CS: R142.1, U120.20 (GP15); also elsewhere on the board

Notes on the sheet:
RP2040 USB / SPI controller and sign-bit latches
Pico is USB-powered. Do not connect VBUS/VSYS to +5A. Apply analog power first. GP14=OUTPUT_RUN and GP13=SIGNAL_EN default low.
First register QA..QH = SIGN0..7. Second register QA..QH = SIGN8..15. Clock bit 15 first, latch after 16 clocks.
SPI mode 0, 1MHz, 24 clocks: last 18 bits = channel[1:0], code[15:0]. Five separate CS nets; shared LDAC. SDO pins intentionally unused. Firmware sequence: mute -> disable sign switches -> latch signs -> load 20 DAC words -> LDAC -> settle -> restore prior armed state. No automatic rail supervisor 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

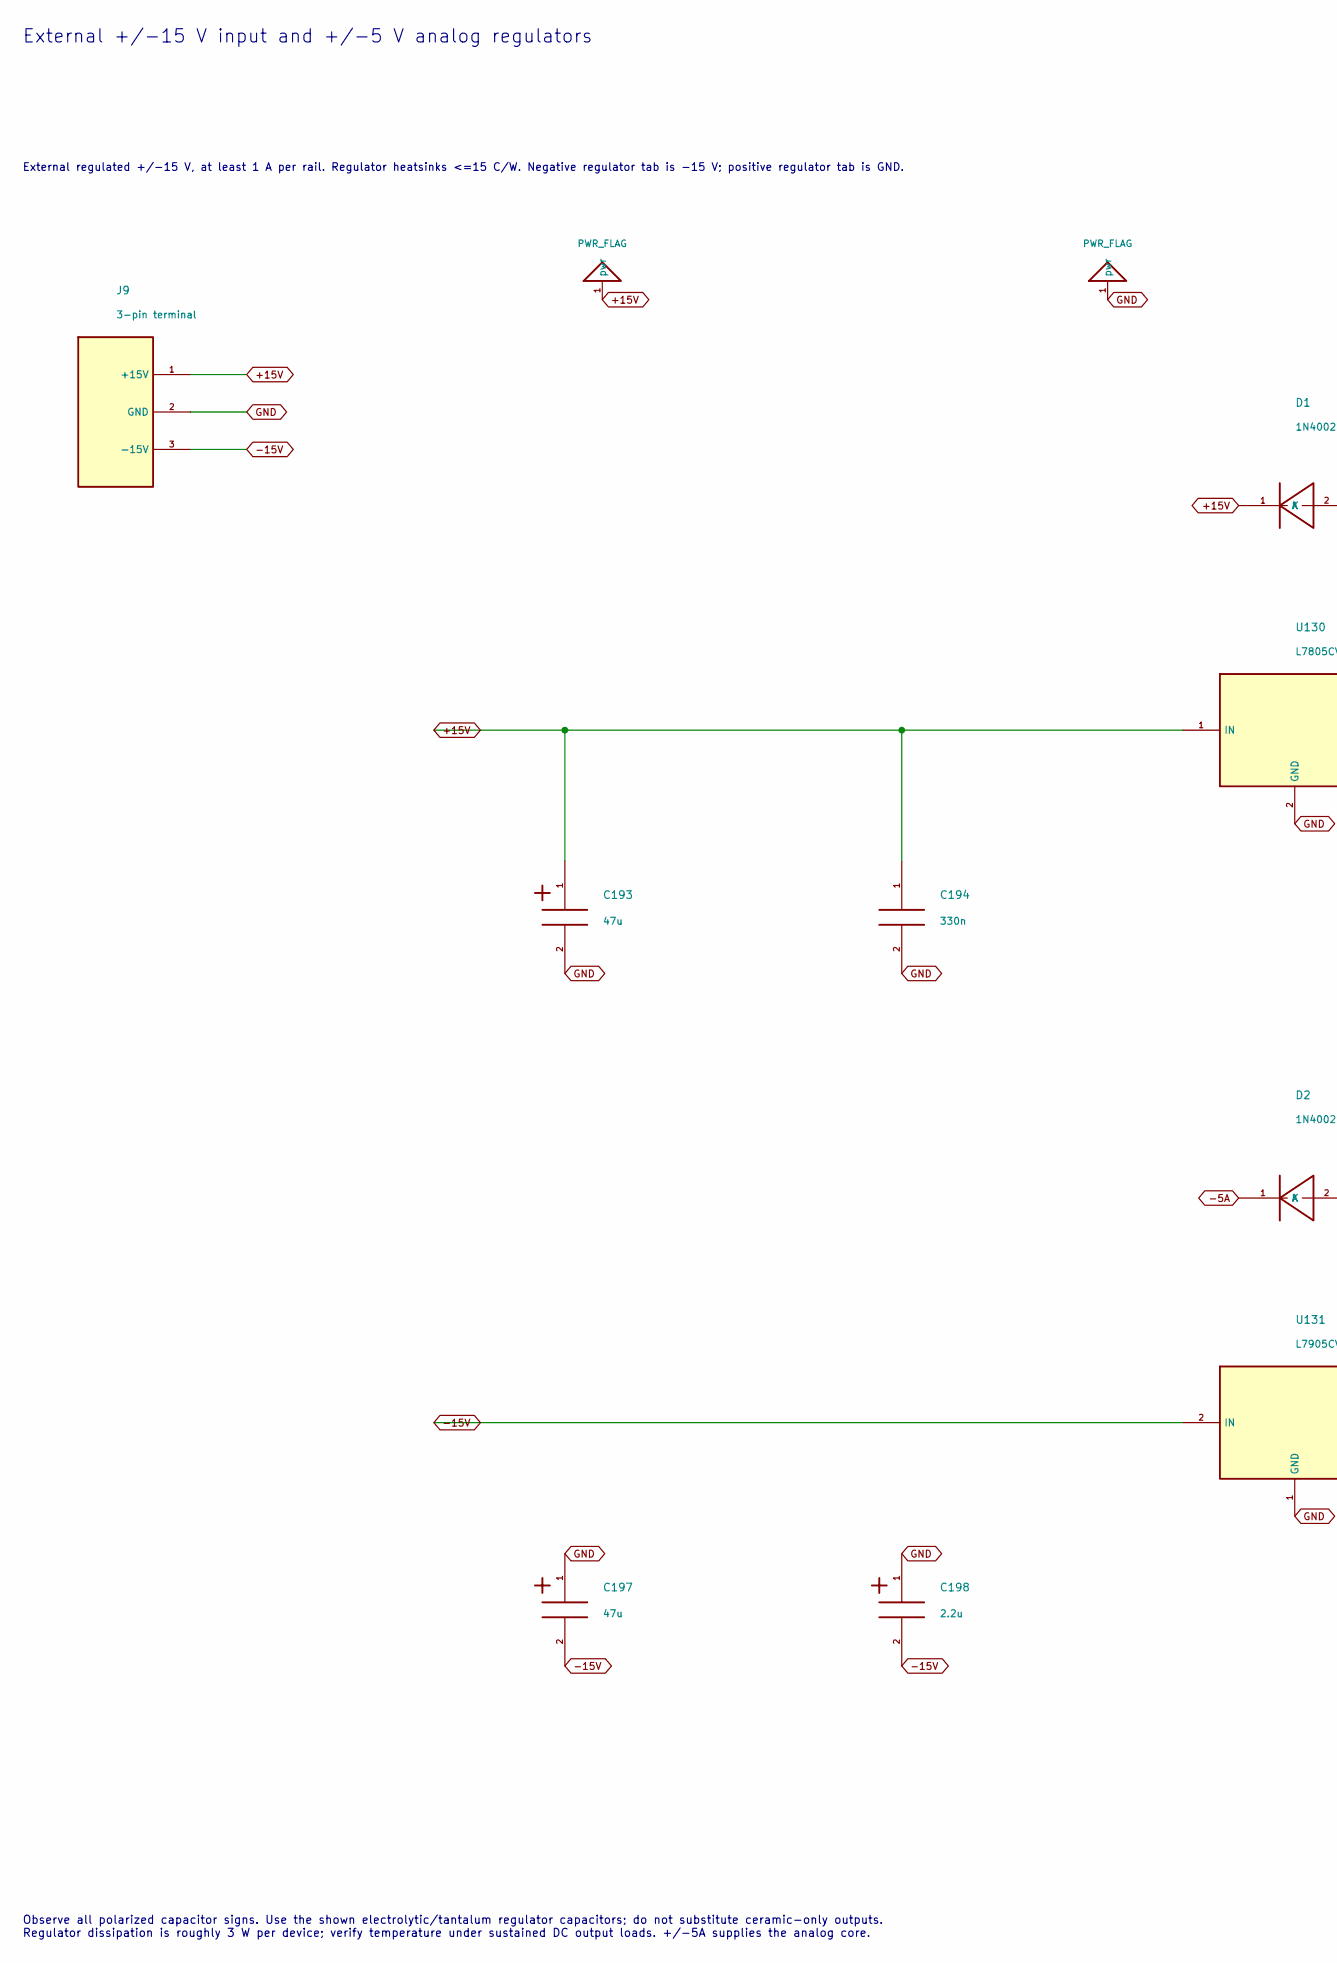
[picture p122: schematic power.kicad_sch, External +/-15 V input and +/-5 V analog regulators, part in row 1, column 1]

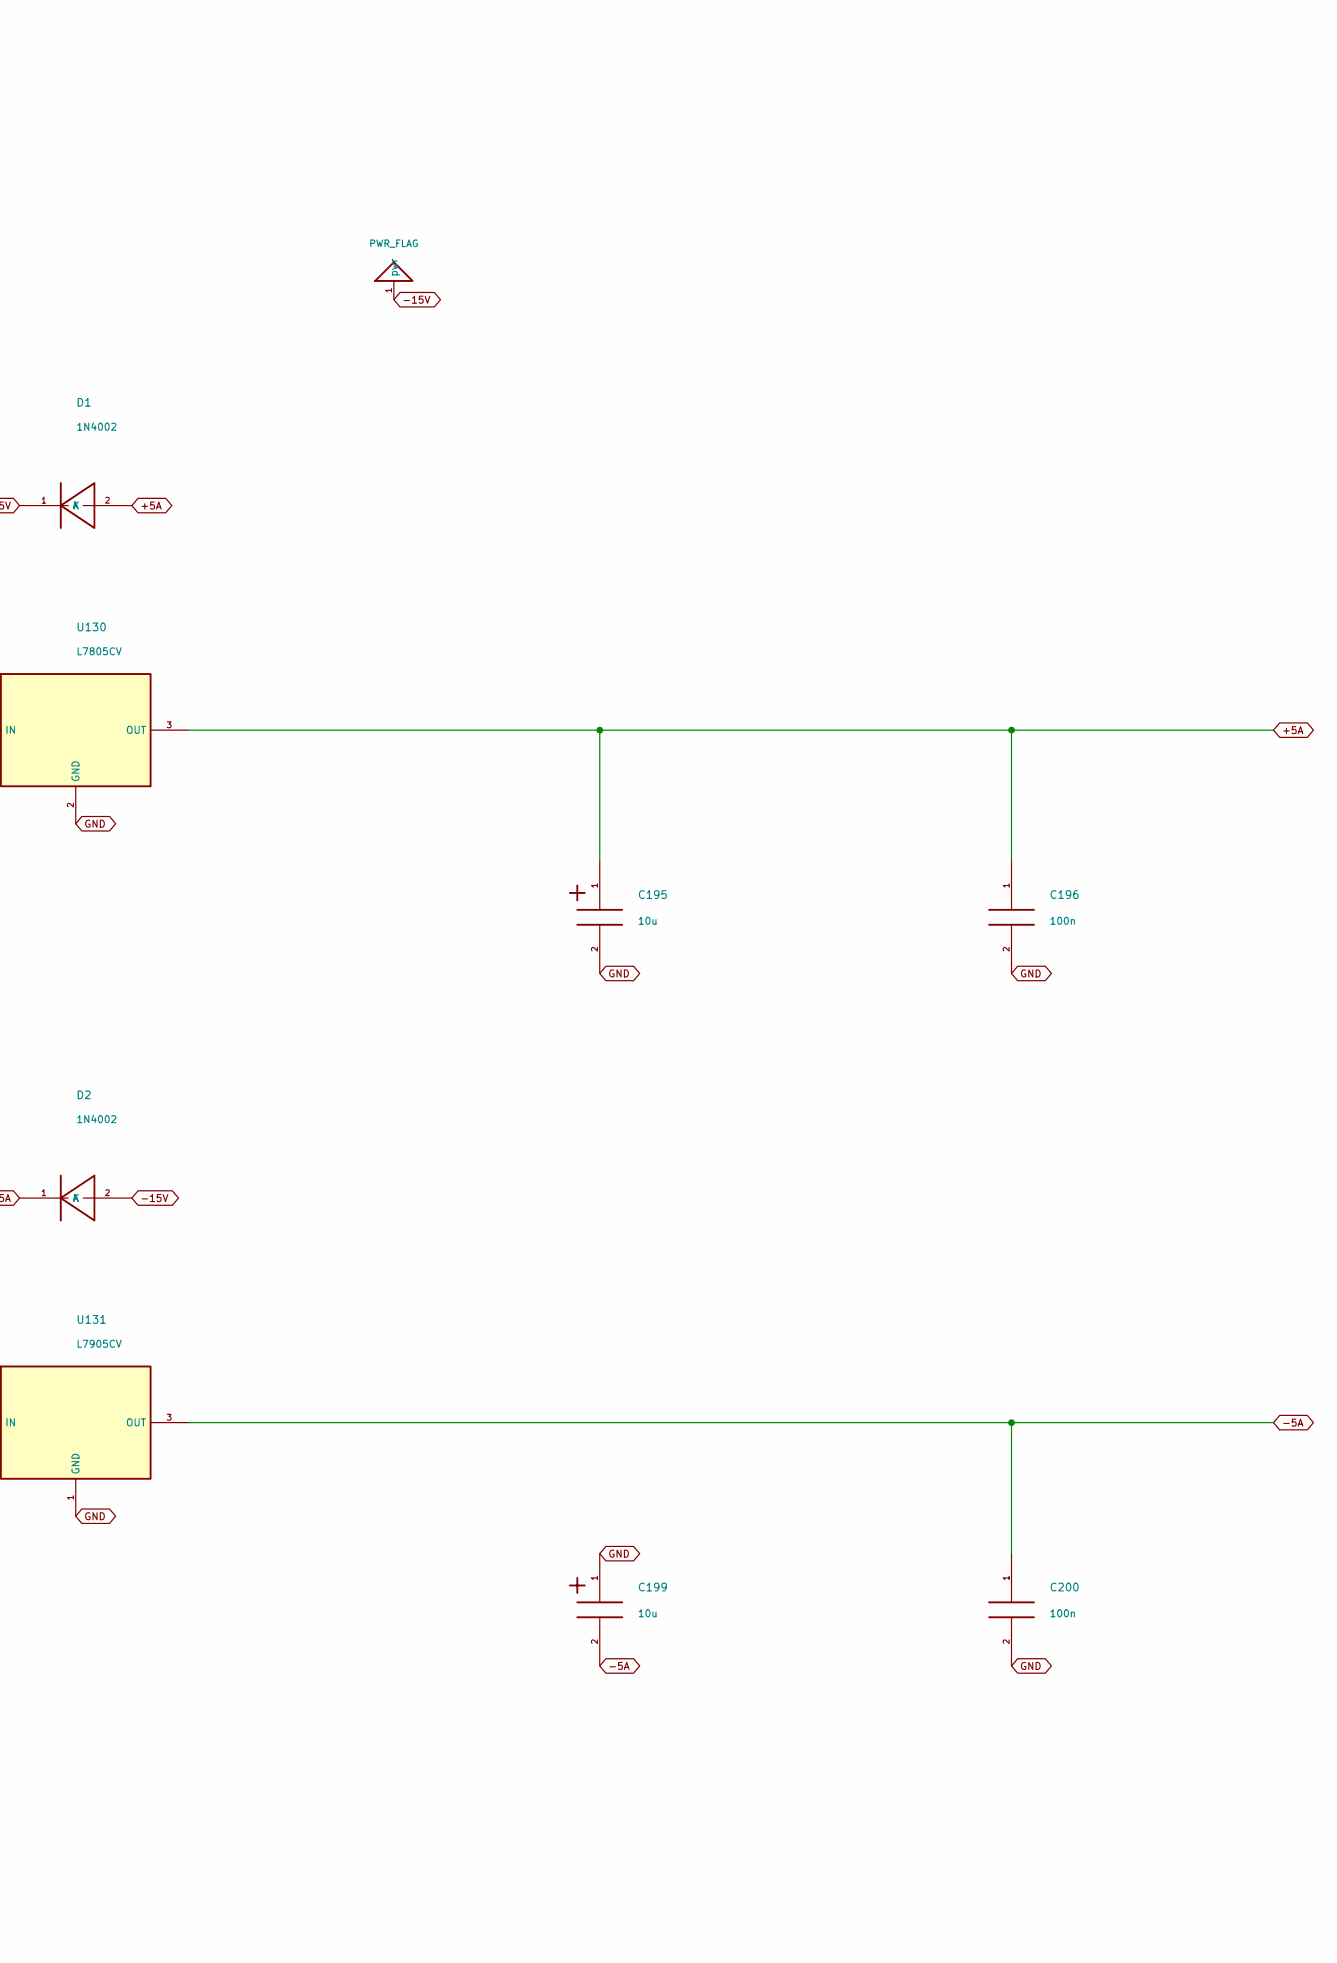
[picture p123: schematic power.kicad_sch, External +/-15 V input and +/-5 V analog regulators, part in row 1, column 2]

Parts:
C193, C197: 47u; C_Radial_D5.0mm_H11.0mm_P2.00mm; Rating 35V polarized
C194: 330n; C_0603_1608Metric; Rating 25V X7R minimum; effective C after bias
C195, C199: 10u; C_Radial_D5.0mm_H11.0mm_P2.00mm; Rating 16V polarized
C196, C200: 100n; C_0603_1608Metric; Rating 25V X7R minimum; effective C after bias
C198: 2.2u; CP_EIA-3216-18_Kemet-A; Rating 35V polarized
D1, D2: 1N4002; D_DO-41_SOD81_P10.16mm_Horizontal
J9: 3-pin terminal; TerminalBlock_Phoenix_MKDS-1,5-3-5.08_1x03_P5.08mm_Horizont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
U130: L7805CV; TO-220-3_Vertical
U131: L7905CV; TO-220-3_Vertical

Connections:
+5A: C195.1, C196.1, D1.2 (A), U130.3 (OUT); also elsewhere on the board
+15V: C193.1, C194.1, D1.1 (K), J9.1 (+15V), U130.1 (IN); also elsewhere on the board
-5A: C199.2, C200.1, D2.1 (K), U131.3 (OUT); also elsewhere on the board
-15V: C197.2, C198.2, D2.2 (A), J9.3 (-15V), U131.2 (IN); also elsewhere on the board
GND: C193.2, C194.2, C195.2, C196.2, C197.1, C198.1, C199.1, C200.2, J9.2 (GND), U130.2 (GND), U131.1 (GND); also elsewhere on the board

Notes on the sheet:
External +/-15 V input and +/-5 V analog regulators
External regulated +/-15 V, at least 1 A per rail. Regulator heatsinks <=15 C/W. Negative regulator tab is -15 V; positive regulator tab is GND.
Observe all polarized capacitor signs. Use the shown electrolytic/tantalum regulator capacitors; do not substitute ceramic-only outputs. Regulator dissipation is roughly 3 W per device; verify temperature under sustained DC output loads. +/-5A supplies the analog core.

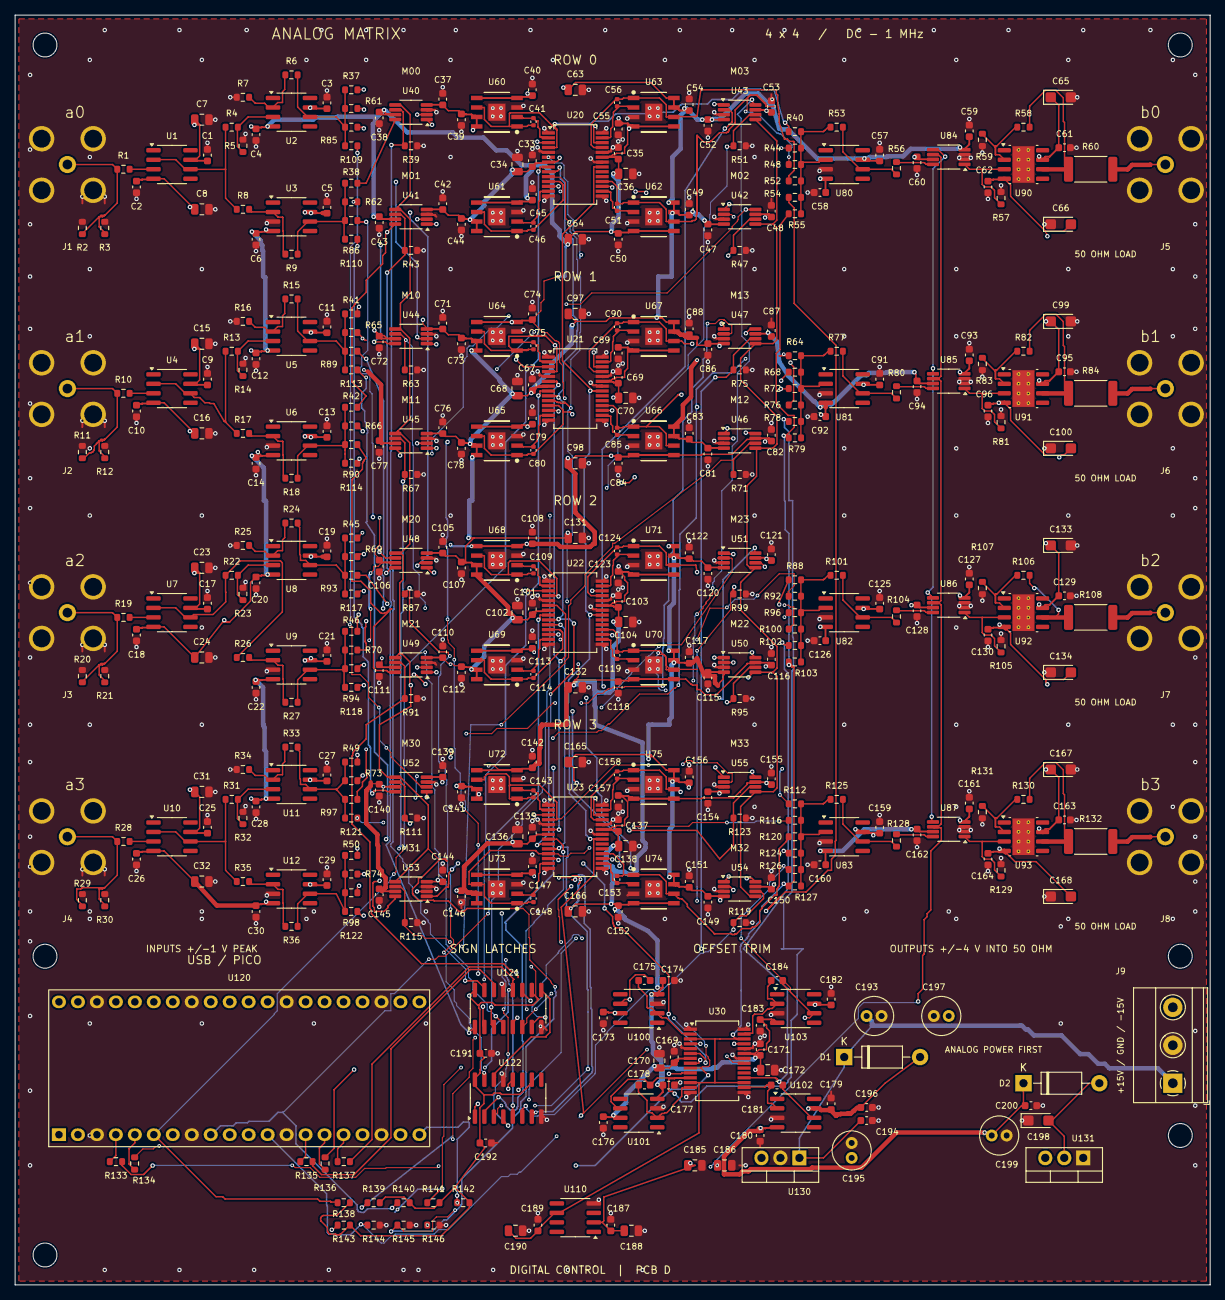
[picture p124: board analog_matrix_4x4.kicad_pcb from above]

Board: 4 copper layers, 160.0 x 170.0 mm, 434 parts (0 on the bottom side), 191 nets.

Other parts of the board:
H1, H2, H3, H4, H5, H6: MountingHole_3.2mm_M3
