tim4431/analog_programmable_matrix/(commit log)

2026-10-01 Initial version: 4x4 programmable analog matrix
    [ADA4899_RD8_EP2.29x2.29.step, BNC_Amphenol_031-5329-52RFX_Vertical.step, BOM_JLCPCB.csv, CP_EIA-3216-18_Kemet-A.step, C_0402_1005Metric.step, C_0603_1608Metric.step, C_0805_2012Metric.step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]
2026-10-03 Add separate LC1 12-bit lower-cost analog matrix design
    [BNC_Amphenol_031-5329-52RFX_Vertical.step, BOM_JLCPCB.csv, DO_NOT_POPULATE.csv, MANUAL_ASSEMBLY.csv, PART_MATCHING.csv, PIN1_ORIENTATION_REFERENCE.csv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]
