tim4431/analog_programmable_matrix/(notices)

Notices in the files:
mechanical/analog_matrix_package_m3/models/R_0603_1608Metric.step:
Copyright (C) 2018, kicad StepUp
This work is licensed under the [Creative Commons CC-BY-SA 4.0 License](https://creativecommons.org/licenses/by-sa/4.0/legalcode),
with the following exception:
To the extent that the creation of electronic designs that use 'Licensed Material' can be considered to be 'Adapted Material',
You are free to use the library data in your own projects without the obligation to share your project files under this or any other license agreement.
mechanical/analog_matrix_package_m3/models/SOIC-8_3.9x4.9mm_P1.27mm.step:
Copyright (C) 2017, kicad StepUp
mechanical/analog_matrix_package_m3/models/C_Radial_D5.0mm_H11.0mm_P2.00mm.step:
Copyright (C) 2019, kicad StepUp
mechanical/analog_matrix_package_m3/models/TerminalBlock_Phoenix_MKDS-1,5-3-5.08_1x03_P5.08mm_Horizontal.step:
Copyright (C) 2020, kicad StepUp
